halbritt/fome-mc/telemetry-pod/expansion/series-divider/review/README.md

# Independent series-divider source review

1,062 checks pass. The candidate replaces the previously unbound31.3kohm R60 with30.1kohm R60 and adds1.2kohm R181 in series. The midpoint contains exactly R60.2 and R181.1; the old SUP_U18_SENSE connection substitutes R181.2 for R60.2. Collapsing this verified pair restores the entire baseline intent exactly, including all320 earlier bindings, other components, nets and declared NCs. The new source has333 components and322 bindings. R181 is inserted immediately after R60 in the same schematic layout group; removing it restores the complete prior layout. Every other captured input byte is unchanged.

Exact YAGEO RT0603BRD0730K1L/C705764 and RT0603BRD071K2L/C136970 identities, manufacturer PDF hashes and raw supplier-response/catalog hashes were independently checked. Both exact sheets were read:30.1k/1.2k,±0.1%,25ppm/K,0603,0.1W at70°C,-55..155°C and75V voltage ceiling. Historical stocks410 and7556, with assemblyComponentFlag=false for both, remain capture-time observations rather than assembly approval.

The series sum is31.3kohm nominal, preserving the divider's31.3k/10k ratio and nominal falling threshold1.15×(1+31.3/10)=4.7495V. If both top resistors share the same specified bounds, adding independent worst-case same-sign errors produces the same relative tolerance/TCR envelope as a single31.3k resistor with those bounds. Do not apply statistical cancellation or RSS without an accepted statistical model. The original unbound R60 did not itself have a guaranteed25ppm part; this candidate makes the assumed coefficient explicit through selected parts without qualifying threshold performance.

At a nominal5V input, total divider resistance41.3k gives121.1µA; the30.1k resistor dissipates approximately0.441mW and the1.2k resistor17.6µW. These are static nominal calculations, not assembled-temperature or fault-survival evidence. The extra resistor, solder joints and exposed midpoint introduce layout, parasitic capacitance/leakage and contamination considerations. Local board leakage into the midpoint is not represented by the ideal series-resistor reduction. Layout and routing must account for that node and the additional package.

The supervisor monitors local POD_5V_SENSOR upstream of U30. All prior uncertainty about the healthy local rail envelope, TPS389001 input-current applicability near threshold, resistor lifetime/solder drift, acceptable assertion/release window, noise and timing remains open. Preserving nominal ratio avoids the proposed31.6k threshold shift; it does not resolve those qualification conditions.

Five temporary-copy negative controls reject an extra midpoint attachment, a wrong series terminal, changed resistance, damaged prior binding and misplaced layout insertion. Checker API is `check_series.py PACKET BASE_INPUTS CANDIDATE REPORT --source-only`; negative runner is `negative_probes.py PACKET BASE_INPUTS CANDIDATE REPORT`. No preparation helper is imported. The checker deliberately refuses native mode. Existing native verification assumes the previous topology and must be extended for this exact series replacement and exercised on newly emitted artifacts before any native or placement claim. Native remains NOT_RUN; all assembly, thermal, mechanical, fabrication and operating holds persist.
