halbritt/fome-mc/telemetry-pod/expansion/part-bindings/review/README.md

# Independent identity-binding source review

1,673 checks pass for the prepared source:45 supplier identities assigned to188 previously unbound references, giving314 components with binding metadata. All332 components, prior bindings, values, footprints, nets, declared no-connects, library hashes and capture bytes remain unchanged apart from the188 intended part_binding additions. Six power flags and five copper jumpers remain outside part selection, leaving7 other references without binding metadata.

The checker independently fixes each expected MPN/LCSC/reference allocation without importing preparation helpers. It verifies manifest datasheet/catalog hashes, raw supplier-response hash/size, exact manufacturer/MPN/LCSC identities and historical stock. All45 assemblyComponentFlag observations remain false. Binding and receipt language explicitly retains assembly and operating qualification as pending; existing126 bindings have not been requalified.

The latest32 positions all have10kohm nominal values and Resistor_SMD:R_0603_1608Metric footprints. Exact YAGEO RT0603BRD0710KL/C95204 matches their nominal resistance, footprint class, required0.1% precision where specified, and25ppm/C thermistor requirements. Allocation: R46–55,R64–69,R71–72,R57/59/61/63,R112/113/115,R121/122/124,andR170–173. It does not change circuit values. The exact manufacturer PDF identifies10k,0.1%,25ppm/C,-55..155C,0.1W at70C,75V maximum continuous voltage. For10k the power-derived ceiling is sqrt(0.1W×10k)=31.62V at full rated power, already below75V. Temperature range does not permit full rated power through155C. The PDF's150V overload figure is not a continuous or automotive-transient rating.

Conditional linear derating from0.1W70C to zero155C gives58.8mW105C and35.3mW125C. The earlier thermistor24V fault screen of about46.9mW per pullup fits only the former, before assembled heating/margin. Exact family derating, film temperature, pulse capability and the prior thermal/fault conditions remain qualification gates. Historical stock was1,961,790 at2026-10-20T14:01:34.419365+00:00 with assemblyComponentFlag=false; this is not present assembly availability.

Ten temporary-source controls reject: wrong supplier ID, unrelated net damage, promoted assembly flag, wrong eMMC datasheet hash, 499k MPN substituted on thermistor10k R170, 100ohm MPN substituted on120ohm termination R70, X7R identity substituted on crystal C0G C81, 22nF X7R identity substituted on10nF C0G ramp C88, HP suffix removed from R174, andJ1 captured zero stock promoted to one. Evidence is retained in negative-probes.json. Source circuit files are untouched by the probes.

U14 provenance recovery was independently checked previously and replayed here: all four restored raw responses match the unchanged historic catalog hashes/sizes. An independent HTTPS fetch returned200 and1,361,902bytes with SHA256e26a6008b1d04ceaa514681aabef2e4130eeabe528a775e6be78162000bce733, identical to reviewed FORESEE A-00093v1.0 FEMDME008G-A8A39, dated2021-07-16 on page2. Exact MCP3208-BI/SL,C2979740; TL431BQDBZR,C190245; and ADS1119IPWR,C701613 identities remain as previously reviewed; no alternative device has been substituted.

Run `check_bindings.py PACKET_DIR CANDIDATE_DIR REPORT_JSON --source-only` for prepared source. Without that flag, the checker additionally requires native.xml and checks complete graph/pin-function/NC preservation and all added binding fields. That branch remains NOT_RUN: the valid278-character structured PARAM_Datasheet is still blocked by the emitter's ordinary-field limit. Do not truncate or omit identity evidence to force emission. The previously verified native candidate remains a separate artifact.

All previous electrical, cold-start, transient/backfeed, timing, thermal, capacitor stability, accuracy, footprint, mechanical, placement/routing and qualification holds remain. Identity metadata is not assembly, fabrication or hardware acceptance.

The additional15 exact YAGEO identities cover28 references:100k R29/R116/R125/R180;16.9k R56;15.2k R58;64.9k R62;120ohm R70;68.1k R74/R78/R82;215k R75/R79/R83;44.2k R76/R80/R165;26.7k R84;56k R114/R123;4.7k R117/R126;100ohm R118/R127;2.2k R160/R161;95.3k R163;287k R164. All15 exact PDF specifications were read independently and match0.1%,25ppm/C,0603,-55..155C,0.1W70C and75V ceiling. The checker also decodes every selected RT0603BRD07 resistance code and compares it with the unchanged component value and footprint, in addition to exact supplier identities and reference allocations.

Power screening is especially important for low values:120ohm R70 at0.1W permits3.46Vrms differential at70C; conditional linear derating to105C lowers that to2.66Vrms. Its default-open solder jumper does not qualify sustained dominant or fault stress when enabled.100ohm R118/R127 permit3.16Vrms at full0.1W. These are resistor power ceilings, not bus fault-survival claims. Exact temperature derating, board heating and transient energy remain unqualified.

At that earlier resistor-selection stage,R60 at31.3k, all four1.05M positions and the2512 power resistors remained unbound. The six2512 resistors were subsequently bound as documented below;R60 and the four1.05M positions remain unbound. The31.3k search was rewritten by the supplier to11.3k before returning no results, so that response cannot establish absence of31.3k stock. The exact manufacturer URL404 is a limited source-discovery observation, not evidence authorizing substitution.

Six exact KEMET selections add45 unchanged capacitor positions:25×100nF50V X7R0603 (C0603C104K5RACTU),11×1uF50V X7R0805 (C0805C105K5RACTU),C81/C82 18pF50V C0G (C0603C180J5GACTU),C95/C96 220pF50V C0G (C0603C221J5GACTU),C71/C73/C75/C77 22nF50V X7R (C0603C223K5RACTU),andC128 10uF16V X7R1206 (C1206C106K4RACTU). Exact manufacturer sheets were independently read and their hashes replayed. These are commercial parts rated-55..125°C, not automotive-qualified by this evidence.

The X7R sheets specify±10% initial tolerance,±15% temperature variation and3% loss per decade-hour aging under stated referee conditions. Nominal capacitance and voltage rating do not guarantee effective capacitance at bias, temperature or age. In particular,1uF sensor-power input bypass effectiveness, ADS1119 decoupling,100nF diagnostic filter settling and22nF supervisor release timing need those effects incorporated. With only initial and temperature terms,0.9×0.85=0.765 of nominal illustrates the loss before bias or aging; it is not a guaranteed combined bound.

C0G parts specify±5%,30ppm/C and zero aging per decade-hour. The18pF crystal pair provides9pF series capacitance nominal plus unmeasured board/device stray; this does not establish12pF load or oscillator startup/drive margin. The220pF Hall filter still requires worst-case pulse/edge and comparator recovery validation. C128's10uF nominal is not an effective-C/ESR guarantee for the TL431 stability region; TL431 operating current, cold diode headroom, bias/aging and transient conditions remain open. No cap binding closes system fault survival. At that earlier selection stage,1uF0603,4.7uF0603,22uF1210 and10nF0603 remained unbound; the following addition resolves all except4.7uF0603.

The final10 additions are C63/C80 KEMET C0603C105K4RACTU (1uF16V X7R±10%0603),C68/C69/C70 YAGEO CC1210KKX7R8BB226 (22uF25V X7R±10%1210),andC47/C88/C91/C94/C126 Murata GRM1885C1H103JA01D (10nF50V C0G±5%0603). All exact manufacturer PDFs were read and their hashes checked. Tighter5% Murata tolerance meets the four ramp positions'10% source requirement without changing circuit values.

Murata's reference sheet page2 explicitly maps the terminalD suffix to180mm paper-tape reelW8P4,4000pcs, and states body1.6±0.1×0.8±0.1×0.8±0.1mm. Its operating range is-55..125°C; the shown0±30ppm/°C coefficient has the narrower25..125°C range. Do not extend that linear coefficient to negative temperatures without additional evidence. The sheet is a consumer/industrial reference specification, not proof of automotive safety qualification. The YAGEO22uF body height is2.5±0.2mm; physical clearance remains unverified. Effective capacitance under3.3V/6.3V bias, temperature, tolerance and aging must still satisfy TPS62162 input/output capacitor and stability requirements. The KEMET1uF nominal similarly does not establish effective bypass capacitance. No newly identified capacitor closes existing power-sequencing, stability or fault-survival holds.

Six power-resistor identity additions were independently checked against the unchanged source values and2512 footprints: R110/R111/R119/R120 CRCW2512620RFKEG/C3988368 and R174/R175 CRCW2512200RFKEGHP/C2073505. Vishay doc20035 (14-Apr-2026) page3 and doc20043 (17-Mar-2026) page3 establish620R/200R resistance codes,F=±1%,K=±100ppm/K,EG packaging and the distinctHP high-power/pulse-proof suffix. EG is the2000-piece8mm-pitch blister-reel option for2512; it is not a power grade. Ordinary2512 is1.0W at70°C; HP2512 is1.5W at70°C. The HP document's separate2W higher-dissipation row has additional conditions and is not the adopted circuit rating.

All previous assembled-thermal gates remain. The four620ohm negative24V Hall-fault screening case dissipates about0.392W each and1.567W total: nominal1W family derating gives0.588W at105°C but0.353W at125°C, so125°C local ambient fails that screen. The two200ohm HP resistors' prior24V-source/four-input fault screen gives about0.597W each;1.5W derates to0.882W at105°C and0.529W at125°C, likewise failing125°C local ambient. Board/copper thermal resistance, mutual heating, film temperature, life drift, pulse/fault duration and diode/LM2903 negative-input behavior are still unqualified. Exact identity and HP suffix preservation do not prove fault survival. Both historical assemblyComponentFlag observations are false; stock1000 and75 are capture-time facts, not current buildability.

J1 identity metadata now records the previously selected TE1-776163-1/C596198 without changing its value,35-pin connectivity or PodConnector:AMPSEAL_35_1-776163-1 footprint. The pinned current TE776163 drawingK1 table explicitly distinguishes gold-plated black1-776163-1 from tin-plated black776163-1. The binding preserves the reviewed gold variant; it does not substitute an available finish or prove mating-harness compatibility.

The exact supplier capture at2026-10-20T14:23:51.952868+00:00 records stock0 and assemblyComponentFlag=false. The checker requires that zero-stock observation and rejects changing the receipt to positive stock. This is identification of an existing design choice, not a new availability-based selection, procurement authorization or evidence of buildability. Connector fit, board-lock/mechanical tolerances, housing clearance, mixed-finish mating risk, thermal, assembly and procurement holds all remain. Current binding totals are188 additions/314 metadata-present/7 remaining part references, excluding the six flags and five copper jumpers. Native remains NOT_RUN for this binding packet.
