halbritt/fome-mc/export/gerbers/fome-mc-drill_report.txt

Drill report for fome-mc.kicad_pcb
Created on 2026-10-18T06:23:28

Copper Layer Stackup:
    =============================================================
    L1 :  F.Cu                      front
    L2 :  In1.Cu                    in1
    L3 :  In2.Cu                    in2
    L4 :  B.Cu                      back

Drill file 'fome-mc.drl' contains
    plated through holes:
    =============================================================
    T1  0.200mm  0.0079"  (76 holes))
    T2  0.250mm  0.0098"  (10 holes))
    T3  0.300mm  0.0118"  (7 holes))
    T4  0.300mm  0.0118"  (1082 holes))
    T5  0.300mm  0.0118"  (499 holes))
    T6  0.400mm  0.0157"  (7 holes))
    T7  0.920mm  0.0362"  (4 holes))
    T8  1.000mm  0.0394"  (10 holes))
    T9  1.100mm  0.0433"  (5 holes))
    T10  1.400mm  0.0551"  (1 hole)
    T11  1.750mm  0.0689"  (70 holes))
    T12  2.300mm  0.0906"  (2 holes))

    Total plated holes count 1773

Not plated through holes are merged with plated holes
    unplated through holes:
    =============================================================
    T13  0.991mm  0.0390"  (3 holes))
    T14  2.000mm  0.0787"  (8 holes))
    T15  4.300mm  0.1693"  (4 holes))

    Total unplated holes count 15
