halbritt/fome-mc/reports/toolchain/routing/fome-mc/INDEX.md

# FOME-MC routing trials

Bounded, read-only trials on isolated copies of the committed board. Each directory
holds the attempt's `result.json`, `RESULT.md`, `attempt.json` (input identity, scope,
settings), `preservation.json`, `new-findings.json` and `candidate-drc.json`; the
candidate boards themselves stay under `build/runs/route/fome-mc/`. Summary and next
actions: `toolchain/ROUTING.md`, section "FOME-MC real-board trials".

| Label | Backend | Process | Routing (unconnected, input 235) | Validation |
|---|---|---|---|---|
| trial-krt-initial | KRT 0.23.1 | FAIL (budget) | NOT_RUN | NOT_RUN |
| trial-freerouting-initial | Freerouting v2.5.0 | PASS | INCOMPLETE (199) | FAIL (adapter defects since fixed) |
| trial-krt-nofinalize-before-locking | KRT 0.23.1 | PASS | INCOMPLETE (14) | FAIL (existing copper reworked; since fixed) |
| trial-freerouting | Freerouting v2.5.0 | PASS | INCOMPLETE (188) | FAIL (1 short, 2 clearance) |
| trial-krt-nofinalize | KRT 0.23.1 | PASS | INCOMPLETE (26) | FAIL (18 new warnings) |
| trial-krt-continue | KRT 0.23.1 | PASS | 16 of 16 open nets still open (from `trial-krt-nofinalize`) | PASS (no change) |
| trial-fr-on-krt | Freerouting v2.5.0 | PASS | 16 of 16 open nets still open (from `trial-krt-nofinalize`) | PASS (one 5 µm stub) |
| trial-krt-hardfirst | KRT 0.23.1 | PASS | 16 hard nets only: 11 routed, 5 open | FAIL (2 starved thermals) |
| trial-krt-hardfirst-rest | KRT 0.23.1 | PASS | **20** (all nets; `against-origin/`: chain graded vs the original input) | FAIL (10 new warnings) |
