halbritt/fome-mc/telemetry-pod/expansion/production-capture/evidence/emission-7d5b0d4d-agentee488/prepared/dry-run/REPORT.md

# Expanded telemetry pod Revision 3 campaign scope (microSD source) review

Outcome: **incomplete**; process state: `incomplete`.

Candidate: `c03a187ac72302218ae839e7368f21286ae55143f42e955a95a794325c88cb99`
Run: `e59d61d6-de8c-4bad-a0ac-6d7cf90f759c`

Revision 3 accounting for all 59 requirements and 20 prose entries against the current microSD source, declared for the pod driver stage order schematic, placement, routing, verification. Native ERC, netlist, placement-projected DRC, routed DRC, copper facts and the fab_package done gate are the only executable checks; every other obligation remains explicit. The placement subject expects the 309 schematic references plus the envelope corner holes H1-H4. Compilation is preparation, not native execution, placement, routing or acceptance.

## Checks

| Check | Execution | Design result | Summary |
| --- | --- | --- | --- |
| erc | ok | defect | schematic: expected native content absent |
| netlist | ok | defect | schematic: expected native content absent |
| parts | ok | defect | schematic: expected native content absent |
| antenna-facts | ok | defect | schematic: expected native content absent |
| placement-drc | ok | defect | placement: expected native content absent |
| envelope-outline | ok | defect | placement: expected native content absent |
| envelope-layer-count | ok | defect | placement: expected native content absent |
| envelope-stackup | ok | defect | placement: expected native content absent |
| envelope-hole-h1 | ok | defect | placement: expected native content absent |
| envelope-hole-h2 | ok | defect | placement: expected native content absent |
| envelope-hole-h3 | ok | defect | placement: expected native content absent |
| envelope-hole-h4 | ok | defect | placement: expected native content absent |
| envelope-keepout-radio-antenna | ok | defect | placement: expected native content absent |
| envelope-keepout-d-pcb-7v2-in1-no-tracks | ok | defect | placement: expected native content absent |
| envelope-keepout-d-pcb-6-rf-reference | ok | defect | placement: expected native content absent |
| envelope-fixed-j1 | ok | defect | placement: expected native content absent |
| envelope-fixed-j2 | ok | defect | placement: expected native content absent |
| envelope-fixed-u1 | ok | defect | placement: expected native content absent |
| envelope-fixed-u2 | ok | defect | placement: expected native content absent |
| envelope-fixed-j3 | ok | defect | placement: expected native content absent |
| envelope-containment | ok | defect | placement: expected native content absent |
| electrical-locality | ok | defect | placement: expected native content absent |
| drc | ok | defect | routing: expected native content absent |
| routing-geometry | ok | defect | routing: expected native content absent |
| envelope-fab-profile | ok | defect | routing: expected native content absent |
| assembly | ok | defect | verification: expected native content absent |
| fab-package | ok | defect | verification: expected native content absent |

## RF review applicability

RF review required: 2 RF indicator(s) detected in captured sources.
Binding: `6935508f20289cdfda2f408569afbd25ca0f07ad6474f0cf964c3b8631b51711`; gate: required RF review missing: no execution record.
- Missing RF evidence: rf_constraints: no captured source bound
- Missing RF evidence: rf_captures: no captured source bound
- Missing RF evidence: planes: no filled copper zone in the captured board; plane continuity is unknown
- Missing RF evidence: routing adapter evidence missing_evidence: no routing adapter receipt was supplied for this candidate; layer policy and RF reference continuity are unknown

## Initial reviews

## Findings and dispositions

### check/erc: schematic: expected native content absent

Disposition: **unresolved**.

Location: erc. Condition: check erc (erc).

schematic: expected native content absent

schematic: expected native content absent
- [work/erc/stage-subject/execution.json](<work/erc/stage-subject/execution.json>): check:erc
- [work/erc/stage-subject/console.log](<work/erc/stage-subject/console.log>): check:erc
- [work/erc/stage-subject/native-netlist.xml](<work/erc/stage-subject/native-netlist.xml>): check:erc
- [work/erc/stage-subject/native-observation.json](<work/erc/stage-subject/native-observation.json>): check:erc
- [work/erc/stage-subject/references.json](<work/erc/stage-subject/references.json>): check:erc
- [work/erc/stage-subject.json](<work/erc/stage-subject.json>): check:erc

### check/netlist: schematic: expected native content absent

Disposition: **unresolved**.

Location: netlist. Condition: check netlist (netlist).

schematic: expected native content absent

schematic: expected native content absent
- [work/netlist/stage-subject/execution.json](<work/netlist/stage-subject/execution.json>): check:netlist
- [work/netlist/stage-subject/console.log](<work/netlist/stage-subject/console.log>): check:netlist
- [work/netlist/stage-subject/native-netlist.xml](<work/netlist/stage-subject/native-netlist.xml>): check:netlist
- [work/netlist/stage-subject/native-observation.json](<work/netlist/stage-subject/native-observation.json>): check:netlist
- [work/netlist/stage-subject/references.json](<work/netlist/stage-subject/references.json>): check:netlist
- [work/netlist/stage-subject.json](<work/netlist/stage-subject.json>): check:netlist

### check/parts: schematic: expected native content absent

Disposition: **unresolved**.

Location: parts. Condition: check parts (parts_subset).

schematic: expected native content absent

schematic: expected native content absent
- [work/parts/stage-subject/execution.json](<work/parts/stage-subject/execution.json>): check:parts
- [work/parts/stage-subject/console.log](<work/parts/stage-subject/console.log>): check:parts
- [work/parts/stage-subject/native-netlist.xml](<work/parts/stage-subject/native-netlist.xml>): check:parts
- [work/parts/stage-subject/native-observation.json](<work/parts/stage-subject/native-observation.json>): check:parts
- [work/parts/stage-subject/references.json](<work/parts/stage-subject/references.json>): check:parts
- [work/parts/stage-subject.json](<work/parts/stage-subject.json>): check:parts

### check/antenna-facts: schematic: expected native content absent

Disposition: **unresolved**.

Location: antenna-facts. Condition: check antenna-facts (datasheet_facts).

schematic: expected native content absent

schematic: expected native content absent
- [work/antenna-facts/stage-subject/execution.json](<work/antenna-facts/stage-subject/execution.json>): check:antenna-facts
- [work/antenna-facts/stage-subject/console.log](<work/antenna-facts/stage-subject/console.log>): check:antenna-facts
- [work/antenna-facts/stage-subject/native-netlist.xml](<work/antenna-facts/stage-subject/native-netlist.xml>): check:antenna-facts
- [work/antenna-facts/stage-subject/native-observation.json](<work/antenna-facts/stage-subject/native-observation.json>): check:antenna-facts
- [work/antenna-facts/stage-subject/references.json](<work/antenna-facts/stage-subject/references.json>): check:antenna-facts
- [work/antenna-facts/stage-subject.json](<work/antenna-facts/stage-subject.json>): check:antenna-facts

### check/placement-drc: placement: expected native content absent

Disposition: **unresolved**.

Location: placement-drc. Condition: check placement-drc (drc).

placement: expected native content absent

placement: expected native content absent
- [work/placement-drc/stage-subject/execution.json](<work/placement-drc/stage-subject/execution.json>): check:placement-drc
- [work/placement-drc/stage-subject/console.log](<work/placement-drc/stage-subject/console.log>): check:placement-drc
- [work/placement-drc/stage-subject/native-observation.json](<work/placement-drc/stage-subject/native-observation.json>): check:placement-drc
- [work/placement-drc/stage-subject/references.json](<work/placement-drc/stage-subject/references.json>): check:placement-drc
- [work/placement-drc/stage-subject.json](<work/placement-drc/stage-subject.json>): check:placement-drc

### check/envelope-outline: placement: expected native content absent

Disposition: **unresolved**.

Location: envelope-outline. Condition: check envelope-outline (board_envelope).

placement: expected native content absent

placement: expected native content absent
- [work/envelope-outline/stage-subject/execution.json](<work/envelope-outline/stage-subject/execution.json>): check:envelope-outline
- [work/envelope-outline/stage-subject/console.log](<work/envelope-outline/stage-subject/console.log>): check:envelope-outline
- [work/envelope-outline/stage-subject/native-observation.json](<work/envelope-outline/stage-subject/native-observation.json>): check:envelope-outline
- [work/envelope-outline/stage-subject/references.json](<work/envelope-outline/stage-subject/references.json>): check:envelope-outline
- [work/envelope-outline/stage-subject.json](<work/envelope-outline/stage-subject.json>): check:envelope-outline

### check/envelope-layer-count: placement: expected native content absent

Disposition: **unresolved**.

Location: envelope-layer-count. Condition: check envelope-layer-count (board_envelope).

placement: expected native content absent

placement: expected native content absent
- [work/envelope-layer-count/stage-subject/execution.json](<work/envelope-layer-count/stage-subject/execution.json>): check:envelope-layer-count
- [work/envelope-layer-count/stage-subject/console.log](<work/envelope-layer-count/stage-subject/console.log>): check:envelope-layer-count
- [work/envelope-layer-count/stage-subject/native-observation.json](<work/envelope-layer-count/stage-subject/native-observation.json>): check:envelope-layer-count
- [work/envelope-layer-count/stage-subject/references.json](<work/envelope-layer-count/stage-subject/references.json>): check:envelope-layer-count
- [work/envelope-layer-count/stage-subject.json](<work/envelope-layer-count/stage-subject.json>): check:envelope-layer-count

### check/envelope-stackup: placement: expected native content absent

Disposition: **unresolved**.

Location: envelope-stackup. Condition: check envelope-stackup (board_envelope).

placement: expected native content absent

placement: expected native content absent
- [work/envelope-stackup/stage-subject/execution.json](<work/envelope-stackup/stage-subject/execution.json>): check:envelope-stackup
- [work/envelope-stackup/stage-subject/console.log](<work/envelope-stackup/stage-subject/console.log>): check:envelope-stackup
- [work/envelope-stackup/stage-subject/native-observation.json](<work/envelope-stackup/stage-subject/native-observation.json>): check:envelope-stackup
- [work/envelope-stackup/stage-subject/references.json](<work/envelope-stackup/stage-subject/references.json>): check:envelope-stackup
- [work/envelope-stackup/stage-subject.json](<work/envelope-stackup/stage-subject.json>): check:envelope-stackup

### check/envelope-hole-h1: placement: expected native content absent

Disposition: **unresolved**.

Location: envelope-hole-h1. Condition: check envelope-hole-h1 (board_envelope).

placement: expected native content absent

placement: expected native content absent
- [work/envelope-hole-h1/stage-subject/execution.json](<work/envelope-hole-h1/stage-subject/execution.json>): check:envelope-hole-h1
- [work/envelope-hole-h1/stage-subject/console.log](<work/envelope-hole-h1/stage-subject/console.log>): check:envelope-hole-h1
- [work/envelope-hole-h1/stage-subject/native-observation.json](<work/envelope-hole-h1/stage-subject/native-observation.json>): check:envelope-hole-h1
- [work/envelope-hole-h1/stage-subject/references.json](<work/envelope-hole-h1/stage-subject/references.json>): check:envelope-hole-h1
- [work/envelope-hole-h1/stage-subject.json](<work/envelope-hole-h1/stage-subject.json>): check:envelope-hole-h1

### check/envelope-hole-h2: placement: expected native content absent

Disposition: **unresolved**.

Location: envelope-hole-h2. Condition: check envelope-hole-h2 (board_envelope).

placement: expected native content absent

placement: expected native content absent
- [work/envelope-hole-h2/stage-subject/execution.json](<work/envelope-hole-h2/stage-subject/execution.json>): check:envelope-hole-h2
- [work/envelope-hole-h2/stage-subject/console.log](<work/envelope-hole-h2/stage-subject/console.log>): check:envelope-hole-h2
- [work/envelope-hole-h2/stage-subject/native-observation.json](<work/envelope-hole-h2/stage-subject/native-observation.json>): check:envelope-hole-h2
- [work/envelope-hole-h2/stage-subject/references.json](<work/envelope-hole-h2/stage-subject/references.json>): check:envelope-hole-h2
- [work/envelope-hole-h2/stage-subject.json](<work/envelope-hole-h2/stage-subject.json>): check:envelope-hole-h2

### check/envelope-hole-h3: placement: expected native content absent

Disposition: **unresolved**.

Location: envelope-hole-h3. Condition: check envelope-hole-h3 (board_envelope).

placement: expected native content absent

placement: expected native content absent
- [work/envelope-hole-h3/stage-subject/execution.json](<work/envelope-hole-h3/stage-subject/execution.json>): check:envelope-hole-h3
- [work/envelope-hole-h3/stage-subject/console.log](<work/envelope-hole-h3/stage-subject/console.log>): check:envelope-hole-h3
- [work/envelope-hole-h3/stage-subject/native-observation.json](<work/envelope-hole-h3/stage-subject/native-observation.json>): check:envelope-hole-h3
- [work/envelope-hole-h3/stage-subject/references.json](<work/envelope-hole-h3/stage-subject/references.json>): check:envelope-hole-h3
- [work/envelope-hole-h3/stage-subject.json](<work/envelope-hole-h3/stage-subject.json>): check:envelope-hole-h3

### check/envelope-hole-h4: placement: expected native content absent

Disposition: **unresolved**.

Location: envelope-hole-h4. Condition: check envelope-hole-h4 (board_envelope).

placement: expected native content absent

placement: expected native content absent
- [work/envelope-hole-h4/stage-subject/execution.json](<work/envelope-hole-h4/stage-subject/execution.json>): check:envelope-hole-h4
- [work/envelope-hole-h4/stage-subject/console.log](<work/envelope-hole-h4/stage-subject/console.log>): check:envelope-hole-h4
- [work/envelope-hole-h4/stage-subject/native-observation.json](<work/envelope-hole-h4/stage-subject/native-observation.json>): check:envelope-hole-h4
- [work/envelope-hole-h4/stage-subject/references.json](<work/envelope-hole-h4/stage-subject/references.json>): check:envelope-hole-h4
- [work/envelope-hole-h4/stage-subject.json](<work/envelope-hole-h4/stage-subject.json>): check:envelope-hole-h4

### check/envelope-keepout-radio-antenna: placement: expected native content absent

Disposition: **unresolved**.

Location: envelope-keepout-radio-antenna. Condition: check envelope-keepout-radio-antenna (board_envelope).

placement: expected native content absent

placement: expected native content absent
- [work/envelope-keepout-radio-antenna/stage-subject/execution.json](<work/envelope-keepout-radio-antenna/stage-subject/execution.json>): check:envelope-keepout-radio-antenna
- [work/envelope-keepout-radio-antenna/stage-subject/console.log](<work/envelope-keepout-radio-antenna/stage-subject/console.log>): check:envelope-keepout-radio-antenna
- [work/envelope-keepout-radio-antenna/stage-subject/native-observation.json](<work/envelope-keepout-radio-antenna/stage-subject/native-observation.json>): check:envelope-keepout-radio-antenna
- [work/envelope-keepout-radio-antenna/stage-subject/references.json](<work/envelope-keepout-radio-antenna/stage-subject/references.json>): check:envelope-keepout-radio-antenna
- [work/envelope-keepout-radio-antenna/stage-subject.json](<work/envelope-keepout-radio-antenna/stage-subject.json>): check:envelope-keepout-radio-antenna

### check/envelope-keepout-d-pcb-7v2-in1-no-tracks: placement: expected native content absent

Disposition: **unresolved**.

Location: envelope-keepout-d-pcb-7v2-in1-no-tracks. Condition: check envelope-keepout-d-pcb-7v2-in1-no-tracks (board_envelope).

placement: expected native content absent

placement: expected native content absent
- [work/envelope-keepout-d-pcb-7v2-in1-no-tracks/stage-subject/execution.json](<work/envelope-keepout-d-pcb-7v2-in1-no-tracks/stage-subject/execution.json>): check:envelope-keepout-d-pcb-7v2-in1-no-tracks
- [work/envelope-keepout-d-pcb-7v2-in1-no-tracks/stage-subject/console.log](<work/envelope-keepout-d-pcb-7v2-in1-no-tracks/stage-subject/console.log>): check:envelope-keepout-d-pcb-7v2-in1-no-tracks
- [work/envelope-keepout-d-pcb-7v2-in1-no-tracks/stage-subject/native-observation.json](<work/envelope-keepout-d-pcb-7v2-in1-no-tracks/stage-subject/native-observation.json>): check:envelope-keepout-d-pcb-7v2-in1-no-tracks
- [work/envelope-keepout-d-pcb-7v2-in1-no-tracks/stage-subject/references.json](<work/envelope-keepout-d-pcb-7v2-in1-no-tracks/stage-subject/references.json>): check:envelope-keepout-d-pcb-7v2-in1-no-tracks
- [work/envelope-keepout-d-pcb-7v2-in1-no-tracks/stage-subject.json](<work/envelope-keepout-d-pcb-7v2-in1-no-tracks/stage-subject.json>): check:envelope-keepout-d-pcb-7v2-in1-no-tracks

### check/envelope-keepout-d-pcb-6-rf-reference: placement: expected native content absent

Disposition: **unresolved**.

Location: envelope-keepout-d-pcb-6-rf-reference. Condition: check envelope-keepout-d-pcb-6-rf-reference (board_envelope).

placement: expected native content absent

placement: expected native content absent
- [work/envelope-keepout-d-pcb-6-rf-reference/stage-subject/execution.json](<work/envelope-keepout-d-pcb-6-rf-reference/stage-subject/execution.json>): check:envelope-keepout-d-pcb-6-rf-reference
- [work/envelope-keepout-d-pcb-6-rf-reference/stage-subject/console.log](<work/envelope-keepout-d-pcb-6-rf-reference/stage-subject/console.log>): check:envelope-keepout-d-pcb-6-rf-reference
- [work/envelope-keepout-d-pcb-6-rf-reference/stage-subject/native-observation.json](<work/envelope-keepout-d-pcb-6-rf-reference/stage-subject/native-observation.json>): check:envelope-keepout-d-pcb-6-rf-reference
- [work/envelope-keepout-d-pcb-6-rf-reference/stage-subject/references.json](<work/envelope-keepout-d-pcb-6-rf-reference/stage-subject/references.json>): check:envelope-keepout-d-pcb-6-rf-reference
- [work/envelope-keepout-d-pcb-6-rf-reference/stage-subject.json](<work/envelope-keepout-d-pcb-6-rf-reference/stage-subject.json>): check:envelope-keepout-d-pcb-6-rf-reference

### check/envelope-fixed-j1: placement: expected native content absent

Disposition: **unresolved**.

Location: envelope-fixed-j1. Condition: check envelope-fixed-j1 (placement).

placement: expected native content absent

placement: expected native content absent
- [work/envelope-fixed-j1/stage-subject/execution.json](<work/envelope-fixed-j1/stage-subject/execution.json>): check:envelope-fixed-j1
- [work/envelope-fixed-j1/stage-subject/console.log](<work/envelope-fixed-j1/stage-subject/console.log>): check:envelope-fixed-j1
- [work/envelope-fixed-j1/stage-subject/native-observation.json](<work/envelope-fixed-j1/stage-subject/native-observation.json>): check:envelope-fixed-j1
- [work/envelope-fixed-j1/stage-subject/references.json](<work/envelope-fixed-j1/stage-subject/references.json>): check:envelope-fixed-j1
- [work/envelope-fixed-j1/stage-subject.json](<work/envelope-fixed-j1/stage-subject.json>): check:envelope-fixed-j1

### check/envelope-fixed-j2: placement: expected native content absent

Disposition: **unresolved**.

Location: envelope-fixed-j2. Condition: check envelope-fixed-j2 (placement).

placement: expected native content absent

placement: expected native content absent
- [work/envelope-fixed-j2/stage-subject/execution.json](<work/envelope-fixed-j2/stage-subject/execution.json>): check:envelope-fixed-j2
- [work/envelope-fixed-j2/stage-subject/console.log](<work/envelope-fixed-j2/stage-subject/console.log>): check:envelope-fixed-j2
- [work/envelope-fixed-j2/stage-subject/native-observation.json](<work/envelope-fixed-j2/stage-subject/native-observation.json>): check:envelope-fixed-j2
- [work/envelope-fixed-j2/stage-subject/references.json](<work/envelope-fixed-j2/stage-subject/references.json>): check:envelope-fixed-j2
- [work/envelope-fixed-j2/stage-subject.json](<work/envelope-fixed-j2/stage-subject.json>): check:envelope-fixed-j2

### check/envelope-fixed-u1: placement: expected native content absent

Disposition: **unresolved**.

Location: envelope-fixed-u1. Condition: check envelope-fixed-u1 (placement).

placement: expected native content absent

placement: expected native content absent
- [work/envelope-fixed-u1/stage-subject/execution.json](<work/envelope-fixed-u1/stage-subject/execution.json>): check:envelope-fixed-u1
- [work/envelope-fixed-u1/stage-subject/console.log](<work/envelope-fixed-u1/stage-subject/console.log>): check:envelope-fixed-u1
- [work/envelope-fixed-u1/stage-subject/native-observation.json](<work/envelope-fixed-u1/stage-subject/native-observation.json>): check:envelope-fixed-u1
- [work/envelope-fixed-u1/stage-subject/references.json](<work/envelope-fixed-u1/stage-subject/references.json>): check:envelope-fixed-u1
- [work/envelope-fixed-u1/stage-subject.json](<work/envelope-fixed-u1/stage-subject.json>): check:envelope-fixed-u1

### check/envelope-fixed-u2: placement: expected native content absent

Disposition: **unresolved**.

Location: envelope-fixed-u2. Condition: check envelope-fixed-u2 (placement).

placement: expected native content absent

placement: expected native content absent
- [work/envelope-fixed-u2/stage-subject/execution.json](<work/envelope-fixed-u2/stage-subject/execution.json>): check:envelope-fixed-u2
- [work/envelope-fixed-u2/stage-subject/console.log](<work/envelope-fixed-u2/stage-subject/console.log>): check:envelope-fixed-u2
- [work/envelope-fixed-u2/stage-subject/native-observation.json](<work/envelope-fixed-u2/stage-subject/native-observation.json>): check:envelope-fixed-u2
- [work/envelope-fixed-u2/stage-subject/references.json](<work/envelope-fixed-u2/stage-subject/references.json>): check:envelope-fixed-u2
- [work/envelope-fixed-u2/stage-subject.json](<work/envelope-fixed-u2/stage-subject.json>): check:envelope-fixed-u2

### check/envelope-fixed-j3: placement: expected native content absent

Disposition: **unresolved**.

Location: envelope-fixed-j3. Condition: check envelope-fixed-j3 (placement).

placement: expected native content absent

placement: expected native content absent
- [work/envelope-fixed-j3/stage-subject/execution.json](<work/envelope-fixed-j3/stage-subject/execution.json>): check:envelope-fixed-j3
- [work/envelope-fixed-j3/stage-subject/console.log](<work/envelope-fixed-j3/stage-subject/console.log>): check:envelope-fixed-j3
- [work/envelope-fixed-j3/stage-subject/native-observation.json](<work/envelope-fixed-j3/stage-subject/native-observation.json>): check:envelope-fixed-j3
- [work/envelope-fixed-j3/stage-subject/references.json](<work/envelope-fixed-j3/stage-subject/references.json>): check:envelope-fixed-j3
- [work/envelope-fixed-j3/stage-subject.json](<work/envelope-fixed-j3/stage-subject.json>): check:envelope-fixed-j3

### check/envelope-containment: placement: expected native content absent

Disposition: **unresolved**.

Location: envelope-containment. Condition: check envelope-containment (placement).

placement: expected native content absent

placement: expected native content absent
- [work/envelope-containment/stage-subject/execution.json](<work/envelope-containment/stage-subject/execution.json>): check:envelope-containment
- [work/envelope-containment/stage-subject/console.log](<work/envelope-containment/stage-subject/console.log>): check:envelope-containment
- [work/envelope-containment/stage-subject/native-observation.json](<work/envelope-containment/stage-subject/native-observation.json>): check:envelope-containment
- [work/envelope-containment/stage-subject/references.json](<work/envelope-containment/stage-subject/references.json>): check:envelope-containment
- [work/envelope-containment/stage-subject.json](<work/envelope-containment/stage-subject.json>): check:envelope-containment

### check/electrical-locality: placement: expected native content absent

Disposition: **unresolved**.

Location: electrical-locality. Condition: check electrical-locality (placement).

placement: expected native content absent

placement: expected native content absent
- [work/electrical-locality/stage-subject/execution.json](<work/electrical-locality/stage-subject/execution.json>): check:electrical-locality
- [work/electrical-locality/stage-subject/console.log](<work/electrical-locality/stage-subject/console.log>): check:electrical-locality
- [work/electrical-locality/stage-subject/native-observation.json](<work/electrical-locality/stage-subject/native-observation.json>): check:electrical-locality
- [work/electrical-locality/stage-subject/references.json](<work/electrical-locality/stage-subject/references.json>): check:electrical-locality
- [work/electrical-locality/stage-subject.json](<work/electrical-locality/stage-subject.json>): check:electrical-locality

### check/drc: routing: expected native content absent

Disposition: **unresolved**.

Location: drc. Condition: check drc (drc).

routing: expected native content absent

routing: expected native content absent
- [work/drc/stage-subject/execution.json](<work/drc/stage-subject/execution.json>): check:drc
- [work/drc/stage-subject/console.log](<work/drc/stage-subject/console.log>): check:drc
- [work/drc/stage-subject/native-observation.json](<work/drc/stage-subject/native-observation.json>): check:drc
- [work/drc/stage-subject/references.json](<work/drc/stage-subject/references.json>): check:drc
- [work/drc/stage-subject.json](<work/drc/stage-subject.json>): check:drc

### check/routing-geometry: routing: expected native content absent

Disposition: **unresolved**.

Location: routing-geometry. Condition: check routing-geometry (geometry).

routing: expected native content absent

routing: expected native content absent
- [work/routing-geometry/stage-subject/execution.json](<work/routing-geometry/stage-subject/execution.json>): check:routing-geometry
- [work/routing-geometry/stage-subject/console.log](<work/routing-geometry/stage-subject/console.log>): check:routing-geometry
- [work/routing-geometry/stage-subject/native-observation.json](<work/routing-geometry/stage-subject/native-observation.json>): check:routing-geometry
- [work/routing-geometry/stage-subject/references.json](<work/routing-geometry/stage-subject/references.json>): check:routing-geometry
- [work/routing-geometry/stage-subject.json](<work/routing-geometry/stage-subject.json>): check:routing-geometry

### check/envelope-fab-profile: routing: expected native content absent

Disposition: **unresolved**.

Location: envelope-fab-profile. Condition: check envelope-fab-profile (fab_profile).

routing: expected native content absent

routing: expected native content absent
- [work/envelope-fab-profile/stage-subject/execution.json](<work/envelope-fab-profile/stage-subject/execution.json>): check:envelope-fab-profile
- [work/envelope-fab-profile/stage-subject/console.log](<work/envelope-fab-profile/stage-subject/console.log>): check:envelope-fab-profile
- [work/envelope-fab-profile/stage-subject/native-observation.json](<work/envelope-fab-profile/stage-subject/native-observation.json>): check:envelope-fab-profile
- [work/envelope-fab-profile/stage-subject/references.json](<work/envelope-fab-profile/stage-subject/references.json>): check:envelope-fab-profile
- [work/envelope-fab-profile/stage-subject.json](<work/envelope-fab-profile/stage-subject.json>): check:envelope-fab-profile

### check/assembly: verification: expected native content absent

Disposition: **unresolved**.

Location: assembly. Condition: check assembly (assembly_readiness).

verification: expected native content absent

verification: expected native content absent
- [work/assembly/stage-subject/execution.json](<work/assembly/stage-subject/execution.json>): check:assembly
- [work/assembly/stage-subject/console.log](<work/assembly/stage-subject/console.log>): check:assembly
- [work/assembly/stage-subject/native-netlist.xml](<work/assembly/stage-subject/native-netlist.xml>): check:assembly
- [work/assembly/stage-subject/native-observation.json](<work/assembly/stage-subject/native-observation.json>): check:assembly
- [work/assembly/stage-subject/references.json](<work/assembly/stage-subject/references.json>): check:assembly
- [work/assembly/stage-subject.json](<work/assembly/stage-subject.json>): check:assembly

### check/fab-package: verification: expected native content absent

Disposition: **unresolved**.

Location: fab-package. Condition: check fab-package (fab_package).

verification: expected native content absent

verification: expected native content absent
- [work/fab-package/stage-subject/execution.json](<work/fab-package/stage-subject/execution.json>): check:fab-package
- [work/fab-package/stage-subject/console.log](<work/fab-package/stage-subject/console.log>): check:fab-package
- [work/fab-package/stage-subject/native-netlist.xml](<work/fab-package/stage-subject/native-netlist.xml>): check:fab-package
- [work/fab-package/stage-subject/native-observation.json](<work/fab-package/stage-subject/native-observation.json>): check:fab-package
- [work/fab-package/stage-subject/references.json](<work/fab-package/stage-subject/references.json>): check:fab-package
- [work/fab-package/stage-subject.json](<work/fab-package/stage-subject.json>): check:fab-package

## Limitations
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
