halbritt/fome-mc/docs/renders/3d/fome-mc-3d-bottom.png

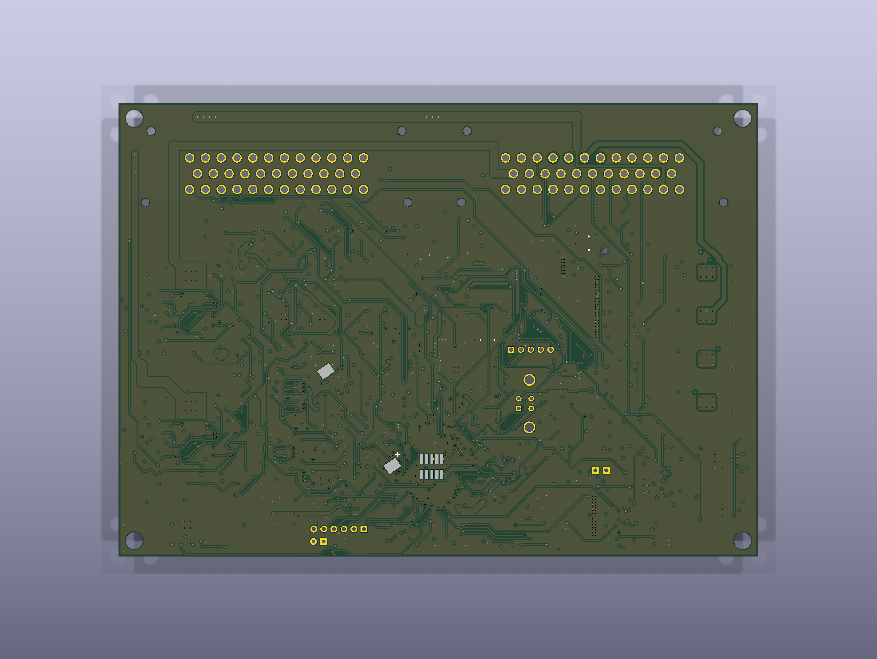
docs/renders/3d/fome-mc-3d-bottom.png
