halbritt/fome-mc/docs/renders/3d/fome-mc-3d-top.png

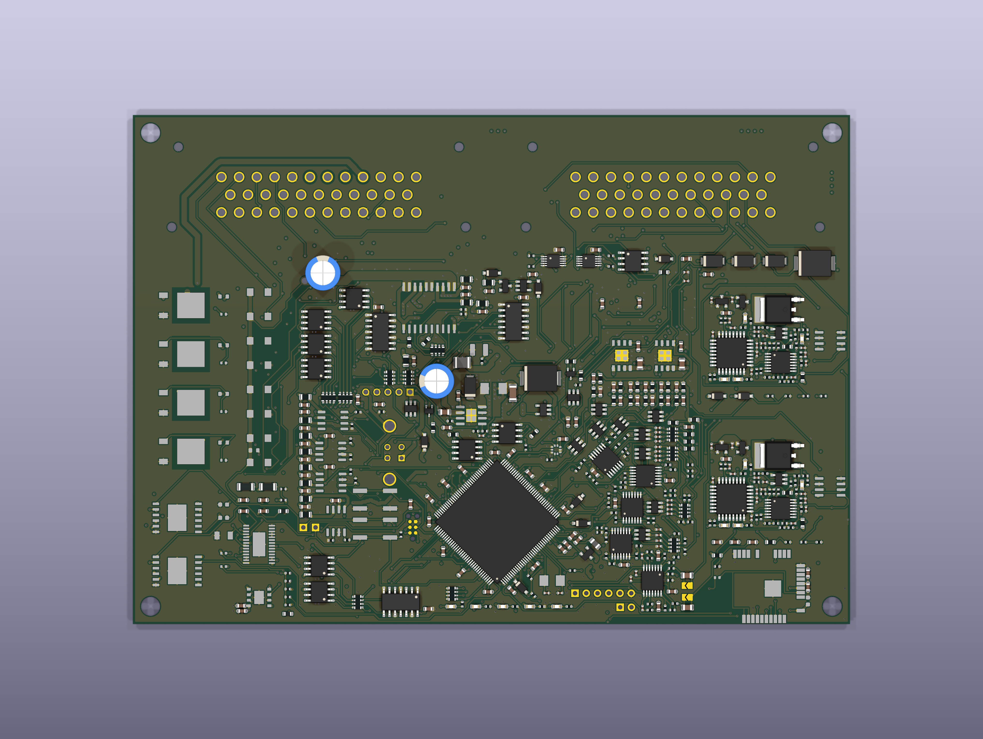
docs/renders/3d/fome-mc-3d-top.png
