halbritt/fome-mc/docs/renders/fome-mc-pcb-bottom.png

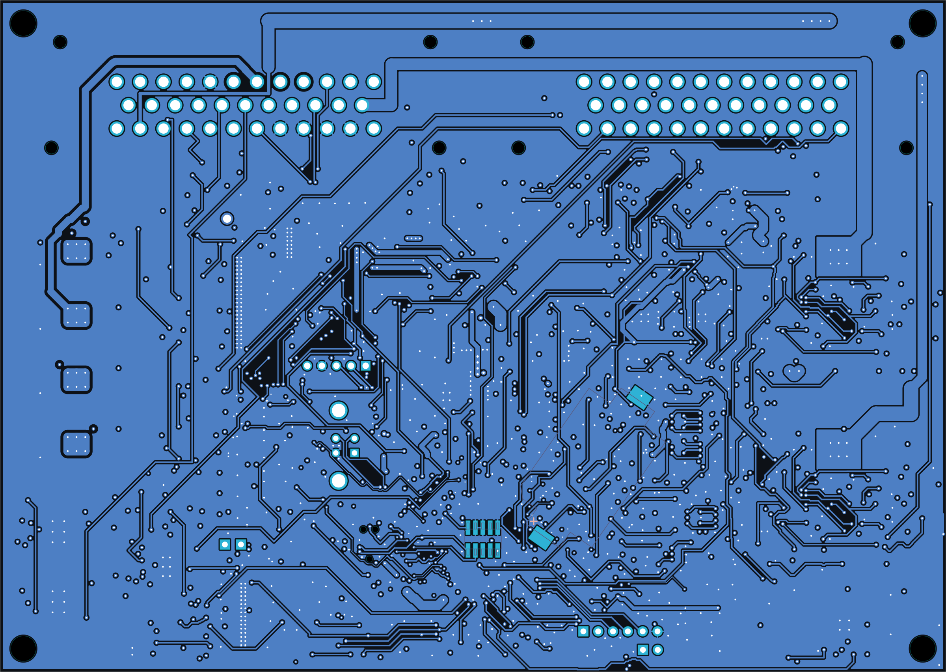
docs/renders/fome-mc-pcb-bottom.png
