halbritt/fome-mc/docs/renders/fome-mc-pcb-in1-gnd.png

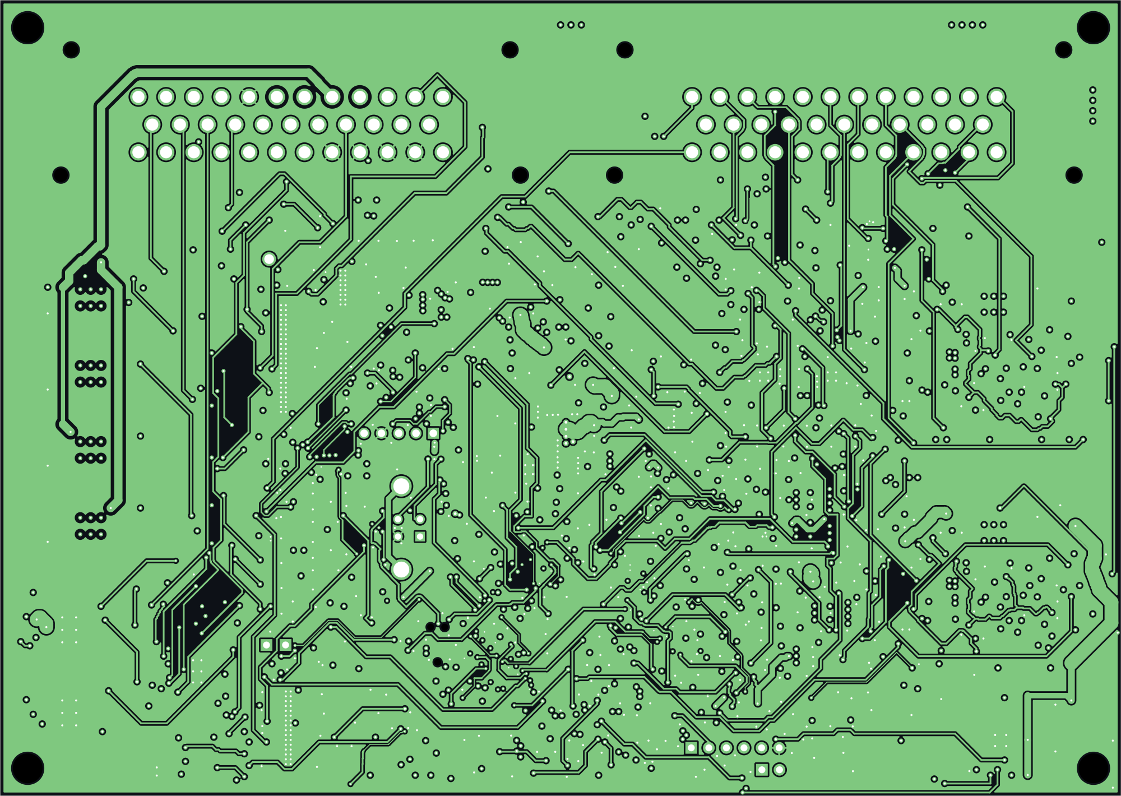
docs/renders/fome-mc-pcb-in1-gnd.png
