halbritt/fome-mc/docs/renders/fome-mc-pcb-in2-pwr.png

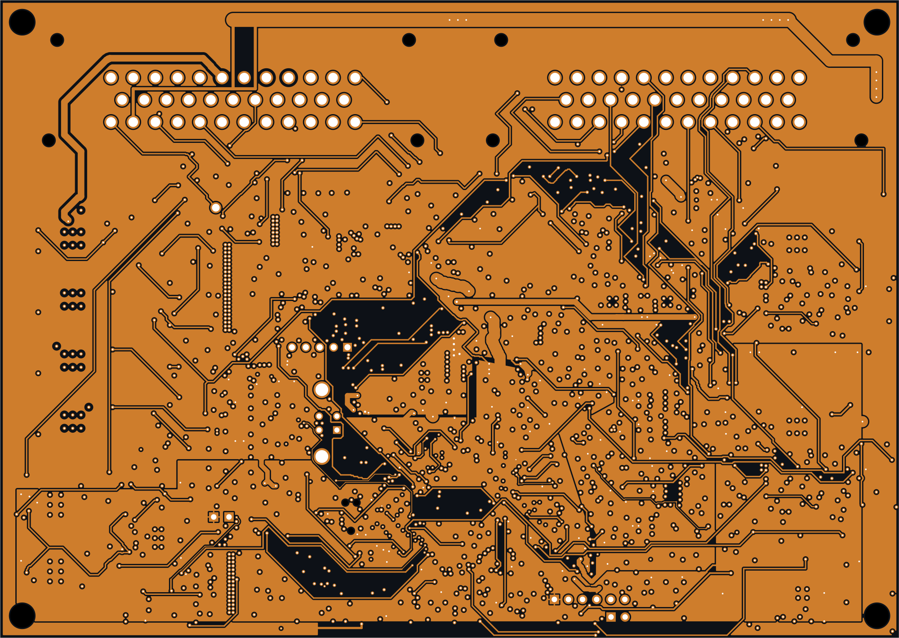
docs/renders/fome-mc-pcb-in2-pwr.png
