halbritt/fome-mc/docs/renders/fome-mc-pcb-top.png

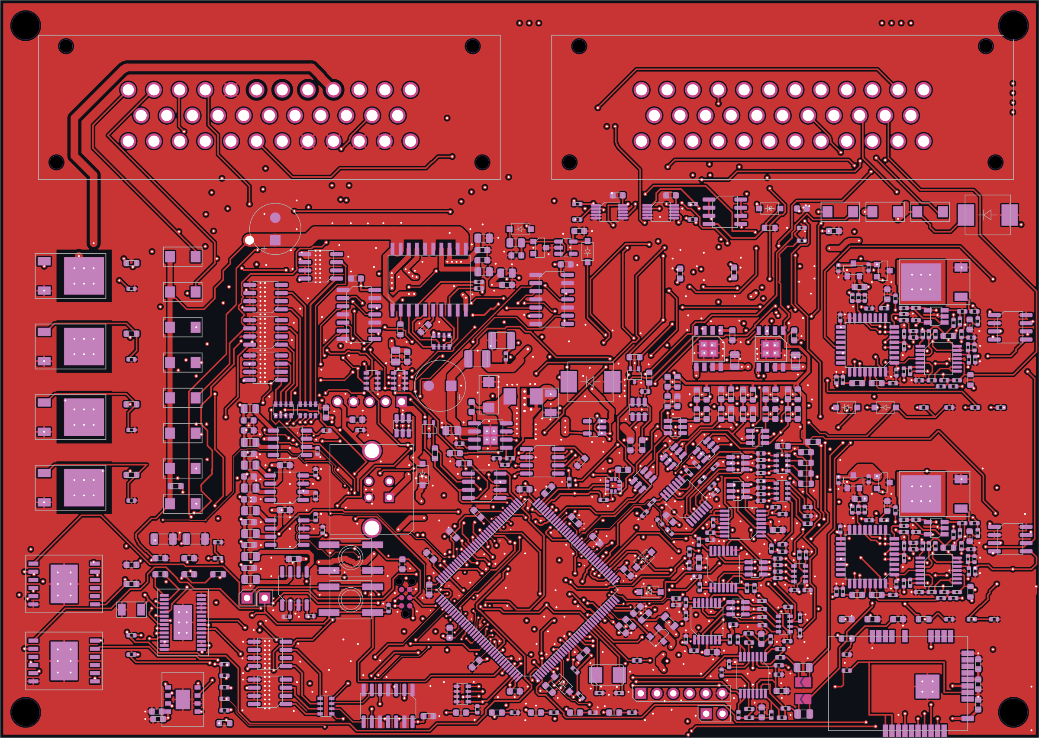
docs/renders/fome-mc-pcb-top.png
