halbritt/fome-mc/docs/renders/fome-mc-schematic-ign-igbt.png

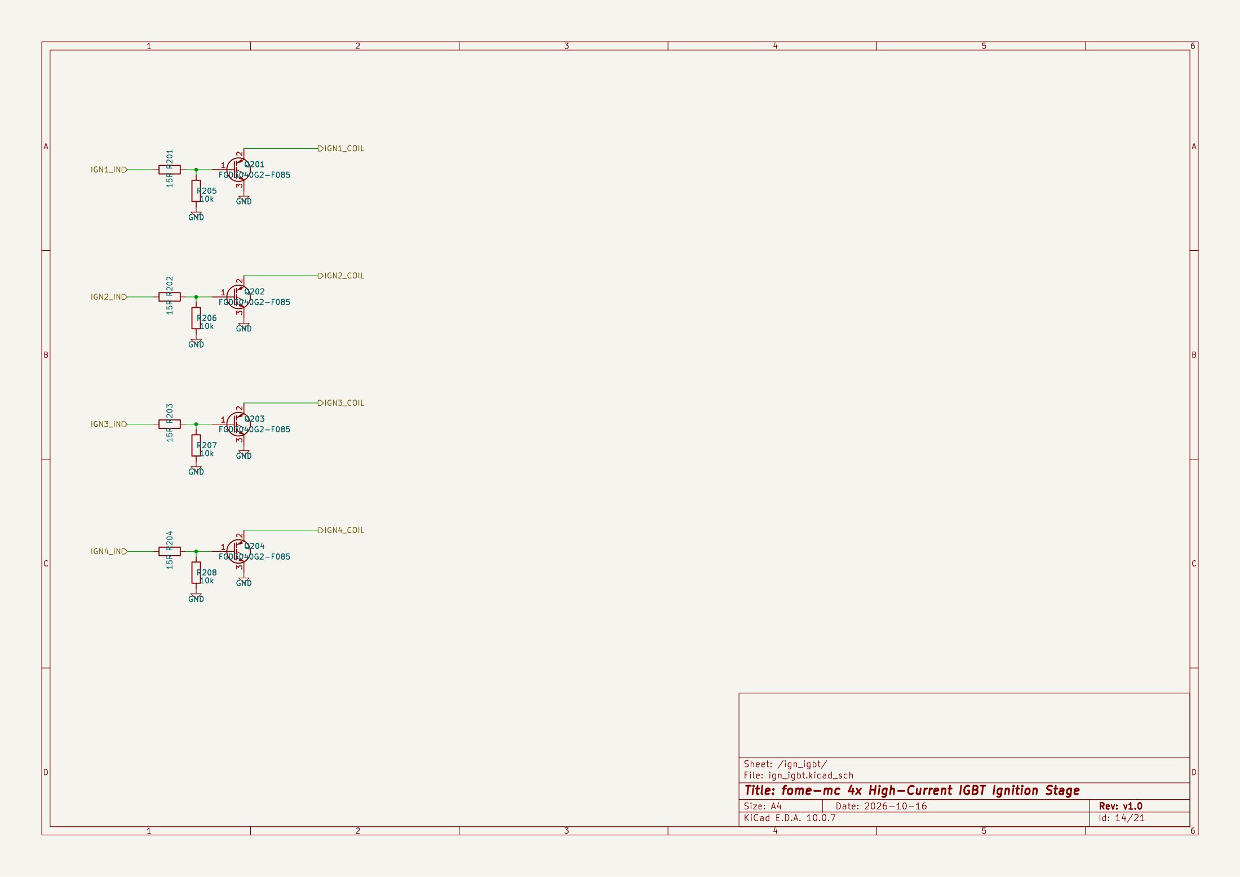
docs/renders/fome-mc-schematic-ign-igbt.png
