halbritt/fome-mc/docs/renders/fome-mc-schematic-mcu.png

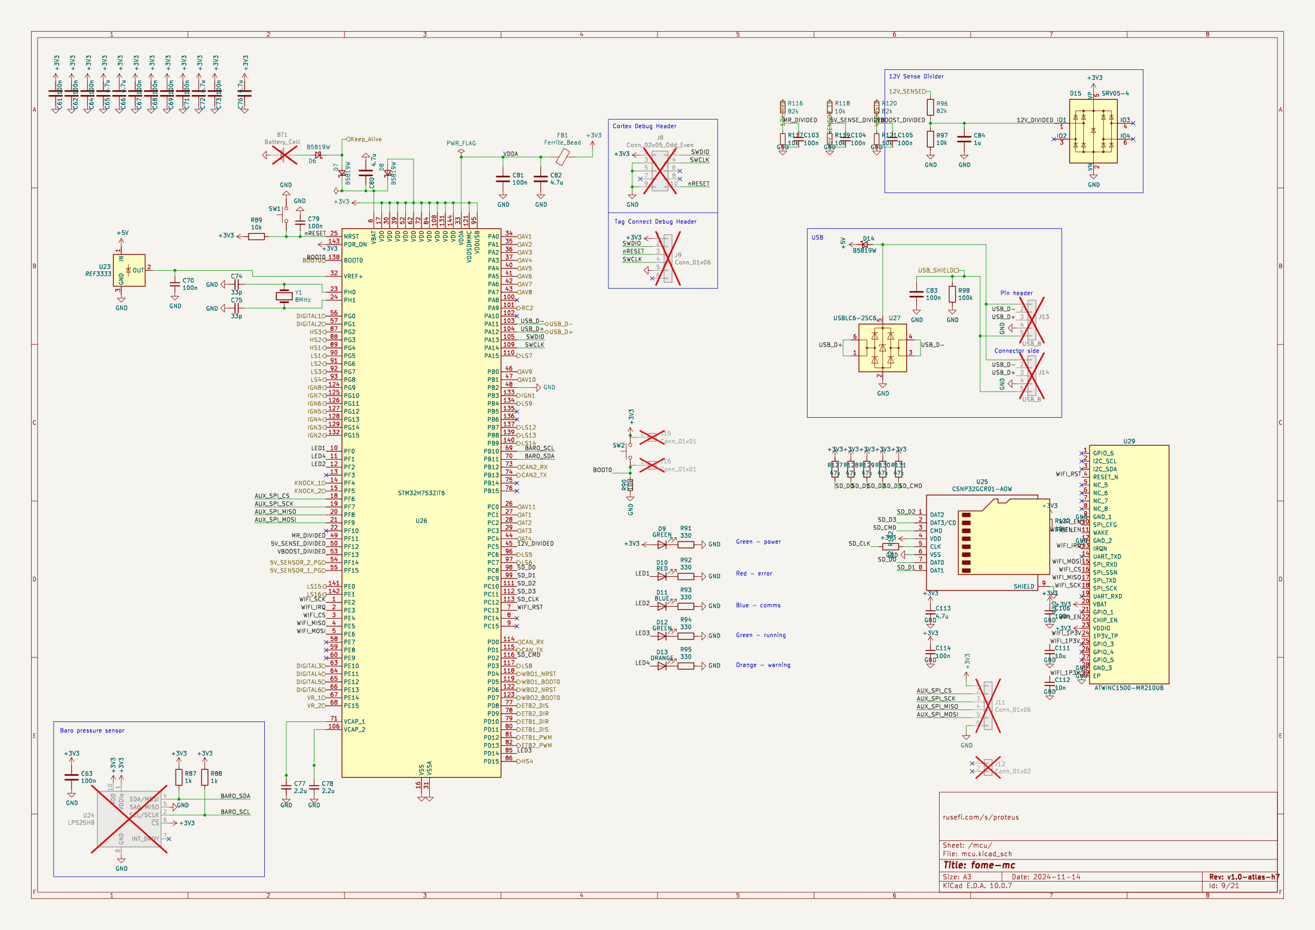
docs/renders/fome-mc-schematic-mcu.png
