halbritt/fome-mc/docs/renders/fome-mc-schematic-root.png

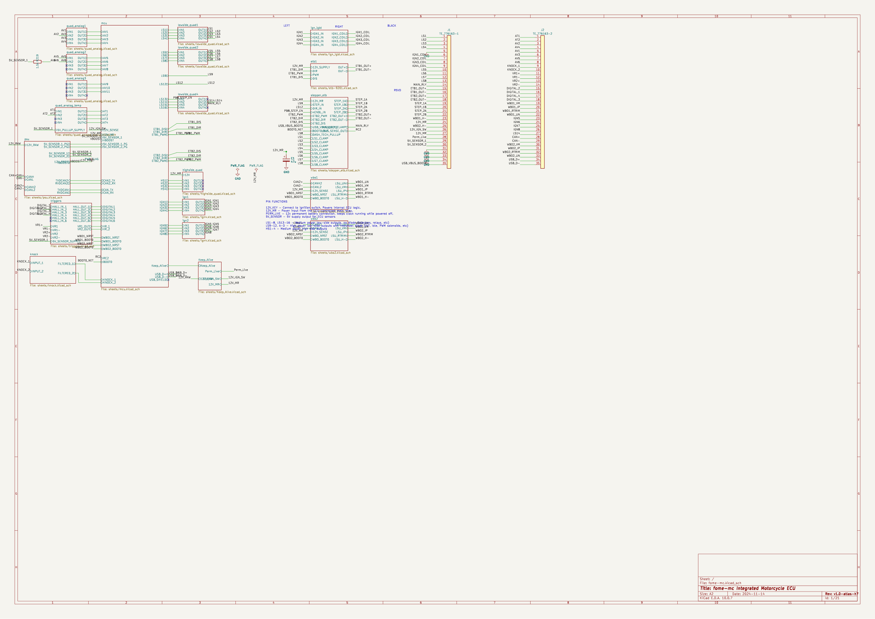
docs/renders/fome-mc-schematic-root.png
