halbritt/fome-mc/docs/renders/fome-mc-schematic-stepper-etb.png

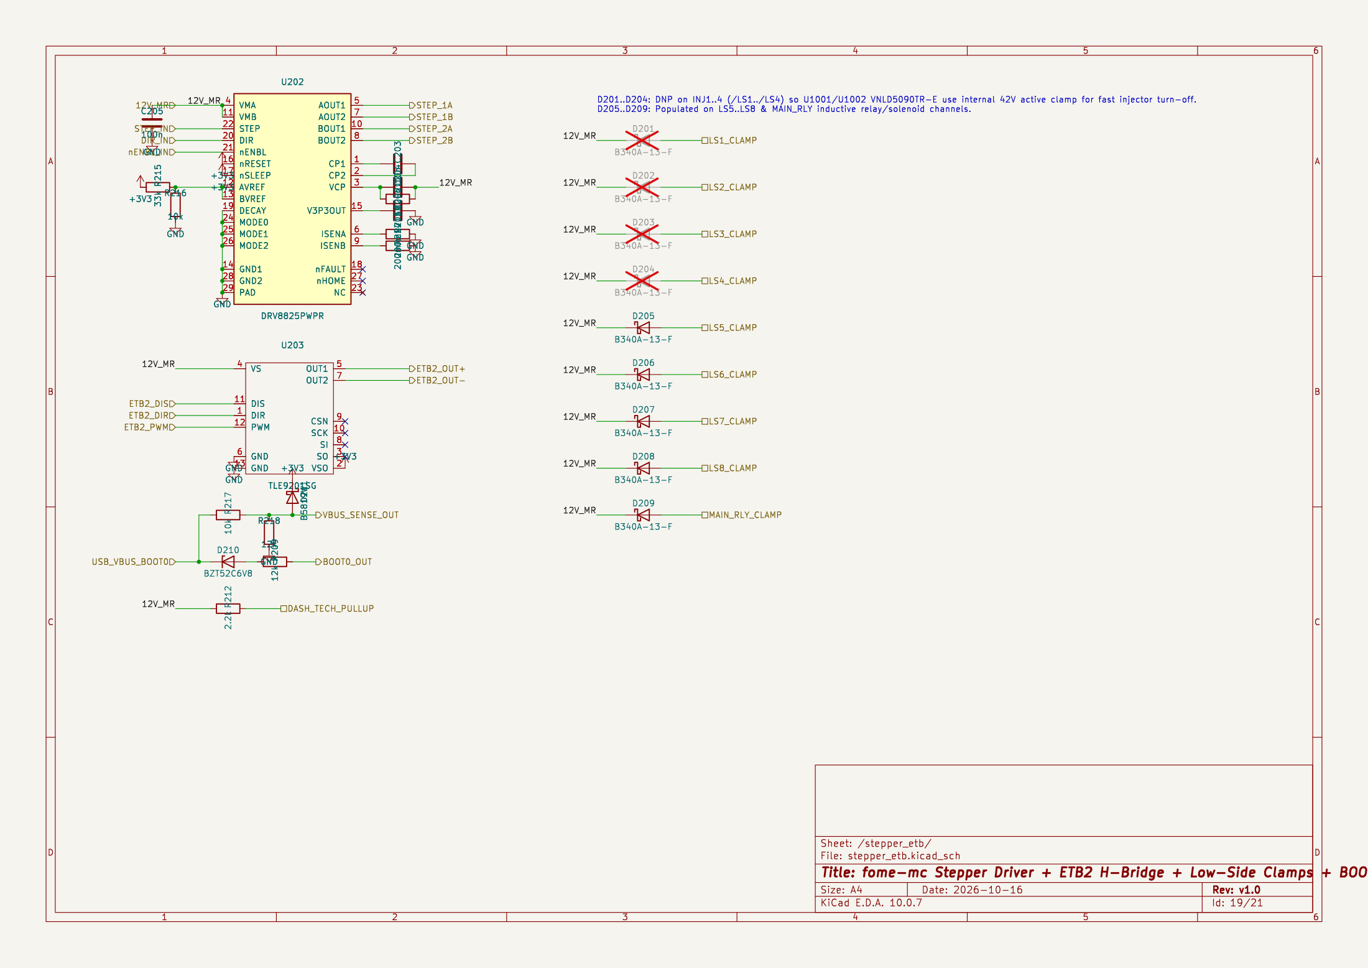
docs/renders/fome-mc-schematic-stepper-etb.png
