halbritt/fome-mc/docs/renders/fome-mc-schematic-wbo1.png

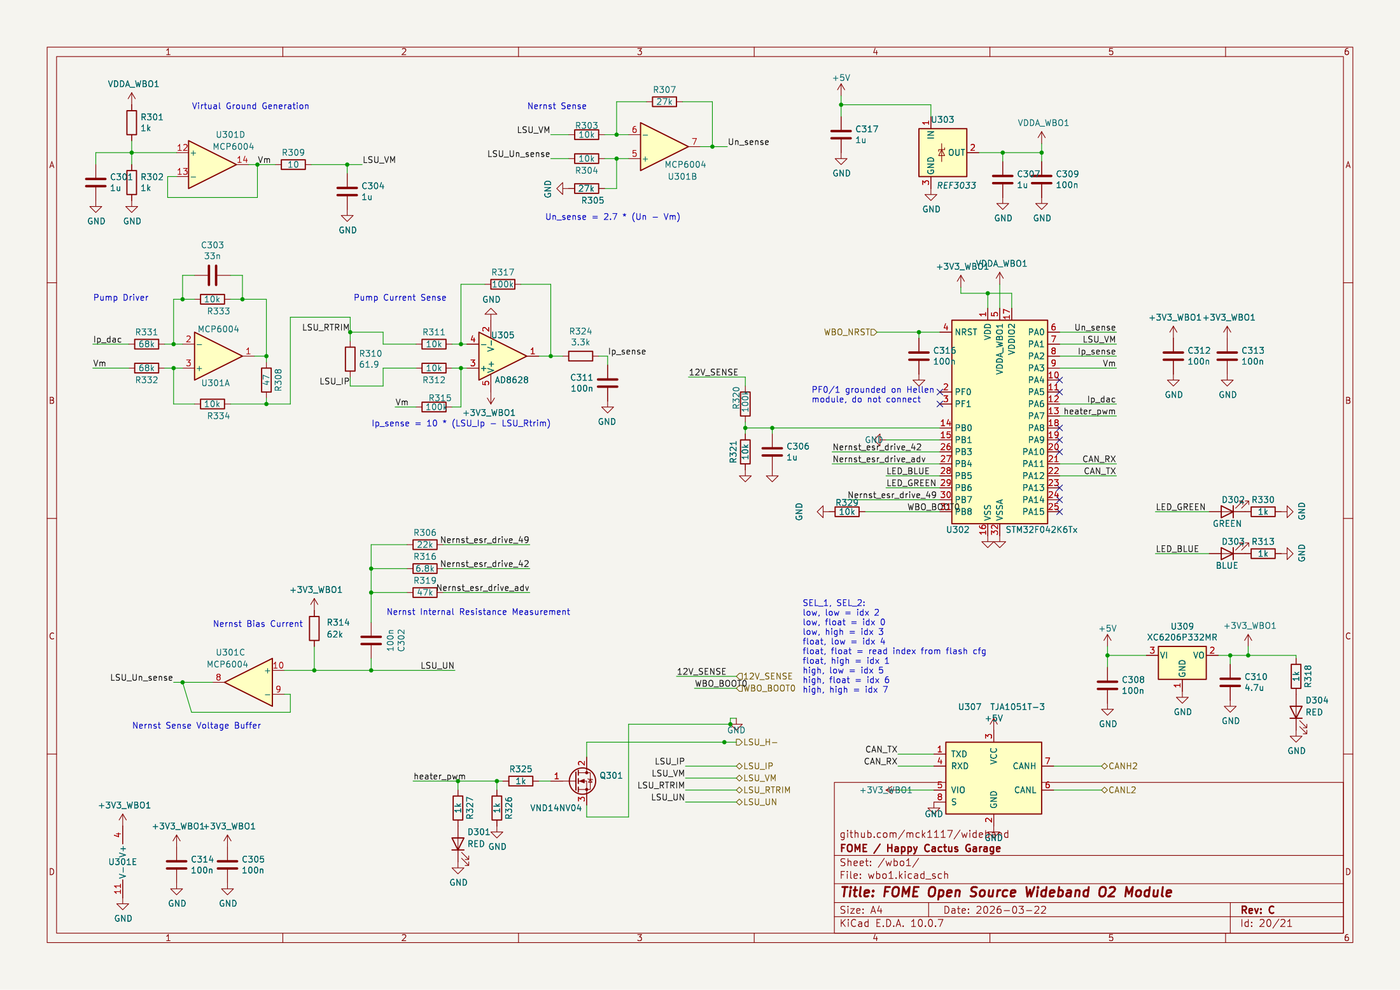
docs/renders/fome-mc-schematic-wbo1.png
