halbritt/fome-mc/telemetry-pod/expansion/agentee-477-3d-models/views/candidate-b1bb009b4e4c-top.png

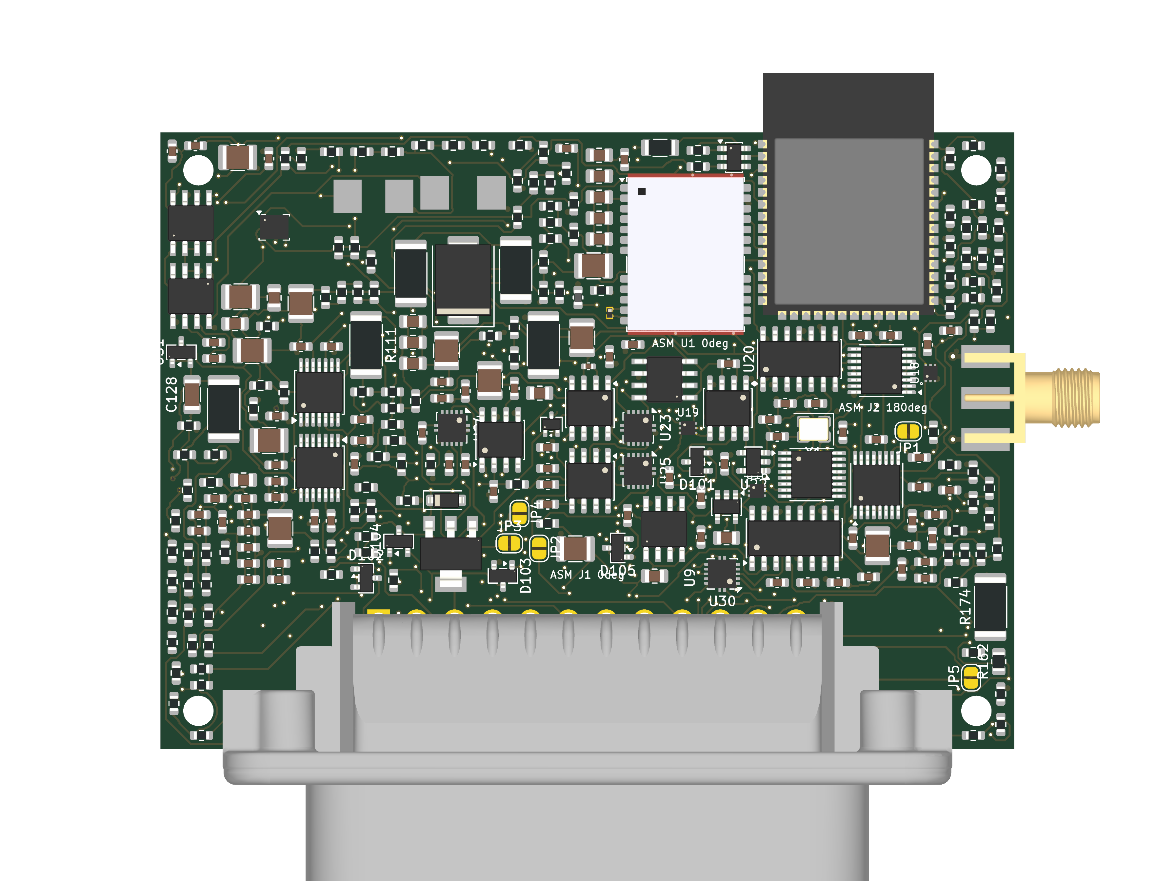
telemetry-pod/expansion/agentee-477-3d-models/views/candidate-b1bb009b4e4c-top.png
