halbritt/fome-mc/telemetry-pod/expansion/agentee-477-3d-models/views/fit-D3.png

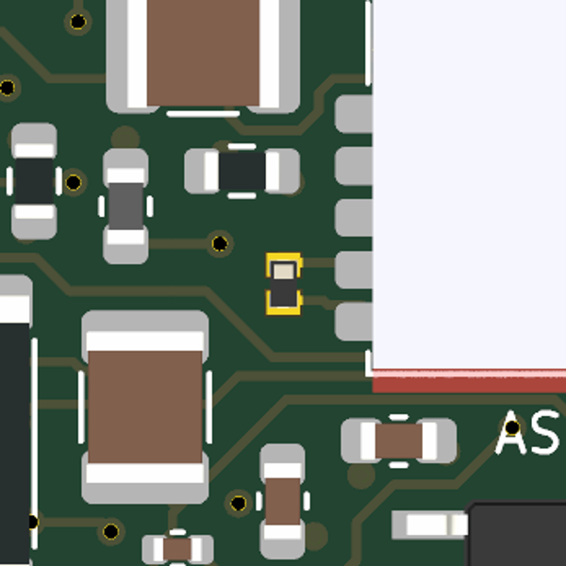
telemetry-pod/expansion/agentee-477-3d-models/views/fit-D3.png
