halbritt/fome-mc/telemetry-pod/expansion/agentee-477-3d-models/views/fit-U12.png

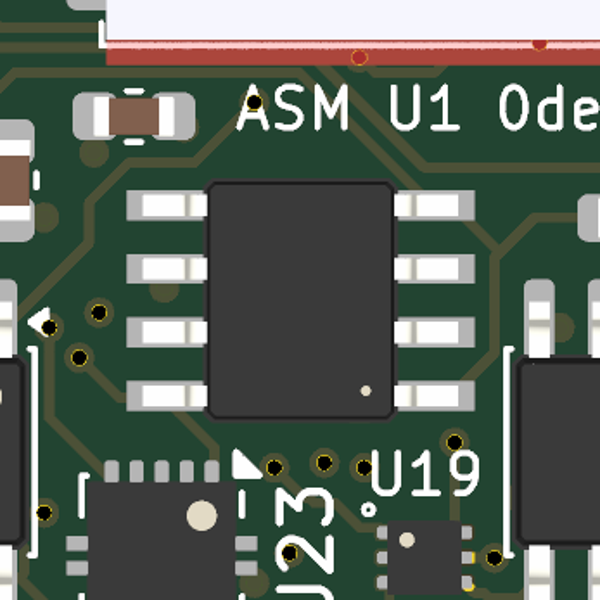
telemetry-pod/expansion/agentee-477-3d-models/views/fit-U12.png
