halbritt/fome-mc/telemetry-pod/expansion/agentee-477-3d-models/views/q1-rotation-plus90-left-minus90-right.png

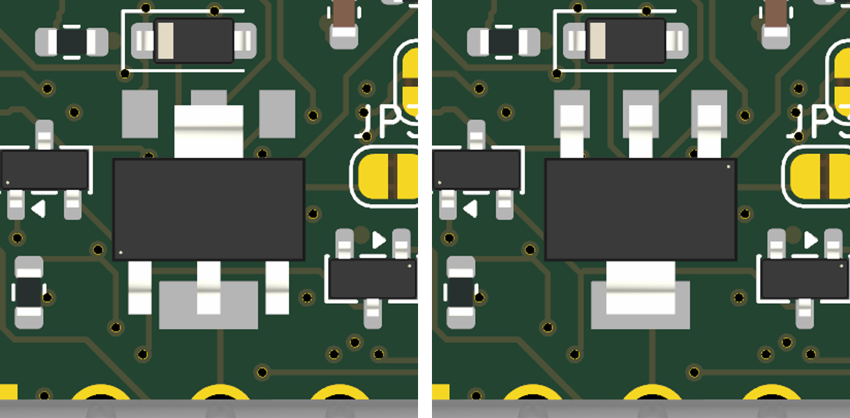
telemetry-pod/expansion/agentee-477-3d-models/views/q1-rotation-plus90-left-minus90-right.png
