halbritt/fome-mc/telemetry-pod/expansion/interface-preparation/sensor-power/review/block.png

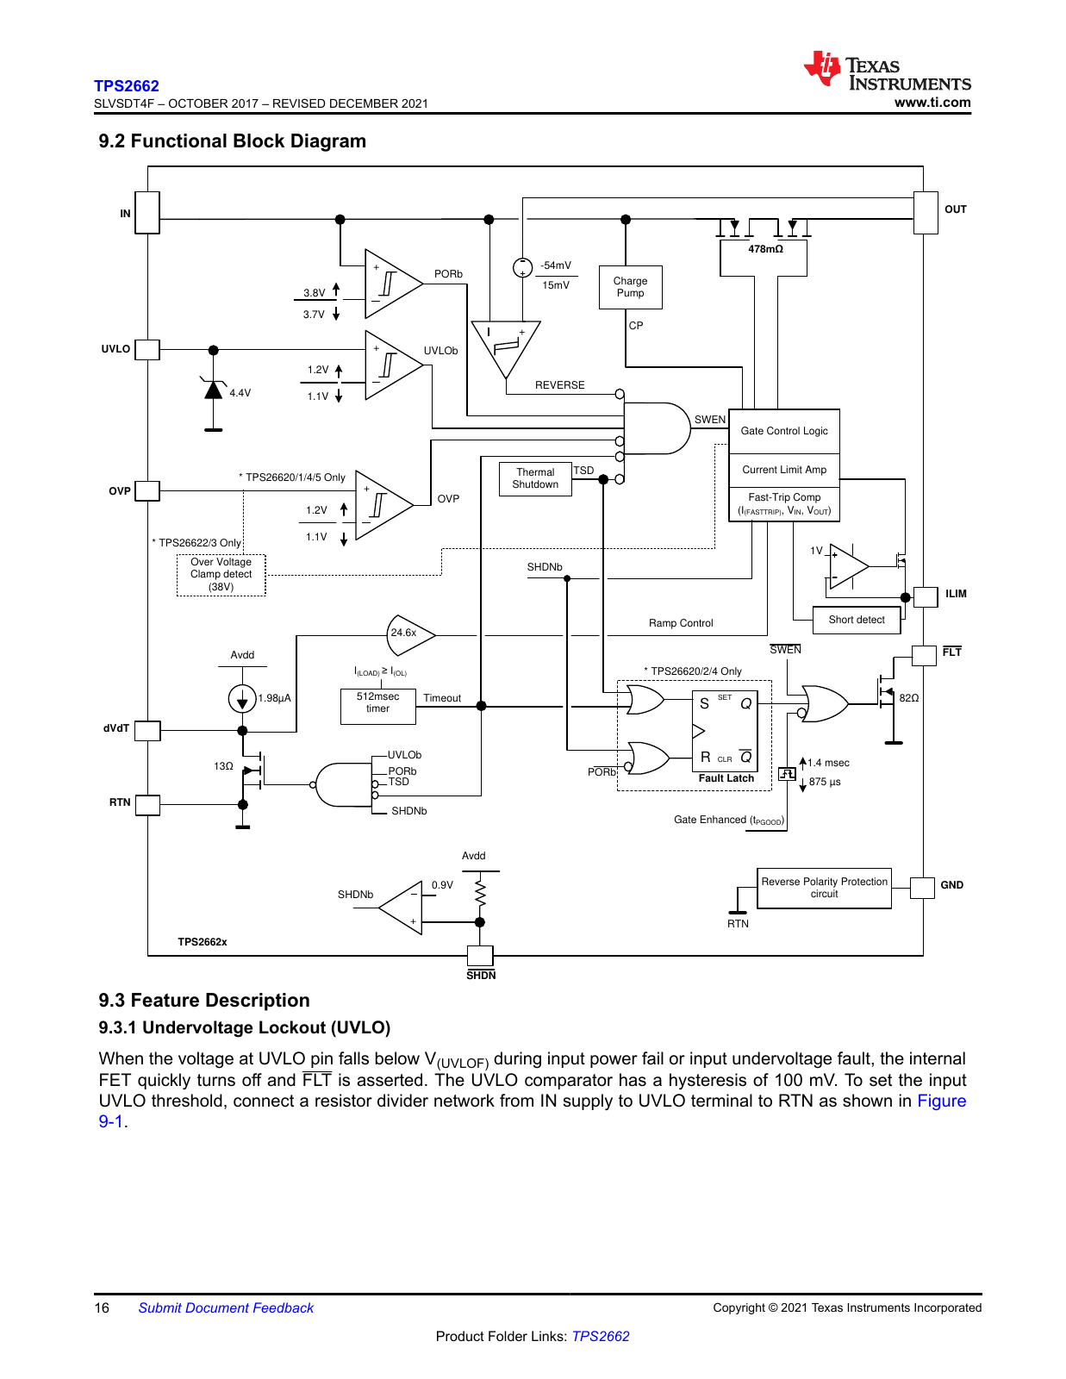
telemetry-pod/expansion/interface-preparation/sensor-power/review/block.png
