halbritt/fome-mc/telemetry-pod/expansion/interface-preparation/sources/crystal.png

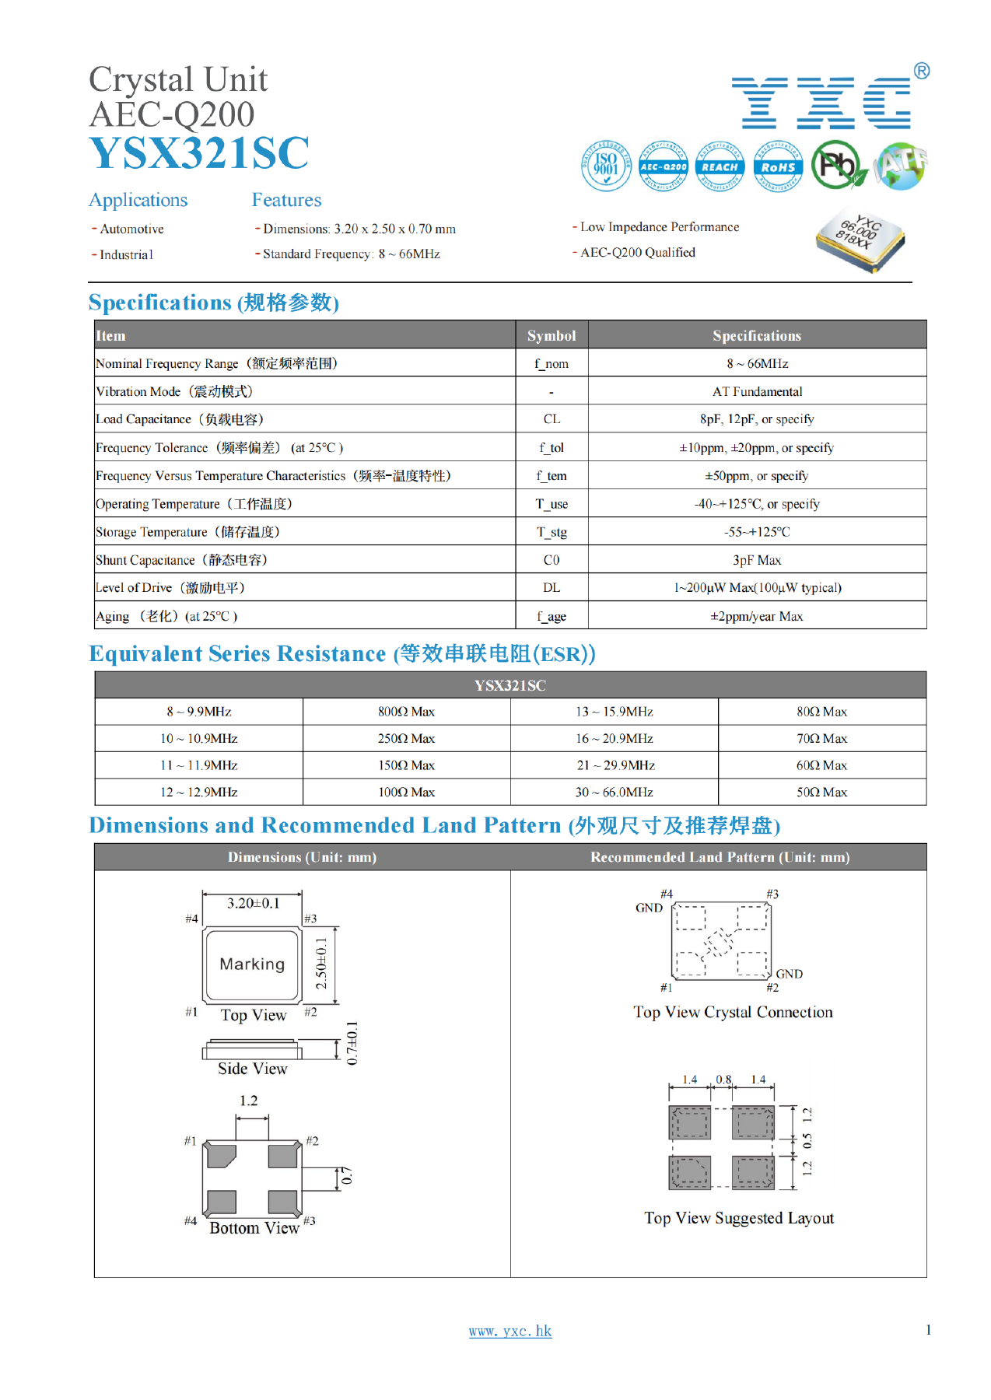
telemetry-pod/expansion/interface-preparation/sources/crystal.png
