halbritt/fome-mc/telemetry-pod/expansion/neo-m9n-model/evidence/native-u3-closeup.png

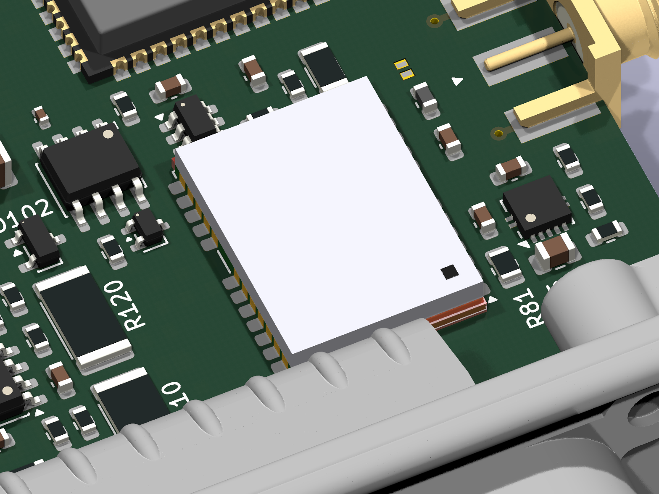
telemetry-pod/expansion/neo-m9n-model/evidence/native-u3-closeup.png
