halbritt/fome-mc/telemetry-pod/expansion/placement-r3/inspect-287/INCOMPLETE-r2-287-free-space-F.png

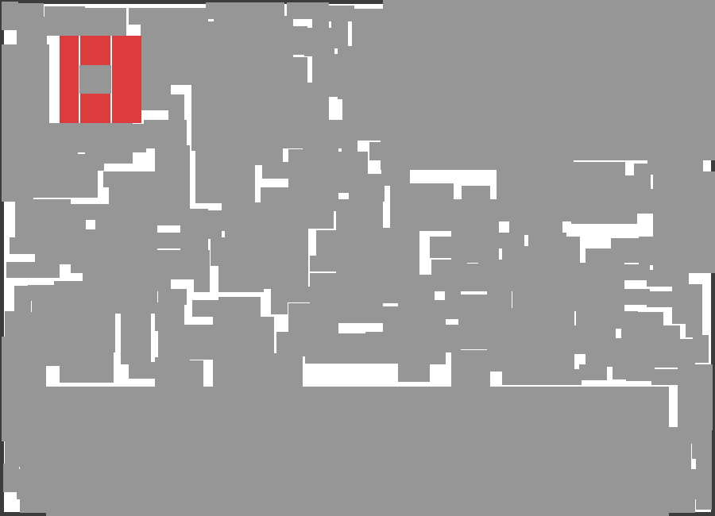
telemetry-pod/expansion/placement-r3/inspect-287/INCOMPLETE-r2-287-free-space-F.png
