halbritt/fome-mc/telemetry-pod/expansion/placement-r5/render/candidate-8f3bc2343055-back.png

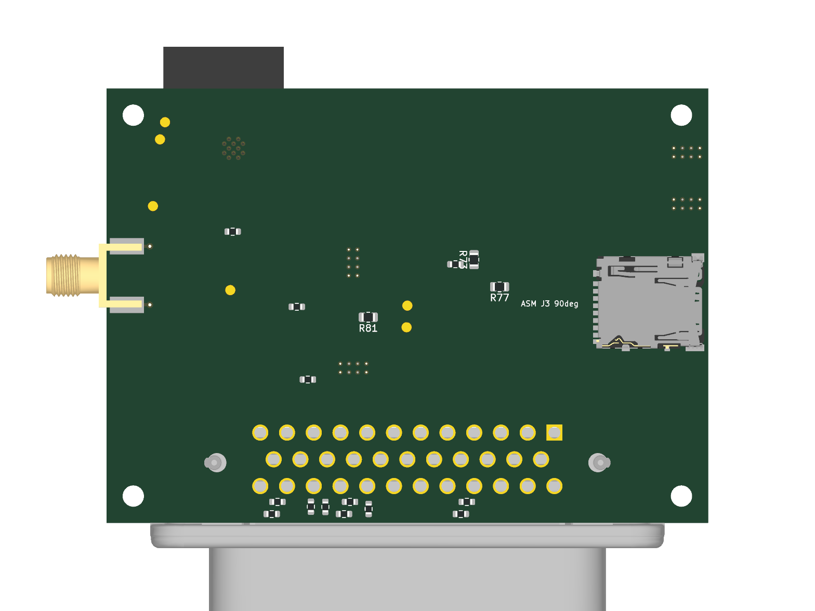
telemetry-pod/expansion/placement-r5/render/candidate-8f3bc2343055-back.png
