halbritt/fome-mc/telemetry-pod/expansion/released-presentation/candidate/emmc-region.png

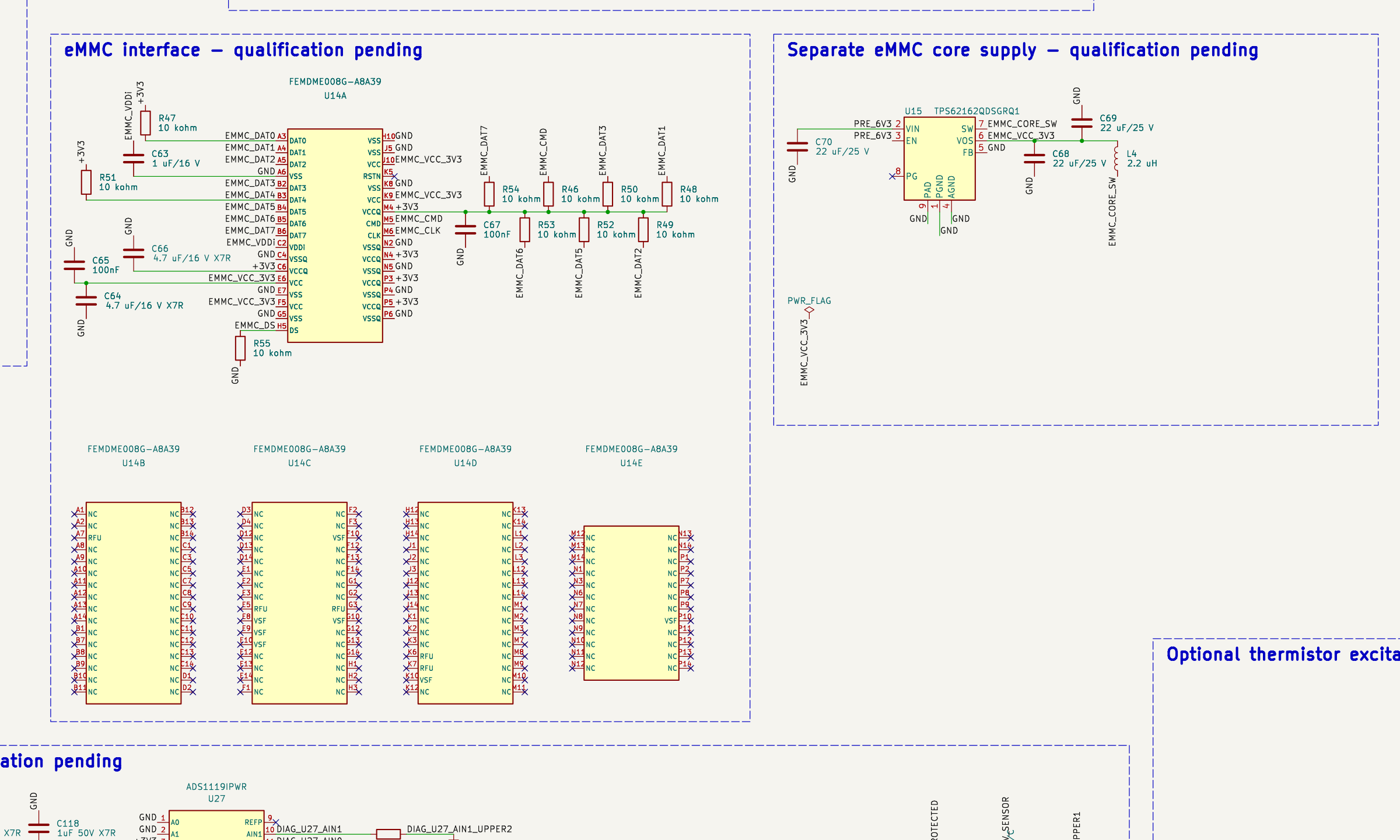
telemetry-pod/expansion/released-presentation/candidate/emmc-region.png
