halbritt/fome-mc/telemetry-pod/expansion/released-presentation/candidate/overview.png

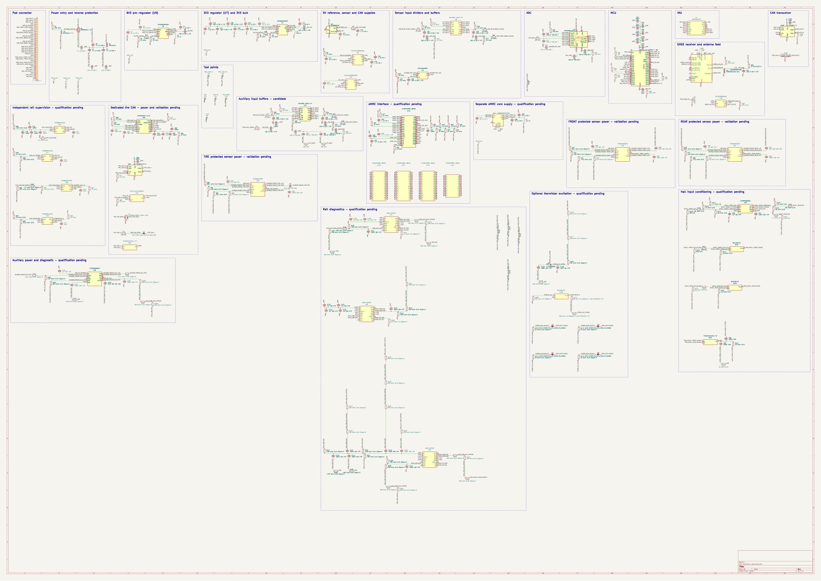
telemetry-pod/expansion/released-presentation/candidate/overview.png
