halbritt/fome-mc/telemetry-pod/expansion/route-1/render/candidate-19ed7954ab30-front.png

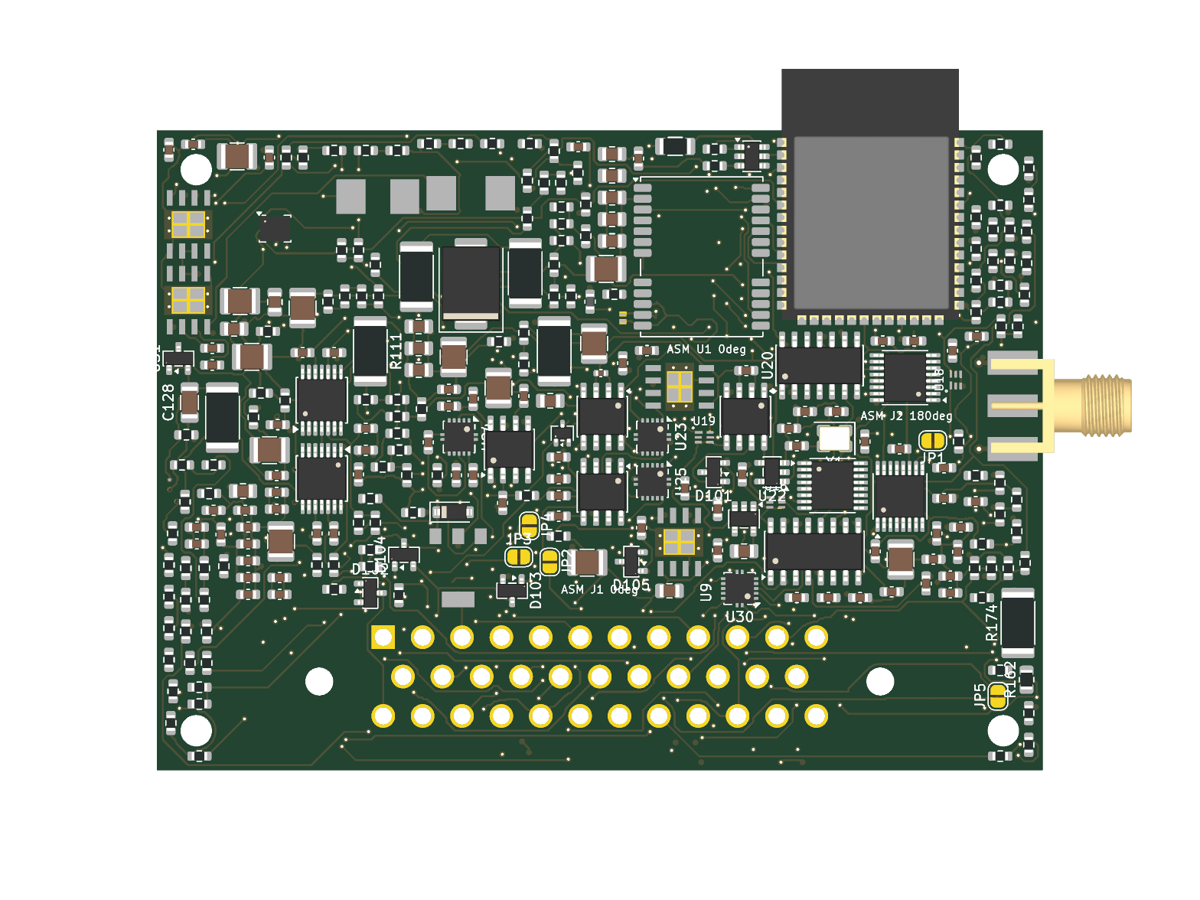
telemetry-pod/expansion/route-1/render/candidate-19ed7954ab30-front.png
