halbritt/fome-mc/telemetry-pod/expansion/route-2/render/INCOMPLETE-candidate-19ed7954ab30-back.png

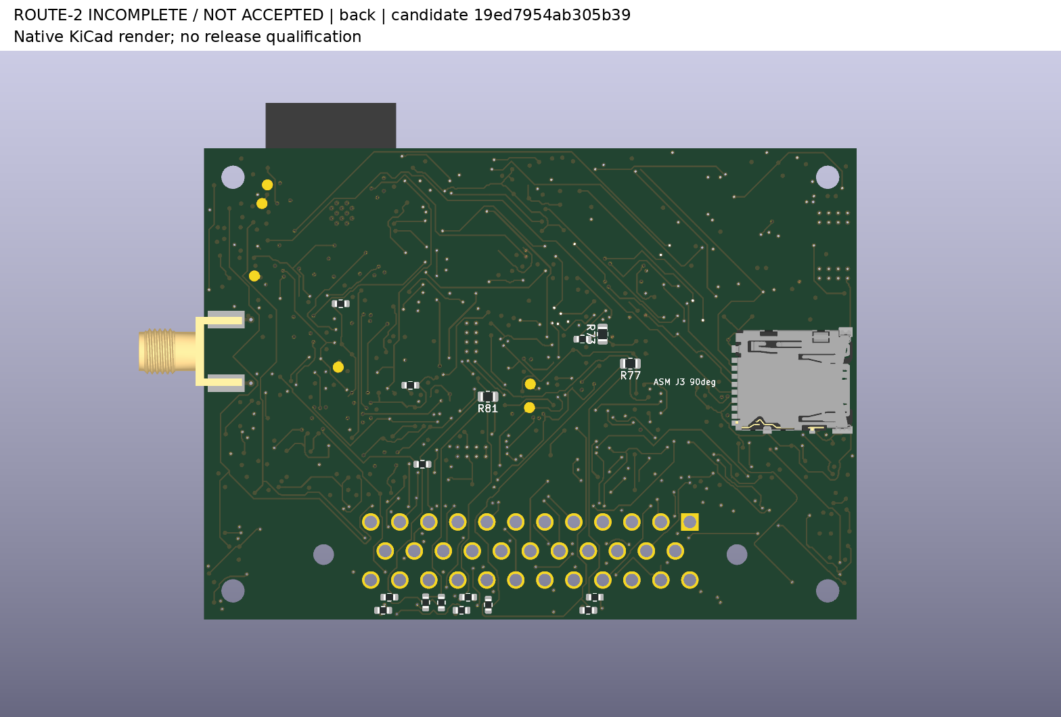
telemetry-pod/expansion/route-2/render/INCOMPLETE-candidate-19ed7954ab30-back.png
