halbritt/fome-mc/telemetry-pod/expansion/series-divider/review/full-sheet/bottom-left.png

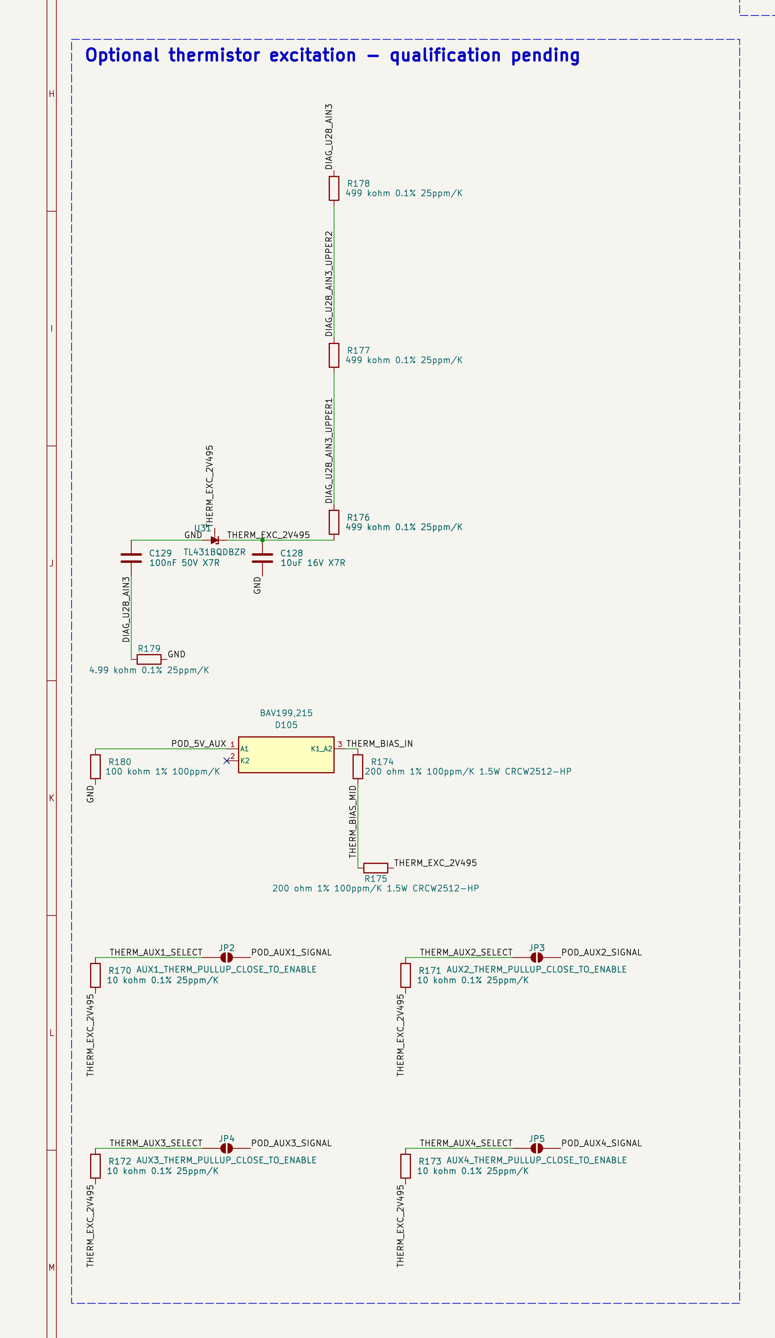
telemetry-pod/expansion/series-divider/review/full-sheet/bottom-left.png
