halbritt/fome-mc/telemetry-pod/expansion/series-divider/review/full-sheet/diagnostics.png

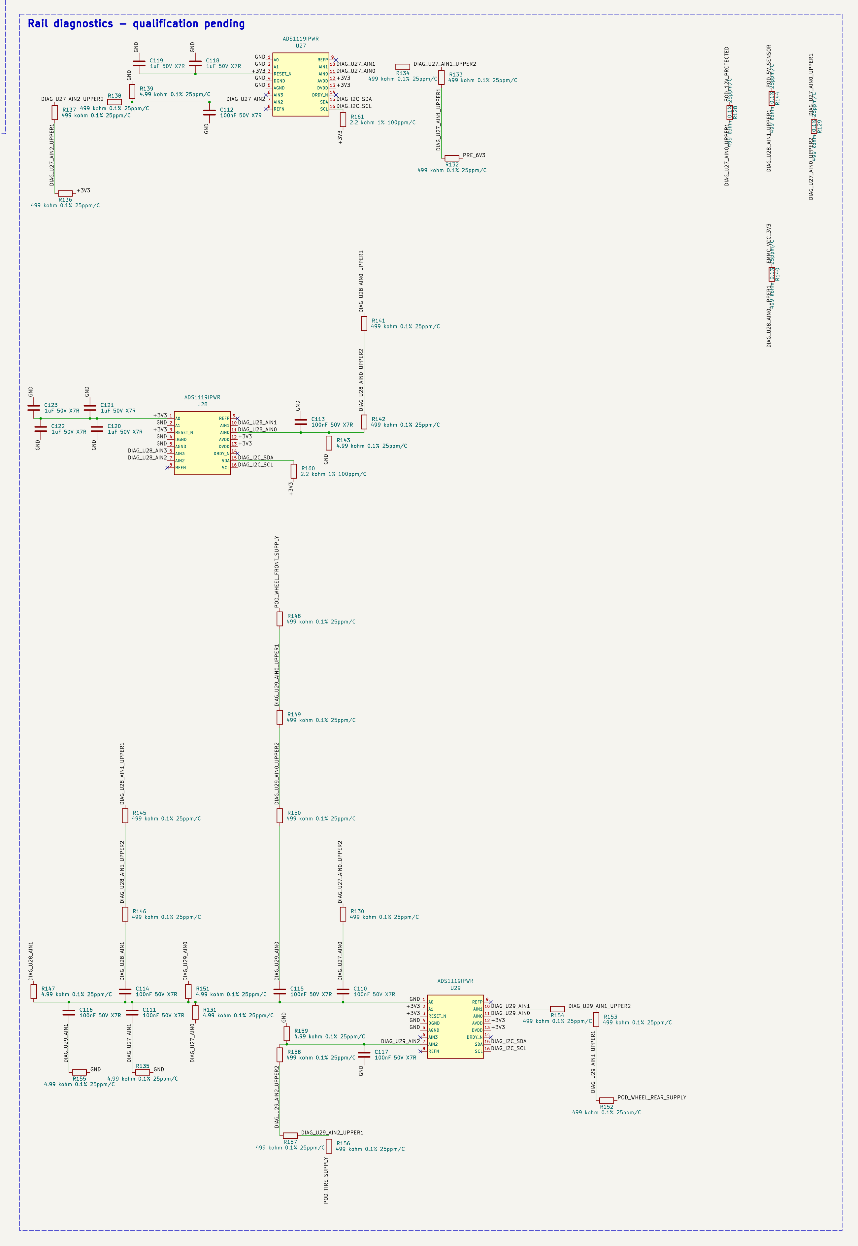
telemetry-pod/expansion/series-divider/review/full-sheet/diagnostics.png
