halbritt/fome-mc/telemetry-pod/expansion/series-divider/review/full-sheet/middle-center.png

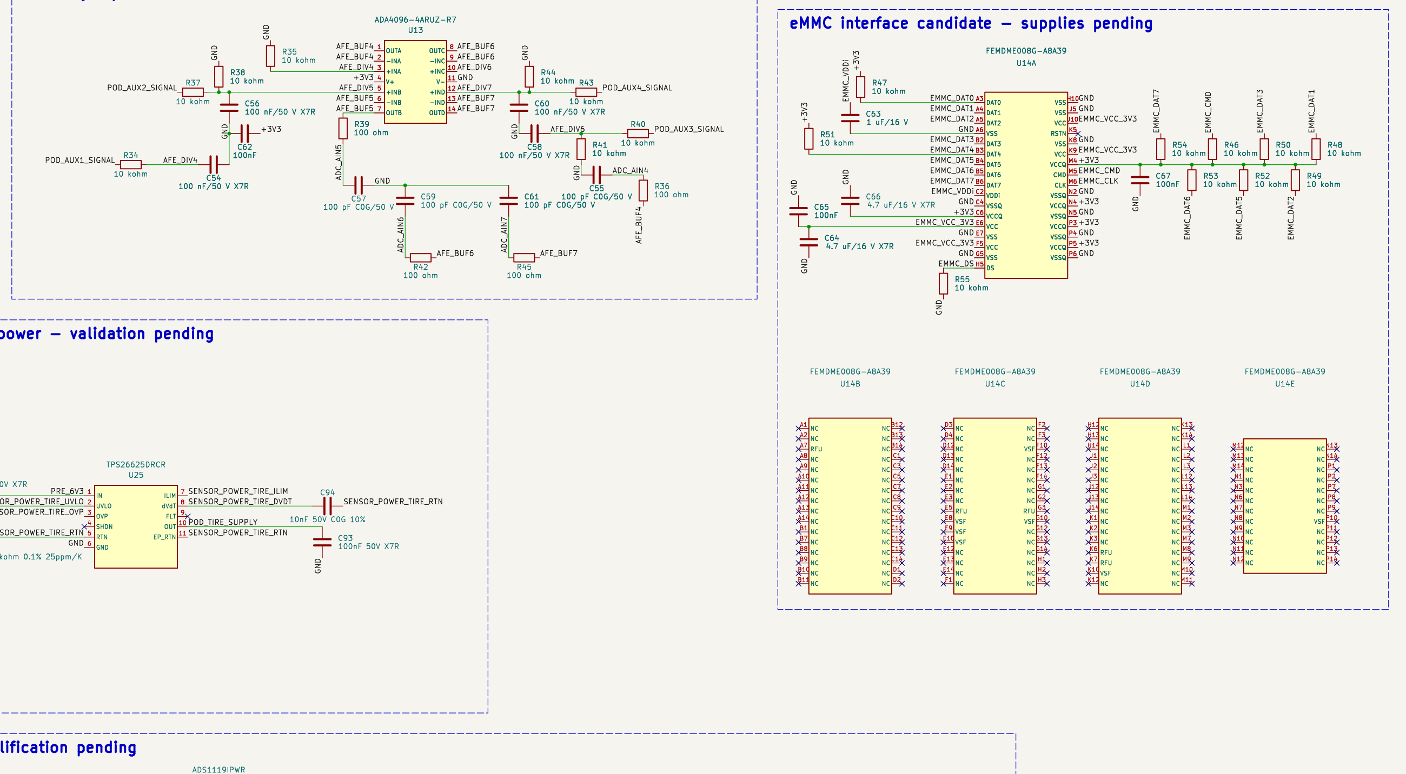
telemetry-pod/expansion/series-divider/review/full-sheet/middle-center.png
