halbritt/fome-mc/telemetry-pod/expansion/series-divider/review/full-sheet/middle-left.png

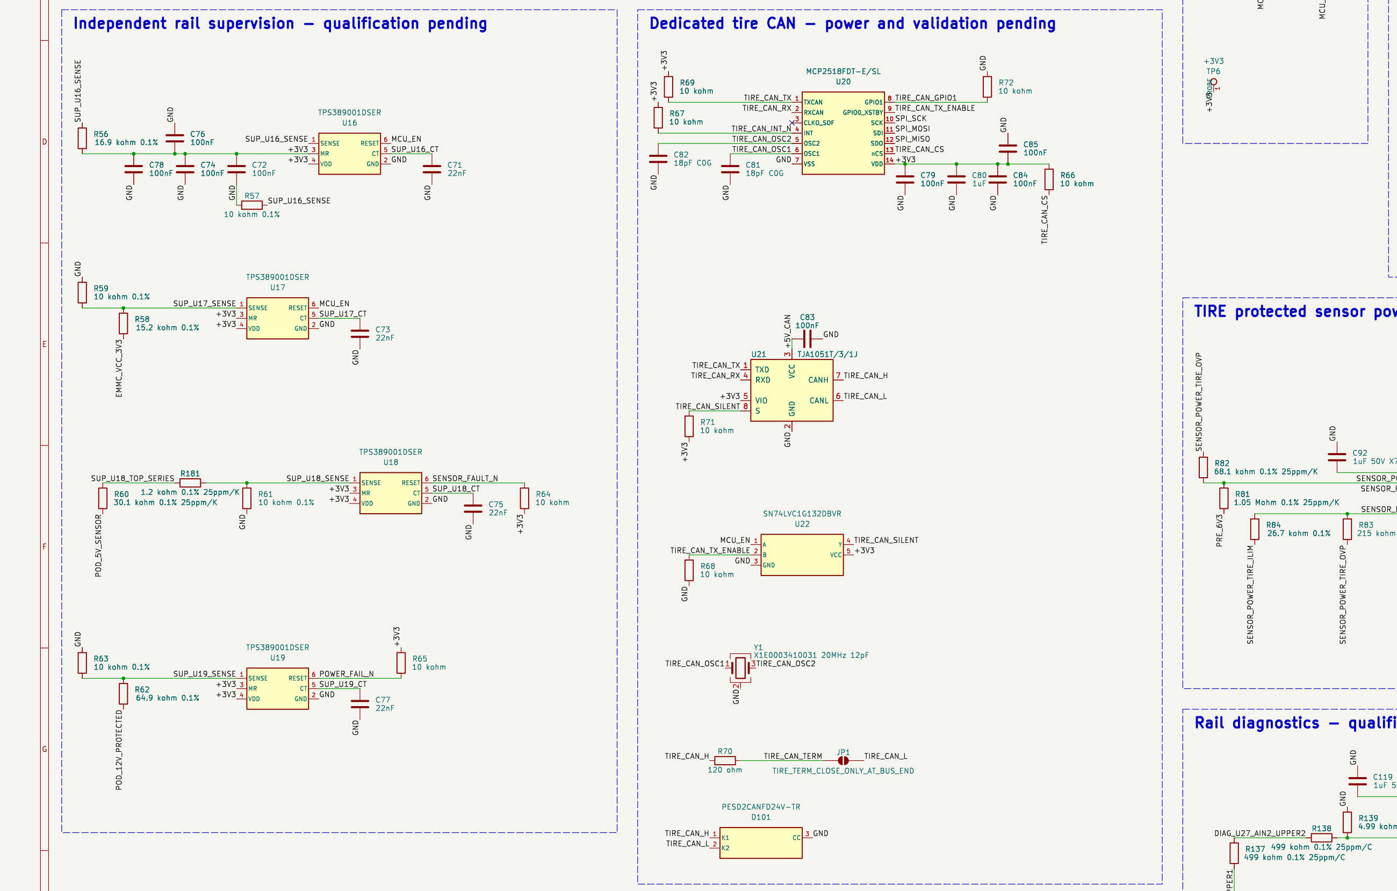
telemetry-pod/expansion/series-divider/review/full-sheet/middle-left.png
