halbritt/fome-mc/telemetry-pod/expansion/series-divider/review/full-sheet/middle-right.png

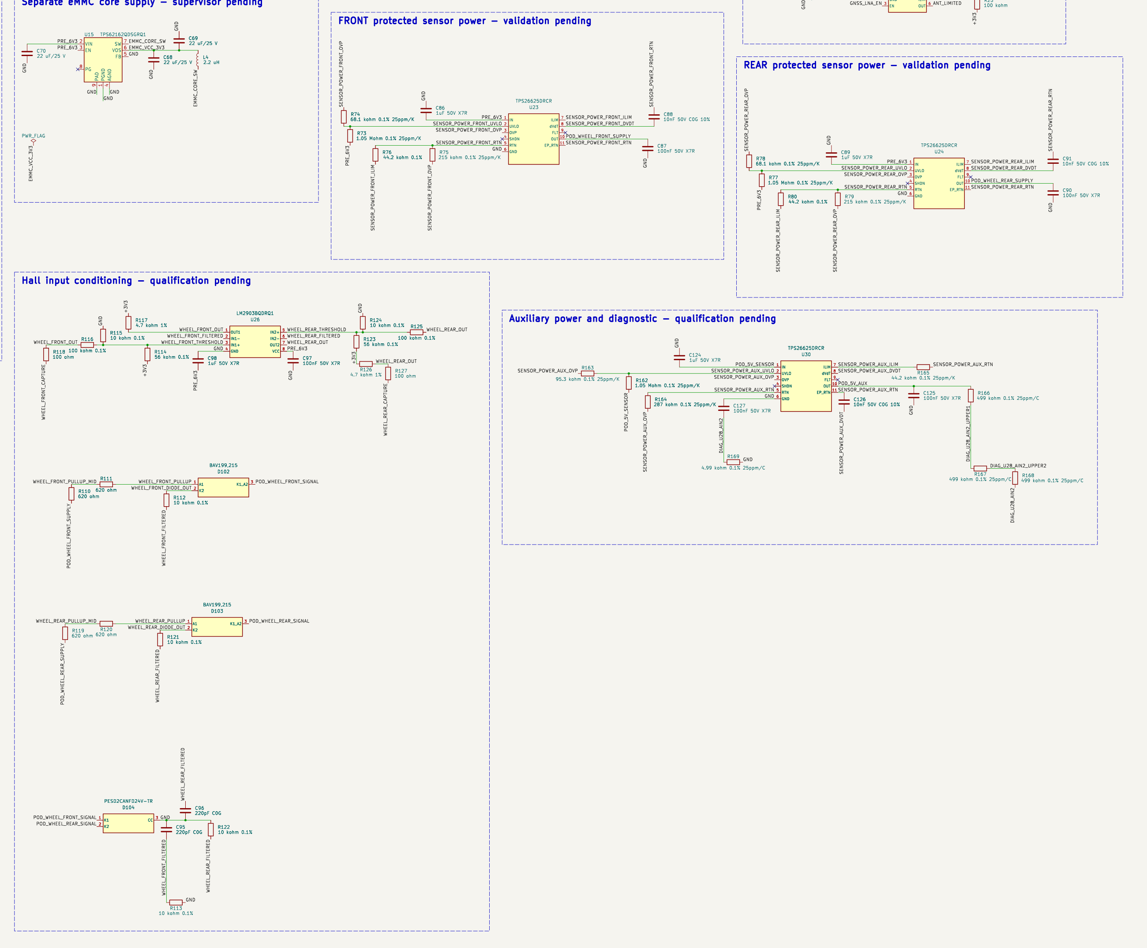
telemetry-pod/expansion/series-divider/review/full-sheet/middle-right.png
