halbritt/fome-mc/telemetry-pod/expansion/series-divider/review/full-sheet/top-left.png

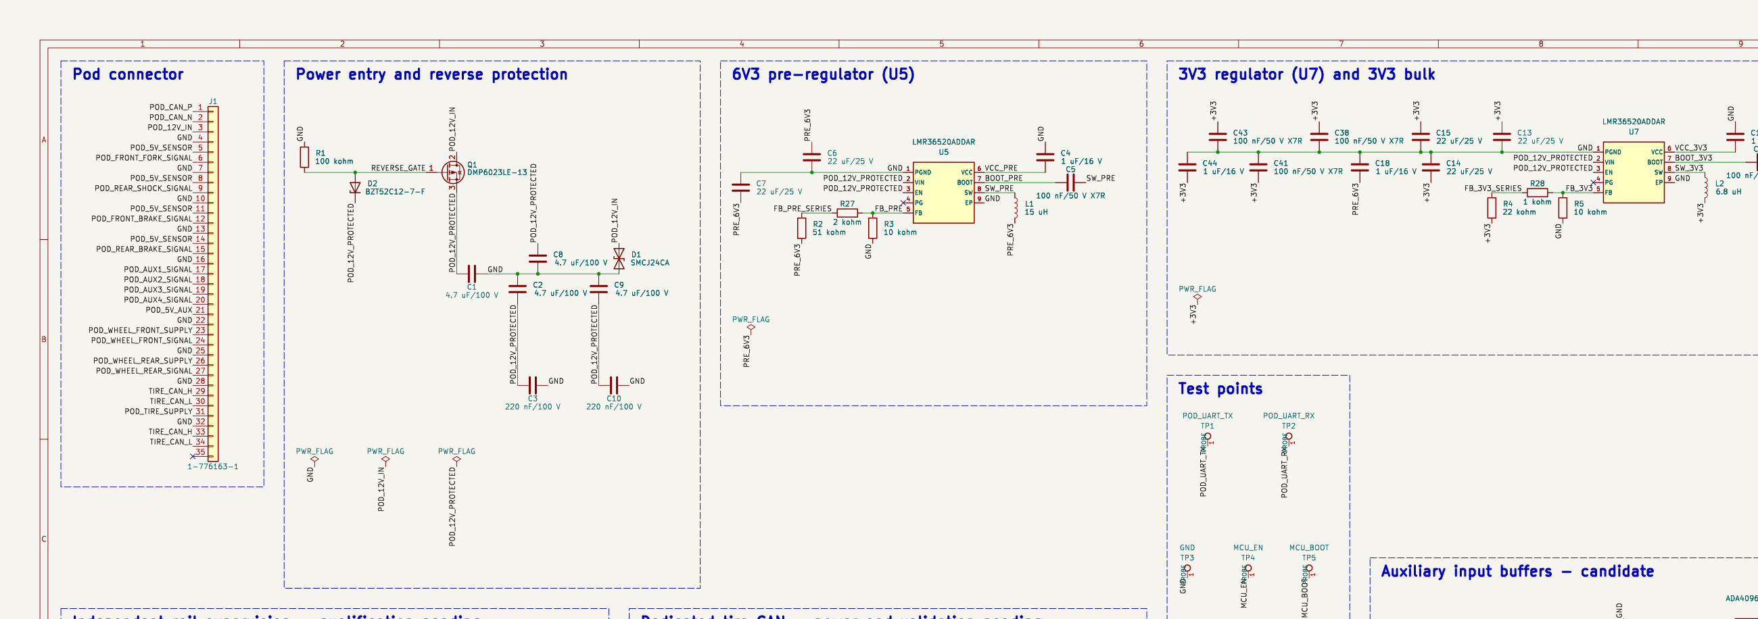
telemetry-pod/expansion/series-divider/review/full-sheet/top-left.png
