halbritt/fome-mc/telemetry-pod/expansion/series-divider/review/full-sheet/top-middle.png

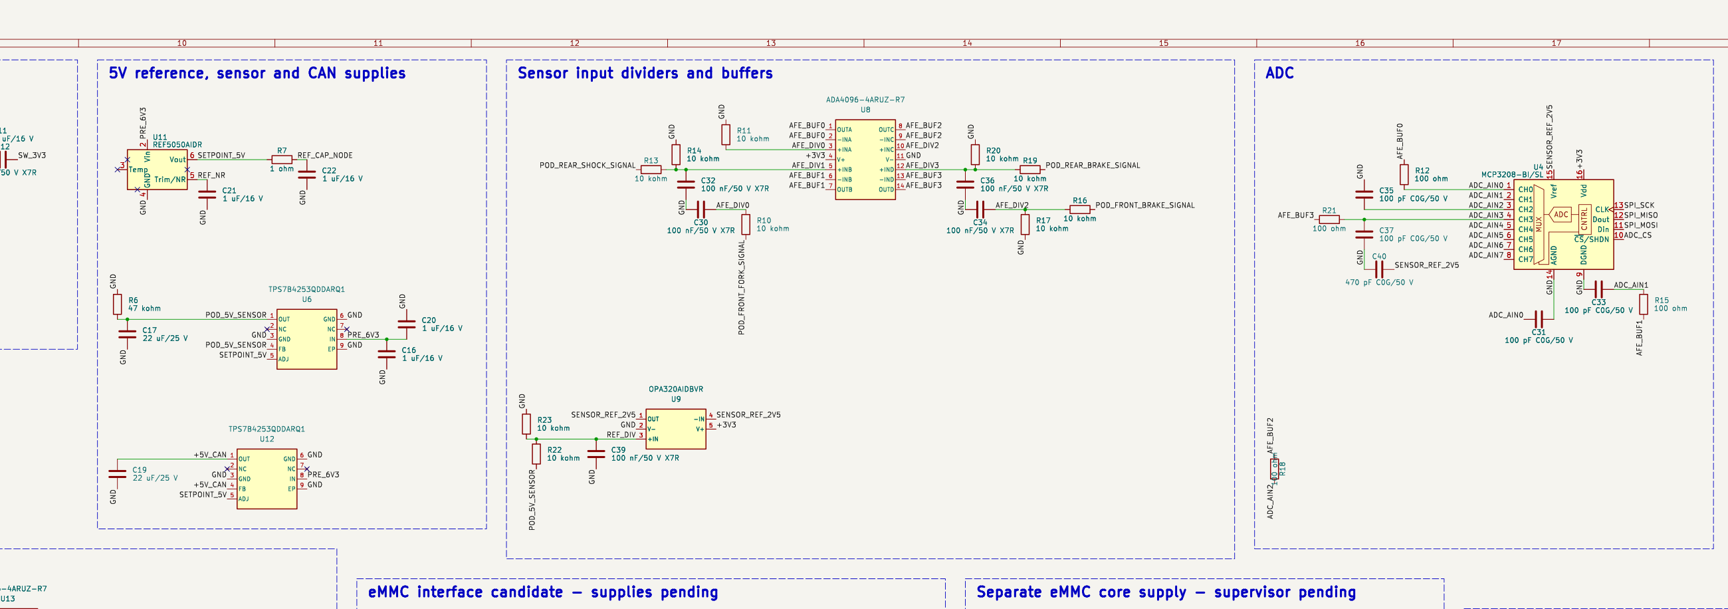
telemetry-pod/expansion/series-divider/review/full-sheet/top-middle.png
