halbritt/fome-mc/telemetry-pod/expansion/series-divider/review/full-sheet/top-right.png

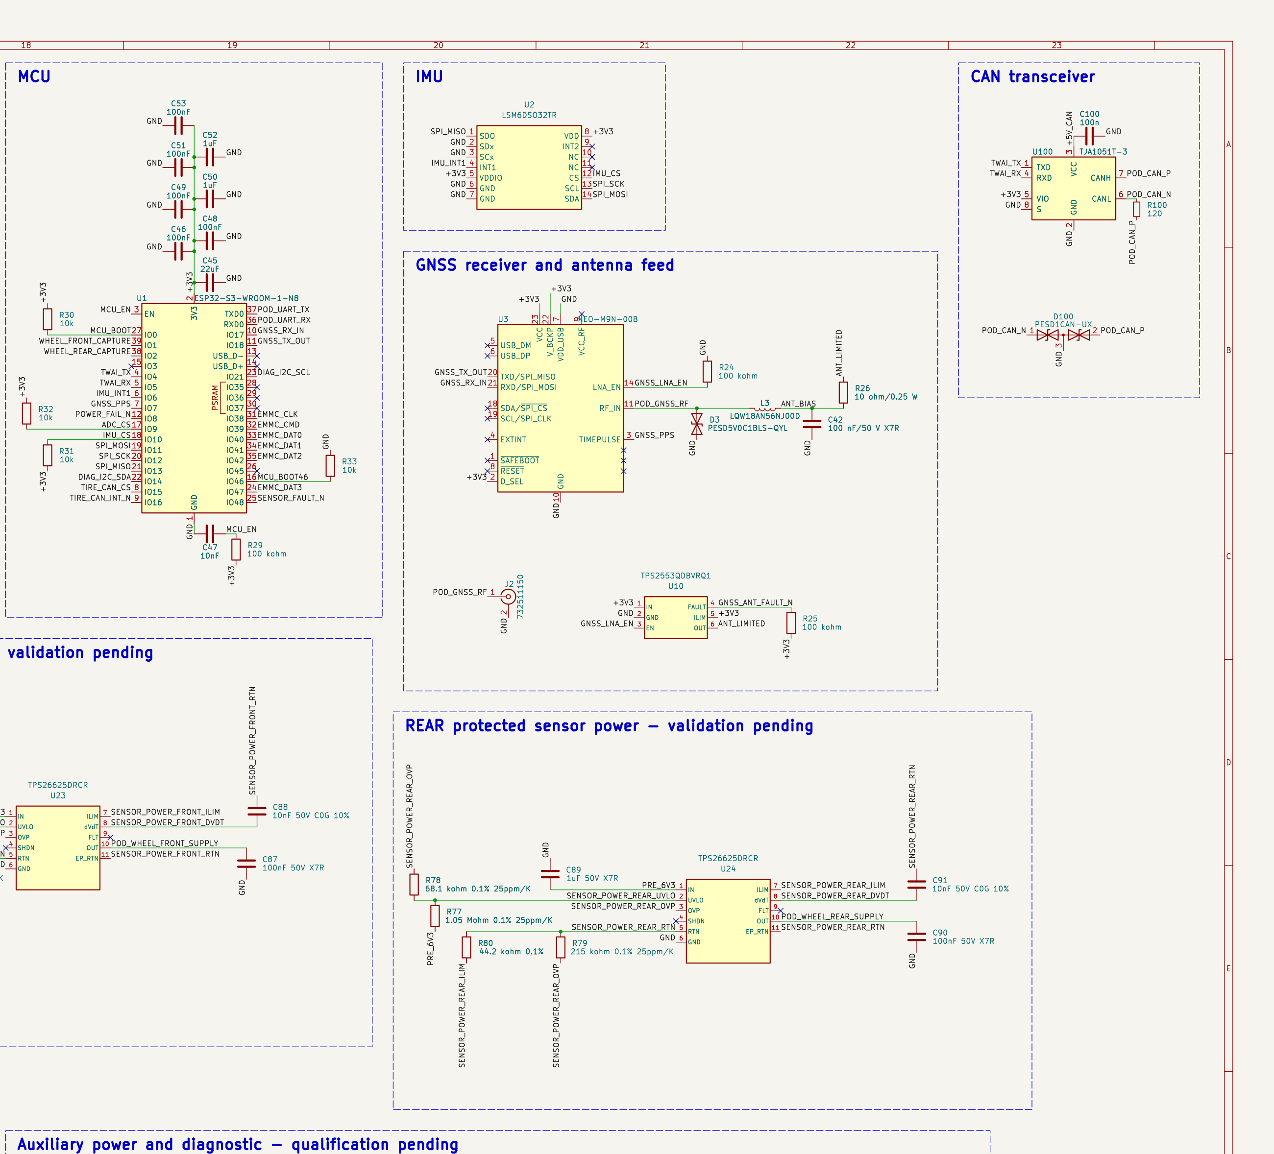
telemetry-pod/expansion/series-divider/review/full-sheet/top-right.png
