halbritt/fome-mc/telemetry-pod/expansion/series-divider/review/overview.png

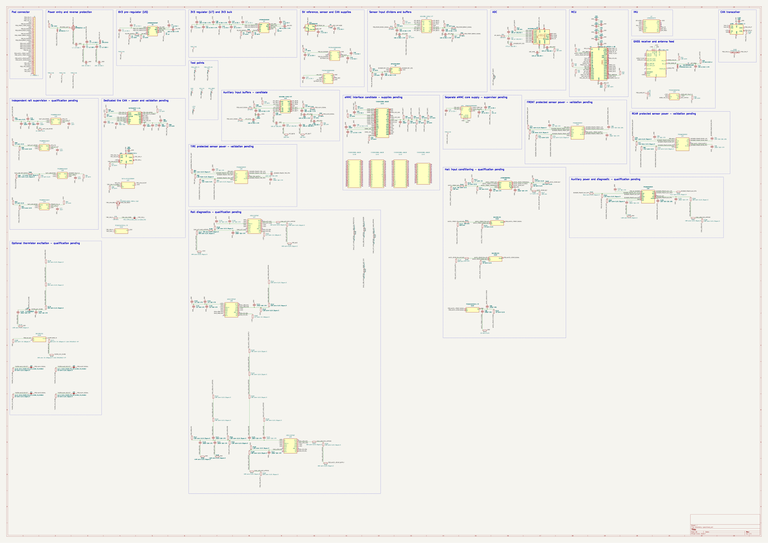
telemetry-pod/expansion/series-divider/review/overview.png
