halbritt/fome-mc/telemetry-pod/expansion/series-divider/review/supervisor.png

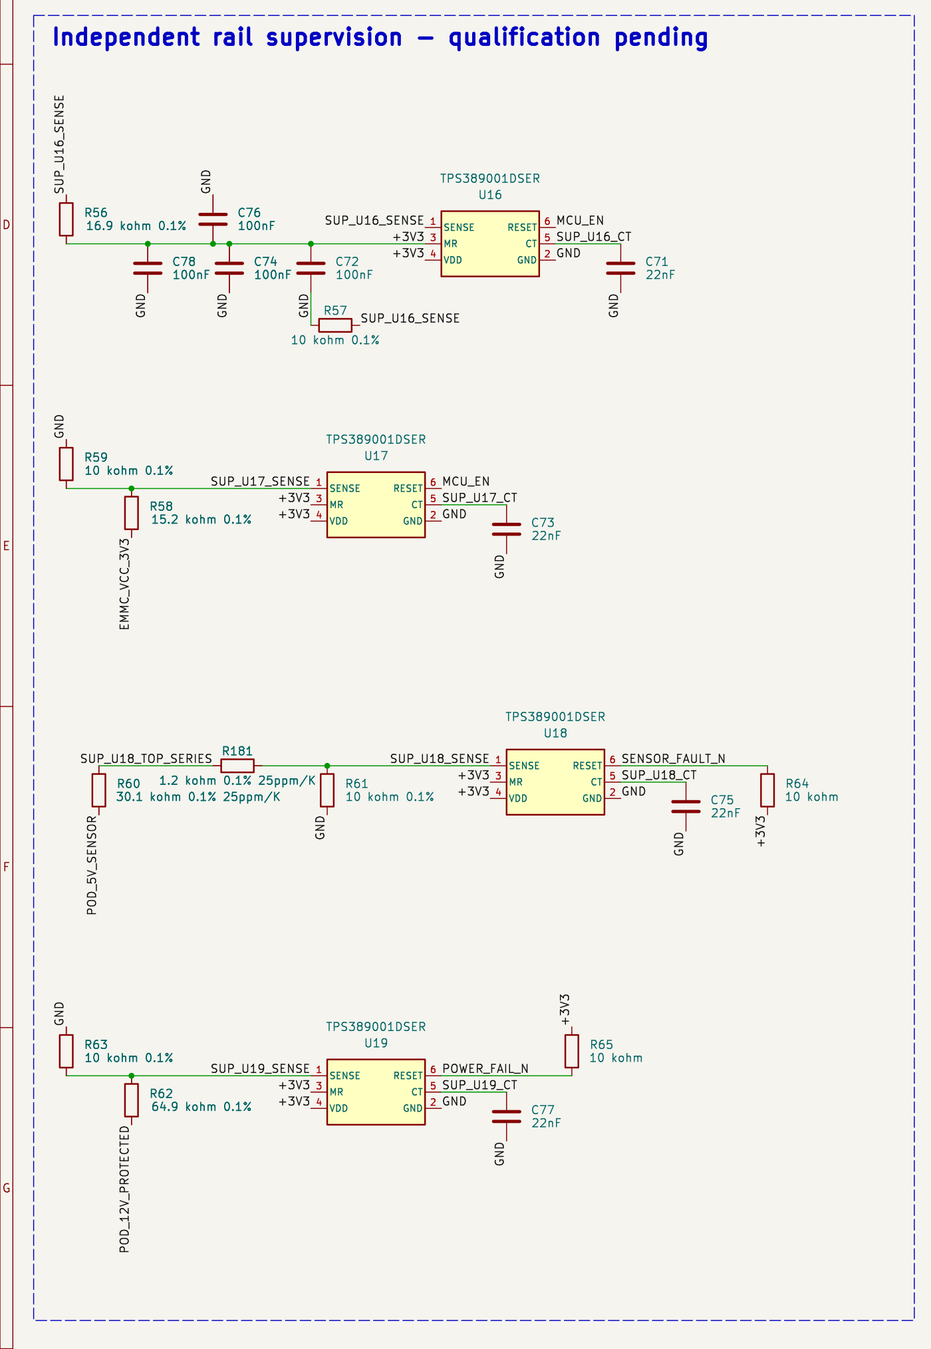
telemetry-pod/expansion/series-divider/review/supervisor.png
