halbritt/fome-mc/telemetry-pod/expansion/text-candidate/renders/diagnostics.png

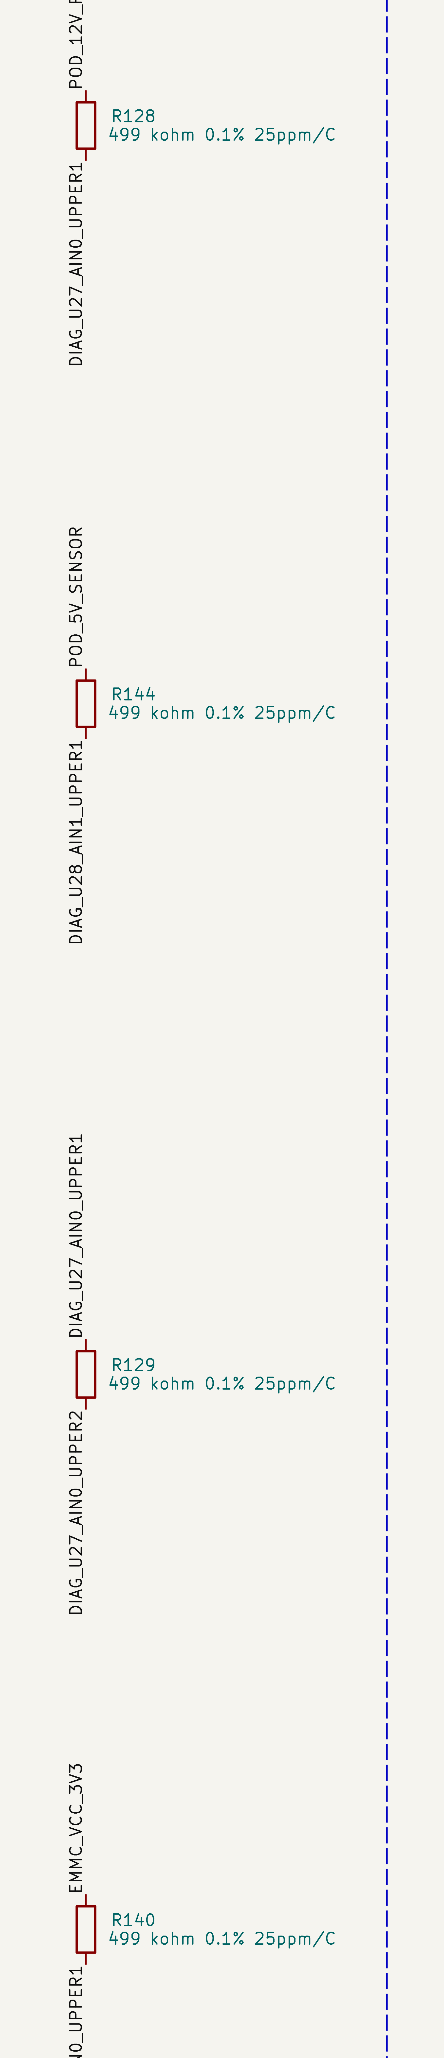
telemetry-pod/expansion/text-candidate/renders/diagnostics.png
