halbritt/fome-mc/telemetry-pod/expansion/text-candidate/renders/longfields.png

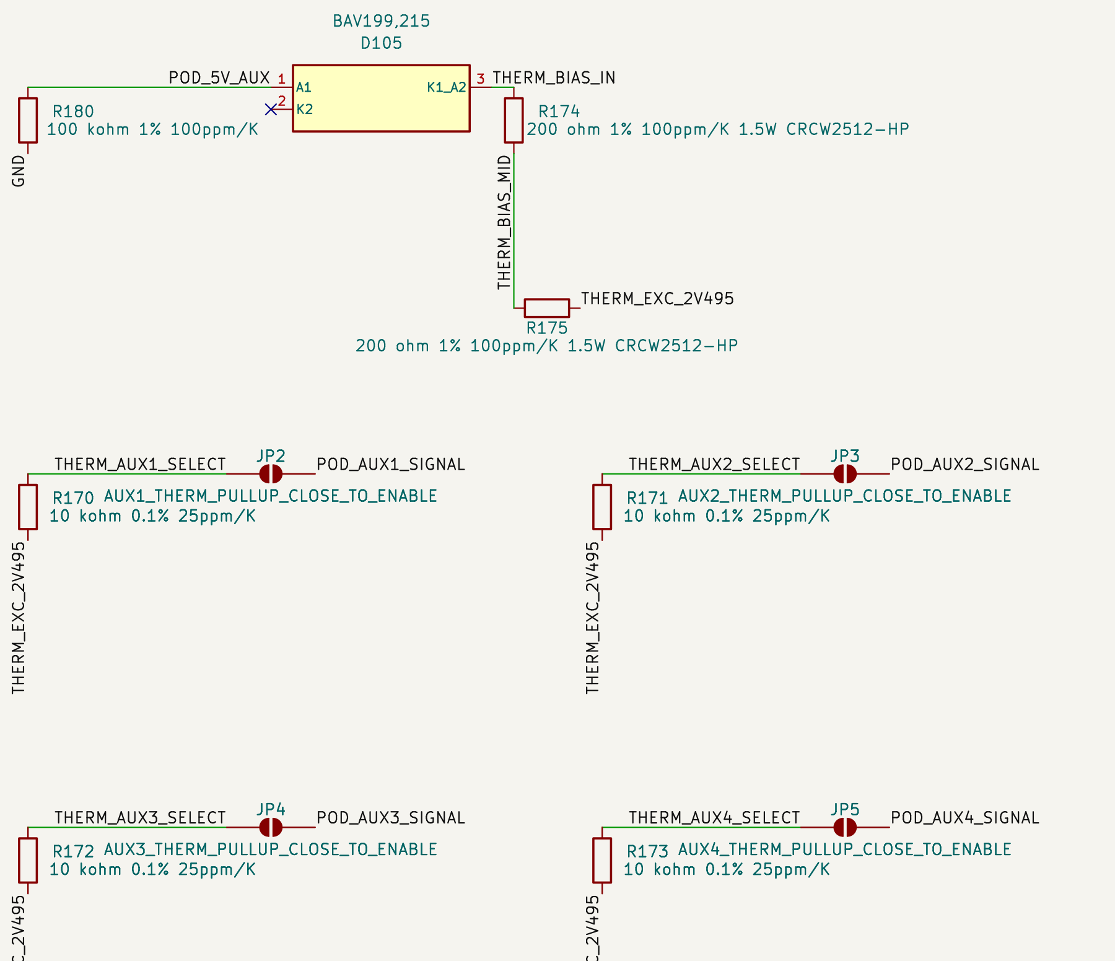
telemetry-pod/expansion/text-candidate/renders/longfields.png
