halbritt/fome-mc/telemetry-pod/expansion/text-candidate/renders/probes.png

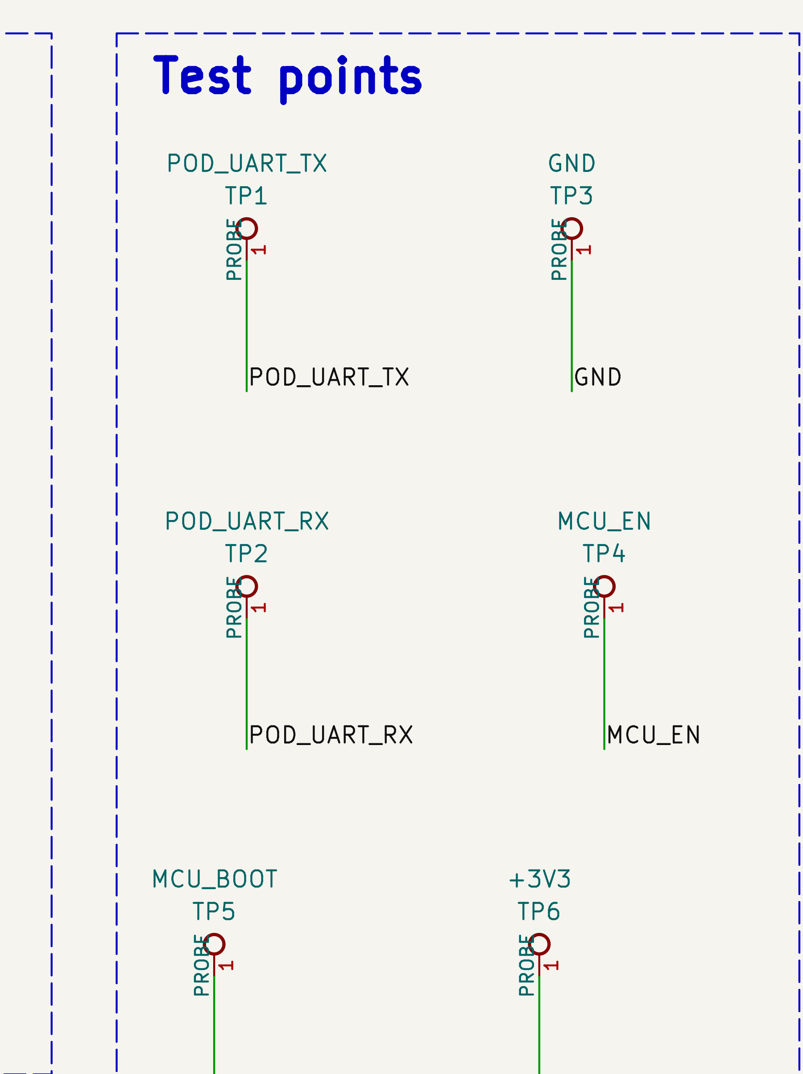
telemetry-pod/expansion/text-candidate/renders/probes.png
