halbritt/fome-mc/telemetry-pod/expansion/text-candidate/renders/r18.png

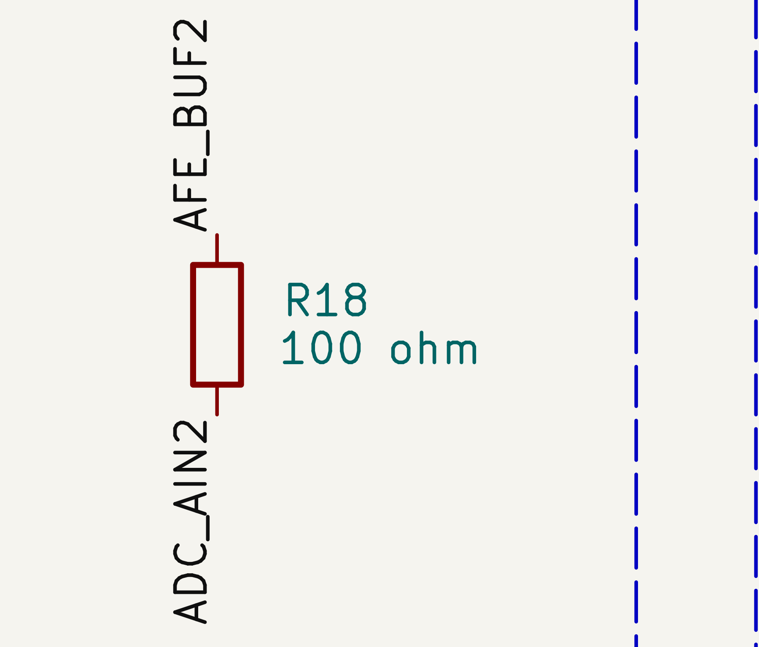
telemetry-pod/expansion/text-candidate/renders/r18.png
