halbritt/fome-mc/telemetry-pod/expansion/text-candidate/renders/u31.png

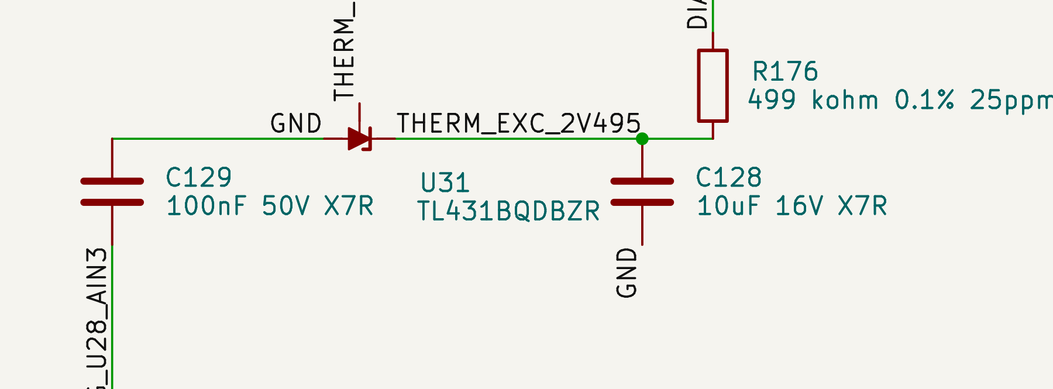
telemetry-pod/expansion/text-candidate/renders/u31.png
