halbritt/fome-mc/telemetry-pod/expansion/component-fit/review/README.md

# Independent component-package review

166 source checks pass. Exactly six components change footprint and acquire identity metadata: R73/R77/R81/R162 retain1.05Mohm0.1%25ppm/K but move0603→0805 for YAGEO RT0805BRD071M05L/C7353633; C64/C66 retain4.7uF16V X7R but move0603→0805 for KEMET C0805C475K4RACTU/C7224519. All332 components, nominal values, nets, declared NCs,314 existing bindings and other source data remain identical after removing those six new bindings and restoring their old footprints. The only added capture is the pinned R0805 footprint. There are320 metadata-bound components; only R60 remains an unbound part reference, apart from six flags and five copper jumpers.

The independent checker fixes exact identity/reference/value/footprint allocations; verifies complete predecessor file hashes, raw supplier/catalog hashes and observations, datasheet hashes and binding fields; parses the two selected footprint files and checks their pads. It does not import preparation helpers. Historical stocks4616 and4965, and both false assemblyComponentFlag values, are preserved observations, not current availability or assembly qualification.

Exact manufacturer PDFs were read independently. The resistor is1.05Mohm±0.1%,25ppm/K,-55..155°C,0.125W70°C,150V ceiling, body2.0±0.1×1.25±0.1×0.5±0.1mm. The capacitor is4.7uF±10%,16V X7R,-55..125°C, body2.0±0.2×1.25±0.2×1.25±0.20mm; its sheet specifies±15% temperature variation and3%/decade-hour aging. No claim of automotive qualification follows from these sheets.

The retained resistor footprint has pads1/2 centered atx±0.9125mm, each1.025×1.4mm; the existing capacitor0805 capture usesx±0.95mm and1.0×1.45mm pads. Both retain F.Cu/F.Mask/F.Paste and two roundrect terminals. These are generic KiCad nominal land patterns, not manufacturer-specific solder-joint qualification. Package sizes and clearance envelopes increase; placement, courtyard spacing, mounting accessibility and height must be checked again. A prior placement result cannot be reused as acceptance of this candidate.

Nominal electrical topology is preserved, but parasitic and thermal behavior is not proved unchanged. The larger resistor retains the eFuse divider's intended tolerance/TCR; the prior lower-resistance screen remains above1Mohm, with lifetime drift separate. Its150V ceiling does not establish reverse-fault behavior of the surrounding eFuse network. The larger capacitor still needs effective capacitance at3.3V bias, temperature and age, plus ESR/ESL, decoupling and supply-sequencing validation. Changing to0805 does not prove a particular improvement over0603 without data. All prior power, transient, backfeed, assembled thermal and mechanical holds remain.

Five temporary-copy controls reject: reverting one package to0603, changing a nominal capacitance, damaging a prior binding, removing an existing net terminal, and altering a captured resistor pad. Evidence is in negative-probes.json. Run `check_fit.py PACKET CANDIDATE REPORT --source-only`; candidate contains inputs/ and receipt.json. Negative runner is `negative_probes.py PACKET CANDIDATE REPORT`.

Native review remains NOT_RUN because the separate structured-field emitter blocker remains unresolved. This checker deliberately rejects calls without --source-only: native graph/footprint/metadata verification must be implemented and exercised after successful emission before any native claim. This review is package-selection/source-preservation evidence only, not fabrication or operating acceptance.
