halbritt/fome-mc/telemetry-pod/expansion/complete-parts-manifest/review.md

# Independent review

Reviewer: /root/expanded_pod_review, 2026-10-20.

No substantive defect found. Original 326 declarations and assignments are
preserved exactly; J1 is the only addition, with the assignment-document hash
updated. J1 matches actual native identity, sheet, footprint and PDF source.
Its through_hole assignment matches the captured footprint's native attribute
and plated electrical pads. All 406 copied dependencies match source bytes and
hashes. Historical stock remains zero; fetch time and final URL remain null,
with redirect provenance unknown.

Independent evaluate completed manifest qualification, then refused TP2's
legacy AGENT_EE_Probe property pending forward-annotation migration. Result is
malformed / unknown / missing. Full native membership has not passed. No design,
procurement or release approval is implied.

Independent report was retained at /tmp/agent491-complete-parts-independent.json;
the parent compared its content against this packet's report.json before commit.
