halbritt/fome-mc/export/BOM-fome-mc.csv

Comment | Designator | Footprint | LCSC
47u | C1,C6 | CP_Elec_8x10.5 | C454346
1u | C2,C5,C7 | C_0805_2012Metric | C354368
1u | C3,C9,C84 | C_0603_1608Metric | C15849
4.7u | C4 | C_1210_3225Metric | C417122
10n | C8,C15,C85,C86,C87,C88,C93,C94,C95,C96,C99,C100,C101,C102,C112,C201,C202,C203 | C_0603_1608Metric | C344025
100n | C10,C38,C39,C40,C41,C46,C51,C56,C61,C62,C63,C64,C67,C68,C69,C70,C71,C73,C79,C81,C83,C89,C91,C92,C97,C98,C103,C104,C105,C106,C108,C114,C204,C205,C1003,C1103,C1203 | C_0603_1608Metric | C161115
330p | C11,C20,C21 | C_0402_1005Metric | C13533
10u | C12,C111 | C_0603_1608Metric | C96446
10u | C13 | C_1206_3216Metric | C13585
4.7u | C14,C65,C66,C72,C76,C80,C82,C113,C310,C410 | C_0603_1608Metric | C19666
3.3n | C16,C17 | C_0805_2012Metric | C472819
680p | C18,C19 | C_0603_1608Metric | C1630
47p | C22,C23 | C_0402_1005Metric | C1567
1n | C24,C25,C26,C27,C28,C29,C30,C31,C32,C33,C34,C35,C36,C37 | C_0603_1608Metric | C1588
100n | C42,C43,C44,C45,C47,C48,C49,C50,C52,C53,C54,C55,C57,C58,C59,C60,C109,C110,C302,C305,C308,C309,C311,C312,C313,C314,C316,C402,C405,C408,C409,C411,C412,C413,C414,C416 | C_0402_1005Metric | C1525
33p | C74,C75 | C_0402_1005Metric | C1562
2.2u | C77,C78,C90 | C_0603_1608Metric | C23630
470n | C206 | C_0603_1608Metric | C1623
1u | C301,C304,C306,C307,C317,C401,C404,C406,C407,C417 | C_0402_1005Metric | C52923
33n | C303,C403 | C_0402_1005Metric | C1585
2.2u | C1201 | C_1206_3216Metric | C90787
SMCJ24A | D1,D22 | D_SMC | C224045
D_Schottky | D3 | D_SMA | C8678
PESD1CAN-UX | D4,D5 | SOT-323_SC-70 | C907839
B5819W | D6,D7,D8,D14,D16,D17,D211 | D_SOD-123 | C8598
GREEN | D9,D12,D302,D402 | LED_0603_1608Metric | C12624
RED | D10,D301,D304,D401,D404 | LED_0603_1608Metric | C2286
BLUE | D11,D303,D403 | LED_0603_1608Metric | C2288
ORANGE | D13 | LED_0603_1608Metric | C2287
SRV05-4 | D15,U11,U12,U16,U18,U20,U22 | SOT-23-6 | C85364
BZT52C12 | D19 | D_SOD-123 | C43491
B340A-13-F | D20,D21,D205,D206,D207,D208,D209 | D_SMA | C64982
BZT52C6V8 | D210 | D_SOD-123 | C173404
Ferrite_Bead | FB1 | L_0805_2012Metric | C1015
PSM712-LF-T7 | IC1 | SOT-23 | C32677
TE_776163-1 | J1 | ampseal-35 | C722761
TE_776163-2 | J2 | ampseal-35-2 | C722762
2.2u | L1 | L_1210_3225Metric | C75646
10u | L2 | MWSA0503 | C408412
AO4485 | Q1 | SOIC-8_3.9x4.9mm_P1.27mm | C51499
FGD3040G2-F085 | Q201,Q202,Q203,Q204 | TO-252-2 | C606124
VND14NV04 | Q301,Q401 | TO-252-2 | C2649436
10k | R1,R3,R4,R35,R36,R37,R38,R47,R48,R49,R50,R59,R60,R61,R62,R71,R72,R73,R74,R83,R84,R85,R86,R89,R90,R97,R99,R100,R117,R118,R119,R121,R122,R125,R126,R205,R206,R207,R208,R210,R216,R217,R303,R304,R311,R312,R321,R329,R333,R334,R403,R404,R411,R412,R421,R429,R433,R434 | R_0402_1005Metric | C25744
1 | R2 | R_0402_1005Metric | C25086
12k | R5,R17,R18,R209,R218 | R_0402_1005Metric | C25752
68k | R6,R331,R332,R431,R432 | R_0402_1005Metric | C36871
10 | R7,R8 | R_0603_1608Metric | C22859
120 | R9,R10,R101,R102 | R_0603_1608Metric | C22787
33k | R11,R12,R21,R22,R215 | R_0402_1005Metric | C25779
100k | R13,R14,R19,R20,R98,R315,R317,R320,R415,R417,R420 | R_0402_1005Metric | C25741
470k | R15,R16,R51,R52,R53,R54,R63,R64,R65,R66,R75,R76,R77,R78 | R_0402_1005Metric | C25790
2.7k | R23,R24,R25,R26,R27,R28,R29,R30,R31,R32,R33,R34,R39,R40,R41,R42 | R_0603_1608Metric | C13167
5.6k | R43,R44,R45,R46,R55,R56,R57,R58,R67,R68,R69,R70,R79,R80,R81,R82 | R_0402_1005Metric | C25908
1k | R87,R88,R301,R302,R313,R318,R325,R326,R327,R330,R401,R402,R413,R418,R425,R426,R427,R430,R1501,R1502,R1503,R1504,R1601,R1602,R1603,R1604 | R_0402_1005Metric | C11702
330 | R91,R92,R93,R94,R95 | R_0402_1005Metric | C25104
82k | R96,R116,R120 | R_0603_1608Metric | C23254
4.7k | R103,R104,R105,R106,R107 | R_0805_2012Metric | C17673
100 | R108,R109,R110,R111,R112,R113,R114,R115 | R_0805_2012Metric | C17408
47k | R124 | R_0603_1608Metric | C25819
47k | R127,R128,R129,R130,R131,R319,R419 | R_0402_1005Metric | C25792
22 | R132 | R_0603_1608Metric | C23345
15R | R201,R202,R203,R204 | R_0603_1608Metric | C22938
1M | R211 | R_0603_1608Metric | C22935
2.2k | R212 | R_0603_1608Metric | C22976
200m | R213,R214 | R_1206_3216Metric | C25335
1.5k | R219 | R_0603_1608Metric | C22843
27k | R305,R307,R405,R407 | R_0402_1005Metric | C25771
22k | R306,R406 | R_0402_1005Metric | C25768
47 | R308,R408 | R_0402_1005Metric | C25118
10 | R309,R409 | R_0402_1005Metric | C25077
61.9 | R310,R410 | R_0603_1608Metric | C23092
62k | R314,R414 | R_0603_1608Metric | C23221
6.8k | R316,R416 | R_0402_1005Metric | C25917
3.3k | R324,R424 | R_0402_1005Metric | C25890
10k | RN1,RN2,RN3,RN4,RN5,RN7,RN9,RN11 | R_Array_Convex_4x0603 | C29718
1k | RN6,RN8,RN10 | R_Array_Convex_4x0603 | C20197
SW_Push | SW1,SW2 | SW_SPST_EVQQ2 | C318887
TLS115D0E | U1,U2 | Infineon_PG-DSO-8-43 | C3747428
LMR16020PDDAR | U3 | SOIC-8-1EP_3.9x4.9mm_P1.27mm_EP2.29x3mm | C190006
MCP2551-I-SN | U4,U5 | SOIC-8_3.9x4.9mm_P1.27mm | C7376
TLV75733PDBVR | U6 | SOT-23-5 | C485517
MCP6004 | U7,U15,U17,U19,U21,U301,U401 | TSSOP-14_4.4x5mm_P0.65mm | C50282
SN74LVC2G17DB | U8,U9,U10 | SOT-23-6 | C10429
MAX9924UAUB+ | U13,U14 | MSOP-10_3x3mm_P0.5mm | C143633
REF3333 | U23 | SOT-23 | C130016
CSNP32GCR01-AOW | U25 | LGA-8_6x8mm_P1.25mm | C2841139
STM32H753ZIT6 | U26 | LQFP-144_20x20mm_P0.5mm | C730207
USBLC6-2SC6 | U27 | SOT-23-6 | C111212
ATWINC1500-MR210UB | U29 | ATWINC1500-MR210UB | C1558703
BTS716G | U40 | Infineon_PG-DSO-20-32 | C85135
MIC5205-3.3YM5 | U41 | SOT-23-5 | C5370979
MIC4427 | U42,U43,U44,U45 | SO-8_3.9x4.9mm_P1.27mm | C171845
TLE9201SG | U201,U203 | Infineon_PG-DSO-12-9 | C112633
DRV8825PWPR | U202 | HTSSOP-28-1EP_4.4x9.7mm_P0.65mm_EP2.85x5.4mm | C50506
STM32F042K6Tx | U302,U402 | LQFP-32_7x7mm_P0.8mm | C69216
REF3033 | U303,U403 | SOT-23 | C36658
AD8628 | U305,U405 | TSOT-23-5 | C29309
TJA1051T-3 | U307,U407 | SOIC-8_3.9x4.9mm_P1.27mm | C38695
XC6206P332MR | U309,U409 | SOT-23 | C5446
VNLD5090 | U1001,U1002,U1101,U1102,U1201,U1202 | SOIC-8_3.9x4.9mm_P1.27mm | C222209
74HCT125D | U1003,U1103,U1203 | SOIC-14_3.9x8.7mm_P1.27mm | C5947
8MHz | Y1 | Crystal_SMD_5032-2Pin_5.0x3.2mm | C115962
