halbritt/fome-mc/reports/toolchain/baseline/fome-mc-worktree/export/native/Atlas-clone-bom.csv

Refs | Value | Footprint | Qty | DNP
BT1 | Battery_Cell | Battery:BatteryHolder_Keystone_1060_1x2032 | 1
C1,C6 | 47u | Capacitor_SMD:CP_Elec_8x10.5 | 2
C2,C3,C5,C7,C9,C84 | 1u | Capacitor_SMD:C_0603_1608Metric | 6
C4,C14,C65,C66,C72,C76,C80,C82,C107,C310,C410 | 4.7u | Capacitor_SMD:C_0603_1608Metric | 11
C8,C15,C85,C86,C87,C88,C93,C94,C95,C96,C99,C100,C101,C102,C201,C202 | 10n | Capacitor_SMD:C_0603_1608Metric | 16
C10,C40,C41,C46,C51,C56,C61,C62,C63,C64,C67,C68,C69,C70,C71,C73,C79,C81,C83,C89,C91,C92,C97,C98,C103,C104,C105,C106 | 100n | Capacitor_SMD:C_0603_1608Metric | 28
C11,C20,C21 | 330p | Capacitor_SMD:C_0402_1005Metric | 3
C12,C13,C1201 | 10u | Capacitor_SMD:C_1206_3216Metric | 3
C16,C17 | 3.3n | Capacitor_SMD:C_0805_2012Metric | 2
C18,C19 | 680p | Capacitor_SMD:C_0603_1608Metric | 2
C22,C23 | 47p | Capacitor_SMD:C_0402_1005Metric | 2
C24,C25,C26,C27,C28,C29,C30,C31,C32,C33,C34,C35,C36,C37,C38,C39 | 1n | Capacitor_SMD:C_0603_1608Metric | 16
C42,C43,C44,C45,C47,C48,C49,C50,C52,C53,C54,C55,C57,C58,C59,C60,C302,C305,C308,C309,C311,C312,C313,C314,C316,C402,C405,C408,C409,C411,C412,C413,C414,C416 | 100n | Capacitor_SMD:C_0402_1005Metric | 34
C74,C75 | 33p | Capacitor_SMD:C_0402_1005Metric | 2
C77,C78,C90 | 2.2u | Capacitor_SMD:C_0603_1608Metric | 3
C301,C304,C306,C307,C317,C401,C404,C406,C407,C417 | 1u | Capacitor_SMD:C_0402_1005Metric | 10
C303,C403 | 33n | Capacitor_SMD:C_0402_1005Metric | 2
D1 | SM15T33CA | Diode_SMD:D_SMC | 1
D2,D3,D18 | D_Schottky | Diode_SMD:D_SMA | 3
D4,D5 | PESD1CAN-UX | Package_TO_SOT_SMD:SOT-323_SC-70 | 2
D6,D7,D8,D14,D16,D17 | schottky | Diode_SMD:D_SOD-123 | 6
D9,D12 | GREEN | LED_SMD:LED_0603_1608Metric_Castellated | 2
D10 | RED | LED_SMD:LED_0603_1608Metric_Castellated | 1
D11 | BLUE | LED_SMD:LED_0603_1608Metric_Castellated | 1
D13 | ORANGE | LED_SMD:LED_0603_1608Metric_Castellated | 1
D15,U11,U12,U13,U16,U18,U20,U22 | SRV05-4 | Package_TO_SOT_SMD:SOT-23-6 | 8
D201,D202,D203,D204,D205,D206,D207,D208 | B340A-13-F | Diode_SMD:D_SMA | 8
D301,D304,D401,D404 | RED | LED_SMD:LED_0603_1608Metric | 4
D302,D402 | GREEN | LED_SMD:LED_0603_1608Metric | 2
D303,D403 | BLUE | LED_SMD:LED_0603_1608Metric | 2
FB1 | Ferrite_Bead | Inductor_SMD:L_0805_2012Metric | 1
IC1 | PSM712-LF-T7 | Package_TO_SOT_SMD:SOT-23 | 1
J1 | TE_776163-1 | ampseal:ampseal-35 | 1
J2 | TE_776163-2 | ampseal:ampseal-35-2 | 1
J8 | Conn_02x05_Odd_Even | Connector_PinHeader_1.27mm:PinHeader_2x05_P1.27mm_Vertical_SMD | 1
J9 | Conn_01x06 | Connector:Tag-Connect_TC2030-IDC-NL_2x03_P1.27mm_Vertical | 1
J11 | Conn_01x06 | Connector_PinHeader_2.54mm:PinHeader_1x06_P2.54mm_Vertical | 1
J12 | Conn_01x02 | Connector_PinHeader_2.54mm:PinHeader_1x02_P2.54mm_Vertical | 1
J13 | USB_B | conn_5_2.5mm:conn_5_2.5mm | 1
J14 | USB_B | Connector_USB:USB_B_TE_5787834_Vertical | 1
J15,J16 | Conn_01x01 | Connector_PinHeader_2.54mm:PinHeader_1x01_P2.54mm_Vertical | 2
JP1,JP2 | Jumper_NO_Small | Jumper:SolderJumper-2_P1.3mm_Open_TrianglePad1.0x1.5mm | 2
L1 | 2.2u | Inductor_SMD:L_1210_3225Metric | 1
L2,L3 | 10u | sunlord-MWSA0503:MWSA0503 | 2
Q201,Q202,Q203,Q204 | FGD3040G2-F085 | Package_TO_SOT_SMD:TO-252-2 | 4
Q301,Q401 | VND14NV04 | Package_TO_SOT_SMD:TO-252-2 | 2
R1,R3,R4,R47,R48,R49,R50,R59,R60,R61,R62,R71,R72,R73,R74,R83,R84,R85,R86,R89,R90,R97,R99,R100,R117,R118,R119,R121,R123,R205,R206,R207,R208,R209,R210,R303,R304,R311,R312,R321,R329,R333,R334,R403,R404,R411,R412,R421,R429,R433,R434 | 10k | Resistor_SMD:R_0402_1005Metric | 51
R2 | 1 | Resistor_SMD:R_0402_1005Metric | 1
R5,R17,R18 | 12k | Resistor_SMD:R_0402_1005Metric | 3
R6,R122,R331,R332,R431,R432 | 68k | Resistor_SMD:R_0402_1005Metric | 6
R7,R8 | 10 | Resistor_SMD:R_0603_1608Metric | 2
R9,R10,R101,R102 | 120 | Resistor_SMD:R_0603_1608Metric | 4
R11,R12,R21,R22 | 33k | Resistor_SMD:R_0402_1005Metric | 4
R13,R14,R19,R20,R98,R315,R317,R320,R415,R417,R420 | 100k | Resistor_SMD:R_0402_1005Metric | 11
R15,R16,R51,R52,R53,R54,R63,R64,R65,R66,R75,R76,R77,R78 | 470k | Resistor_SMD:R_0402_1005Metric | 14
R23,R24,R25,R26,R27,R28,R29,R30,R31,R32,R33,R34,R35,R36,R37,R38,R39,R40,R41,R42 | 2.7k | Resistor_SMD:R_0603_1608Metric | 20
R43,R44,R45,R46,R55,R56,R57,R58,R67,R68,R69,R70,R79,R80,R81,R82 | 5.6k | Resistor_SMD:R_0402_1005Metric | 16
R87,R88,R301,R302,R313,R318,R325,R326,R327,R330,R401,R402,R413,R418,R425,R426,R427,R430,R1501,R1502,R1503,R1504,R1601,R1602,R1603,R1604 | 1k | Resistor_SMD:R_0402_1005Metric | 26
R91,R92,R93,R94,R95 | 330 | Resistor_SMD:R_0402_1005Metric | 5
R96,R116,R120 | 82k | Resistor_SMD:R_0603_1608Metric | 3
R103,R104,R105,R106,R107 | 4.7k | Resistor_SMD:R_0805_2012Metric | 5
R108,R109,R110,R111,R112,R113,R114,R115 | 100 | Resistor_SMD:R_0805_2012Metric | 8
R201,R202,R203,R204 | 15R | Resistor_SMD:R_0603_1608Metric | 4
R305,R307,R405,R407 | 27k | Resistor_SMD:R_0402_1005Metric | 4
R306,R406 | 22k | Resistor_SMD:R_0402_1005Metric | 2
R308,R408 | 47 | Resistor_SMD:R_0402_1005Metric | 2
R309,R409 | 10 | Resistor_SMD:R_0402_1005Metric | 2
R310,R410 | 61.9 | Resistor_SMD:R_0603_1608Metric | 2
R314,R414 | 62k | Resistor_SMD:R_0603_1608Metric | 2
R316,R416 | 6.8k | Resistor_SMD:R_0402_1005Metric | 2
R319,R419 | 47k | Resistor_SMD:R_0402_1005Metric | 2
R324,R424 | 3.3k | Resistor_SMD:R_0402_1005Metric | 2
RN1,RN2,RN3,RN4,RN11 | 10k | Resistor_SMD:R_Array_Convex_4x0603 | 5
RN5,RN6,RN7,RN8,RN9,RN10 | 1k | Resistor_SMD:R_Array_Convex_4x0603 | 6
SW1,SW2 | SW_Push | Button_Switch_SMD:SW_SPST_EVQQ2 | 2
U1,U2 | TLS115D0E | Package_SO:Infineon_PG-DSO-8-43 | 2
U3 | LMR14020 | Package_SO:SOIC-8-1EP_3.9x4.9mm_P1.27mm_EP2.29x3mm | 1
U4,U5 | MCP2551-I-SN | Package_SO:SOIC-8_3.9x4.9mm_P1.27mm | 2
U6 | AMS1117-3.3 | Package_TO_SOT_SMD:SOT-223-3_TabPin2 | 1
U7,U15,U17,U19,U21,U301,U401 | MCP6004 | Package_SO:TSSOP-14_4.4x5mm_P0.65mm | 7
U8,U9,U10,U14 | SN74LVC2G17DB | Package_TO_SOT_SMD:SOT-23-6 | 4
U23 | REF3333 | Package_TO_SOT_SMD:SOT-23 | 1
U24 | LPS25HB | Package_LGA:ST_HLGA-10_2.5x2.5mm_P0.6mm_LayoutBorder3x2y | 1
U25 | XTSD04GLGEAG | ampseal:LGA-8_6x8mm_P1.25mm | 1
U26 | STM32H753ZIT6 | Package_QFP:LQFP-144_20x20mm_P0.5mm | 1
U27 | USBLC6-2SC6 | Package_TO_SOT_SMD:SOT-23-6 | 1
U28 | S3225SMD32.768KOSC | Oscillator:Oscillator_SMD_SeikoEpson_SG8002LB-4Pin_3.2x2.5mm | 1
U40 | BTS716G | Package_SO:Infineon_PG-DSO-20-32 | 1
U41 | MIC5205-3.3YM5 | Package_TO_SOT_SMD:SOT-23-5 | 1
U42,U43,U44,U45 | MIC4427 | Package_SO:SO-8_3.9x4.9mm_P1.27mm | 4
U46 | LM2733XMFX/NOPB | Package_TO_SOT_SMD:SOT-23-5 | 1
U201 | TLE9201SG | Package_SO:Infineon_PG-DSO-12-9 | 1
U202 | DRV8825PWPR | Package_SO:HTSSOP-28-1EP_4.4x9.7mm_P0.65mm_EP2.4x5.28mm | 1
U302,U402 | STM32F042K6Tx | Package_QFP:LQFP-32_7x7mm_P0.8mm | 2
U303,U403 | REF3033 | Package_TO_SOT_SMD:SOT-23 | 2
U305,U405 | AD8628 | Package_TO_SOT_SMD:TSOT-23-5 | 2
U307,U407 | TJA1051T-3 | Package_SO:SOIC-8_3.9x4.9mm_P1.27mm | 2
U309,U409 | XC6206P332MR | Package_TO_SOT_SMD:SOT-23 | 2
U1001,U1002,U1101,U1102,U1201,U1202 | VNLD5090 | Package_SO:SOIC-8_3.9x4.9mm_P1.27mm | 6
Y1 | 8MHz | Crystal:Crystal_SMD_5032-2Pin_5.0x3.2mm | 1
