halbritt/fome-mc/reports/toolchain/baseline/universal-112/export/native/Polygonus-Universal-Base-bom.csv

Refs | Value | Footprint | Qty | DNP
C2 | 56u | Capacitor_THT:CP_Radial_D8.0mm_P3.50mm | 1
C3,C26 | 10u | Capacitor_SMD:C_1206_3216Metric | 2
C4,C5,C27,C28 | 10n | Capacitor_SMD:C_0805_2012Metric | 4
C6 | 1n | Capacitor_SMD:C_0402_1005Metric | 1
C7 | 470n | Capacitor_SMD:C_0402_1005Metric | 1
C8,C9,C14,C25 | 100n | Capacitor_SMD:C_0402_1005Metric | 4
C10,C13,C17,C18,C20,C21,C22 | 1u | Capacitor_SMD:C_0402_1005Metric | 7
C11,C12,C15,C16,C19 | 10n | Capacitor_SMD:C_0402_1005Metric | 5
C23 | 1n | Capacitor_SMD:C_0805_2012Metric | 1
C24 | 1u | Capacitor_SMD:C_0805_2012Metric | 1
C29,C30,C33,C34 | 47p | Capacitor_SMD:C_0805_2012Metric | 4
C31,C32,C35,C36 | 100n | Capacitor_SMD:C_0805_2012Metric | 4
D1 | LED | LED_SMD:LED_0603_1608Metric | 1
D2,D3,D4,D5,D6,D7,D8,D9 | D_Schottky | Diode_SMD:D_SMA | 8
D10,D11 | NUP2105L | Package_TO_SOT_SMD:SOT-23 | 2
F1 | Fuse | Fuse:Fuseholder_Blade_Mini_Keystone_3568 | 1
J1 | Molex_112_643330100 | Simon:Molex_112_643330100 | 1
J4 | USB_B | Simon:BMM-USB | 1
J6,J7,J8,J9,J10,J11 | P1x16 | header_placement:header_loc | 6
J12,J13 | P1x5 | header_placement:header_loc | 2
Q1,Q2,Q3,Q4,Q5,Q6,Q7,Q8 | FGD3040G2-F085 | Package_TO_SOT_SMD:TO-252-2 | 8
R1,R2,R30,R31 | 1k | Resistor_SMD:R_0805_2012Metric | 4
R5,R7,R8,R35 | 10k | Resistor_SMD:R_0805_2012Metric | 4
R6 | 2.2k | Resistor_SMD:R_0402_1005Metric | 1
R9 | 12k | Resistor_SMD:R_0402_1005Metric | 1
R10,R11,R13,R14 | 100k | Resistor_SMD:R_0402_1005Metric | 4
R12,R17,R18,R22,R23 | 10k | Resistor_SMD:R_0402_1005Metric | 5
R15 | 68k | Resistor_SMD:R_0402_1005Metric | 1
R16,R19,R24 | 10 | Resistor_SMD:R_0402_1005Metric | 3
R20,R21 | 1k | Resistor_SMD:R_0402_1005Metric | 2
R25,R26,R27,R28,R34 | 4.7k | Resistor_SMD:R_0805_2012Metric | 5
RN1,RN2,RN3,RN4 | 1k | Resistor_SMD:R_Array_Convex_4x0603 | 4
U1,U2 | f042_wideband_module | fome_modules:f042_wideband_module | 2
U3,U15 | TLE9201SG | Package_SO:Infineon_PG-DSO-12-9 | 2
U4 | SRV05-4 | Package_TO_SOT_SMD:SOT-23-6 | 1
U5 | 74HC02 | Package_SO:SOIC-14_3.9x8.7mm_P1.27mm | 1
U6 | MCP6004 | Package_SO:TSSOP-14_4.4x5mm_P0.65mm | 1
U7 | MAX9142 | Package_SO:SOIC-8_3.9x4.9mm_P1.27mm | 1
U8,U9 | NC7SB3157P6X | Package_TO_SOT_SMD:SOT-363_SC-70-6 | 2
U10 | MAX9924 | Package_SO:MSOP-10_3x3mm_P0.5mm | 1
U11,U12,U13,U14,U16,U17,U18,U19 | VNL5090 | Package_TO_SOT_SMD:SOT-223 | 8
U20,U21 | TJA1051T-3 | Package_SO:SOIC-8_3.9x4.9mm_P1.27mm | 2
