halbritt/fome-mc/reports/toolchain/baseline/fome-mc/export/kibot/bom/Atlas-clone-bom.csv

Row | Description | Part | References | Value | Footprint | Quantity Per PCB | Status | Datasheet | PN | LCSC | LCSC_ext | possible_not_ext | Height | Manufacturer_Name | Manufacturer_Part_Number | Mouser Part Number | Mouser Price/Stock | Arrow Part Number | Arrow Price/Stock | Mouser Testing Part Number | Mouser Testing Price/Stock
1 | Unpolarized capacitor, small symbol | C_Small | C74 C75 | 33p | C_0402_1005Metric | 2 |  | ~ |  | C1562 | 0
2 | Unpolarized capacitor | C | C22 C23 | 47p | C_0402_1005Metric | 2 |  | ~ |  | C1567 | 0
3 | Unpolarized capacitor | C | C11 C20 C21 | 330p | C_0402_1005Metric | 3 |  | ~ |  | C13533 | 0
4 | Unpolarized capacitor | C | C18 C19 | 680p | C_0603_1608Metric | 2 |  | ~ |  | C1630 | 0
5 | Unpolarized capacitor | C | C24 C25 C26 C27 C28 C29 C30 C31 C32 C33 C34 C35 C36 C37 C38 C39 | 1n | C_0603_1608Metric | 16 |  | ~ |  | C1588 | 0
6 | Unpolarized capacitor | C | C16 C17 | 3.3n | C_0805_2012Metric | 2 |  | ~ |  | C53175 | 0
7 | Unpolarized capacitor Unpolarized capacitor, small symbol | C | C8 C15 C85 C86 C87 C88 C93 C94 C95 C96 C99 C100 C101 C102 | 10n | C_0603_1608Metric | 14 |  | ~ |  | C57112 | 0
8 | Unpolarized capacitor, small symbol | C_Small | C10 C40 C41 C46 C51 C56 C61 C62 C63 C64 C67 C68 C69 C70 C71 C73 C79 C81 C83 C89 C91 C92 C97 C98 C103 C104 C105 C106 | 100n | C_0603_1608Metric | 28 |  | ~ |  | C14663 | 0
9 | Unpolarized capacitor | C | C42 C43 C44 C45 C47 C48 C49 C50 C52 C53 C54 C55 C57 C58 C59 C60 | 100n | C_0402_1005Metric | 16 |  | ~ |  | C1525 | 0
10 | Unpolarized capacitor | 100n | C103 C104 C105 C106 | 100n | C_0603_1608Metric | 4 |  |  |  | C14663 | 0
11 | Unpolarized capacitor | C | C2 C3 C5 C7 C9 C84 | 1u | C_0603_1608Metric | 6 |  | ~ |  | C15849 | 0
12 | Unpolarized capacitor, small symbol | C_Small | C77 C78 C90 | 2.2u | C_0603_1608Metric | 3 |  | ~ |  | C23630 | 0
13 | Unpolarized capacitor | C | C4 C14 C65 C66 C72 C76 C80 C82 C107 | 4.7u | C_0603_1608Metric | 9 |  | ~ | CGA3E2X7R1H103M080AA | C19666 | 0
14 | Unpolarized capacitor | 4.7u | C107 | 4.7u | C_0603_1608Metric | 1 |  |  |  | C14663 | 0
15 | Unpolarized capacitor | C | C12 C13 | 10u | C_1206_3216Metric | 2 |  | ~ |  | C13585 | 0
16 | Light emitting diode | LED | D11 | BLUE | LED_0603_1608Metric_Castellated | 1 |  | ~ |  | C72041 | 0
17 | Schottky diode | D_Schottky | D2 D3 D18 | D_Schottky | D_SMA | 3 |  | ~ |  | C8678 | 0
18 | Light emitting diode | LED | D9 D12 | GREEN | LED_0603_1608Metric_Castellated | 2 |  | ~ |  | C72043 | 0
19 | Light emitting diode | LED | D13 | ORANGE | LED_0603_1608Metric_Castellated | 1 |  | ~ |  | C72038 | 0
20 |  | D_TVS_x2_AAC | D4 D5 | PESD1CAN-UX | SOT-323_SC-70 | 2 |  | ~ | PESD1CAN-UX | C152727 | 1
21 | Light emitting diode | LED | D10 | RED | LED_0603_1608Metric_Castellated | 1 |  | ~ |  | C2286 | 0
22 | Bidirectional transient-voltage-suppression diode | D_TVS | D1 | SM15T33CA | D_SMC | 1 |  | ~ | SM15T33CA | C151281 | 1 | 1
23 | ESD Protection Diodes with Low Clamping Voltage, SOT-23-6 | SRV05-4 | D15 U11 U12 U13 U16 U18 U20 U22 | SRV05-4 | SOT-23-6 | 8 |  | http://www.onsemi.com/pub/Collateral/SRV05-4-D.PDF |  | C85364 | 0
24 | Schottky diode, small symbol | D_Schottky_Small | D6 D7 D8 D14 | schottky | D_SOD-123 | 4 |  | ~ |  | C8598 | 0
25 | 75V 0.15A Fast switching Diode, SOD-323 | 1N4148WS | D16 D17 | schottky | D_SOD-123 | 2 |  | https://www.vishay.com/docs/85751/1n4148ws.pdf |  | C8598
26 | Resettable fuse, polymeric positive temperature coefficient | Polyfuse | F1 F2 | Polyfuse | R_1206_3216Metric | 2 |  | ~ | 1206L012WR | C207035 | 1
27 |  | Ferrite_Bead | FB1 | Ferrite_Bead | L_0805_2012Metric | 1 |  | ~ |  | C1015 | 0
28 | ESD Suppressor TVS Bi-Dir 12V/7V 3-Pin SOT-23 T/R | PSM712-LF-T7 | IC1 | PSM712-LF-T7 | SOT-23 | 1 |  | https://www.arrow.com/en/products/psm712-lf-t7/protek-devices |  | C32677 |  |  | 1.21 | ProTek Devices | PSM712-LF-T7 |  |  | PSM712-LF-T7 | https://www.arrow.com/en/products/psm712-lf-t7/protek-devices?region=europe
29 | Micro SD Card Socket | Micro_SD_Card | J10 | Micro_SD_Card | microSD_HC_Wuerth_693072010801 | 1 |  | http://katalog.we-online.de/em/datasheet/693072010801.pdf | 47219-2001 | C164170
30 | Inductor | L | L1 | 2.2u | L_1210_3225Metric | 1 |  | ~ | SRN3015TA-2R2M | C75646 | 1 | 1
31 | Inductor | L | L2 L3 | 10u | MWSA0503 | 2 |  | ~ |  | C408412 | 1 | 1
32 | Inductor | 10u | L3 | 10u | MWSA0503 | 1 |  |  |  | C408412 | 1 | 1
33 | Resistor | R | R2 | 1 | R_0402_1005Metric | 1 |  | ~ |  | C25086 | 0
34 | Resistor, small symbol | R_Small | R7 R8 | 10 | R_0603_1608Metric | 2 |  | ~ |  | C22787 | 0
35 | Resistor | R | R108 R109 R110 R111 R112 R113 R114 R115 | 100 | R_0805_2012Metric | 8 |  | ~ |  | C17408 | 0
36 | Resistor, small symbol | R_Small | R9 R10 R101 R102 | 120 | R_0603_1608Metric | 4 |  | ~ |  | C22787 | 0
37 | Resistor | R | R91 R92 R93 R94 R95 | 330 | R_0402_1005Metric | 5 |  | ~ |  | C25104
38 | Resistor | R | R87 R88 R1501 R1502 R1503 R1504 R1601 R1602 R1603 R1604 | 1k | R_0402_1005Metric | 10 |  | ~ |  | C11702 | 0
39 | Resistor | R | R23 R24 R25 R26 R27 R28 R29 R30 R31 R32 R33 R34 R35 R36 R37 R38 R39 R40 R41 R42 | 2.7k | R_0603_1608Metric | 20 |  | ~ |  | C13167 | 0
40 | Resistor Resistor, small symbol | R | R103 R104 R105 R106 R107 | 4.7k | R_0805_2012Metric | 5 |  | ~ |  | C17673 | 0
41 | Resistor | R | R43 R44 R45 R46 R55 R56 R57 R58 R67 R68 R69 R70 R79 R80 R81 R82 | 5.6k | R_0402_1005Metric | 16 |  | ~ |  | C25908 | 0
42 | Resistor Resistor, small symbol | R | R1 R3 R4 R47 R48 R49 R50 R59 R60 R61 R62 R71 R72 R73 R74 R83 R84 R85 R86 R89 R90 R97 R99 R100 R117 R118 R119 R121 R123 | 10k | R_0402_1005Metric | 29 |  | ~ |  | C25744 | 0
43 | Resistor | 10k | R117 R118 R119 R121 R123 | 10k | R_0402_1005Metric | 5 |  |  |  | C25744 | 0
44 | Resistor | R | R5 R17 R18 | 12k | R_0402_1005Metric | 3 |  | ~ |  | C25752 | 0
45 | Resistor | R | R11 R12 R21 R22 | 33k | R_0402_1005Metric | 4 |  | ~ |  | C25779 | 0
46 | Resistor | R | R6 R122 | 68k | R_0402_1005Metric | 2 |  | ~ |  | C36871
47 | Resistor | 68k | R122 | 68k | R_0402_1005Metric | 1 |  |  |  | C25744 | 0
48 | Resistor | R | R96 R116 R120 | 82k | R_0603_1608Metric | 3 |  | ~ |  | C23254 | 0
49 | Resistor | 82k | R116 R120 | 82k | R_0603_1608Metric | 2 |  |  |  | C23254 | 0
50 | Resistor | R | R13 R14 R19 R20 R98 | 100k | R_0402_1005Metric | 5 |  | ~ |  | C25741 | 0
51 | Resistor | R | R15 R16 R51 R52 R53 R54 R63 R64 R65 R66 R75 R76 R77 R78 | 470k | R_0402_1005Metric | 14 |  | ~ |  | C25790 | 0
52 | 4 resistor network, parallel topology | R_Pack04 | RN5 RN6 RN7 RN8 RN9 RN10 | 1k | R_Array_Convex_4x0603 | 6 |  | ~ |  | C20197 | 0
53 | 4 resistor network, parallel topology | R_Pack04 | RN1 RN2 RN3 RN4 RN11 | 10k | R_Array_Convex_4x0603 | 5 |  | ~ | CAT16-473J4LF CAT16-1002F4LF | C29718 | 0
54 | Push button switch, generic, two pins | SW_Push | SW1 SW2 | SW_Push | SW_SPST_EVQQ2 | 2 |  | ~ |  | C318887 | 1
55 | 1A Low Dropout regulator, positive, 3.3V fixed output, SOT-223 | AMS1117-3.3 | U6 | AMS1117-3.3 | SOT-223-3_TabPin2 | 1 |  | http://www.advanced-monolithic.com/pdf/ds1117.pdf |  | C6186 | 0
56 | Smart High-Side Power Switch, PROFET, 4 Channel, 140mOhm, 2.6A, 40V, DSO-20 | BTS716G | U40 | BTS716G | Infineon_PG-DSO-20-32 | 1 |  | https://www.infineon.com/dgdl/Infineon-BTS716G-DS-v01_00-EN.pdf?fileId=5546d4625a888733015aa3be86601004 |  | C85135
57 |  | MIC5205-3.3YM5 | U46 | LM2733XMFX/NOPB | SOT-23-5 | 1 |  | https://www.ti.com/lit/ds/symlink/lm2733.pdf |  | C80169
58 | 150mA low dropout linear regulator, fixed 3.3V output, SOT-23-5 | LM2733XMFX/NOPB | U46 | LM2733XMFX/NOPB | SOT-23-5 | 1 |  |  |  | C5370979
59 |  | LMR14020 | U3 | LMR14020 | SOIC-8-1EP_3.9x4.9mm_P1.27mm_EP2.29x3mm | 1 |  |  | LMR14020 | C187824 | 1 | 0
60 | MEMS pressure sensor, 260-1260 hPa, absolute digital output baromeeter | LPS25HB | U24 | LPS25HB | ST_HLGA-10_2.5x2.5mm_P0.6mm_LayoutBorder3x2y | 1 |  | www.st.com/resource/en/datasheet/lps25hb.pdf |  | C94049 | 1
61 | High-Speed CAN Transceiver, 1Mbps, 5V supply, SOIC-8 | MCP2551-I-SN | U4 U5 | MCP2551-I-SN | SOIC-8_3.9x4.9mm_P1.27mm | 2 |  | http://ww1.microchip.com/downloads/en/devicedoc/21667d.pdf |  | C7376
62 | 1MHz, Low-Power Op Amp, DIP-14/SOIC-14/TSSOP-14 | MCP6004 | U7 U15 U17 U19 U21 | MCP6004 | TSSOP-14_4.4x5mm_P0.65mm | 5 |  | http://ww1.microchip.com/downloads/en/DeviceDoc/21733j.pdf | MCP6004T-I/ST | C50282 | 1 | 1
63 | Dual 1.5A-Peak Low-Side MOSFET Driver, DIP-8/SOIC-8/MSOP-8 | MIC4427 | U42 U43 U44 U45 | MIC4427 | SO-8_3.9x4.9mm_P1.27mm | 4 |  | http://ww1.microchip.com/downloads/en/DeviceDoc/mic4426.pdf | TC4427EOA | C171845 | 1 | 1
64 | 150mA low dropout linear regulator, fixed 3.3V output, SOT-23-5 | MIC5205-3.3YM5 | U41 | MIC5205-3.3YM5 | SOT-23-5 | 1 |  | http://ww1.microchip.com/downloads/en/DeviceDoc/20005785A.pdf |  | C5370979
65 | 3.3V 50-ppm/°C Max, 50-μA, CMOS Voltage Reference, SOT-23-3 | REF3033 | U23 | REF3333 | SOT-23 | 1 |  | http://www.ti.com/lit/ds/symlink/ref3033.pdf | REF3033 | C130016 | 1
66 |  | MIC5205-3.3YM5 | U28 | S3225SMD32.768KOSC | Oscillator_SMD_SeikoEpson_SG8002LB-4Pin_3.2x2.5mm | 1 |  | ~ |  | C7431189
67 | 150mA low dropout linear regulator, fixed 3.3V output, SOT-23-5 | S3225SMD32.768KOSC | U28 | S3225SMD32.768KOSC | SOT-23-5 | 1 |  |  |  | C5370979
68 | Dual Buffer Schmitt Triggered, Low-Voltage CMOS | 74LVC2G17 | U8 U9 U10 U14 | SN74LVC2G17DB | SOT-23-6 | 4 |  | http://www.ti.com/lit/sg/scyt129e/scyt129e.pdf | 74HC2G17GW | C10429 | 1
69 | STMicroelectronics Arm Cortex-M7 MCU, 2048KB flash, 512KB RAM, 216 MHz, 1.7-3.6V, 114 GPIO, LQFP144 | STM32F767ZITx | U26 | STM32H753ZIT6 | LQFP-144_20x20mm_P0.5mm | 1 |  | https://www.st.com/resource/en/datasheet/stm32f767zi.pdf | STM32F767ZIT6 | C90235
70 |  | TLS115 | U1 U2 | TLS115D0E | Infineon_PG-DSO-8-43 | 2 |  | ~ | TLS115D0E | C3747428
71 | Very low capacitance ESD protection diode, 2 data-line, SOT-23-6 | USBLC6-2SC6 | U27 | USBLC6-2SC6 | SOT-23-6 | 1 |  | https://www.st.com/resource/en/datasheet/usblc6-2.pdf | USBLC6-2 | C111212 | 1 | 1
72 |  | VNLD5090 | U1001 U1002 U1101 U1102 U1201 U1202 | VNLD5090 | SOIC-8_3.9x4.9mm_P1.27mm | 6 |  |  |  | C222209
73 | Two pin crystal | Crystal | Y1 | 8MHz | Crystal_SMD_5032-2Pin_5.0x3.2mm | 1 |  | ~ |  | C115962 | 0
Project info:
Schematic: | Atlas-clone
Variant: | default
Revision: | v1.0-atlas-h7
Date: | 2024-11-14
KiCad Version: | 10.0.7-10.0.7~ubuntu24.04.1
Statistics:
Component Groups: | 73
Component Count: | 332
Fitted Components: | 332
Number of PCBs: | 1
Total Components: | 332
