halbritt/fome-mc/reports/toolchain/baseline/universal-112/export/kibot/bom/Polygonus-Universal-Base-bom.csv

Row | Description | Part | References | Value | Footprint | Quantity Per PCB | Status | Datasheet | LCSC | PN
1 |  | C | C29 C30 C33 C34 | 47p | C_0805_2012Metric | 4 |  | ~ | C14857
2 |  | C | C23 | 1n | C_0805_2012Metric | 1 |  | ~ | C46653
3 |  | C_Small | C6 | 1n | C_0402_1005Metric | 1 |  | ~ | C1523
4 |  | C | C11 C12 C15 C16 C19 | 10n | C_0402_1005Metric | 5 |  | ~ | C15195
5 |  | C_Small | C4 C5 C27 C28 | 10n | C_0805_2012Metric | 4 |  | ~ | C1710
6 |  | C | C8 C9 C14 C25 | 100n | C_0402_1005Metric | 4 |  | ~ | C1525
7 |  | C | C31 C32 C35 C36 | 100n | C_0805_2012Metric | 4 |  | ~ | C49678
8 |  | C | C7 | 470n | C_0402_1005Metric | 1 |  | ~ | C47339
9 |  | C | C10 C13 C17 C18 C20 C21 C22 | 1u | C_0402_1005Metric | 7 |  | ~ | C52923
10 |  | C | C24 | 1u | C_0805_2012Metric | 1 |  | ~ | C28323
11 |  | C | C3 C26 | 10u | C_1206_3216Metric | 2 |  | ~ | C13585
12 |  | D_Schottky | D2 D3 D4 D5 D6 D7 D8 D9 | D_Schottky | D_SMA | 8 |  | ~ | C8678
13 |  | LED | D1 | LED | LED_0603_1608Metric | 1 |  | ~ | C72043
14 |  | NUP2105L | D10 D11 | NUP2105L | SOT-23 | 2 |  | http://www.onsemi.com/pub_link/Collateral/NUP2105L-D.PDF | C284104
15 |  | Fuse | F1 | Fuse | Fuseholder_Blade_Mini_Keystone_3568 | 1 |  | ~ | C5249699
16 |  | Molex_112_643330100 | J1 | Molex_112_643330100 | Molex_112_643330100 | 1 |  |  | C293656
17 | 1x16 pin socket | Fiducial | J6 J7 J8 J9 J10 J11 | P1x16 | header_loc | 6 |  | ~ | C350305
18 | 1x5 pin socket | Fiducial | J12 J13 | P1x5 | header_loc | 2 |  | ~ | C50950
19 |  | USB_B | J4 | USB_B | BMM-USB | 1 |  | ~ | C46392
20 |  | Q_NIGBT_GCE | Q1 Q2 Q3 Q4 Q5 Q6 Q7 Q8 | FGD3040G2-F085 | TO-252-2 | 8 |  | ~ | C606124
21 |  | R | R16 R19 R24 | 10 | R_0402_1005Metric | 3 |  | ~ | C25077
22 |  | Res | R1 R2 R30 R31 | 1k | R_0805_2012Metric | 4 |  |  | C17513
23 |  | R | R20 R21 | 1k | R_0402_1005Metric | 2 |  | ~ | C11702
24 |  | R | R6 | 2.2k | R_0402_1005Metric | 1 |  | ~ | C25879
25 |  | R | R25 R26 R27 R28 R34 | 4.7k | R_0805_2012Metric | 5 |  | ~ | C17673
26 |  | R | R12 R17 R18 R22 R23 | 10k | R_0402_1005Metric | 5 |  | ~ | C25744
27 |  | R | R5 R7 R8 R35 | 10k | R_0805_2012Metric | 4 |  | ~ | C17414
28 |  | R | R9 | 12k | R_0402_1005Metric | 1 |  | ~ | C25752
29 |  | R | R15 | 68k | R_0402_1005Metric | 1 |  | ~ | C36871
30 |  | R | R10 R11 R13 R14 | 100k | R_0402_1005Metric | 4 |  | ~ | C25741
31 |  | R_Pack04 | RN1 RN2 RN3 RN4 | 1k | R_Array_Convex_4x0603 | 4 |  | ~ | C20197
32 |  | 74HC02 | U5 | 74HC02 | SOIC-14_3.9x8.7mm_P1.27mm | 1 |  | http://www.ti.com/lit/gpn/sn74hc02 | C5588
33 |  | LM393 | U7 | MAX9142 | SOIC-8_3.9x4.9mm_P1.27mm | 1 |  | http://www.ti.com/lit/ds/symlink/lm393.pdf | C18567
34 |  | MAX9924 | U10 | MAX9924 | MSOP-10_3x3mm_P0.5mm | 1 |  | ~ | C143633
35 |  | MCP6004 | U6 | MCP6004 | TSSOP-14_4.4x5mm_P0.65mm | 1 |  | http://ww1.microchip.com/downloads/en/DeviceDoc/21733j.pdf | C50282
36 |  | NC7SB3157P6X | U8 U9 | NC7SB3157P6X | SOT-363_SC-70-6 | 2 |  | https://www.onsemi.com/pub/Collateral/NC7SB3157-D.PDF | C36533657
37 |  | SRV05-4 | U4 | SRV05-4 | SOT-23-6 | 1 |  | http://www.onsemi.com/pub/Collateral/SRV05-4-D.PDF | C85364
38 |  | TJA1051T-3 | U20 U21 | TJA1051T-3 | SOIC-8_3.9x4.9mm_P1.27mm | 2 |  | http://www.nxp.com/documents/data_sheet/TJA1051.pdf | C38695
39 |  | TLE9201SG | U3 U15 | TLE9201SG | Infineon_PG-DSO-12-9 | 2 |  | ~ | C112633 | TLE9201SG
40 |  | VNL5090 | U11 U12 U13 U14 U16 U17 U18 U19 | VNL5090 | SOT-223 | 8 |  |  | C2680415
41 |  | f042_wideband_module | U1 U2 | f042_wideband_module | f042_wideband_module | 2
Project info:
Schematic: | Polygonus-Universal-Base
Variant: | default
Revision: | v1.2
Date: | 2026-03-03
KiCad Version: | 10.0.7-10.0.7~ubuntu24.04.1
Statistics:
Component Groups: | 41
Component Count: | 119
Fitted Components: | 119
Number of PCBs: | 1
Total Components: | 119
