halbritt/fome-mc/telemetry-pod/expansion/parts-manifest/review.md

# Independent review

`/root/expanded_pod_review` independently reproduced `malformed / unknown / missing`, zero matches and the exact TP2 legacy-marker refusal. It confirmed qualification executes before schematic-probe validation and full comparison never runs. All five actual copper jumpers separately passed captured source, embedded symbol/flags, native pin/function/net checks. All 400 copied dependencies match source hashes. The 326 unique reference set differs from the physical native XML only by J1.

No complete native parts pass. Next required work is supported canonical probe-source migration; board-only migration is insufficient. J1 historical import remains separately open. No caller normalization or suppressed failure is approved.
