halbritt/fome-mc/telemetry-pod/expansion/connector-candidate/native-evidence/connector.step

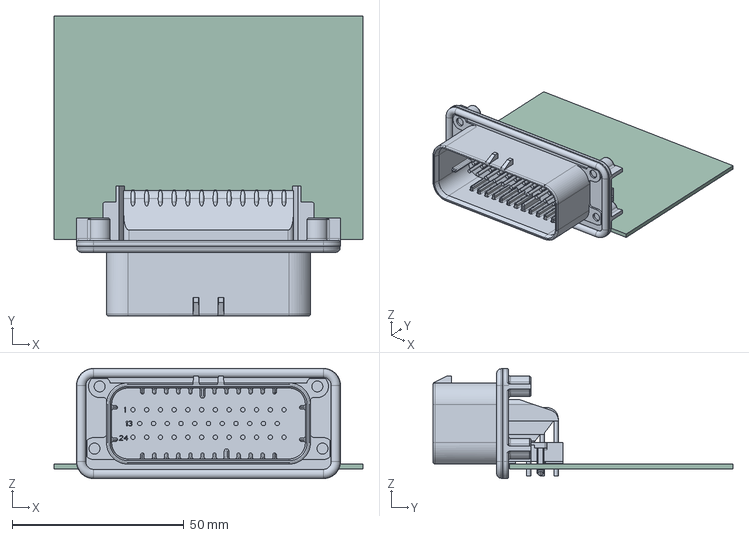
[picture p63: CAD file, 2026-10-20]
telemetry-pod/expansion/connector-candidate/native-evidence/connector.step
90.0 x 87.3 x 32.1 mm
C-1-776163-1
connector_PCB
