halbritt/fome-mc/telemetry-pod/operating-temperature-exemptions.txt

U1 is exempt from operating-temperature verification.
U2 is exempt from operating-temperature verification.
U4 is exempt from operating-temperature verification.
