halbritt/fome-mc/docs/WIRING_SV650_K7.md

# 2007 Suzuki SV650 (K7 Dual-Plug) Wiring & Adapter Harness Guide

This document specifies the complete adapter harness, sensor, actuator, dual Bosch LSU 4.9 wideband, and ignition coil wiring between a **2007 Suzuki SV650 / SV650S / SV650A / SV650SA (`K7`, Gen 2 dual-plug 90° V-twin)** and **`fome-mc`** (`J1` 35-pin Black `776163-1` and `J2` 35-pin Grey `776163-2`).

fome-mc J1 & J2 AMPSEAL Pinout Diagram

---

## 1. Vehicle System Interconnect Diagram

```mermaid
flowchart LR
  subgraph SV650["2007 Suzuki SV650 (K7) Vehicle Harness & Engine"]
    direction TB
    BATT["12V Battery + Main/Fuel Relay\n(R/Y, O/W, O/G, B/W)"]
    CKP["Crank VR Sensor (CKP)\n24-2 Rotor (G, Bl)"]
    SENS["Analog & Switch Sensors\nMAP1 (G/B), TPS1 (P/B), STPS (W)\nCLT (B/L), IAT (Lg/B), GP (P), TO (Br/W)\nVSS Hall (P), Clutch (Y/G), Neutral (Bl)"]
    INJ["Primary High-Z Injectors (~12Ω)\nFront #1 (Gr/W), Rear #2 (Gr/B)"]
    COILS_STOCK["Stock K7 Dual-Tower Coils\nFront #1 (W/Bl), Rear #2 (B)\n(or 4x Independent Primary + Trailing Coils)"]
    ISC["ISC Idle Valve\n4-Wire Stepper (~30Ω/ph)\n(Br/B, Br/W, G/W, G/B)"]
    STVA["STVA Secondary Throttles\n4-Wire Stepper (~7Ω/ph)\n(W/R, R, P/W, P)"]
    AUX["Relays, Solenoids & Dash\nFuel Pump (Y/R), Fan (B/W), PAIR (Br/B)\nTachometer (Y/Bl), 7800-Baud Dash (B/G)"]
  end

  subgraph EXT["Direct-Wired Sub-Harnesses"]
    direction TB
    LSU1["Front Cyl #1 Bosch LSU 4.9\n6-Pin Bosch 1 928 404 669"]
    LSU2["Rear Cyl #2 Bosch LSU 4.9\n6-Pin Bosch 1 928 404 669"]
    BARO_EXT["Default External 1-Bar Baro (FOMEMC-1)\nGM 12614970 / Delphi PS10150 (10–105 kPa)"]
    SVC["Sealed Service & Telemetry Pod Plug\nUSB (VBUS/DFU, D+, D-) + CAN1 (500 kbps)"]
  end

  subgraph ECU["fome-mc Integrated Motorcycle ECU (162 × 115 mm)"]
    direction TB
    J1["J1: 35-Pin TE AMPSEAL (Black 776164-1)\nPower, Grounds, INJ1..4, IGBT1..4\nAUX_LS1..4, MAIN_RLY, ETB1/2, STEP, WBO HTR, DFU"]
    J2["J2: 35-Pin TE AMPSEAL (Grey 776164-2)\nCLT, IAT, TPS1/2, MAP1, Ext Baro (J2-6), Gear, Knock\nVR1/2, Hall/DIN, WBO1/2 Cells, IGN_LOG, CAN1, USB"]
    H7["U26: STM32H753ZIT6 Main MCU\n+ U25 CSNP32GCR01-AOW 4GB SDNAND\n+ U29 ATWINC1500-MR210UB U.FL Wi-Fi + U24 LPS25HB (DNP)"]
    WBO["U302 & U402: Dual STM32F042K6T6\nOnboard Wideband Controllers (Internal CAN2)"]
    J1 --> H7
    J2 --> H7
    J1 --> WBO
    J2 --> WBO
    WBO <-->|"Internal 500 kbps CAN2 (PB12/PB13)\n+ PD4..PD7 NRST/BOOT0"| H7
  end

  BATT --> J1
  INJ --> J1
  COILS_STOCK --> J1
  ISC --> J1
  STVA --> J1
  AUX --> J1
  AUX --> J2
  CKP --> J2
  SENS --> J2
  LSU1 --> J1
  LSU1 --> J2
  LSU2 --> J1
  LSU2 --> J2
  BARO_EXT --> J1
  BARO_EXT --> J2
  SVC --> J1
  SVC --> J2
```

---

## 2. Mating Connector & Crimp BOM (ECU Side of Adapter Harness)

| Ref | Description | TE Connectivity MPN | Qty | Notes |
| :---: | :--- | :--- | :---: | :--- |
| `J1` Plug | 35-Pos AMPSEAL Plug Housing, **Key 1 Black** | `776164-1` | 1 | Mates with PCB header `776163-1` (`J1`) |
| `J2` Plug | 35-Pos AMPSEAL Plug Housing, **Key 2 Grey** | `776164-2` | 1 | Mates with PCB header `776163-2` (`J2`) |
| Contacts | AMPSEAL `1.3 mm` Gold-Plated Receptacle Crimp Terminals (16–20 AWG) | `770520-3` (strip) / `770854-3` (loose) | 70 | Rated `17 A` max single contact / `8–11 A` continuous in housing |
| Cavity Plugs | AMPSEAL Sealing Plugs for unused cavities | `770678-1` | 20 | Required in every unpopulated cavity to maintain IP67/IP69K seal |
| Strain Relief | AMPSEAL 35-Pos Back-Shell Wire Dress Cover | `776463-1` | 2 | Protects wire exit bundle and mat seal |

---

## 3. Complete SV650 K7 Stock ECM-to-`fome-mc` Pin Cross-Reference

### 3.1 `J1` (35-Pin Black `776164-1`) — Power, Grounds & Actuators

| `J1` Pin | `fome-mc` Signal | `STM32H753` Pin | Stock K7 SV650 Function | Stock K7 Wire Color & ECM Pin | Wire Gauge |
| :---: | :--- | :---: | :--- | :--- | :---: |
| `J1-1` | `INJ1` | `PG5` | Front Cyl #1 Primary Fuel Injector `-` | `Gr/W` (ECM Pin `a`) | 20 AWG |
| `J1-2` | `INJ2` | `PG6` | Rear Cyl #2 Primary Fuel Injector `-` | `Gr/B` (ECM Pin `b`) | 20 AWG |
| `J1-3` | `INJ3` | `PG7` | Spare / Staged Front Injector 3 `-` | Plug with `770678-1` on stock K7 | — |
| `J1-4` | `INJ4` | `PG8` | Spare / Staged Rear Injector 4 `-` | Plug with `770678-1` on stock K7 | — |
| `J1-5` | `PGND_INJ` | `GND` | Injector & Low-Side Power Ground Return | `B/W` (ECM Pin `p`/`q` splice) | 16 AWG |
| `J1-6` | `IGBT1` | `PB3` | Front Cyl #1 Primary Center Coil `-` (or K7 Dual-Tower Front Coil `-`) | `W/Bl` (ECM Pin `l`) | 18 AWG |
| `J1-7` | `IGBT2` | `PG15` | Rear Cyl #2 Primary Center Coil `-` (or K7 Dual-Tower Rear Coil `-`) | `B` (ECM Pin `c`) | 18 AWG |
| `J1-8` | `IGBT3` | `PG14` | Front Cyl #1 Trailing Side Coil `-` (4-Coil Split Mode) | Sub-harness to Front Side Coil `-` | 18 AWG |
| `J1-9` | `IGBT4` | `PG13` | Rear Cyl #2 Trailing Side Coil `-` (4-Coil Split Mode) | Sub-harness to Rear Side Coil `-` | 18 AWG |
| `J1-10` | `AUX_LS1` | `PC6` | Fuel Pump Relay Coil `-` | `Y/R` (ECM Pin `W`) | 20 AWG |
| `J1-11` | `AUX_LS2` | `PC7` | Cooling Fan Relay Coil `-` | `B/W` or `Y/G` (ECM Pin `V`) | 20 AWG |
| `J1-12` | `AUX_LS3` | `PA15` | PAIR Air Injection Solenoid Valve `-` | `Br/B` (ECM Pin `e`) | 20 AWG |
| `J1-13` | `AUX_LS4` | `PD3` | Tachometer Pulse Output (`0–12 V` w/ onboard 2.2 kΩ pull-up) | `Y/Bl` (ECM Pin `Z`) | 20 AWG |
| `J1-14` | `MAIN_RLY` | `PE0` | ECU Main Relay Low-Side Hold (`U1202.6` + `D209` `B340A-13-F`) | Main Relay Coil `-` (Adapter / Harness) | 20 AWG |
| `J1-15` | `ETB1_OUT+` | `PD12/10/11` | `STVA` Secondary Throttle Stepper Phase A+ | `W/R` (ECM Pin `[`) | 20 AWG |
| `J1-16` | `ETB1_OUT-` | `PD12/10/11` | `STVA` Secondary Throttle Stepper Phase A- | `R` (ECM Pin `f`) | 20 AWG |
| `J1-17` | `ETB2_OUT+` | `PD13/9/8` | `STVA` Secondary Throttle Stepper Phase B+ | `P/W` (ECM Pin `Y`) | 20 AWG |
| `J1-18` | `ETB2_OUT-` | `PD13/9/8` | `STVA` Secondary Throttle Stepper Phase B- | `P` (ECM Pin `d`) | 20 AWG |
| `J1-19` | `STEP_1A` | `PB4/7/8` | `ISC` Idle Speed Control Stepper Phase A+ | `Br/B` (ECM Pin `g`) | 20 AWG |
| `J1-20` | `STEP_1B` | `PB4/7/8` | `ISC` Idle Speed Control Stepper Phase A- | `Br/W` (ECM Pin `^`) | 20 AWG |
| `J1-21` | `STEP_2A` | `PB4/7/8` | `ISC` Idle Speed Control Stepper Phase B+ | `G/W` (ECM Pin `i`) | 20 AWG |
| `J1-22` | `STEP_2B` | `PB4/7/8` | `ISC` Idle Speed Control Stepper Phase B- | `G/B` (ECM Pin `\`) | 20 AWG |
| `J1-23` | `WBO1_HTR-` | `WBO1:PB0` | Front Cyl #1 Bosch LSU 4.9 Pin 3 (`Heater -`) | White (LSU 4.9 #1 Pin 3) | 18 AWG |
| `J1-24` | `WBO_HTR+` | `+12V_MR` | Bosch LSU 4.9 #1 & #2 Pin 4 (`Heater +12V`) | Grey (LSU 4.9 #1 & #2 Pin 4 splice) | 18 AWG |
| `J1-25` | `WBO2_HTR-` | `WBO2:PB0` | Rear Cyl #2 Bosch LSU 4.9 Pin 3 (`Heater -`) | White (LSU 4.9 #2 Pin 3) | 18 AWG |
| `J1-26` | `+12V_IGN_SW` | `PC5` (`ADC_15`) | Ignition / Kill Switch Run `+12V` Input (`D20` OR + `R96/R97` Sense) | `O/W` (ECM Pin `D`) | 20 AWG |
| `J1-27` | `+12V_MR` | `PF11` (`ADC_16`)| Main Relay Switched `+12V` Power Input (`D21` OR -> `12V_RAW`; ECU input — Telemetry Pod splices `R/Y` in harness with own `2 A` fuse) | `R/Y` (ECM Pins `A` & `B`) | 16 AWG |
| `J1-28` | `+12V_BATT_KEEPALIVE`| — | Unswitched Battery `+12V` Keep-Alive (`U41` `MIC5205` -> `VBAT`) | `O/G` (ECM Pin `H`) | 20 AWG |
| `J1-29` | `5V_SENSOR_1` | `PF12` (`ADC_17`) + `PF15` (`PG`) | Regulated `+5.00V` Sensor Supply #1 (`U1` `TLS115D0E`) | `R` (ECM Pin `C`: TPS, STPS, MAP1, Ext Baro, GP) | 20 AWG |
| `J1-30` | `5V_SENSOR_2` | `PF14` (`PG`) | Regulated `+5.00V` Sensor Supply #2 (`U2` `TLS115D0E`) | Aux Harness `+5.00V` Supply (not used by Telemetry Pod; pod regulates its own `5.00V` sensor rail) | 20 AWG |
| `J1-31` | `SGND` | `VSSA` | Dedicated Analog & Sensor Ground Return | `Br/B` (ECM Pin `9` + Ext Baro GND) | 20 AWG |
| `J1-32` | `PGND_IGN` | `GND` | Ignition IGBT Emitter Power Ground Return | `B/W` (ECM Pins `p` & `q`) | 16 AWG |
| `J1-33` | `PGND_HEATER` | `GND` | Wideband Heater & H-Bridge Ground Return | Direct to Battery `-` / Frame Ground | 16 AWG |
| `J1-34` | `CHASSIS_ECU_GND` | `VSS` | Main ECU Logic Ground Reference (shared chassis ground reference with Telemetry Pod) | `B/W` (ECM Pin `r`) | 18 AWG |
| `J1-35` | `USB_VBUS_DFU` | `PA9` + `BOOT0` | Service USB `VBUS` (`+5V`) / Force DFU (`+12V`) | Service USB Connector Pin 1 (`VBUS`) | 20 AWG |

---

### 3.2 `J2` (35-Pin Grey `776164-2`) — Sensors, Wideband Cells, Logic Coils, CAN1 & USB

| `J2` Pin | `fome-mc` Signal | `STM32H753` Pin | Stock K7 SV650 Function | Stock K7 Wire Color & ECM Pin | Wire Gauge |
| :---: | :--- | :---: | :--- | :--- | :---: |
| `J2-1` | `CLT` | `PC1` (`ADC_11`) | Engine Coolant Temp (`ECT`, 2.7 kΩ pull-up) | `B/L` (ECM Pin `6`) | 20 AWG |
| `J2-2` | `IAT` | `PC2` (`ADC_12`) | Intake Air Temp (`IAT`, 2.7 kΩ pull-up) | `Lg/B` (ECM Pin `7`) | 20 AWG |
| `J2-3` | `TPS1` | `PA1` (`ADC_1`) | Primary Throttle Position Sensor (`TPS`) | `P/B` (ECM Pin `5`) | 20 AWG |
| `J2-4` | `TPS2_STPS` | `PA3` (`ADC_3`) | Secondary Throttle Position Sensor (`STPS`) | `W` (ECM Pin `4`) | 20 AWG |
| `J2-5` | `MAP1_FRONT` | `PA0` (`ADC_0`) | Front Cyl #1 Intake Air Pressure (`IAP1`) + Cam Sync | `G/B` (ECM Pin `3`) | 20 AWG |
| `J2-6` | `AV3_BARO_MAP2` | `PA2` (`ADC_2`) | Default External 1-Bar Baro (`GM 12614970` / `Delphi PS10150`, `MT_GM_1_BAR`) | External Baro Signal (`10–105 kPa`, powered by `J1-29` & `J1-31`) | 20 AWG |
| `J2-7` | `AV5_TIPOVER` | `PA4` (`ADC_4`) | Tip-Over Pendulum Sensor (`TO`) | `Br/W` (ECM Pin `J`) | 20 AWG |
| `J2-8` | `AV6_GEAR` | `PA5` (`ADC_5`) | 6-Speed Gear Position Switch (`GP`, 1.5 kΩ pull-up) | `P` (ECM Pin `1`) | 20 AWG |
| `J2-9` | `KNOCK1` | `PF4` (`ADC3_9`) | Front Cyl #1 Piezo Knock Sensor | Optional Knock 1 (`RG-174` / twisted) | 20 AWG |
| `J2-10` | `KNOCK2` | `PF5` (`ADC3_4`) | Rear Cyl #2 Piezo Knock Sensor | Optional Knock 2 (`RG-174` / twisted) | 20 AWG |
| `J2-11` | `VR1+` | `PE14` | Crankshaft Position Sensor `CKP+` (`24-2` Rotor) | `G` (ECM Pin `R`) | 20 AWG (Twisted) |
| `J2-12` | `VR1-` | — | Crankshaft Position Sensor `CKP-` Return | `Bl` (ECM Pin `8`) | 20 AWG (Twisted) |
| `J2-13` | `VR2+` | `PE15` | Secondary / Cam VR+ (Unused on camless K7) | Plug with `770678-1` on stock K7 | — |
| `J2-14` | `VR2-` | — | Secondary / Cam VR- (Unused on camless K7) | Plug with `770678-1` on stock K7 | — |
| `J2-15` | `HALL1_CAM` | `PG1` | Aux Hall Input 1 (2.7 kΩ pull-up `R24`) | Plug with `770678-1` on stock K7 | — |
| `J2-16` | `HALL2_VSS` | `PG0` | Vehicle Speed Sensor (`VSS` 3-Wire Hall) | `P` (ECM Pin `K`) | 20 AWG |
| `J2-17` | `DIN1_CLUTCH` | `PE11` | Clutch Lever Switch (Active-Low to GND) | `Y/G` (ECM Pin `M`) | 20 AWG |
| `J2-18` | `DIN2_NEUTRAL` | `PE10` | Neutral / Sidestand Switch (Active-Low to GND) | `Bl` (ECM Pin `N`) | 20 AWG |
| `J2-19` | `WBO1_VM` | `WBO1:PA2/6` | Front Cyl #1 Bosch LSU 4.9 Pin 2 (`Vm`) | Yellow (LSU 4.9 #1 Pin 2) | 20 AWG |
| `J2-20` | `WBO1_IP` | `WBO1:PA1/5` | Front Cyl #1 Bosch LSU 4.9 Pin 1 (`Ip`) | Red (LSU 4.9 #1 Pin 1) | 20 AWG |
| `J2-21` | `WBO1_RCAL` | — | Front Cyl #1 Bosch LSU 4.9 Pin 5 (`Rcal`) | Green (LSU 4.9 #1 Pin 5) | 20 AWG |
| `J2-22` | `WBO1_UN` | `WBO1:PA3/7/9` | Front Cyl #1 Bosch LSU 4.9 Pin 6 (`Un / Vs`) | Black (LSU 4.9 #1 Pin 6) | 20 AWG |
| `J2-23` | `IGN1_LOG` | `PG12` | 5 V Push-Pull Smart Coil 1 Trigger | Optional Smart Coil 1 | 20 AWG |
| `J2-24` | `IGN2_LOG` | `PG11` | 5 V Push-Pull Smart Coil 2 Trigger | Optional Smart Coil 2 | 20 AWG |
| `J2-25` | `IGN3_LOG` | `PG10` | 5 V Push-Pull Smart Coil 3 Trigger | Optional Smart Coil 3 | 20 AWG |
| `J2-26` | `IGN4_LOG` | `PG9` | 5 V Push-Pull Smart Coil 4 Trigger | Optional Smart Coil 4 | 20 AWG |
| `J2-27` | `DASH_TECH` | `PB9` | SV650 K7 7800-Baud Dash Serial (Open-drain low-side; pulled up in K7 cluster) | `B/G` (ECM Pin `U`) | 20 AWG |
| `J2-28` | `CAN1_H` | `PD0/PD1` | External `CAN1_H` (500 kbps, `120 Ω`, 50 Hz `0x200..0x207` TX + IMU RX + OpenBLT) | Telemetry Pod / Dash / Service `CAN_H` | 20 AWG (Twisted) |
| `J2-29` | `CAN1_L` | `PD0/PD1` | External `CAN1_L` (500 kbps, `120 Ω`, 50 Hz `0x200..0x207` TX + IMU RX + OpenBLT) | Telemetry Pod / Dash / Service `CAN_L` | 20 AWG (Twisted) |
| `J2-30` | `WBO2_VM` | `WBO2:PA2/6` | Rear Cyl #2 Bosch LSU 4.9 Pin 2 (`Vm`) | Yellow (LSU 4.9 #2 Pin 2) | 20 AWG |
| `J2-31` | `WBO2_IP` | `WBO2:PA1/5` | Rear Cyl #2 Bosch LSU 4.9 Pin 1 (`Ip`) | Red (LSU 4.9 #2 Pin 1) | 20 AWG |
| `J2-32` | `WBO2_RCAL` | — | Rear Cyl #2 Bosch LSU 4.9 Pin 5 (`Rcal`) | Green (LSU 4.9 #2 Pin 5) | 20 AWG |
| `J2-33` | `WBO2_UN` | `WBO2:PA3/7/9` | Rear Cyl #2 Bosch LSU 4.9 Pin 6 (`Un / Vs`) | Black (LSU 4.9 #2 Pin 6) | 20 AWG |
| `J2-34` | `USB_D+` | `PA12` | Service / Tuning USB Full-Speed `D+` | Service USB Connector Pin 3 (`D+`, Green)| 20 AWG (Twisted) |
| `J2-35` | `USB_D-` | `PA11` | Service / Tuning USB Full-Speed `D-` | Service USB Connector Pin 2 (`D-`, White)| 20 AWG (Twisted) |

---

## 4. Ignition Coil Topologies (2-Coil Stock vs. 4-Coil Independent Primary/Trailing)

```mermaid
flowchart TD
  subgraph MODE_A["Mode A: Stock K7 2-Coil Wasted-Spark Secondary (enableTrailingSpark = false)"]
    direction LR
    A_J1_6["J1-6: IGBT1 (PB3)\nignitionPins[0]"] -->|"W/Bl (ECM Pin l)"| C1_DUAL["Stock K7 Front Coil (33410-17GA0)\nDual-Tower Secondary\nFires Cyl #1 Center + Side Simultaneously"]
    A_J1_7["J1-7: IGBT2 (PG15)\nignitionPins[1]"] -->|"B (ECM Pin c)"| C2_DUAL["Stock K7 Rear Coil (33420-17GA0)\nDual-Tower Secondary\nFires Cyl #2 Center + Side Simultaneously"]
  end

  subgraph MODE_B["Mode B: 4-Coil Independent Primary & Trailing Spark (enableTrailingSpark = true)"]
    direction LR
    B_J1_6["J1-6: IGBT1 (PB3)\nignitionPins[0] (Primary Advance)"] -->|"W/Bl (ECM Pin l)"| C1_PRI["Cyl #1 Primary Coil\n(Front Center Plug)"]
    B_J1_8["J1-8: IGBT3 (PG14)\ntrailingCoilPins[0] (+trailingSparkAngle)"] -->|"2-Wire Trailing Sub-Harness"| C1_TRL["Cyl #1 Trailing Coil\n(Front Side Plug)"]
    B_J1_7["J1-7: IGBT2 (PG15)\nignitionPins[1] (Primary Advance)"] -->|"B (ECM Pin c)"| C2_PRI["Cyl #2 Primary Coil\n(Rear Center Plug)"]
    B_J1_9["J1-9: IGBT4 (PG13)\ntrailingCoilPins[1] (+trailingSparkAngle)"] -->|"2-Wire Trailing Sub-Harness"| C2_TRL["Cyl #2 Trailing Coil\n(Rear Side Plug)"]
  end
```

---

## 5. Dual Bosch LSU 4.9 Wideband Sub-Harness Pinout

Each Bosch LSU 4.9 sensor (`0 258 017 025`) uses a 6-pin connector that mates with a harness-side Bosch `1 928 404 669` plug:

| LSU 4.9 Sensor Pin | Signal | Wire Color | Front Cyl #1 (`WBO1`) Destination | Rear Cyl #2 (`WBO2`) Destination |
| :---: | :--- | :--- | :---: | :---: |
| **Pin 1** | `Ip` (Pump Current) | Red | `J2-20` (`WBO1_IP`) | `J2-31` (`WBO2_IP`) |
| **Pin 2** | `Vm` (Virtual Ground `1.65V`) | Yellow | `J2-19` (`WBO1_VM`) | `J2-30` (`WBO2_VM`) |
| **Pin 3** | `H-` (Heater Low-Side PWM) | White | `J1-23` (`WBO1_HTR-`) | `J1-25` (`WBO2_HTR-`) |
| **Pin 4** | `H+` (Heater `+12V` Supply) | Grey | `J1-24` (`WBO_HTR+` / Switched `+12V_MR`) | `J1-24` (`WBO_HTR+` / Switched `+12V_MR`) |
| **Pin 5** | `Rcal` (Calibration Resistor) | Green | `J2-21` (`WBO1_RCAL`) | `J2-32` (`WBO2_RCAL`) |
| **Pin 6** | `Un / Vs` (Nernst Cell) | Black | `J2-22` (`WBO1_UN`) | `J2-33` (`WBO2_UN`) |

---

## 6. External 1-Bar Barometer (`GM 12614970` / `Delphi PS10150`) & Stock K7 ECM Pin Key

1. **External GM 1-Bar Barometric Pressure Sensor (`12614970` / `PS10150`, Metri-Pack 150 3-Pin)**:
   - **Pin A (`GND`)**: Wire to `J1-31` (`SGND` sensor ground return).
   - **Pin B (`Signal`, `0.25–4.85 V` for `10–105 kPa`, `MT_GM_1_BAR`)**: Wire to `J2-6` (`AV3_BARO_MAP2` / `PA2` `EFI_ADC_2`).
   - **Pin C (`+5 V`)**: Wire to `J1-29` (`5V_SENSOR_1` regulated `+5.00 V`).
2. **Suzuki SV650 K7 Stock 2×34-Pin ECM Connector Notation (`99500-36140-01E`)**:
   - Single-character designations (`1`–`9`, `A`–`Z`, `[`, `\`, `^`, `a`–`r`) in Tables 3.1 and 3.2 follow the factory Suzuki SV650 K7/K8 Service Manual (`99500-36140-01E`) wiring diagram index for the two 34-pin Denso/Sumitomo stock ECM plugs (Connector #1 Gray `1`–`Z`/`[`/`\`/`^`; Connector #2 Black `a`–`r`).
   - **Stock Main Relay vs. `J1-14` (`MAIN_RLY`)**: On a factory SV650 K7 harness, the ignition switch + engine stop switch feed `+12 V` (`O/W`) directly to coils/injectors and ECM Pin `D`. In a plug-and-play adapter harness, tie `J1-26` (`+12V_IGN_SW`) and `J1-27` (`+12V_MR`) together to the switched `O/W` (`+12 V`) bus (leaving `J1-14` `MAIN_RLY` unused), or wire an external 30 A automotive relay whose coil `-` is held by `J1-14` (`MAIN_RLY`, `PE0` + `D209` `B340A-13-F`) and whose switched `+12 V` contact feeds `J1-24` and `J1-27`.

---

## 7. Tail-Cowl `CAN1` Telemetry Pod Harness Tap & Sensor Ranges (`FOMEMC-31`)

Source: [telemetry-pod/REQUIREMENTS.md](../telemetry-pod/REQUIREMENTS.md), revision 2 (2026-10-18), sha256 `09e02c8d9471aabfa5d25935c87f436370cf1be367a96425b35305a53ce93493`.

Per the **2026-10-18 owner decision** (`FOMEMC-31` / `pod-45`: power source **"Harness splice on the relay circuit, own 2 A fuse"**; travel ranges **"130 and 70 mm"**; combined choice **"Harness splice on the relay circuit, own 2 A fuse; 130 and 70 mm"**), the tail-cowl telemetry pod connects to the vehicle harness as follows and **never draws power from the ECU** (`J1-27` or `J1-30`):

| Telemetry Pod Function | `fome-mc` / Harness Connection | Wire Color & Gauge | Specification & Notes |
| :--- | :--- | :--- | :--- |
| **`CAN1_H` / `CAN1_L`** | `J2-28` (`CAN1_H`), `J2-29` (`CAN1_L`) | White / Blue (`20–22 AWG` twisted pair, `30–40 twists/m`) | `500 kbps` ISO 11898-2; `120 Ω` far-end termination on the pod (`R9 = 120 Ω` on `fome-mc` at the ECU end) |
| **Switched `+12 V` Power In** | **"Harness splice on the relay circuit, own 2 A fuse"** (splices `R/Y` main relay circuit that also feeds `J1-27` `+12V_MR`) | Red/Yellow (`20 AWG`) via dedicated `2 A` inline fuse | `J1-27` is an ECU power input (`D21` `B340A-13-F` OR into `12V_RAW`); the pod taps the harness `R/Y` relay output directly and never draws from the ECU |
| **Power & Logic Ground** | Chassis ground point shared with `J1-34` (`CHASSIS_ECU_GND`) | Black/White (`20 AWG`) | Grounds to chassis with the ECU (`J1-34` is `CHASSIS_ECU_GND`) |
| **Pod Sensor Supply (`+5.00 V`)** | Local pod `5.00 V ± 1%` (`200 mA`) regulator (`J1-30` `5V_SENSOR_2` & `J1-31` `SGND` **not used**) | Pod-local sensor sub-harness | Ratiometric `5.00 V` supply & return for the 4 external analog sensors: **130 mm** front fork pot (`0–130 mm`), **70 mm** rear shock pot (`0–70 mm`), and `0–100 bar` (`0.5–4.5 V`) front/rear brake pressure transducers |
