halbritt/fome-mc/telemetry-pod/expansion/requirements/operating-temperature-acceptances.txt

U1 is accepted for operating temperature -20 to 85 degC.
U2 is accepted for operating temperature -20 to 85 degC.
U4 is accepted for operating temperature -20 to 85 degC.
