halbritt/fome-mc/docs/renders/fome-mc-pcb-assembly.png

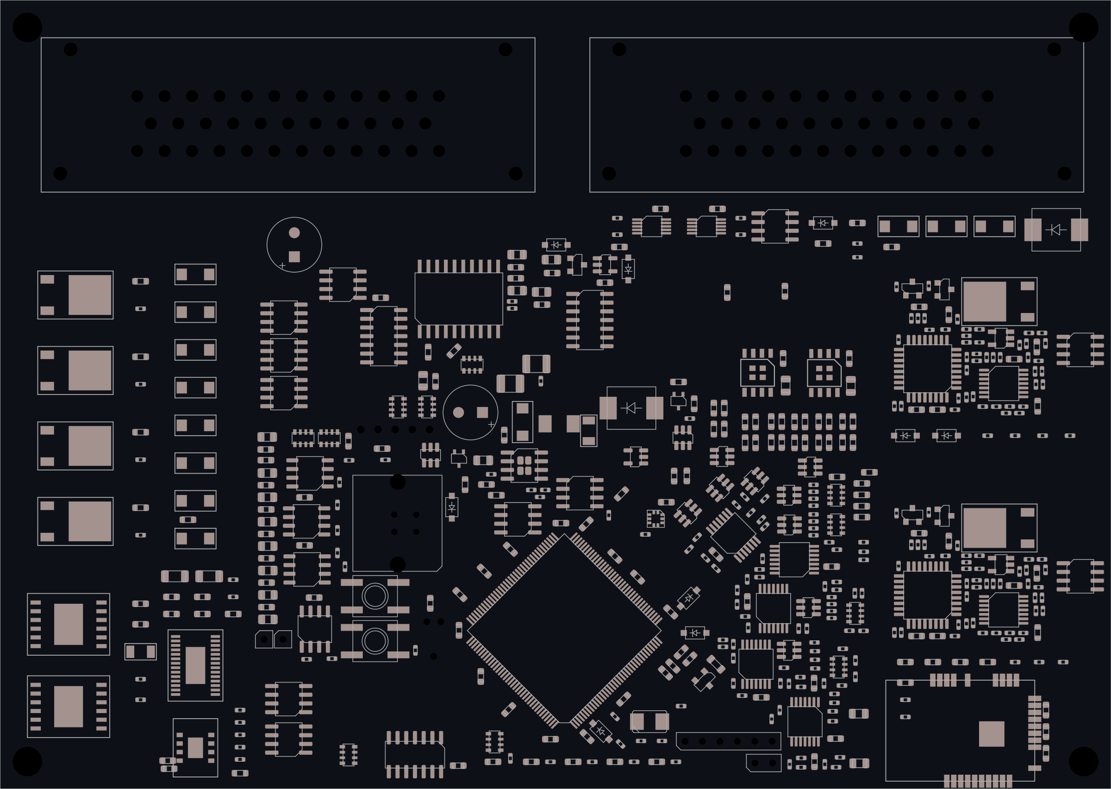
docs/renders/fome-mc-pcb-assembly.png
