halbritt/fome-mc/telemetry-pod/expansion/agentee-477-3d-models/views/fit-montage.png

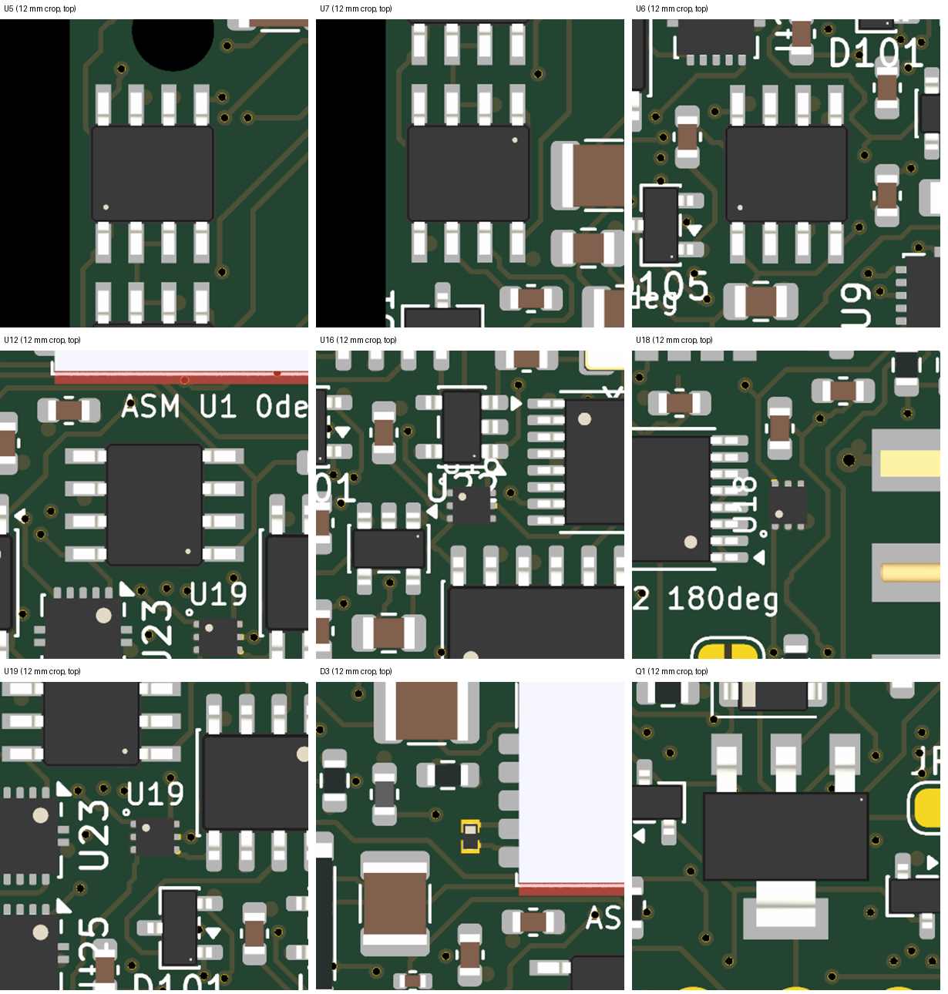
telemetry-pod/expansion/agentee-477-3d-models/views/fit-montage.png
