halbritt/fome-mc/VALIDATION.md

# `fome-mc`: Verification, Validation & Bring-Up Ledger

This document separates **what has been verified locally in software, firmware, netlist, and EDA tooling** from **what remains to be completed in physical routing, bench bring-up, and vehicle validation**.

---

## 1. Local Automated Verification Ledger (Completed & Passing)

| Verification Gate | Command / Artifact | Result | Evidence & Scope |
| :--- | :--- | :--- | :--- |
| **1. Schematic-to-Firmware-to-Pinout Cross-Check (`verify_io_map.py`)** | `python3 scripts/verify_io_map.py` | **PASS (0 errors)** | Verifies 1-to-1 electrical continuity across all **70 external TE AMPSEAL connector pins** (`J1-1..35`, `J2-1..35` in [`io-map.csv`](file:///home/halbritt/git/fome-mc/io-map.csv)), **16 internal buses** (`CAN2`, `WBO1/2_NRST/BOOT0/SEL`, `SDMMC1` 4-bit `U25`, `BARO_I2C` `U24`, `PWR_KEEPALIVE`), **474 netlist components** (`0` unannotated, `0` duplicate designators in [`export/fome-mc.net`](file:///home/halbritt/git/fome-mc/export/fome-mc.net)), and **34 TunerStudio YAML definitions + `board_configuration.cpp`**. |
| **2. Full EDA Toolchain Check (`make check`)** | `make check` (`python3 toolchain/eda.py run --project fome-mc --fill asis --steps erc,drc,netlist,export,analyze`) | **PASS (`overall: PASS`)** | Run [`build/runs/project/fome-mc/20261016T225554.822110Z/SUMMARY.md`](file:///home/halbritt/git/fome-mc/build/runs/project/fome-mc/20261016T225554.822110Z/SUMMARY.md):<br>- **`erc`: PASS** (all 21 schematic sheets checked, 0 missing sheets, 0 library resolution issues)<br>- **`drc`: PASS** (`0` copper shorts, `0` clearance errors, `0` hole clearance errors, `0` courtyard overlaps, `0` silkscreen overlaps, `0` missing footprint libraries; `237` unrouted wing/connector nets remaining to be hand-routed before PCB fab)<br>- **`netlist`: PASS** (`474` components, `456` nets, `0` missing from netlist)<br>- **`export`: PASS** (21-page schematic PDF, 21 SVGs, 6 PCB PDFs, KiBot Gerbers `F.Cu/In1.Cu/In2.Cu/B.Cu/Edge.Cuts`, Excellon drills, position files, BOM CSV/HTML)<br>- **`analyze`: PASS** (`kicad-happy` schematic, PCB, and 10 cross-analysis checks). |
| **3. FOME `fome-mc` Bootloader + Firmware + TunerStudio `.ini` Build** | `bash compile_fome-mc.sh` in `/home/halbritt/git/fome-fw/firmware/config/boards/fome-mc` | **PASS (0 errors)** | Compiles:<br>- OpenBLT bootloader: `blbuild/fome_bl.elf` (`40,388 B`)<br>- Application ELF: `build/fome.elf` (`text = 697,766 B`, `data = 1,224 B`, `bss = 581,820 B`)<br>- Combined binary: `deliver/fome.bin` (`830,076 B`) + `fome_bl.srec` + `fome_update.srec`<br>- TunerStudio definition: `tunerstudio/generated/fome_fome-mc.ini` (`signature = "FOME rusEFI master.2026.10.16.fome-mc.4129716427"`). |
| **4. Host Unit Tests for Upstream FOME Bug Fixes & SV650 Odd-Fire Dual-Plug Ignition** | `./build/fome_test --gtest_filter="BufferedWriter.*:ignition.*:OddFireRunningMode.hd:pairedOddFireWastedSpark.*"` in `/home/halbritt/git/fome-fw/unit_tests` | **PASS (16 / 16 tests)** | Verifies:<br>- `trailingSpark` (rotary/twin primary + trailing split)<br>- `trailingSparkTwoCylinderOddFireSV650` (90° V-twin `270°/450°` odd-fire primary + trailing scheduling across cranking and running)<br>- `trailingSparkOverdwellProtection` (verifies `trailingCoils` forced LOW on overdwell / engine stall)<br>- `OddFireRunningMode.hd` & `pairedOddFireWastedSpark.*`. |
| **5. BOM & Placement Export (`BOM-fome-mc.csv` & `CPL-fome-mc.csv`)** | [`export/BOM-fome-mc.csv`](file:///home/halbritt/git/fome-mc/export/BOM-fome-mc.csv) & [`export/CPL-fome-mc.csv`](file:///home/halbritt/git/fome-mc/export/CPL-fome-mc.csv) | **PASS (`101` unique BOM lines / `474` parts)** | All `474` components matched between schematic, netlist, BOM, and PCB placement (`162.0 mm × 115.0 mm` 4-layer board). |

---

## 2. Closed Reviewer Engineering Decisions & Verification Evidence

| Engineering Domain | Decision Implemented in `fome-mc` | Source Code / Datasheet / Schematic Evidence |
| :--- | :--- | :--- |
| **1. Barometric Sensing** | - **Primary**: Onboard `LPS25HBTR` (`U24`, `C87898` at `121.62, 100.61 mm` on `I2C2` `PB10/PB11`) inside an unpotted chimney dam (`ID 8.0 mm × OD 11.0 mm` on `F.Fab`) mated to a hydrophobic ePTFE membrane vent (`Amphenol LTW VE80410` / `Gore PMF100321`, `τ < 2 ms` pressure equalization).<br>- **Fallback A**: External automotive 1-bar sensor **GM `12614970` / Delphi `PS10150`** (`MT_GM_1_BAR`, `10–105 kPa`, `0.0–5.0V`) or **Bosch `0 261 230 146`** (`15–115 kPa`) on `J2-6` (`MAP2_REAR` `PA2`).<br>- **Fallback B**: Pre-cranking MAP baro (`useFixedBaroCorrFromMap`) documented as single-shot boot capture (`storedInitialBaroPressure`, `60..110 kPa`). | - `fome-fw/firmware/init/sensor/init_map.cpp:62-63` (`MT_GM_1_BAR`: `0.0V = 10 kPa`, `5.0V = 105 kPa`)<br>- `fome-fw/firmware/controllers/sensors/impl/map.cpp:17-39` (`validateBaroMap` `60..110 kPa` and single-shot `Sensor::setMockValue(SensorType::BarometricPressure, storedInitialBaroPressure)` in `initMap()`)<br>- `fome-mc/fome-mc.kicad_pcb` (`baro.dam.id` / `baro.dam.od` rings around `U24`). |
| **2. Soldered Onboard Logging Storage (SD NAND)** | - Soldered **`XTSD04GLGEAG`** (`U25`, `C558840`, 4 Gbit = `512 MB` raw / `~480 MiB` FAT32) or **`MKDV4GIL-AST`** (`C726727`) / **`MKDV1GIL-AS`** (`C726726`, 1 Gbit = `128 MB`) in `6 × 8 mm` LGA-8 (`ampseal:LGA-8_6x8mm_P1.25mm`) on 4-bit `SDMMC1` (`PC8..PC12, PD2`) with `47 kΩ` pull-ups on `CMD, DAT0..3` and `22 Ω` series resistor on `CLK`.<br>- Zero hardware `SD_CD` pin required.<br>- Records **`~20.2 hours` at `50 Hz`** (`~10.1 hours` at `100 Hz`) on 4 Gbit at `1,384 B/frame`. | - `fome-mc/mcu.kicad_sch` (`U25` `XTSD04GLGEAG` connected to `SD_D0..3, SD_CLK, SD_CMD`)<br>- `fome-fw/firmware/hw_layer/mmc_card_attach.cpp:88-104` (`sdcConnect(&SDCD1)` uses 4-bit `SDMMC1` with no `SD_CD` GPIO)<br>- `fome-fw/firmware/console/binary_log/sd_file_log.cpp:43` (`F_SYNC_PERIOD_SEC = 2`, `TS_TOTAL_OUTPUT_SIZE = 1380`). |
| **3. Log Retrieval, Filesystem Ownership & Post-Potting Recovery** | - **Single-Owner `FatFs` / `USBMSD1` Handoff**: Fixed upstream dual-mount concurrency bug so `FatFs` and `USBMSD1` never mount `SDCD1` simultaneously; plugging in USB while stopped (`rpm == 0`) flushes/closes the active `.mlg` file, unmounts `FatFs`, and attaches `SDCD1` to `USBMSD1` (`SD_STATE_PC_CONNECTED`).<br>- **Post-Potting Recovery**: `J1-35` (`USB_VBUS_DFU` `+5V` VBUS / `+12V` Zener `BOOT0` override via `R209`) + `J2-34/35` (`USB_D+/D-`) + `J2-28/29` (`CAN1`) for `STM32H753`; `PE2..PE5` (`WBO1/2_NRST` & `WBO1/2_BOOT0`) for sequential single-node OpenBLT flashing of both `STM32F042K6T6` wideband MCUs over internal `CAN2`. | - `fome-fw/firmware/hw_layer/mmc_card.h`<br>- `fome-fw/firmware/hw_layer/mmc_card_mount.cpp:69-101, 179-203` (`pollUsbHandOffRequested()`, `handOffSdToUsbMassStorage()`)<br>- `fome-fw/firmware/console/binary_log/sd_file_log.cpp:200-217` (`tryHandOffActiveLogToUsb()`)<br>- `fome-mc/stepper_etb.kicad_sch` (`R209` `USB_VBUS_BOOT0` -> `BOOT0_OUT`)<br>- `fome-mc/wbo1.kicad_sch` & `wbo2.kicad_sch` (`WBO_NRST`, `WBO_BOOT0`). |
| **4. Encapsulation & Enclosure** | - Acrylic conformal base coat (`Electrolube HPA` / `Humiseal 1B31`) + selective soft thermally conductive 2-part polyurethane (`Electrolube UR5634` / `MG Chemicals 832TC`, `Shore A 55–65`, `k ≥ 0.85 W/m·K`, `Tg < -40 °C`) inside a single-ended aluminum enclosure (`166 × 120 × 32 mm`) with the `U24` barometer chimney pocket vented via `VE80410`. | - [`DESIGN.md` Section 7.2 & 7.6](file:///home/halbritt/git/fome-mc/DESIGN.md) (`11.12 W` continuous / `21.19 W` peak thermal budget, CTE stress analysis, and pre-/post-potting test gates). |

---

## 3. Open Physical & Bench Validation Items (Not Yet Claimed)

Per repository rules, implemented and locally verified claims are reported separately from physical hardware bring-up:

1. **Final Copper Trace Routing of the Outer Wing & Connector Nets (`237` nets)**:
   - All `474` footprints are placed on the `162.0 mm × 115.0 mm` 4-layer PCB (`fome-mc.kicad_pcb`), the retained center processor/power/analog core and both translated `WBO1`/`WBO2` copper islands retain their internal tracks, vias, and 4-layer power/ground planes with **0 DRC errors** (`0` shorts, `0` clearance errors, `0` courtyard overlaps), and `237` point-to-point nets between the center core, the West power wing (`Q201..Q204`, `U201..U203`, `D201..D208`, `U25`), the East wideband wing (`WBO1`, `WBO2`), and the North `J1`/`J2` AMPSEAL headers remain to be interactively routed in KiCad before Gerber release to fabrication.
2. **Physical Bench Bring-Up & Thermal Soak**:
   - Bench verification of `VBOOST` (`~13.5 V` down to `3.5 V` battery input), `5V_SENSOR_1/2` tracking accuracy, dual `LSU 4.9` closed-loop `Pump` / `Nernst` / `Heater` regulation in free air and test gas, `LPS25HBTR` chimney-dam pressure step response before and after polyurethane cure, and `11.1 W` thermal soak.
3. **2007 Suzuki SV650 (K7) Vehicle Integration & Dyno/Road Tuning**:
   - Verification of `24-2` crank VR waveform + `VVT_MAP_V_TWIN` camless phase lock on the K7 engine, `DRV8825` `ISC` idle speed control, `TLE9201SG` `STVA` secondary throttle control, `7800-baud` single-wire `DASH_TECH` coolant/FI cluster frames, and primary + trailing spark advance sweeps.
