halbritt/fome-mc/docs/VALIDATION.md

# `fome-mc`: Verification, Validation & Bring-Up Ledger

This document separates **what has been verified locally in software, firmware, netlist, and EDA tooling** from **what remains to be completed in physical routing, bench bring-up, and vehicle validation**.

---

## 1. Local Automated Verification Ledger (Completed & Passing)

| Verification Gate | Command / Artifact | Result | Evidence & Scope |
| :--- | :--- | :--- | :--- |
| **1. Schematic-to-Firmware-to-Pinout Cross-Check (`verify_io_map.py`)** | `python3 scripts/verify_io_map.py` | **PASS (0 errors)** | Verifies 1-to-1 electrical continuity across all **70 external TE AMPSEAL connector pins** (`J1-1..35`, `J2-1..35` in [`io-map.csv`](file:///home/halbritt/git/fome-mc/io-map.csv)), **22 internal buses** (`CAN2`, `WBO1/2_NRST/BOOT0/SEL` on `PD4..PD7`, `SDMMC1` 4-bit `U25`, `SPI4` `U29` `ATWINC1500-MR210UB` Wi-Fi on `PE2..PE6 + PC13`, `BARO_I2C` `U24`, `PWR_KEEPALIVE` including `12V_IGN_SW`, `12V_MR`, `12V_RAW`, `MAIN_RLY`, `Perm_Live`), **510 netlist components** (`494` populated in BOM/CPL with 100% LCSC coverage after excluding `16` DNP footprints `BT1`, `D201..D204`, `J8`, `J9`, `J11..J16`, `JP1`, `JP2`, `U24`, plus `4× M4` mounting holes `H1..H4` = `514` total board footprints; `0` unannotated, `0` duplicate designators in [`export/fome-mc.net`](file:///home/halbritt/git/fome-mc/export/fome-mc.net)), and **34 TunerStudio YAML definitions + `board_configuration.cpp`**. |
| **2. Electrical Rules Check (`make erc`, `FOMEMC-20`, `FOMEMC-25`), Design Rules Check (`make drc`, `FOMEMC-18`, `FOMEMC-19`, `FOMEMC-26`, `FOMEMC-27`), Export (`make export`, `FOMEMC-21`) & Full Analysis (`make analyze`)** | `make erc`, `make drc`, `make netlist`, `make export`, `make analyze` (`python3 toolchain/eda.py run --project fome-mc`) | **PASS (`0` ERC violations (`0` errors, `0` warnings), `0` DRC violations (`0` errors, `0` warnings), `0` unconnected items, `0` parity errors, `0` starved thermals)** | Runs full KiCad 10 verification:<br>- **`erc`: PASS (`0` violations — `0` errors, `0` warnings, `FOMEMC-20`, `FOMEMC-25`)** across all 21 schematic sheets (`U13, U14` `MAX9924UAUB+` in Mode A2; `VBAT` `4 KB BKPSRAM` keep-alive with `PC14/PC15` `no_connect`)<br>- **`drc`: PASS (`0` violations — `0` errors, `0` warnings, `0` `unconnected_items`, `0` `schematic_parity`, `0` `starved_thermal` with `min_resolved_spokes: 2`, `0` `silk_overlap`, `0` `track_dangling`, `0` `via_dangling`, `0` `lib_footprint_issues`, `HV_IGN` `0.50 mm` clearance across all 4 copper layers `F.Cu`, `In1.Cu`, `In2.Cu`, `B.Cu`, wide `>= 1.50 mm` `< 0.05 Ω` `/WBO1_H-` & `/WBO2_H-` copper buses, and `4× M4` `Ø 4.3 mm` NPTH corner mounting holes `H1..H4`, `FOMEMC-26`, `FOMEMC-27`)**<br>- **`netlist`: PASS** (`510` schematic components, `494` populated on board after excluding `16` DNP footprints, `0` missing from netlist)<br>- **`analyze`: PASS** (`routing_complete: true` across all populated footprints and nets)<br>- **`export`: PASS** (21-page schematic PDF, 21 SVGs, 6 PCB PDFs, normalized KiBot Gerbers `F.Cu/In1.Cu/In2.Cu/B.Cu/Edge.Cuts`, Excellon drills, position files, BOM CSV/HTML, and `reports/toolchain/fab-manifest.json`). |
| **3. FOME `fome-mc` Bootloader + Firmware + TunerStudio `.ini` Build** | `bash compile_fome-mc.sh` in `/home/halbritt/git/fome-fw/firmware/config/boards/fome-mc` | **PASS (0 errors)** | Compiles with `USE_WIFI = yes` (`wifi_console.cpp` TCP port 29000 + `http_file_server.cpp` HTTP port 80 SD log server) and `sd_log_ring_buffer.h`:<br>- OpenBLT bootloader: `blbuild/fome_bl.elf`<br>- Application ELF: `build/fome.elf`<br>- Combined binary: `deliver/fome.bin` + `fome_bl.srec` + `fome_update.srec`<br>- TunerStudio definition: `tunerstudio/generated/fome_fome-mc.ini`. |
| **4. Host Unit Tests for Upstream FOME Bug Fixes, SV650 Odd-Fire Dual-Plug Ignition, SD Ring-Buffer Cleanup & `CAN1` IMU RX (`FOMEMC-3`, `FOMEMC-4`)** | `./build/fome_test --gtest_filter="BufferedWriter.*:ignition.*:OddFireRunningMode.hd:pairedOddFireWastedSpark.*:SdLogRingBuffer.*:can_imu.*"` in `/home/halbritt/git/fome-fw/unit_tests` | **PASS (All tests passing)** | Verifies:<br>- `trailingSpark` (rotary/twin primary + trailing split)<br>- `trailingSparkTwoCylinderOddFireSV650` (90° V-twin `270°/450°` odd-fire primary + trailing scheduling across cranking and running)<br>- `trailingSparkOverdwellProtection` (verifies `trailingCoils` forced LOW on overdwell / engine stall)<br>- `OddFireRunningMode.hd` & `pairedOddFireWastedSpark.*`<br>- `SdLogRingBuffer.*` (4/4 tests for oldest `.mlg`/`.teeth` selection and threshold logic)<br>- `can_imu.*` (Bosch `MM5.10` `0x174/0x178/0x17C` CAN RX decoding into `accelerometer.{lat,lon,vert,yawRate,rollRate}`). |
| **5. BOM, Placement & Fab Package Export (`BOM-fome-mc.csv`, `CPL-fome-mc.csv` & `fab-manifest.json`, `FOMEMC-21`, `FOMEMC-24`)** | [`export/BOM-fome-mc.csv`](file:///home/halbritt/git/fome-mc/export/BOM-fome-mc.csv), [`export/CPL-fome-mc.csv`](file:///home/halbritt/git/fome-mc/export/CPL-fome-mc.csv) & [`reports/toolchain/fab-manifest.json`](file:///home/halbritt/git/fome-mc/reports/toolchain/fab-manifest.json) | **PASS (`510` schematic parts / `494` populated in BOM & CPL across `102` BOM lines)** | All `494` populated components (`510` schematic components minus `16` DNP footprints `BT1`, `D201..D204`, `J8`, `J9`, `J11..J16`, `JP1`, `JP2`, `U24`; plus `4× M4` mounting holes `H1..H4` = `514` total board footprints — including `C1/C6` `EEHZC1H470P` `C454346`, `C4` `GCJ32ER71H475KA12L` `C417122`, `C2/C5/C7` `GCJ21BR71H105KA01L` `C354368`, `10 nF 50V X7R 0603` `GCJ188R71H103KA01D` `C344025`, `100 nF 50V X7R 0603` `GCJ188R71H104KA12D` `C161115`, `C12/C111` `CL10A106MA8NRNC` `10 µF 25V X5R 0603` `C96446`, `C113` `C19666`, `U25` `CSNP32GCR01-AOW` `C2841139`, `U29` `ATWINC1500-MR210UB` `C1558703`, `U1003/U1103/U1203` `74HCT125D` `C5947`, `R7/R8` `10 Ω` `C22859`, `R9/R10` `120 Ω` `C22787`, `R219` `1.5k` `C22843`, and `U13, U14` `MAX9924UAUB+` `C143633`) have 100% LCSC coverage, 1-to-1 `(value, package) -> LCSC` mapping (`export/BOM-fome-mc.csv`), and exact 1-to-1 reference parity with `export/CPL-fome-mc.csv` (`FOMEMC-24`). |

---

## 2. Closed Reviewer Engineering Decisions & Verification Evidence

| Engineering Domain | Decision Implemented in `fome-mc` | Source Code / Datasheet / Schematic Evidence |
| :--- | :--- | :--- |
| **1. Barometric Sensing (`FOMEMC-1`)** | - **Default**: External automotive 1-bar sensor **GM `12614970` / Delphi `PS10150`** (`MT_GM_1_BAR`, `10–105 kPa`, `0.0–5.0V`) on **`J2-6` (`AV3_BARO_MAP2` `PA2` / `EFI_ADC_2`)**, powered by `J1-29` (`5V_SENSOR_1`) and `J1-31` (`GND`), enabling single-pour flood potting without a chimney dam or ePTFE lid vent.<br>- **Optional Unpotted Bench Sensor**: Onboard `LPS25HBTR` (`U24`, `C87898` on `I2C2` `PB10/PB11`, DNP on potted builds; `lps25BaroSensorScl/Sda = Gpio::Unassigned` by default).<br>- **Fallback**: Pre-cranking MAP baro (`useFixedBaroCorrFromMap`) documented as single-shot boot capture (`storedInitialBaroPressure`, `60..110 kPa`). | - `fome-fw/firmware/config/boards/fome-mc/board_configuration.cpp` (`baroSensor.hwChannel = EFI_ADC_2; baroSensor.type = MT_GM_1_BAR; lps25BaroSensorScl/Sda = Gpio::Unassigned`)<br>- `fome-fw/firmware/init/sensor/init_map.cpp:62-63` (`MT_GM_1_BAR`: `0.0V = 10 kPa`, `5.0V = 105 kPa`)<br>- `fome-mc/fome-mc.kicad_pcb` (`U24` potting dam keep-out rings removed). |
| **2. Soldered Onboard Logging Storage (`FOMEMC-3`, `FOMEMC-19`)** | - Soldered **`CSNP32GCR01-AOW`** (`U25`, `C2841139`, 32 Gbit = **`4 GB` raw / `~3.72 GiB` usable FAT32/exFAT**, 394 in stock; pin-compatible with `MKDV32GCL-STH` `C5199868` and `XTSD32GLGEAG`) in `6 × 8 mm` LGA-8 (`ampseal:LGA-8_6x8mm_P1.25mm`) on 4-bit `SDMMC1` (`PC8..PC12, PD2`) with `47 kΩ` pull-ups on `CMD, DAT0..3`, `22 Ω` series resistor on `CLK`, and dedicated **`C113` (`4.7 µF` `0603` `C19666`) + `C114` (`100 nF` `0603` `C161115`)** local decoupling `< 2.0 mm` from Pin 4 (`VDD`, `FOMEMC-19`).<br>- Zero hardware `SD_CD` pin required.<br>- Records **`~160.5 hours` at `50 Hz`** (`~80.2 hours` at `100 Hz`, `~32.1 hours` at `250 Hz`) on 32 Gbit (4 GB) at `1,384 B/frame`.<br>- **Automatic Oldest-`.mlg` Ring-Buffer Pruning**: `ensureSdFreeSpace()` and `writeInternal()` in `sd_file_log.cpp` automatically prune the oldest `fome_*.mlg`/`.teeth` log files when free space drops below `64 MiB` or on disk-full. | - `fome-mc/sheets/mcu.kicad_sch` (`U25` `CSNP32GCR01-AOW` `C2841139` connected to `SD_D0..3, SD_CLK, SD_CMD` with `C113`/`C114` local decoupling)<br>- `fome-fw/firmware/hw_layer/mmc_card_attach.cpp:88-104` (`sdcConnect(&SDCD1)` uses 4-bit `SDMMC1` with no `SD_CD` GPIO)<br>- `fome-fw/firmware/console/binary_log/sd_file_log.cpp` (`ensureSdFreeSpace()`, `deleteOldestLogFile()`, `F_SYNC_PERIOD_SEC = 2`). |
| **3. Wireless Wi-Fi Tuning, HTTP Log Server (`FOMEMC-2`, `FOMEMC-18`) & Post-Potting Recovery** | - **Onboard `ATWINC1500-MR210UB` (U.FL) Wi-Fi (`U29`, `C1558703`)**: Connected on `SPI4` (`PE2=SCK`, `PE5=MISO`, `PE6=MOSI`, `PE4=CS`, `PE3=IRQ`, `PC13=RESET_N`) with `USE_WIFI = yes`, serving wireless TunerStudio (`TCP port 29000`) and built-in HTTP web server (`HTTP port 80`) for `.mlg`/`.zip` log downloads. Footprint corrected to Microchip `DS70005304F` `Figure 2-2` & `Figure 10-1` (`14.73 × 21.72 mm`, `1.9 × 0.8 mm` / `0.8 × 1.9 mm` pads at `1.016 mm` pitch, `3.7 × 3.7 mm` `Pad 29` GND paddle with 2×2 thermal/GND vias) and decoupled by **`C111` (`10 µF` 25V X5R `0603` `C96446`)** + **`C112` (`10 nF` 50 V X7R `0603` `C344025`)** `< 2 mm` from Pin 24 (`1P3V_TP`, `FOMEMC-18`).<br>- **Single-Owner `FatFs` / `USBMSD1` Handoff**: Fixed upstream dual-mount concurrency bug so `FatFs` and `USBMSD1` never mount `SDCD1` simultaneously.<br>- **Post-Potting Recovery**: `J1-35` (`USB_VBUS_BOOT0` `+5V` VBUS / `+12V` `D210 = BZT52C6V8` Zener + `R209 = 12 kΩ` `BOOT0` override) + `J2-34/35` (`USB_D+/D-`) + `J2-28/29` (`CAN1`) for `STM32H753`; `PD4..PD7` (`WBO1/2_NRST` & `WBO1/2_BOOT0`) for sequential single-node OpenBLT flashing of both `STM32F042K6T6` wideband MCUs over internal `CAN2`. | - `fome-mc/sheets/mcu.kicad_sch` & `libs/footprints/ampseal.pretty/ATWINC1500-MR210UB.kicad_mod` (`U29` `ATWINC1500-MR210UB` `C1558703` on `PE2..PE6, PC13` + `C111/C112` on Pin 24; `WBO1/2_NRST/BOOT0` on `PD4..PD7`)<br>- `fome-fw/firmware/config/boards/fome-mc/board.mk` (`USE_WIFI = yes`) & `board_configuration.cpp`<br>- `fome-fw/firmware/hw_layer/atwinc1500/wifi_console.cpp` & `http_file_server.cpp`<br>- `fome-fw/firmware/hw_layer/mmc_card_mount.cpp:69-101, 179-203` & `sd_file_log.cpp:200-217`. |
| **4. Encapsulation & Enclosure (`FOMEMC-1`, `FOMEMC-27`)** | - Acrylic conformal base coat (`Electrolube HPA` / `Humiseal 1B31`) + single-pour soft thermally conductive 2-part polyurethane flood potting (`Electrolube UR5634` / `MG Chemicals 832TC`, `Shore A 55–65`, `k ≥ 0.85 W/m·K`, `Tg < -40 °C`) inside a single-ended unvented aluminum enclosure (`166 × 120 × 32 mm`), secured via **4× `M4` (`Ø 4.3 mm` NPTH) corner mounting holes `H1..H4`** at `(30.0, 29.0)`, `(184.0, 29.0)`, `(30.0, 136.0)`, and `(184.0, 136.0)` (`154.0 × 107.0 mm` centers, `FOMEMC-27`), with `Dow Dowsil 3145` perimeter sealing around `U29` RF shield and U.FL collar. | - [`docs/DESIGN.md` Section 7.2 & 7.6](file:///home/halbritt/git/fome-mc/docs/DESIGN.md) & [`docs/POTTING_AND_ENCLOSURE.md`](file:///home/halbritt/git/fome-mc/docs/POTTING_AND_ENCLOSURE.md) (`10.44 W` continuous / `12.74 W` peak thermal budget, `H1..H4` mounting hole coordinates, CTE stress analysis, and pre-/post-potting test gates). |
| **5. `CAN1` Motorsport Telemetry Pod & RaceChrono Pro Integration (`FOMEMC-4`)** | - **`50 Hz` (`20 ms`) `FOME_CAN_verbose.dbc` Broadcast (`0x200..0x207`)**: Configurable `canWritePeriodMs` (default `20 ms` on `fome-mc`) transmits `RPM`, `TPS`, `MAP`, `CLT`, `IAT`, `Lambda1/2`, `VSS`, `Gear`, `VBatt`, and `FuelUsed` on `CAN1` (`J2-28/29`, `500 kbps`).<br>- **Bosch `MM5.10` 5-Axis IMU CAN RX (`0x174`, `0x178`, `0x17C`)**: Decodes `YawRate`, `RollRate`, `AccX` (`lon`), `AccY` (`lat`), and `AccZ` (`vert`) directly into `engine->sensors.accelerometer` for `.mlg` logging.<br>- **External Telemetry Pod Architecture**: Documented in [`docs/TELEMETRY_AND_RACECHRONO.md`](file:///home/halbritt/git/fome-mc/docs/TELEMETRY_AND_RACECHRONO.md) (`ESP32-S3` + `25 Hz` GPS + `BMI088`/`MM5.10` IMU + brake/suspension ADCs -> RaceChrono Pro BLE DIY + Insta360/DJI Action camera sync). | - `fome-fw/firmware/controllers/can/can_tx.cpp` (`canWritePeriodMs`) & `can_rx.cpp` (`processBoschMM5_10ImuFrame`, `IMU_MM5_10`)<br>- `fome-fw/firmware/config/boards/fome-mc/board_configuration.cpp` (`enableVerboseCanTx = true; canWritePeriodMs = 20; imuType = IMU_MM5_10;`)<br>- [`docs/TELEMETRY_AND_RACECHRONO.md`](file:///home/halbritt/git/fome-mc/docs/TELEMETRY_AND_RACECHRONO.md). |
| **6. Full 4-Layer PCB Synchronization, Copper Routing, Thermal/HV Hardening, Mode A2 VR Conditioning, Wide WBO Heater Buses, M4 Mounting Holes, Per-Sheet Contracts, Reproducible Fab Package & Zero-ERC / Zero-DRC Closure (`FOMEMC-5`..`FOMEMC-27`)** | - **100% Schematic-to-PCB Parity (`510` schematic components, `494` populated in BOM/CPL with 100% LCSC coverage after excluding `16` DNP footprints, plus `4× M4` mounting holes `H1..H4` = `514` board footprints, `0` parity errors)**, **Zero Schematic ERC Violations (`0` errors, `0` warnings, `FOMEMC-20`, `FOMEMC-25`)**, and **100% Copper Routing with Zero DRC Violations (`0` errors, `0` warnings, `0` `unconnected_items`, `0` `starved_thermal` with `min_resolved_spokes: 2`, `0` `silk_overlap`, `0` dangling tracks/vias, `FOMEMC-26`, `FOMEMC-27`)** across all 4 copper layers (`F.Cu`, `In1.Cu` `GND`, `In2.Cu` `+5V/+3V3/GND`, `B.Cu`).<br>- **`FOMEMC-11` & `FOMEMC-12`**: Restored `min_resolved_spokes: 2` (`0` `starved_thermal`), enabled teardrops (`td_enabled: true`, `91` filled `padvia` teardrop zones), and widened `392` signal track segments from `0.127 mm` to `0.200–0.254 mm`.<br>- **`FOMEMC-13`..`FOMEMC-16`**: Added `3× 74HCT125D` (`U1003, U1103, U1203` `C5947`) `+5V` CMOS level buffers for `VNLD5090TR-E` low-side inputs (`FOMEMC-13`); populated `R219 = 1.5 kΩ` (`C22843`) on `/AV6` (`J2-8`) and `R212 = 2.2 kΩ` (`C22976`) on `/LS8` (`J1-13` Tachometer, `FOMEMC-14`); upgraded `C12` to `10 µF 25 V X5R 0603` (`CL10A106MA8NRNC` `C96446`) on `+5V` and added `PWR_FLAG` on `5V_SENSOR_SUPPLY` (`FOMEMC-15`); enforced `>= 1.20 mm` `F.Cu` collector keepouts on `Q201..Q204`, widened `/IGN1_COIL../IGN4_COIL` to `1.20 mm`, and added `F.Cu`/`B.Cu` copper heat-spreader zones on `Q301/Q401` (`/WBO1_H-`, `/WBO2_H-`, `FOMEMC-16`).<br>- **`FOMEMC-17`**: Upgraded `C4` to `4.7 µF 50 V X7R 1210` (`GCJ32ER71H475KA12L` `C417122`), `C2/C5/C7` to `1 µF 50 V X7R 0805` (`GCJ21BR71H105KA01L` `C354368`), `C8` to `10 nF 50 V X7R 0603` (`GCJ188R71H103KA01D` `C344025`), and `C10` to `100 nF 50 V X7R 0603` (`GCJ188R71H104KA12D` `C161115`); marked `D201..D204` (`B340A-13-F` `C64982` on `INJ1..4`) **DNP** for fast `~0.83 ms` `42 V` internal active Zener demagnetization (`D205..D209` populated); reconciled `U3` (`LMR16020PDDAR`) `4.30 V` minimum operating `VIN` (`V_BATT ≈ 4.8 V` steady-state guaranteed floor; Pin 2 `VIN` & Pin 3 `EN` tied to `/VBOOST`, `R3 = 10 kΩ` on Pin 4 `RT`, `R5 = 12 kΩ / R6 = 68 kΩ` on Pin 5 `FB` for `5.00 V`).<br>- **`FOMEMC-18` & `FOMEMC-19`**: Updated `U29` (`ATWINC1500-MR210UB`) footprint to Microchip `DS70005304F` (`14.73 × 21.72 mm`, `Pad 29` `3.7 × 3.7 mm` GND paddle + 2×2 vias) with `C111` (`10 µF` `C96446`) & `C112` (`10 nF` `C344025`) on Pin 24 (`1P3V_TP`); added dedicated `HV_IGN` netclass (`0.50 mm` min copper clearance, `1.20 mm` width across all 4 layers) for `/IGN1_COIL../IGN4_COIL`; added `C113` (`4.7 µF` `C19666`) & `C114` (`100 nF` `C161115`) `< 2.0 mm` from `U25` Pin 4 (`VDD`).<br>- **`FOMEMC-21`..`FOMEMC-24`**: Added reproducible fab package generator (`scripts/generate_fab_package.py`, `export/gerbers/`, `reports/toolchain/fab-manifest.json`, `FOMEMC-21`), machine-checked per-sheet boundary contracts (`contracts/*.interface.json`, `docs/SHEET_CONTRACTS.md`, `FOMEMC-22`), full documentation/netlist/BOM reconciliation (`FOMEMC-23`), and 100% BOM/CPL parity (`scripts/export_bom_cpl.py`, `494` populated components, `102` BOM lines, `FOMEMC-24`).<br>- **`FOMEMC-25` (`MAX9924UAUB+` Mode A2 & `VBAT` `4 KB BKPSRAM` Keep-Alive)**: Wired `U13, U14` (`MAX9924UAUB+`, `LCSC C143633` in `sheets/triggers.kicad_sch`) in **Mode A2 (Internal Adaptive Peak Threshold + Internal Bias + Zero-Crossing Watchdog Enabled)** per `MAX9924` Table 1 (p. 12), Bias Reference (p. 13), and Fig. 3 (p. 15) (`Pin 6 ZERO_EN = GND`, `Pin 9 INT_THRS = GND`, `Pin 4 BIAS = GND` switching in internal `2.5 V` `VCC/2` bias reference to bias `IN+`/`IN-` via `R35..R38 = 10 kΩ`, `Pin 8 EXT = NC`, and `C38, C39 = 100 nF 0603` `C161115` `< 2 mm` from `Pin 10 VCC = /5V_SENSOR_1` in parallel with `C109, C110`). Documented that `PC14/OSC32_IN` and `PC15/OSC32_OUT` on `U26` are `no_connect` (no LSE crystal populated; `U28` removed), so `VBAT` (`U41` `MIC5205-3.3YM5` + `D16/D17/D211` `B5819W` + `BT1` `CR2032`) powers the `4 KB BKPSRAM` and 32 backup registers (`RTC_BKPxR`) across battery disconnects.<br>- **`FOMEMC-26` & `FOMEMC-27`**: Routed `/WBO1_H-` (`Q301` Pad 2 -> `J1-23`) and `/WBO2_H-` (`Q401` Pad 2 -> `J1-25`) with wide (`>= 1.50 mm`) low-resistance copper buses (`< 0.05 Ω` trace resistance/ch, `< 0.13 W` at `1.6 A RMS`, `< 0.45 W` at `3.0 A` cold-start peak); added `4× M4` (`Ø 4.3 mm` NPTH) corner mounting holes `H1..H4` at `(30.0, 29.0)`, `(184.0, 29.0)`, `(30.0, 136.0)`, `(184.0, 136.0)` (`154.0 × 107.0 mm` centers); resolved all silkscreen overlaps (`C1203`/`U1203` and custom field visibility on `F.SilkS`) for **`0` DRC errors and `0` DRC warnings**. | - [`fome-mc.kicad_pcb`](file:///home/halbritt/git/fome-mc/fome-mc.kicad_pcb), [`fome-mc.kicad_pro`](file:///home/halbritt/git/fome-mc/fome-mc.kicad_pro), [`sheets/triggers.kicad_sch`](file:///home/halbritt/git/fome-mc/sheets/triggers.kicad_sch), [`export/BOM-fome-mc.csv`](file:///home/halbritt/git/fome-mc/export/BOM-fome-mc.csv), [`export/CPL-fome-mc.csv`](file:///home/halbritt/git/fome-mc/export/CPL-fome-mc.csv), and [`reports/toolchain/fab-manifest.json`](file:///home/halbritt/git/fome-mc/reports/toolchain/fab-manifest.json). |

---

## 3. Open Physical & Bench Validation Items (Not Yet Claimed)

Per repository rules, implemented and locally verified claims are reported separately from physical hardware bring-up:

1. **Physical Bench Bring-Up & Thermal Soak**:
   - Bench verification of `D20/D21` (`12V_IGN_SW` / `12V_MR`) diode-OR handoff, `MAIN_RLY` (`J1-14`) low-side hold, `VBAT` `4 KB BKPSRAM` & backup register retention across battery disconnects (`U41` `MIC5205-3.3YM5` + `BT1` `CR2032`), `LMR16020PDDAR` `+5V` (`5.00 V` regulated above `5.5 V` via `R5 = 12 kΩ / R6 = 68 kΩ`, Pin 2 `VIN` & Pin 3 `EN` tied to `/VBOOST`, `R3 = 10 kΩ` on Pin 4 `RT`, low-dropout pass-through as `VIN` approaches `5.0 V`) and `TLV75733PDBVR` `+3.3V` regulation down to `U3`'s `4.30 V` minimum operating `VIN` (**`V_BATT ≈ 4.8 V` steady-state guaranteed floor**, with `C1/C6` riding through sub-millisecond cranking dips), `5V_SENSOR_1/2` tracking accuracy, `5V_SENSE_DIVIDED` (`U26.50` / `PF12`) ratiometric compensation against fixed `3.30 V` `VREF+` (`U23`), `U13, U14` (`MAX9924UAUB+`) Mode A2 adaptive VR conditioning (`2.5 V` internal `BIAS` reference + `85 ms` zero-crossing watchdog), `INJ1..4` `42 V` internal active Zener clamp (`~0.83 ms` turn-off with `D201..D204` DNP), dual `LSU 4.9` closed-loop `Pump` / `Nernst` / `Heater` regulation (`< 0.05 Ω` `/WBO1_H-` & `/WBO2_H-` copper buses), external `MT_GM_1_BAR` barometric step response on `J2-6` (`PA2`), `ATWINC1500-MR210UB` (`U29`) Wi-Fi TCP/HTTP throughput, and `10.44 W` thermal soak.
2. **2007 Suzuki SV650 (K7) Vehicle Integration & Dyno/Road Tuning**:
   - Verification of `24-2` crank VR waveform + `VVT_MAP_V_TWIN` camless phase lock on the K7 engine, `DRV8825` `ISC` idle speed control (`0.77 A` chopper limit), `TLE9201SG` `STVA` secondary throttle control, `7800-baud` single-wire `DASH_TECH` coolant/FI cluster frames, `CAN1` 50 Hz telemetry pod + Bosch `MM5.10` IMU logging, and primary + trailing spark advance sweeps.
