halbritt/fome-mc/telemetry-pod/expansion/agentee-494-j2/RESULT.md

**AGENT-DRAFTED CORRECTION applying owner direction: [agent-507 record, corrected by agent-535](OWNER-CORRECTION.md). Owner quotes remain owner quotes; engineering limits and assembly prose are agent-drafted. Keep 132134 with the Amphenol published pattern; SMT CANCELLED; Molex paper-unfit WITHDRAWN; enclosure-design gates REMOVED.**

F8 relocation: the superseded centre-2.0 / ground-2.4 enlarged-hole footprint moved byte-for-byte to [`historical-superseded/SUPERSEDED-DO-NOT-USE_SMA_Amphenol_132134_494_Conditional.kicad_mod`](historical-superseded/SUPERSEDED-DO-NOT-USE_SMA_Amphenol_132134_494_Conditional.kicad_mod), outside the selectable `Agentee494.pretty` library. Use only the Manufacturer footprint with the Amphenol published pattern. Historical native evidence (`native494.json`, 494b `analysis/*`) retains its original observed content; [`native494.NOTE.md`](native494.NOTE.md) labels the pre-F8 Conditional measurement. The current `native494.py` helper loads only the Manufacturer footprint.

Current correction by agent-535: **PARTIAL writer input, pending ONE same-Fable HIGH 10-minute delta arranged by agent-530.** The footprint `Agentee494.pretty/SMA_Amphenol_132134_Manufacturer.kicad_mod` and `pad-map.json` bind to [`132134-revC.pdf`](132134-revC.pdf), SHA256 `1ec1d365bf5bf9e1598cf7cf2c90747ba11f06607f4c6a28ca6d30a0aab56034`, primary source https://www.amphenolrf.com/en-us/assets/file/4065789557/, Amphenol RF 132134 Rev C sheet 3, **PCB MOUNTING HOLES**. The printed callouts are verbatim: **"1,5 [.059]"** centre, **"4- 1,7 [.067]"** ground, **"5,08 [.200]"** square. Diameter symbols accompany the hole callouts. These are the manufacturer's dimensions. Agent-519's all-five-1.7 over-read was explicitly corrected by `de8f30ed-ea69-4eb3-93ff-ed53bfe1c8e1@1`.

`stock-pad-comparison.json` proves all geometry identical to stock and reviewed `8756e38`; only footprint name/Value and hidden Datasheet text differ from stock. The centre is drill 1.5 / copper 2.05; four grounds are drill 1.7 / copper 2.25 at (±2.54,±2.54). All are circular PTH pads on `*.Cu`/`*.Mask`. Reuse unchanged native geometry evidence; no new native suite for wording or hidden metadata. H5 attribution is corrected; SMT ranking CANCELLED; Molex paper-unfit WITHDRAWN with the owner fit ruling retained, without a measured-fit claim; F3/F4 bulkhead/pigtail are OUT OF SCOPE and enclosure gates REMOVED. The exact current writer contract is `board-side-correction.json`: final-pose/J2 UUID and both RF-area rebinds remain writer duties. Actual 105°C suitability and active-antenna DC checks remain.

Writer 489 follow-up: **add 132134-revC to canonical-parts acquisition via its producer** with the adopted J2 binding. `agent_ee.datasheet_capture --import-historical` creates a new offline acquisition; there is no append command for the existing canonical acquisition manifest. The existing `bindings_sha256` must be regenerated by its producer after actual source adoption. This slice does not hand-edit it. The retained package PDF already supplies the source evidence and does not block this PARTIAL delivery.

The inherited narrative below is HISTORICAL / SUPERSEDED where it conflicts with the correction. Current board-side writer inputs are in `../agentee-494-j2/board-side-correction.json`; no historical SMT, bulkhead/pigtail, enclosure or paper-stack claim is an active recommendation or gate.

# AGENTEE-494 J2 joint and sealed interface

The agent-529 coordinator decision, relayed by agent-449 (class: agent-relayed, not owner-stated), selects Amphenol 132134. The proposed sealed-interface concept keeps it inside the enclosure and uses a compatible sealed SMA bulkhead cable assembly. The candidate 095-902-570-006 orientation and dimensions remain UNRESOLVED/unsourced without a retained source capture. The stock holes do not establish a worst-case insertion guarantee. This packet supplies the original pattern, a conditional enlarged-hole footprint and writer recipes. Complete joint, packing, RF and enclosure acceptance remain open for the specific evidence listed below.

The frozen base is `f6c7ec25e4f1bcd5411c376f3db970bbd2d31650`. REQUIREMENTS.md hashes to `dd6555f706d163709bccb3417d8c366c38de7d603fca8894d0c4a95a58928208`. Agent-449 integrates and arranges the single 15-minute Fable review; this branch is not merged.

## Joint budget and footprint

`joint-budget.json` contains all assumptions and equations. The retained [132134 rev C drawing](https://www.amphenolrf.com/en-us/assets/file/4065789557/) controls the part dimensions; its retained PDF hash is `1ec1d365bf5bf9e1598cf7cf2c90747ba11f06607f4c6a28ca6d30a0aab56034`. [JLCPCB's capability](https://jlcpcb.com/capabilities/pcb-capabilities/) gives finished holes +0.13/−0.08 mm, position ±0.075 mm and board thickness 1.44–1.76 mm. The budget conservatively treats position as ±0.075 per axis.

The signal pin maximum is 1.37 mm. A conservative square ground-pin side is 1.17 mm, inferred from the independently toleranced outer and inner spans, giving a 1.6546 mm circumscribed diameter. Applying ±0.10 mm per axis from the mounting pattern as a **physical pin-location bound is conditional**: the drawing does not separately specify true position about the signal pin. The combined radial displacement is 0.24749 mm.

| Pattern | Signal hole / pad OD | Ground hole / pad OD | Signal insertion margin | Ground insertion margin |
|---|---:|---:|---:|---:|
| Manufacturer holes / KiCad pads | 1.5 / 2.05 | 1.7 / 2.25 | −0.22249 | −0.26480 |
| Historical superseded proposal (DO NOT USE) | 2.0 / 2.8 | 2.4 / 3.2 | +0.02751 | +0.08520 |

All values are mm. The Manufacturer file remains in `Agentee494.pretty`; the superseded conditional file is historical-only at `historical-superseded/SUPERSEDED-DO-NOT-USE_SMA_Amphenol_132134_494_Conditional.kicad_mod`. Hole centres remain (0,0) for pad 1 and (±2.54,±2.54) for four pad 2 objects. `pad-map.json` binds pad 1 to `/POD_GNSS_RF`, all pad 2 objects to `/GND`, and preserves canonical J2 UUID `18c6ebf4-5f6a-5227-b278-be0fa33a91c9`. F(103,40,0) is a candidate in the proposed 110×80 lineage frame only. The frozen saved board is 90×65 at origin; its old Molex pad 1 is (86.96,28), corresponding to lineage (106.96,40). For only those two J2 RF-pad point correspondences, `saved = lineage + (−20,−12)` gives the saved-frame candidate (83,28,F0). This is not a transformation for other saved geometry. This correspondence does not change the saved outline or establish final placement. `pad-map.json` and `RF-deltas.json` carry the full frame declaration.

The proposal has nominal 0.40 mm annuli; maximum-hole arithmetic leaves 0.335 mm, or 0.22893 mm after conservatively subtracting radial hole position again. Actual drill-to-copper registration and pad etch are not independently guaranteed by that general position figure. Larger holes also need a qualified solder-fill and retention process. Positive insertion arithmetic does not close those questions.

With zero seating lift, bare pins project 1.78–2.90 mm below B. Let seating lift be `sF` and B-side solder-filleting depth be `fB`: the soldered B reservation is `max(2.90−sF,fB)`. The F body is bounded by 7.2 mm square and `9.73+sF` mm above F. Neither maximum `sF` nor `fB` is published here; a finite soldered maximum is not claimed.

## Sealed SMA and assembly

The [095-902-570-006 part page](https://www.amphenolrf.com/en-us/part/095-902-570-006/9372/) and [drawing URL](https://www.amphenolrf.com/en-us/assets/file/4068761521/) remain lookup pointers. No captured PDF/HTML and sha256 for that part are retained. Browser extraction is not a captured source in this packet. Its reported right-angle (RA) plug orientation, 6-inch description, interface/hardware description and brochure orientation conflict are **UNRESOLVED/unsourced**. A compatible sealed SMA bulkhead remains the proposed concept, with only AMPSEAL and SMA wall penetrations; candidate adoption requires retained source evidence.

Each reported candidate dimension is **UNRESOLVED/unsourced**: 152.4 mm nominal length, ±6.35 mm tolerance, Ø6.60 mm mounting hole, 6.10 mm mounting-hole flat, 5.85 mm connector D-flat, and 8 mm / 11 mm wrench sizes. The derived 158.75 mm internal maximum and 341.25 mm external combined allocation are also **UNRESOLVED/unsourced**, because their inputs are uncaptured. The statement that an alleged 457 mm external cable fails that combined allocation is **UNRESOLVED/unsourced and withdrawn as an established limit**. The writer must consume none of those values, orientation or panel/tool recipes as sourced. `sealed-interface.json` retains them only as labelled unverified claims; consumable cable-bound fields are null.

The 341.25 mm combined allocation is an ENGINEERING PROPOSAL, not the owner rule. An external 457 mm cable does not violate the owner's external 500 mm rule merely because an internal pigtail exists. A 403 error body is not a source capture. The owner's ≤500 mm antenna-cable requirement remains sourced to frozen REQUIREMENTS.md line 70. This review fix adds no combined-path requirement. Exact cable lengths and path accounting still require binding. `reservations.json` now marks the affected mate and tool claims unresolved as well; panel thickness, seal compression, torque and installed ingress remain unqualified.

`manual-fit.json` proposes the REQUIREMENTS criterion 5 `not_assembled` deviation: J2 from DigiKey **ACX1230-ND / 132134** and cable assembly from Newark **25AK8098 / 095-902-570-006**. Exclude J2 from JLC assembly BOM/CPL while preserving its electrical membership; hand-fit before case installation. This names purchase sources without claiming JLC stock absence, current availability or placing an order. The canonical writer must implement and verify export handling.

## Verification and remaining evidence

`native494.json` records PASS for footprint loading and all five native pad sizes, drills and candidate pad bounds, through peecee-wsl `native-admit`, KiCad 10.0.7. It uses an ideal 110×80 rectangle. It proves no final saved Edge.Cuts clearance, DRC, connectivity, packing or joint qualification. No canonical board was loaded or saved. The 490 RESULT.md and verification record now explicitly disclose the same ideal-outline limitation for J3.

`RF-deltas.json` declares both frames and invalidates the old lineage (106.96,40) endpoint, which is (86.96,28) on the saved board, and end launch, PTH antipads, ground transitions and affected support/cable cutouts. Regenerate board areas `460352a8-dace-51a2-842b-c1e4ef7ad212` and `93d1ddf1-382d-5ed8-abfa-2bf617ad0cae` after dependent geometry changes. Preserve ordinary 0.293/0.2032 pending 492; no net-wide waiver or new stackup is introduced.

Material evidence still needed: physical pin-axis datum, actual hole/copper registration and etch, solder fill/retention and fillet maxima, complete mating-plane and tool solids, panel/O-ring stack and torque, strain relief and exact antenna length, then final saved-board launch/reference/packing checks and installed enclosure IP67 verification. These are concrete qualification gaps; the proposal is not ready for fabrication acceptance.

The initial engineering assessment at `58eac58f` used doctrine packet `pkt-86b8048d49bc089c`, hash `86b8048d49bc089c4ac5ff0c89b821562f5e6a1dbedd5a48e2db5f0f6e094d0f`; it applied authority boundaries, evidence before intervention, explicit invariants and repository precedence. `analysis/decision-receipt.json` abstains from complete admission. The validated corpus is `corpus-2026-07-12-a11702cc9217`, doctrine `doctrine-f6bbb5196a3f8bf9`, retriever `retriever-ec995ecdd083b2c8`; unmet obligations retain their materiality classifications. Its assembled evidence packet is historical at that head. The current receipt and typed evidence hashes are refreshed for the review disclosures; this mechanical provenance fix creates no new doctrine-backed qualification conclusion.

Review-fix verification: H1 relabels agent authority; H2 withdraws uncaptured candidate values as sourced inputs; H3 declares the lineage-to-saved frame. Engineering footprints, joint arithmetic, native probe output and canonical design are unchanged. The initial Fable engineering reproduction and fome gate PASS apply to the reviewed `58eac58f`; agent-449 arranges the delta review on this correction.

494b continuation: exact captured sources and the single SMT alternative are in `../agentee-494b-interface/RESULT.md`. The earlier uncaptured claims remain historical until explicitly superseded by that source-bound continuation.
