halbritt/fome-mc/telemetry-pod/expansion/agentee-486-mech-closure/RESULT.md

# AGENTEE-486 mechanical closure checkpoint

**Usable partial progress. Qualified packing admission and mechanical acceptance remain OPEN.** The source board is unchanged. This package supplies current part bindings, more height limits, explicit candidate anchors, transformed reservations and actual consumer results. It does not finish the mate, full tool/cable/hand volumes, installed case, or producer integration.

Source: exact Cairn `d6e3a168-b5ca-497e-8f3f-4cfcd24d293c@1`, under 529 decision39bfdc72 via519/449; full Plane AGENTEE-486 read. Start **2026-10-23T10:15:11Z**, deadline **11:15:11Z**; preparation end/elapsed in `task-clock.json`. Model/host: Codex gpt-6.1-sol on proximal. Agent-449 alone integrates and arranges the subsequent20-minute Astra-or-Fable HIGH independent verification; that review is **PENDING**.

## Frozen input and 480 disposition

The target is the **313-footprint** 484 design, reviewed at06245ad and now landed as **07ed909**. The PCB, schematic and309-part canonical manifest are byte-identical between those commits (`source-rebind.json`). PCB: `0b68a0ac4b3978b77faa497fd208b35a376c89d576f1b4e08b276966db997eac`. The four additional footprints are board-only H1–H4. Most ordinary parts, including U3, are staged outside the outline; this source is not a packed working board.

The 480 corrections **ad12e398 → 2a364102 → 28a09bb** were **folded into wt/agentee-486 by fast-forward**, including the cowl HEIGHT correction, verbatim owner quotes separate from interpretation, and exact inductor-datasheet confirmation. They are not separately landed by this agent. The486 branch started at28a09bb; current484 native inputs were read from the immutable landed Git objects into the local analysis cache. The branch's older root PCB is not the313-part input. Integration must apply this data onto the bound484 source and preserve the source-hash checks.

Owner files were read/copied only. Their original local paths/full SHA256 values are in `owner-inputs.json`; extracted local models are in `local-models.json`. **No vendor bytes, mesh, or STEP/PDF files are added by486.** Only derived numbers and methods are retained. Analysis helpers and inspection images remain local outside the repository.

## Closed/open matrix

| Item | Concrete checkpoint result | Remaining material work |
| --- | --- | --- |
| Current part identity | **CLOSED for canonical/native identity:** all313 UUID/ref/MPN/LCSC/footprint/datasheet bindings checked; C130–C133 bound to their actual parts. Native read matches serialized UUIDs, library IDs and poses. | Identity equality does not itself prove manufacturer land-pattern/body compatibility. |
| Height inputs | **272 sourced package-height upper bounds**,15 bare pad/hole/jumper features,26 UNKNOWNs. Exact source keys and grouping are in `part-heights.json`/`height-source-facts.json`. | Some rows have height only, with body XY still unknown. All assembled protrusion/tolerances remain unqualified. Unknown is never zero or PASS. |
| L1/L2 variants/models | Exact -150M/-6R8M datasheet rows/drawings retained; read-only FreeCAD bounds are within published dimension intervals after stated axis/seating transforms. | Generic STEP filenames do not identify electrical value. No all-pad overlay or assembled-model qualification. Use datasheet maxima, not smaller idealized model bounds. |
| Fixed anchor conflicts | **SELECTED:**110×80 candidate outline and four corner holes; J1-H3/H4 and all selected fixed courtyard-bound/washer pairs are disjoint in28 checks, minimum signed separation8.505mm. | This is conservative courtyard/hardware feasibility in the selected model, not complete connector/body/tool/case acceptance. Source producer must reify and check these anchors before packing. |
| U2 axes | Explicit F/0° candidate selection, board RH basis, vehicle Xforward/Yleft/Zup definition in `installed-axis.json`. | Final package-datum/axis mapping, native marked board and physical installation checks are required. F/XY are engineering choices, not permanent owner/manufacturer pose constraints. |
| U1 antenna and hardware | Source-native antenna exclusions transformed with all flags; four selected A2 washer bounds are disjoint from the transformed CAD exclusion. | Actual feed/radiator case mapping,3D housing/other metal/harness, installed RF qualification OPEN. CAD exclusion is not the manufacturer housing minimum. |
| J1 mate/harness/tool | Local header/plug BReps measured, exact source drawings read, nominal transform hypotheses and3 intersection tests retained in `J1-mate.json`. | **OPEN:** qualified35-contact/key/latch/stop transform, source/model dimension correspondence, selected wire/bend/strain-relief and full tool/latch sweep. |
| C21 soldering | Current pad UUID/size/orientation-bound chisel recipe; no old480 world polygons transferred. | **OPEN:** full hot barrel/taper/handpiece and solder-feed/hand volumes and final collision check. Owner's bench usage quote is not clearance evidence. |
| TP1–6 | Current UUID/face-bound normal tip recipe; no fixture/post-seal requirement. Actual face follows the eventual footprint, with bottom permitted. | 480's approach result was on08066170. No approach PASS is transferred to the staged313-part source; re-evaluate at final coordinates. |
| J3 card | Exact Hirose catalog stroke/nominal geometry captured; B90 outward-left candidate anchor retained. | Card/socket tolerances, thickness bound, selected hand/tool and enclosure opening/sweep remain OPEN. Historical15mm hand lane is not promoted to manufacturer evidence. |
| J2 SMA | Actual MPN732511150/LCSC C841205 rebound; right-edge mating direction retained. | **OPEN:** qualify1150 against1153-named footprint/model; exact mate/cable/bend/wrench data and sweep missing. The retained product sheet names SD-73251-115, but is not the dimensional drawing. |
| Full cowl stack | ~90mm **HEIGHT estimate**, not measured or a cap; length/width exceed90mm. | Floor/lid, supports, board, both-face assembled heights, J1/harness and J2/cable must form one installed datum/stack. No upper bound/headroom inferred from a known subset. Bench tools are not installed stack items. |
|479/485 consumption | Real479 policy parser accepts8 per-face selected hardware obstacles;3 malformed-policy controls reject. | **Full mechanical consumption/admission is not closed.** Height/Z/access/anchors need producer integration, and real native placement capture refuses source provenance as detailed below. |

The26 UNKNOWN body heights are **C1,C10,C100,C2,C3,C8,C9,D1,D100,D101,D102,D103,D104,D105,D2,D3,J2,L3,Q1,R100,U100,U21,U4,U9,J1,J3**. Bare-feature zero body does not imply zero solder/hardware/assembly protrusion.

Repeated RT0603BRD0710KL/C95204 parts have two retained manufacturer PDF hashes. The canonical/native binding remains per instance; the exact-MPN product sheet independently agrees with the family drawing at0.45±0.10mm. Both source identities are retained rather than silently substituting a hash or copying by reference. The C0G0603 upper bound0.92mm conservatively covers both published CF/CH thickness variants; no exact thickness-code selection is guessed.

## Selected anchor dispositions

`anchor-dispositions.json` is the operative selected assembly-model input: H1(4,4),H2(106,4),H3(106,76),H4(4,76); J1(55,70.5)F0; J2(105.24,40)F180; J3(8.9,40)B90; U1(55,6.5)F0; U2(15,15)F0; U3(80,29)F0. Units are mm/degrees.

110×80 is an **engineering design variable**, chosen to separate the wide J1/corner hardware and U1/top hardware. It is not a new owner/MFR outline limit or clearance margin. Current hardware and90×65 were not owner-frozen. Other supported choices remain possible with a recorded disposition and refreshed checks. Ordinary residual-component conflicts belong to479/485, not a hidden fixed-fixed penalty in a placement objective.

Six current footprint-owned rule areas are preserved and transformed (`transformed-footprint-rules.json`). Their exact source UUIDs/layers/forbid flags remain visible. Forty per-face hardware/probe/iron definitions are rebound (`reservations.json`); TP/JP geometry follows actual pad face/pose, and the JP chisel is a recipe rather than stale world vertices. No side change has been declared qualified. Side/rotation changes require fresh native side-aware transforms and matching evidence.

U3's F-over-In1 requirement remains mandatory. `gnss-reservation.json` is a **planning model**, using current313-part native pad identities and explicit selected U3/D3/L3/C42/J2 poses. C42 stays a bias bypass, not series RF. The proposed outline-relative In1 no-tracks plane must stay distinct from local In1/In2 no-tracks/no-vias RF protection. No path/fill result is passed from this planning model.

## Model and J1 evidence limits

L1 oriented model extents are **7.3×6.6×4.95mm** after moving the lowest terminal onto the selected seating plane; published intervals are7.3±0.3×6.6±0.3,H4.8±0.2. L2 extents are approximately **7.9×7.3×5.155mm**, within7.9±0.3×7.3±0.2,H5.2±0.2. No exterior-dimension mismatch was observed in those tests. Reservations retain **5.0/5.4mm** source maxima. U3's third-party model is12.2×16×2.6mm, at the package maximum rather than nominal2.4mm; it is not installed qualification.

The J1 header single-solid bound is76.9×32.1×37.8mm in its CAD frame. The plug main solid spans63.4×34.6×33.8mm. Compound-wide OCCT boxes are looser; per-solid bounds and methods are retained. The supplied plug drawing shows a common axial38.29±1.40mm; matching datums, included parts and revisions are not yet reconciled. That is an apparent difference requiring investigation, not a proved wrong part.

The proposed plug-to-header Y-axis180° flip with axial−9.4mm translation yields **398.012mm³** intersection. A−10.4mm translation yields1115.094mm³, and the alternative X-axis flip yields436.107mm³. These tests reject a claimed collision-free witness. They do not establish incompatibility: intended seal compression, materials/contents and proper stop/contact registration are not attributed. The transform remains an explicit hypothesis, **not a qualified mated transform**. Local mesh sections were inspected; no vendor mesh is committed.

## Actual source consumer refusal and phase boundary

`agent_ee.placement_probe.extract` from the479 worktree refused the same-byte source with:

`constraint provenance geometry inventory differs from saved project/rules`.

Re-derivation identifies **six native custom-rule entries** absent from the embedded geometry-emission inventory, including RF_50 width and fine-pitch/supervisor clearance rules (`consumer-source-refusal.json`). No project, rules, provenance or gate was changed to make this pass. The source owner must reconcile/re-emit this binding and recapture before qualified packing. Lowering limits or stripping provenance is not a remedy.

The separate real `_validate_policy` call accepts eight F/B selected hardware obstacles; malformed face, missing polygon and foreign fixed-ref controls reject. This is **partial data consumption**, not proof the complete new contract is wired into production. Full height/Z/access and actual anchor/outline integration remain material work. The native capture refusal is retained; no synthetic replacement capture is supplied.

Before packing: source/rule/part binding, supported transformed reservations, feasible anchors, installed-axis definition and access/height prerequisites must be qualified. **After routing:** actual saved F-only RF terminal connectivity and width, connected saved In1 GND reference, actual mask coverage and final electrical/native checks. Post-routing checks are not prerequisites invented for admitting a correctly defined placement, and none is marked passed early here. Manufacturing and installed seal/vibration/thermal/RF evidence remain separate.

## Verification and next work

- Read-only KiCad10.0.7:313 footprints and all source UUID/fpid/pose matches; unchanged PCB hash; six footprint rule areas. Nonfatal PROPERTY_ENUM load messages retained as a limitation, not suppressed design findings. No new ERC/DRC/route run.
- FreeCAD1.1.1:five valid local BRep loads and derived bounds; three J1 intersection diagnostics. No model declaration or board changed.
- Exact canonical/native part binding plus four identity negative controls; actual policy parser plus three malformed-input controls. Runtime/source hashes and input PDF identities accompany the data.
- Native-admit suite weight4/maxwait60, serial operations. Capacity refusals delayed reads, then admission succeeded. The initial observer used an unavailable API and failed; it was corrected before the successful source read. Full placement capture subsequently refused for a separate source-provenance issue. No live compute handles remain.
- No production code, board, routing, purchase/order, upload, cloud or new agent work. Rootkicad-route and the artifact tree must be clean after commit. No vendor bytes added.

479/485 need to consume the selected anchors/reservations against the bound source, repair the producer-owned provenance mismatch without relaxing rules, resolve the26 heights/body bounds and full assembled/tool/cable/mate/case terms, then run final transformed geometry/axis/access checks. Agent-449 must arrange the specified independent review of these changed inputs and limitations before adoption. A report or parser success alone is insufficient. `consumption-contract.json` keeps admission false and material unknowns explicit.

Doctrinal support is deliberately narrow: source authority, explicit invariants, preservation and evidence before intervention. `provenance/doctrine.json` names the packet/hash and generic unmet obligations; it does not supply PCB margins or physical acceptance.

Late notice ad85e320@1 received before the original checkpoint deadline: canonical REQUIREMENTS.md now carries the dated owner-relayed 90mm HEIGHT estimate, no cap or measurement task, and complete-stack fit uncertainty. U2 F-normal-UP is explicitly an engineering assembly assumption. F0 remains provisional: manufacturer package-axis composition and physical/native/silkscreen verification remain OPEN; captured rotation and XY do not grant authority. See late-notice-dispositions.json.
