halbritt/fome-mc/telemetry-pod/expansion/agentee-484-decoupling/RESULT.md

# AGENTEE-484: supply decoupling repaired in the canonical design source

Decision: agent-529, Plane AGENTEE-484 (relayed via 519). The Cairn id "5a480e66" in the brief is not a full UUID, so the record could not be fetched; the Plane issue text was used as the governing decision.

## Run record

**Clock:** started 2026-10-23T09:33:55Z, ended 2026-10-23T10:11:03Z, within the 60-minute checkpoint bound.

**Model and host:** Claude Opus 5.5 (`claude-opus-5-5`) on proximal.

**Inputs (frozen):** fome-mc `57810f11`, on worktree branch `wt/agentee-484-decoupling` (git-wt); the 478 prep data, relationship-bounds and retained datasheets.

**Runtime:** native-admit only.
- **Emitter:** agent-ee `f92d71c` on the host. It reproduces the previous storage-microsd `project/` byte for byte from the previous inputs.
- **Scope compiler:** agent-ee `ce127185`. It reproduces the previous `compiled/` byte for byte from the previous map.
- **Production steps:** run in the d96f8e00 image with agent-ee 7d5b0d4d (`run484.sh`).
  - This equals `production_run.sh` except for one option: **`--security-opt apparmor=unconfined`**.
  - The original script selects the removed `agent-ee-container` AppArmor profile whenever host AppArmor is enabled, and on proximal it is.
  - No profile was loaded, tested or proposed.
- **Checks:** native KiCad 10.0.7 ERC and the read-only pcbnew correspondence check.

No cloud, upload, purchase or order. No broad suite.

## Per-pin disposition (`dispositions.json` holds sources with sha256, pages and wording)

| Pin | Manufacturer requirement (retained source, page) | Disposition | Support / value | Block | Status |
|---|---|---|---|---|---|
| U2.8 VDD | LSM6DSO32 p53: "C1, C2 = 100 nF ceramic ... as near as possible to the supply pin"; p24 | REBIND | C38, 100 nF X7R 50 V | imu-support (fixed U2) | RESOLVED |
| U2.5 VDDIO | LSM6DSO32 p53 (second capacitor; separate pin, 1.67 mm away) | REBIND | C41, 100 nF | imu-support | RESOLVED |
| U3.23 VCC | NEO-M9N integration manual p81: "decoupling capacitor must be placed as close as possible" (no value given) | REBIND | C44, 1 uF X7R 16 V (value is engineering judgement) | gnss-receiver-support (fixed U3) | RESOLVED (value EJ) |
| U3.22 V_BCKP | integration manual p71: "If no backup supply voltage is available, connect the V_BCKP pin to VCC"; p90: 45 uA | **NO DEDICATED CAPACITOR.** C44 at adjacent pin 23 (1.1 mm, GND pin 24 adjacent) is local, not remote | C44 (shared, adjacent pin) | gnss-receiver-support | **PENDING-510** |
| U10.1 IN | TPS2553 p25: "100-nF bypass capacitor near the IN and GND pins" | REBIND | C43, 100 nF | gnss-antenna-supply | RESOLVED |
| U4.16 Vdd | MCP3208 p23: "A bypass capacitor value of 1 uF is recommended" | **ADD** | C130, 1 uF (part of C44) | adc | RESOLVED |
| U8.4 V+ | ADA4096-4: no decoupling wording in the retained datasheet text | **ADD** | C131, 100 nF (part of C38); value is topology plus engineering judgement | afe | RESOLVED (510: source gap) |
| U9.5 V+ | OPA320 p28: "Place 0.1-uF bypass capacitors close to the power-supply pins"; p16 | **ADD** | C132, 100 nF | sensor-ref | RESOLVED |
| U100.5 VIO | TJA1051 p13 Fig 6: the figure's capacitor labels are not extractable text; value not verified | **ADD** | C133, 100 nF (engineering judgement) | can | RESOLVED (510: check Fig 6) |
| U11.2 Vin | REF50xx p29: "supply bypass capacitor ranging from 1uF to 50uF for REF50xxI"; place as close as possible | REBIND | C18, 1 uF X7R 16 V on 6.3 V (low end after DC-bias derating; flagged) | supplies-5v | RESOLVED (derating flagged) |

**Existing bank duties preserved** (LMR36520 p18, Table 8-1):
- **U7 (3.3 V):** nominal and minimum COUT is 3 × 22 µF. C13–C15 alone meet it; C38, C41, C43 and C44 were never part of it.
- **U5 (6.3 V):** keeps C6/C7 at 2 × 22 µF, which matches the 5 V row. 6.3 V is not tabulated, so 510 should confirm. C18 is not part of the tabulated bank.

**No double counting:** each capacitor serves exactly one pin. The only exception is C44, shared by the adjacent U3 pins 22 and 23 (PENDING-510).

**New parts** reuse parts already in the design: TDK C76711 (100 nF) and C76706 (1 µF), with their existing LCSC records, CAD and bindings. Nothing new was selected, and nothing was purchased. Rebinds change the drawing group, the allocation and the relationships, **not the netlist**.

## Files changed (sha256)

The source and generator changes:

| File | sha256 | Change |
|---|---|---|
| `storage-microsd/inputs/intent.json` | c7c1eb52adcfa97a… | source: +4 components, +8 terminals on +3V3/GND |
| `storage-microsd/inputs/emitter-layout.json` | 89801cf2ebb07643… | source: drawing groups for 4 adds and 5 rebinds |
| `storage-microsd/project/telemetry-pod.kicad_sch` | 6395930bbb8bdbd0… | re-emitted |
| `storage-microsd/native.xml`, `erc.json`, `emission-receipt.json` | native.xml 757e01dcf6863cbd… | re-exported (ERC 0) |
| `requirements/rev3-microsd/requirement-map.json` | 1e5e8505c2296601… | source: subjects +C130–C133; counts 305→309, 309→313, 117→121; schematic sha |
| `requirements/rev3-microsd/compiled/` | scope 534b9223bae6d48f…, baseline 8020c370… | recompiled |
| `requirements/rev3-microsd/temperature-ratings.json` | regenerated | `--check` matches |
| `production-capture/build.py` | 00219d9ec62425c1… | generator: reads the additions source; count checks are 305 + additions |
| `production-capture/sources/decoupling-additions-agentee-484.json` | 0c4a435a5e877249… | NEW authored source |
| `production-capture/assembly/hand-fit-policy.json` | beb93b321a83dda8… | re-pins the J1 hand-fit citation to the regenerated parts.json (J1 still `/parts/303`) |
| `production-capture/retain.py` | cb0d2580aa0fb27e… | NEW retention dir `evidence/emission-7d5b0d4d-agentee484/` (the old one is unchanged and superseded) |
| `production-capture/composition/*` (12 generated files) and `reconstruction.json` | parts.json 2e9afa70a5547ed5…, assignments.json 3cacc210c78e2d70… | regenerated by build.py in the image |
| `storage-microsd/README.md`, `requirements/rev3-microsd/README.md` | — | notes |
| `agentee-478-prep/*` | see its SHA256SUMS | allocation v2, relationships, templates and validator on the new inventory |

## Regenerated design (through the existing production path)

- **Production steps (`logs/production-steps-summary.txt`):**
  - `build-out` exit 0, 309 references; CAD qualification complete, ratings 252 derived and 0 missing.
  - `build-check` exit 0 ("production capture reproduces byte for byte").
  - `pipeline` exit 0: **28 of 28 stages accepted**; emission 309 components, 235 nets.
  - `observe` exit 0.
  - A first attempt refused at `hand_fit_chain` (the J1 citation pinned the old parts.json hash). It was fixed in the source and rerun from commit `b296769a`; see `logs/production-steps-attempt1-summary.txt`.
- **Installed project** (`retain.py --install`, `--check` OK: 416 retained files, 8 installed project files):
  - `telemetry-pod/telemetry-pod.kicad_sch` **cef8e4c7f3b60e1afd434da171a0e431cead68f6df465d987a1e7118035a6d9c**;
  - `telemetry-pod/telemetry-pod.kicad_pcb` **0b68a0ac4b3978b77faa497fd208b35a376c89d576f1b4e08b276966db997eac** (313 footprints);
  - initial campaign candidate board `3b2b8359c0e057f9…` (prepared tree).
- **BOM / parts manifest:** `production-capture/composition/parts.json` (309 parts, `2e9afa70…`) and `assignments.json` are regenerated. The historical `complete-parts-manifest/` packet is unchanged; the additions enter through the new authored source.

## Native checks (`checks/`)

Inherited findings are separated by running every check on both the pre-repair emission (`2f1c9557` board) and the repaired one.

| Check | Pre-repair (inherited) | Repaired |
|---|---|---|
| ERC, all severities (`erc-old.json` / `erc-new.json`) | 0 violations | **0 violations** |
| Schematic ↔ board correspondence (`correspondence-*.json`): presence, footprint id, value and every pad net | 305 schematic / 309 board (H1–H4 board-only); 2 findings | 309 / 313 (H1–H4 board-only); **2 findings, both inherited and identical** |

The 2 inherited findings are on U3 pads 18 and 19, which are unconnected. The schematic names the nets `unconnected-(U3-SDA/~{SPI_CS}-Pad18)`; the board names them `…SDA{slash}~{SPI_CS}…`. This is net-name escaping only.

**No new finding.** C130–C133 are present with the correct footprint, value and +3V3/GND pads.

## Coverage on the new inventory

`agentee-478-prep/validate_coverage.py` → **PASS**:
```
footprints 313 (board 0b68a0ac), schematic_only 0, block members 297 in 26 blocks, fixed 10, shared 6,
unassigned 0, duplicates 0, failed checks: none; relationships 214 (3 UNRESOLVED: RF line, 474 C15)
```
A negative mutation (C130 removed, C131 duplicated) exits 1 and reports both.

**Membership changes:**
- **New blocks:** `imu-support` (C38, C41, fixed U2) and `gnss-receiver-support` (C44, fixed U3).
- **Moved:** C43 to `gnss-antenna-supply`; C18 to `supplies-5v`.
- **Added:** C130 to `adc`, C131 to `afe`, C132 to `sensor-ref`, C133 to `can`.
- **Removed:** the 10 decoupling-gap entries.
- **Relationships:** the 10 hf-decoupler relationships are bound at 3.0 mm supply leg, 3D, with provenance. Their old-board baselines read "exceeds" or "not-on-board". Final placement must satisfy them.

## Changed electrical scope for agent-510 (20-minute review)

1. **Netlist delta:** exactly 4 added 0603 capacitors, each between +3V3 and GND: C130 1 µF, C131/C132/C133 100 nF. No other net or part changed (verified by netlist diff).
2. **Rebinding (layout and relationship only):** C38→U2.8, C41→U2.5, C43→U10.1, C44→U3.23, C18→U11.2. The U7 bank keeps 3 × 22 µF per LMR36520 Table 8-1.
3. **For 510 to rule on:**
   - (a) U3.22 V_BCKP, no dedicated capacitor (**PENDING-510**);
   - (b) the U8 ADA4096 value, since its datasheet text has no wording;
   - (c) the U100 VIO value, since TJA1051 Fig 6 is a graphic;
   - (d) C18's 1 µF / 16 V derating at 6.3 V against the REF50 minimum of 1 µF;
   - (e) U5's 6.3 V output bank against Table 8-1 (6.3 V is not tabulated).

## Remaining, outside this checkpoint (none of it is a weakened acceptance)

- The runtime receipt (`evidence/production-runtime-j6b/receipt.json`, `runtime_receipt.py`) still binds the pre-repair retention `evidence/emission-7d5b0d4d/`. A new receipt for `emission-7d5b0d4d-agentee484` is a follow-up; `observe` ran (exit 0), but its observation is not retained here.
- `production_run.sh` still contains the AppArmor-profile selection. This run used `run484.sh` with `apparmor=unconfined`. Whether to change the committed script is a 449 decision.
- The R5 and ROUTE-3 placements predate the repair. The new relationships are measured only once a new placement exists (AGENTEE-479 and the regeneration).
