halbritt/fome-mc/telemetry-pod/expansion/agentee-474-constraints/RESULT.md

# AGENTEE-474 — sourced mechanical and side constraints

This is a constraint register for the next placement, not a placement or release approval. No design, rule, footprint, side, timer or routing input was changed. ROUTE-4 stays stopped.

**Binding:** frozen fome-mc `46c7c730141c956cd94970cc130cdea660e23e03`; the worktree starts at `fd9b3c404d117a4ba1f36d3d26f63ea52b018531`, whose only difference from that baseline is preserved ROUTE-4 evidence. Geometry is read from the retained **ROUTE-3** board `0806617082c33df6daaa00f5d9c6131e7e07ac6160aadc07a2b2bcb90b5ac651`. This does not adopt either routed candidate. Start: **2026-10-23T08:41:09Z**; end and elapsed time: `task-finish.json`. Limit: 30 minutes, ending no later than 09:11:09Z.

Assignment: Cairn `663fa616-3d8e-4ac1-80d9-e76e3fe08cf1@1`, agent-449 dispatch of AGENTEE-474, relaying coordinator-529 through 519. Parent AGENTEE-472 records the newer direct owner change request. Scope is existing evidence plus targeted retained primary-source checks. The earlier pause is superseded only for this bounded assignment; no general routing restart is inferred. Reply once to 449; 449 relays through 519 and alone integrates. No Plane writes were made.

## Findings that change how the next packing must be assessed

1. **Both faces are allowed.** `REQUIREMENTS.md:65` records the owner's 2026-10-19 permission. Neither equal side counts nor a front-only rule for ordinary passives follows from it. Actual ROUTE-3 counts are 286 F / 23 B, including the four mounting-hole footprints in F. Counts do not establish functional locality or underside access.
2. **The 0.5 mm courtyard-to-edge setting is an agent default.** It is distinct from copper-edge clearance, the 0.25 mm inter-courtyard gap, and J1's own provisional courtyard allowance. It was applied to the earlier run; this review neither changes it nor invents a replacement margin. Its unsourced status cannot prove that edge placement violates an owner/manufacturer limit.
3. **The recorded GNSS corridor is tied to obsolete coordinates.** D-PCB-6 names U3 RF at (77.5,29.1), while the exact ROUTE-3 U3.11 RF pad is (49.35,18.7514). The retained rectangle remains x76–88/y26.5–30.6. Existing `/POD_GNSS_RF` tracks include B.Cu and through vias outside that rectangle. Consequently, native compliance with that rectangle alone cannot establish the required F.Cu-over-In1 RF path. Reconcile the actual U3/L3/D3/J2 topology and its reference corridor **before accepting a new packed/routed candidate**. No RF repair or new polygon was made here.
4. **The antenna rectangle is captured CAD, not a proven manufacturer minimum.** D-PCB-16 calls it manufacturer geometry, but the later `captured-rule-areas.json` explicitly says otherwise. Espressif distinguishes outside-board placement, feed-point orientation, and a separate housing clearance recommendation. Preserve the existing area while its applicability is reconciled; do not derive a new symmetric board keepout from the housing recommendation.
5. **No source establishes the H1–H4 hardware envelopes.** The holes are real; screw heads, washers, standoffs, tightening tool lanes and their side/Z extents are UNKNOWN. A hole courtyard is not a screw or standoff model. Unknown enclosure/harness geometry remains a future deliverable under the recorded owner relay; it is not a blanket prohibition on exploratory candidate generation.

## How to read the register

Coordinates are board XY in mm, viewed from the front, with +Y toward the bottom. `F` and `B` mean the component faces. Bounding boxes are `[xmin,ymin,xmax,ymax]` of native courtyard polygons, not toleranced collision solids. Full polygons, exact pad/drill geometry, UUIDs and current allocation membership are in `native-geometry.json`; `geometry-summary.json` is the smaller anchor/test-access view. No 3D collision result is claimed.

Classes: **OWNER** = recorded owner requirement/quote; **OWNER-RELAY** = explicitly labelled agent relay, not owner-authored text; **MFR** = retained manufacturer drawing/catalog or published capability; **MECH-DERIVED** = geometry derived from a cited drawing or actual CAD; **AGENT** = chosen default, margin, historical pose or engineering policy. A mixed row labels the individual parts rather than promoting its whole contents to OWNER/MFR. **UNKNOWN** is not a zero dimension or a passed check.

`P` below means material to accepting a mechanically constrained packing on the affected region/face. `R` means installed/final-release qualification. A `P` unknown can remain explicit in a provisional exploratory candidate; it prevents claiming that particular requirement passed. It does not invent a hard exclusion or stop all generation. Source keys expand to exact repository locators below.

| ID / affected blocks and components | Actual geometry and face, or UNKNOWN | Class and exact provenance | Stage / disposition |
| --- | --- | --- | --- |
| C01 — all blocks, eligible ordinary components | F and B permitted; retain antenna, F-over-In1 GNSS reference and connector constraints. No numeric top/bottom quota. | OWNER, R:65, quote dated 2026-10-19. | P: derive eligibility from actual part/mechanical constraints; whole-block side changes require transformed courtyards, access and pin relationships. |
| C02 — outline / all blocks | Saved rectangle (0,0)–(90,65), 4 copper layers, 1.6 mm nominal. 90×65 is a pilot layout target, not measured cowl fit. Four corner holes required; exact outline sizing remains engineering. | OWNER for fit/four corners, R:65,125; AGENT for exact XY outline, E:227–267 and `/outline`; MFR-derived stack, E `/stackup`. | P: bind every edge-relative constraint to current outline. R: actual cowl/enclosure fit UNKNOWN. Do not restore 80×50 or 12 mm limits. |
| C03 — H1–H4 / adjacent blocks on both faces | H1(4,4), H2(86,4), H3(86,61), H4(4,61); Ø3.2 NPTH. Native F and B polygon bounds each extend about ±1.595 around the centres; those discretized polygons represent hole courtyards, not hardware. Exact inset, drill and tolerance authority UNKNOWN. | OWNER for four corner holes, R:65. AGENT for selected coordinates/drill/tolerance, E:227–267 and `/obligations/corner-holes`; B refs H1–H4. | P: preserve declared drill and cross-face hole interference; qualify hardware reservations separately. R: fabricated holes/installed interface. |
| C04 — screws, washers, standoffs / every block near H1–H4 | Head/washer outer diameter and height, standoff section/height, contact face, material, compression, thread and driver swept volume: **UNKNOWN on F and B**. No 6 mm standoff or radius is adopted. | UNKNOWN; E `/obligations/corner-holes`; `placement-inputs/README.md:5` explicitly limits hole courtyard meaning. Historical review examples are not hardware selection. | P locally / R installed: obtain selected-hardware geometry or record unresolved region/face. Never use the bare drill or an illustrative screw as proof of clearance. |
| C05 — J1 / harness interface, neighbouring power-entry, pre-6v3, CAN and residual parts | TE **1-776163-1**, right-angle; saved (45,55.5), rot0 F, +Y mating direction. Recommended PCB edge is local y+9.5 → board y65. F courtyard `[6.055,48.955,83.945,87.845]`; no B courtyard. Exact global X=45 is an agent choice, not a manufacturer anchor. | OWNER for right angle, D:175; MFR K1 sh2 for board datum and hole pattern; MECH-DERIVED pose alignment, J1:18–30,49–53; AGENT for global pose/courtyard allowance, E:67–83, J1:43–47. | P: retain sourced interface datum and full body; verify opposite-face PTH/lead access despite absent B courtyard. R: mated/panel fit separately. |
| C06 — J1 board pattern / all overlapping B parts | 35 Ø1.75±0.10 finished PTH; 4 mm row/pin pitch with 2 mm stagger; locators Ø2.85±0.08 at local(±28.5,+0.5). Nominal raw STEP body projection x±38.45/y−6..31.8 and z−4.33..27.77 relative to support plane; 3.50 mm tail projection before trim. Saved physical stickout after assembly **UNKNOWN**. | MFR, K1 sh1–2; MECH-DERIVED STEP datum, J1:83–108; assembly trim described in O:13–16,54–67 (OWNER-RELAY). | P: through-board pads/drills and underside solder/trim access; R: seating, finished holes, retention, solder joints, final lead trim and tolerances. STEP projection is not full installed qualification. |
| C07 — J1 enclosure flange, panel screws and driver / connector interface | K1 nominal flange 76.9 wide, 32.1 high; four panel holes Ø3.00–3.30, horizontal spans 63.4 top/66.4 bottom, vertical 18.1. Panel opening 60.0–60.5 ×24.2–25.2, R6.60–6.80. These are panel features, **not H1–H4 or PCB locator holes**. Suggested screw Ø2.5; source torque0.6–0.8 N·m with customer testing; actual selected head/washer/tool lanes UNKNOWN. | MFR, K1 sh1 note1 / sh2; S3 p11 §3.6.B. J1G:9–19; M:58. | P if panel/hardware is selected; R final enclosure seal, screw selection/engagement/torque and tool access. Do not substitute 63.4 for connector overall width. |
| C08 — J1 mate, CPA/latch, harness and tool access | Black **776164-1** mate/keying sourced; numerical mated transform, engagement depth, cable bend/strain-relief envelope, installed latch/driver lanes UNKNOWN. Ø66 is completed-plug pass-through clearance, not mating travel. Harness exit is outward +Y in current footprint frame. | MFR K1 sh1 note5, E5 sh1–2, S3 p8 Fig12/p13 Fig17/p7 §3.5.D; M:56–64. | P where a selected assembly/access envelope interacts with parts; R installed. No plug STEP mating datum or lane is invented. |
| C09 — J2 / GNSS RF and nearby supervision | Molex 73251-1150 binding, captured1153-family footprint; saved(85.24,28), rot180 F; signal pad1(86.96,28). F/B courtyard bbox `[82.535,21.915,99.525,34.085]`. Edge datum x90 and nominal pad-edge clearance0.5 are footprint-derived; current original SD-73251-115 B3 drawing not captured in the inspected packet. Cable sweep, coupling nut/wrench, installed height and launch seating remain UNKNOWN. | MECH-DERIVED library geometry and AGENT D-PCB-4, D:153; `access-direction/README.md:13,45–47`; B J2. Family geometry text is secondary, not a new manufacturer-original claim. | P: preserve actual two-face footprint/edge interface; source precise launch and tool restrictions before claiming them. R installed cable/launch. No part mismatch is inferred from suffix alone. |
| C10 — J3 / storage support, nearby residual and underside blocks | Hirose DM3AT-SF-PEJM5, PUSH-PUSH, saved(8.9,32), rot90 B; mouth points left. B courtyard `[-20.095,24.125,17.715,39.815]`, no F courtyard. It includes a library card outline plus **agent-selected 15 mm lane +0.25 allowance**. Existing envelope permits20.3 left overhang. Only the off-edge direction is the quoted owner instruction; exact XY/rot/lane are derived choices. | OWNER direction, D:176; AGENT/MECH-DERIVED numbers, D:120–126,176, E:130–145. Catalog H3 p3 identifies exact part/1.68 mm height; H3 p1–3 distinguishes push-push. | P: transform socket/card/keepouts and preserve removal direction; do not block F merely by projecting a B-only body. R: actual enclosure pocket/opening and hand access. |
| C11 — J3 travel, body and socket-owned exclusions / storage and all nearby B copper/parts | Catalog body 13.85×15.95, height 1.68 above mounted face; common-datum card lock 17.55, eject 21.55, overstroke 16.75 (4.0 eject /0.8 overstroke deltas, **not full removal/finger travel**). Five native B-only rule areas prohibit tracks/vias/pads/parts/pours; exact polygons are in inventory. Full 3D card/hand swept volume and current engineering-drawing tolerance UNKNOWN. | MFR catalog via distributor, H3 p1–3, capture manifest. Native rule areas are captured library geometry; catalog p3 identifies no-conductive-trace regions, but exact native polygon correspondence was not independently qualified. | P: preserve footprint rules; source or explicitly carry unresolved access mapping. R: physical card operation. `access-direction/README.md:24` reports the unresolved8.88/8.90 mouth-datum sensitivity; it is not proved physical interference. |
| C12 — U1 / radio/MCU supports, nearby blocks and enclosure | Saved(72.5,6.5), rot0 F; F courtyard `[48.505,-21.245,96.495,19.945]`. Native antenna area x48.5–96.5/y−21.25..−0.25 on all 4 copper layers prohibits parts/pads/tracks/vias/pours. Manufacturer land-pattern body 18×25.5, antenna depth 6; these dimensions **do not prove the retained CAD clearance minimum**. | OWNER accepted overhang quote, D:179; MFR module datasheet Fig11-1 p45; MECH-DERIVED native polygon; A:14–42 explicitly says CAD is not manufacturer minimum. | P: preserve source case and actual antenna/feed orientation; do not discard all-layer rule on a side change. R: installed RF/overhang support. Exact pose remains preserved baseline, not a manufacturer-mandated XY. |
| C13 — U1 housing/metal / antenna region, H2 and enclosure hardware | Espressif recommends at least 15 mm housing clearance in all directions; outside-board antenna with feed close to edge is preferred. Feed-point/installed orientation qualification UNKNOWN. D-PCB-16's 20×8 pocket and ~5 air are **agent-derived**, not owner-set dimensions or manufacturer minimums. Non-metallic housing is required; no installed screw/boss/harness metal clearance is proven. | MFR HG PDFp33 (printedp30), §1.4.7, figs24–26 on PDFpp33–34; OWNER non-metallic R:66; AGENT pocket D:179, reconciled with A:14–42. | P: qualify the chosen case/face before declaring compliance. R: actual housing clearance/range/throughput. Do not turn housing15 mm into symmetric base-board copper exclusion or claim 5 mm satisfies 15 mm. |
| C14 — U2 / IMU and local bypass; nearby J1/J2, L1/L2 and capacitors | Saved(12,10), rot0 F; F courtyard `[10.255,8.505,13.745,11.495]`; no B courtyard. Exact XY and F-only status have no identified owner/manufacturer source. X forward/Y left/Z up is a required installed-axis mapping; board-to-bike transform remains UNKNOWN. Tall/heavy parts kept away; numeric distance UNKNOWN. | OWNER/project requirements R:68–69; AGENT historical pose E:120–128; E `/obligations/imu-separation` adopts no numeric threshold. | P: preserve/verify axis transform and actual support relationships if moved/re-sided. No arbitrary IMU box or inductor shadow becomes hard. R: rigid mounting/vibration evidence. |
| C15 — U3/L3/D3/C42, J2 / GNSS functional role currently residual | Actual U3 origin(55.35,12.8514)F; U3.11 RF(49.35,18.7514); L3(44.01,17.41)F. D-PCB-6 kept rectangle x76–88/y26.5–30.6, In1/In2, forbids tracks/vias only; permits footprints/pads/pours. D's source pad(77.5,29.1) is historical. Geometry continuity/reference under actual new path is UNKNOWN; inventory includes B.Cu RF copper. | MECH-DERIVED native observation B U3/J2 and `/rf_named_tracks`; AGENT RF rectangle D:155, E:196–224; OWNER/project F-over-In1 requirement R:65. | P: reconcile RF block/path and reference reservation before packing acceptance; preserve rectangle pending authorized repair. R: impedance, actual RF connectivity and measured performance. Native DRC alone is not RF qualification. |
| C16 — all blocks, regulators and +3V3 distribution | In1 GND no-tracks area is outline(0,0)–(90,65), vias allowed outside other keepouts; In2 is mixed power/signals. D-PCB-6 separately excludes through vias in its polygon. Signal layers cannot be inferred simply by counting4 layers. | AGENT engineering policy with cited reference-plane rationale, D:154–156; actual B rule-area names at128089/128120; MFR stack E `/stackup`. No manufacturer imposes these exact absolute polygons. | P: preserve required reference plane and changed-outline binding; R: routed pour/reference continuity. Never blanket-ban all through vias just because In1 forbids tracks. |
| C17 — per-face courtyards / every block and cross-face pair | All309 native footprint polygons and pads captured. Actual286 F/23 B; B includesJ3 + R7/R70–84 + TP1–6. Opposite-face bodies may overlap only if actual through-board, height, hardware/access and source-specific restrictions allow it. Native no-courtyard is **not** no-body/no-access. | MECH-DERIVED B per UUID/reference; R5:1–7,18,25–48 explains earlier B search. MFR provenance of each courtyard is not established by reading the file alone. | P: evaluate transformed same-face polygons, holes and access, plus both-face3D restrictions where sourced. R: final body/assembly collision validation. |
| C18 — courtyard edge and inter-part margins / all movable blocks | Existing `min_courtyard_edge_mm=0.5`; `gap_nm=250000` (0.25). R5 applies a gap-inflated courtyard against an already edge-inset outline; report both operations, not centre-to-edge distance. J1 also has its own provisional0.5 courtyard allowance. These three numbers are separate from copper-edge rules. | AGENT/default, P:435,524; P1:431,520; R1:89–95; R5:25–48; J1:43–47. | P: keep baseline values for comparison; any policy revision requires its own explicit disposition/source. No replacement margin proposed. Neither existing number is evidence of a physical owner limit. |
| C19 — heights / both faces, all blocks | No verified height fields on any 309 saved footprints. This is an inventory limitation, not proof of zero height. J3 catalog 1.68 and J1 model projection are source-specific partial facts above. Other installed heights, F/B enclosure clearance, solder protrusions and tolerance stack **UNKNOWN in this register**. No 12 mm cap. | R:65; E `/obligations/height`; B field inventory. U3 STEP is explicitly visualization-only (`neo-m9n-model/`), not mechanical qualification. | P when choosing a real restricted volume; R installed height/assembly. Capture heights from exact selected parts before claiming a completed mechanical check; candidate generation can retain explicit unknowns. |
| C20 — TP1–TP6 / programming/debug, MCU support and test fixture | All six B, Ø1.5 copper pads; centres tabulated below. UART factory programming before sealing, with BLE OTA afterwards. Probe tip/approach travel, fixture/pin height, side support/force, tool/hand clearance **UNKNOWN**. | OWNER/project functional access R:42; actual B TP refs; R5:18 side set. | P: reserve usable approach and support after side changes, with sourced fixture geometry when selected. R: actual programming/console fixture and pre-seal assembly sequence. No field-service opening is required by this source. |
| C21 — JP1–JP5 / tire-CAN and thermistor configuration | Five on-board normally-open copper jumpers, F pads. Soldering/configuration access footprint, tool angle and timing UNKNOWN; do not remove them as DNP/BOM omissions. | Production-capture README:120–130, `composition/declarations.json` (JP copper role); B pad geometry. | P for intended assembly/configuration path; R physical verification. Do not assume access after enclosure sealing. |
| C22 — cowl/enclosure/harness / entire assembly | Under rear cowl of2007 SV650; IP67, non-metallic over antenna; harness/SMA only penetrations. Envelope/clearances/panel/cowl CAD not supplied: **UNKNOWN**. Rigid board+IMU→enclosure→frame; do not pot unless necessary. GNSS antenna upward, cable≤500 mm. | OWNER/project R:63–70; O:37–50,54–67 is OWNER-RELAY with explicit agent-authorship warning. | P preserve required interfaces; R integrated sealed/vibration/installed fit. Team-designed enclosure/harness remain deliverables, not an invented fixed box or a requirement for owner CAD. |
| C23 — thermal / U1/U2/U3/U4/J3, bucks U5/U7/U6/U12, loads and nearby blocks | Required board ambient −20..+85°C, general parts ≥105°C with named exceptions; validated local operating temperatures and enclosure airflow/conduction **UNKNOWN**. Exact U1/U2/U4 exception is owner-recorded; U3/J3 extensions are agent engineering decisions. J3 catalog −25..+85 includes current rise. No numeric thermal spacing or hot-zone polygon sourced here. | R:67,74–95; D:171,174; H3 p2; actual selected-part bindings remain required. | P record hot/noise/IMU relationships without unsourced hard spacing; R worst-case enclosed input/load/radio/logging thermal evidence and each part's actual rating. A blanket exception check is not thermal qualification. |

## Candidate-bound anchors and test access

The exact native anchor/test entries are in `geometry-summary.json`, with source hash and UUIDs. In `B` the relevant reference property lines are J2:7090, U1:27122, U2:28215, U3:34786, J1:60138, J3:73004; H1:53308, H2:43669, H3:38827, H4:18160. A property line locates the containing footprint; `native-geometry.json` gives its measured fields. Do not infer ownership from a `locked` flag.

| Test pad / function | B-face centre mm | Copper size |
| --- | --- | --- |
| TP1 UART TX | (81.25,5.05) | Ø1.5 mm |
| TP2 UART RX | (82.0,7.619038) | Ø1.5 mm |
| TP3 GND | (45.0,32.5) | Ø1.5 mm |
| TP4 MCU_EN | (71.484858,30.1735) | Ø1.5 mm |
| TP5 MCU_BOOT | (83.0575,17.6043) | Ø1.5 mm |
| TP6 +3V3 | (45.117503,35.740363) | Ø1.5 mm |

Affected block membership must be reconciled with AGENTEE-473's trace: existing `blocks/allocation.json` has 18 blocks and explicitly puts J1/J2/J3/U1/U2/U3/L3/D3 and TP1–6 in residual. It does not assign C18 or R33 at all on this 309-footprint candidate. This register does not silently create new membership. GNSS, storage, radio, IMU and connectors above name functional roles where the old allocation has no intact block. The power/thermal context includes `pre-6v3`, `buck-3v3`, `supplies-5v`, `power-entry`, `sensor-power-front/rear/tire`, `aux-power`; surrounding blocks on both faces must be queried at final coordinates, not selected once from an old picture.

## Before packing: checking contract for the next authorized writer

1. Bind exact source commit, schematic/board, full project/rules/footprint library, part bindings, allocation, envelope, source packet and consumed placement policy by content hash. Every footprint needs functional membership or explicit shared/fixed role; do not use supply/ground connectivity to merge unrelated blocks. Reconcile C18/R33 and the residual functional groups through AGENTEE-473/472.
2. Split OWNER/MFR constraints from agent-selected XY poses, defaults and derived envelopes. Keep the baseline 0.5/0.25 settings as recorded unless the authorized repair explicitly disposes of them. Do not change a native rule or numeric margin in this read-only task. Preserve historical inputs for comparison.
3. Establish each eligible block's allowed faces/rotations from sourced restrictions, then transform **all** members, pads, through-holes, courtyards, body heights, native rule areas and access vectors together. Cross-face overlap needs actual cross-face geometry checks, not a blanket yes/no based on a fixed-part bounding box. Preserve U2 axes and U1's antenna case.
4. Reconcile D-PCB-6 with actual U3.11/L3/D3/J2 locations and required F-over-In1 topology. The old rectangle is not a new RF routing corridor. Retain In1 continuity and the distinct via restrictions. No native DRC or airwire result discharges RF performance.
5. Apply sourced connector bodies/card paths and actual hardware/height/tool/probe swept volumes on the affected face(s) before calling packing mechanically constrained. Keep unsourced lane/pocket dimensions labelled AGENT. If source geometry is absent, return UNKNOWN for that check and identify the affected region; do not silently omit it, substitute the drill for the screw, or invent a margin. Provisional generation remains possible with explicit unresolved qualification.
6. Missing facts for **qualified packing**: hardware F/B envelopes near holes; affected connector/probe/card access transforms where they constrain component space; RF corridor/antenna-case applicability; selected-part height/cross-face collision data in any claimed bounded volume. Missing **installed/release** facts: actual cowl/enclosure/harness design, mated J1 transform, retention/seal/tool access, tolerances, vibration/thermal/RF measurements. Some access/height facts move from R to P as soon as an actual design constrains that region.

## Final saved coordinates: checking contract

Read the final saved board afresh. Recompute per-block membership, side, spread, internal/interface pin distances and violations from its bytes; bind the report, front/back annotated views and native checks to that same board/project hash. List every fixed pose changed and its authority; distinguish owner-fixed orientation from agent-selected XY. Re-evaluate current same-face courtyard/body collisions, cross-face drills/pins/hardware/height, card/latch/cable/probe approach, outline overhang and all rule-area flags. Rebind edge-relative and component-relative keepouts after changes; do not reuse a cached polygon or neighbour list just because its name stayed the same.

Report the minimum actual courtyard-to-edge/pair distances and which margin, source class and policy operation was used. Preserve the permitted connector/module/card overhangs without treating them as an outline relaxation for other components. Check RF path/reference-plane topology, U2 installed-axis transform and programmer accessibility independently of native DRC. Native ERC/DRC/parity, connectivity, manufacturing, electrical/RF/thermal/mechanical and physical qualification remain separate gates. Unknown hardware, heights or access cannot be counted as zero violations or a release PASS.

## Owner-reserved changes to send through 449 → 519 only if needed

No new owner decision is required merely to retain these known unknowns or design the future enclosure/harness. Escalate a concrete proposed change to: J1's right-angle requirement; the permitted U1 antenna overhang/case; J3 pointing off-board; double-sided permission plus its protected RF/antenna/interface constraints; or the required frame coupling, axes, environmental envelope/IP67 and enclosure penetrations. Do not reopen accepted nominal 1.6 mm board thickness by speculative tolerance arithmetic. Hardware selection and a sourced mechanical model are engineering deliverables; this assignment authorizes neither a purchase nor a constraint relaxation.

## Exact source key / provenance

All paths below are relative to the frozen repository root; `source-manifest.json` contains their current SHA-256 and equality to `git show 46c7c730:PATH`. The register is a synthesis of those sources; historical agent statements are checked against later packet content and current native geometry.

- **R** — `telemetry-pod/REQUIREMENTS.md`:42–43,61–95,125,141. Owner quotes retain their dates and attribution; not every surrounding explanatory sentence is a verbatim owner statement.
- **E** — `telemetry-pod/expansion/production-capture/composition/envelope.json`:67–145 fixed poses;148–224 rule areas;227–267 holes;269 onward `/obligations`; `/outline` and `/stackup`.
- **D** — `telemetry-pod/expansion/design-rules/constraints.json`:4–9 class definitions;120–126 J3 lane;144–156 stack/RF/plane policies;171–179 named decisions. An engineering decision's existence is not manufacturer proof of its chosen coordinates.
- **B** — `telemetry-pod/expansion/route-3/candidate/telemetry-pod.kicad_pcb`, exact SHA above, read with pcbnew10.0.7 by retained `extract_geometry.py`; no save or refill. This inventory is the source for actual polygons/poses, not for physical-source authority.
- **P** — `telemetry-pod/expansion/production-capture/composition/placement-policy.json`:435,524. **P1** — `telemetry-pod/expansion/placement-r1/repair/placement-policy.r1.json`:431,520. **R1** — `telemetry-pod/expansion/placement-r1/RESULT.md`:70–95. **R5** — `telemetry-pod/expansion/placement-r5/r5_place.py`:1–7,18,25–48. The earlier word “sourced” for all fixed refs is not accepted as owner/manufacturer provenance here.
- **J1** — `telemetry-pod/expansion/connector-candidate/README.md`:18–53,83–108. **J1G** — `.../review/geometry.md`:9–19. These are source-derived reviews, not manufacturer documents themselves.
- **K1** — `telemetry-pod/expansion/connector-candidate/sources/776163-K1.pdf`, TE776163 revK1,16SEP2024, sheets1–2, SHA `7ed1f2a5f6ebf57aeaefefa4b2bf5c165de0343a4317719d7771c2aabbc285a7`. Drawing-specific facts checked in retained text and existing independent geometry review.
- **S3** — `telemetry-pod/expansion/connector-candidate/mating-interface/sources/TE-114-16016-S3.pdf`, revS3,30APR2025. **E5** — same directory `TE-2293782-E5.pdf`, released revE5,22APR2026. **M** — same package `README.md`:33–64,75–86,118 onward; exact documents/pages are preserved per claim. Tool/latch claims here reuse its checked primary-source evidence; no new mated-solid qualification was attempted.
- **O** — `telemetry-pod/expansion/connector-candidate/mating-interface/sources/owner-decision-2026-10-22-board-thickness.txt`:1–9 attribution warning;13–50 summary;54–67 complete verbatim **agent relays** with Cairn IDs. It is owner-relayed, agent-drafted and unconfirmed, not owner-authored or a TE fact.
- **HG** — `telemetry-pod/expansion/production-capture/sources/esp32-guidelines/3dc09a979cf612db0754f966d180b22f05896ad220cece362d62cb0d0eb1d400.pdf`, captured Espressif guidelines, PDFpp33–34 (printed30–31), §1.4.7, figs24–26; SHA `057f6df63e10a2dfc155cf19d942adf5780127d839626e2beb4c1a61efeaf3a5`. Local targeted text read; no fresh web research.
- **A** — `telemetry-pod/expansion/production-capture/composition/captured-rule-areas.json`:14–42 and U1's `rule_areas`. This later packet separates retained CAD, source case, and housing clearance. `composition/antenna-facts.json` points to Espressif module datasheetv1.8 Fig11-1 PDFp45, retained under `parts-closure/recovered-pilot/core/datasheets-core/bcd526f54b8de686cec4db67219e36ea7ace50cddb0c92f3dfdac49cf99ffd2e.pdf`, SHA `27d71971da07c280c6068d08c74720d1a25b8f20cf8494dc1765bdd28d40d435`.
- **H3** — `telemetry-pod/expansion/production-capture/sources/j3-datasheet/acquisition-digikey/7059663a2a7162b7315ebf55be1a1d3dcffa2066e159a59e5c75b234466d1207.pdf`, Hirose DM3 series2010.6 reference catalog, PDFpp1–3, SHA `ab978e9d023b8b2d3a5acfe31ead6e9bf1d63b439d21f7f4db662a1e4e3b56af`; distributor mirror manifest names exact URL/capture. `composition/j3-source.json`:171–176 records limitations. This supersedes the old access README's claim that no original catalog is available, while the latest engineering drawing remains missing.
- Other exact locators: `telemetry-pod/expansion/access-direction/README.md`:11–24,38–47; `telemetry-pod/expansion/placement-inputs/README.md`:3–5; `telemetry-pod/expansion/blocks/allocation.json` and `blocks/README.md`; `telemetry-pod/expansion/production-capture/README.md`:120–130.

## Verification and limits

Native read-only extraction succeeded on 309 footprints and 8 rule areas; exact candidate hash is unchanged. pcbnew printed its existing enum-choice assertions while loading; no fatal error or save occurred. The extractor records F/B native polygons, not just bounding boxes, and all pad/drill centres/layers. Source hashes are checked against frozen46c7c730, while artifact integrity is checked by `SHA256SUMS`. No DRC, routing, render, refilling, purchase, upload, new agent or model call ran for this assignment. The retained ROUTE-3 has 77 open native items and 60 dangling findings againstR5; it remains incomplete, and this register does not regrade it.

Pincite packet `pkt-912d680a293605eb` supports authority separation and evidence identity only; `provenance/doctrine.json` records the release identity, evidence records, packet hashes, used concepts and nonmaterial generic omissions. No generic software doctrine supplies a PCB clearance or overrides these sources. No physical acceptance or unrequested repair is inferred from this inventory.
