halbritt/fome-mc/telemetry-pod/expansion/routing-diagnostic/candidate/planed-krt/RESULT.md

# Routing attempt: krt on candidate

- Backend: krt 0.23.1 (owned-c6c09054f684)
- Input: `ca.kicad_pcb` from working tree @ None (fingerprint 3f45347d883609c0)
- Scope: all, 369 nets; protect: existing; budget 1500 s
- Candidate: `/home/halbritt/.cache/agent499-cluster-anchored/iter2/route/runs/candidate/planed-krt/20261021T013127.040753Z/candidate/candidate/ca.kicad_pcb`

| Result | Status | Detail |
|---|---|---|
| process | PASS | exit 0, 1370.917 s |
| routing | INCOMPLETE | 92 unconnected in scope, 92 total (input: 499) |
| validation | FAIL | 6 new DRC violations: track_dangling 6; preservation net_completion: 32 of the 305 nets fully connected in the input lost connection: /ADC_AIN1, /ADC_AIN5, /ADC_AIN6, /ADC_CS, /AFE_DIV2, /AFE_DIV7, /DIAG_U27_AIN1, /DIAG_U27_AIN2, /DIAG_U28_AIN3, /DIAG_U29_AIN0 |

| Preservation check | Status |
|---|---|
| project_files | PASS |
| board_outline | PASS |
| layers | PASS |
| stackup | PASS |
| board_setup | PASS |
| nets_and_netclasses | PASS |
| pad_connectivity | PASS |
| footprints | PASS |
| zones | PASS |
| keepouts | PASS |
| copper_graphics | PASS |
| protected_copper | PASS |
| new_copper_netclass_geometry | PASS |
| routing_scope | PASS |
| net_completion | FAIL |
| pour_integrity | PASS |

Native DRC (original rules and severities):

```json
{
 "violations_total": 84,
 "parity_total": 0,
 "new_violations": {
  "count": 6,
  "by_type": {
   "track_dangling": 6
  },
  "by_severity": {
   "warning": 6
  }
 },
 "preexisting_violations": 78,
 "resolved_violations": 13,
 "new_parity": {
  "count": 0,
  "by_type": {},
  "by_severity": {}
 },
 "resolved_parity": 0
}
```

Unsupported or approximated by this backend:

- KRT reads only a subset of .kicad_dru custom rules; every rule is still graded by KiCad DRC
- KRT's cleanup may neck wide new segments near foreign pads without a flag; the new_copper_netclass_geometry check reports any new copper below its net class
- backend reported: .kicad_dru: rule 'fine-pitch intra-footprint pad clearance (D-PCB-1)': clearance 0.15mm has a non-layer scope (netclass/area/... condition) -- skipped, KiCad will still enforce it
- backend reported: .kicad_dru: rule 'supervisor intra-footprint pad clearance U16 (D-PCB-1)': clearance 0.15mm has a non-layer scope (netclass/area/... condition) -- skipped, KiCad will still enforce it
- backend reported: .kicad_dru: rule 'supervisor intra-footprint pad clearance U17 (D-PCB-1)': clearance 0.15mm has a non-layer scope (netclass/area/... condition) -- skipped, KiCad will still enforce it
- backend reported: .kicad_dru: rule 'supervisor intra-footprint pad clearance U18 (D-PCB-1)': clearance 0.15mm has a non-layer scope (netclass/area/... condition) -- skipped, KiCad will still enforce it
- backend reported: .kicad_dru: rule 'supervisor intra-footprint pad clearance U19 (D-PCB-1)': clearance 0.15mm has a non-layer scope (netclass/area/... condition) -- skipped, KiCad will still enforce it

Blocked by (heuristic straight/L corridors, not a proof; details `/home/halbritt/.cache/agent499-cluster-anchored/iter2/route/runs/candidate/planed-krt/20261021T013127.040753Z/validate/blocked-by.json`):
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
