halbritt/fome-mc/telemetry-pod/expansion/routing-diagnostic/cited/anchored-krt-campaign-r0/RESULT.md

# Routing attempt: krt on cited

- Backend: krt 0.23.1 (owned-c6c09054f684)
- Input: `ca.kicad_pcb` from working tree @ None (fingerprint 3d5ceaac81f0bdad)
- Scope: all, 369 nets; protect: existing; budget 900 s
- Candidate: `/home/halbritt/.cache/agent499-cluster-anchored/route/runs/cited/anchored-krt-campaign-r0/20261021T004744.523709Z/candidate/cited/ca.kicad_pcb`
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
