halbritt/fome-mc/.agents/skills/krt-diagnose-routing-failures/SKILL.md

---
name: krt-diagnose-routing-failures
description: "Use after a fome-mc routing attempt (make route / route.py) leaves nets unrouted or fails validation: root-cause it from the run directory and plan the next attempt; see body for the project mapping."
---

<!-- BEGIN fome-mc local adaptation (toolchain/sync_skills.py; do not edit by hand) -->
> **fome-mc local adaptation.** Upstream: KiCadRoutingTools `v0.23.1` (`295f9ee197517e8323726853361eb137cc08ba9e`),
> skill `diagnose-routing-failures`, MIT licence (see `LICENSE`). The text below the marker is upstream's,
> verbatim. Where it conflicts with this header, this header wins. Load the
> `fome-pcb-routing` skill first: it defines how routing runs in this project.
>
> - **Paths.** Upstream's `py_router/…` and `py_tools/…` are under `toolchain/vendor/krt/`;
>   run them as `toolchain/.venv-route/bin/python -X utf8 toolchain/vendor/krt/py_router/<tool>.py`.
> - **Logs.** Upstream's `/tmp/<step>.txt` captures are already in each run directory
>   `build/runs/route/<project>/<label>/<stamp>/`: `work/krt.log` (full KRT output,
>   including `JSON_SUMMARY`), `work/krt-out/summary.json`, `work/freerouting.log` and
>   `work/freerouting-result.json`. The candidate is `candidate/<project>/<board>`; the
>   untouched input is `reference/<project>/<board>`.
> - **Retries go through the wrapper.** Express every retry as
>   `make route BACKEND=… ARGS='…'` / `toolchain/route.py run …`, passing KRT flags with
>   `--backend-arg` and `KICAD_*` knobs with `--backend-env`. Never route the real design
>   in place, and never run KRT on files outside a run directory.
> - **No relaxation.** Do not use or suggest `--escalation board|fab`, `--fab-tier
>   advanced|auto`, `--fab-overrides` that lower a floor, `--clearance-ceiling`,
>   `--relax-drc-severities`, lowering `--track-width`/`--via-size`/`--clearance` below the
>   net class, or re-enabling `KICAD_TERMINAL_ESCALATION`. Tightening is fine.
> - **Grading.** The pass/fail verdict is `result.json` from the wrapper: KiCad's own DRC
>   with schematic parity against the input's unchanged rules, plus the preservation
>   checks. KRT's `check_*` tools are supplementary diagnostics; run them on the candidate
>   (its `.kicad_pro` is the original). Ignore upstream steps about the plugin GUI.
<!-- END fome-mc local adaptation -->

# Diagnose Routing Failures

When this skill is invoked with a board file and routing log file(s), root-cause the failures and produce a targeted retry command. Routing runs should always be captured with `2>&1 | tee /tmp/<step>.txt` so the logs are available.

## Step 1: Parse the Structured Outputs

### JSON summary

```bash
grep "JSON_SUMMARY" /tmp/route_output.txt | sed 's/.*JSON_SUMMARY: //' | python3 -m json.tool
```

Key fields:
- `failed_single`: failed single-ended net names — nets with NO result at all
- `open_single`: nets that KEPT a result whose copper still leaves pads
  disconnected (non-multipoint only; a multipoint shortfall is already the pad
  deficit). **Always read this alongside `failed_single`** — a board can ship
  open copper with `failed_single: []`, so a run is only clean when both are
  empty. These nets also appear by name in `failed_multipoint`.
- `terminal_restores`: `{net: outcome}` for rip victims restored at terminal
  failure. `full` is the only success; `full_open` restored copper that never
  covered every pad, and `stub` kept only the escape stubs — both ship broken
  and are worth reporting as failures with a distinct cause (the reroute failed
  and the pre-rip copper could not be fully put back).
- `stacked_copper`: same-net duplicate copper KiCad's DRC will never flag. Not a
  routing failure, but if present, say so — it is invisible to every other check.
- `failed_multipoint`: nets with unconnected pads, including pad coordinates
- `blockers`: per still-failed net, the run's LAST frontier blocking analysis
  (#409): `{net, stage, blocked_by: [{net, blocked_count, unique_cells,
  track_cells, via_cells, near_target_cells, near_source_cells}], more?}` —
  "net X failed BECAUSE nets Y,Z wall it off" as data. Key absent when no
  failed net has an attributable (routed-copper) blocker.
- `multipoint_pads_connected` vs `multipoint_pads_total`: connection success rate.
  Derived from the final-board union-find (the same check `check_connected.py`
  uses), so it credits pads reached via planes/zones, fanout stubs, and
  rip-up/retry reroutes and agrees with `check_connected.py` (issue #184).
- `pad_pairs_connected` / `pad_pairs_total`: pad-pair routability tallies
  (#409 follow-up; PRR = connected/total downstream). Per graded multi-pad
  net: connected = |pads| − pad components from the same final-board
  union-find, total = |pads| − 1 (clamped so a net whose pads are invisible
  to the union-find grades as connected). Population: the routing scope
  after already-routed filtering, pre-existing rippable nets the run graded,
  and disturbed coverage-gate nets. NOT reconcilable with
  `multipoint_edges_*` (those count component-MST edges — pre-existing
  copper joins terminals first, so there are fewer edges than pad pairs).
  Computed before the final reconciliation, like `blockers`. Single-outline
  semantics for now (a cross-outline split counts as open pairs).
- `pad_pairs_open`: per net shipping a pair deficit: `{net, pairs_connected,
  pairs_total, outcome, open_subtype}`, sorted by net; key absent when none.
  `outcome` is always `"open"` today — route.py runs no DRC, so a route-time
  failure is definitionally an open; shorts are `check_drc.py`'s domain and
  the field exists so a DRC-integrated emitter can add `"short"` without a
  schema break. (Distinct namespace from route_diff `pair_reports.outcome`.)
  `open_subtype`: `collision_refused` (left open because restoring the
  ripped track would collide — a short was averted, #134), `coverage_gate`
  (disturbed out-of-scope net shipping broken), `unrouted` (scope net, no
  result at all), `partial` (routed a result but left pads disconnected).
  Join with `blockers` on `net` for cause + outcome per failed net.

### Failed net histories

```bash
grep -A 30 "FAILED NET HISTORIES" /tmp/route_output.txt
```

Each failed net's history records its route attempts, which nets ripped it up (`ripped_by`, with escalation level N), and reroute outcomes. A net that was ripped and never successfully rerouted points at the net that ripped it as much as at the failed net itself.

### Blocking reports

Look for blocking analysis lines:

```bash
grep -B2 -A8 -i "blocked by\|no rippable blockers\|Route stuck" /tmp/route_output.txt
```

These name the previously-routed nets occupying the failed route's frontier and where the search got stuck (position + layer).

Note: the final `JSON_SUMMARY` carries the same attribution structured — the `blockers` key (#409) holds each still-failed net's last analysis. Prefer it for final-state diagnosis; the greps above remain useful for transient mid-run analyses (blockers of nets that later routed).

## Step 2: Correlate Failures Spatially

Load the board and map failures to regions and components:

```python
import sys
sys.path.insert(0, "py_router")
from kicad_parser import parse_kicad_pcb
pcb = parse_kicad_pcb('board.kicad_pcb')

# For each failed net: where are its pads, and what is nearby?
for net in pcb.nets.values():
    if net.name in failed_names:
        for pad in net.pads:
            print(net.name, pad.component_ref, pad.global_x, pad.global_y, pad.layers)
```

Check whether failures cluster:
- Near one component (especially a BGA/PGA — its auto-detected exclusion zone may be walling off paths)
- In one board region (a congested corridor every failed net needs to cross)
- On one layer (layer costs or direction preference starving that layer)

Report the spatial pattern explicitly, e.g. "all 6 failures have an endpoint within 3mm of U9's southeast corner."

## Step 3: Classify and Recommend

Work through the failure modes most-targeted-first. Do not jump straight to global parameter increases — they are the last resort, not the first.

| Evidence | Failure mode | Fix |
|---|---|-----|
| "no rippable blockers found" near a BGA/PGA | Blocked by the BGA exclusion zone or pre-existing copper | `--no-bga-zone <ref>` for that component |
| Stuck positions cluster in one corridor; blockers are routed nets that themselves had few alternatives | Corridor congestion | Suggest the user **draw a guide corridor**: a polyline on `User.1` through a less congested region, then re-route the failed nets with `--guide-corridor`. Describe in words where the corridor should go (e.g. "south of J3, between the mounting hole and C14"). **Do not draw the geometry yourself** — guide drawing is the user's decision |
| Failed nets have source and target stubs on conflicting layers; rip-up histories show repeated mutual ripping | Same-layer crossing conflicts | `--mps-layer-swap`, or revisit `--layer-costs` |
| "Re-route FAILED: no path found" for ripped nets | Search space exhausted | NOT a budget problem: the router self-budgets (#529, default on — auto-extends to 1e7 iterations while progressing), so do not suggest raising `--max-iterations`. A "dynamic iterations (#529): search extended to N" line followed by failure means genuine progress ran out — escalate capacity: `--max-ripup`, clearance/track toward fab floor, or layers. (`KICAD_DYNAMIC_ITERATIONS=0` restores legacy static caps for A/B only) |
| Many multipoint pads failed on the same fine-pitch component | Grid too coarse for the pad geometry | `--grid-step 0.05`, and check `--track-width`/`--clearance` against the pad pitch |
| Failures cluster on one part's pads or escape face; `py_tools/check_reachability.py <board> --pad REF.PAD` says CAGED; or `boxed_in[].geometry` is already at the board/fab floor | Placement-shaped: geometry, not the router | Stop retrying: no router flag fixes it. Hand the board back to `/pcb-free-agent full` (or `place`) to re-place, then re-route |
| Failures spread across the board, blockers vary | Genuine capacity problem | Escalate in order: reduce `--clearance`/`--track-width` toward fab minimums → add routing layers. Do NOT raise `--max-ripup` past ~5 (measured worse: deep rip chains strand their victims) |

## Step 4: Output the Retry Command

Produce one command that retries **only the failed nets** with the targeted fixes, and explain each parameter change in one line:

```bash
python3 -X utf8 py_router/route.py board_routed.kicad_pcb board_retry.kicad_pcb \
    --nets "SDA" "Net-(U1-Pad8)" \
    --no-bga-zone U9 \
    --max-ripup 5 \
    2>&1 | tee /tmp/route_retry.txt
```

Routing only the failed nets preserves the successful routes (already in the input file) and is much faster than a full re-run. **On a board with pours, add the poured nets to `--nets` too** (#1032): the retry's copper can cut a pour, and its in-run plane finalize repairs only the poured nets inside its scope. A broken poured net is retried the same way, with `route.py`, never a standalone `repair_planes.py` (#1112). After the retry, re-check with `check_connected.py`, and if nets still fail, repeat the diagnosis on the new log — the failure mode often changes after the first fix.
