halbritt/fome-mc/telemetry-pod/renders/telemetry-pod-schematic.pdf

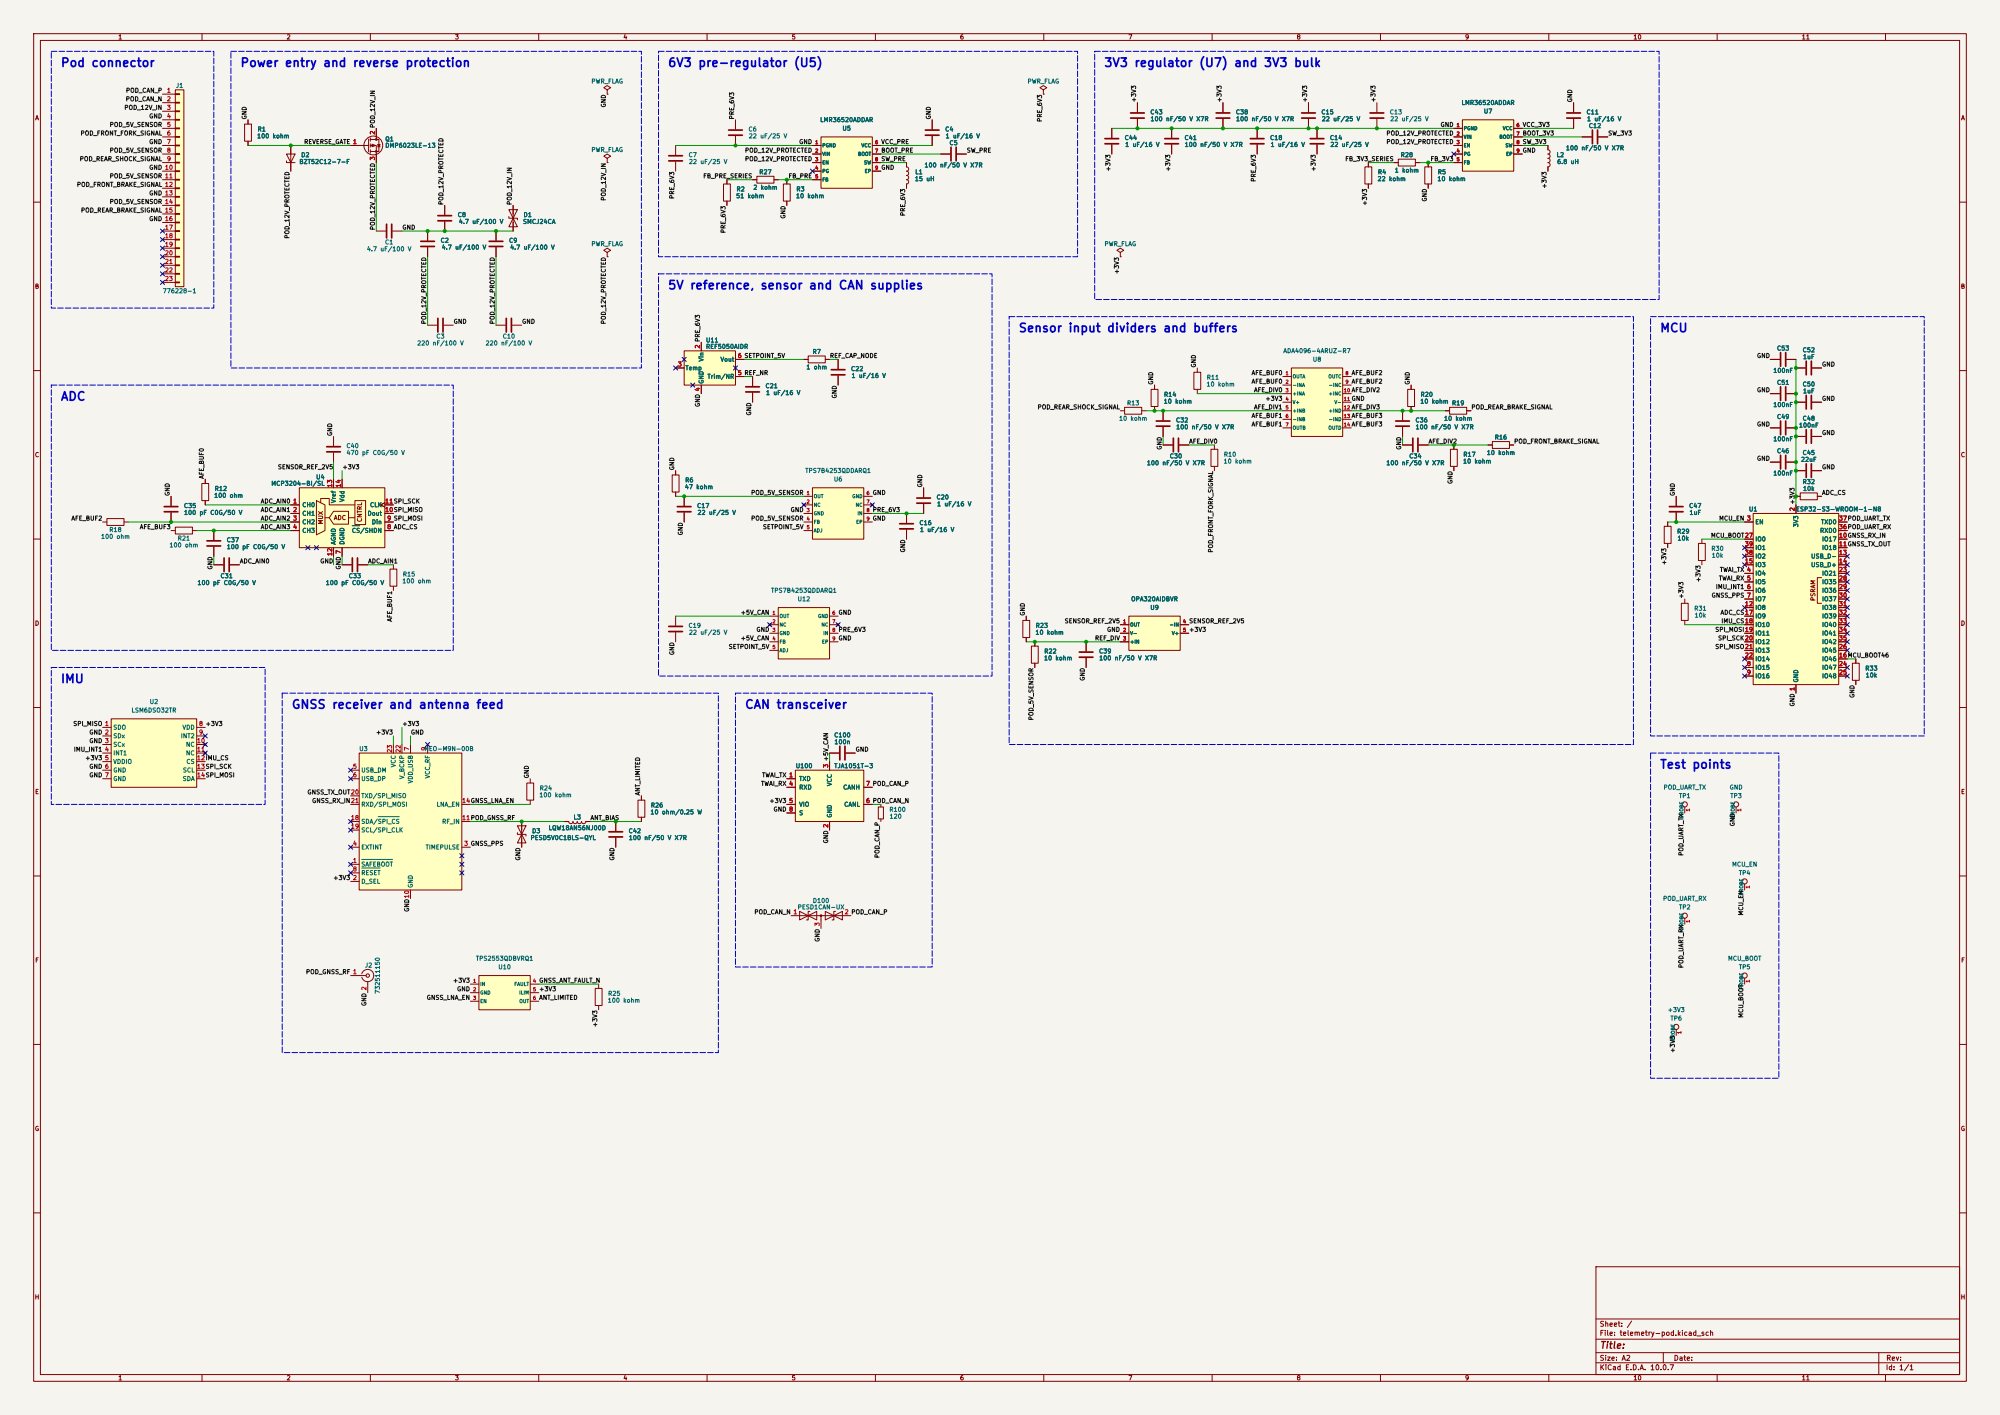
[picture p66: page 1]

5V reference, sensor and CAN supplies

SENSOR_REF_2V5 Sensor input dividers and buffers

7 CS/SHDN 8 Din 9 Dout 10 CLK 11 AGND 12 Vref 13 Vdd 14U4 MCP3204-BI/SL C33

7 CS/SHDN 8 Din 9 Dout 10 CLK 11 AGND 12 Vref 13 Vdd 14 C33

GNSS receiver and antenna feed

Size: A2 | Rev:
KiCad E.D.A. 10.0.7 | Id: 1/1
