halbritt/fome-mc/docs/schematics/fome-mc-schematics.pdf

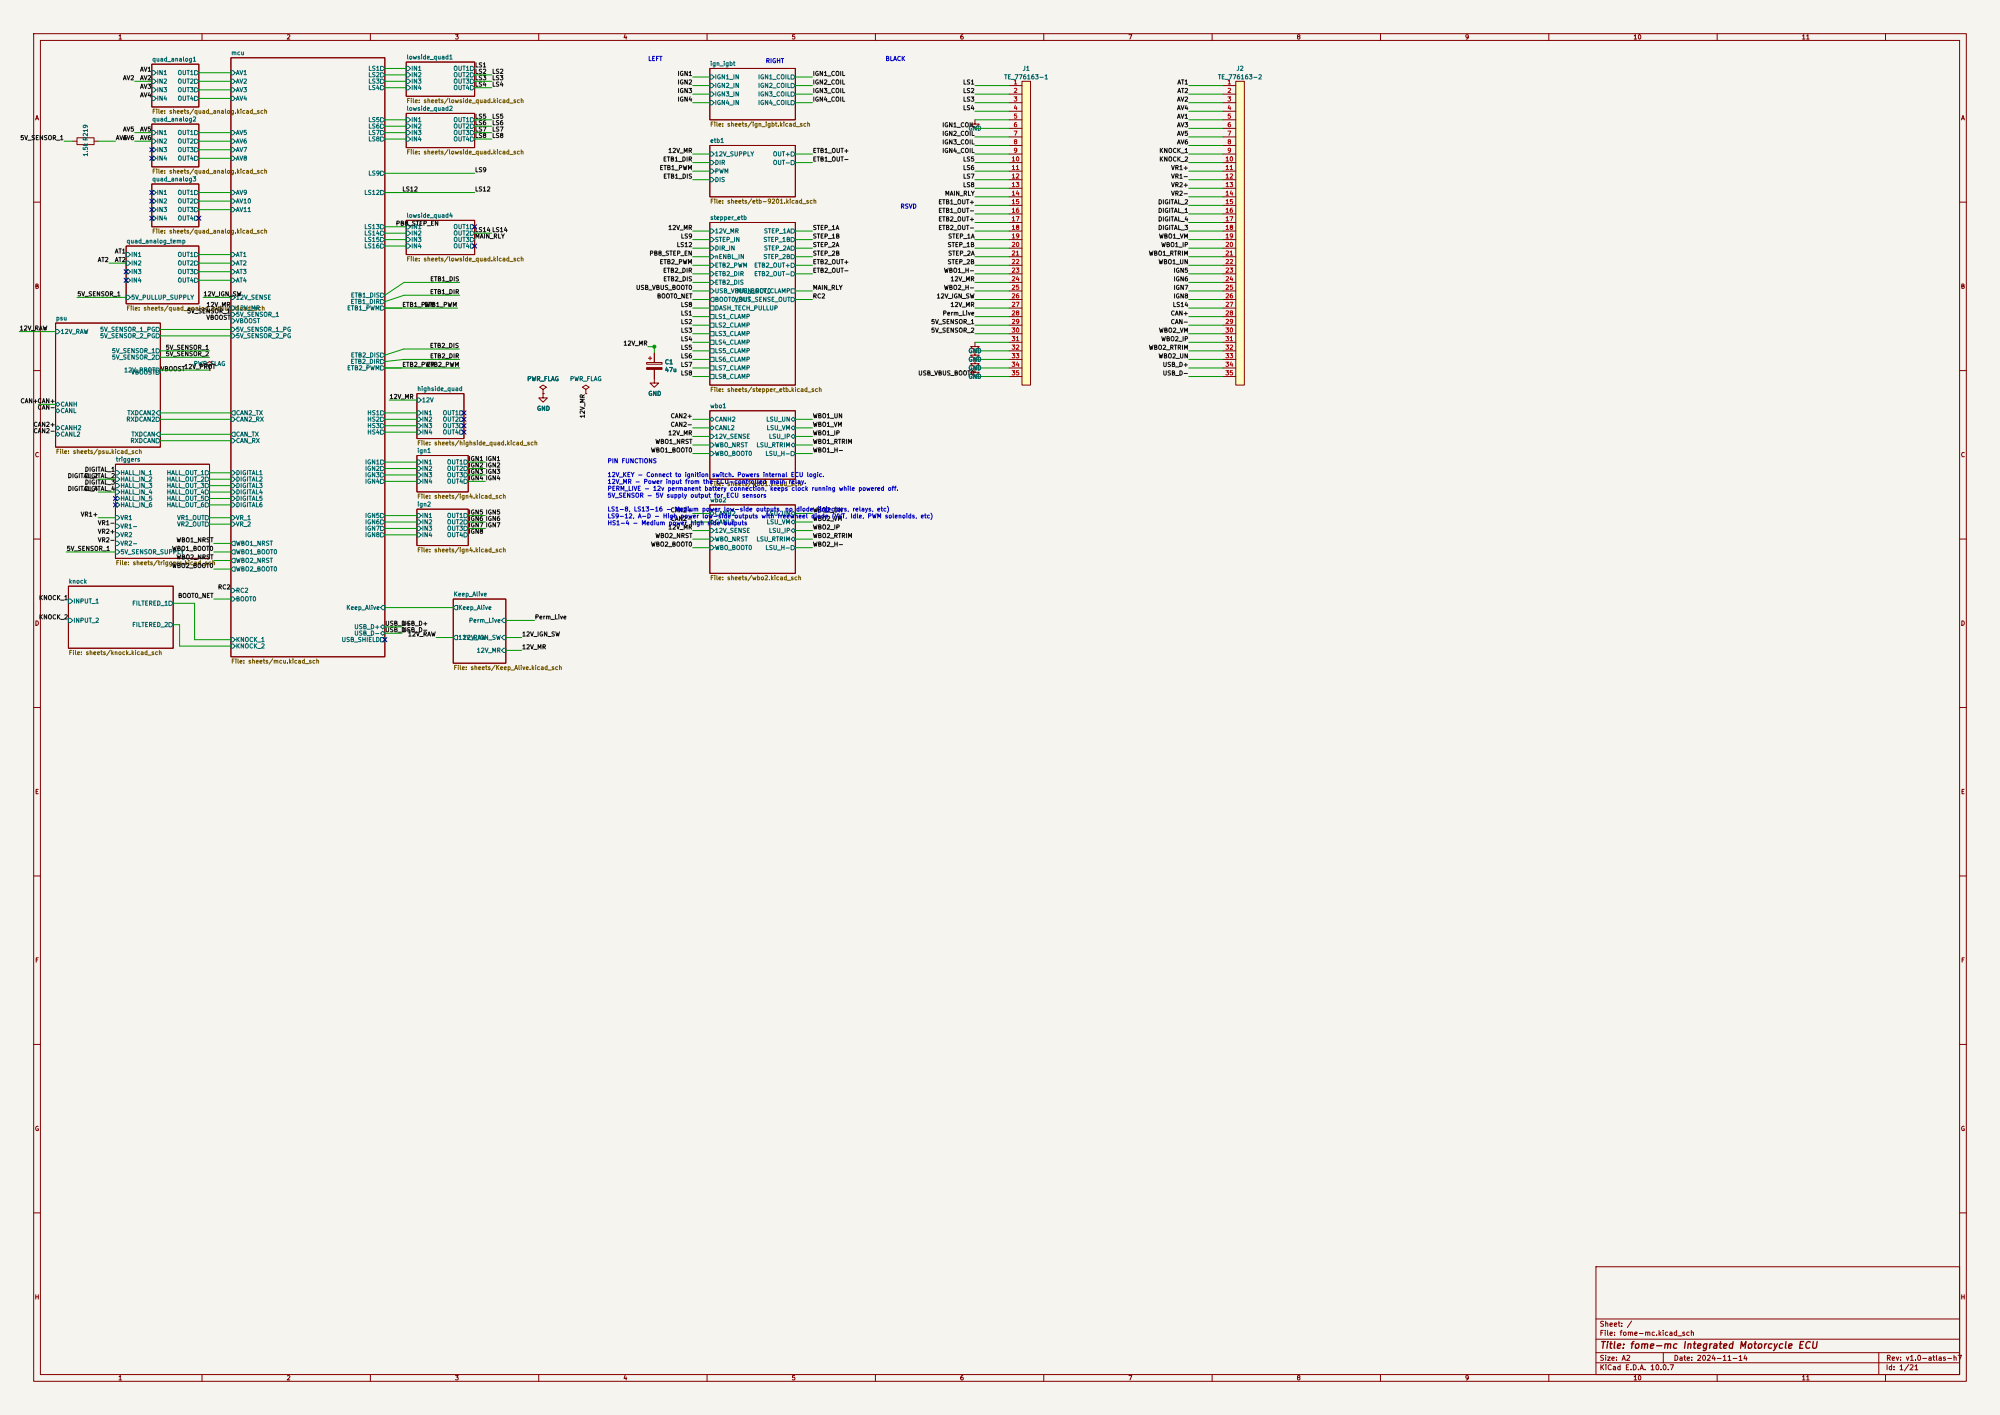
[picture p67: page 1]

triggers File: sheets/triggers.kicad_sch

LS9-12, A-D - High power low-side outputs with freewheel diode (VVT, Idle, PWM solenoids, etc) HS1-4 - Medium power high side outputs

knock File: sheets/knock.kicad_sch

Sheet: /
File: fome-mc.kicad_sch
Title: fome-mc Integrated Motorcycle ECU
KiCad E.D.A. 10.0.7

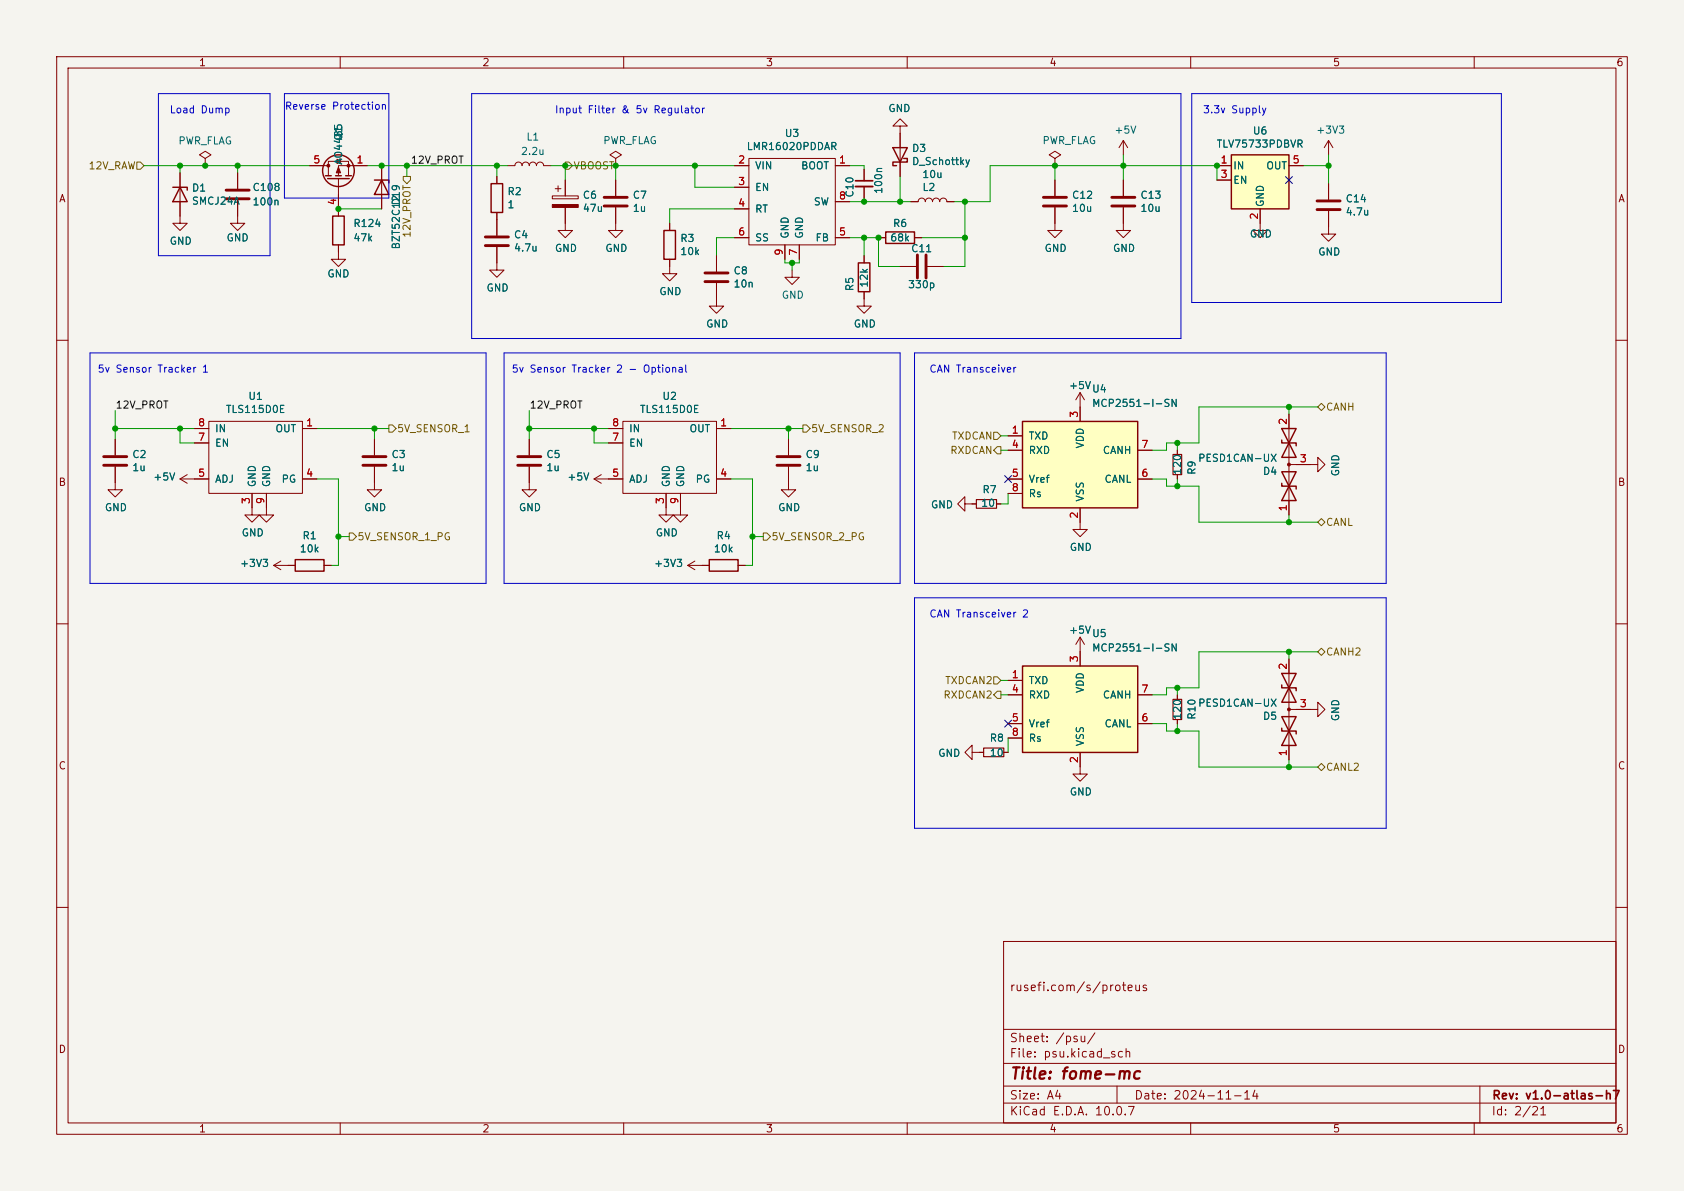
[picture p68: page 2]

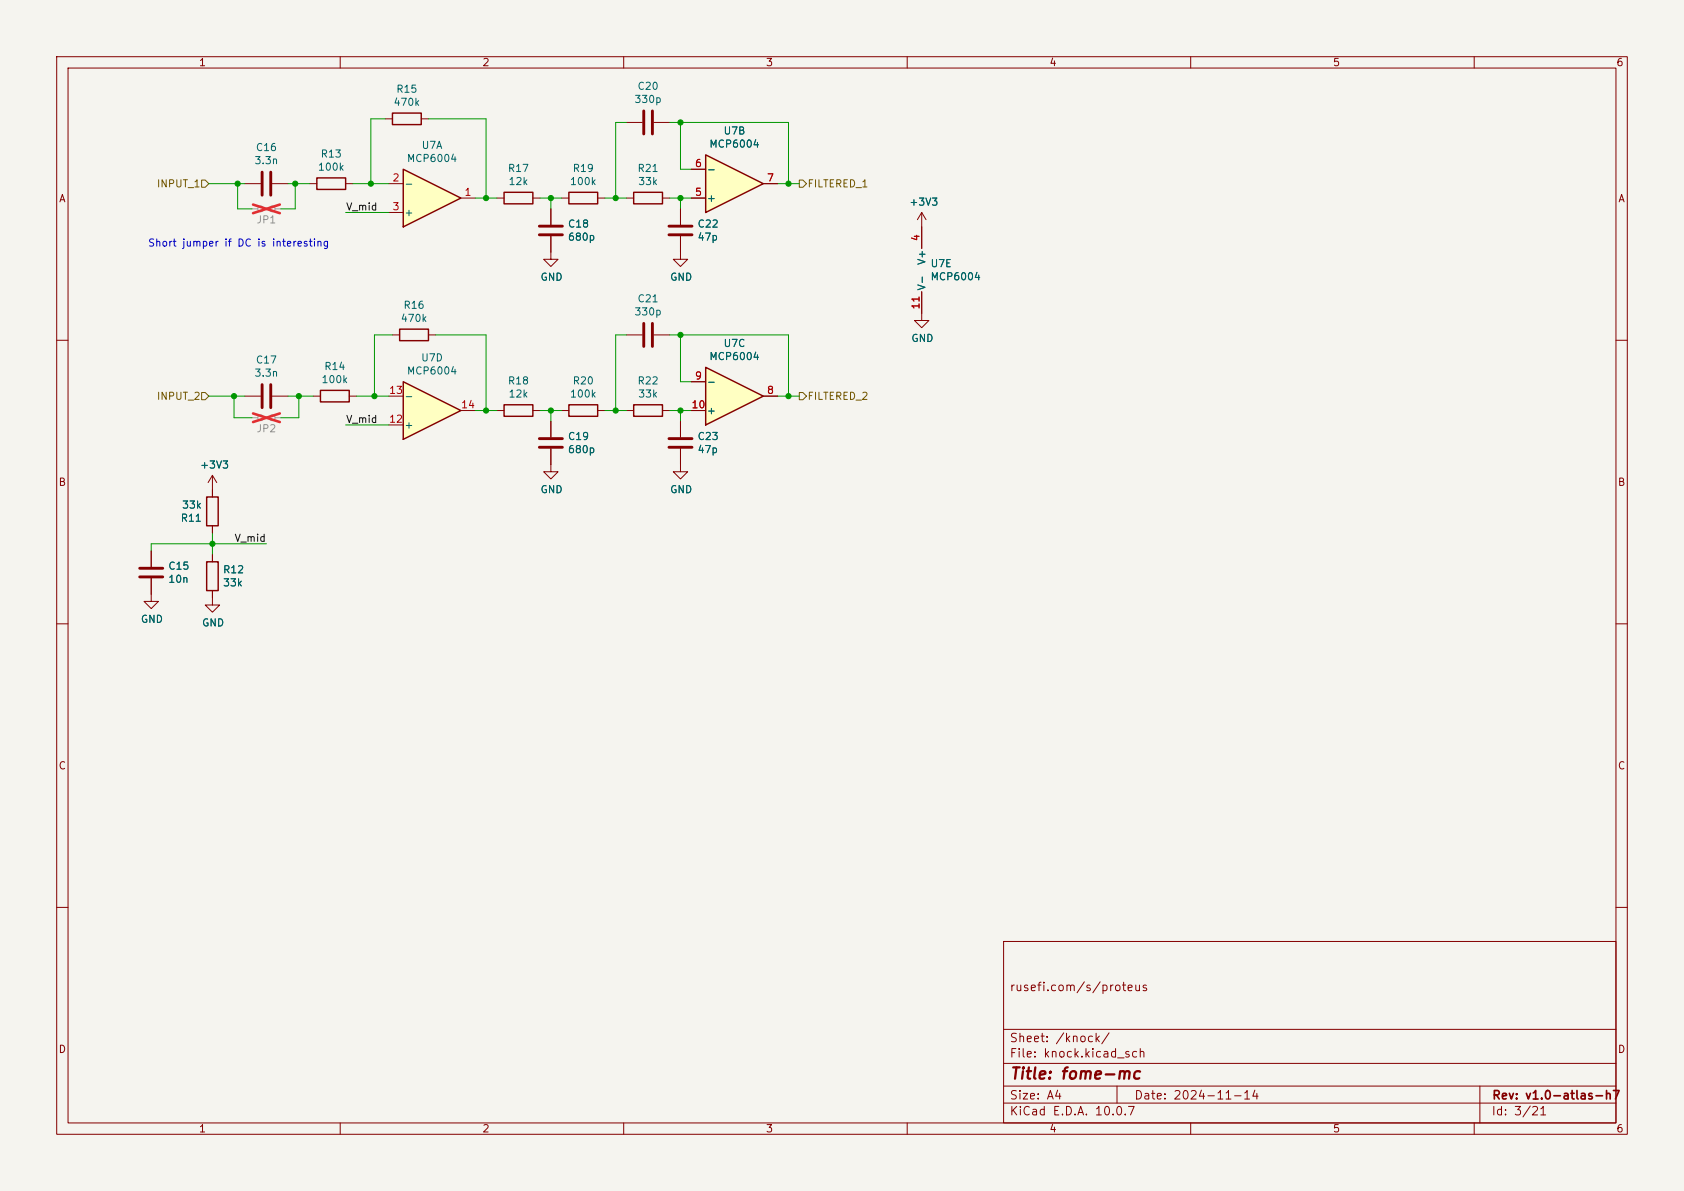
[picture p69: page 3]

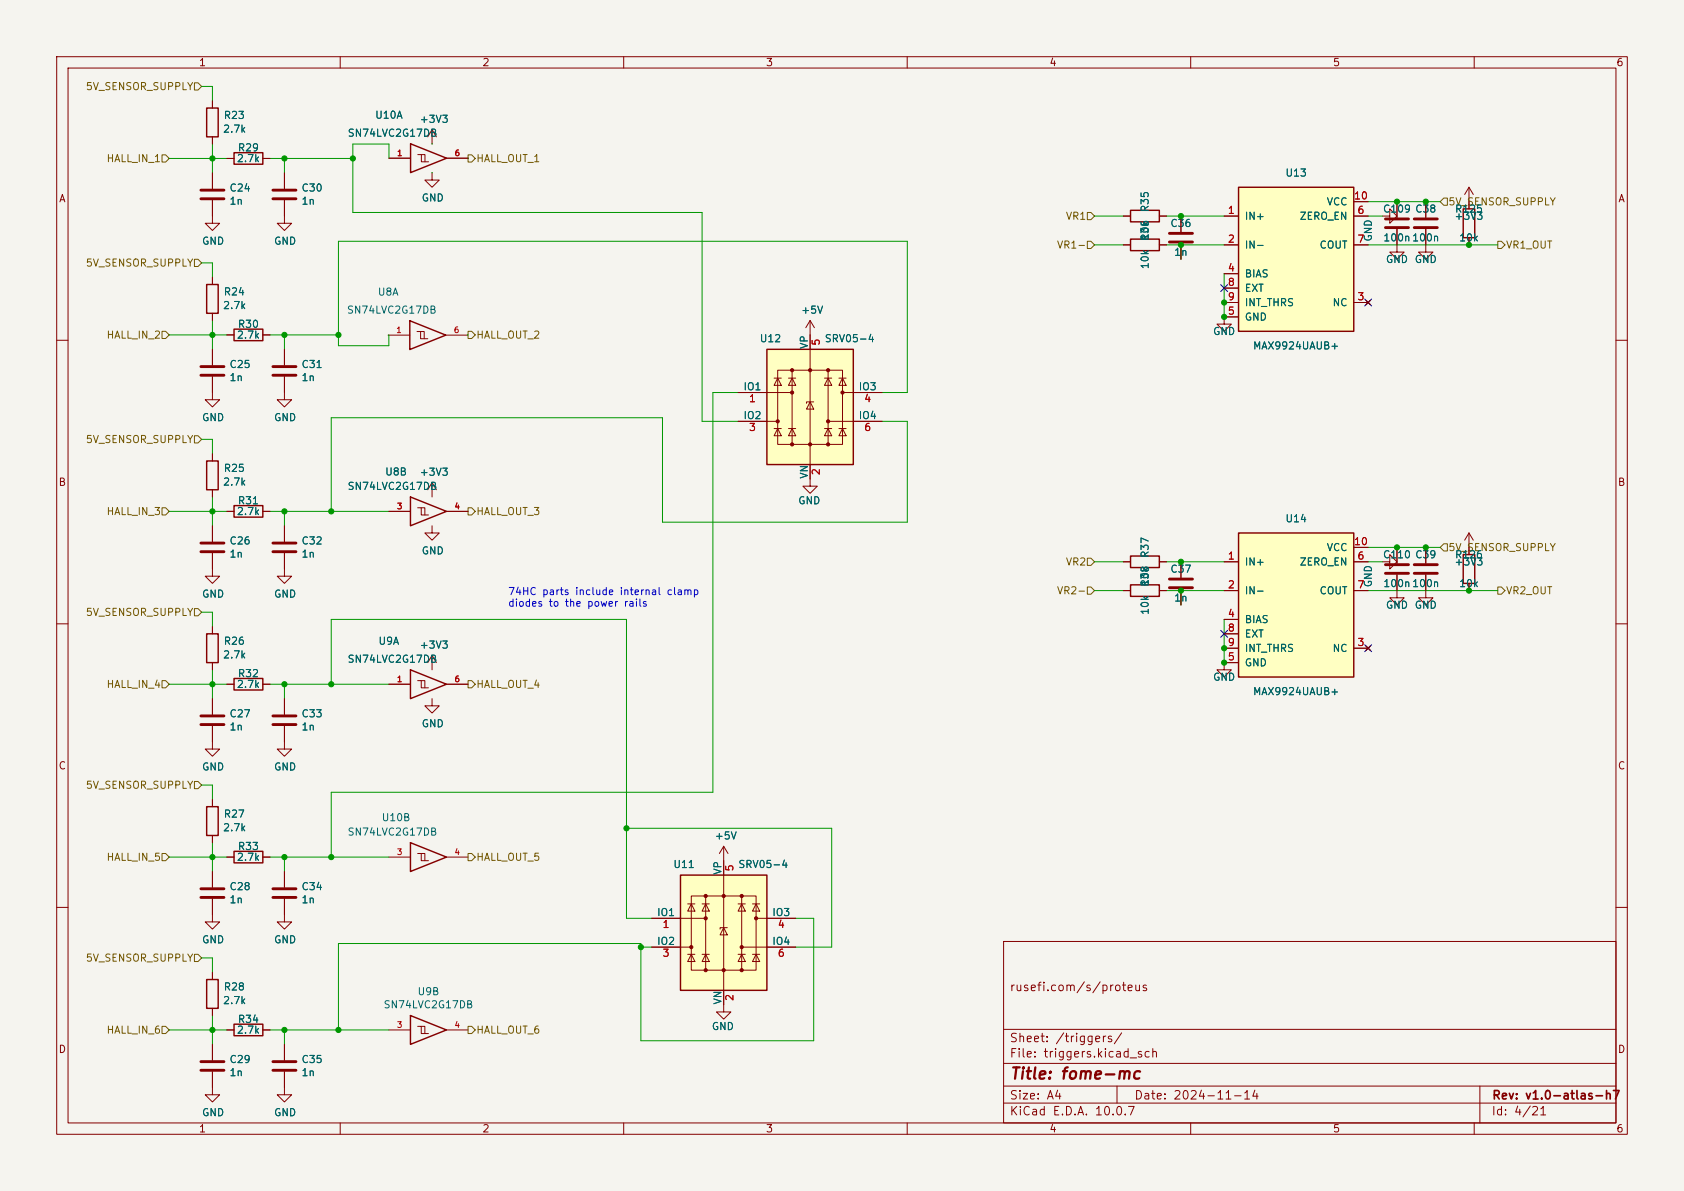
[picture p70: page 4]

74HC parts include internal clamp

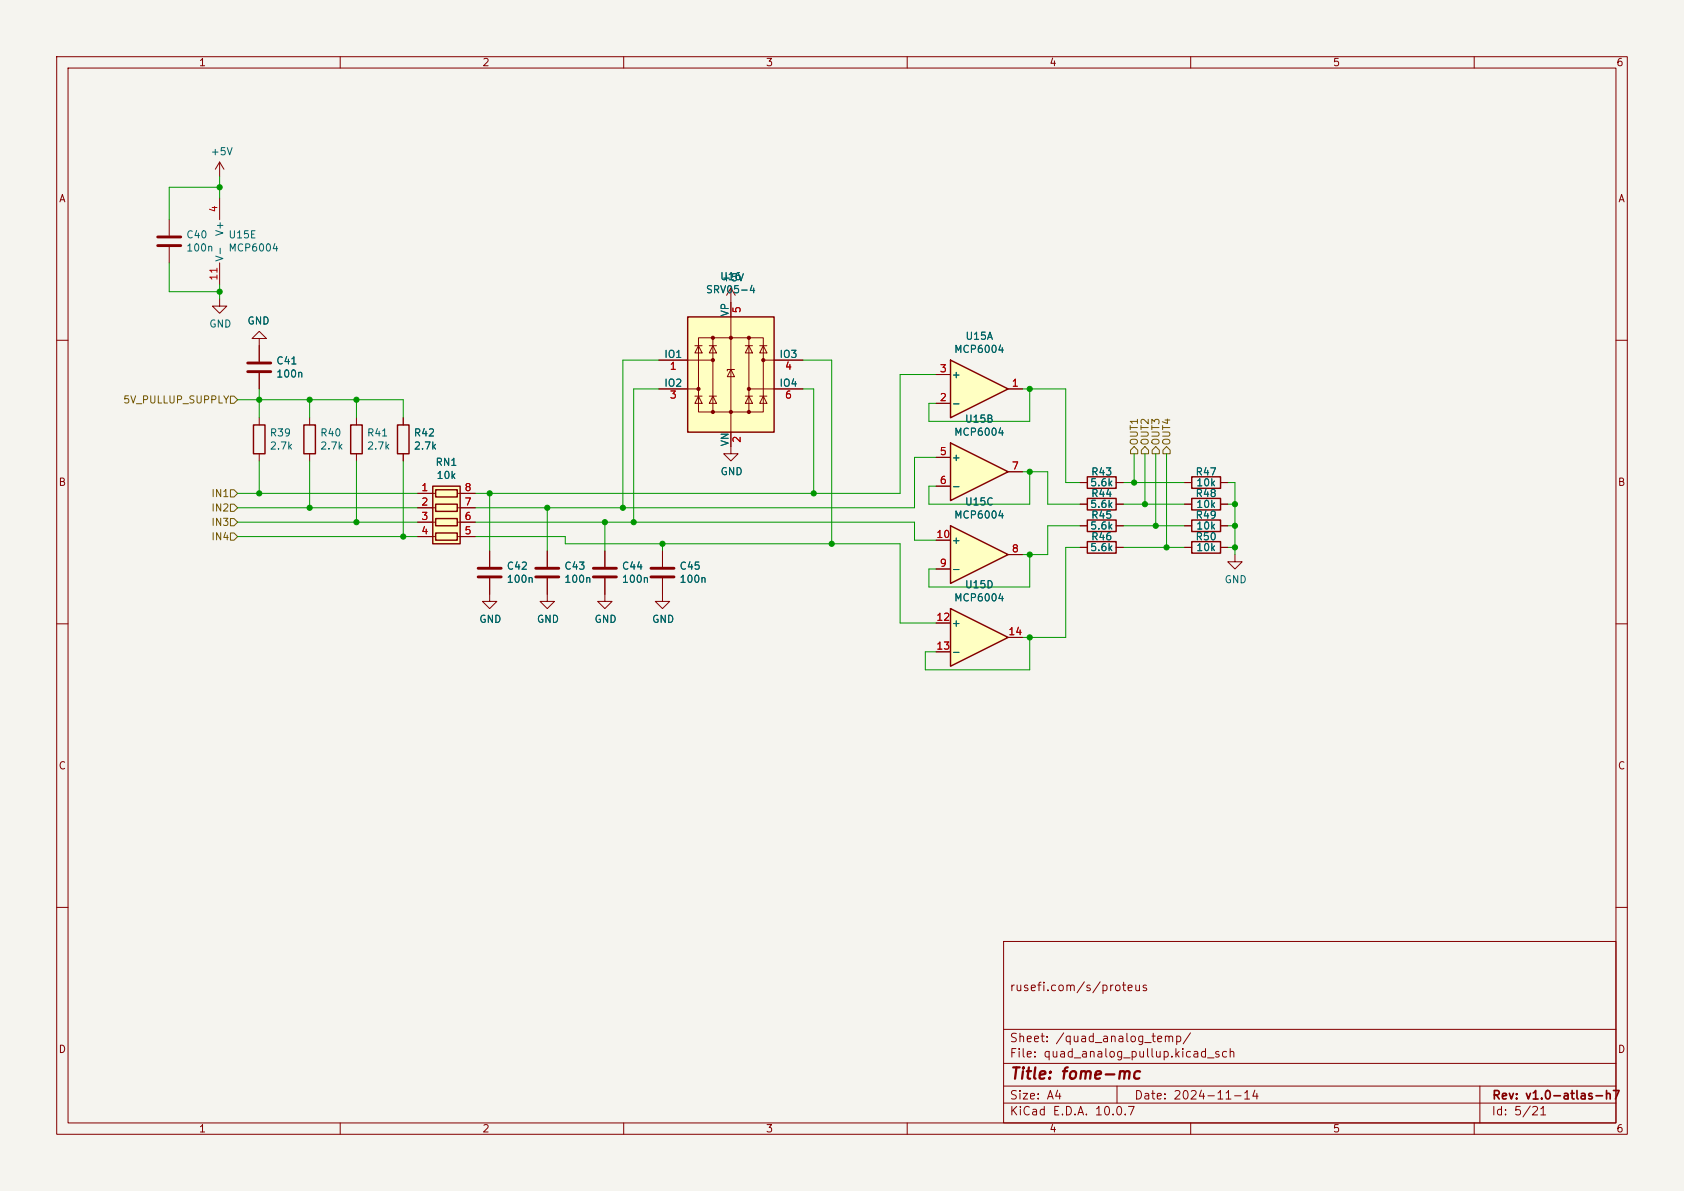
[picture p71: page 5]

7 7
6 6

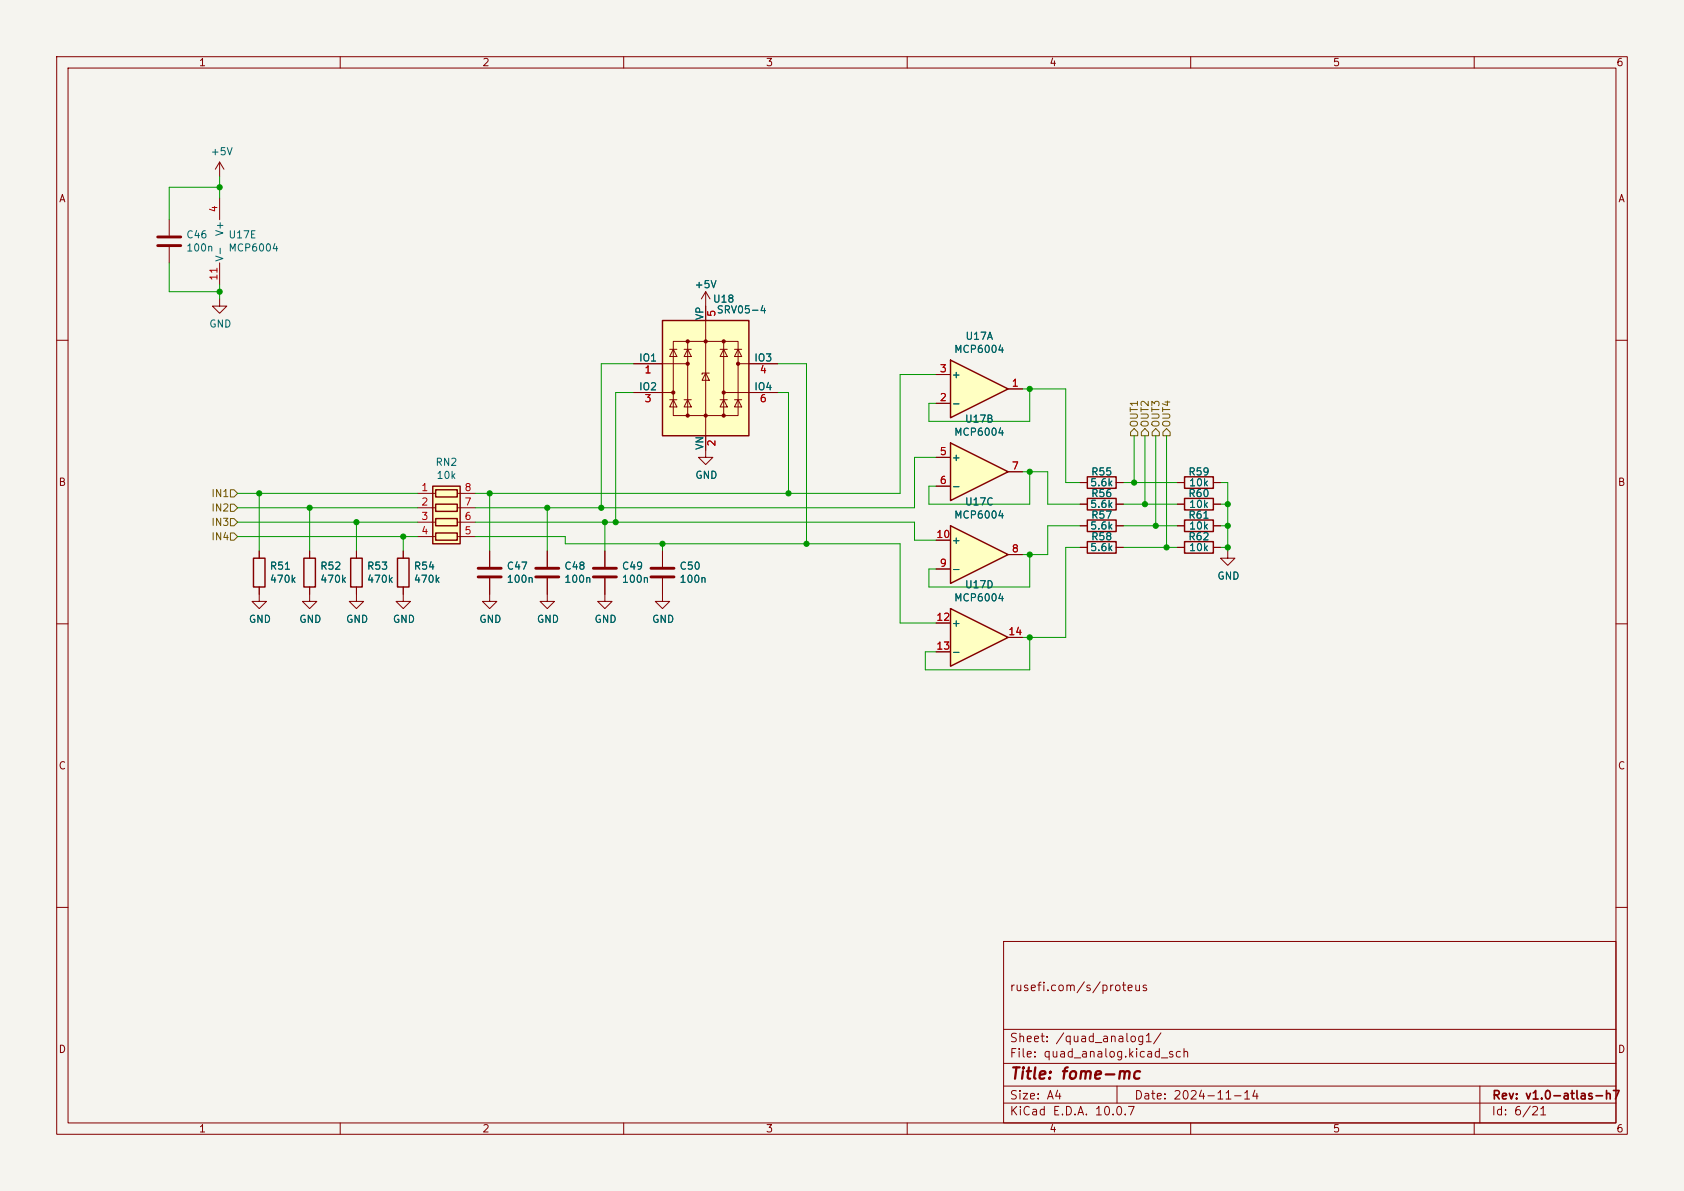
[picture p72: page 6]

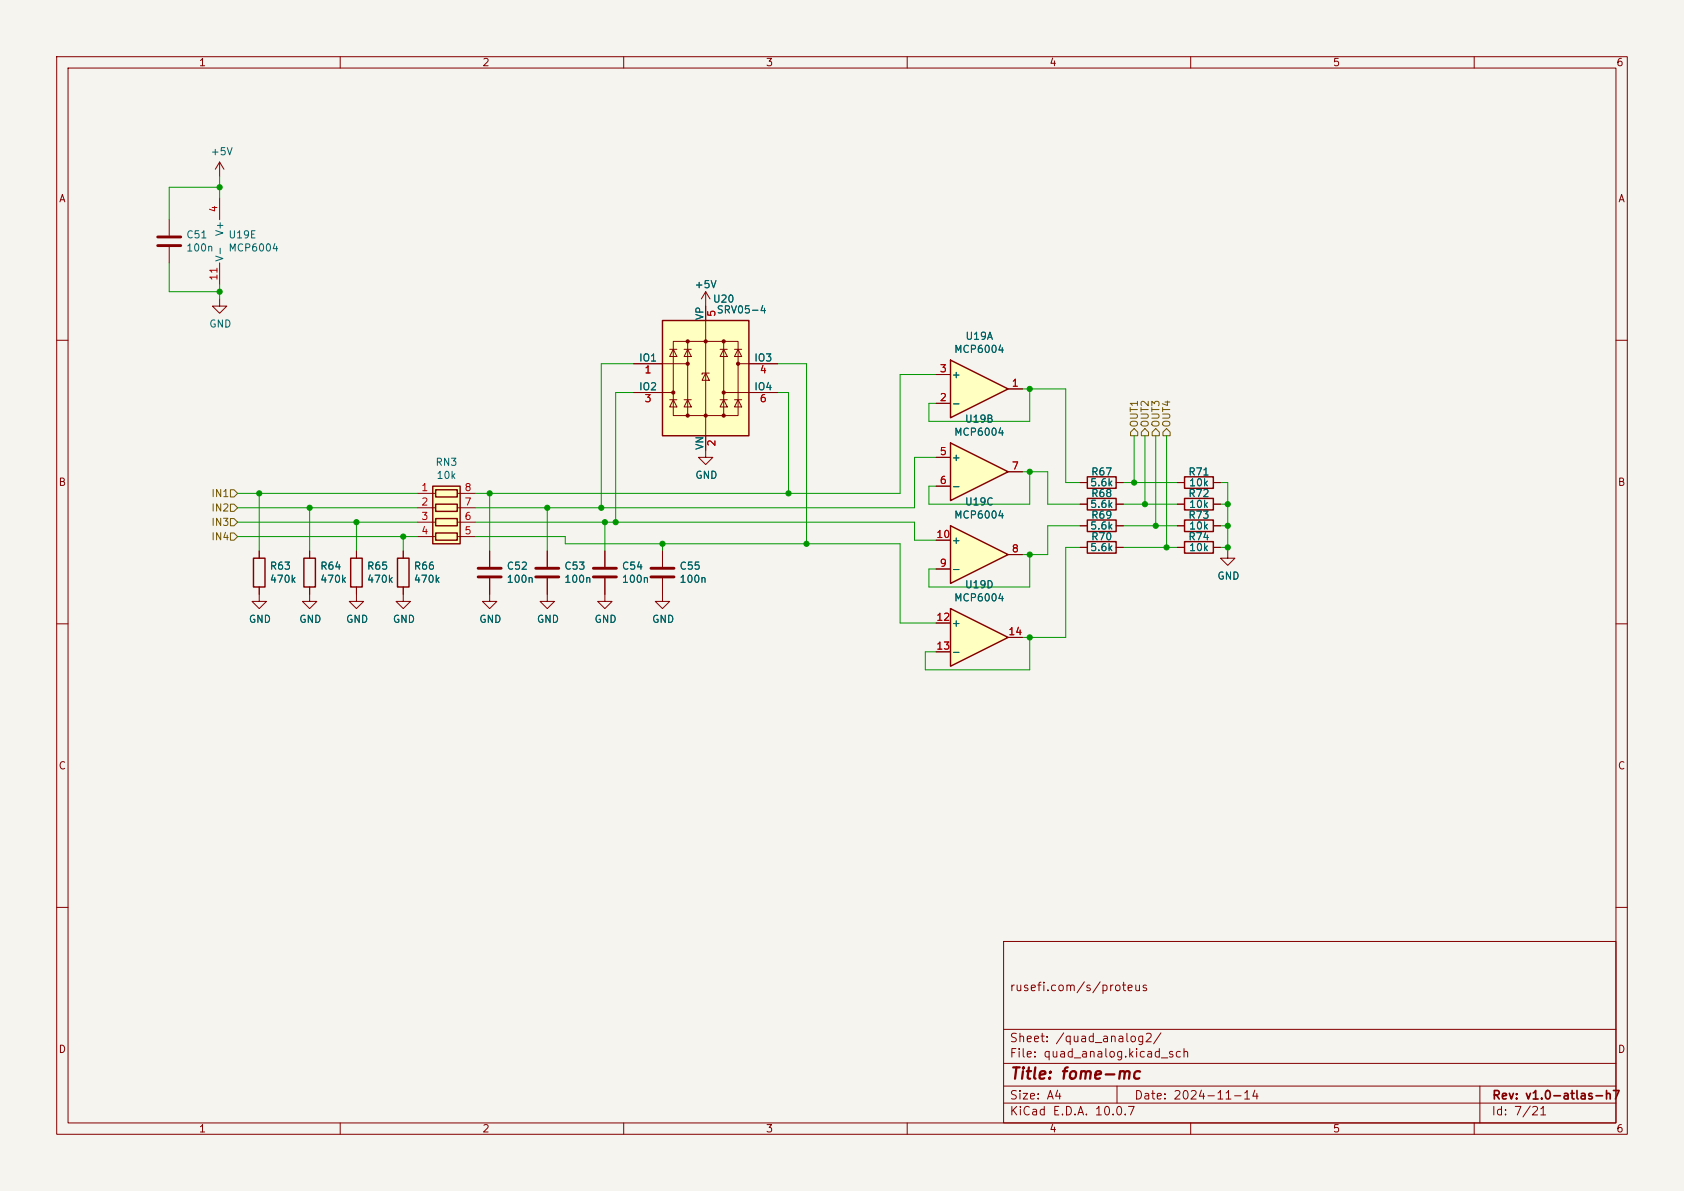
[picture p73: page 7]

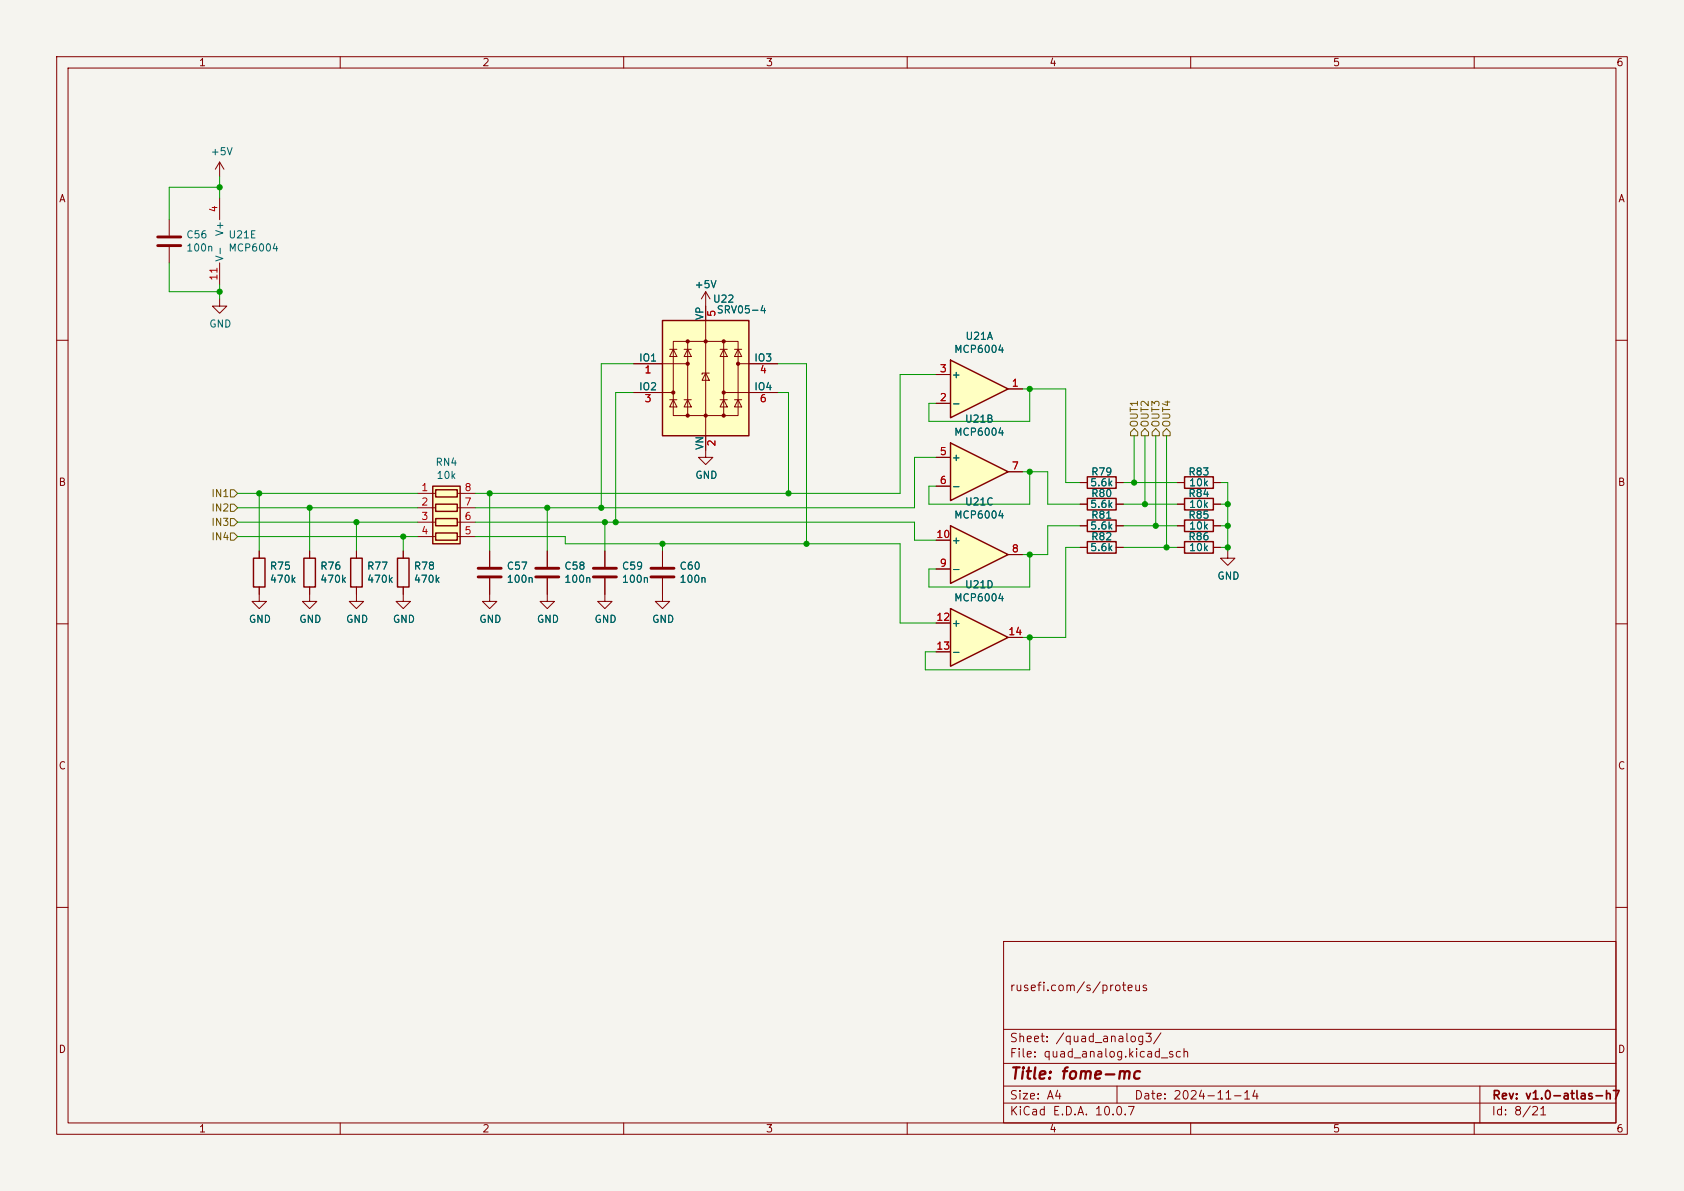
[picture p74: page 8]

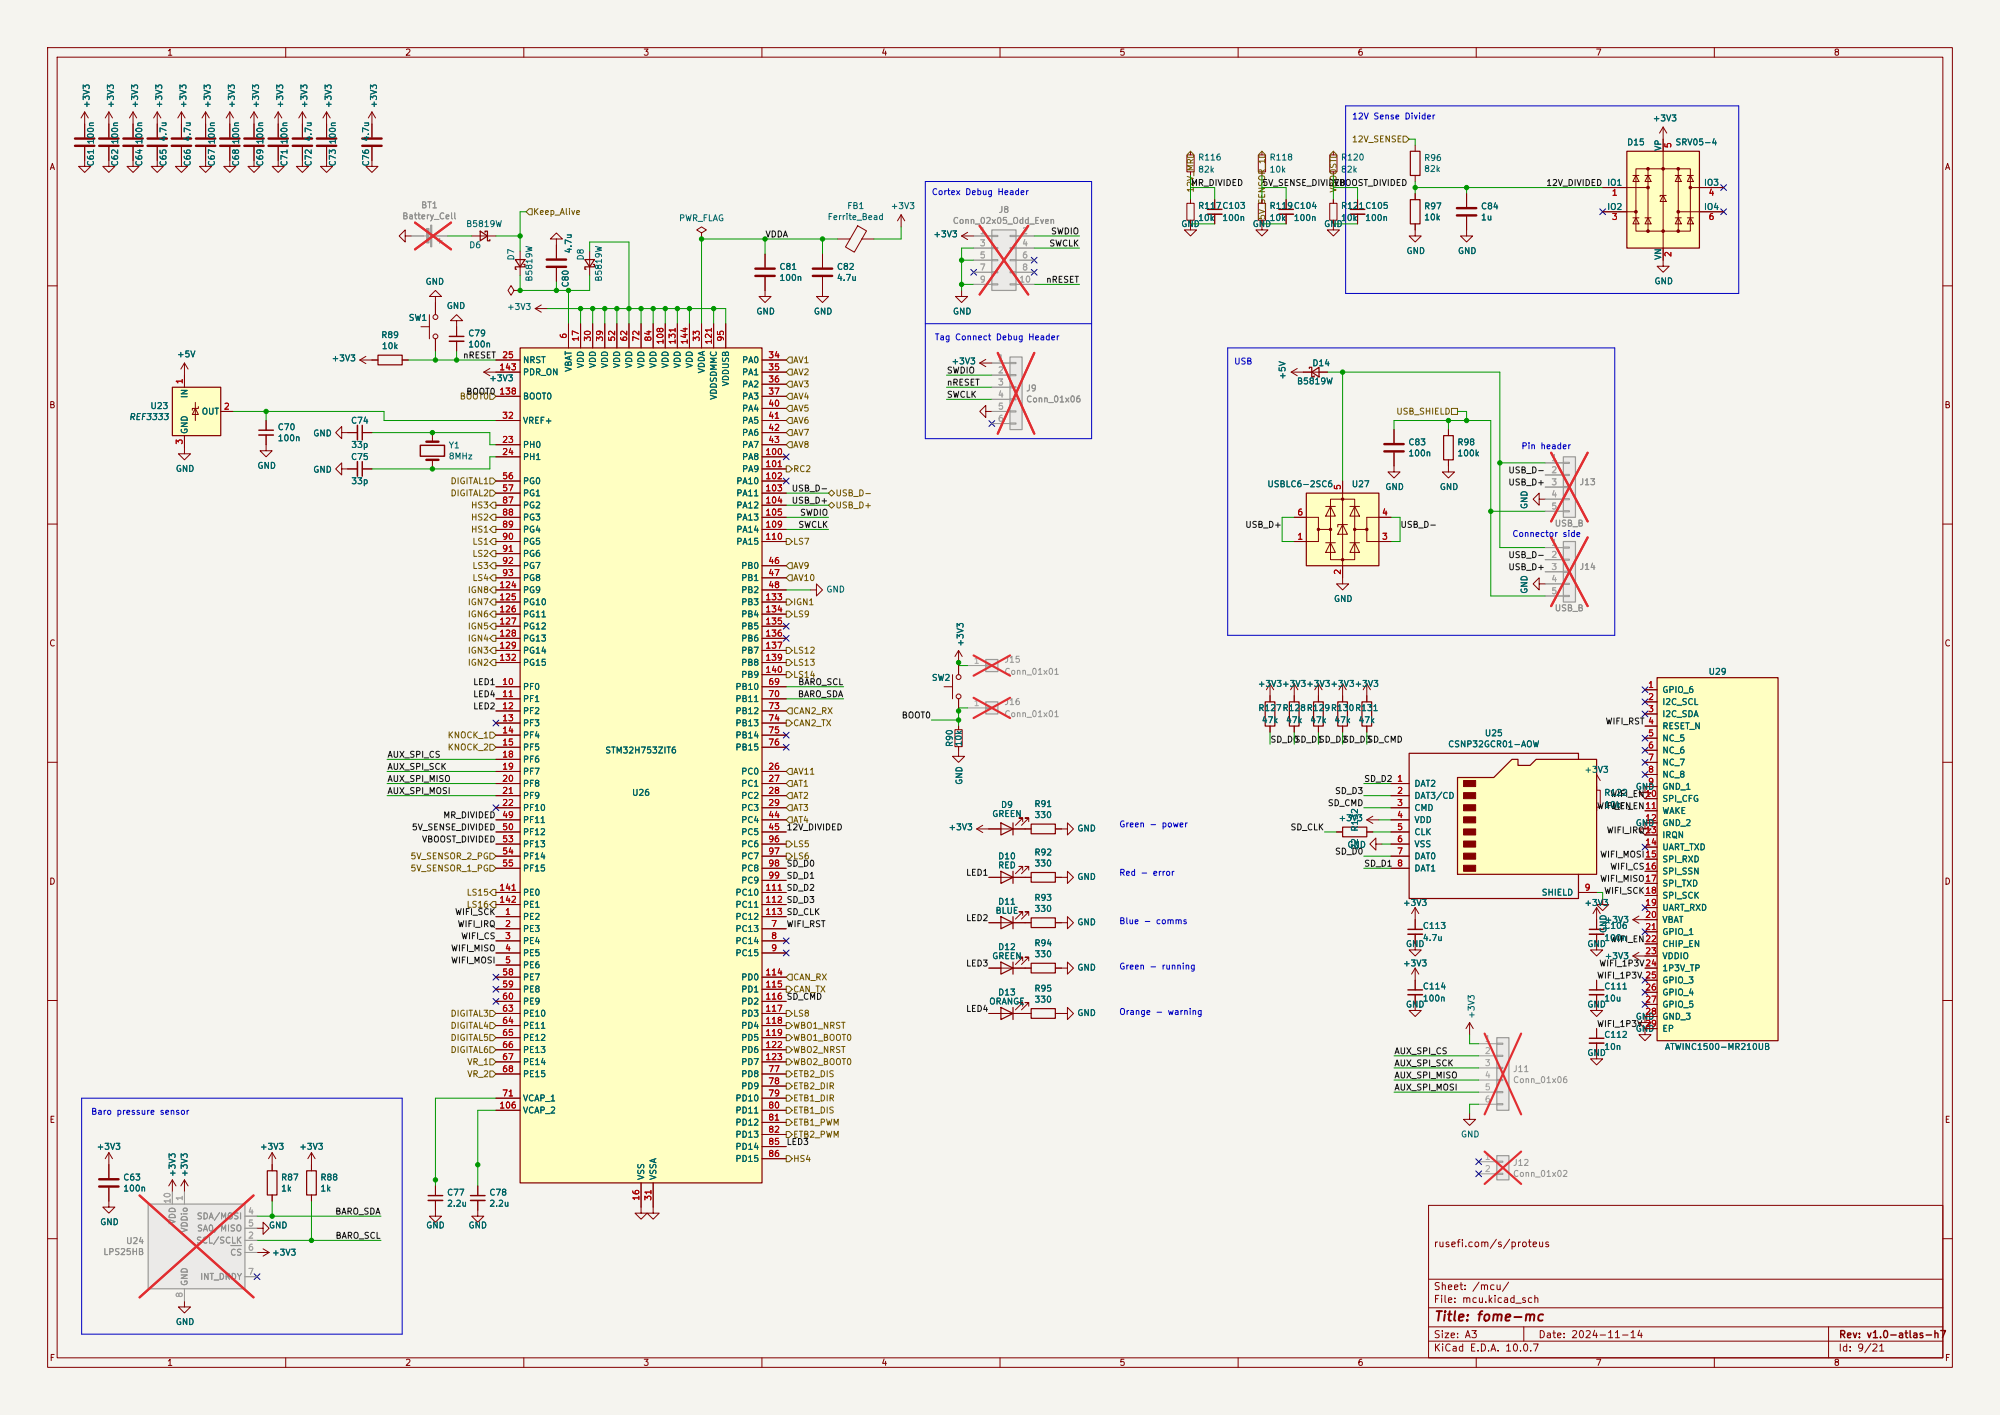
[picture p75: page 9]

Connector side Cortex Debug Header

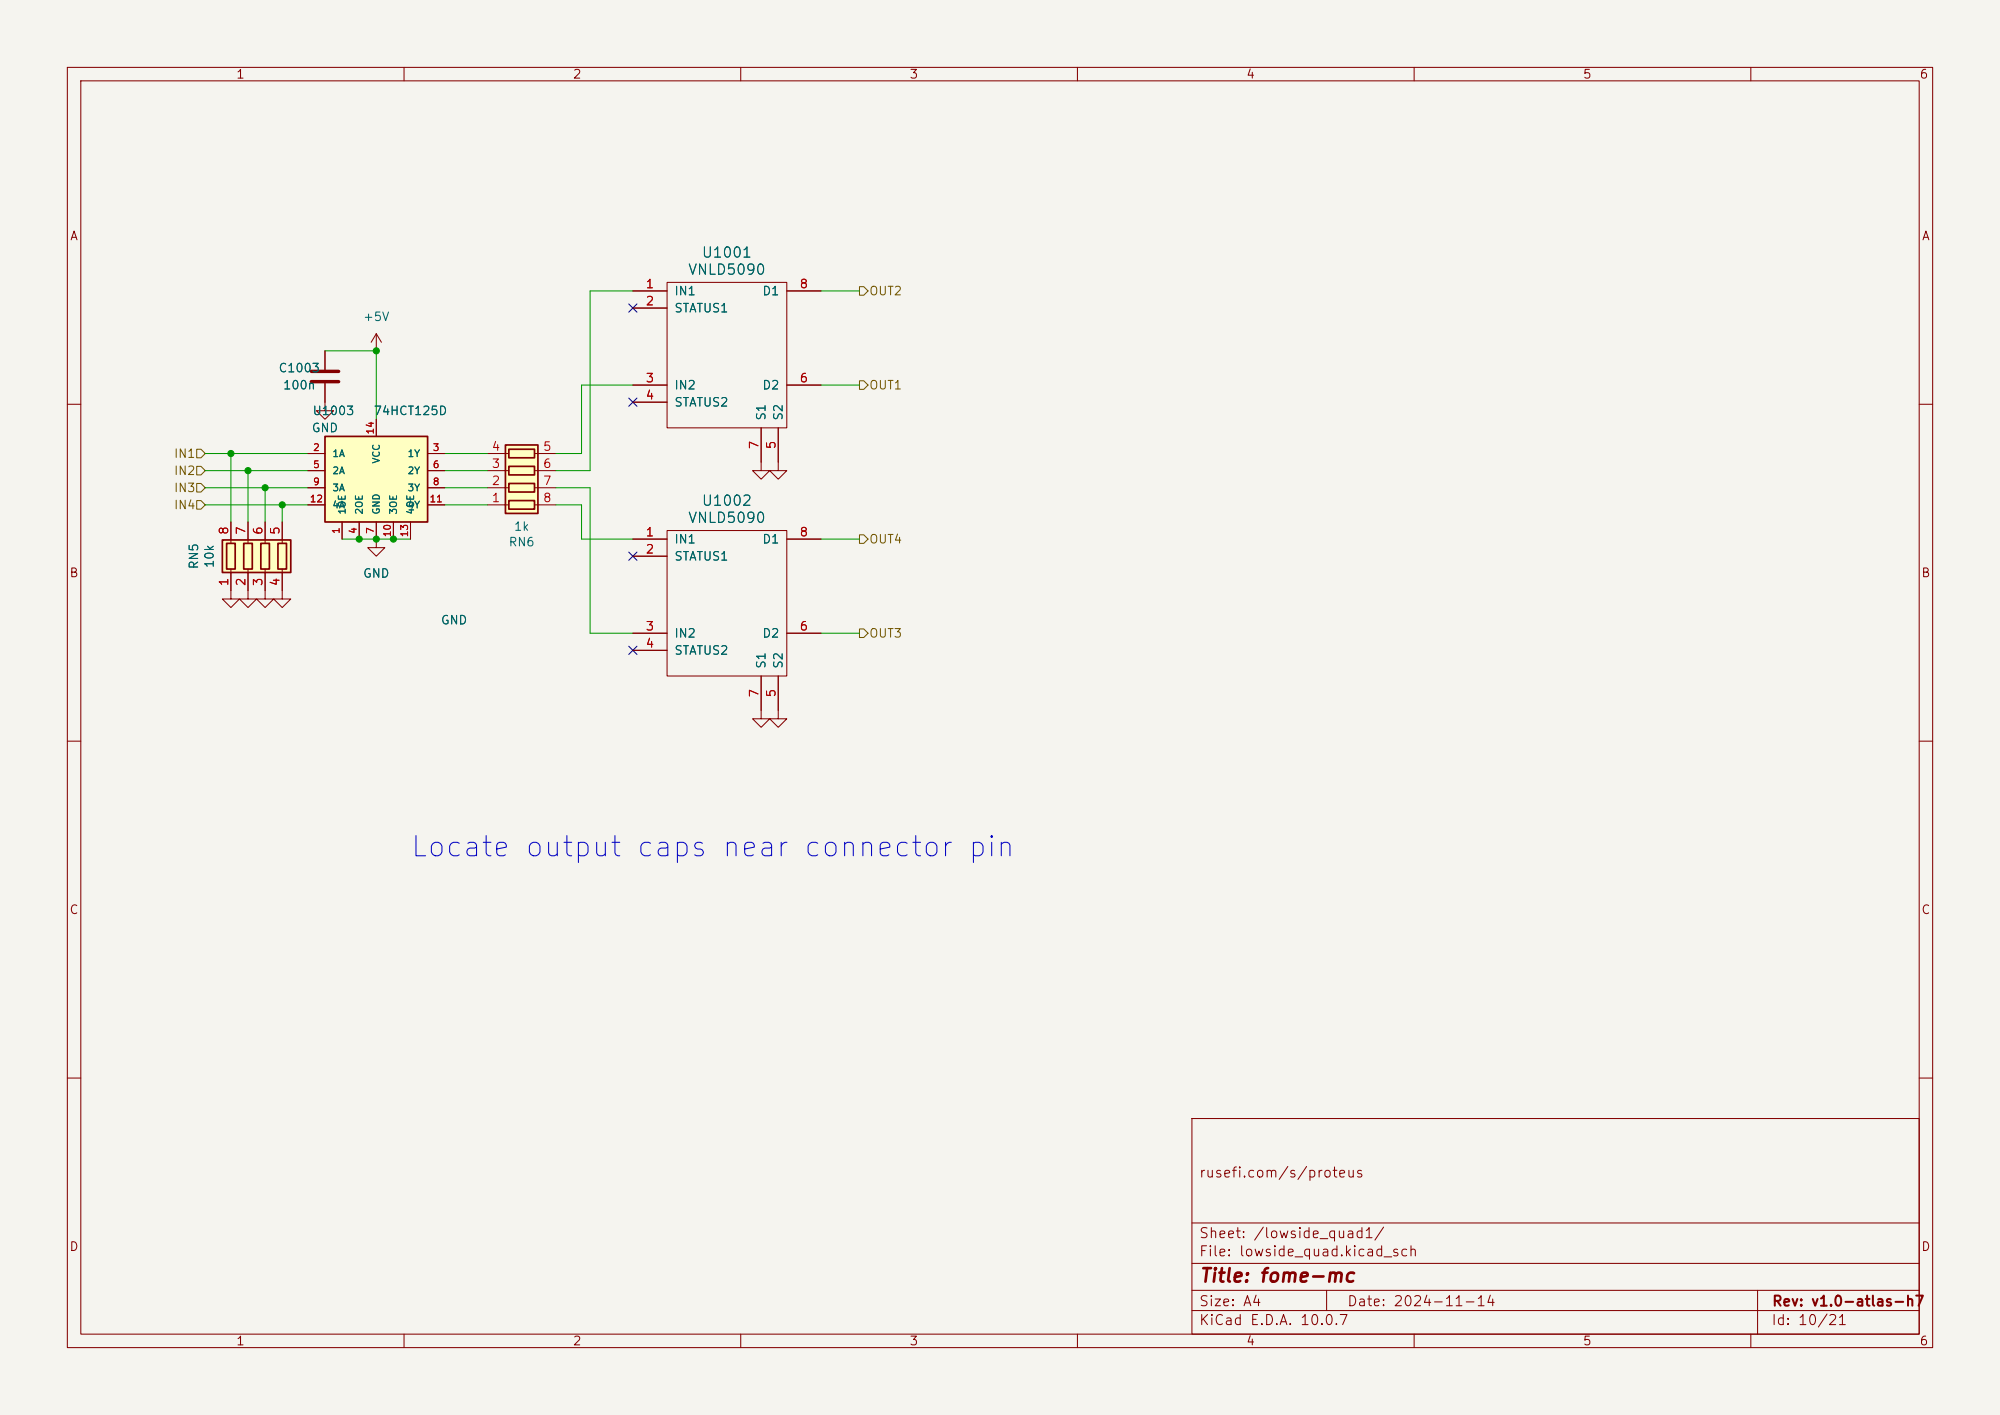
[picture p76: page 10]

rusefi.com/s/proteus GND

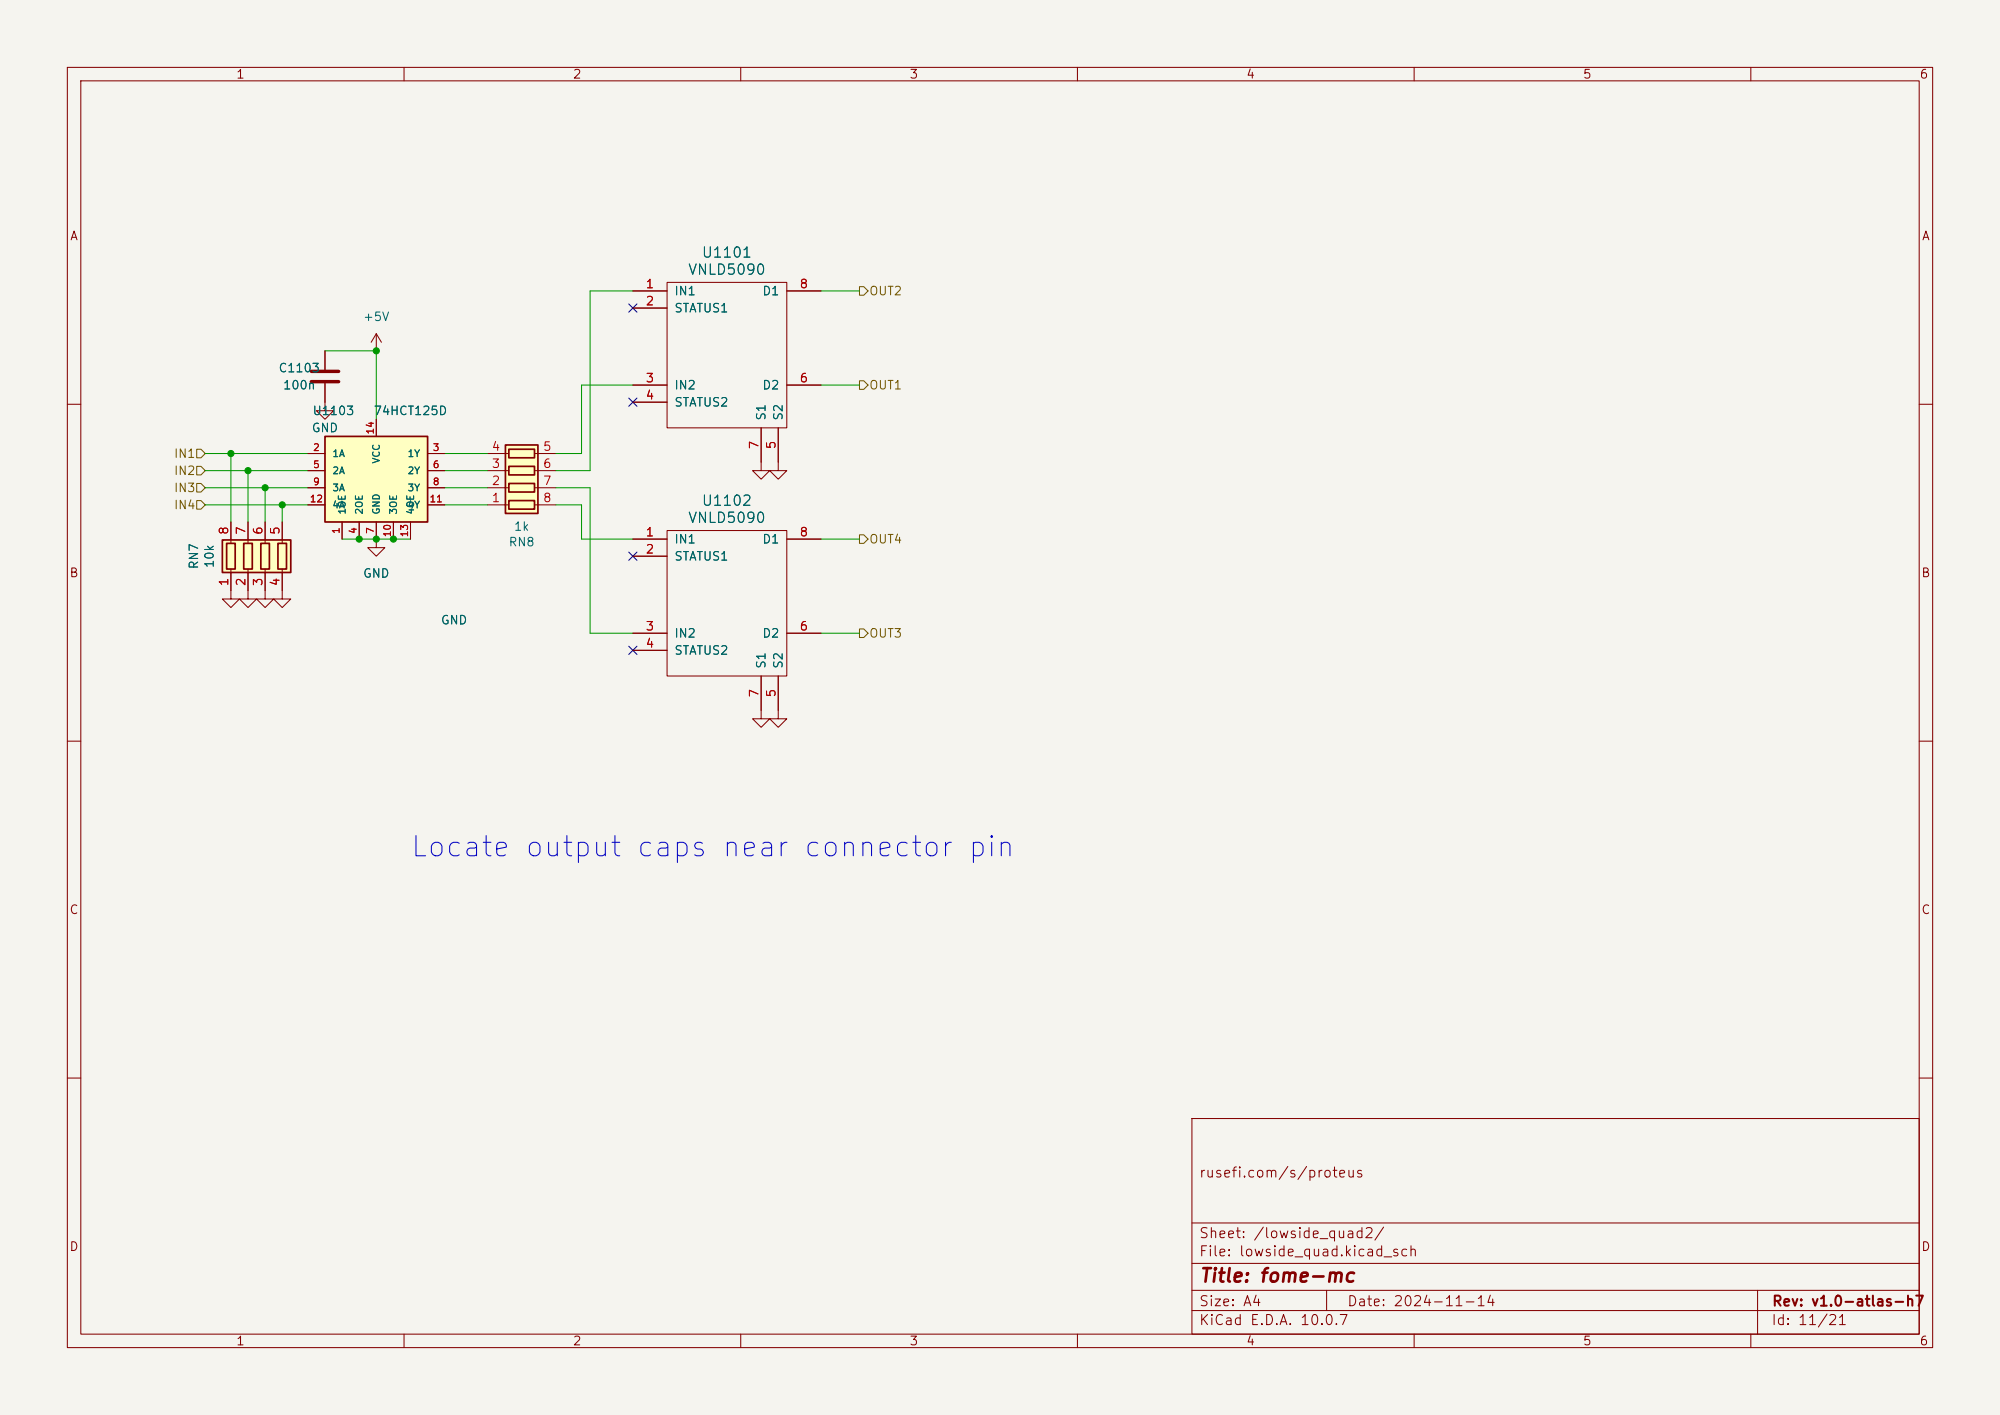
[picture p77: page 11]

rusefi.com/s/proteus GND

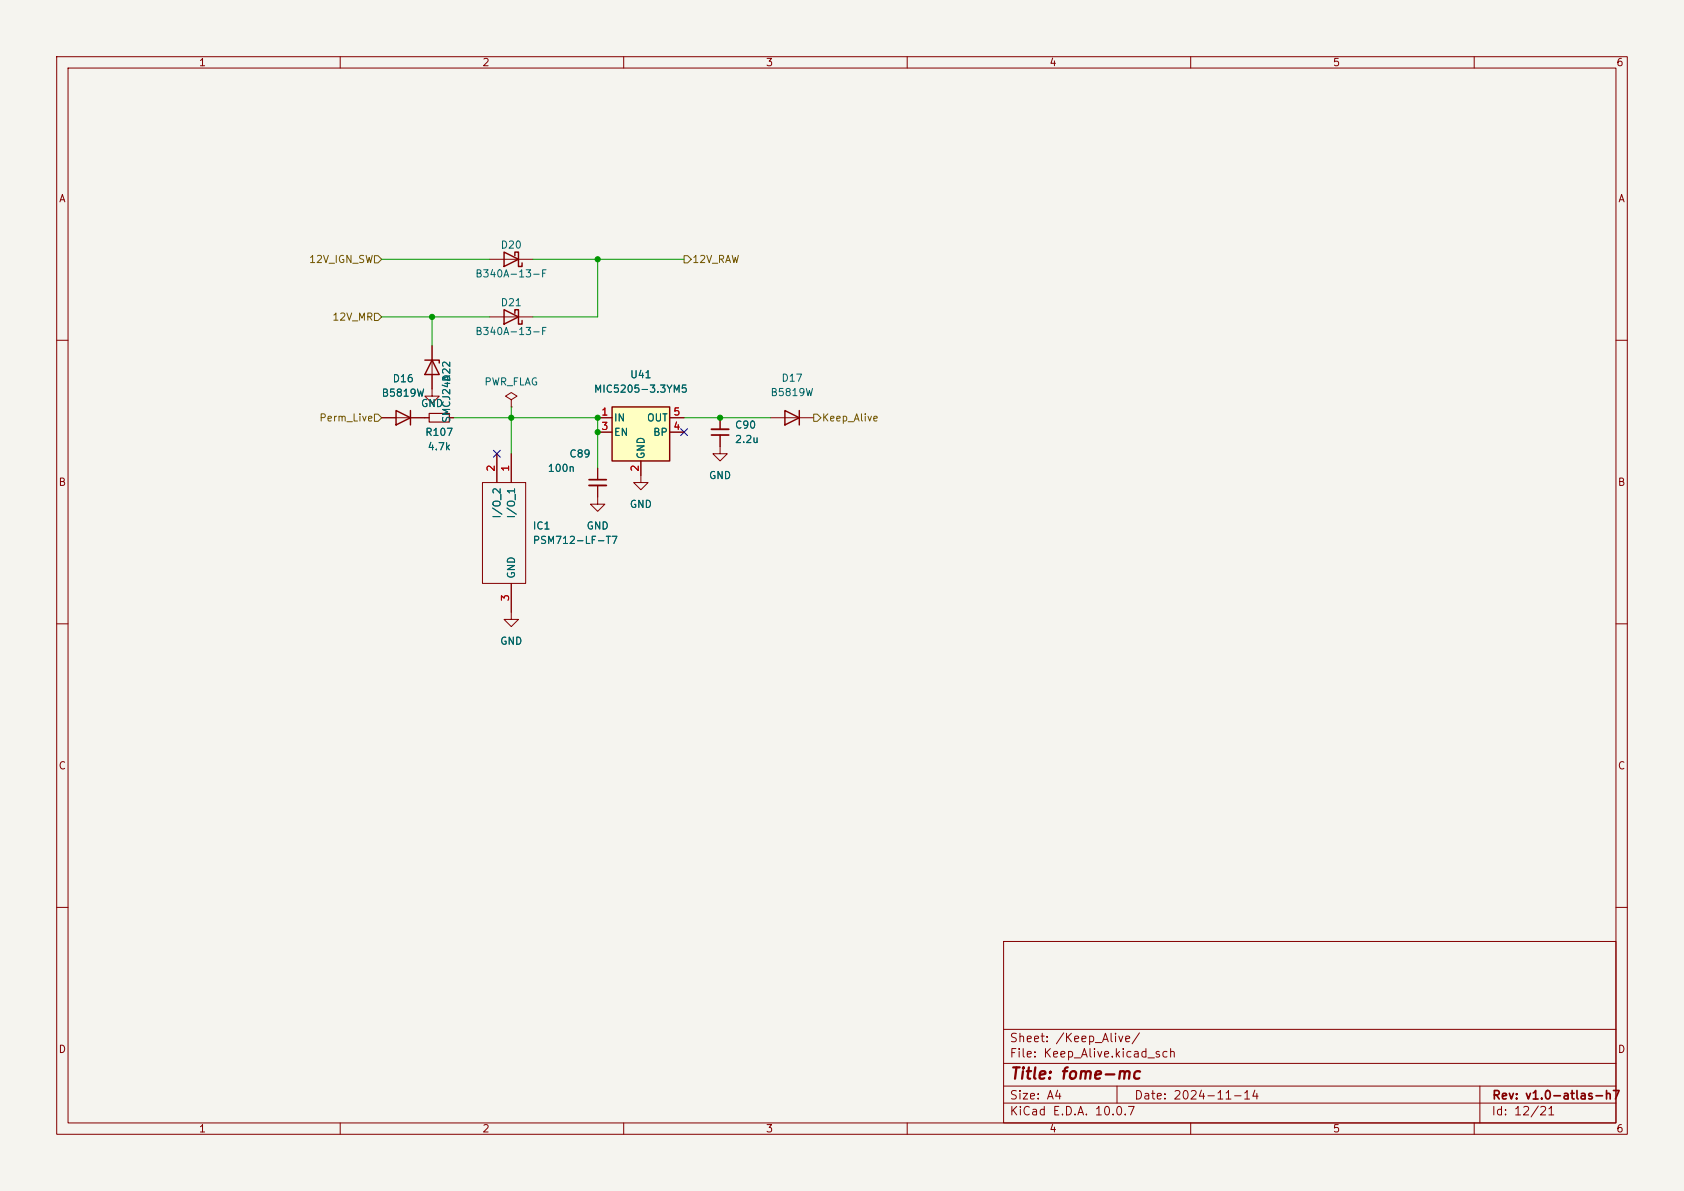
[picture p78: page 12]

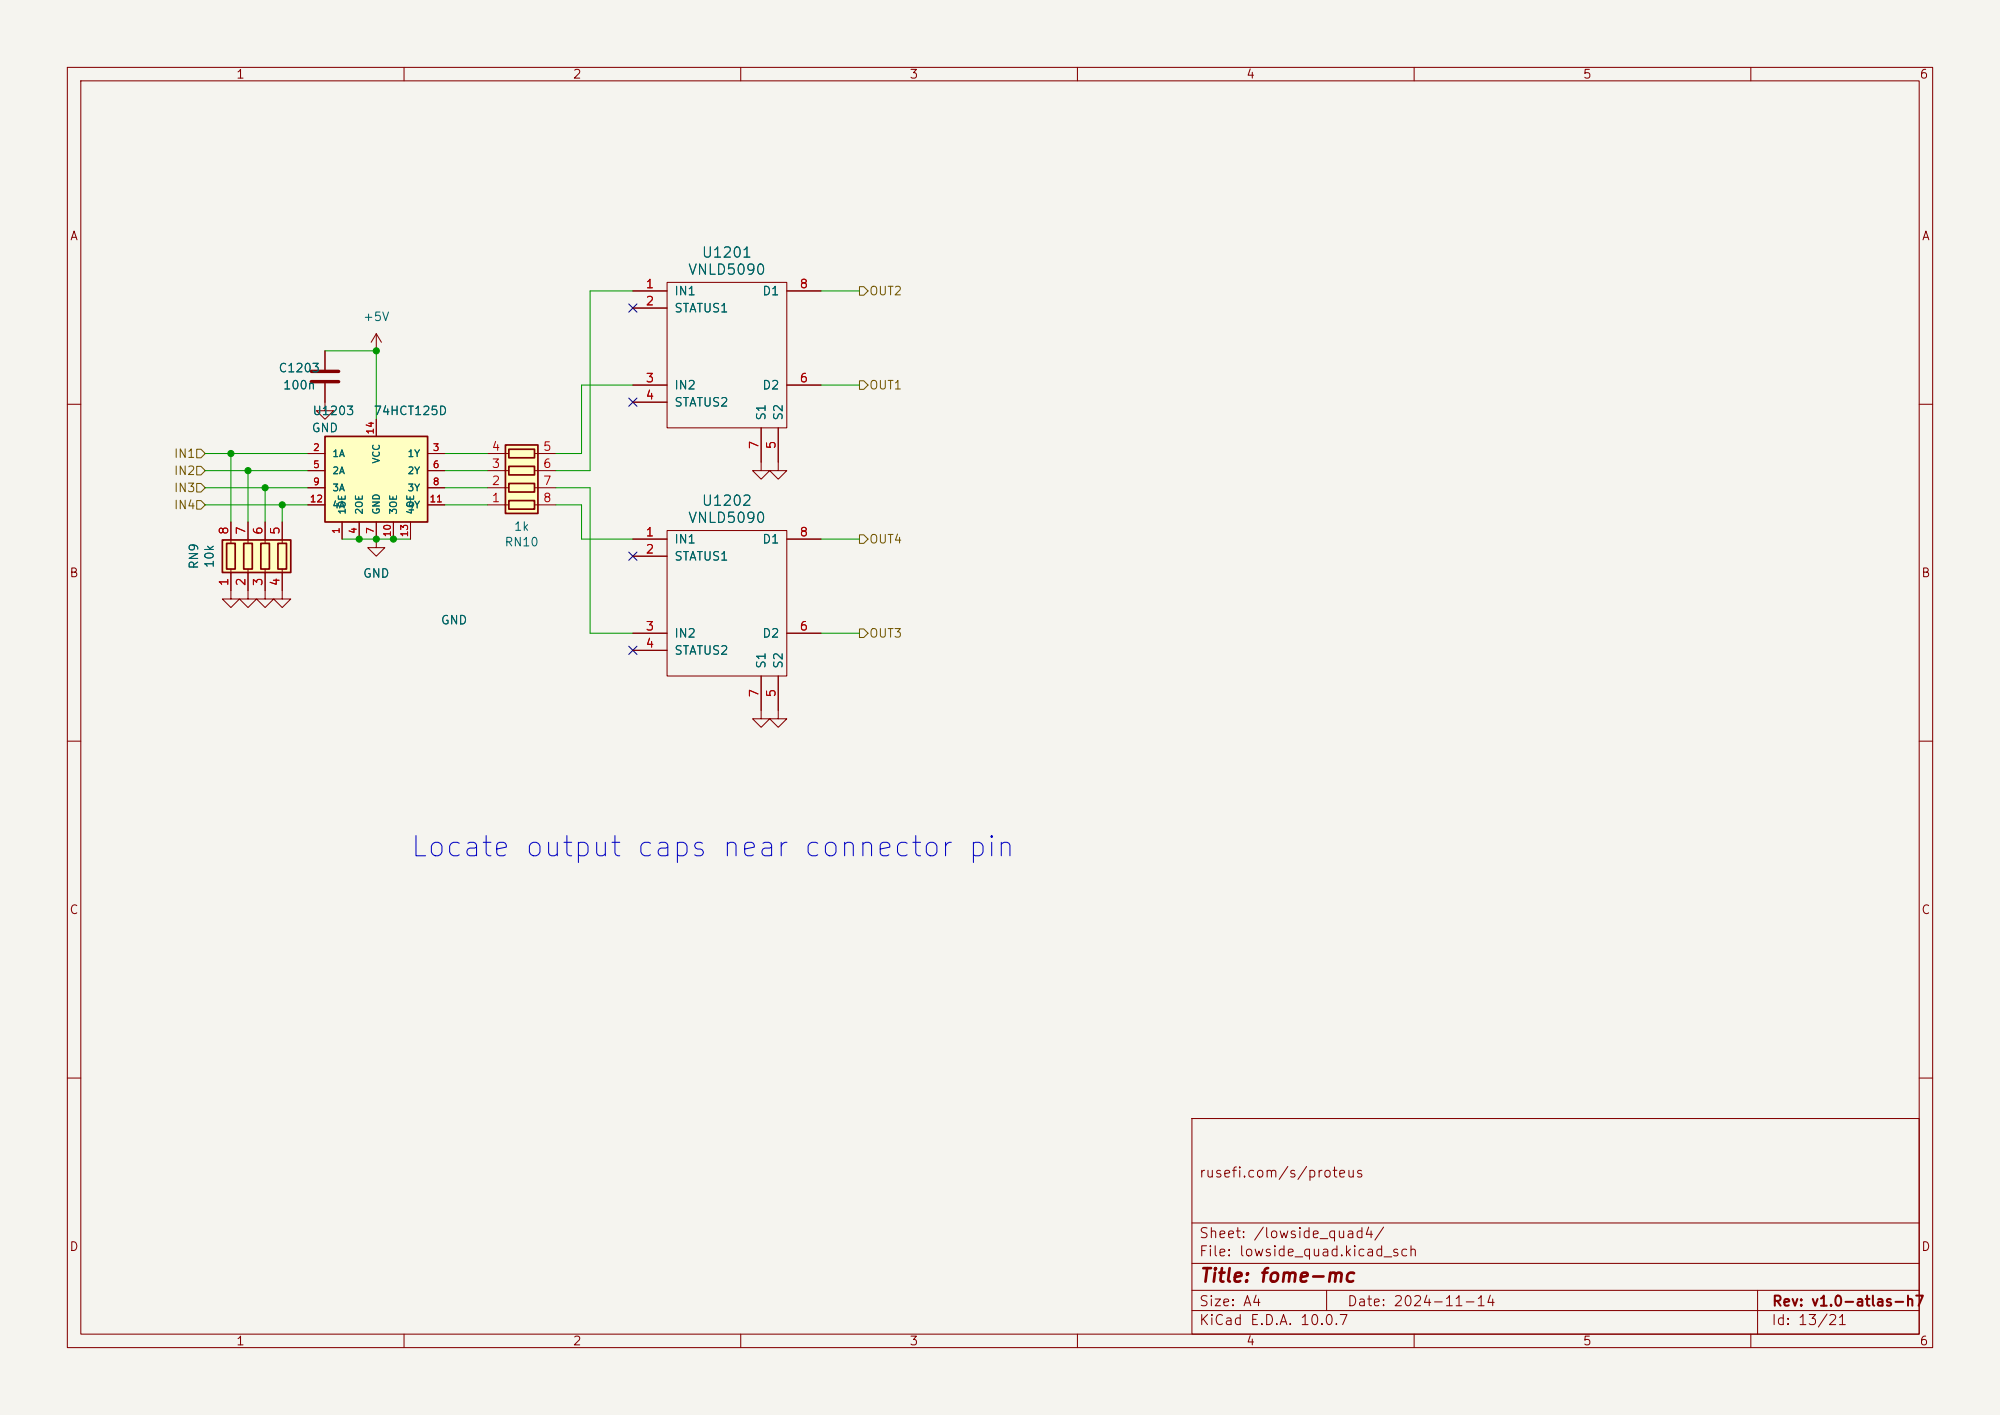
[picture p79: page 13]

rusefi.com/s/proteus GND

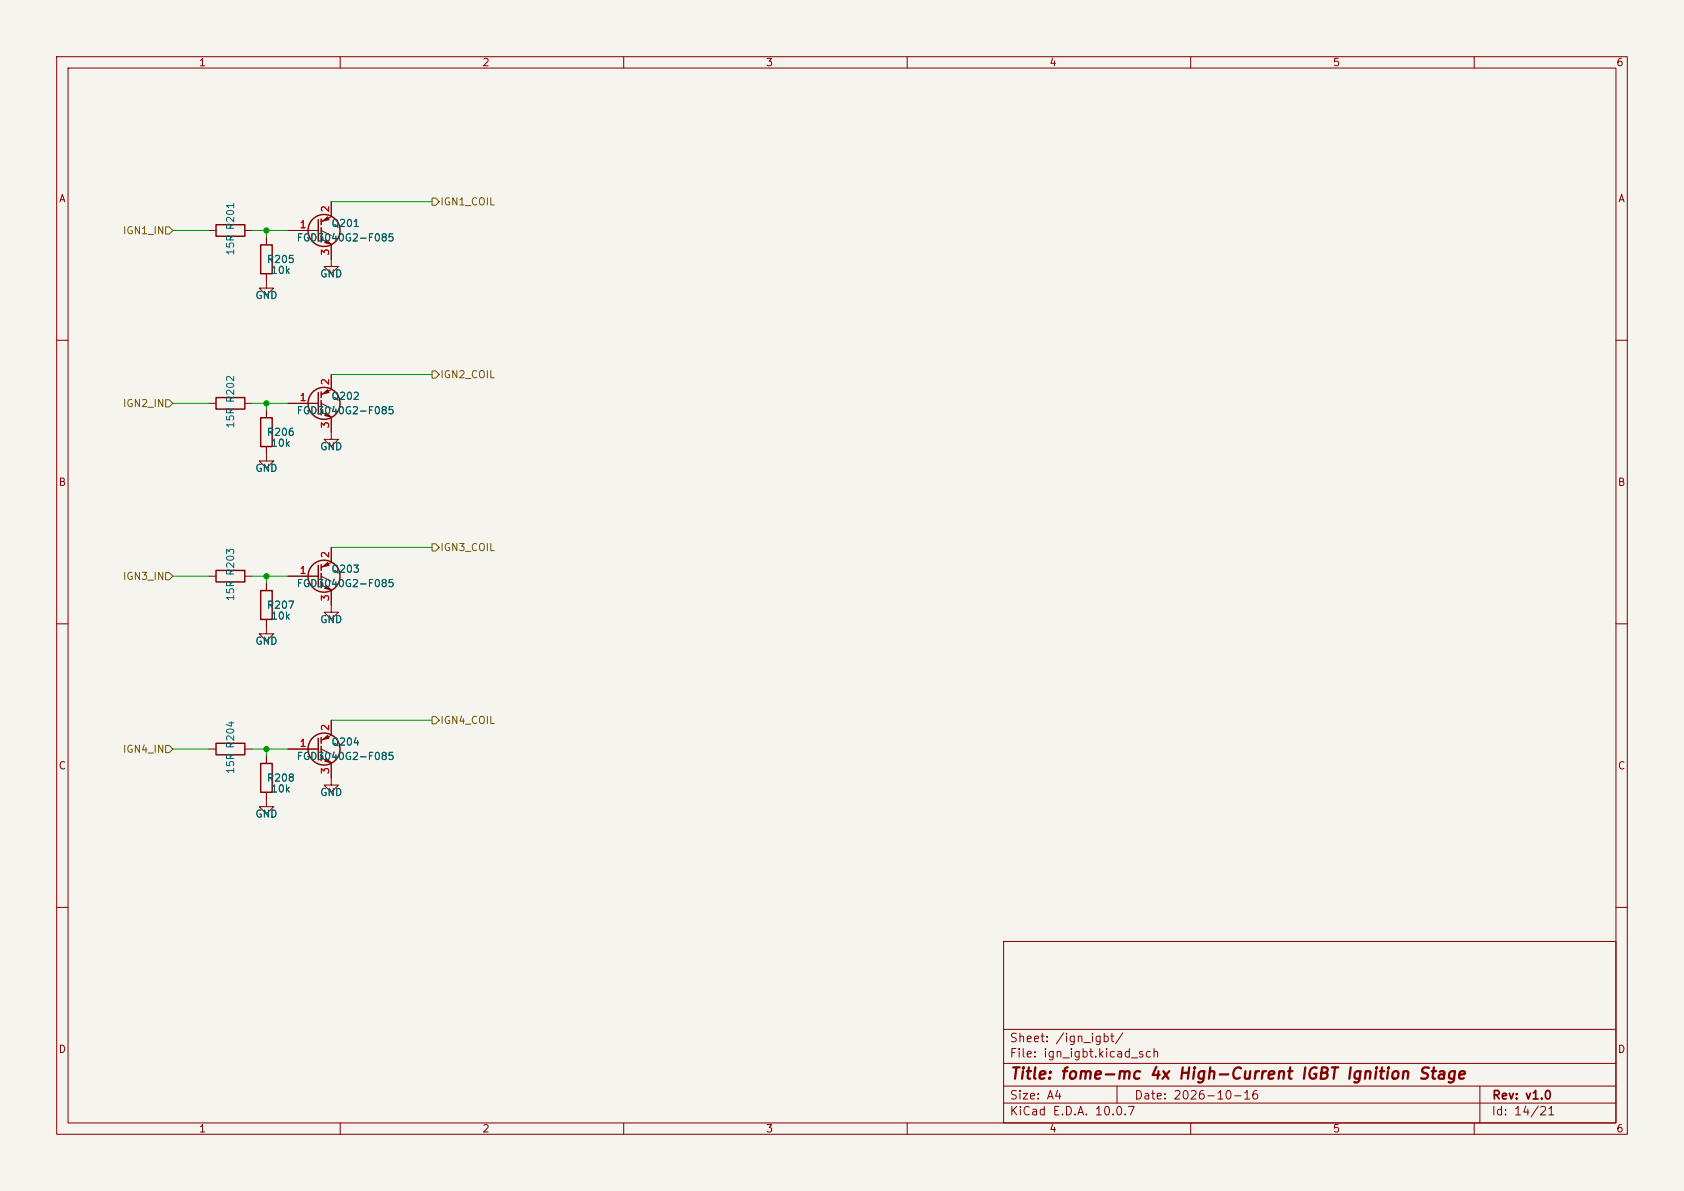
[picture p80: page 14]

File: ign_igbt.kicad_sch
Title: fome-mc 4x High-Current IGBT Ignition Stage

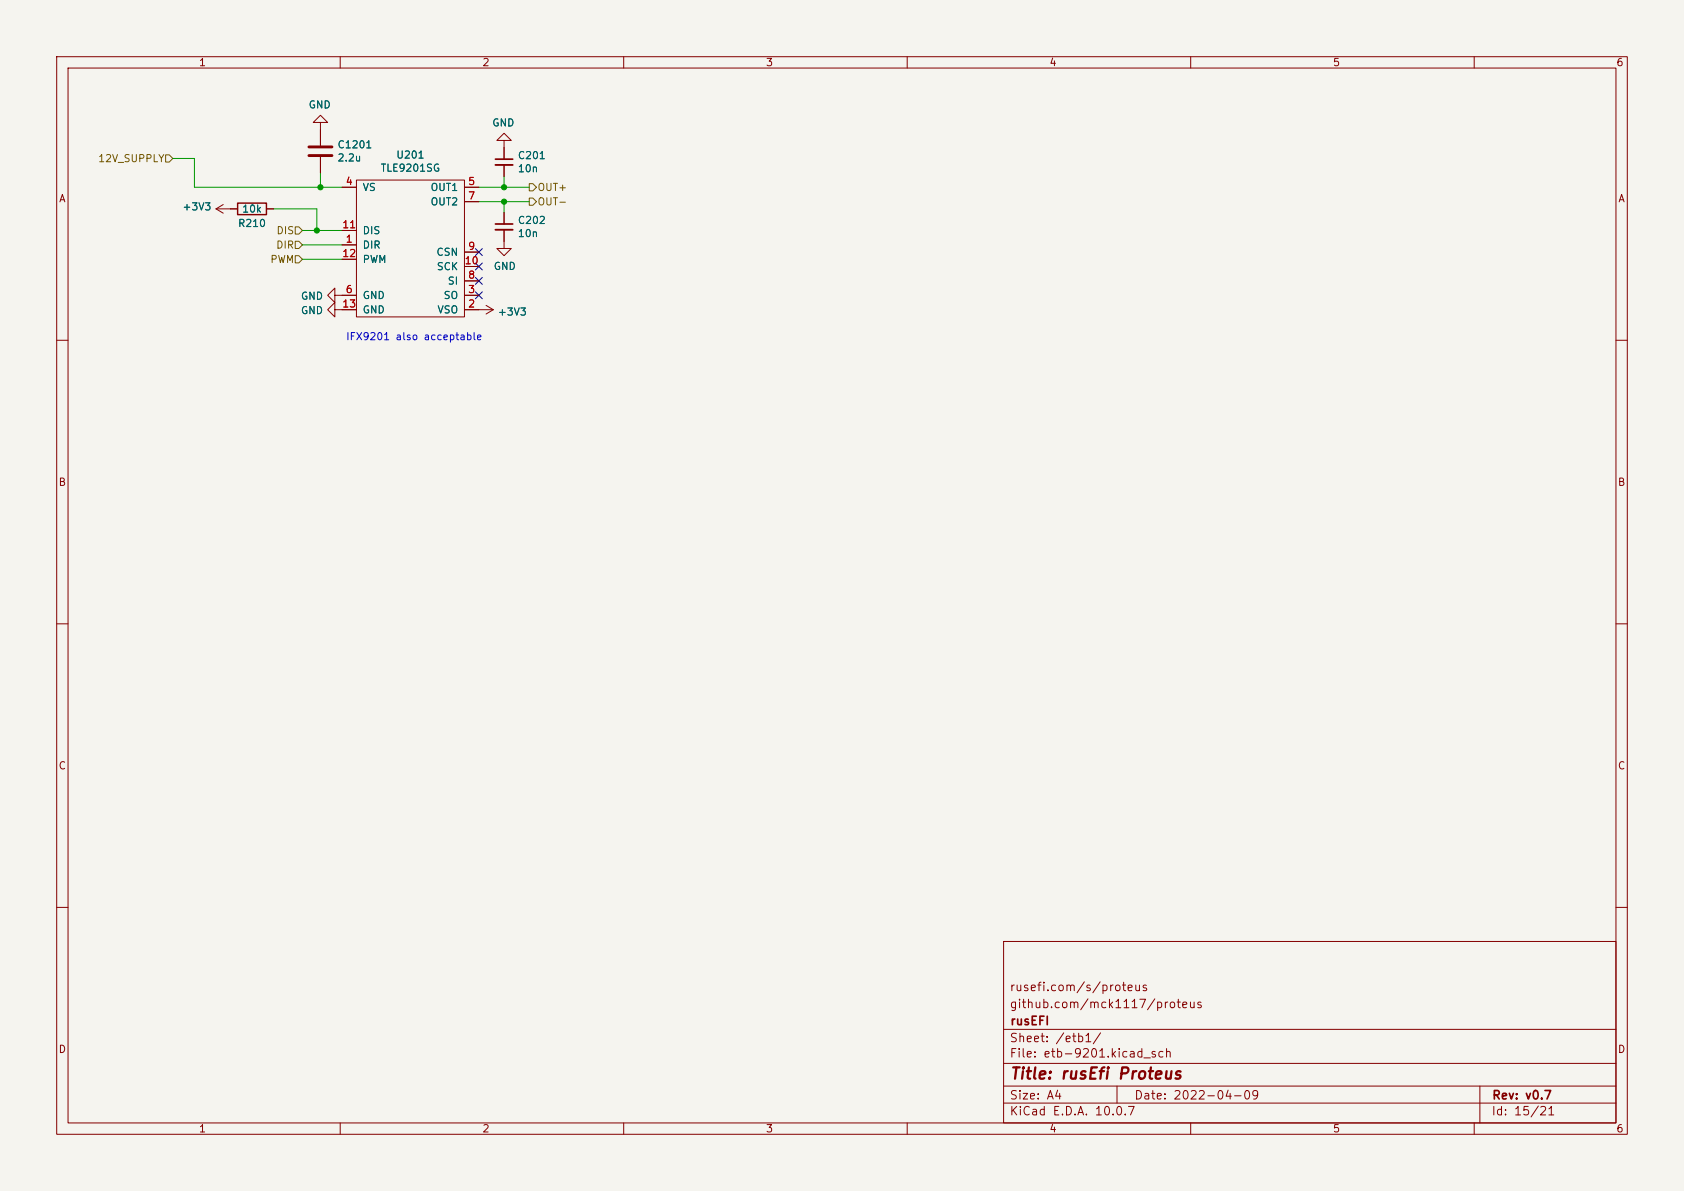
[picture p81: page 15]

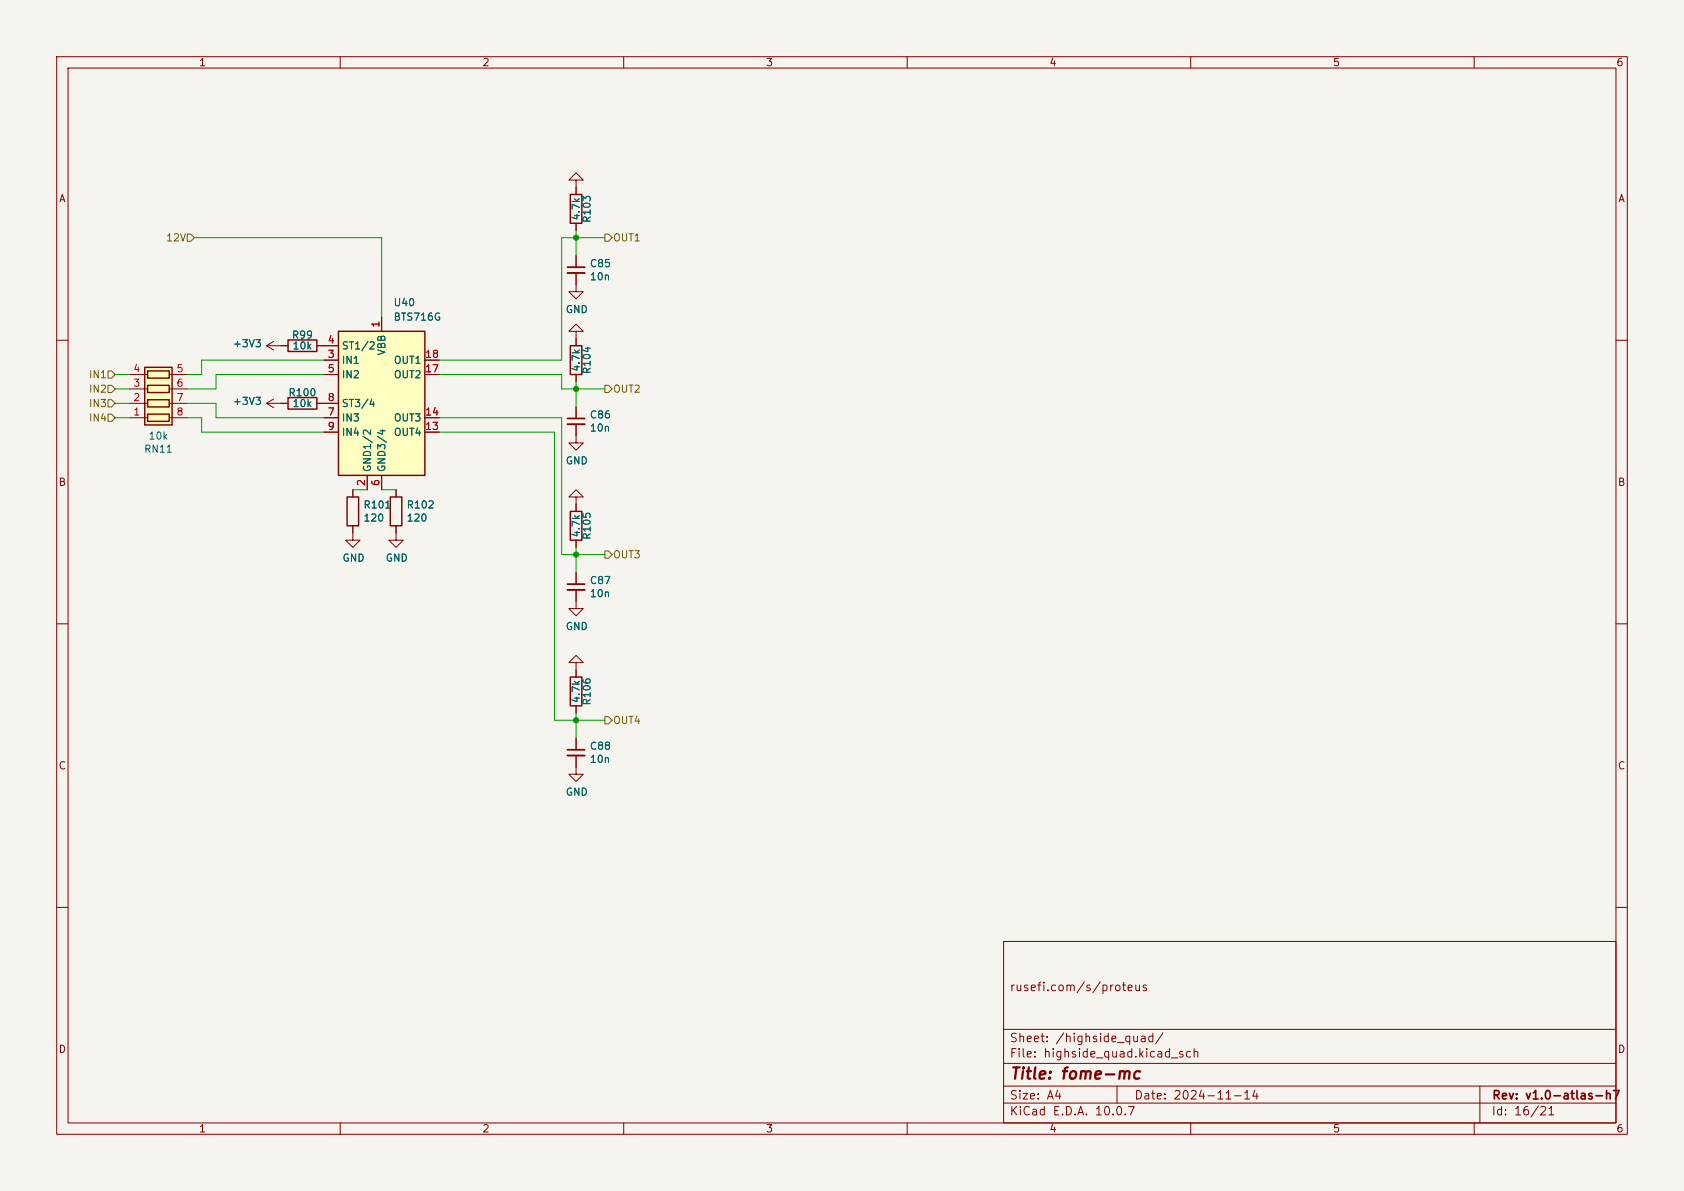
[picture p82: page 16]

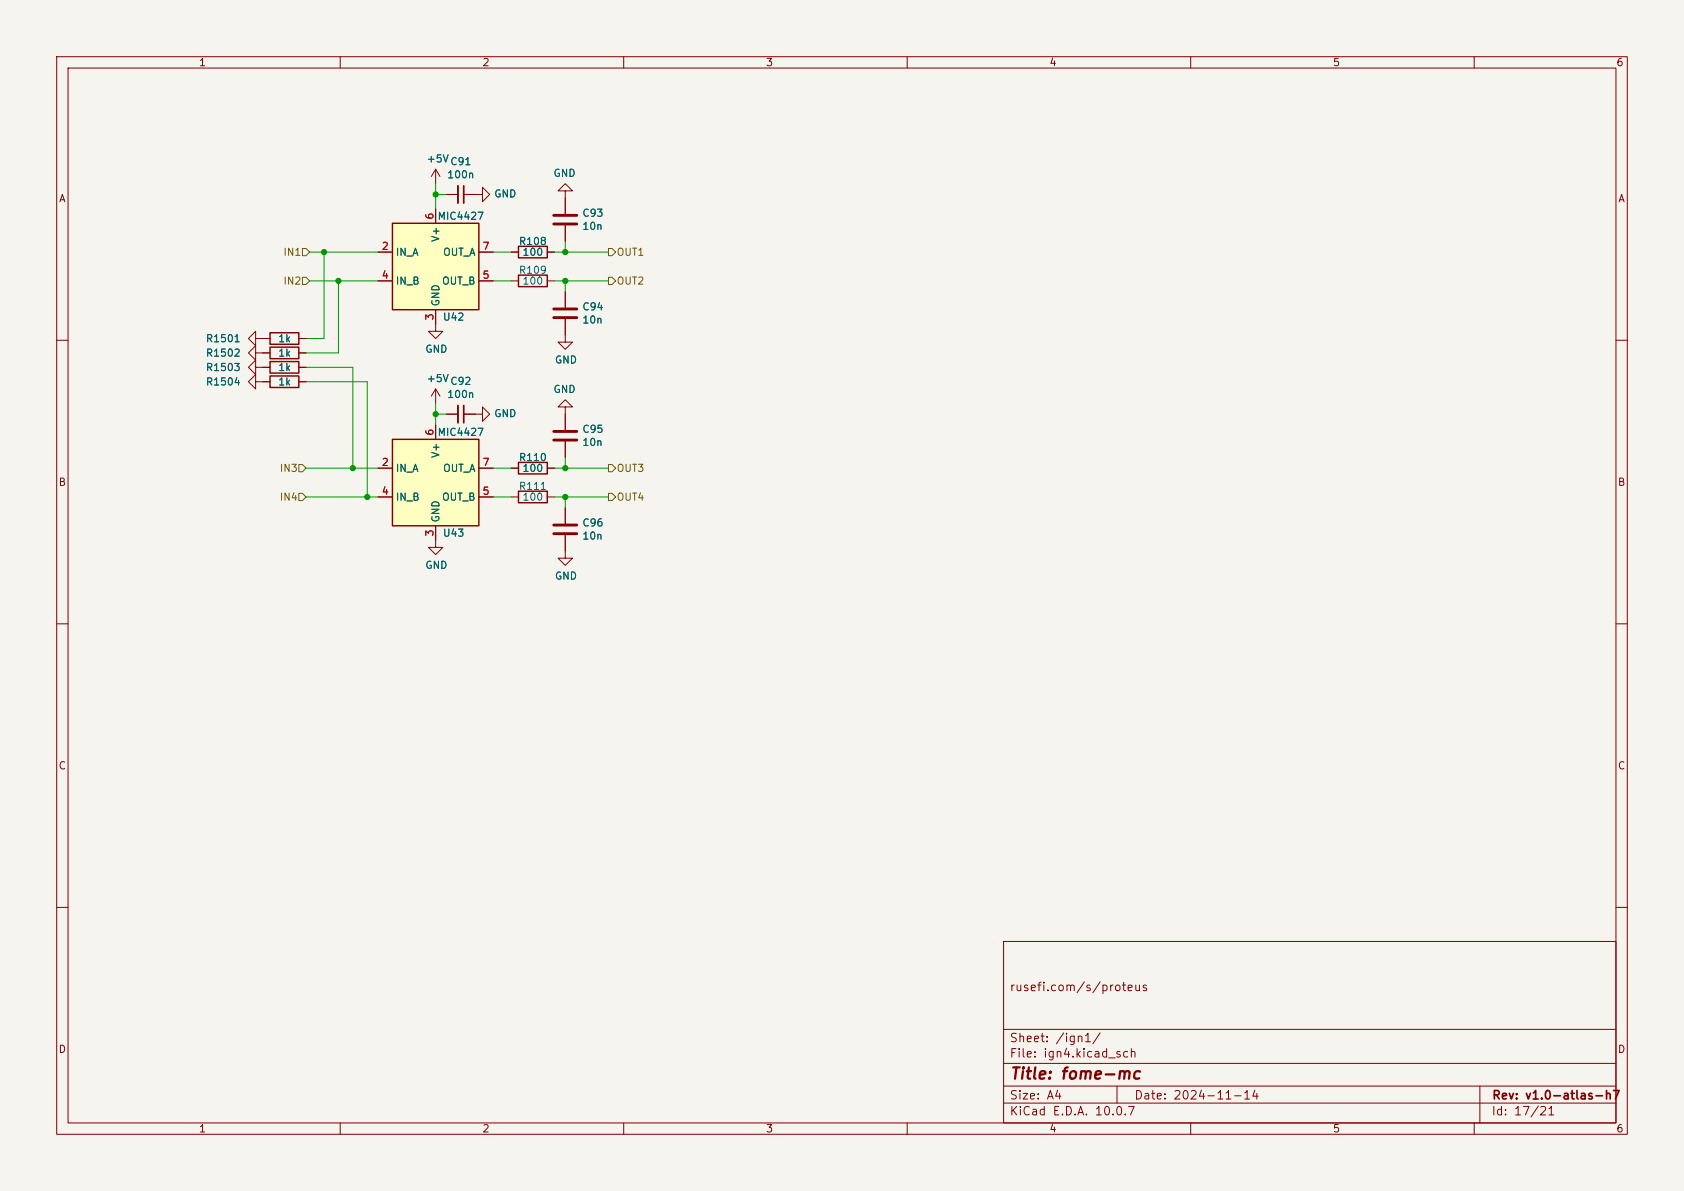
[picture p83: page 17]

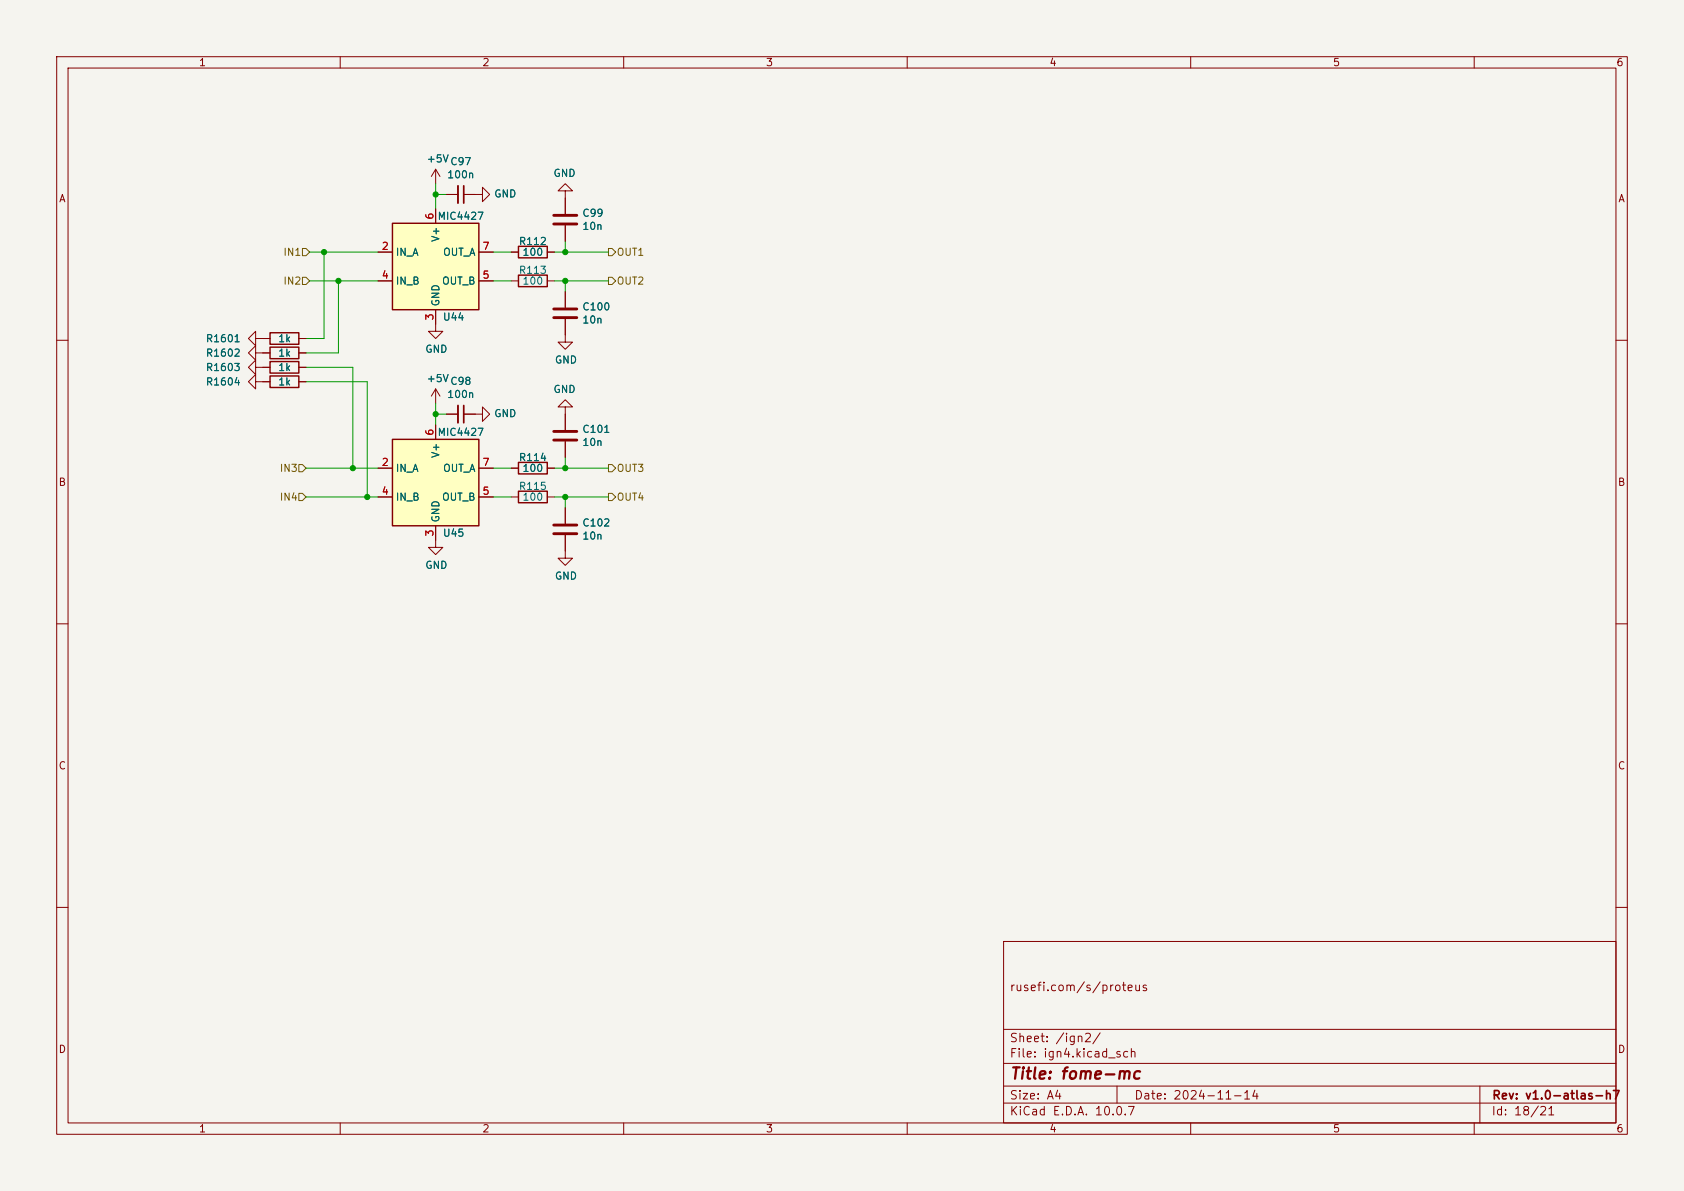
[picture p84: page 18]

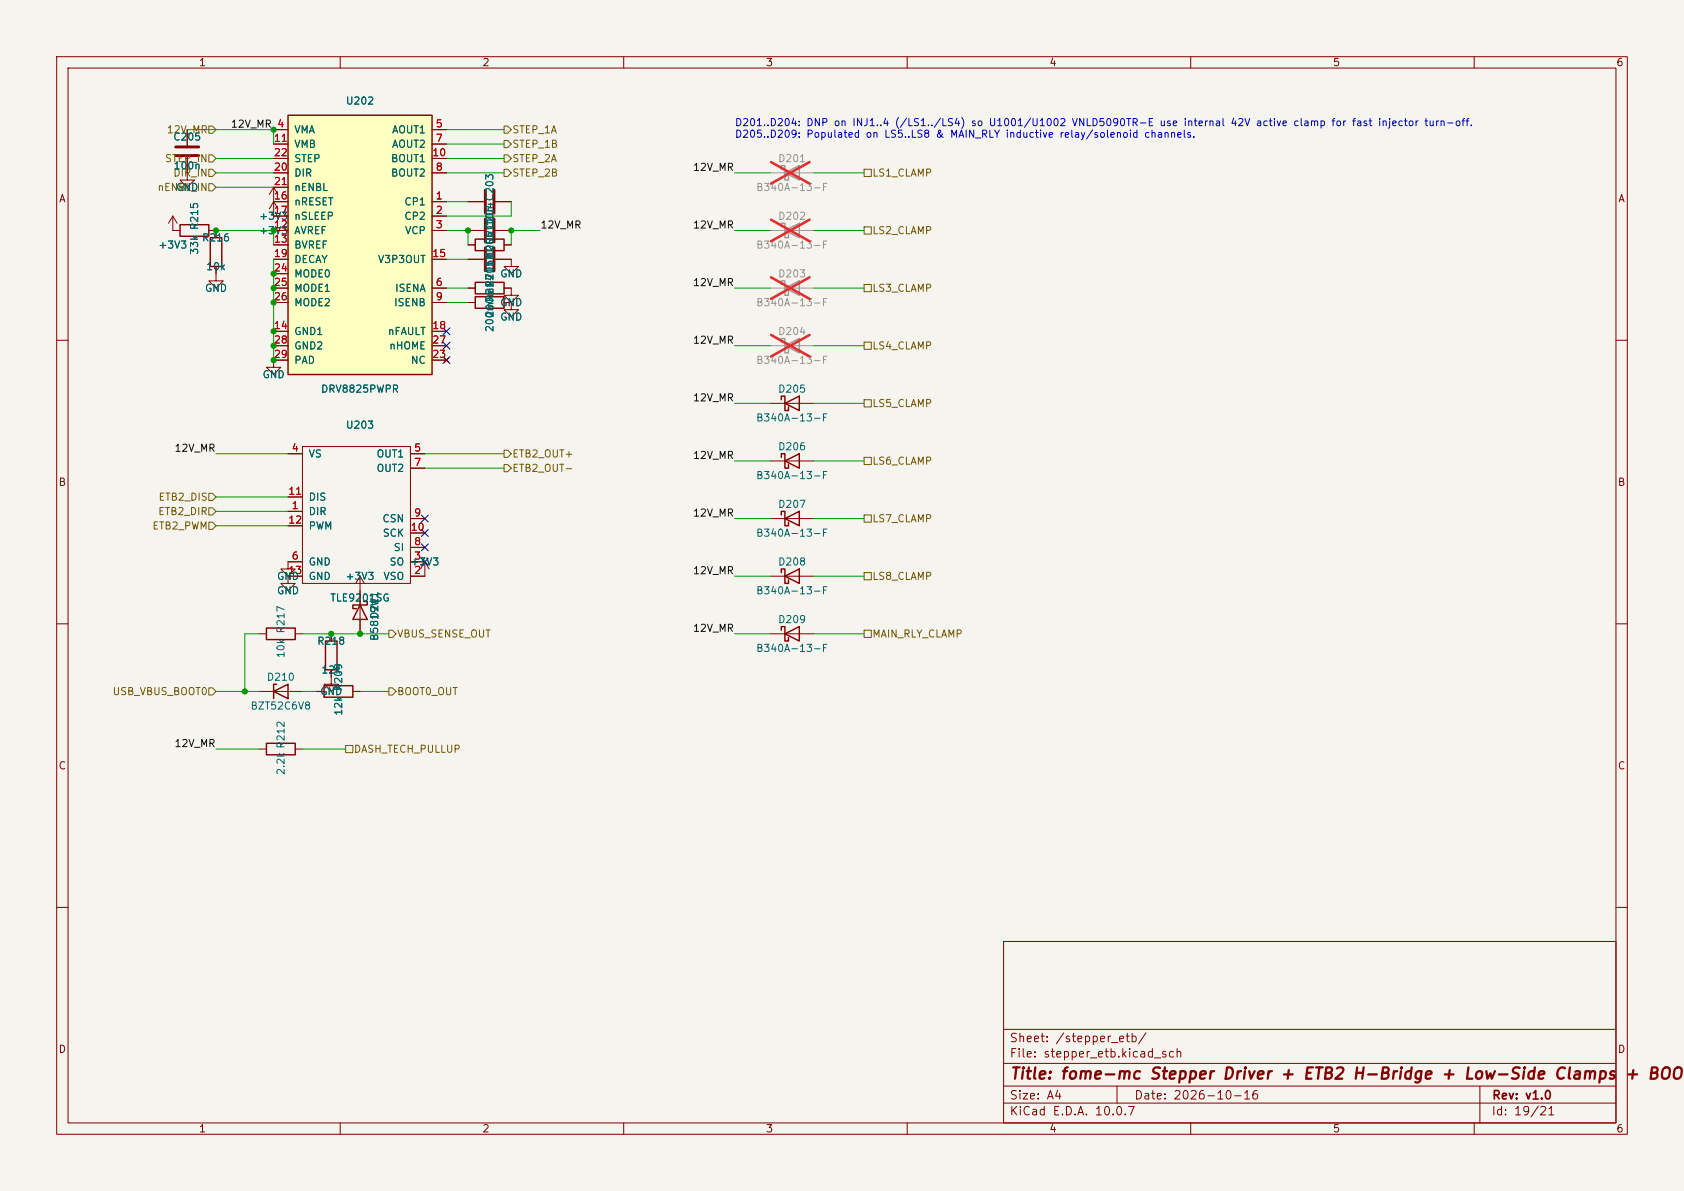
[picture p85: page 19]

Sheet: /stepper_etb/
File: stepper_etb.kicad_sch
Title: fome-mc Stepper Driver + ETB2 H-Bridge + Low-Side Clamps + BOOT0 Recovery

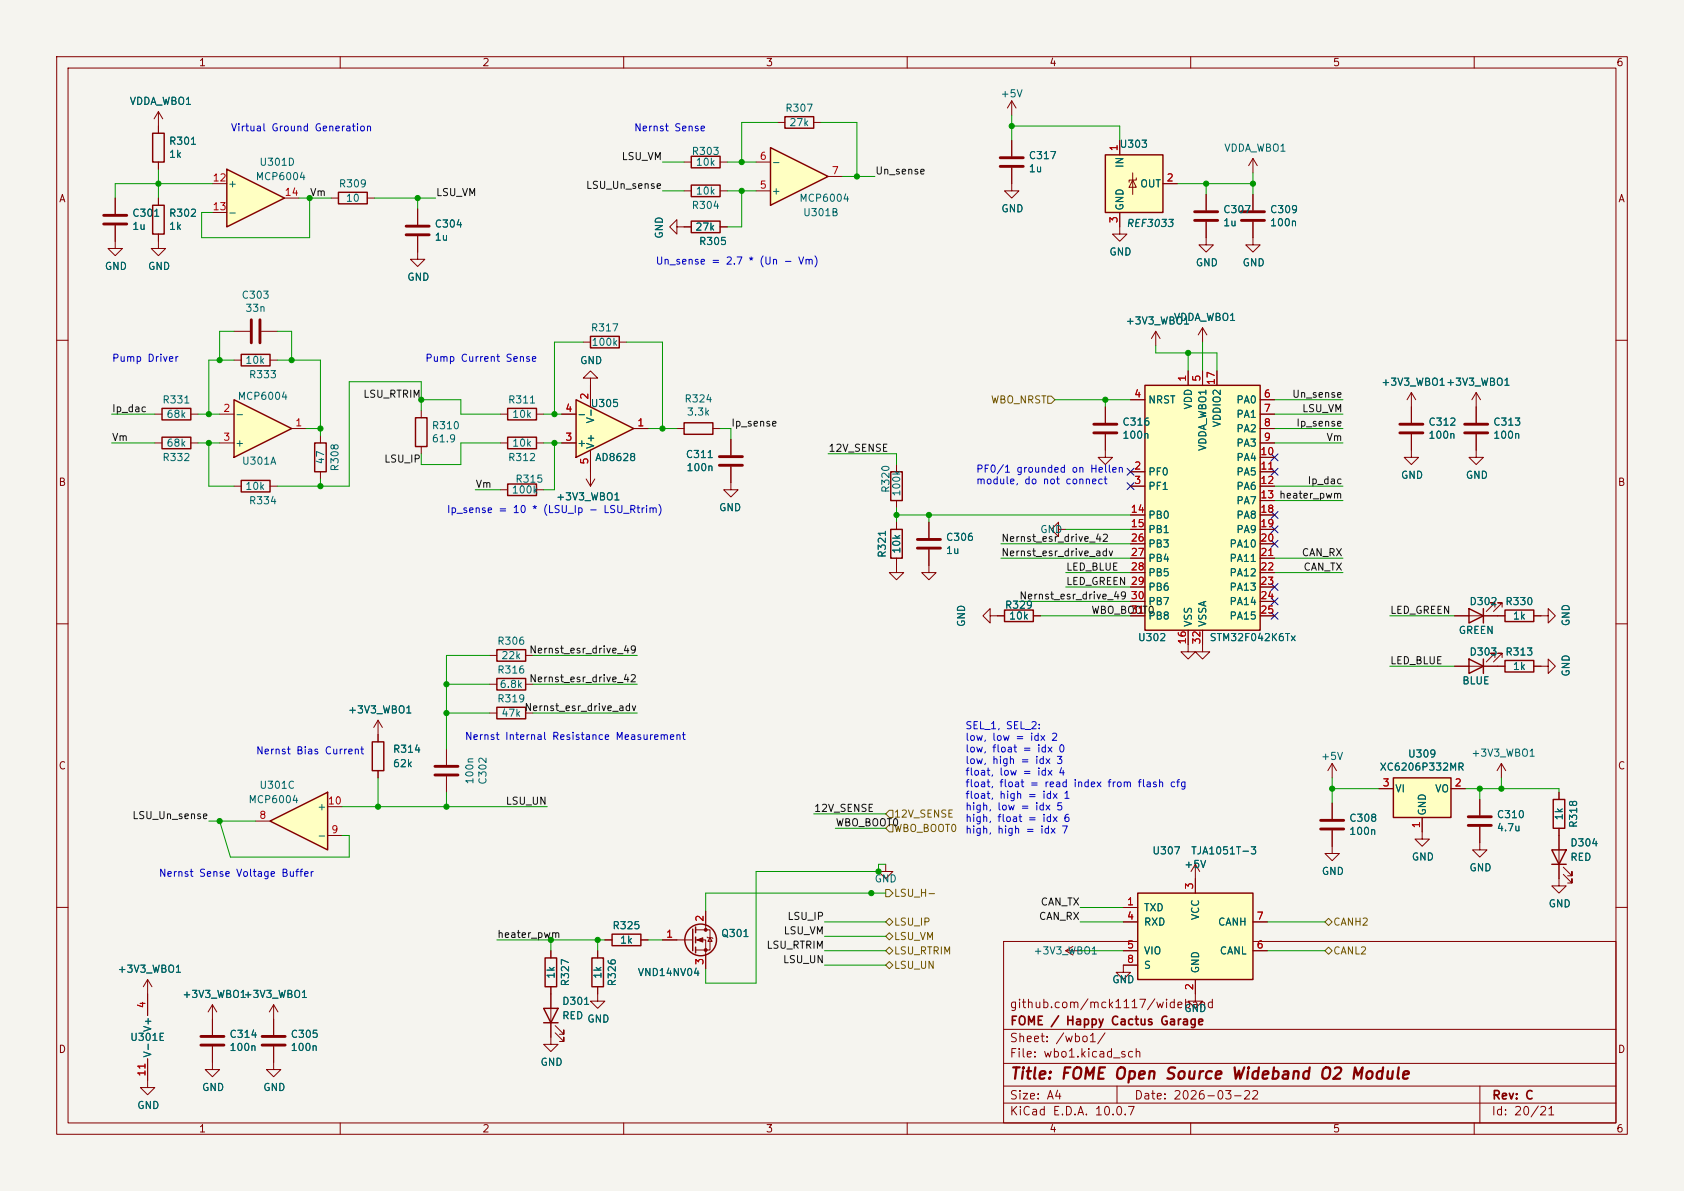
[picture p86: page 20]

low, float = idx 0
low, high = idx 3
float, low = idx 4
float, float = read index from flash cfg
float, high = idx 1
high, low = idx 5
high, float = idx 6

github.com/mck1117/wideband
FOME / Happy Cactus Garage
Sheet: /wbo1/
File: wbo1.kicad_sch
Title: FOME Open Source Wideband O2 Module

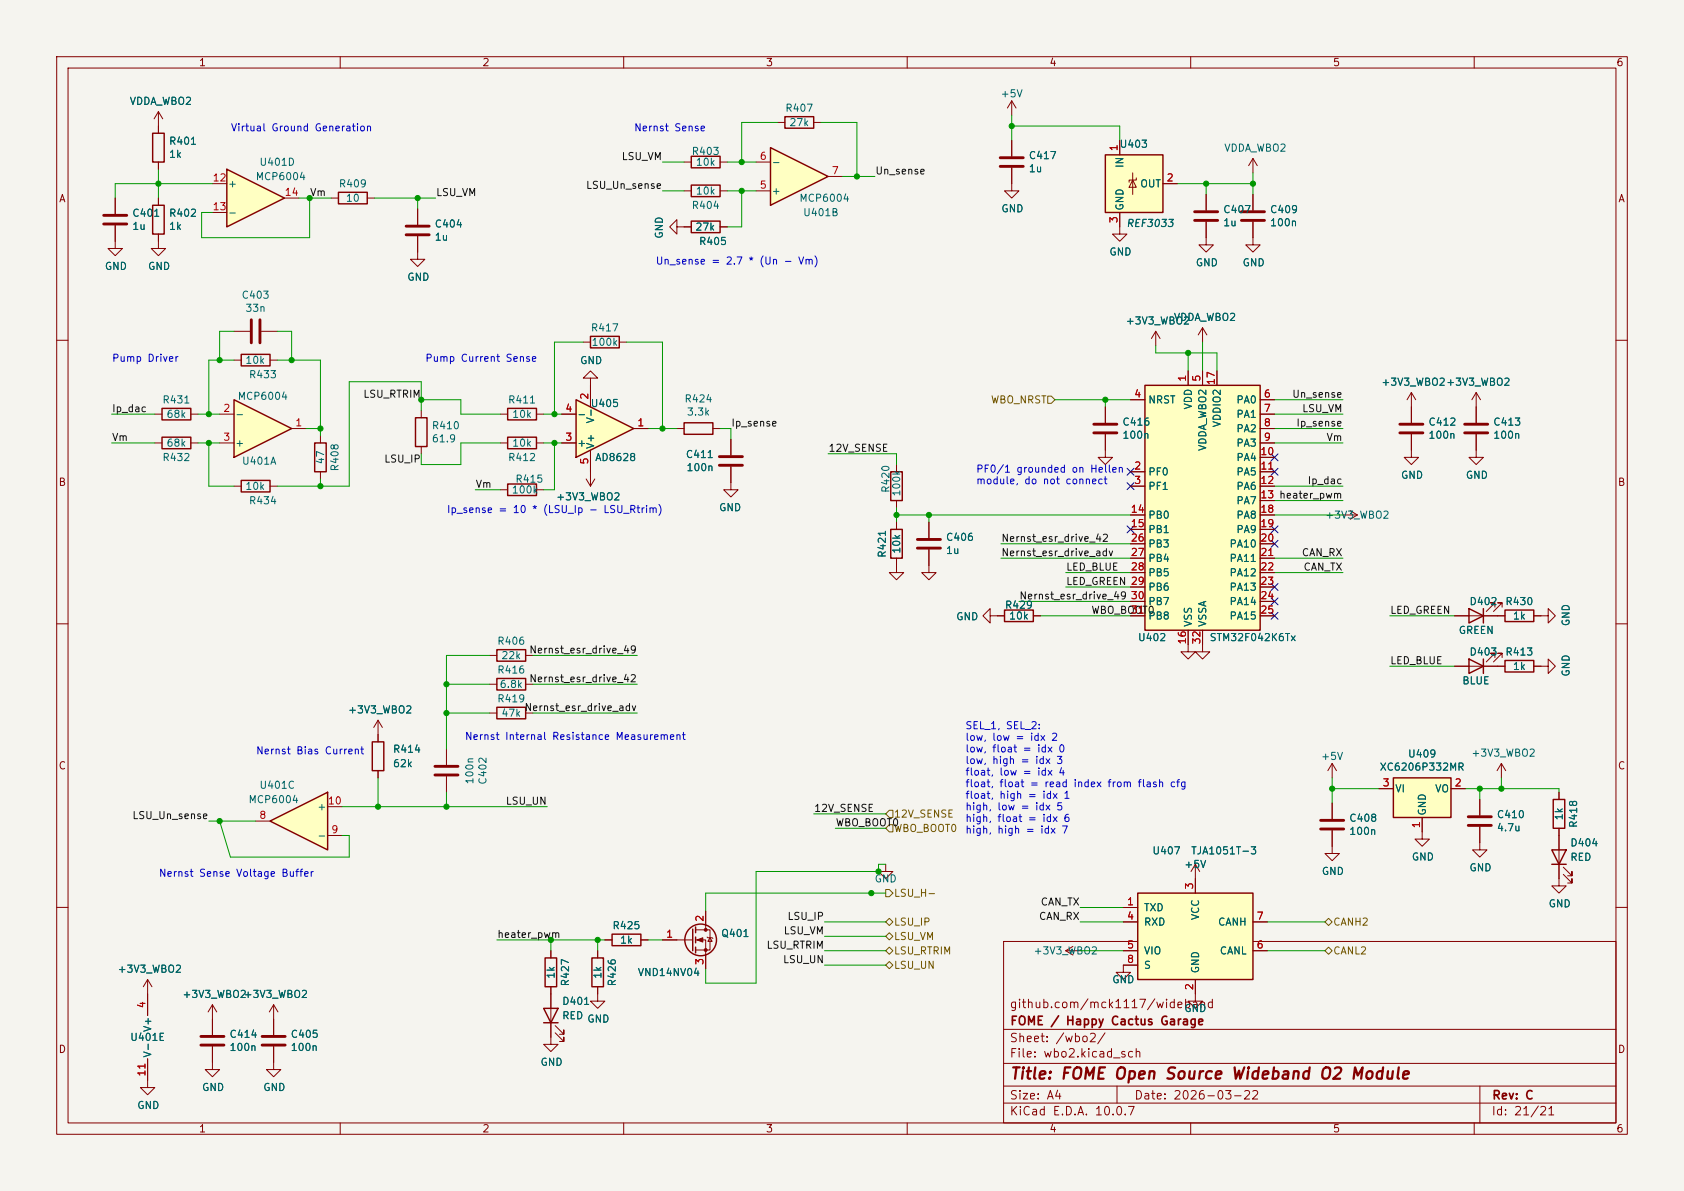
[picture p87: page 21]
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

FOME / Happy Cactus Garage
Sheet: /wbo2/
File: wbo2.kicad_sch
Title: FOME Open Source Wideband O2 Module
