halbritt/fome-mc/reports/toolchain/baseline/fome-mc/export/native/fome-mc-schematic.pdf

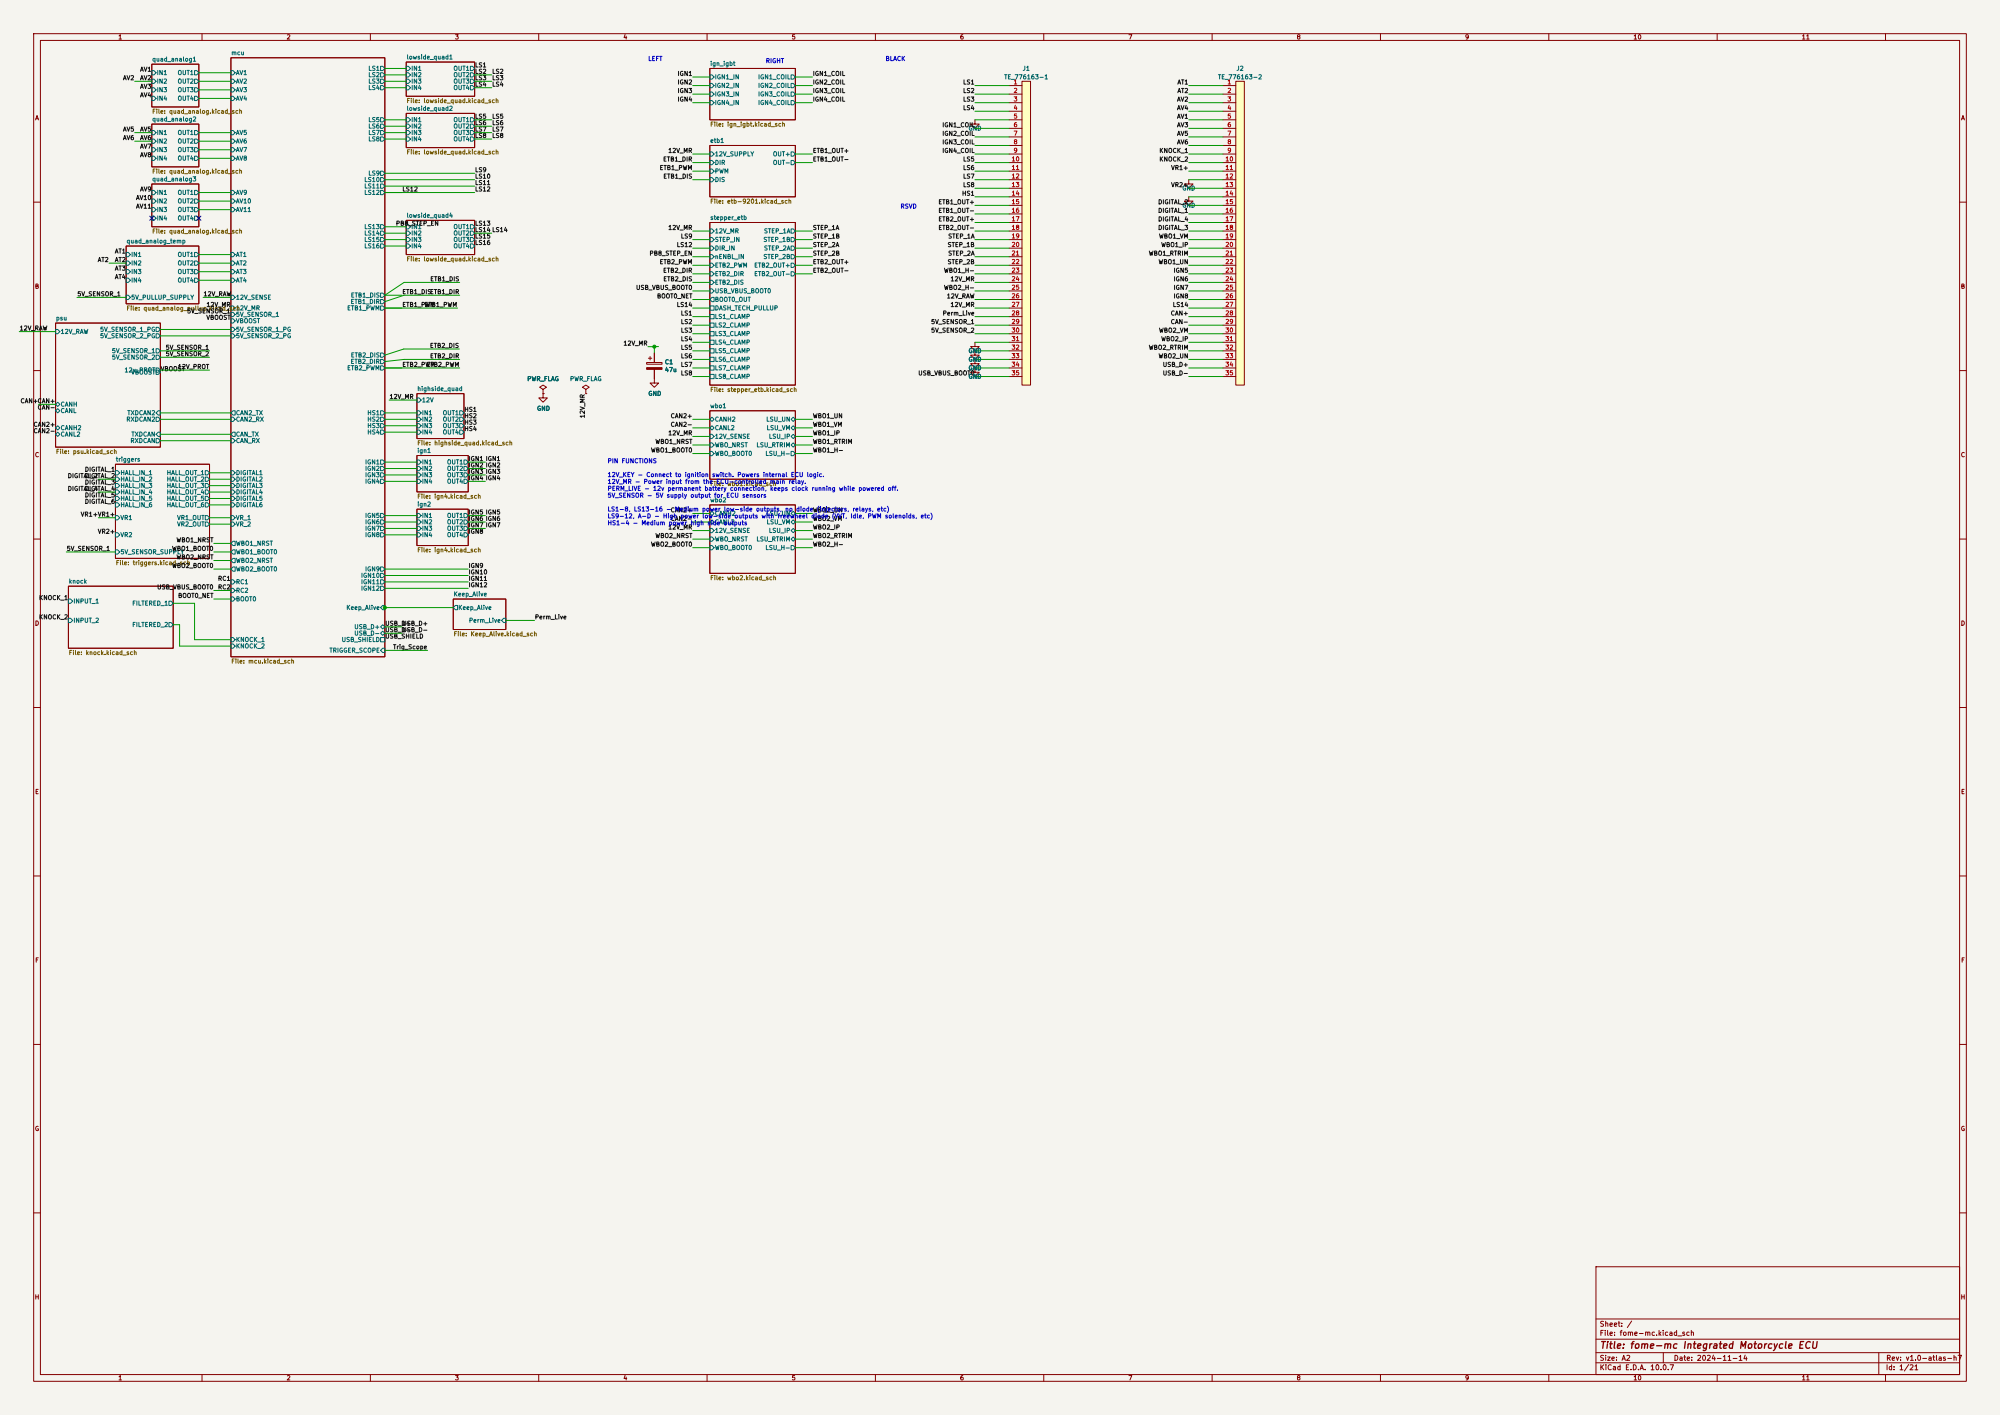
[picture p88: page 1]

LS9-12, A-D - High power low-side outputs with freewheel diode (VVT, Idle, PWM solenoids, etc) HS1-4 - Medium power high side outputs

Sheet: /
File: fome-mc.kicad_sch
Title: fome-mc Integrated Motorcycle ECU
KiCad E.D.A. 10.0.7

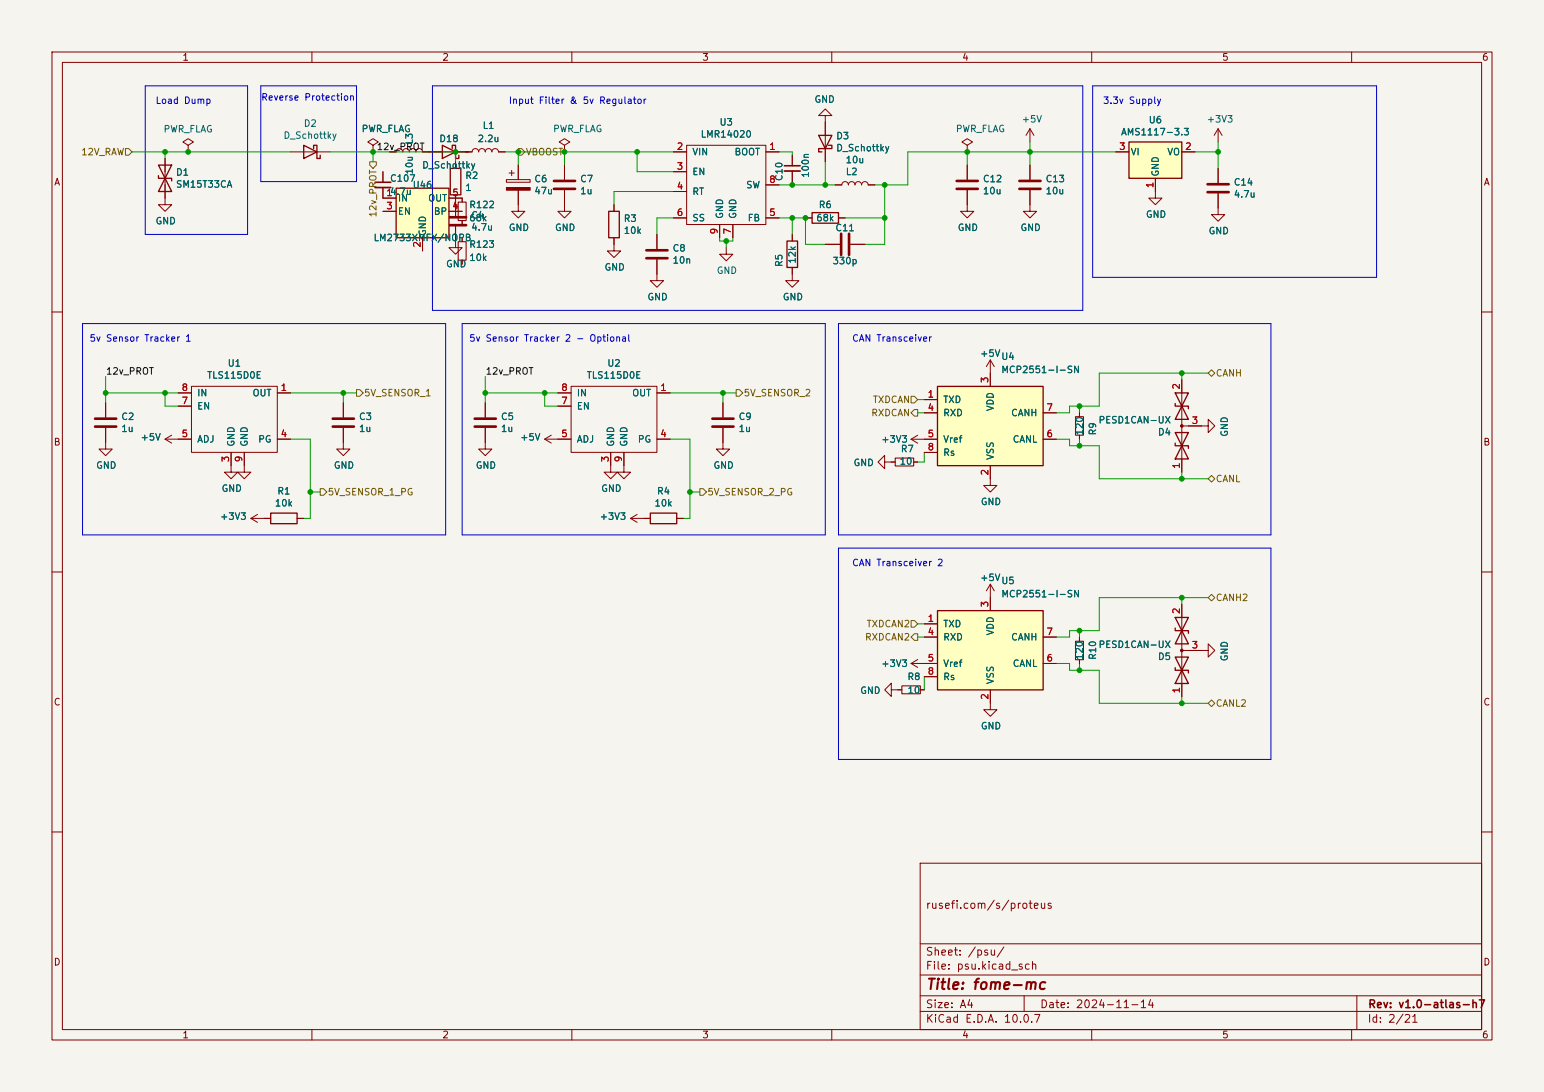
[picture p89: page 2]

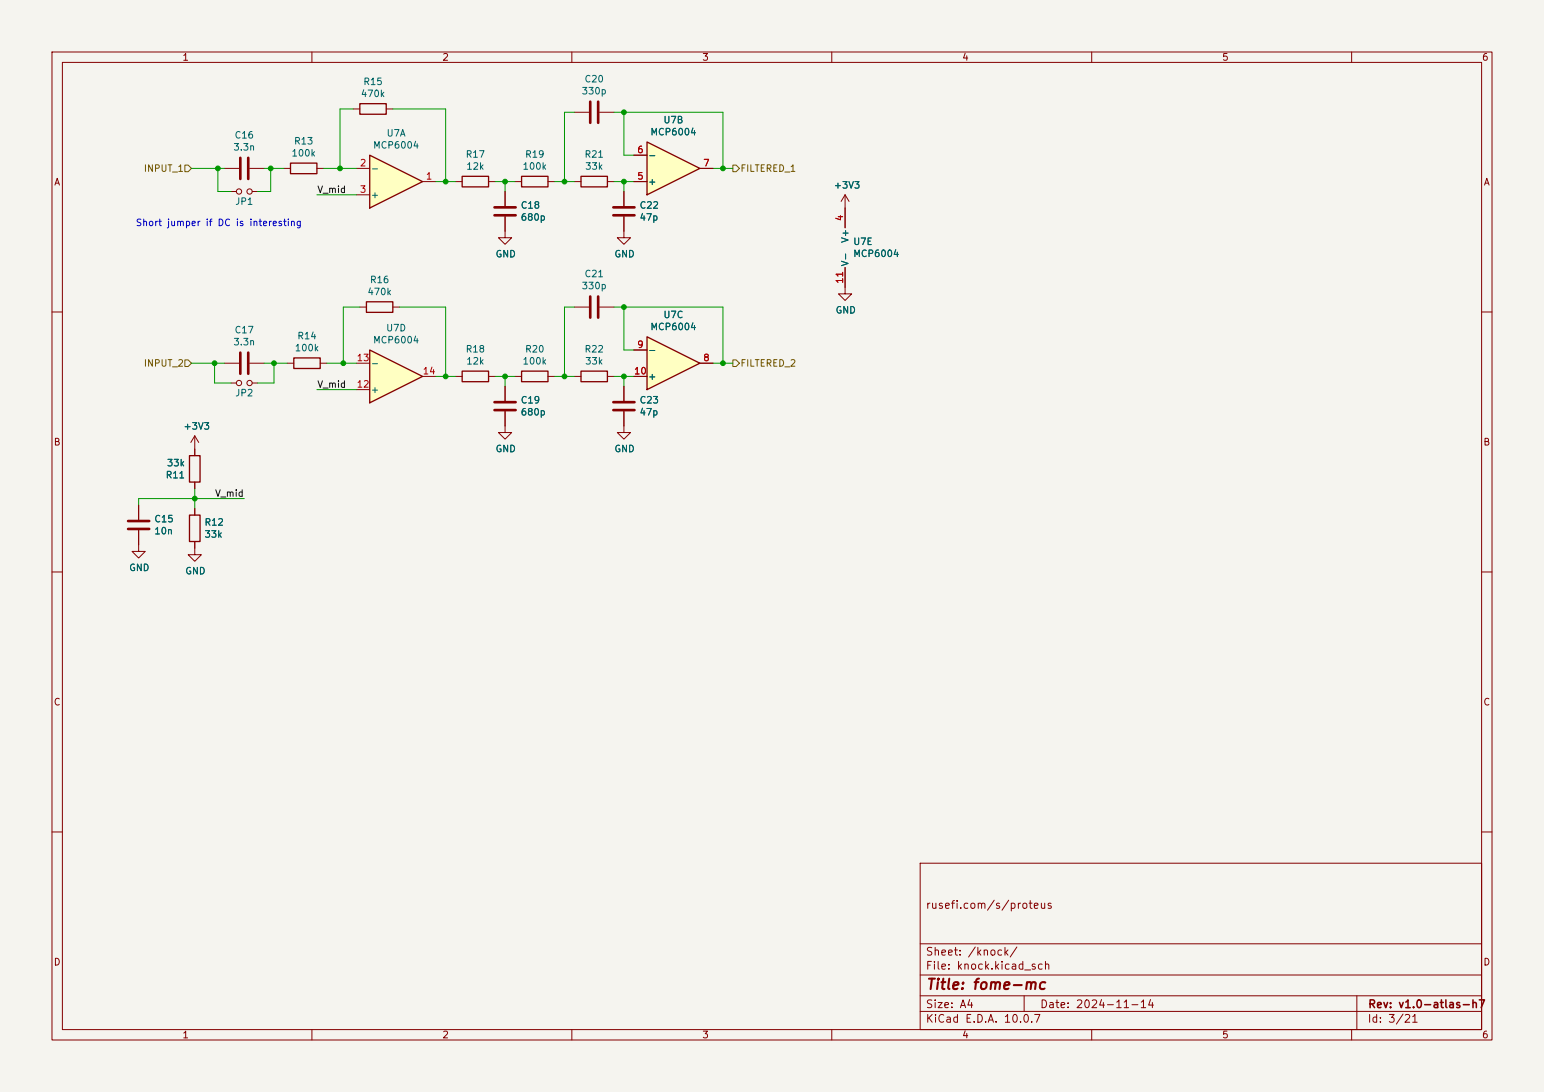
[picture p90: page 3]

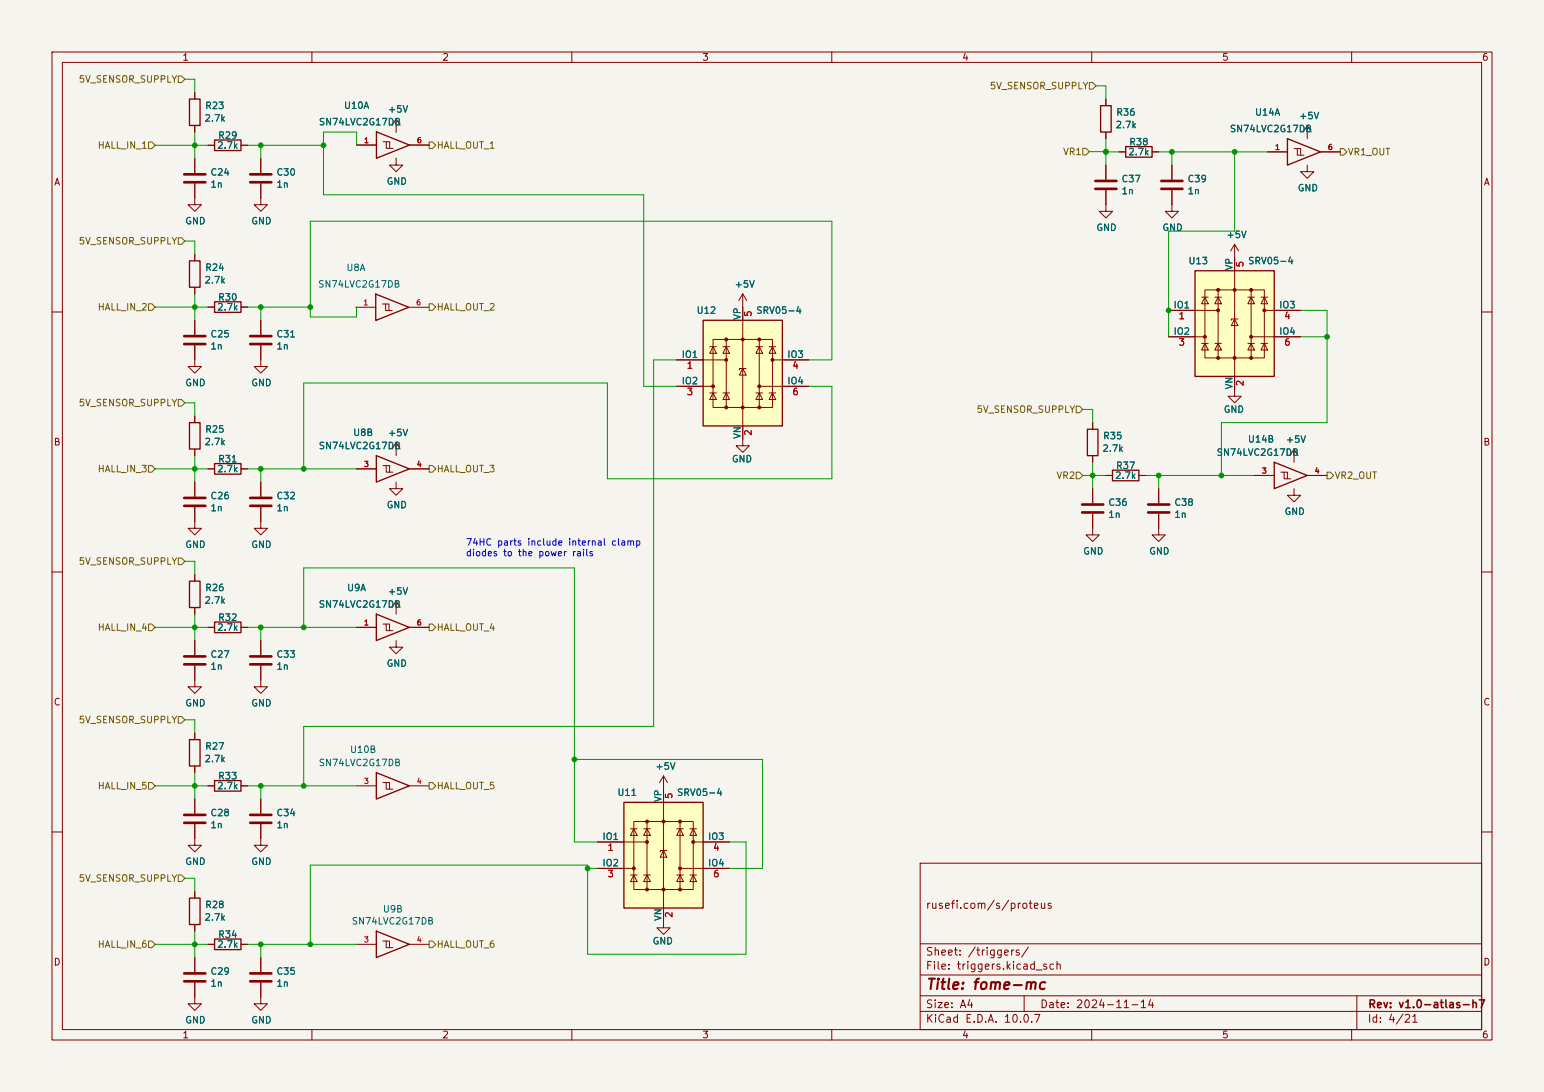
[picture p91: page 4]

diodes to the power rails C33

74HC parts include internal clamp

rusefi.com/s/proteus GND

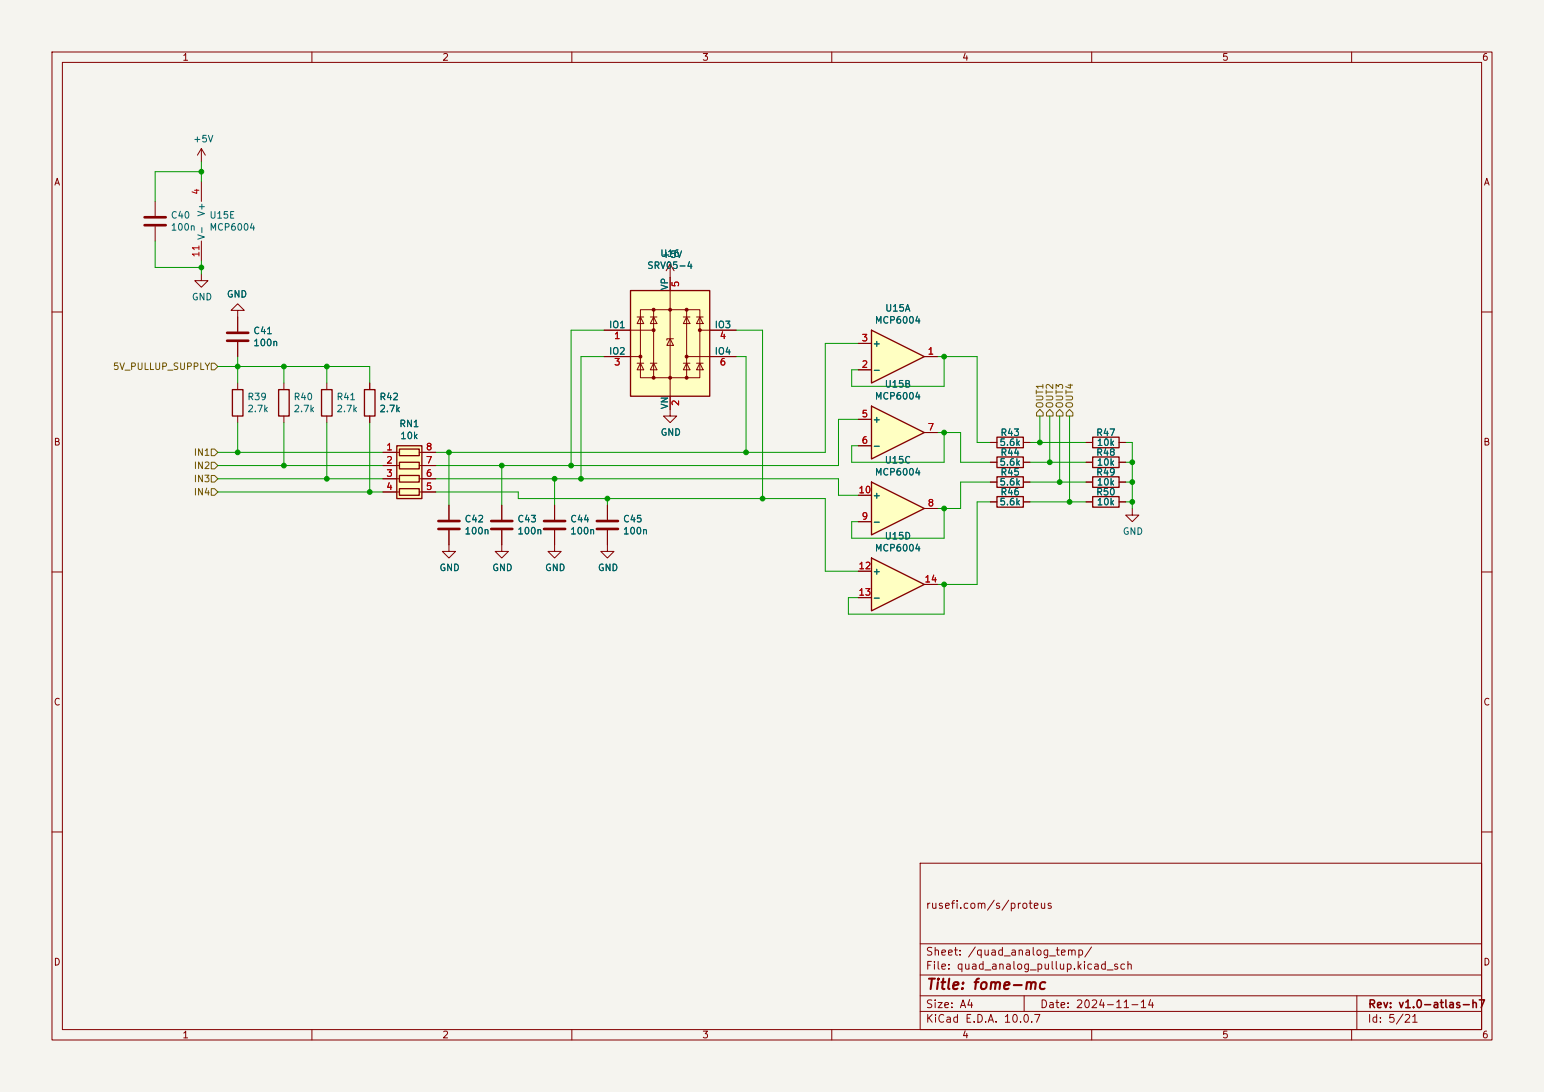
[picture p92: page 5]

7 7
6 6

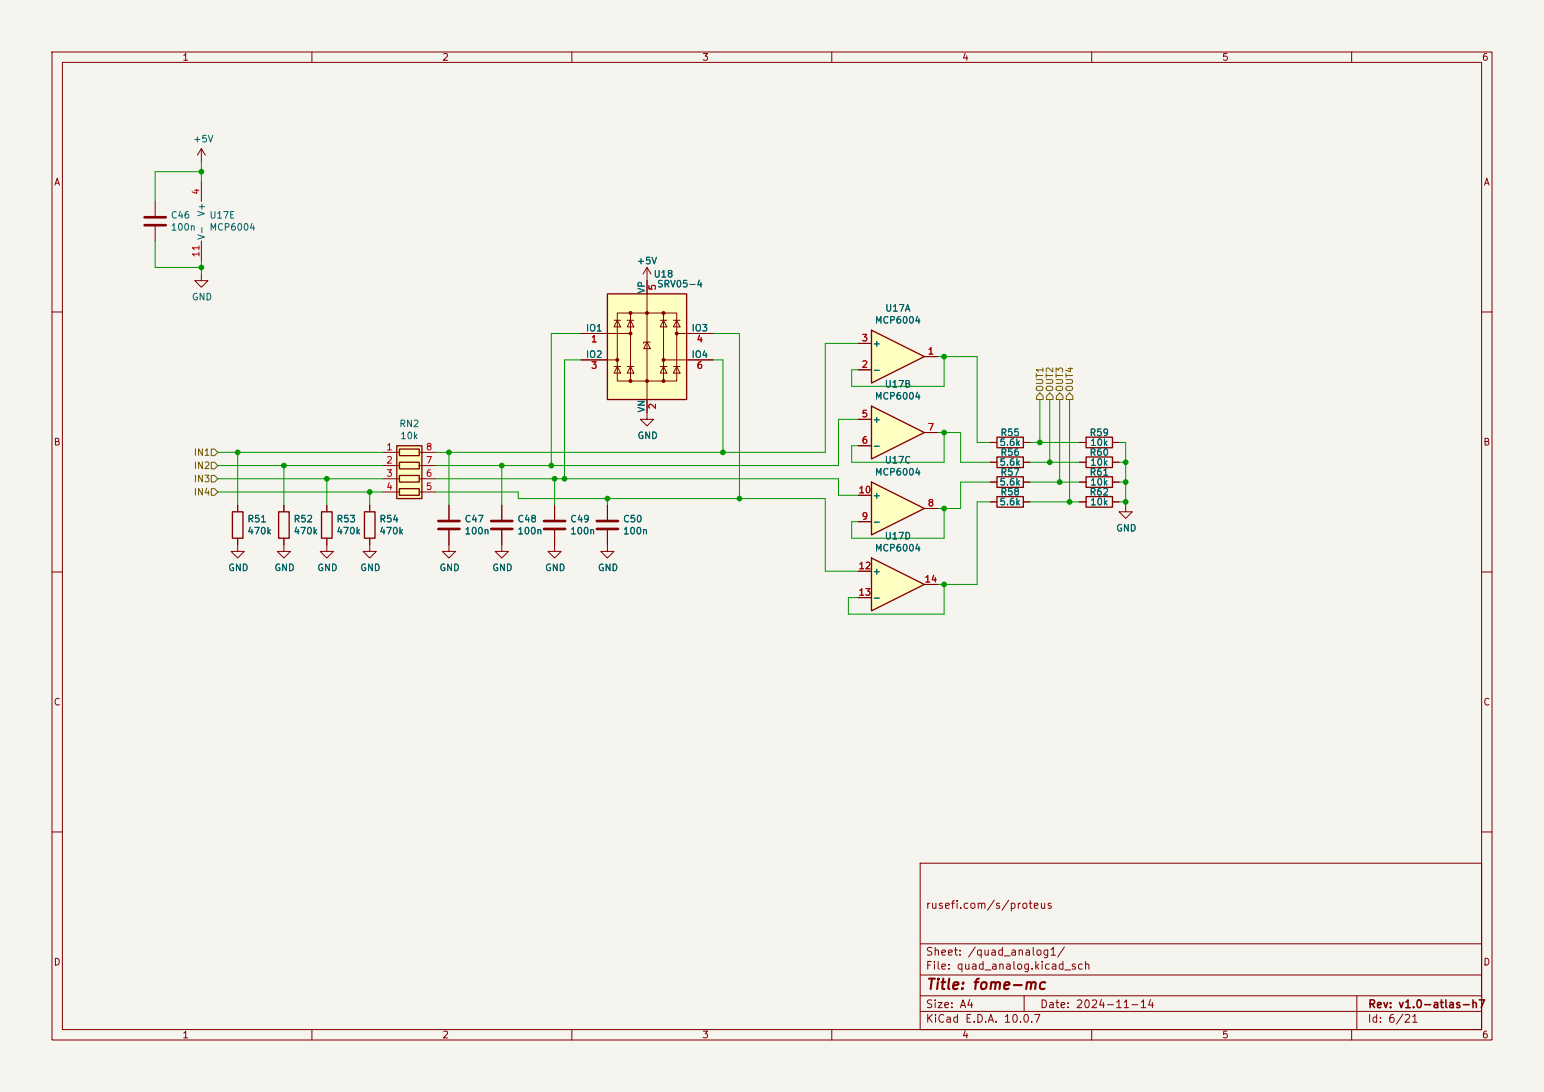
[picture p93: page 6]

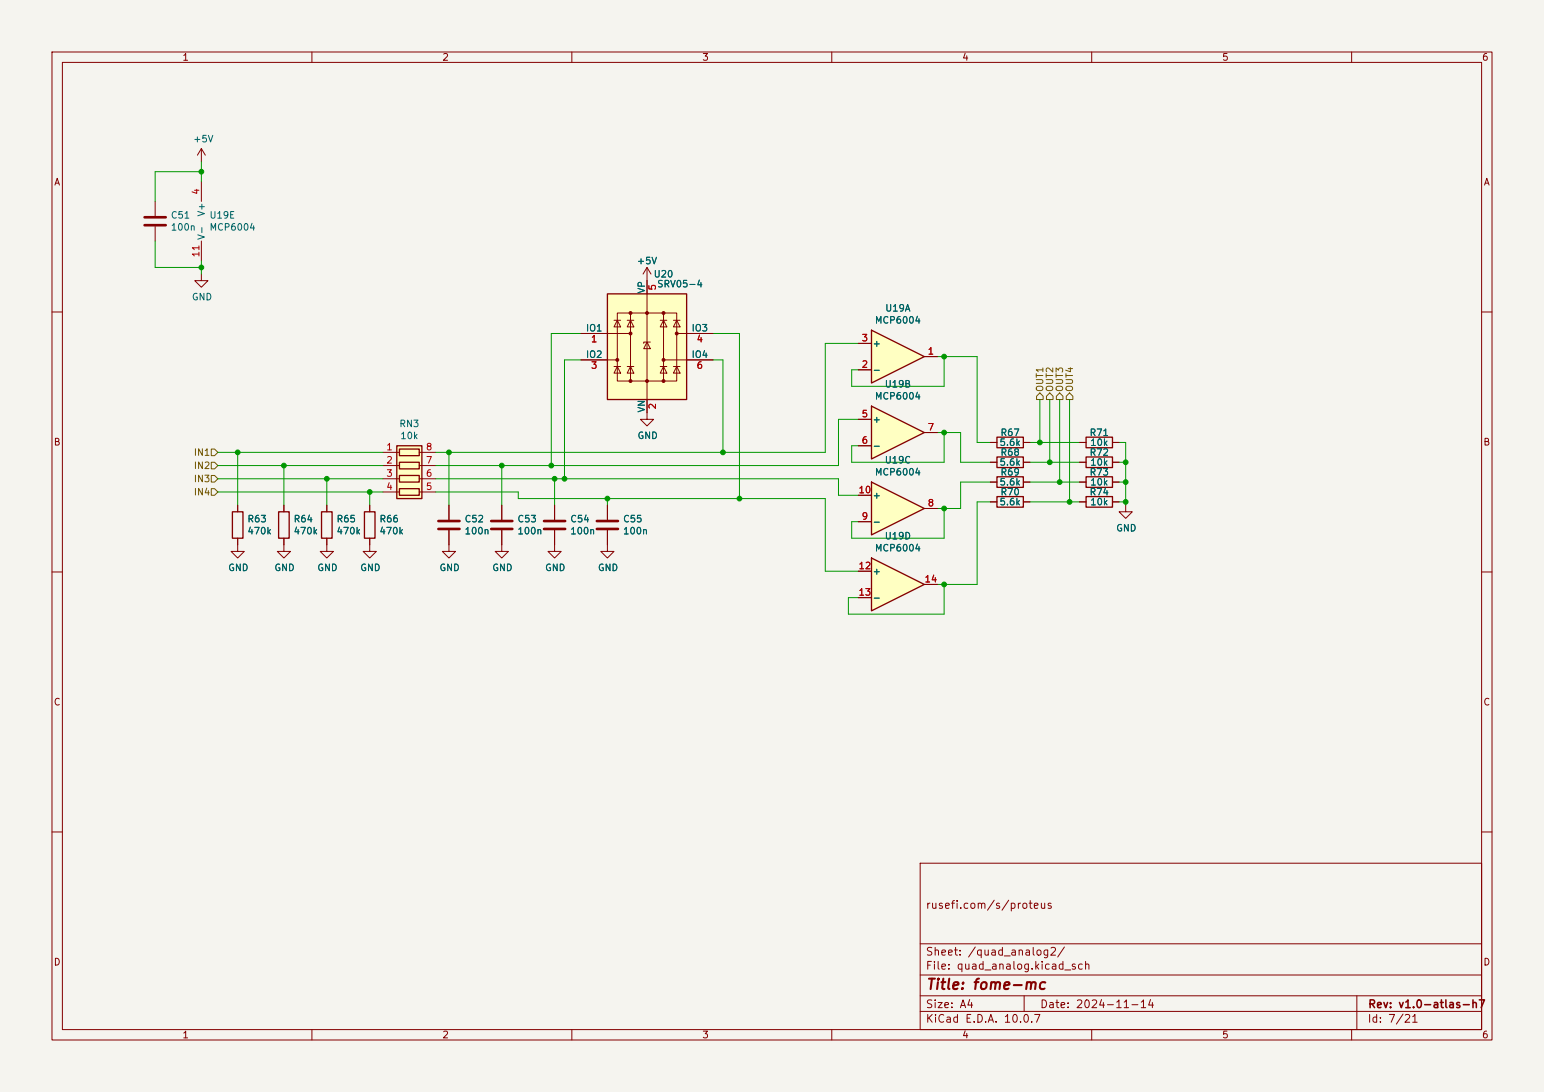
[picture p94: page 7]

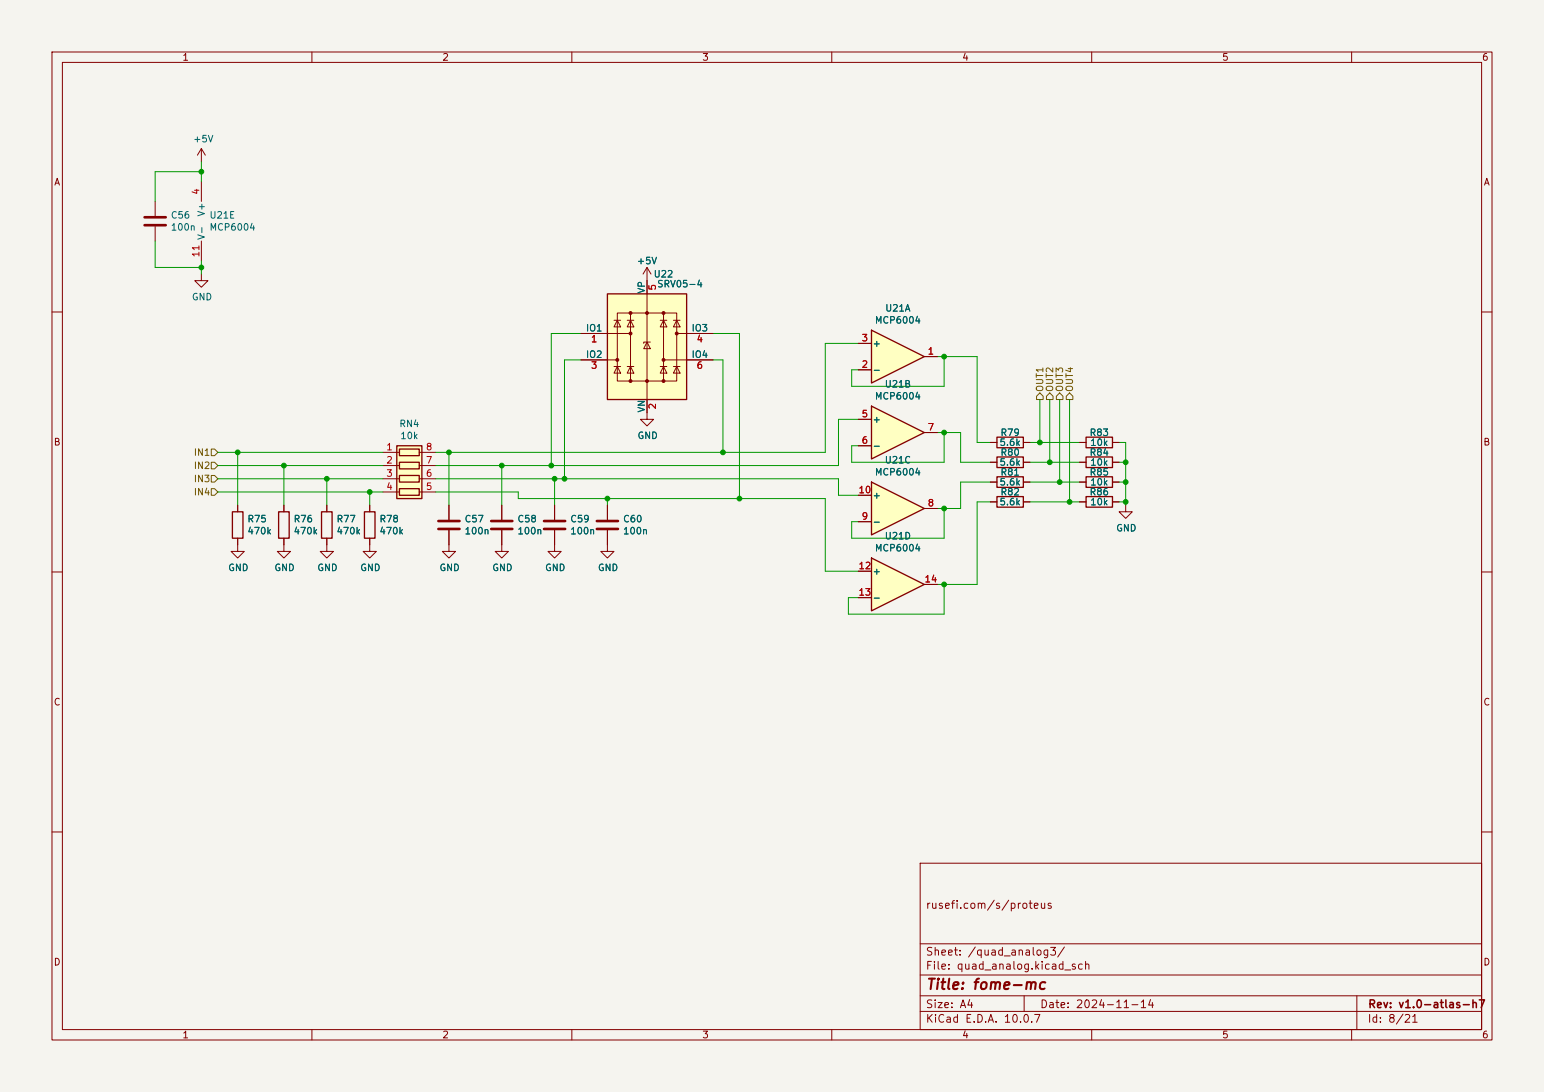
[picture p95: page 8]

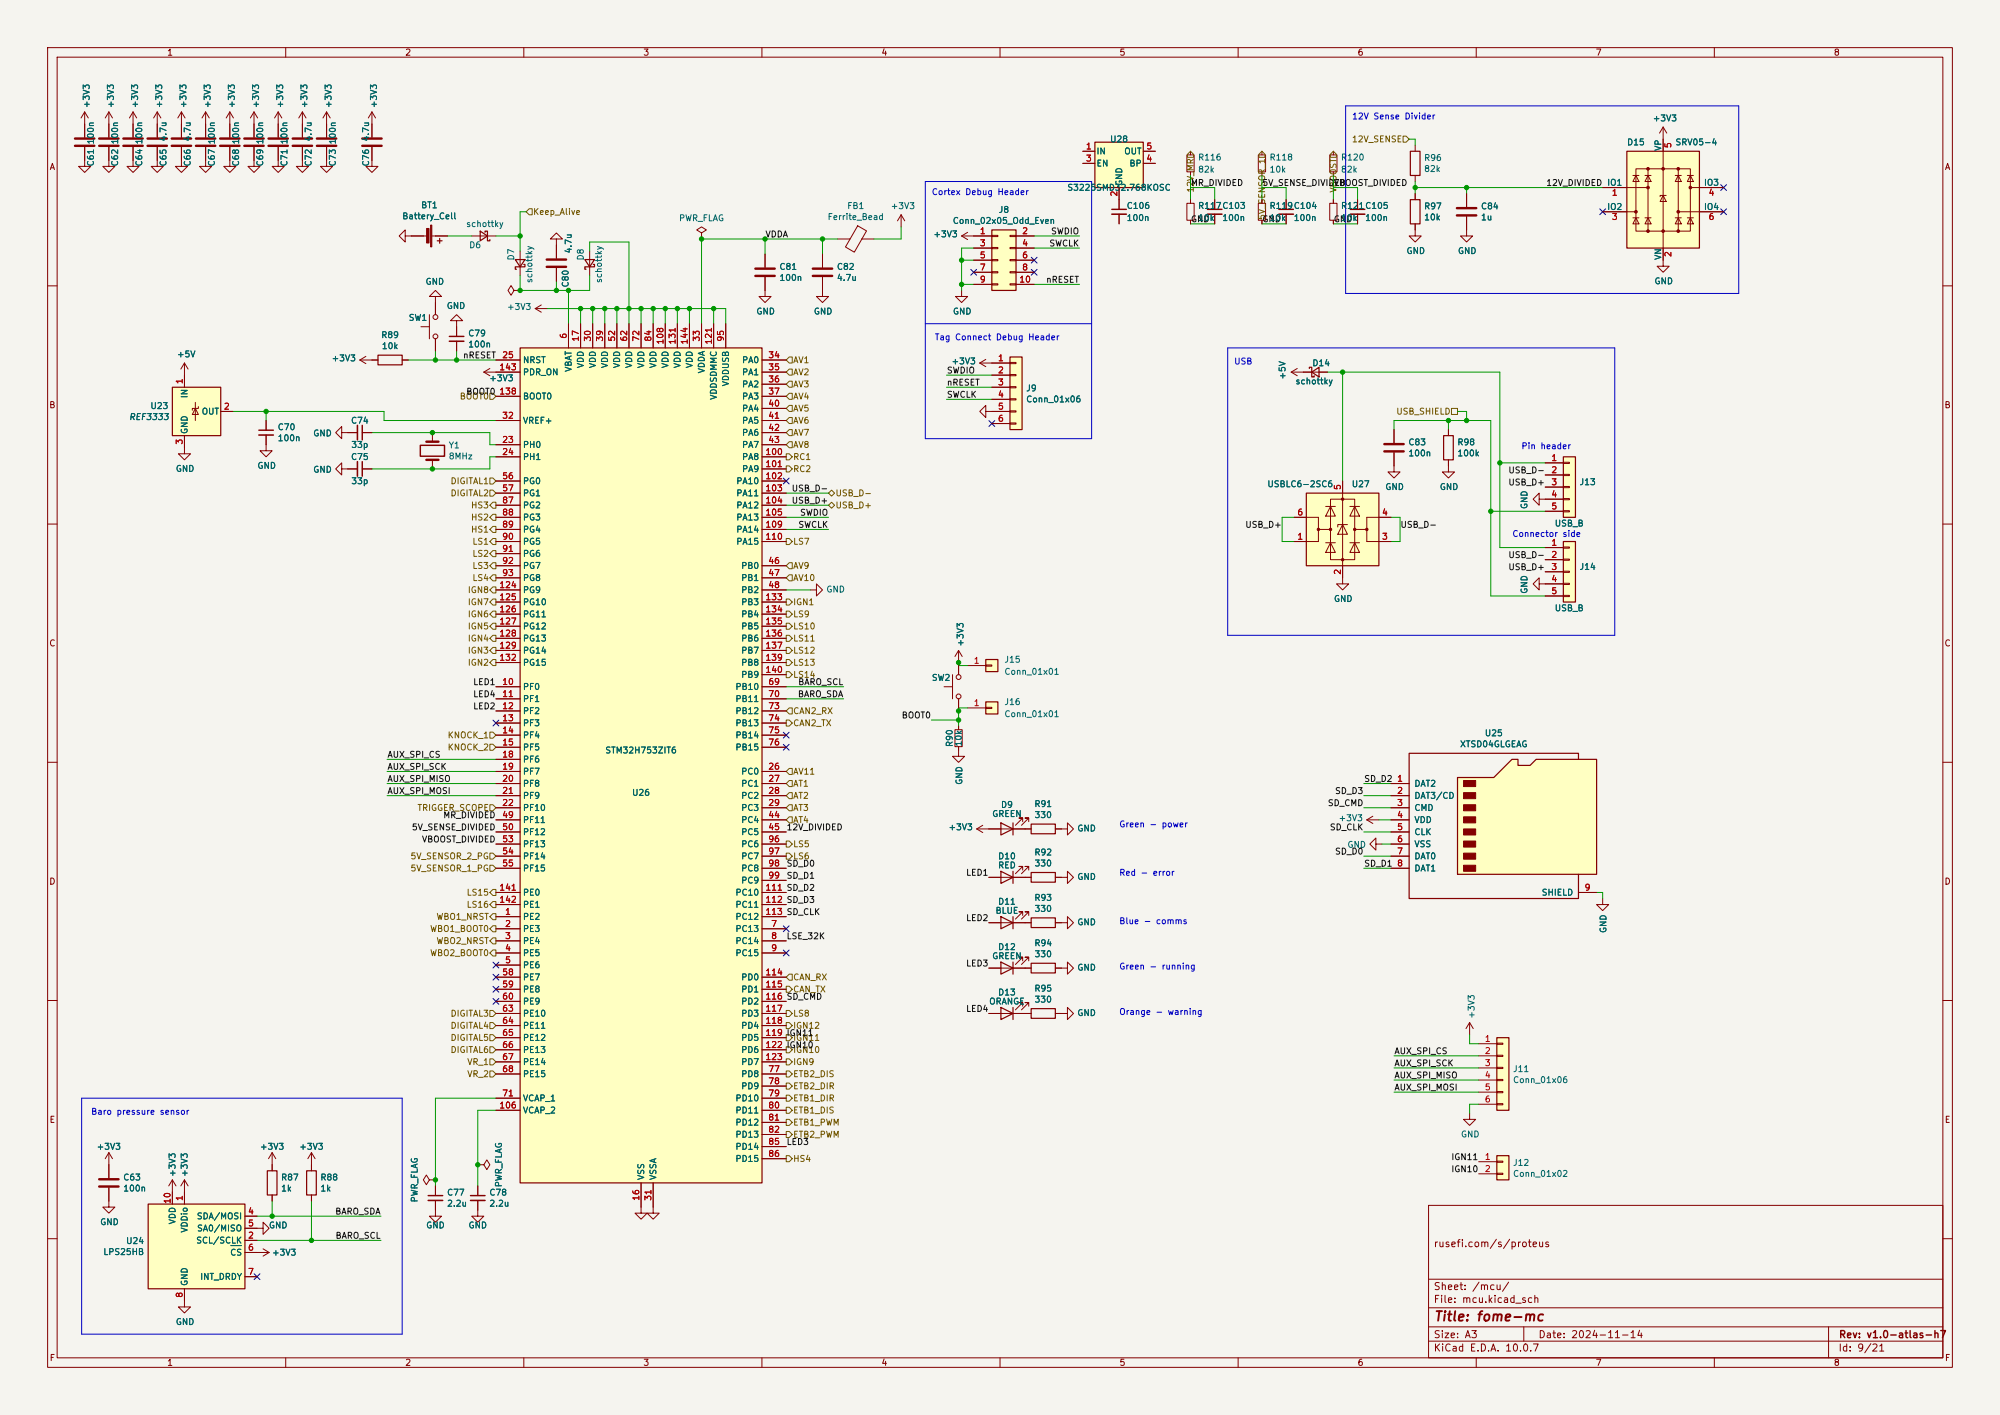
[picture p96: page 9]

Tag Connect Debug Header Cortex Debug Header

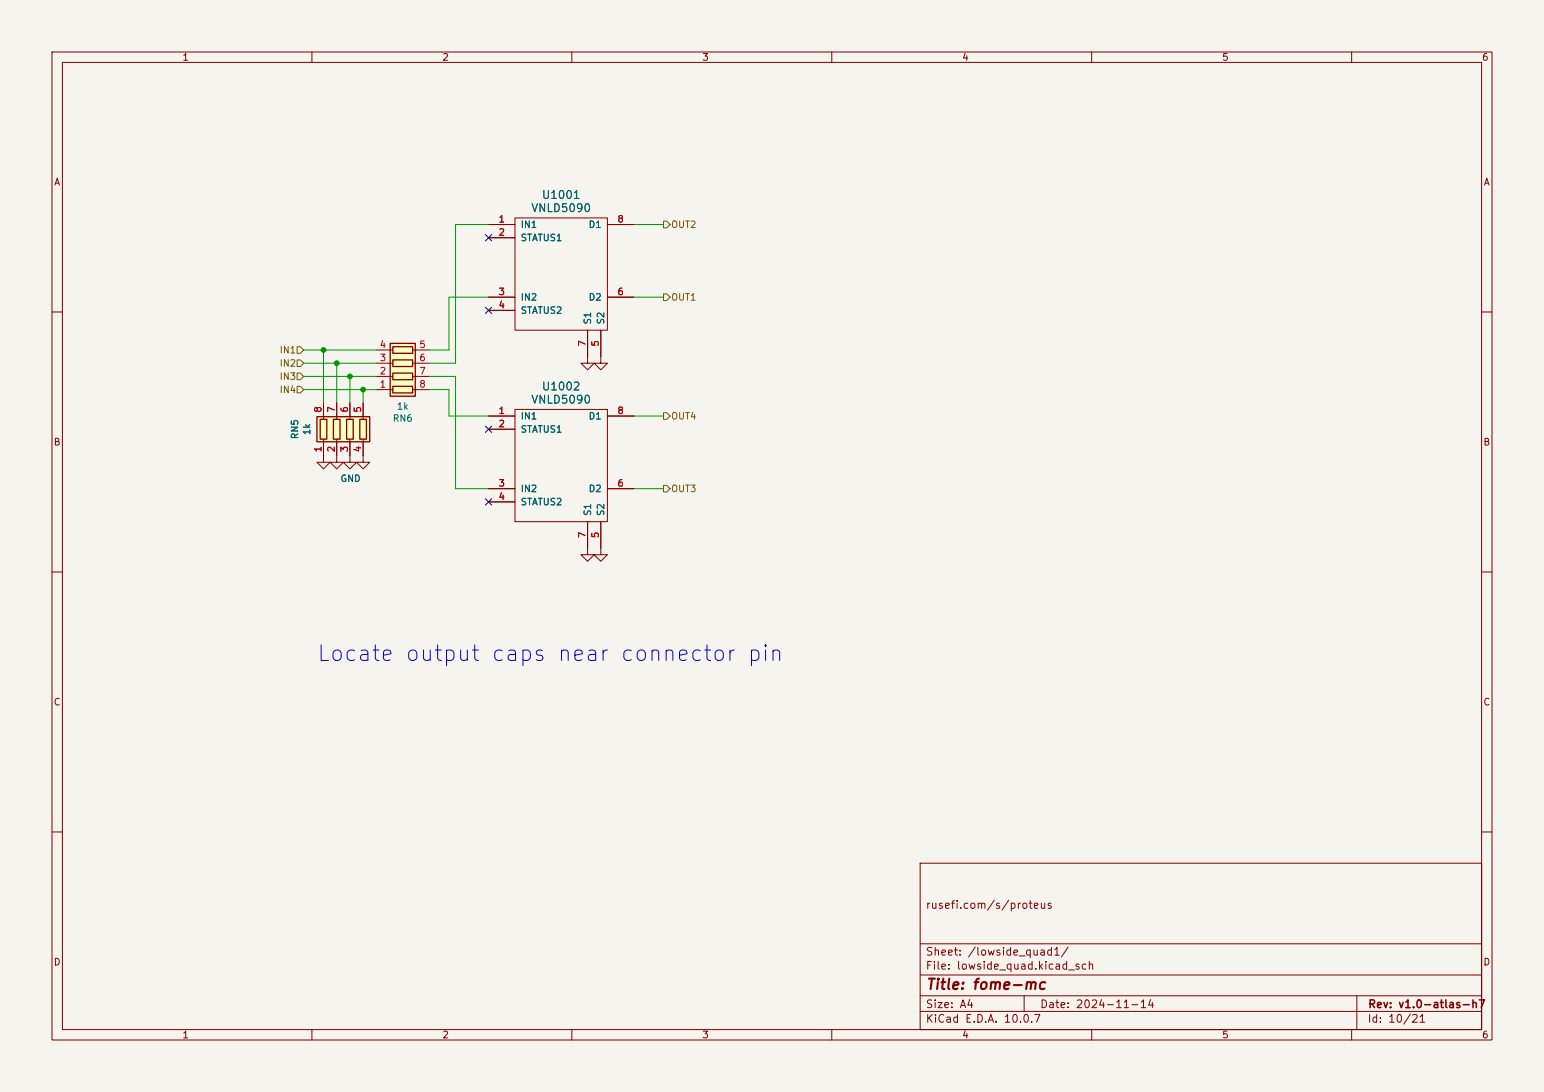
[picture p97: page 10]

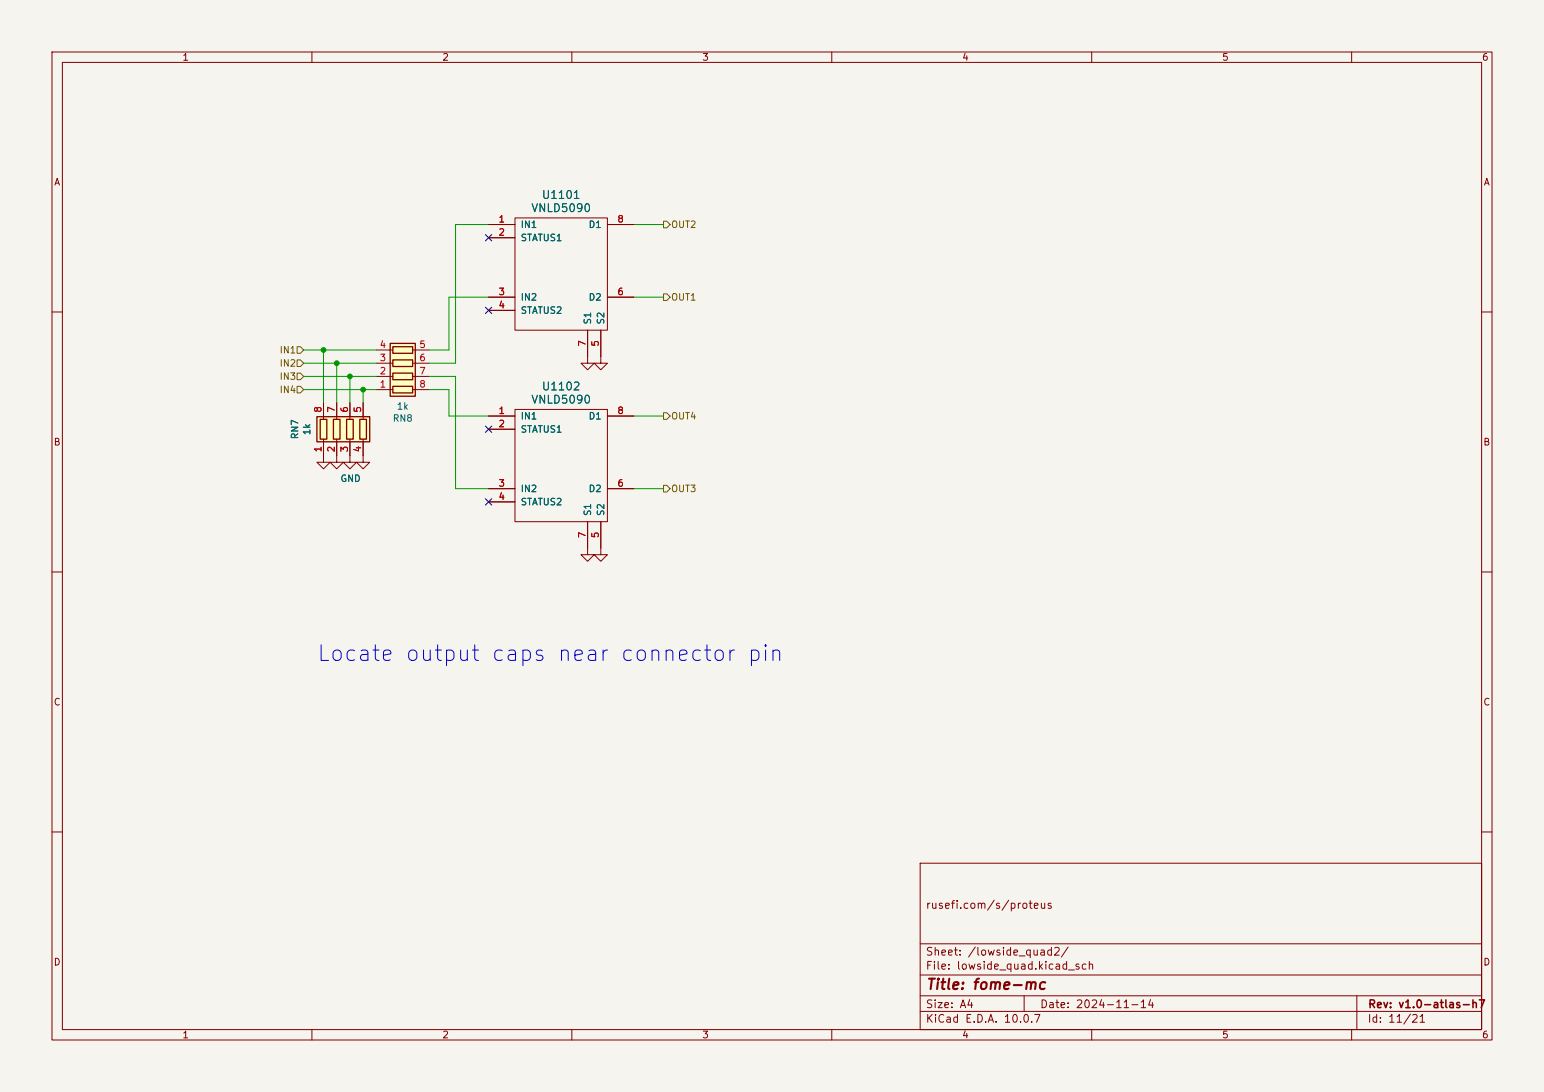
[picture p98: page 11]

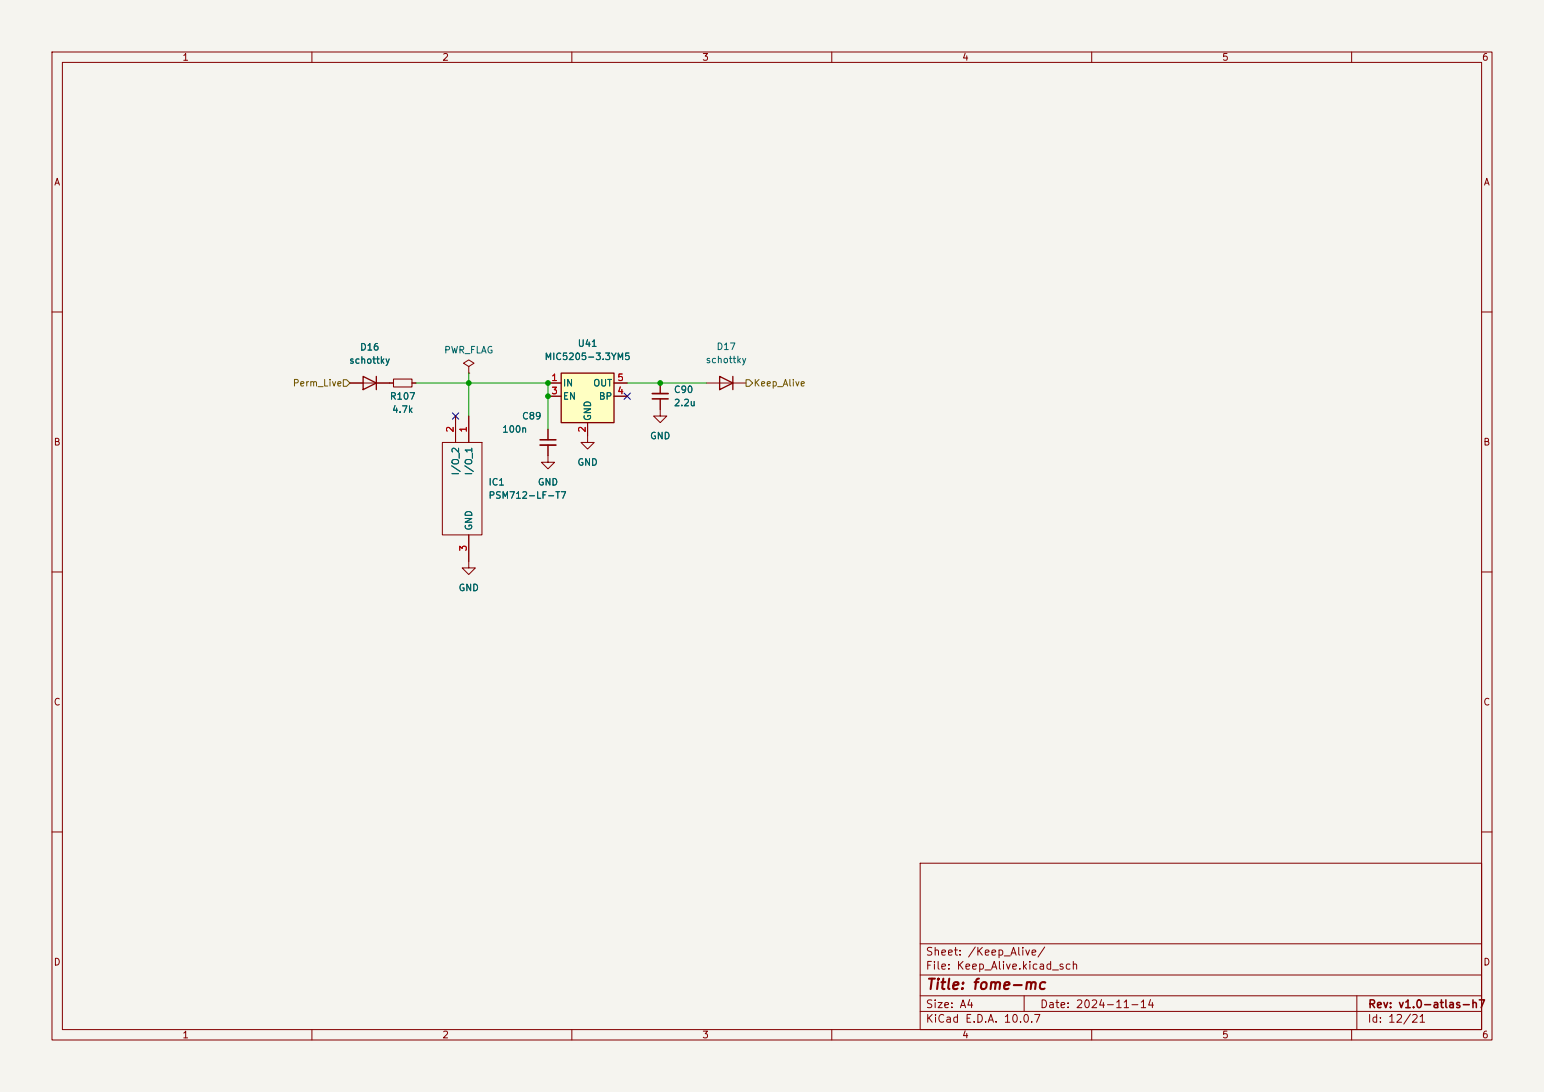
[picture p99: page 12]

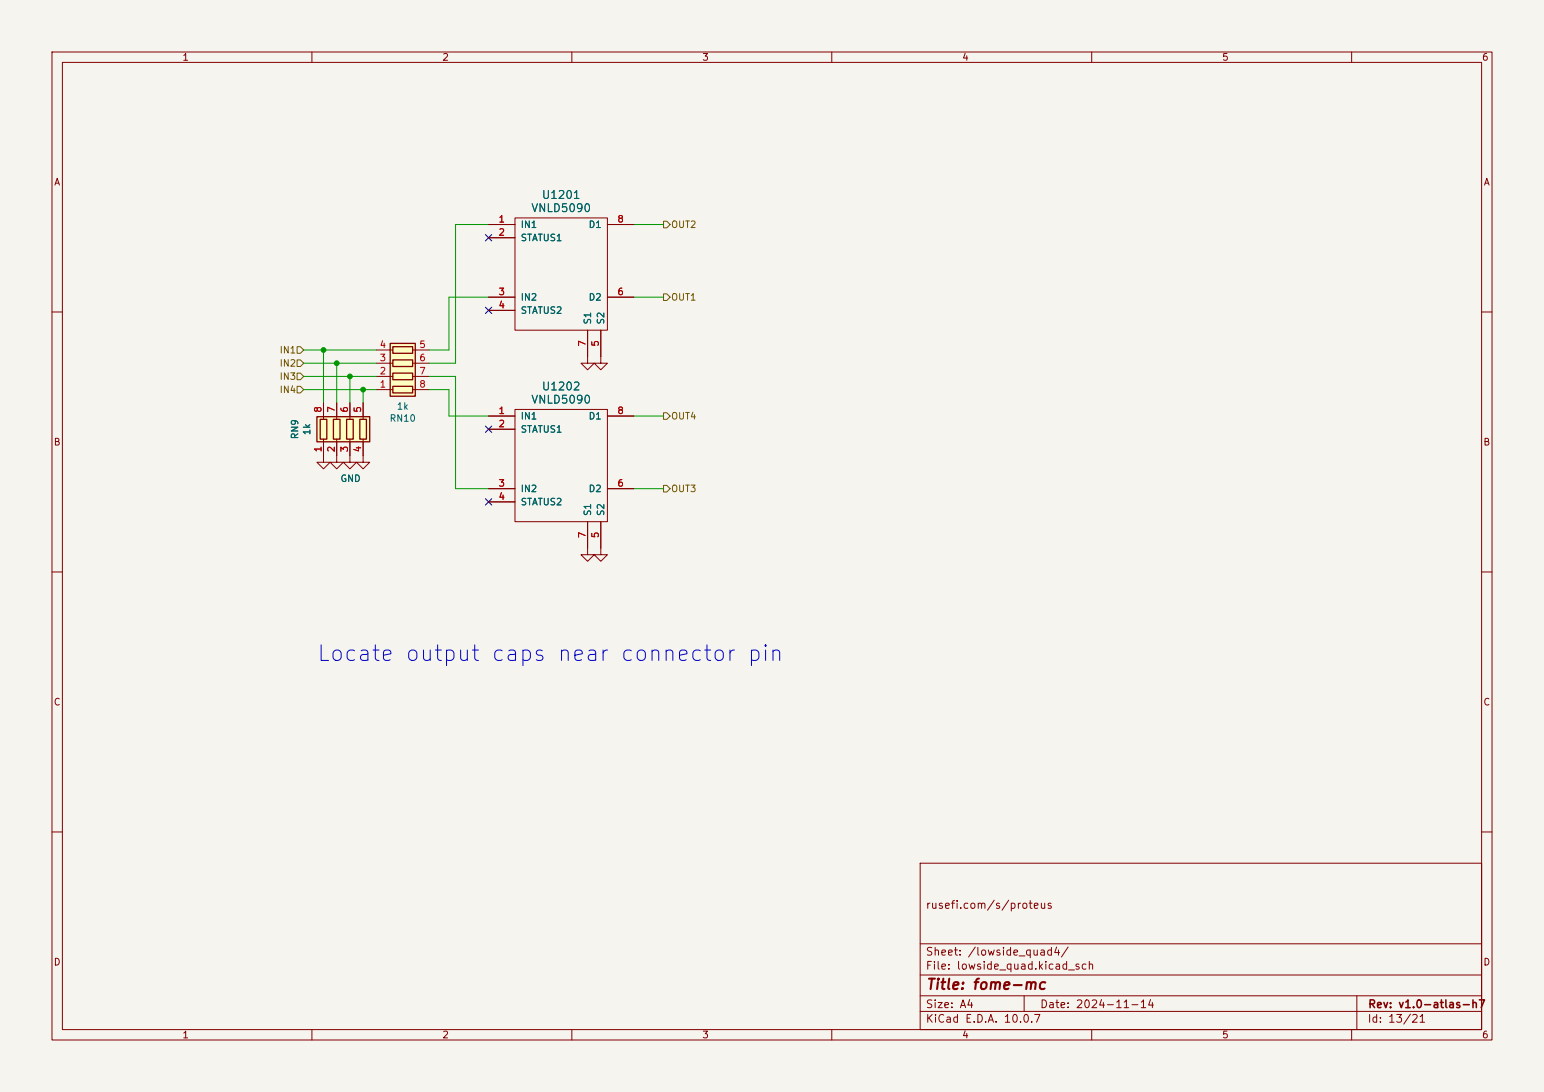
[picture p100: page 13]

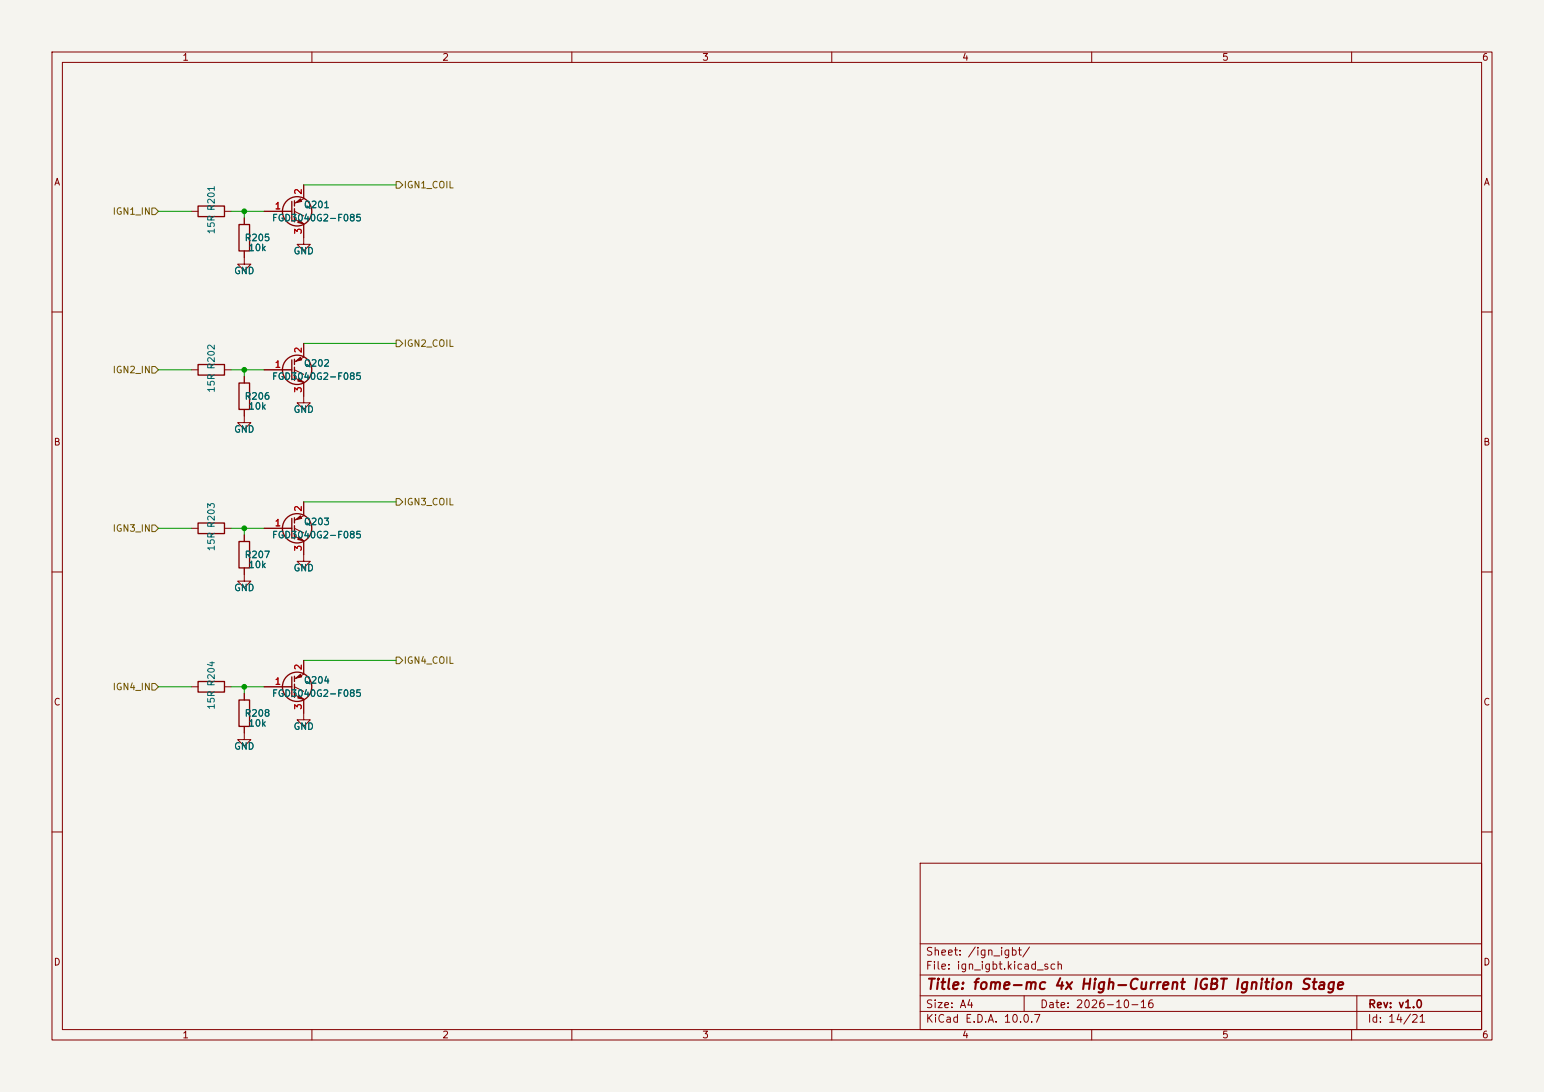
[picture p101: page 14]

File: ign_igbt.kicad_sch
Title: fome-mc 4x High-Current IGBT Ignition Stage

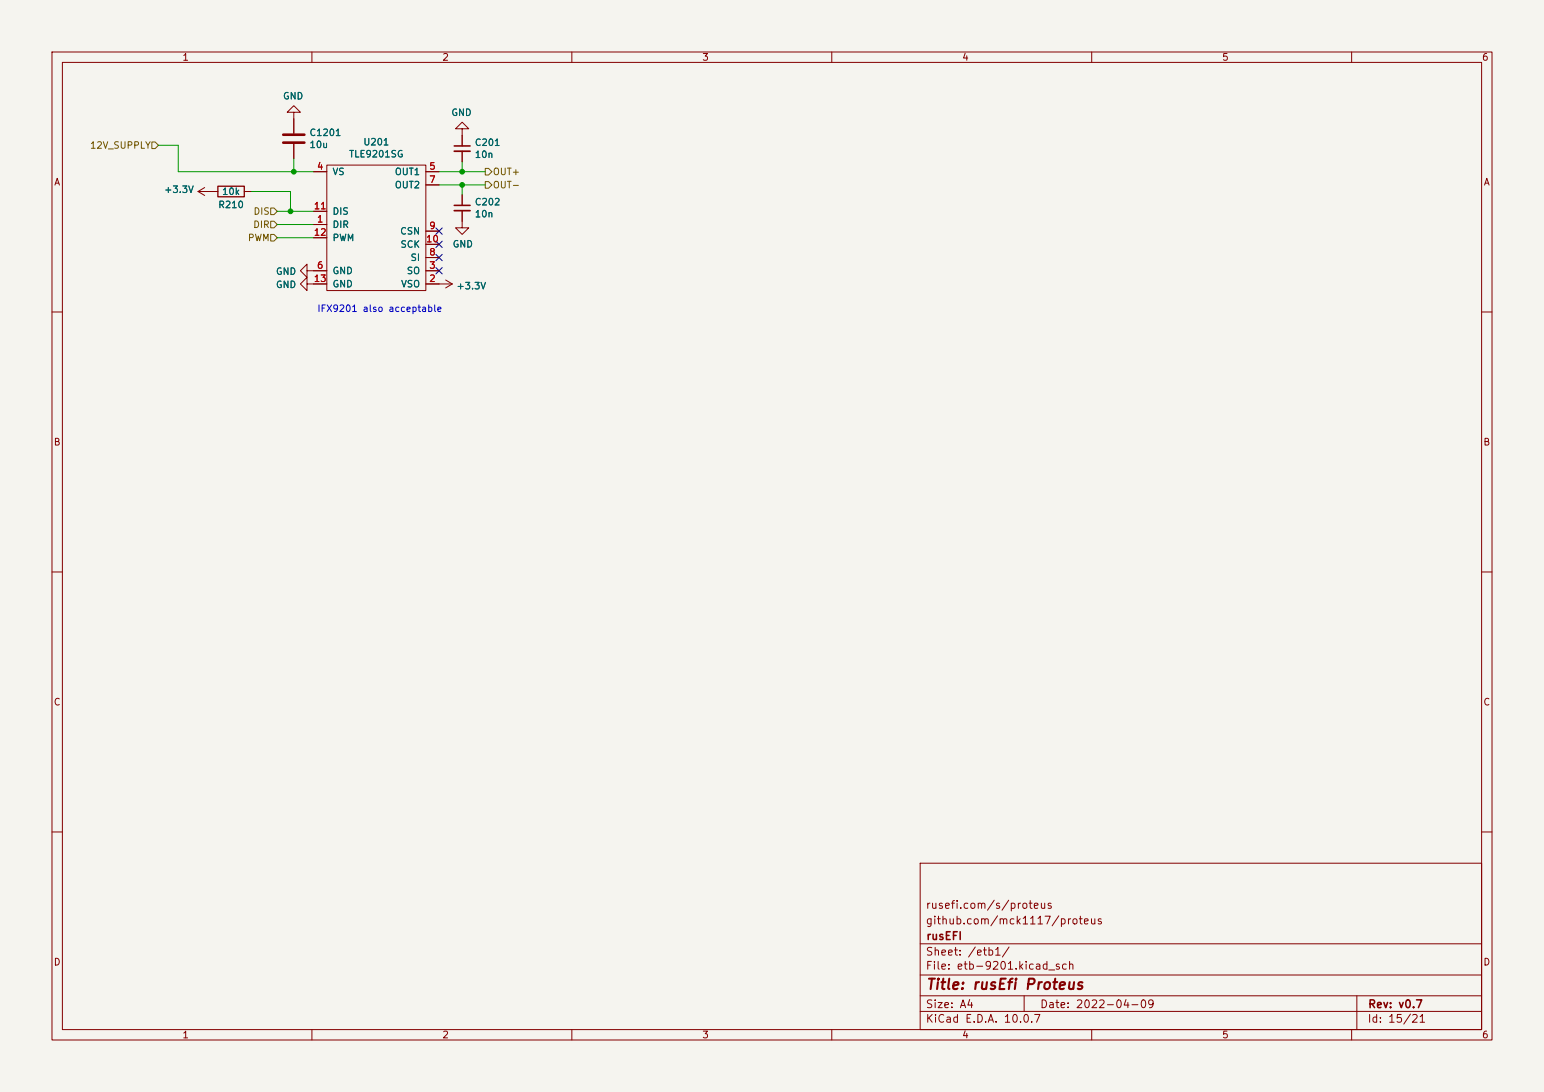
[picture p102: page 15]

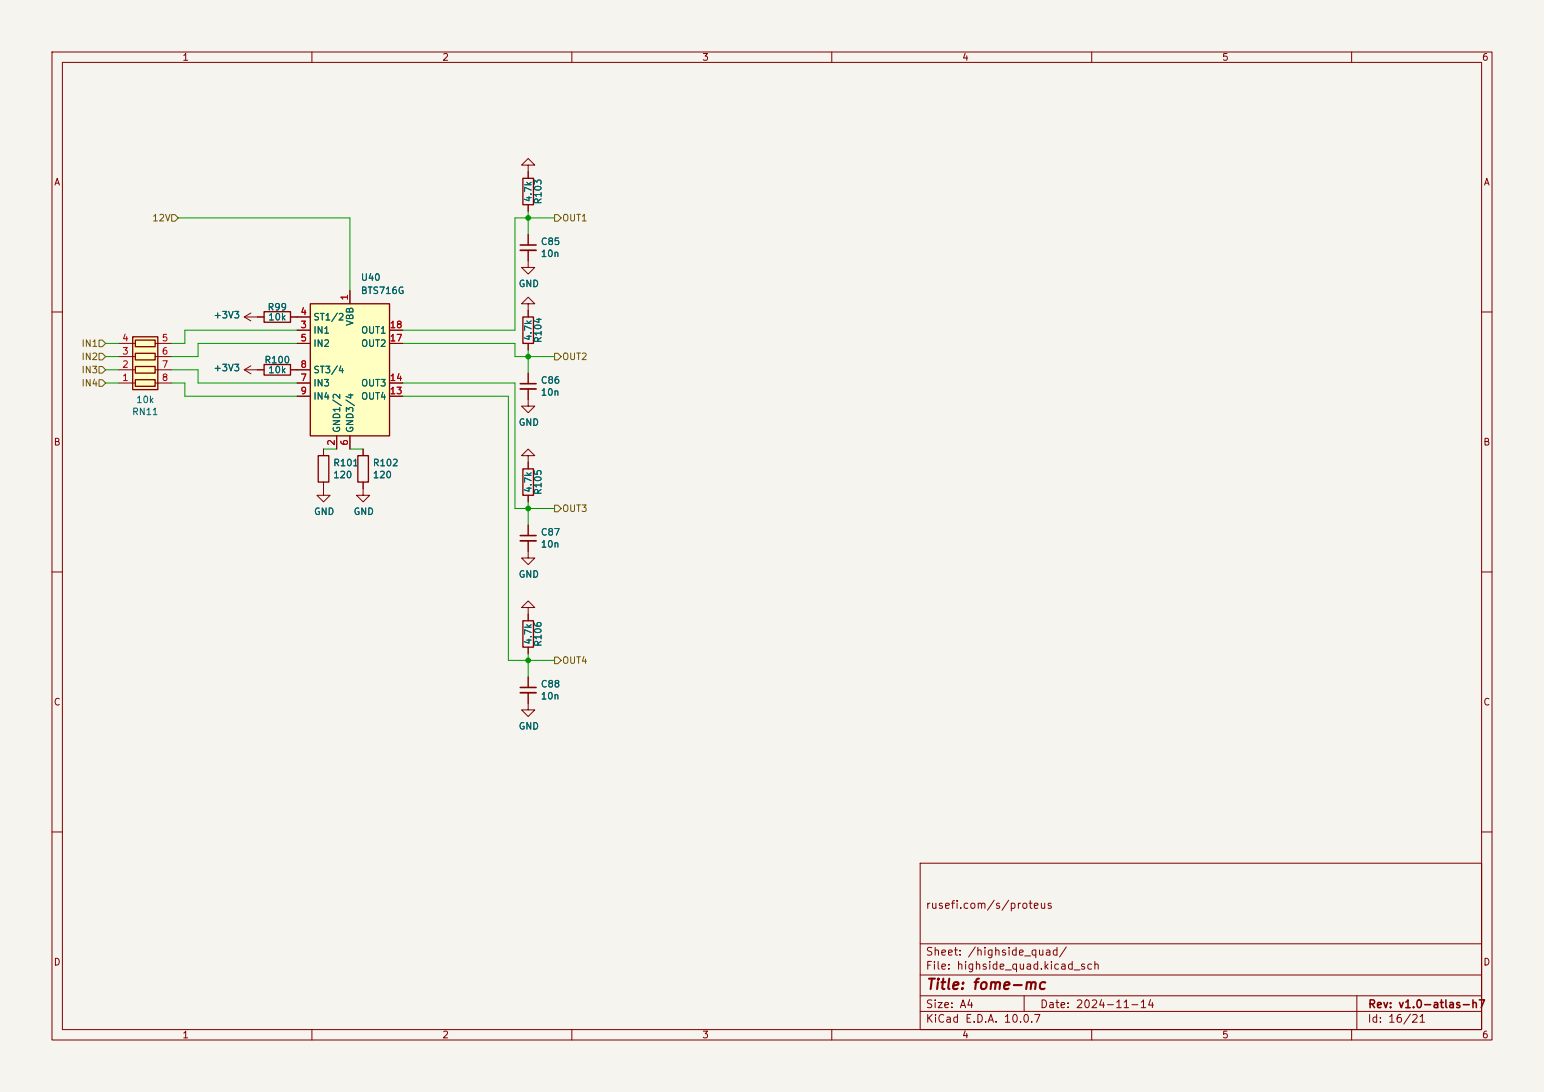
[picture p103: page 16]

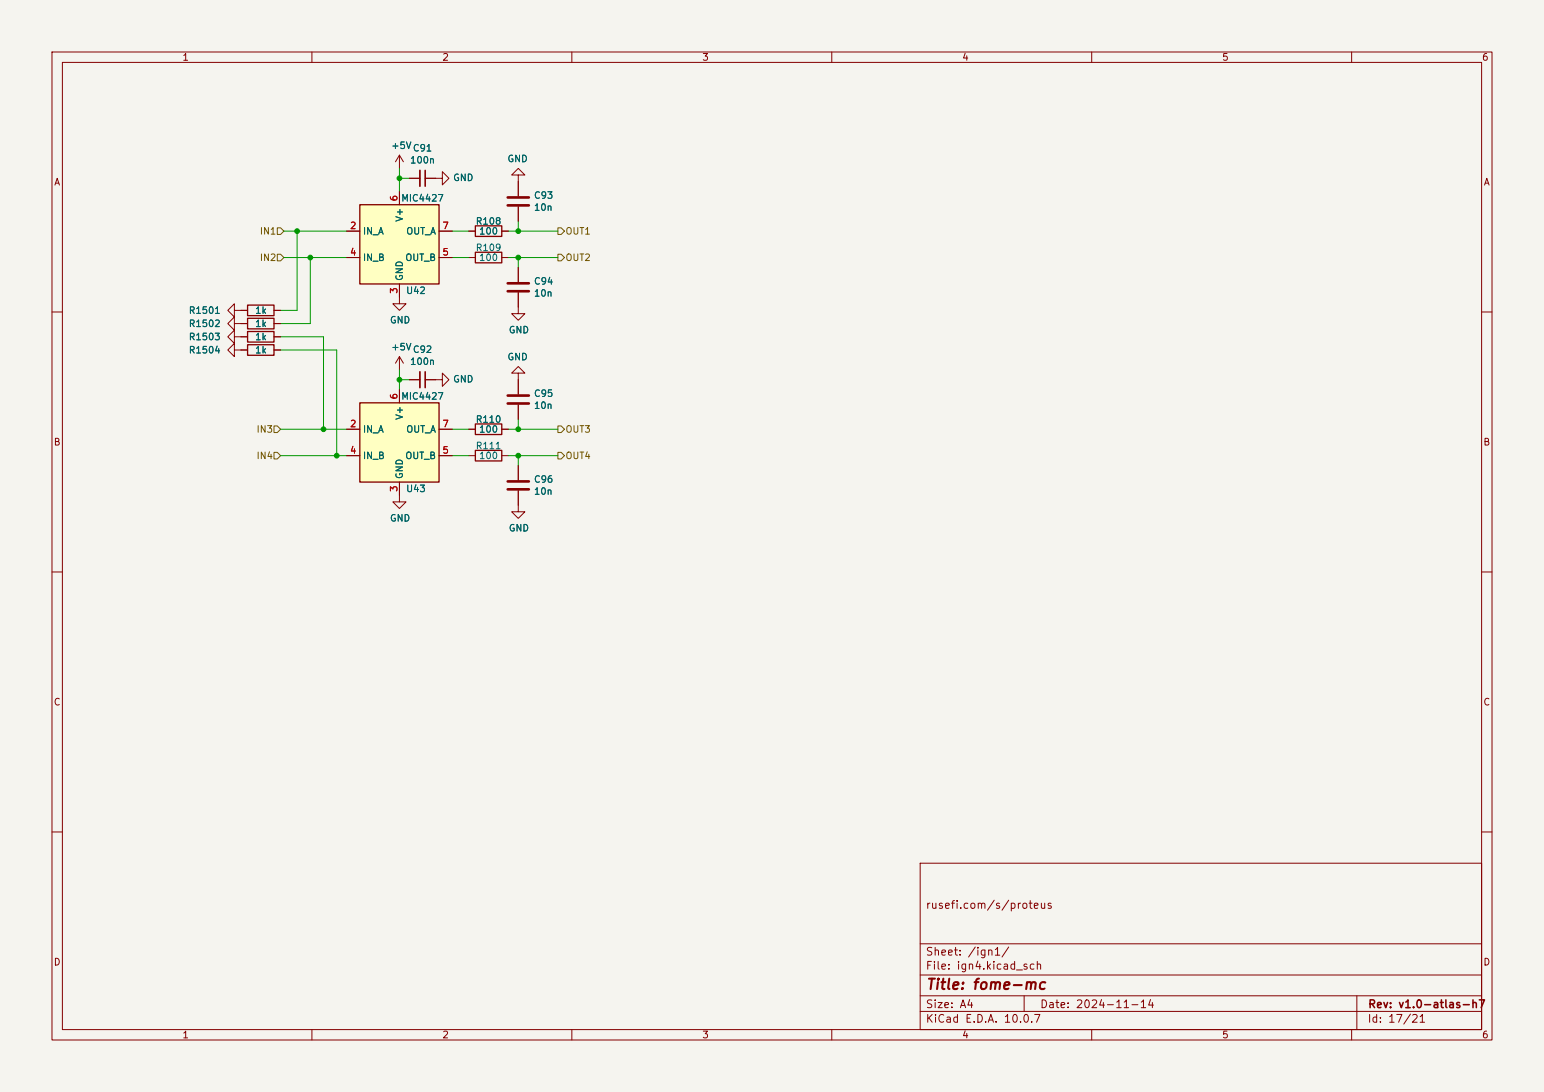
[picture p104: page 17]

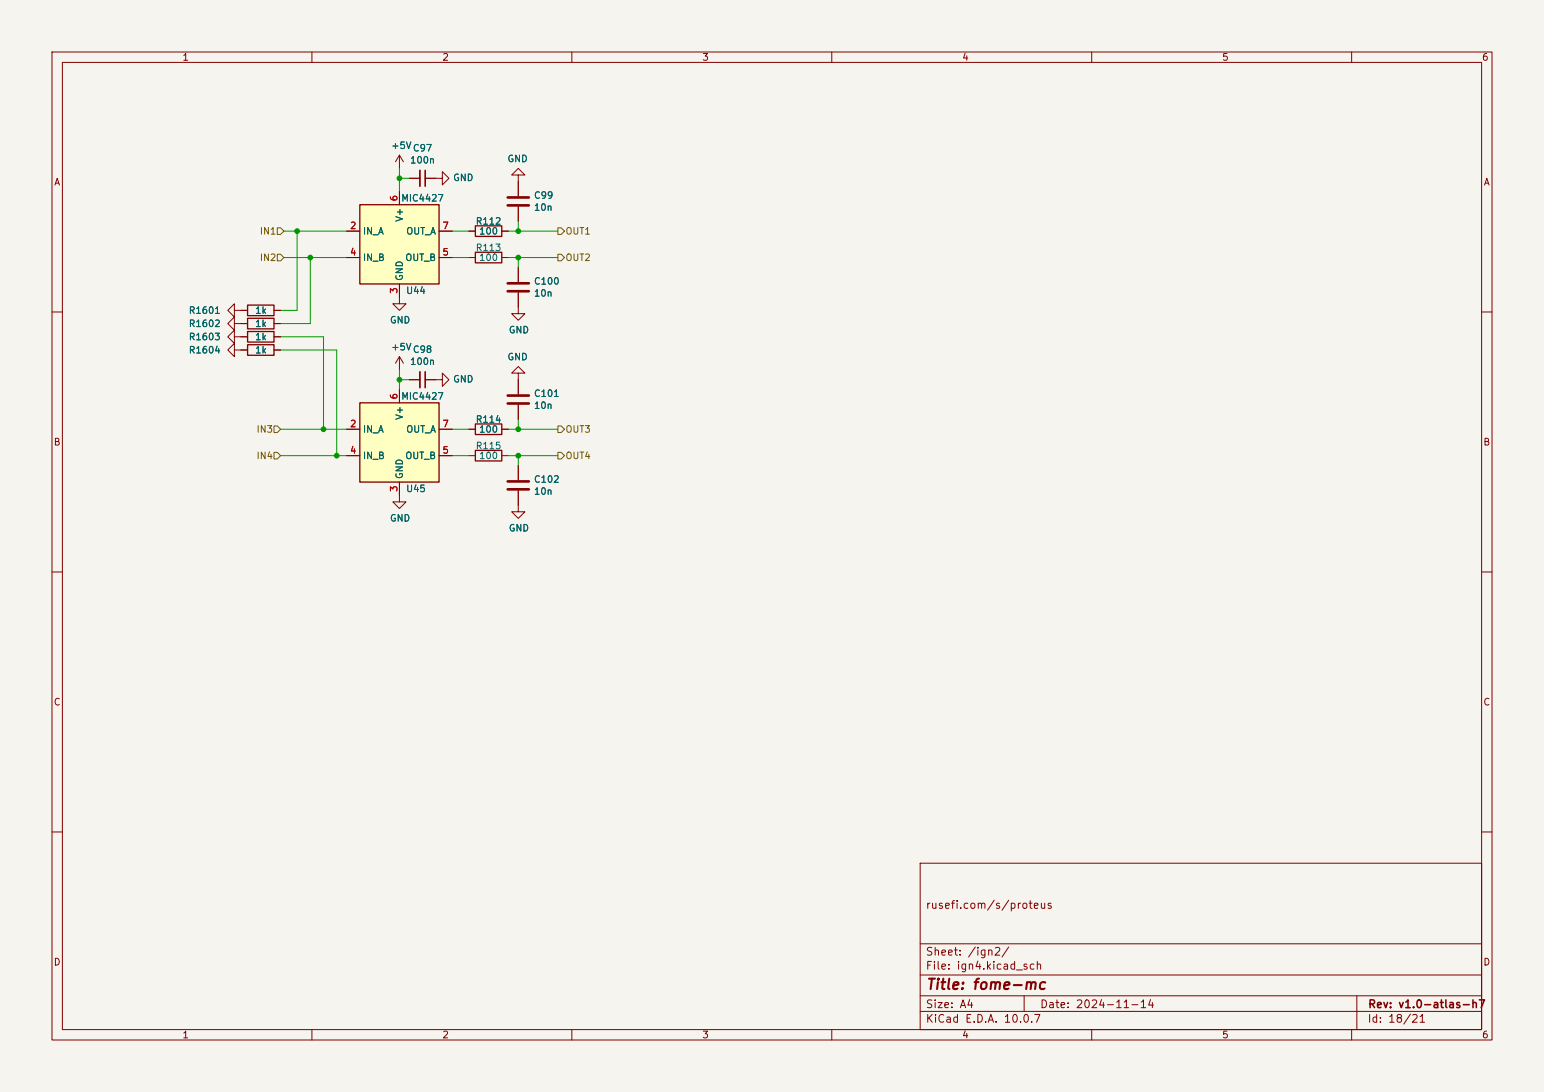
[picture p105: page 18]

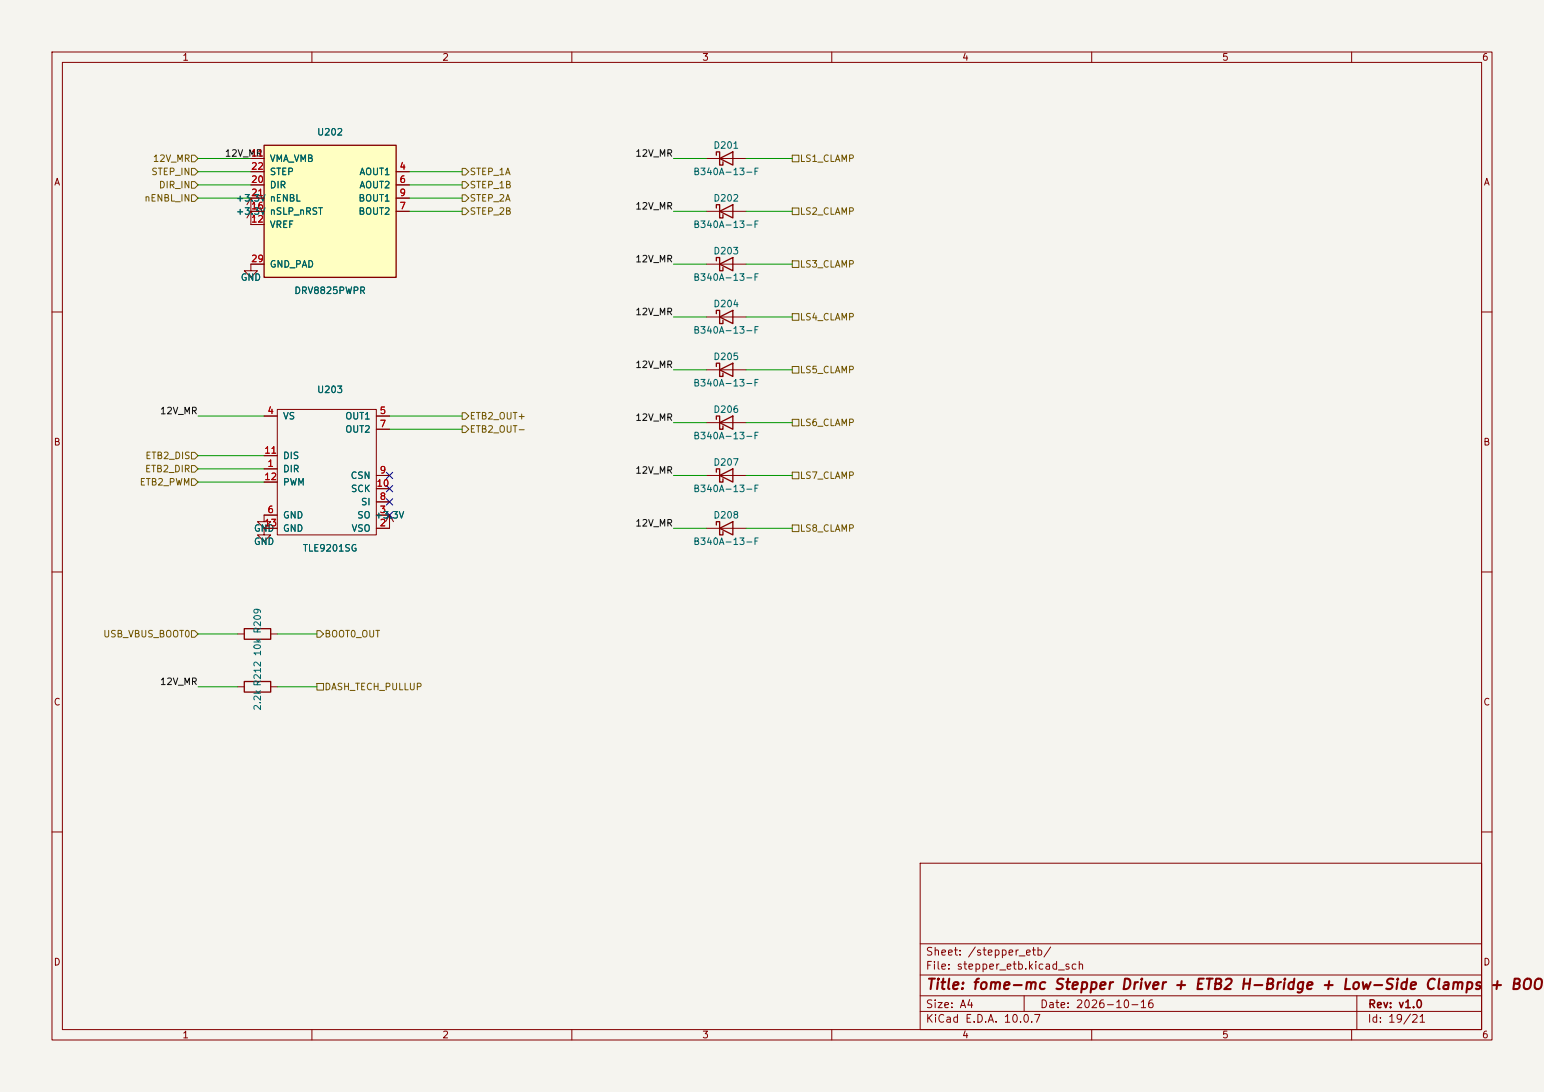
[picture p106: page 19]

Sheet: /stepper_etb/
File: stepper_etb.kicad_sch
Title: fome-mc Stepper Driver + ETB2 H-Bridge + Low-Side Clamps + BOOT0 Recovery

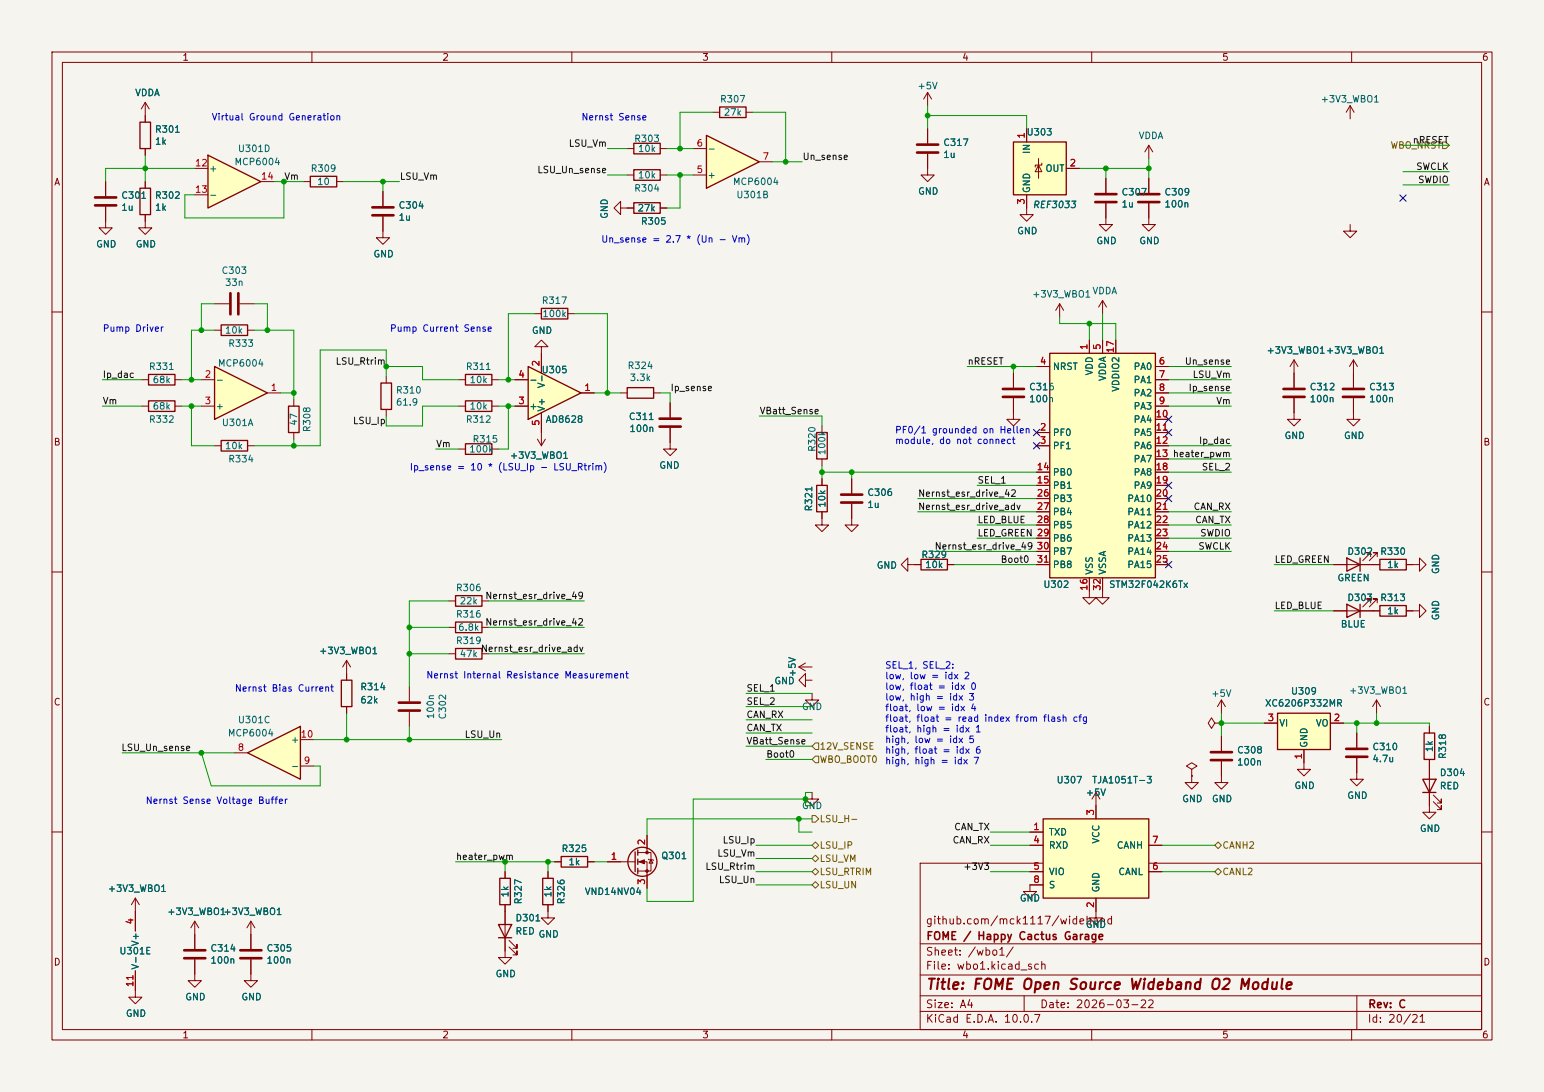
[picture p107: page 20]

1 PF0 2 PF1 3 NRST 4 VDDA 5 PA0 6 PA1 7 PA2 8 PA3 9 PA4 10 PA5 11 PA6 12 PA7 13 PB0 14 PB1 15 VSS 16 VDDIO2 17 PA8 18 PA9 19 PA10 20 PA11 21 PA12 22 PA13 23 PA14 24 PA15 25 PB3 26 PB4 27 PB5 28 PB6 29 PB7 30 PB8 31 VSSA U302 32STM32F042K6Tx R309

1 PF0 2 PF1 3 NRST 4 VDDA 5 PA0 6 PA1 7 PA2 8 PA3 9 PA4 10 PA5 11 PA6 12 PA7 13 PB0 14 PB1 15 VSS 16 VDDIO2 17 PA8 18 PA9 19 PA10 20 PA11 21 PA12 22 PA13 23 PA14 24 PA15 25 PB3 26 PB4 27 PB5 28 PB6 29 PB7 30 PB8 31 VSSA 32 C316

Ip_sense Nernst Sense Voltage Buffer

low, float = idx 0
low, high = idx 3
float, low = idx 4
float, float = read index from flash cfg
float, high = idx 1
high, low = idx 5
high, float = idx 6
high, high = idx 7

github.com/mck1117/wideband
FOME / Happy Cactus Garage
Sheet: /wbo1/
File: wbo1.kicad_sch
Title: FOME Open Source Wideband O2 Module

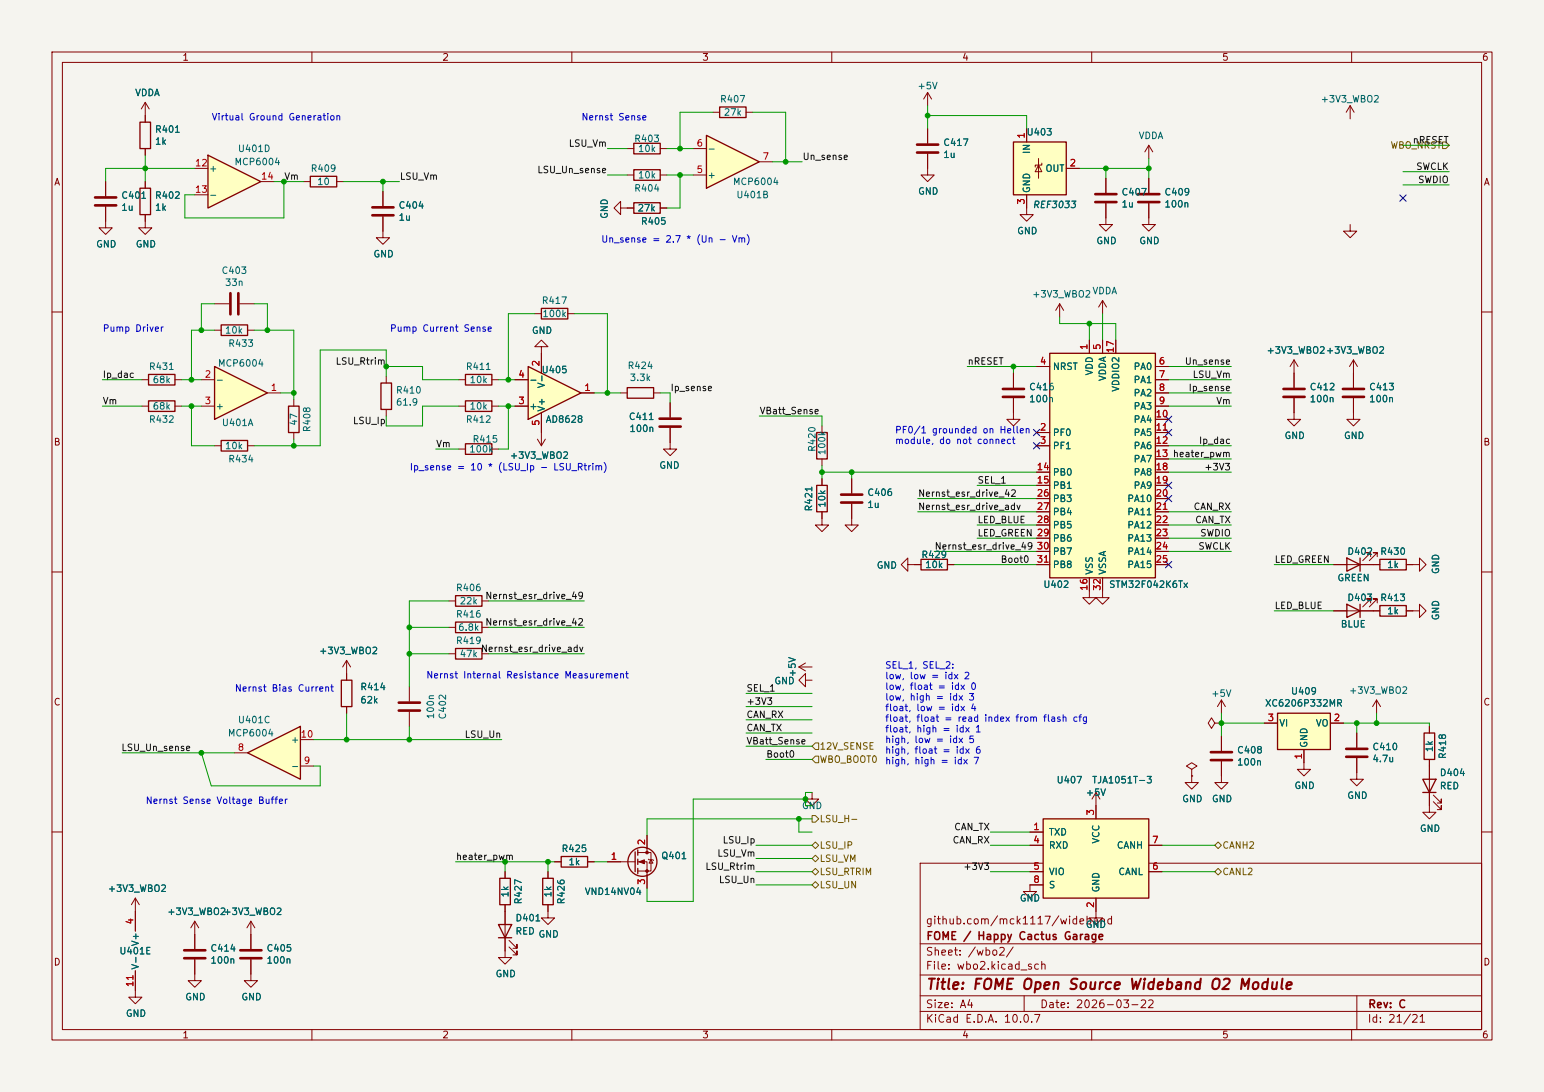
[picture p108: page 21]

1 PF0 2 PF1 3 NRST 4 VDDA 5 PA0 6 PA1 7 PA2 8 PA3 9 PA4 10 PA5 11 PA6 12 PA7 13 PB0 14 PB1 15 VSS 16 VDDIO2 17 PA8 18 PA9 19 PA10 20 PA11 21 PA12 22 PA13 23 PA14 24 PA15 25 PB3 26 PB4 27 PB5 28 PB6 29 PB7 30 PB8 31 VSSA 32 C416

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

Nernst Sense Voltage Buffer

github.com/mck1117/wideband
FOME / Happy Cactus Garage
Sheet: /wbo2/
File: wbo2.kicad_sch
Title: FOME Open Source Wideband O2 Module
