halbritt/fome-mc/reports/toolchain/baseline/universal-112/export/native/Polygonus-Universal-Base-layers.pdf

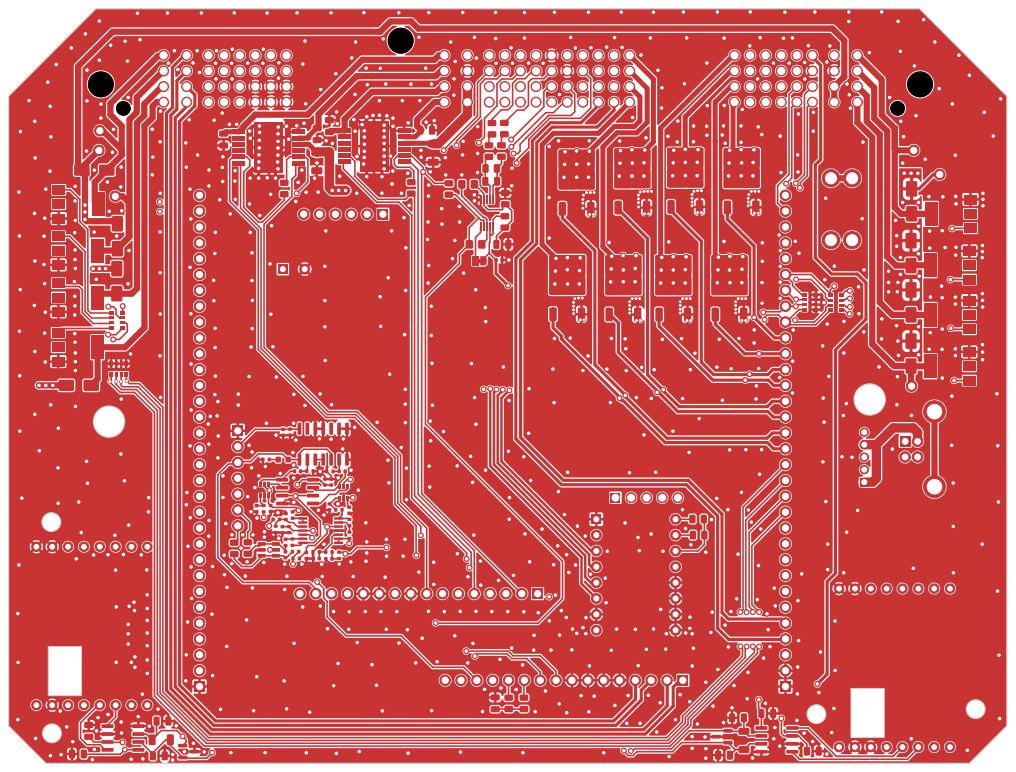
[picture p109: page 1]

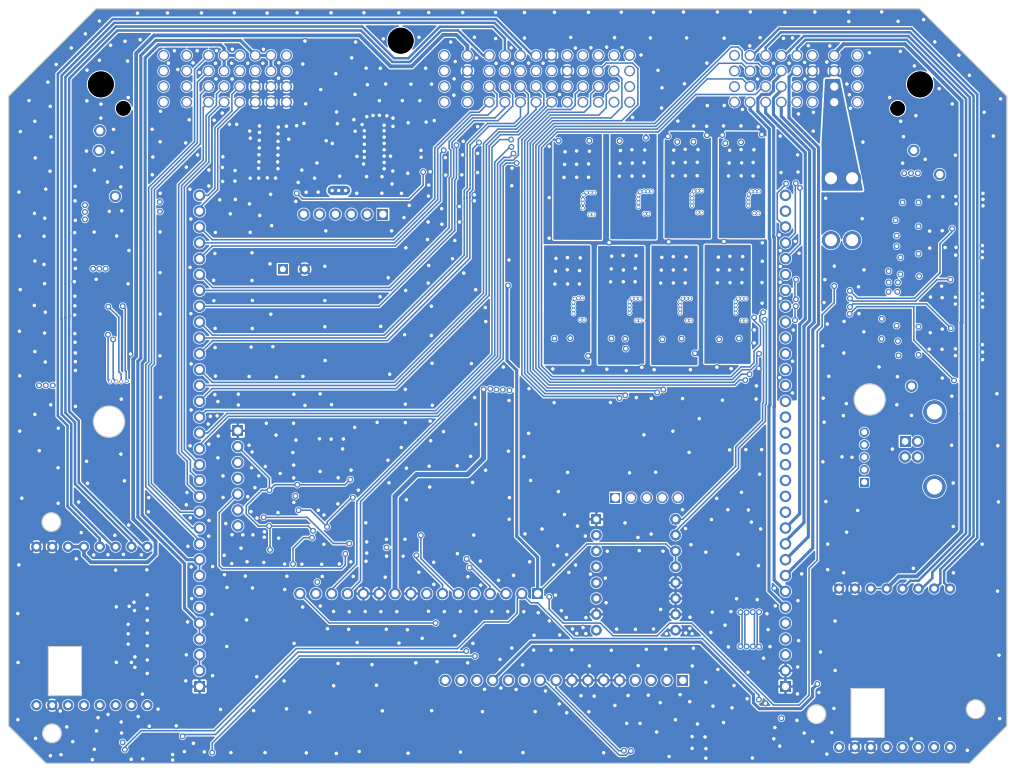
[picture p110: page 2]

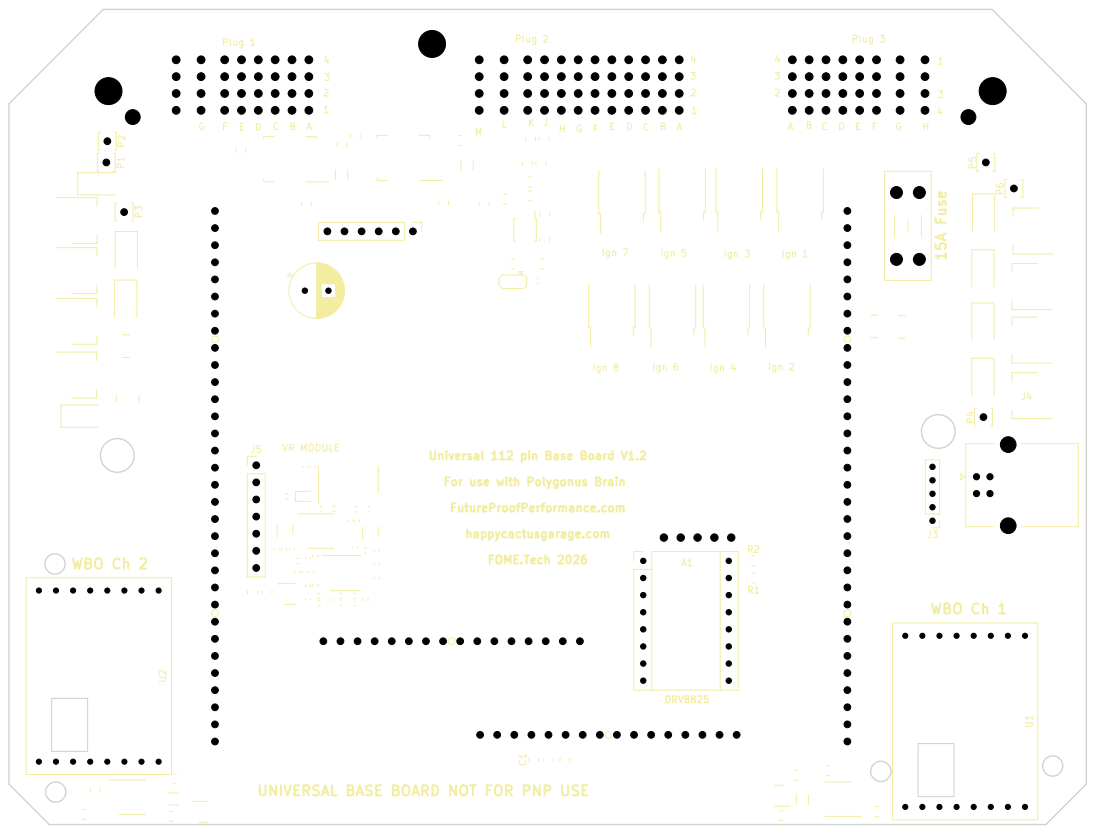
[picture p111: page 3]

Ign 4 UNIVERSAL BASE BOARD NOT FOR PNP USE

Ign 8 Universal 112 pin Base Board V1.2

For use with Polygonus Brain FutureProofPerformance.com

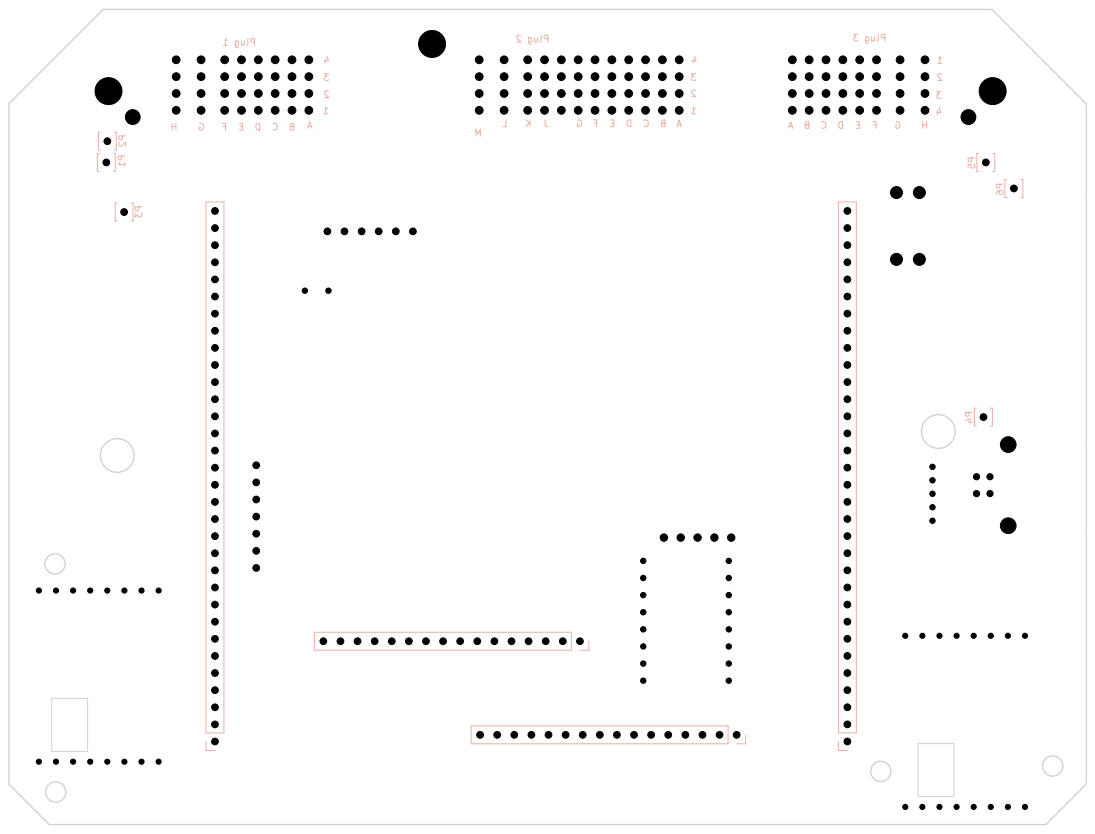
[picture p112: page 4]

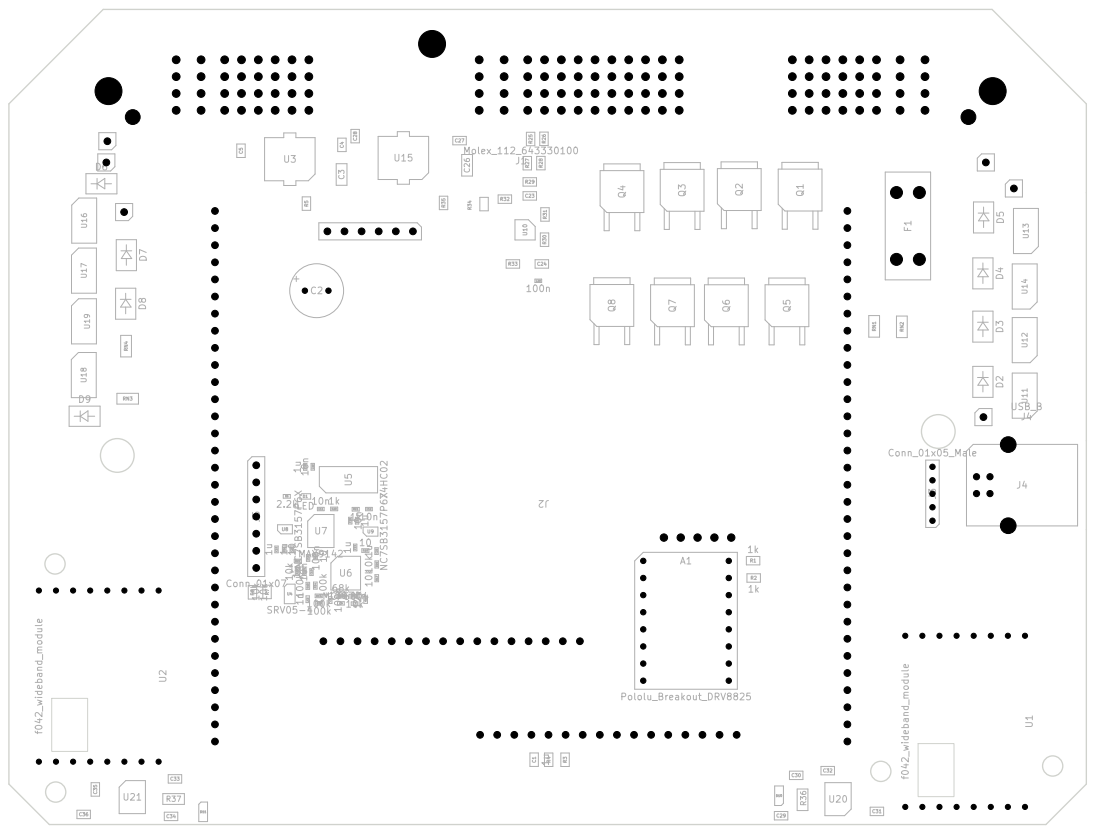
[picture p113: page 5]

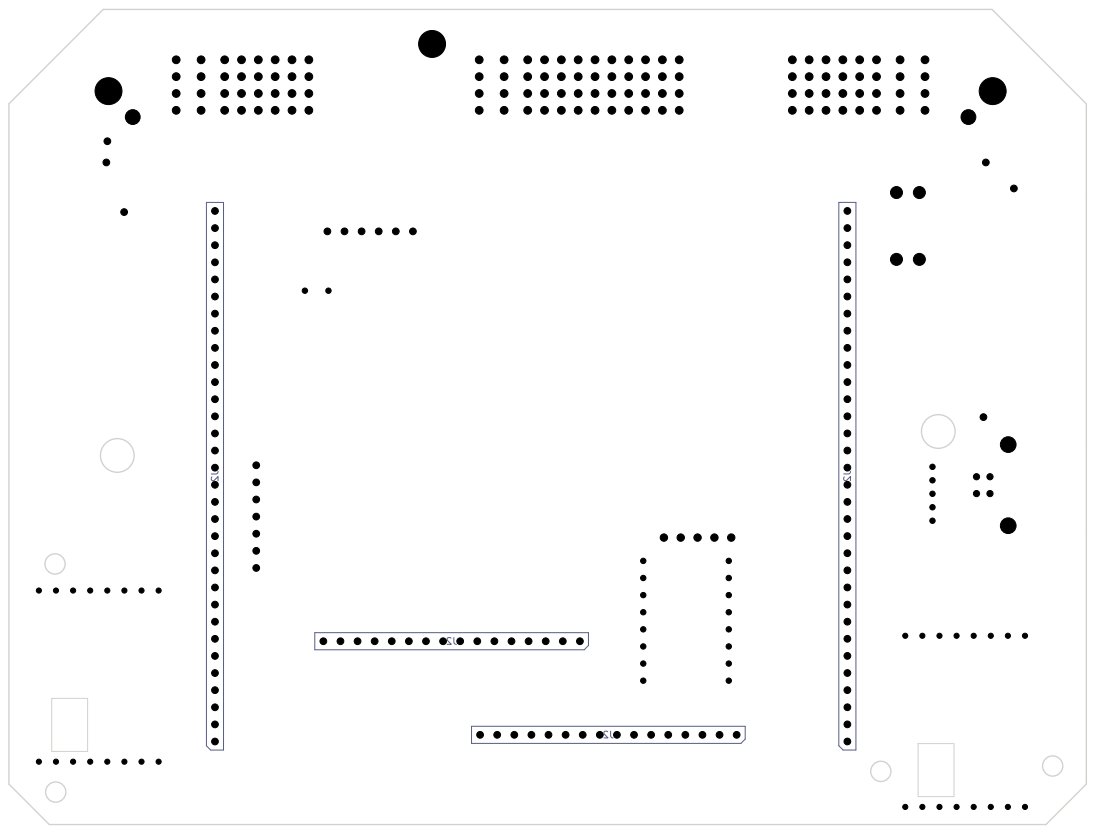
[picture p114: page 6]
