halbritt/fome-mc/reports/toolchain/baseline/fome-mc/export/native/Atlas-clone-layers.pdf

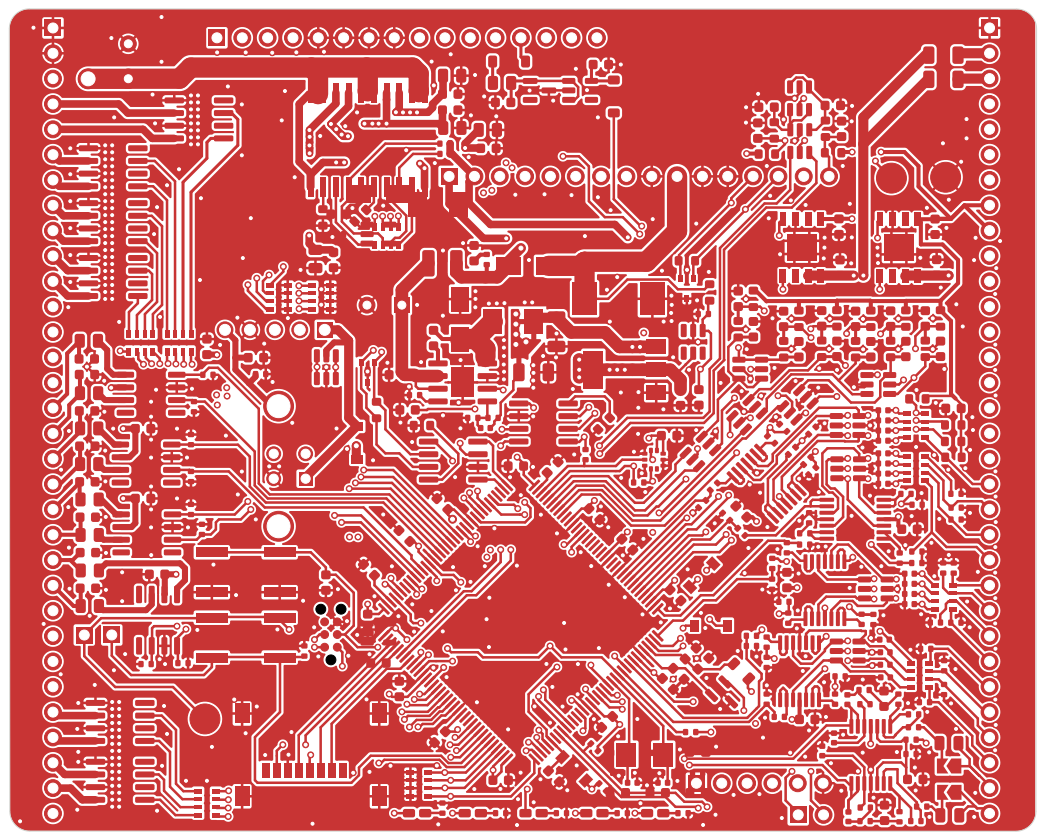
[picture p125: page 1]

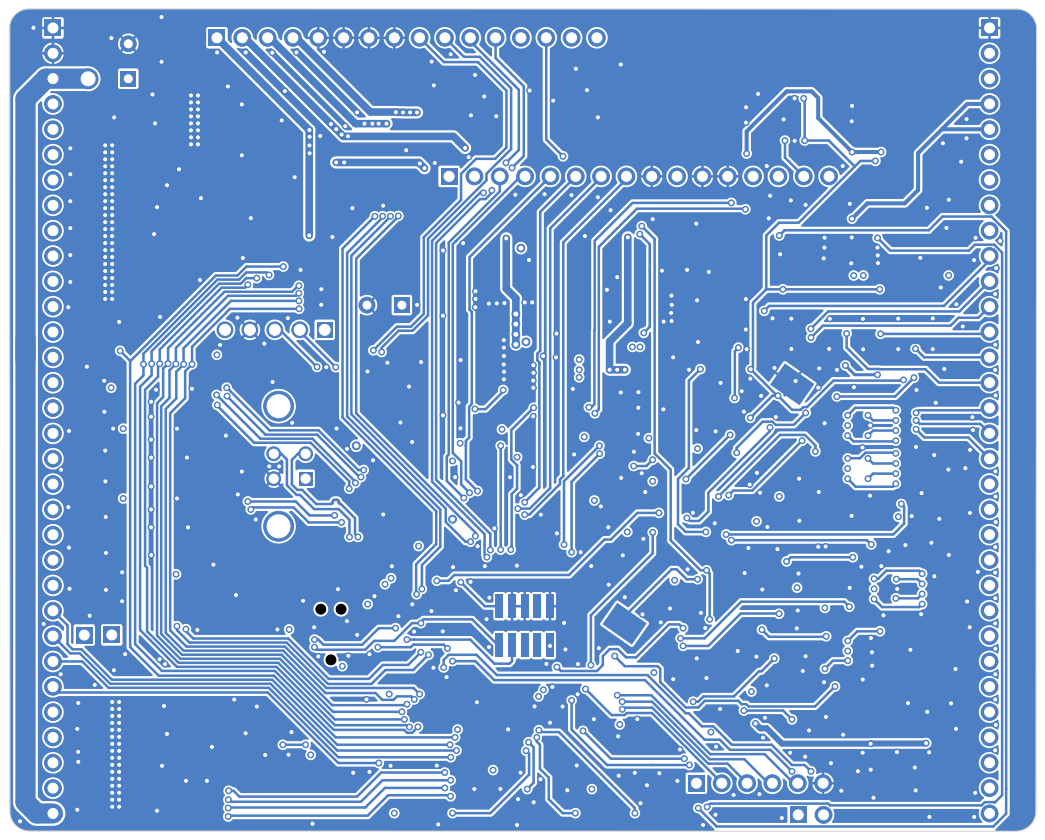
[picture p126: page 2]

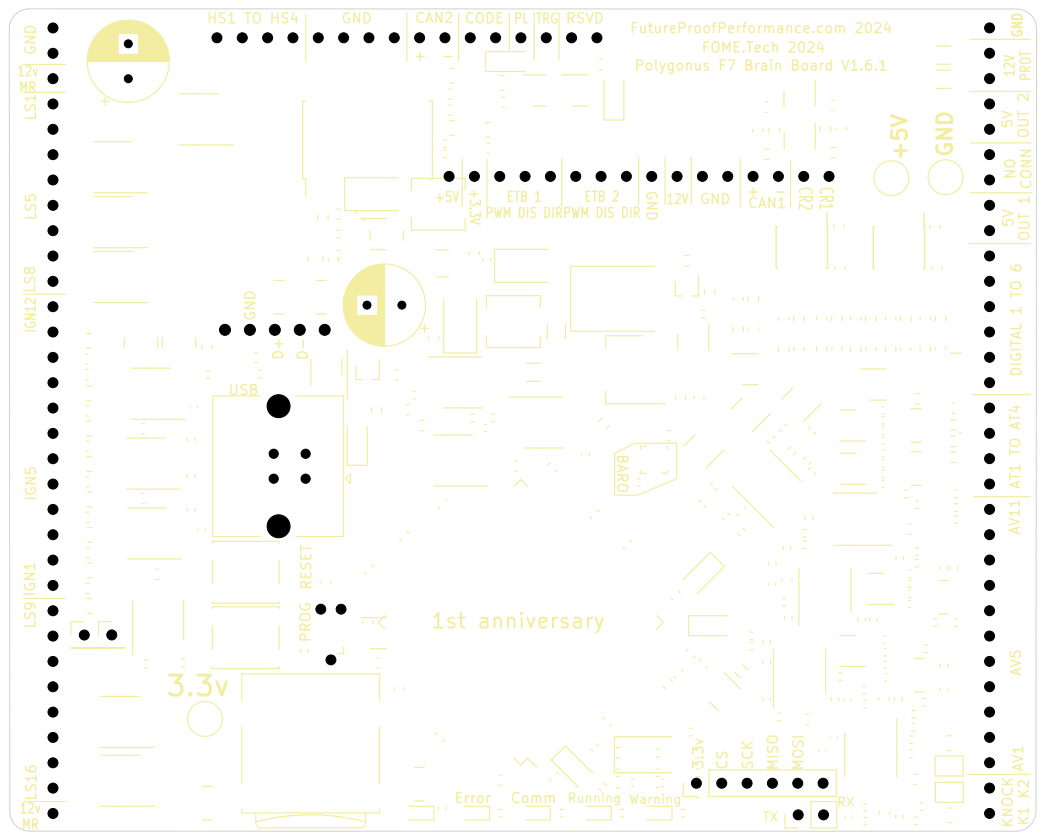
[picture p127: page 3]

ETB 2 PWM DIS DIR GND

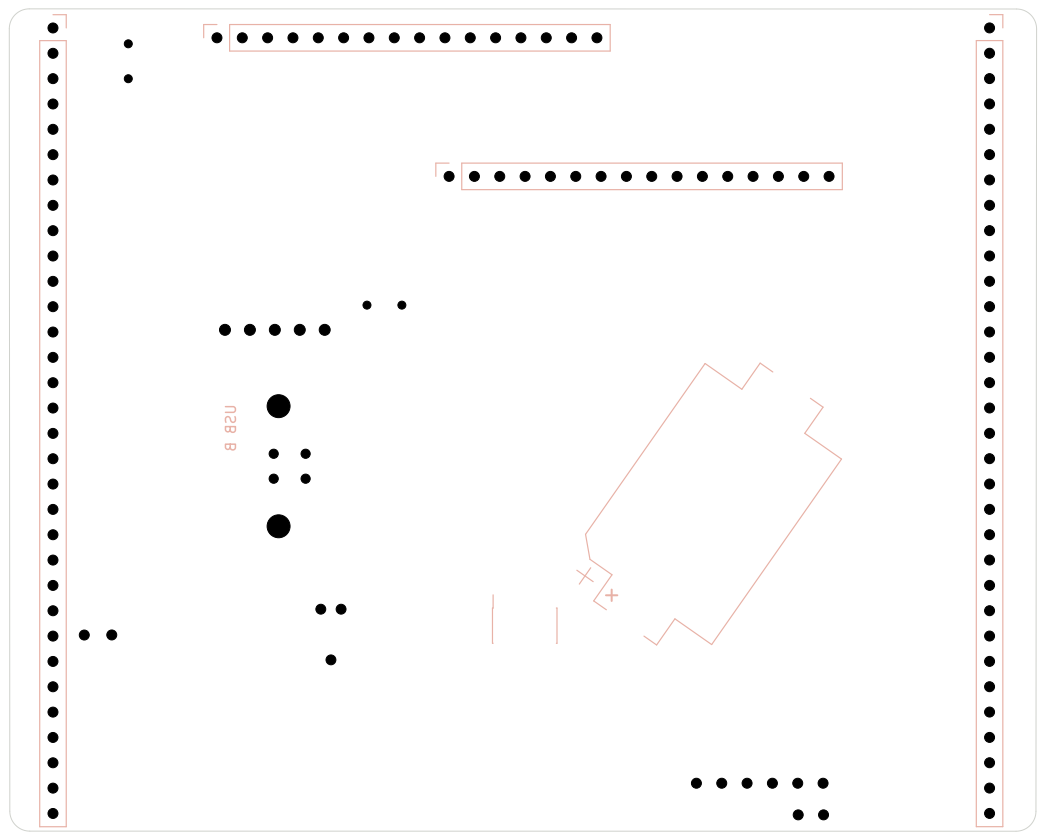
[picture p128: page 4]

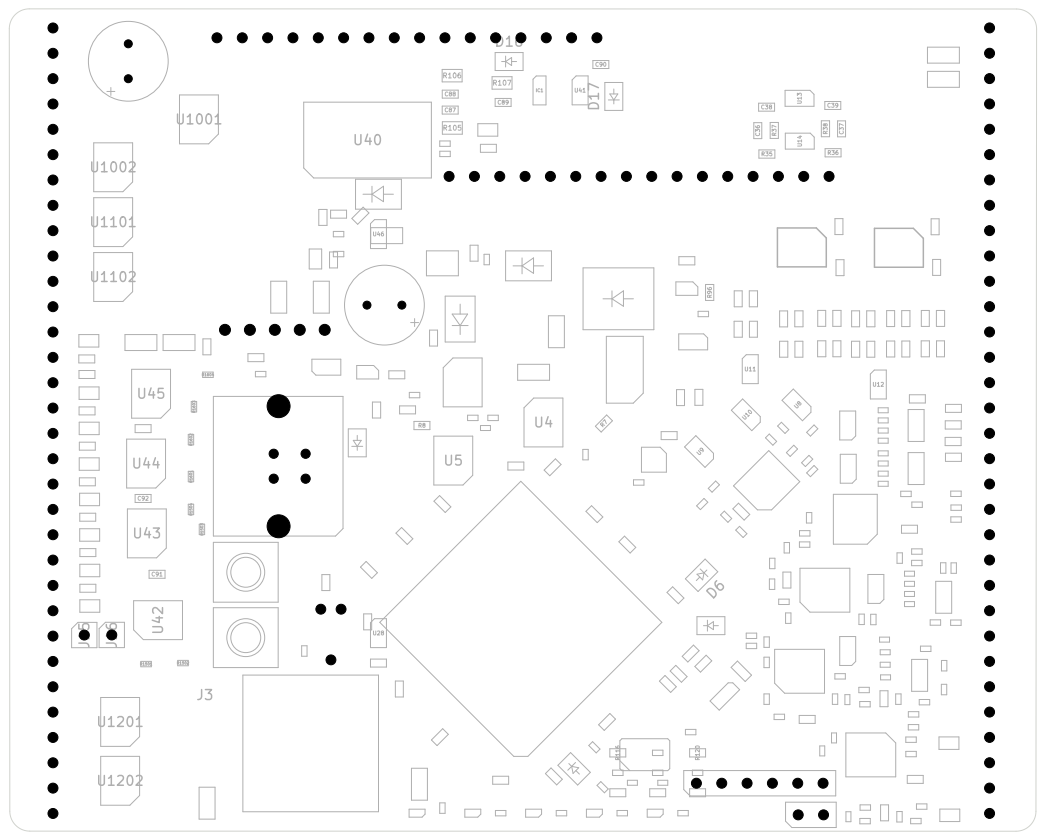
[picture p129: page 5]

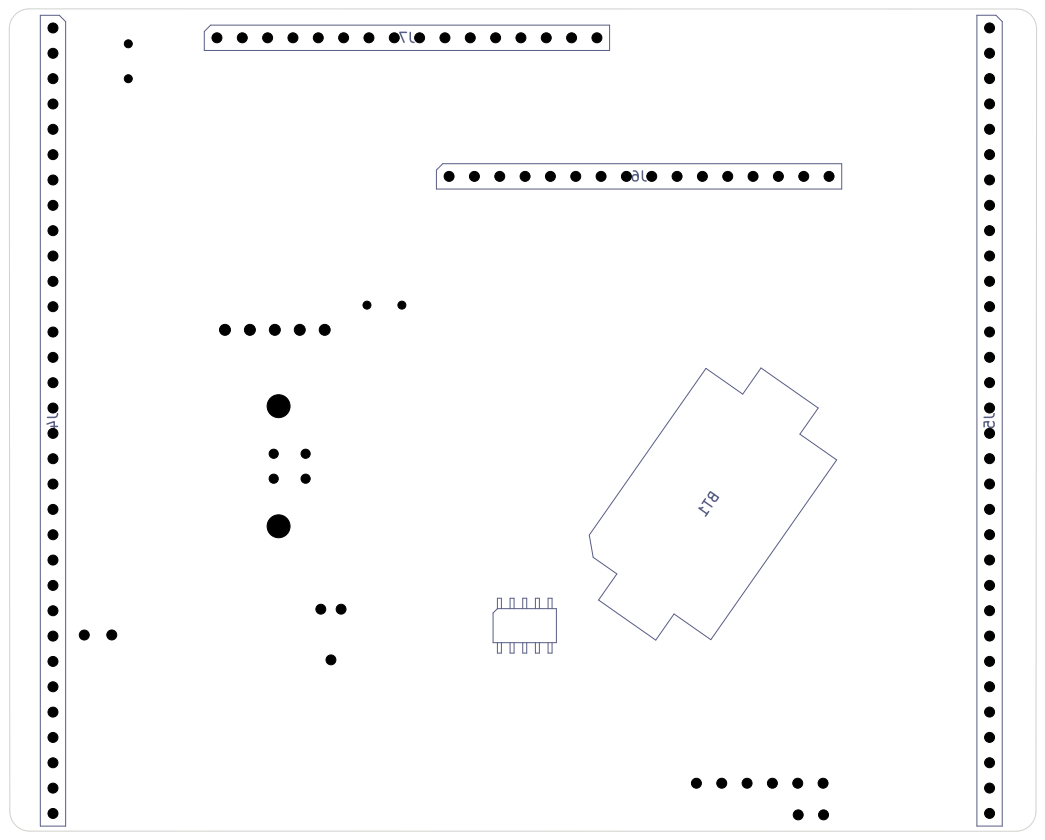
[picture p130: page 6]
