halbritt/fome-mc/reports/toolchain/baseline/fome-mc/export/native/Atlas-clone-schematic.pdf

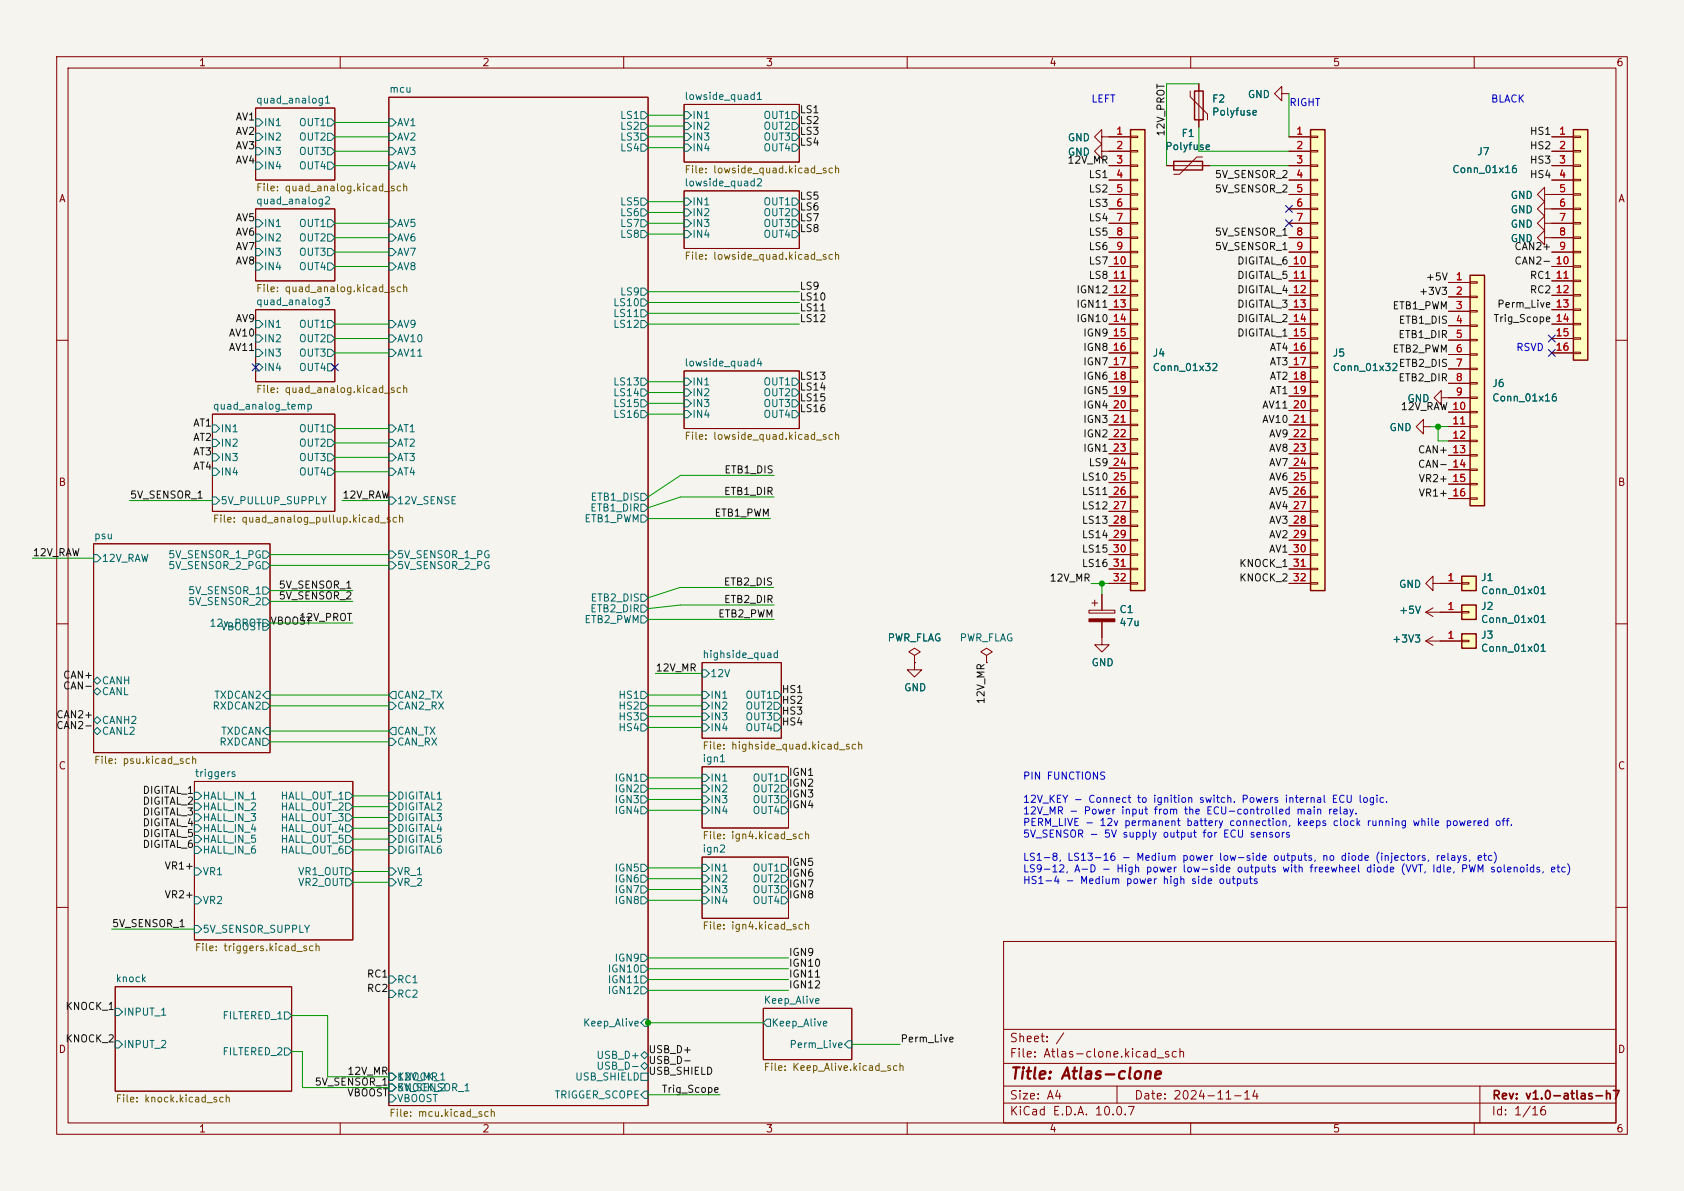
[picture p131: page 1]

12V_KEY - Connect to ignition switch. Powers internal ECU logic. 12V_MR - Power input from the ECU-controlled main relay. PERM_LIVE - 12v permanent battery connection, keeps clock running while powered off. 5V_SENSOR - 5V supply output for ECU sensors

LS1-8, LS13-16 - Medium power low-side outputs, no diode (injectors, relays, etc)
LS9-12, A-D - High power low-side outputs with freewheel diode (VVT, Idle, PWM solenoids, etc) HS1-4 - Medium power high side outputs

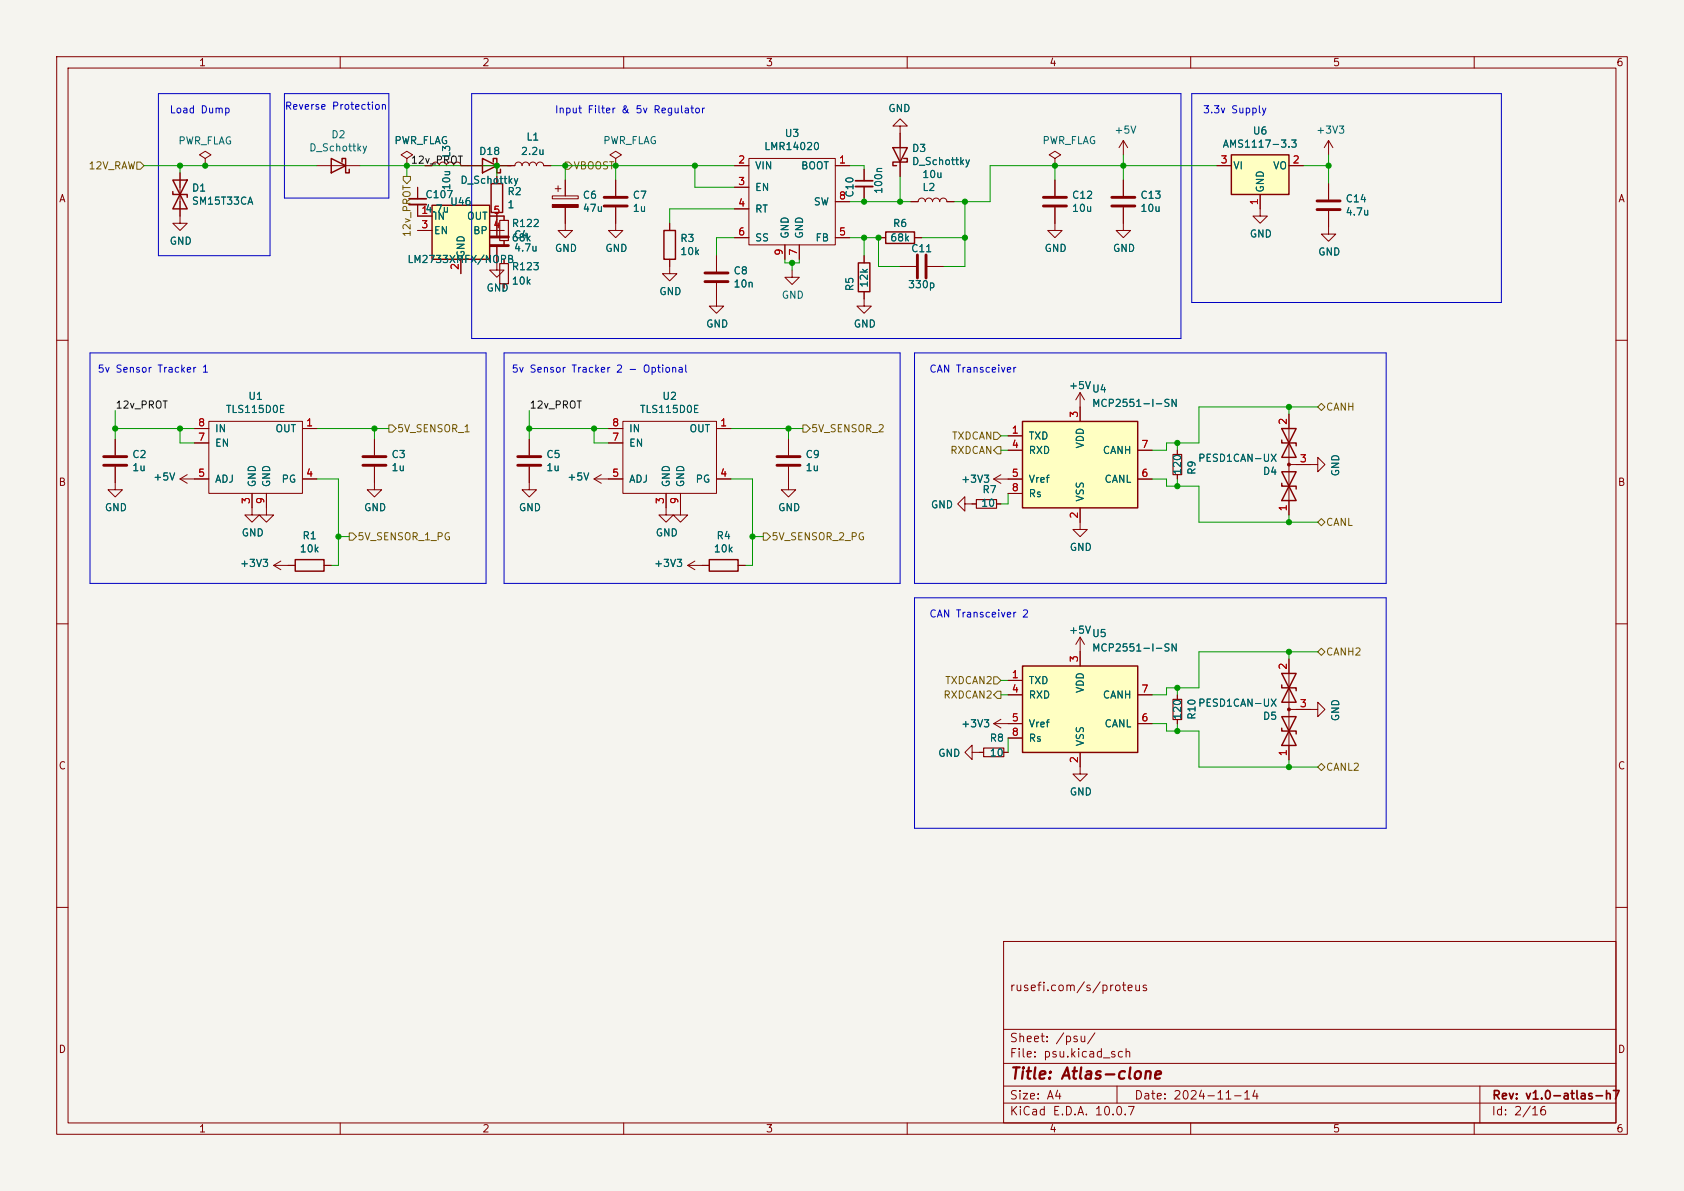
[picture p132: page 2]

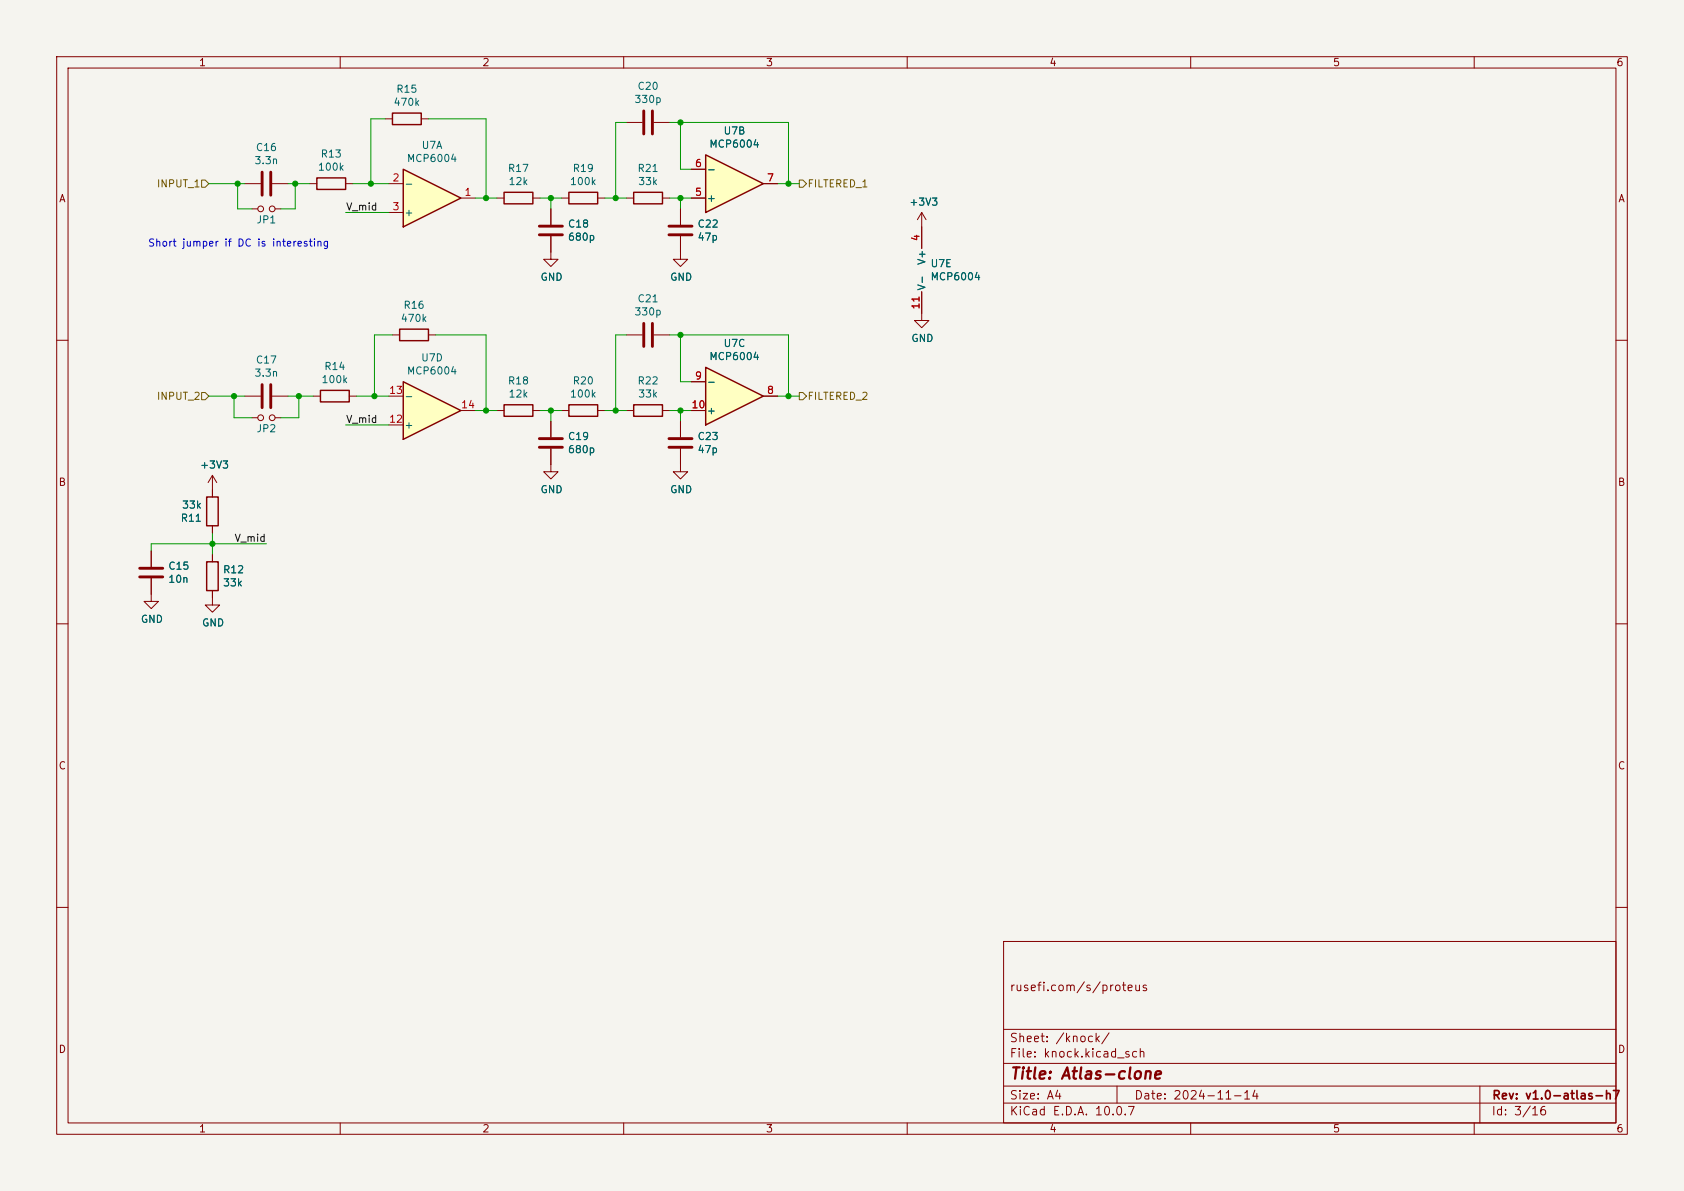
[picture p133: page 3]

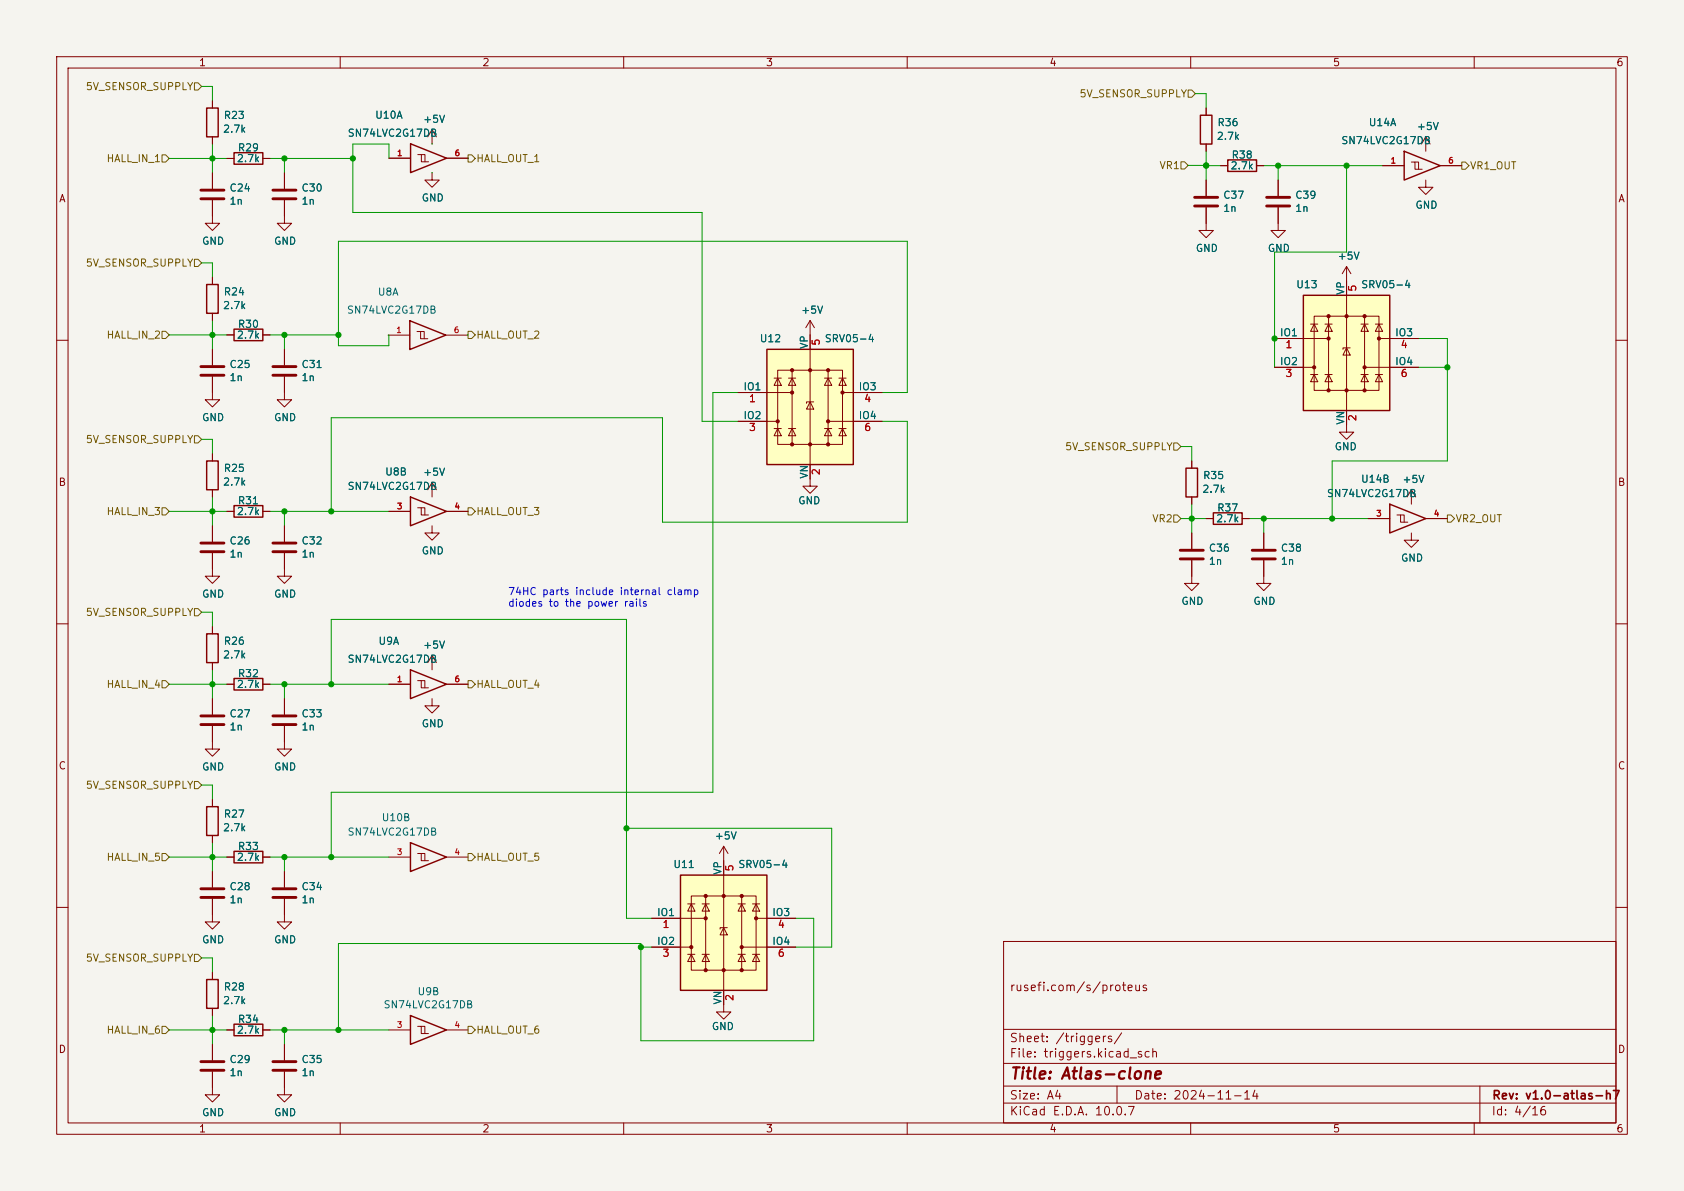
[picture p134: page 4]

diodes to the power rails C33

74HC parts include internal clamp

rusefi.com/s/proteus GND

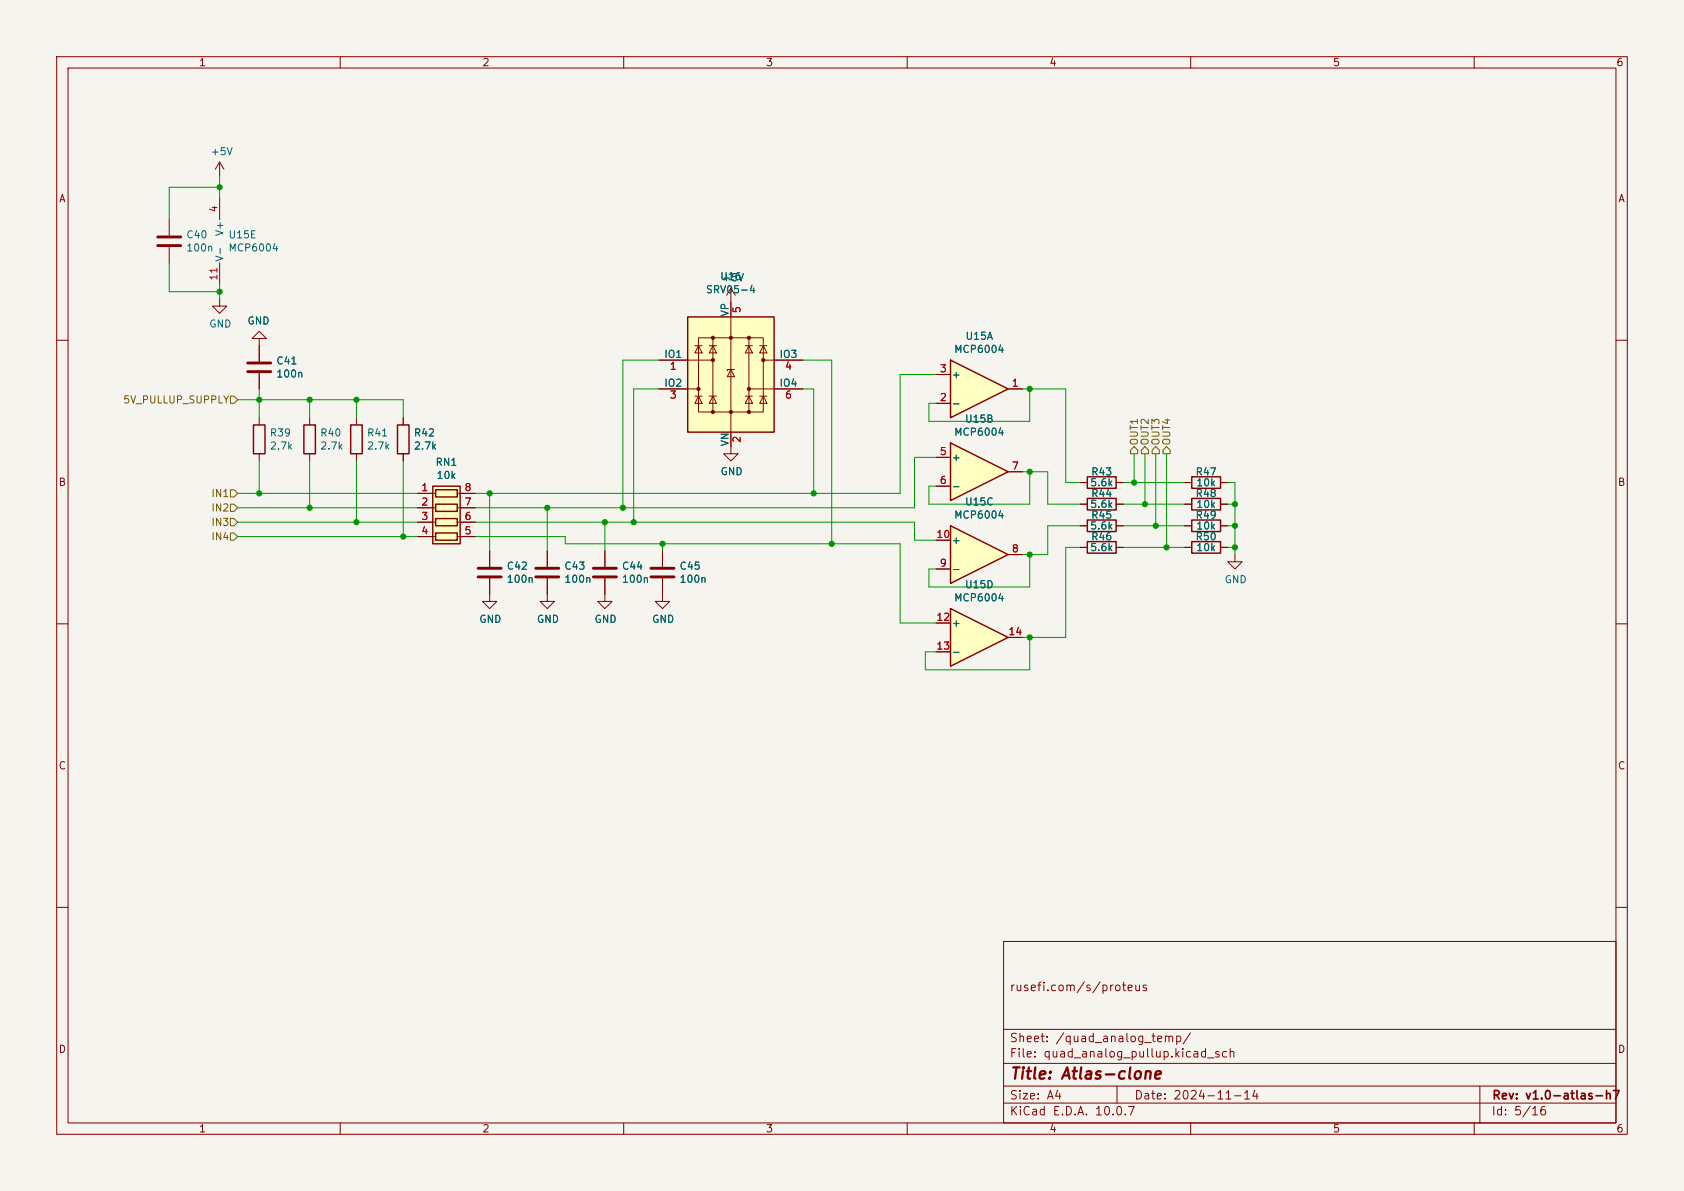
[picture p135: page 5]

7 7
6 6

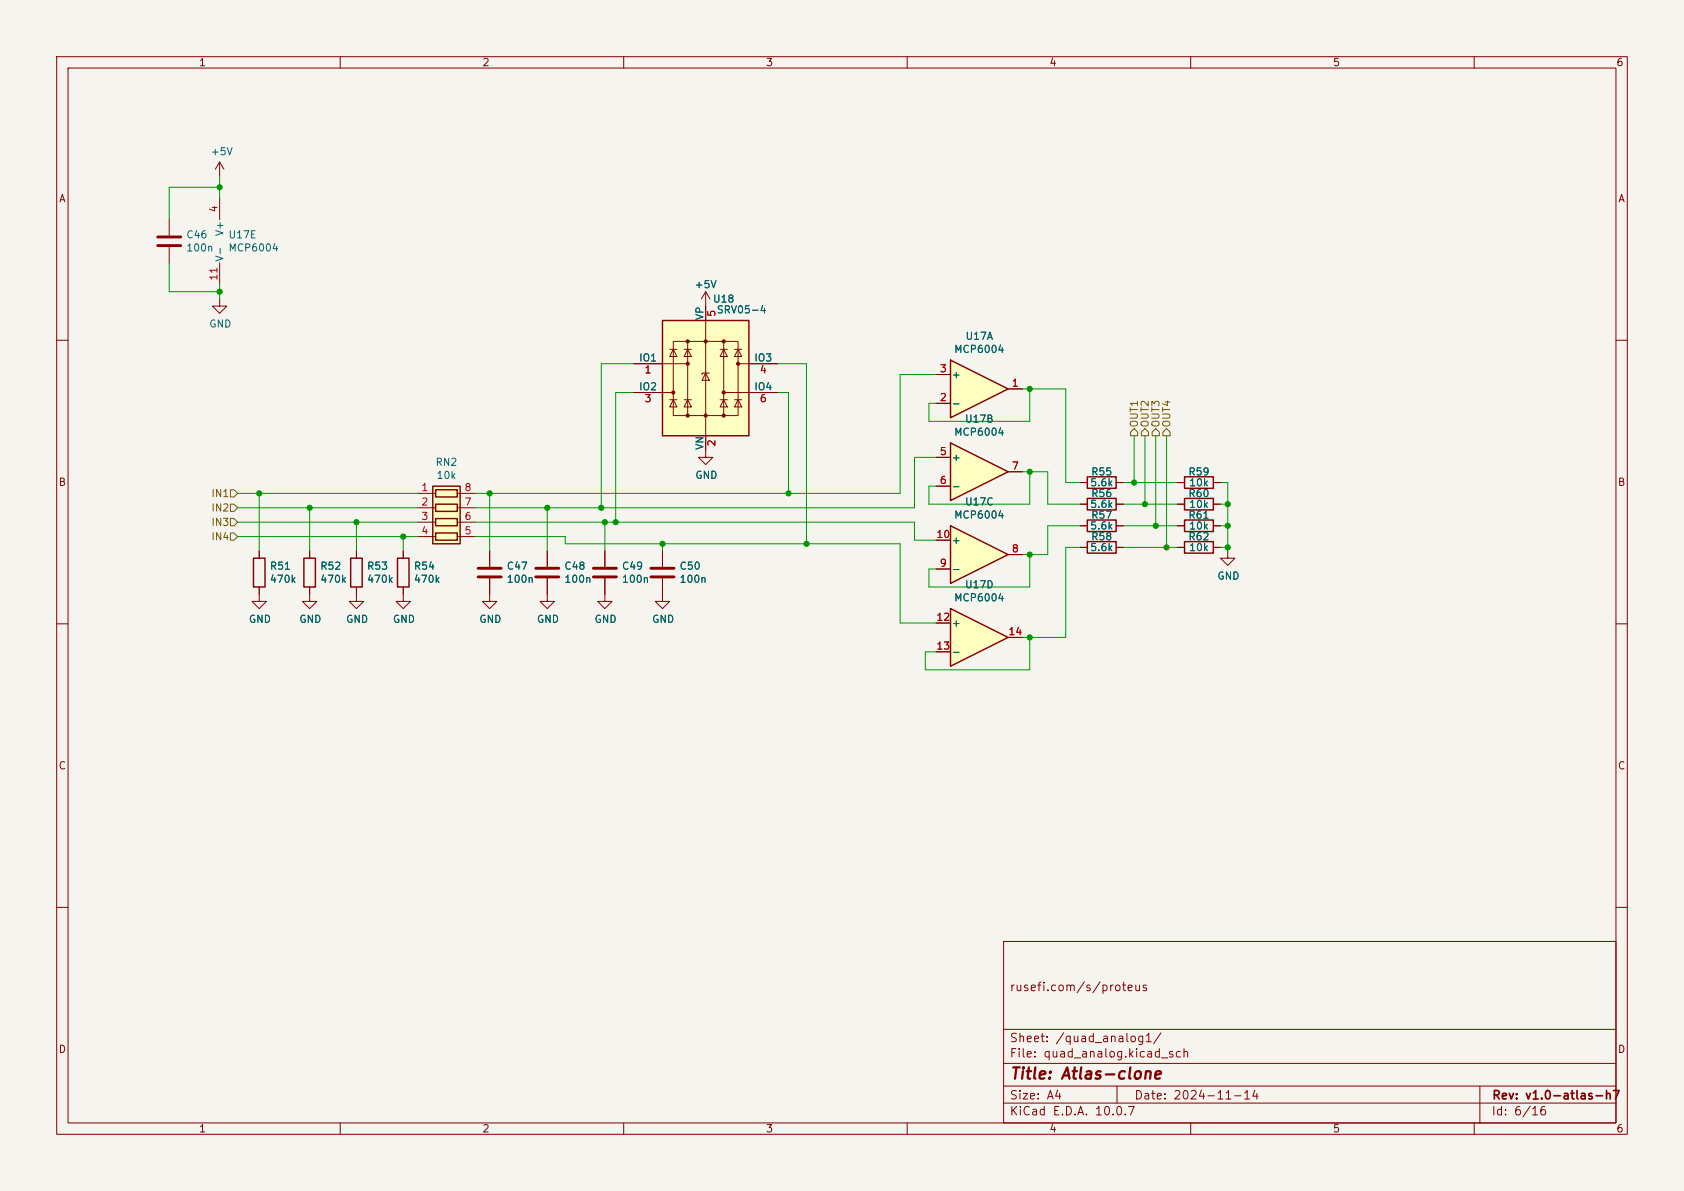
[picture p136: page 6]

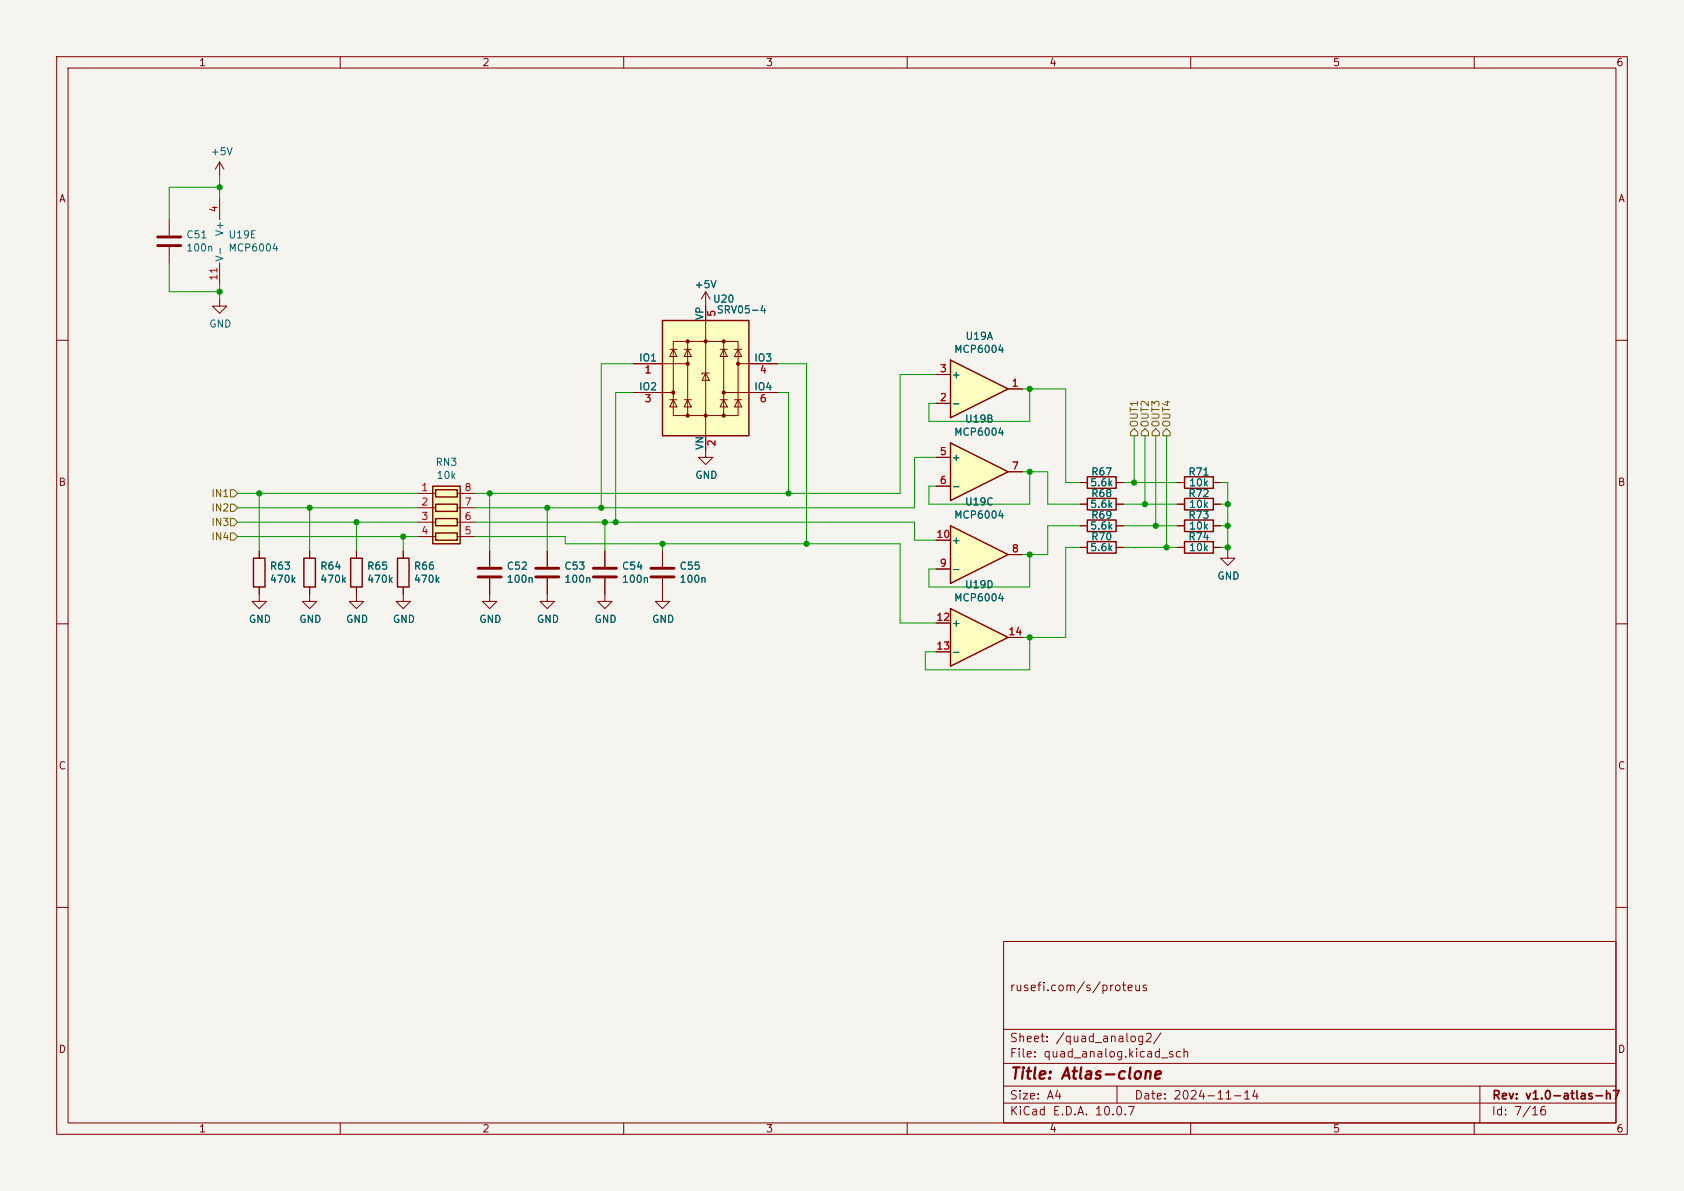
[picture p137: page 7]

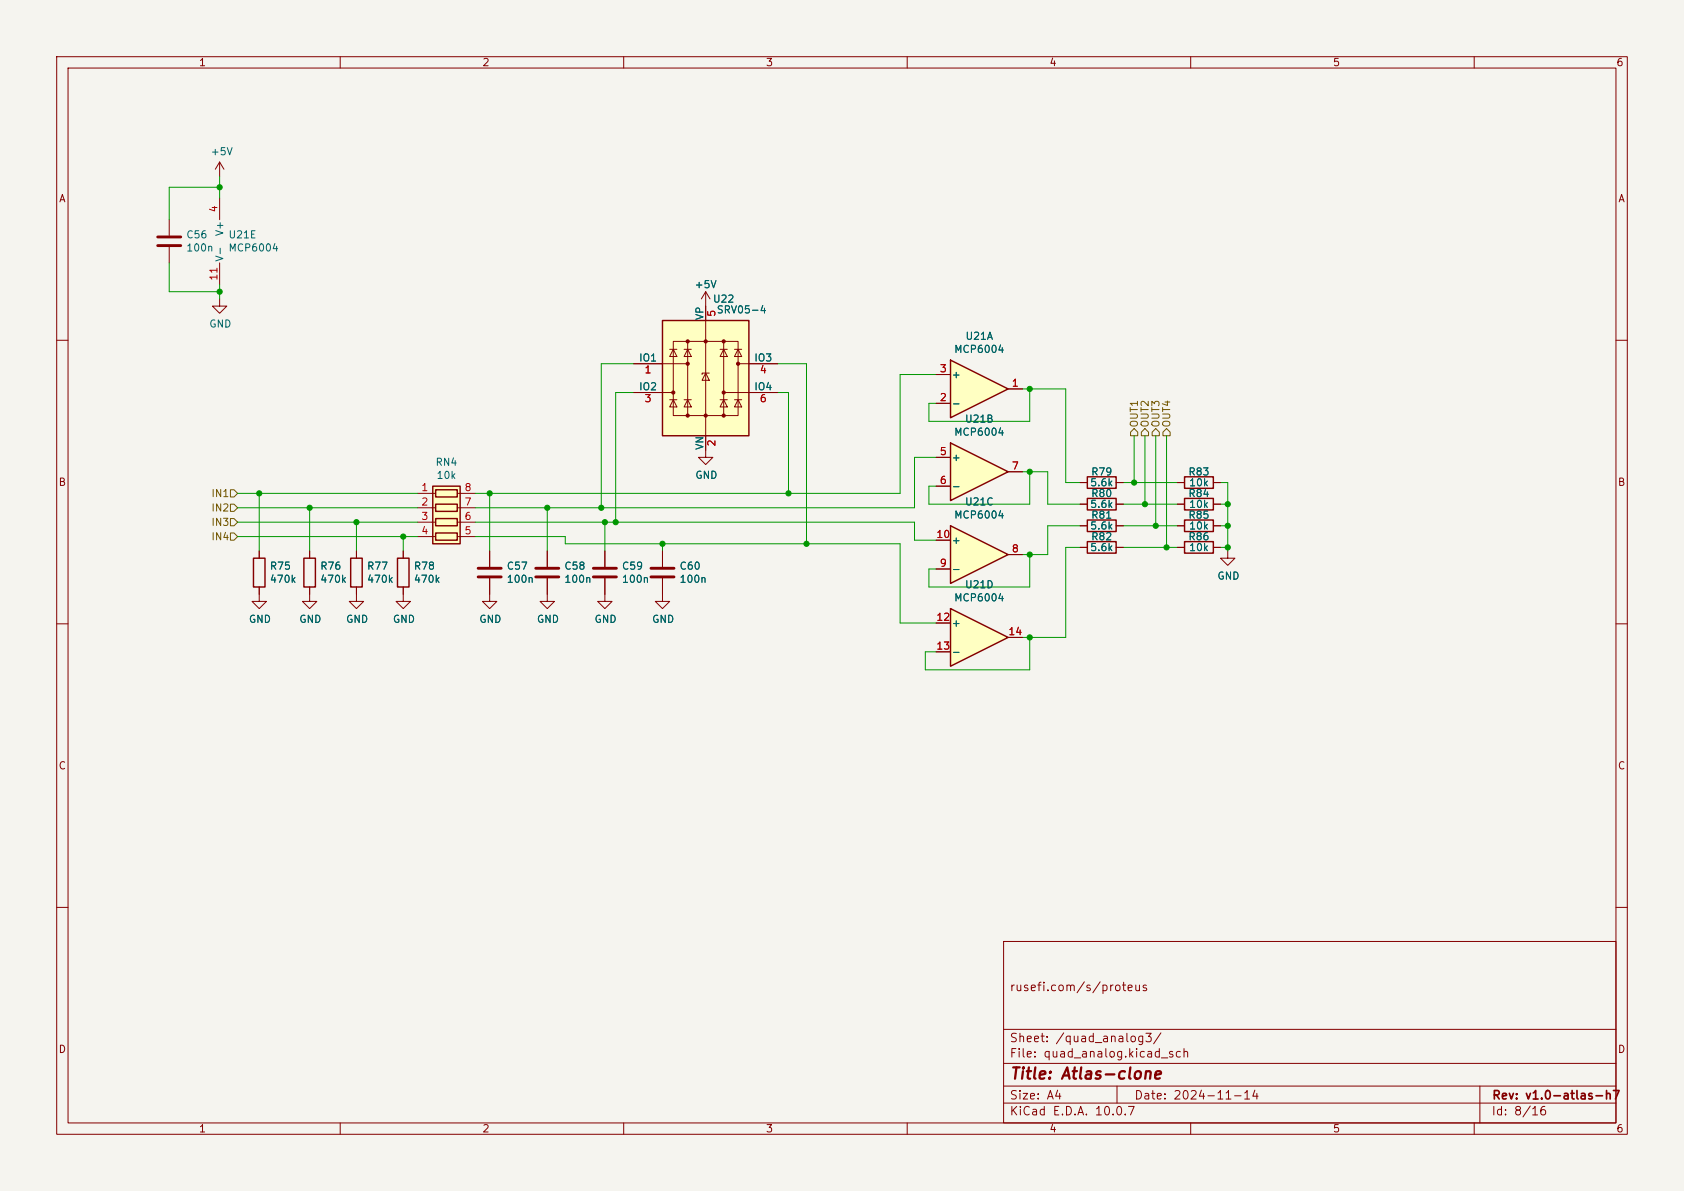
[picture p138: page 8]

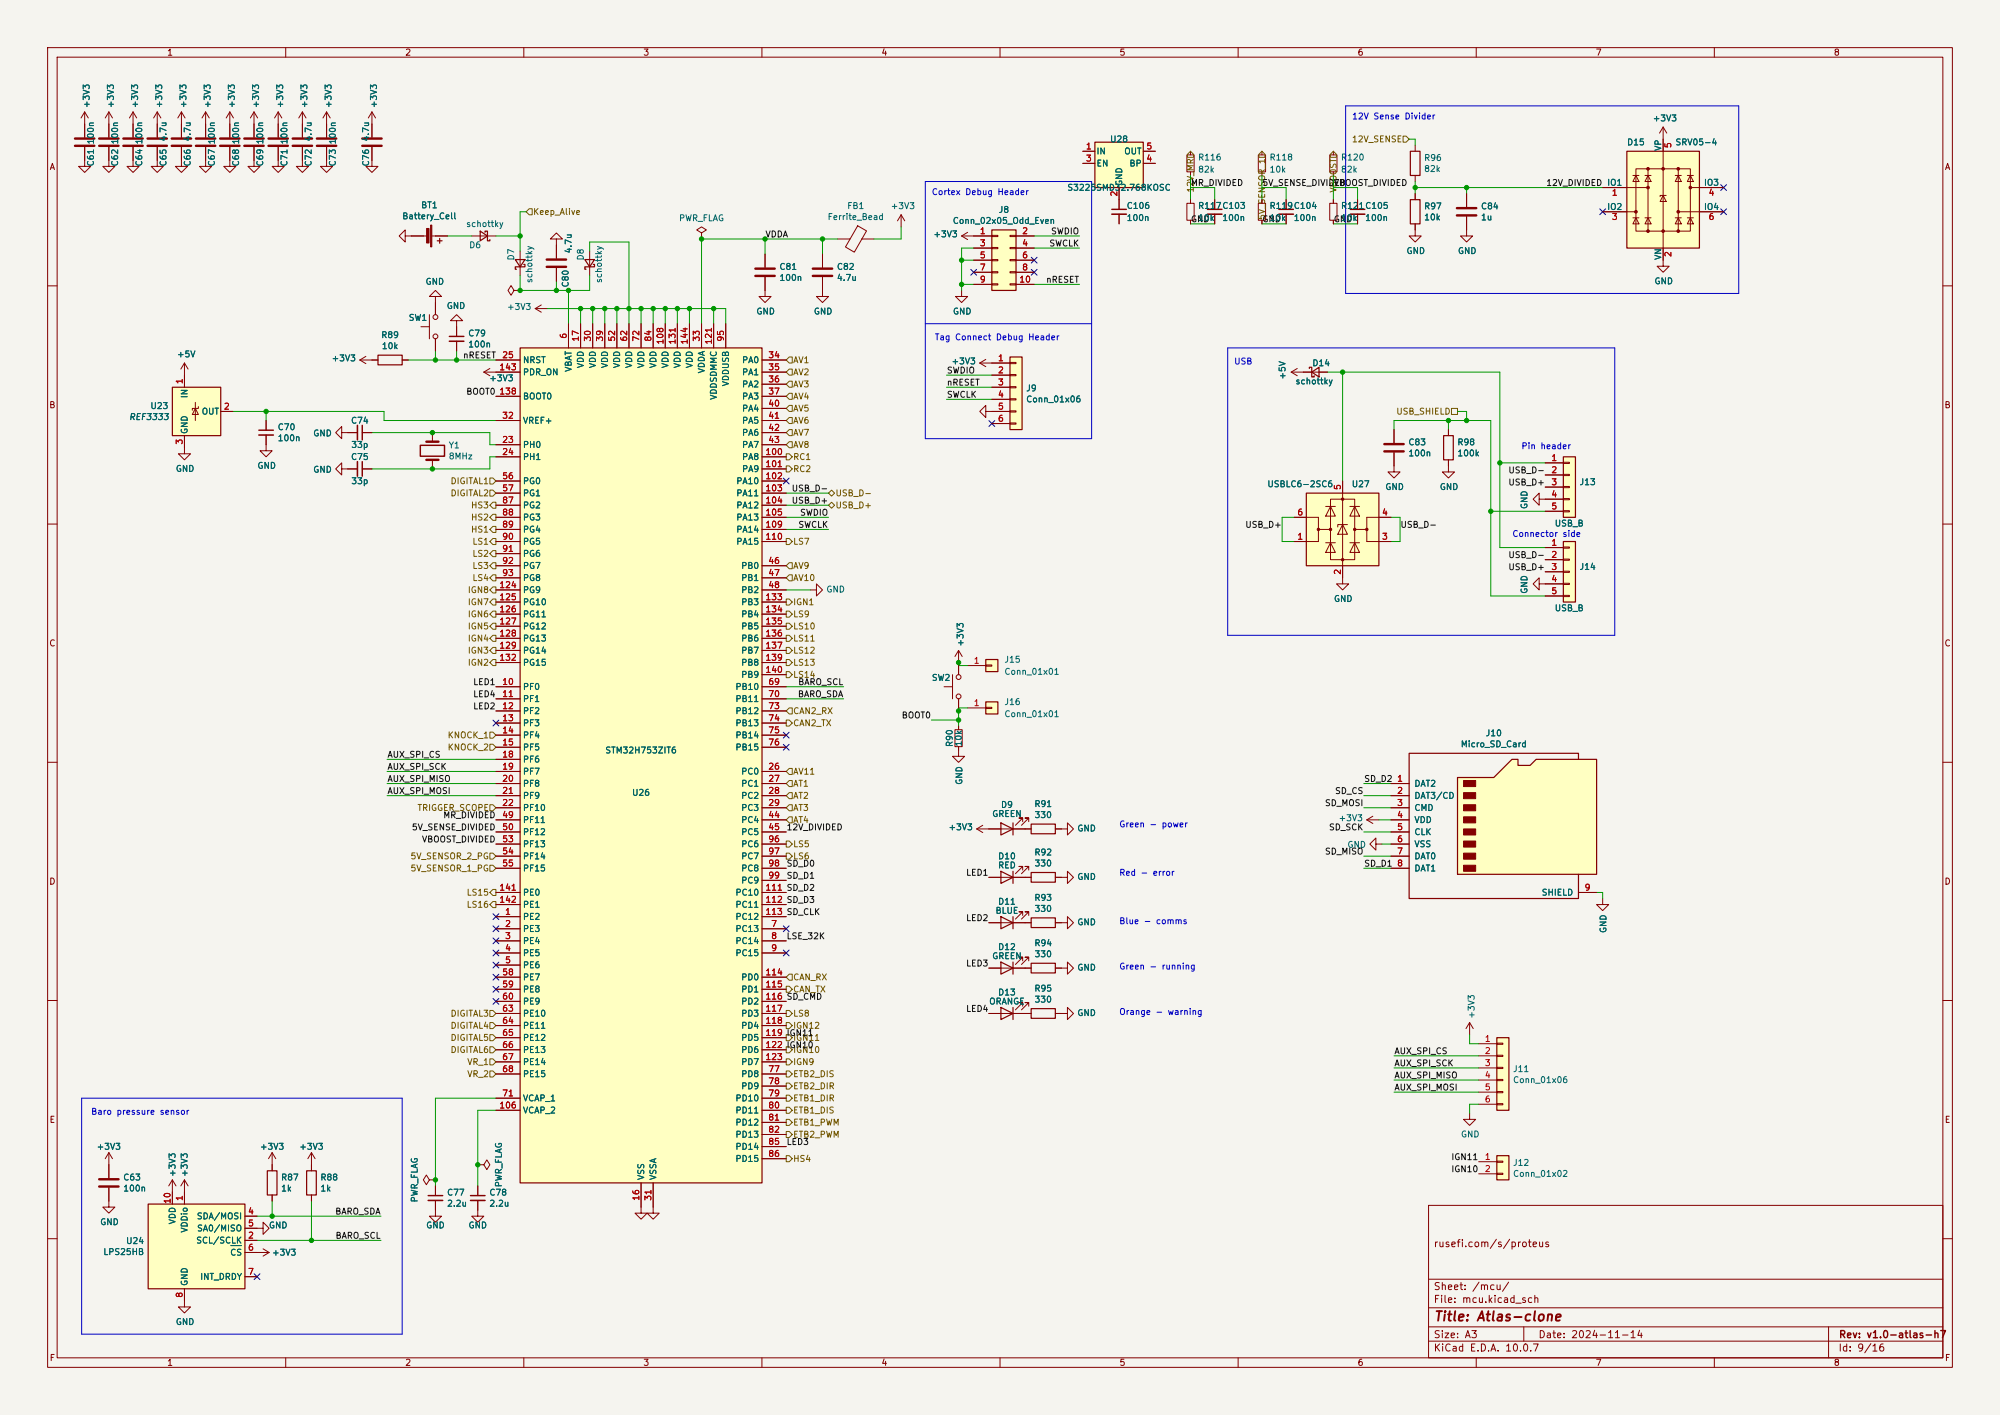
[picture p139: page 9]

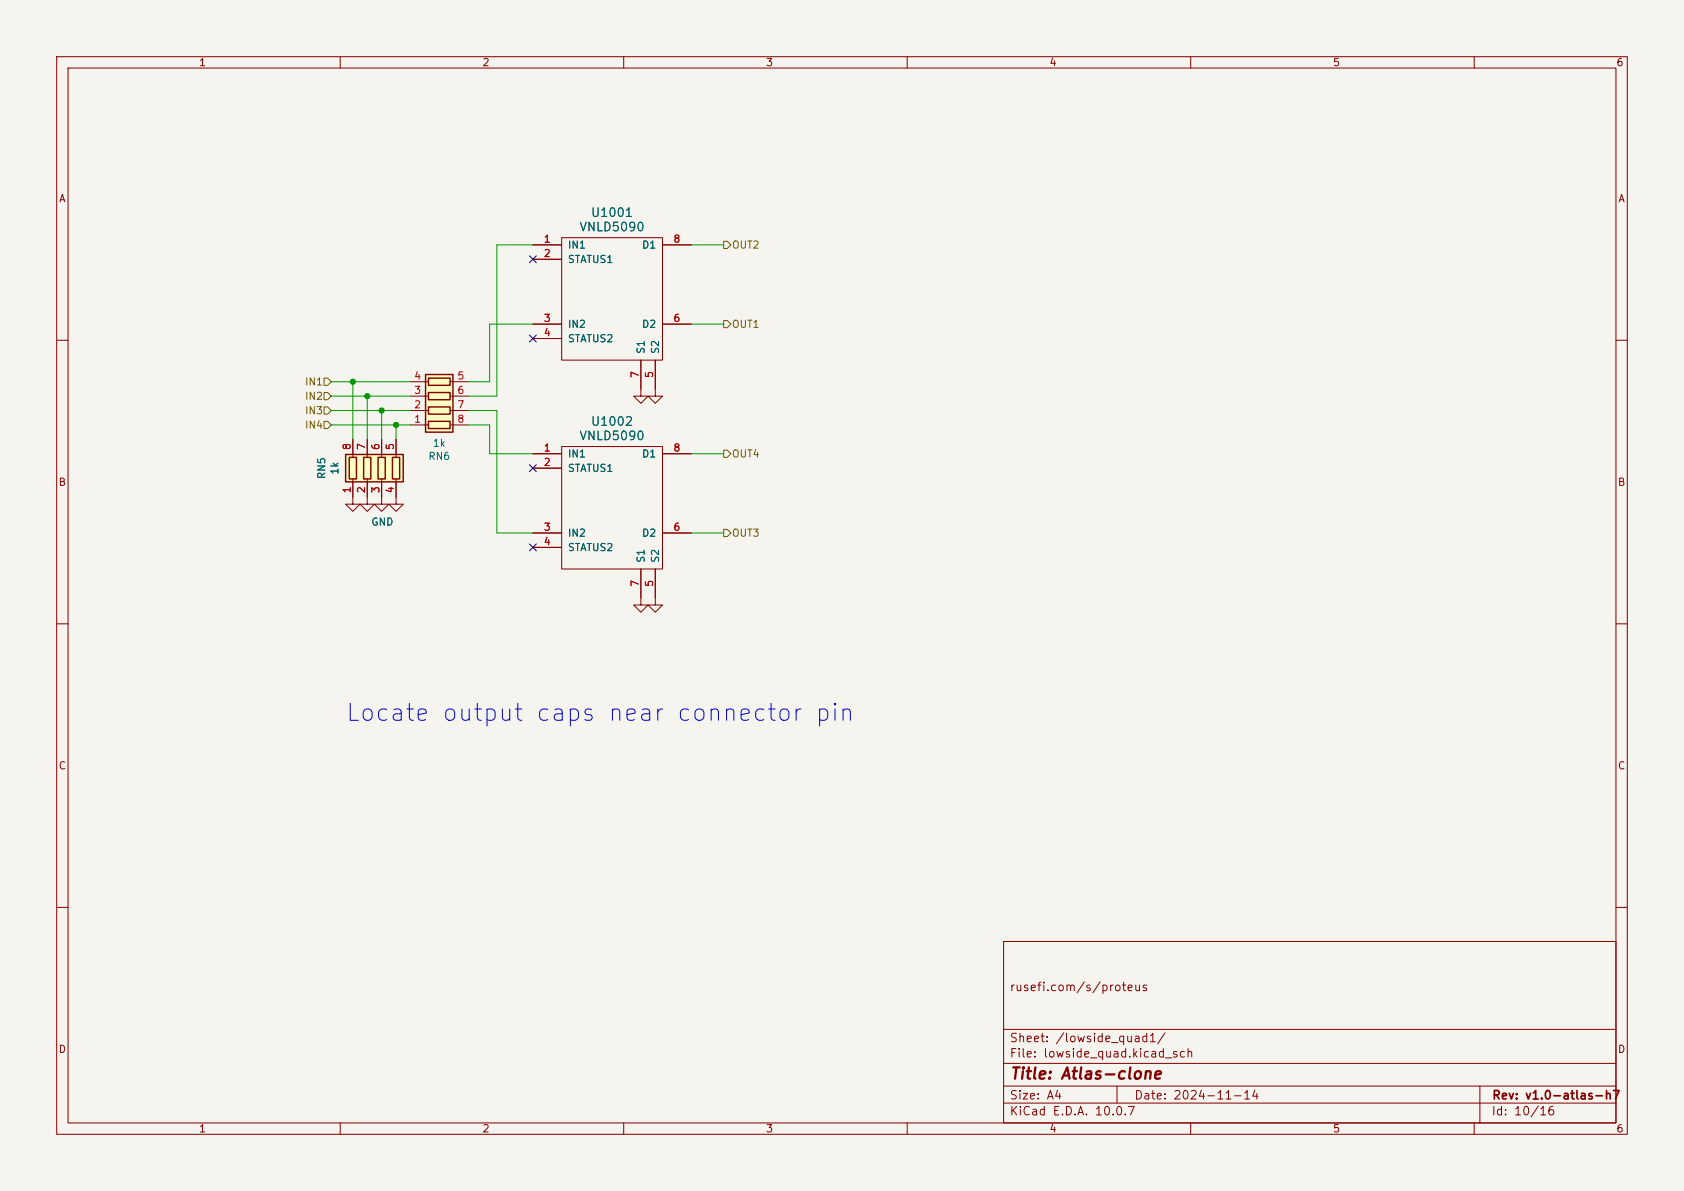
[picture p140: page 10]

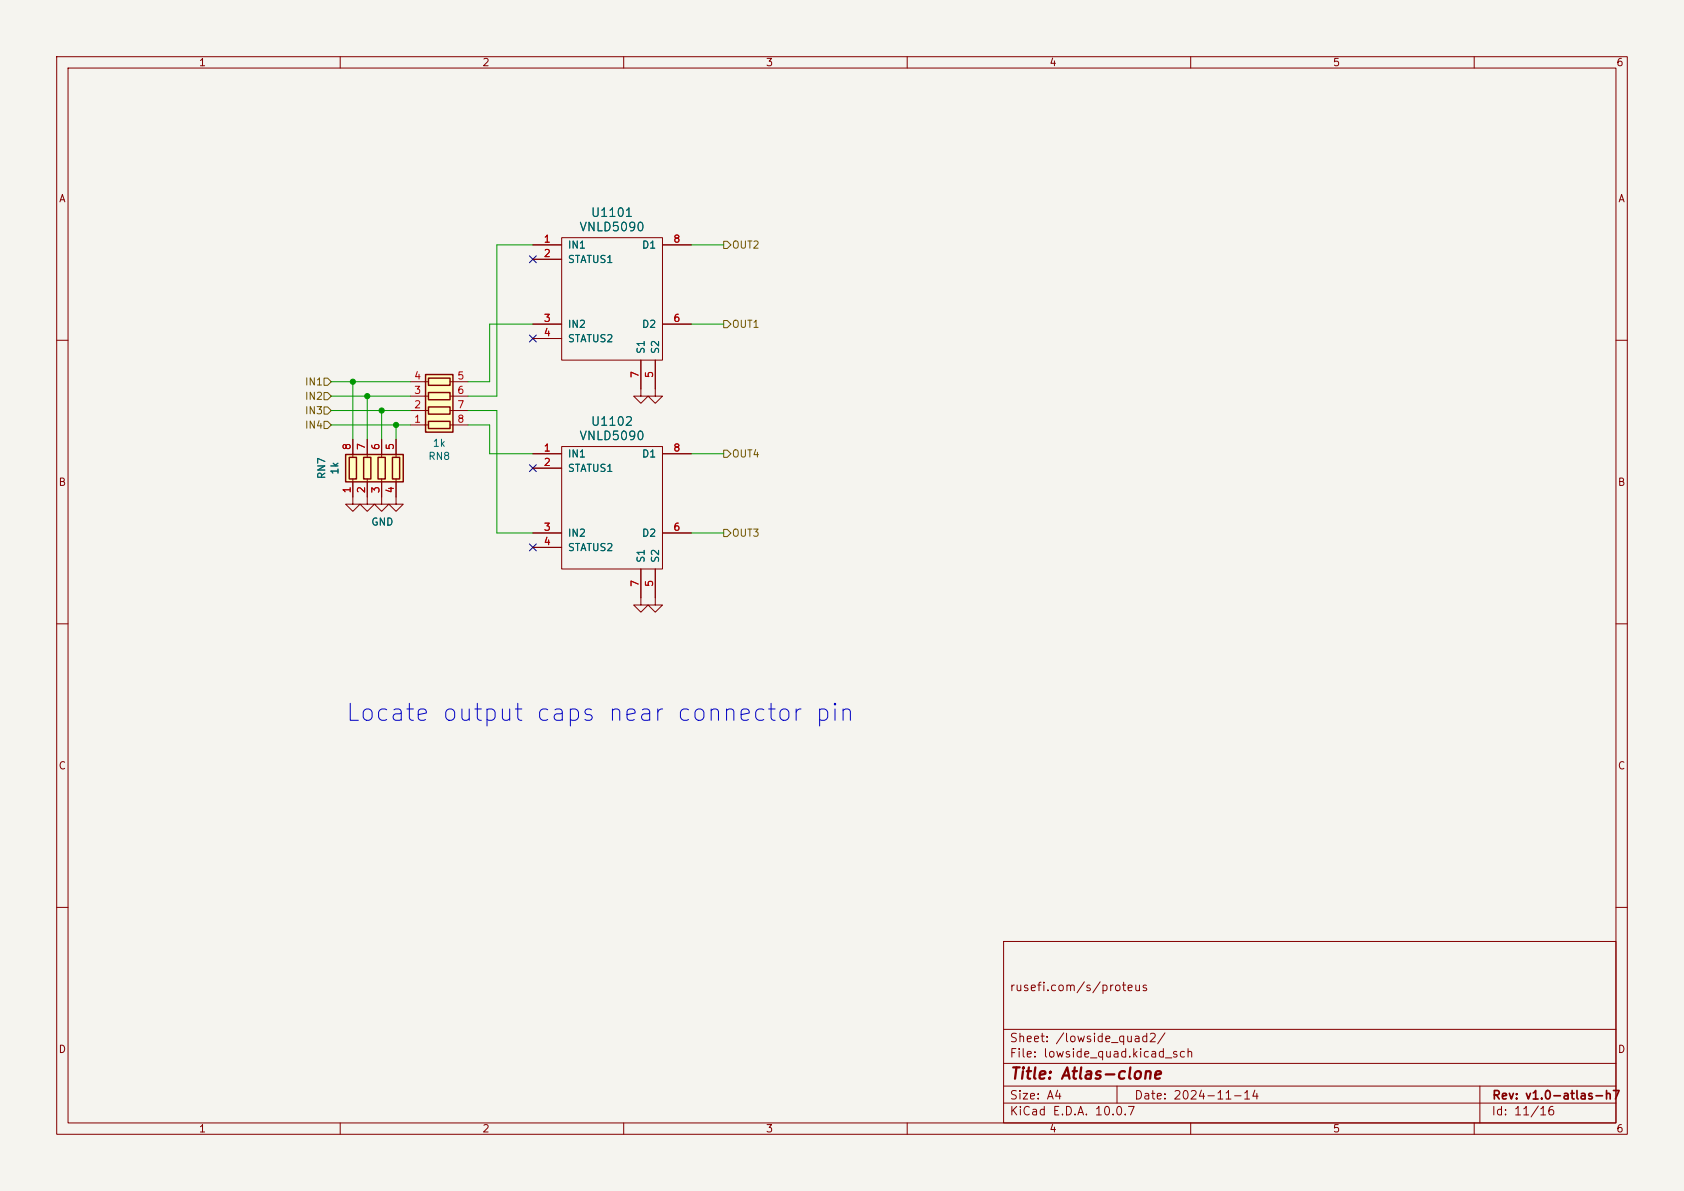
[picture p141: page 11]

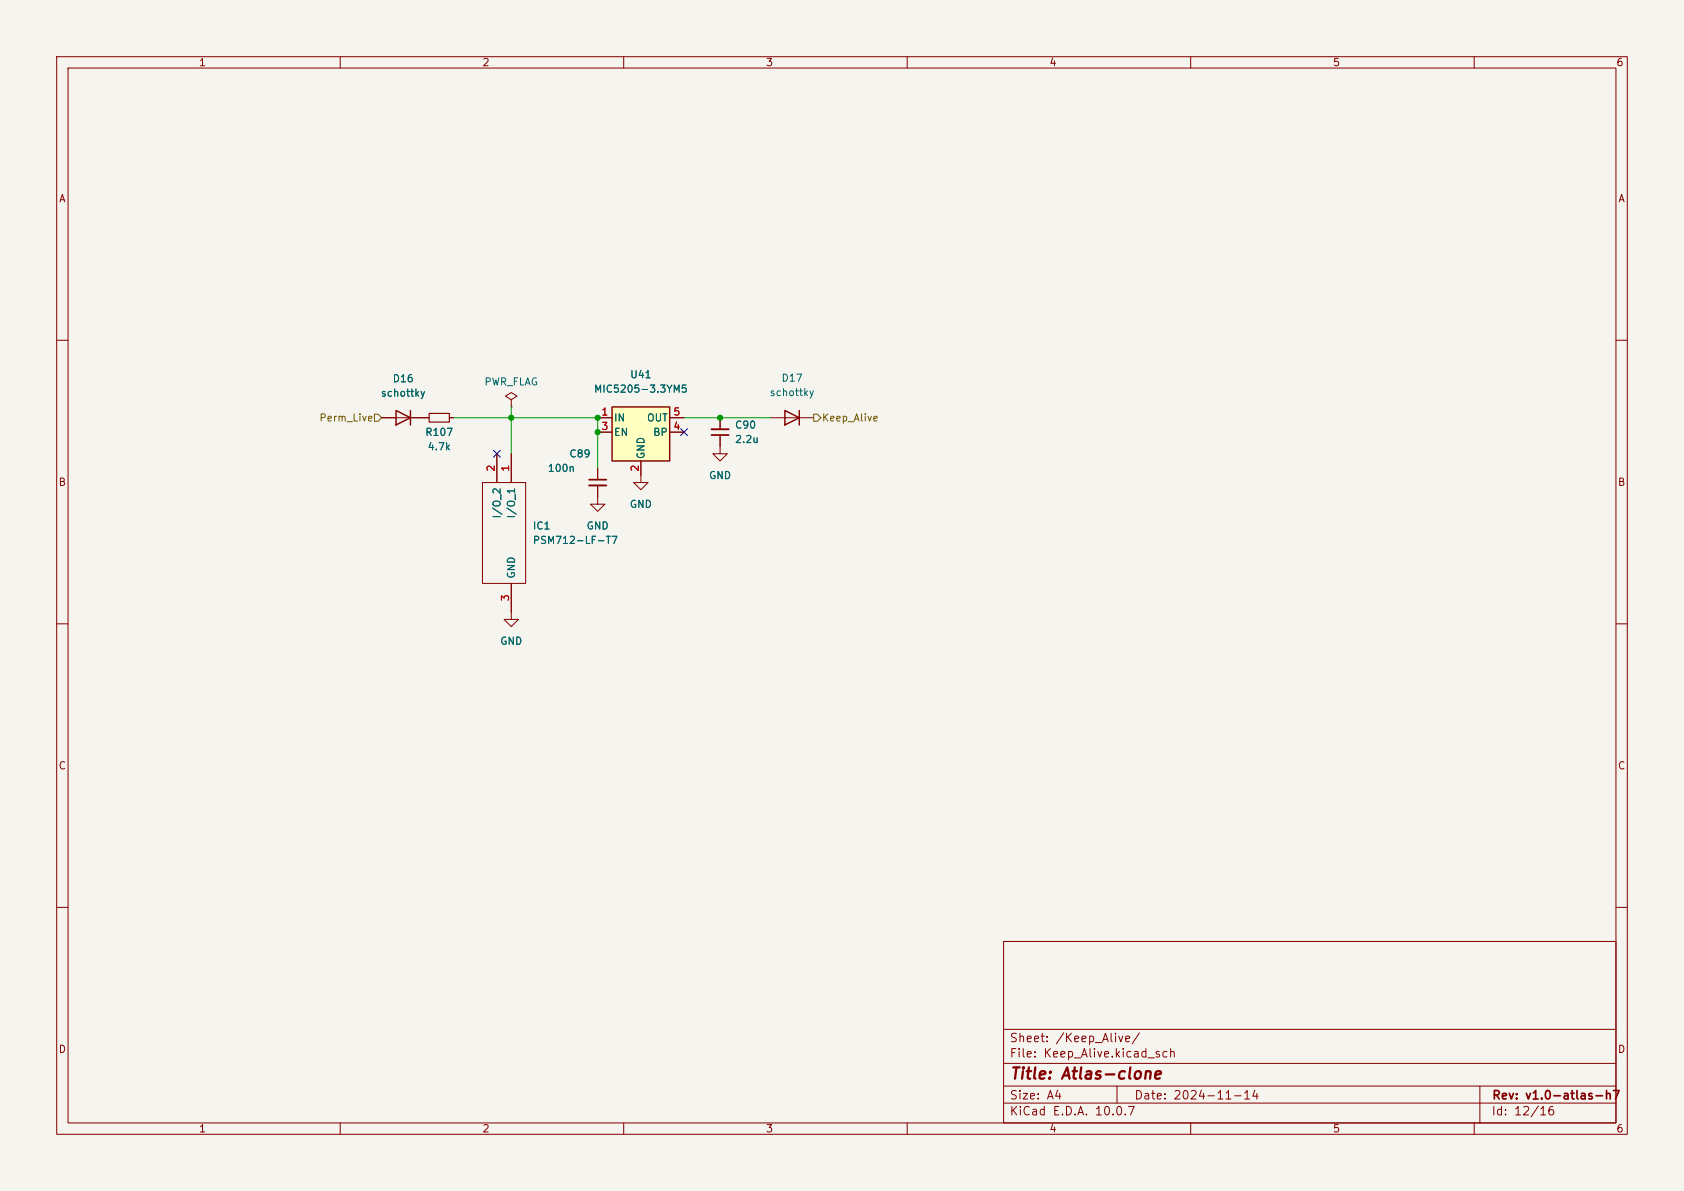
[picture p142: page 12]

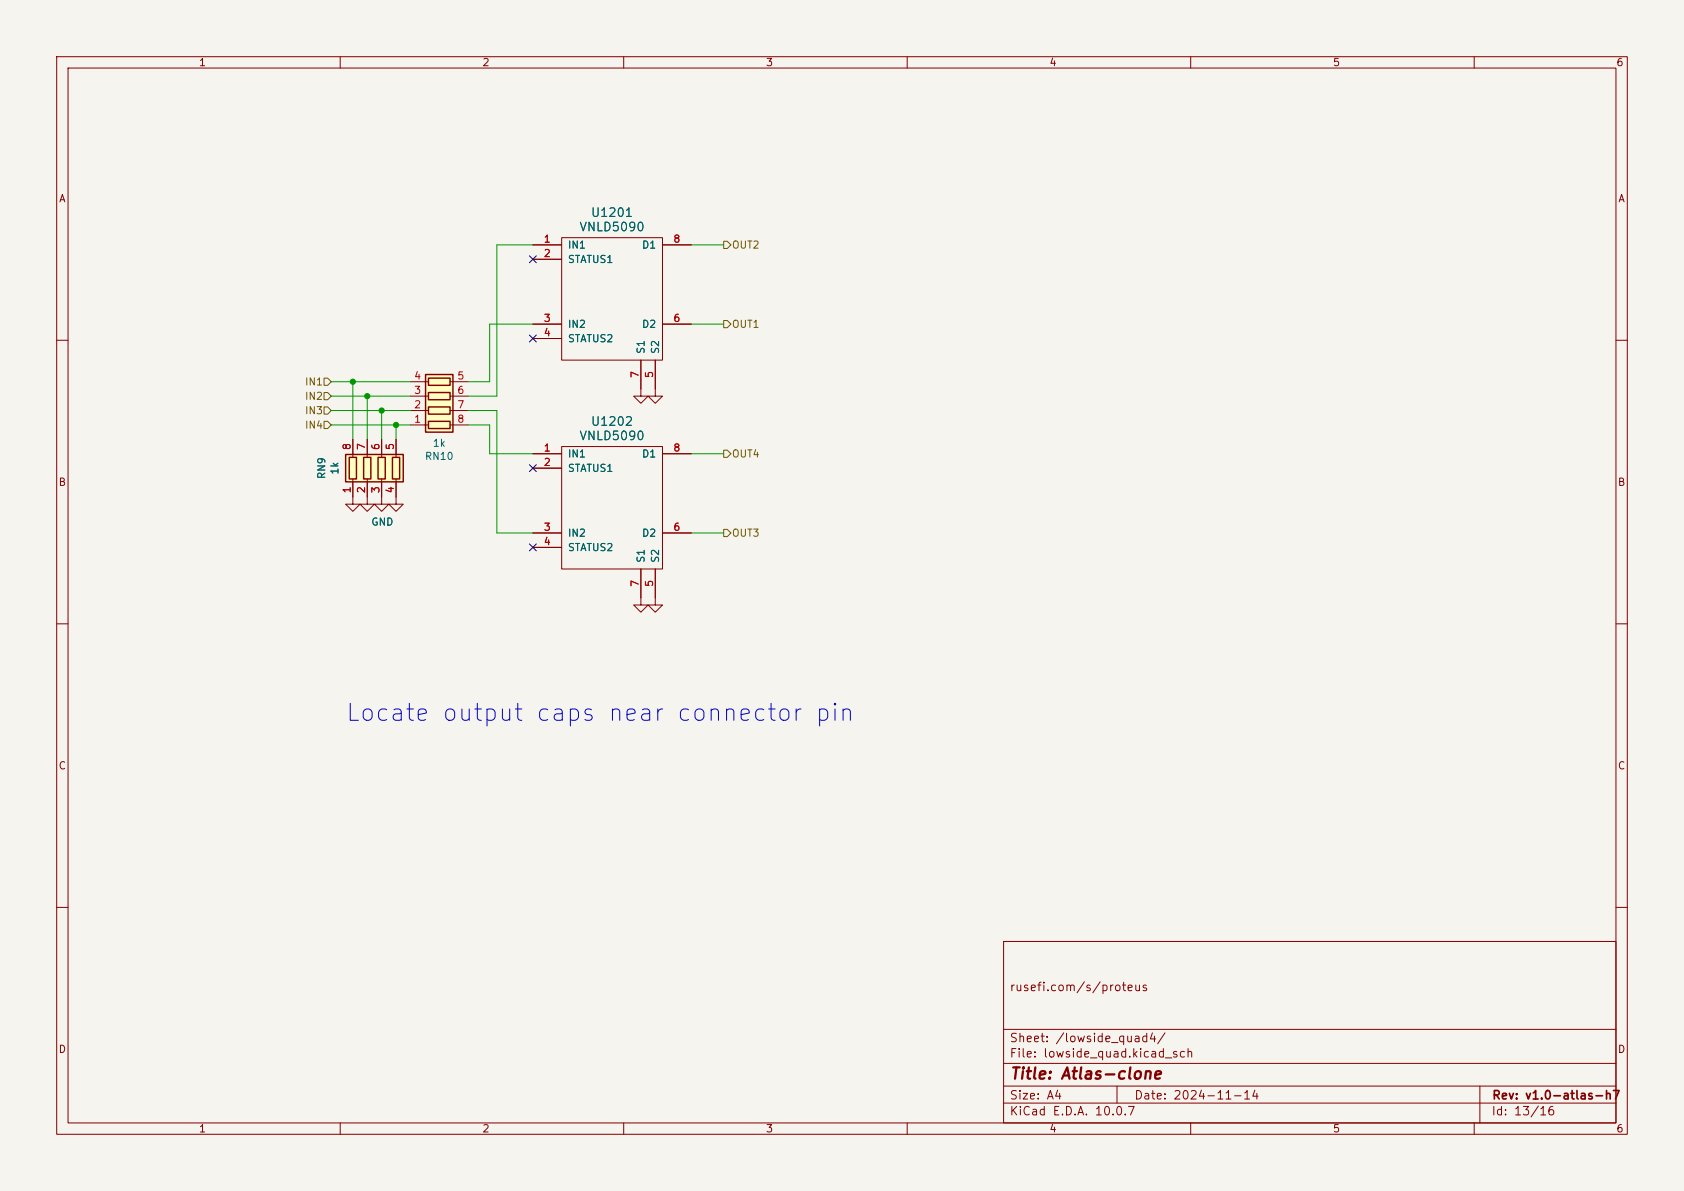
[picture p143: page 13]

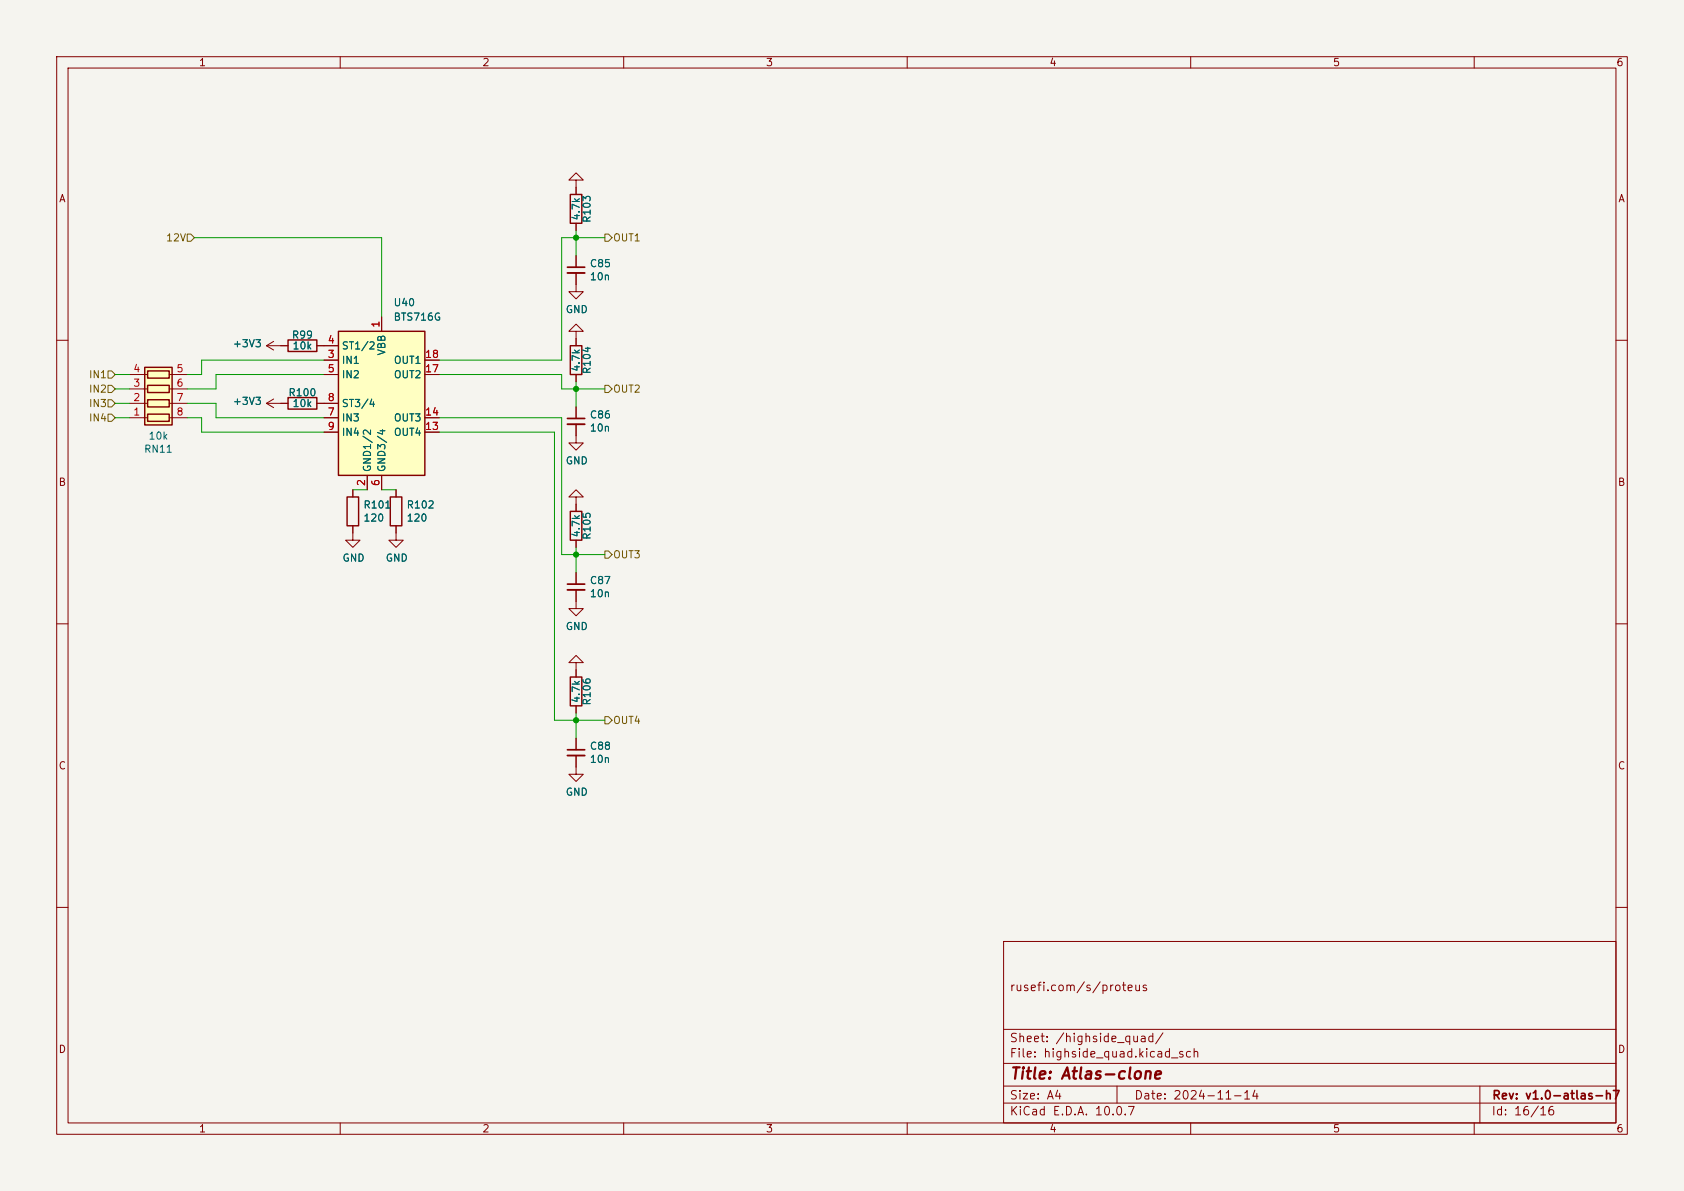
[picture p144: page 14]

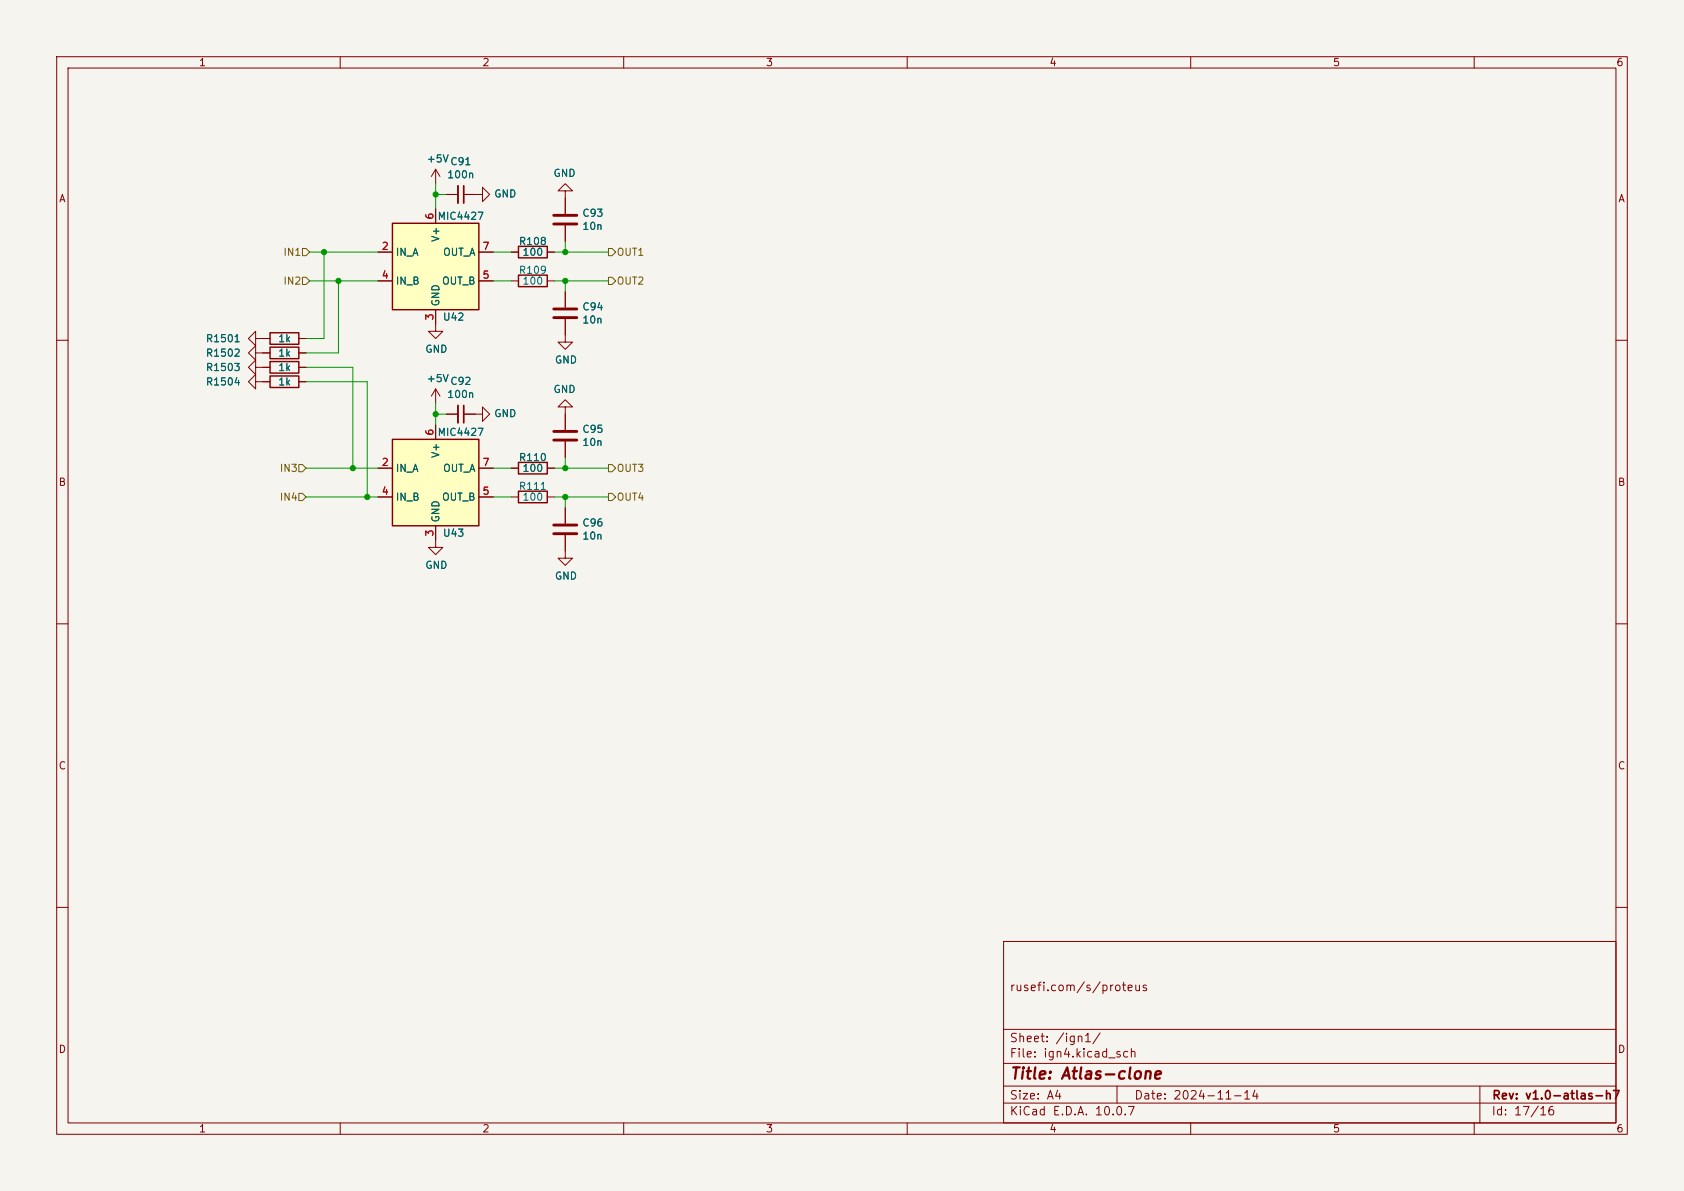
[picture p145: page 15]

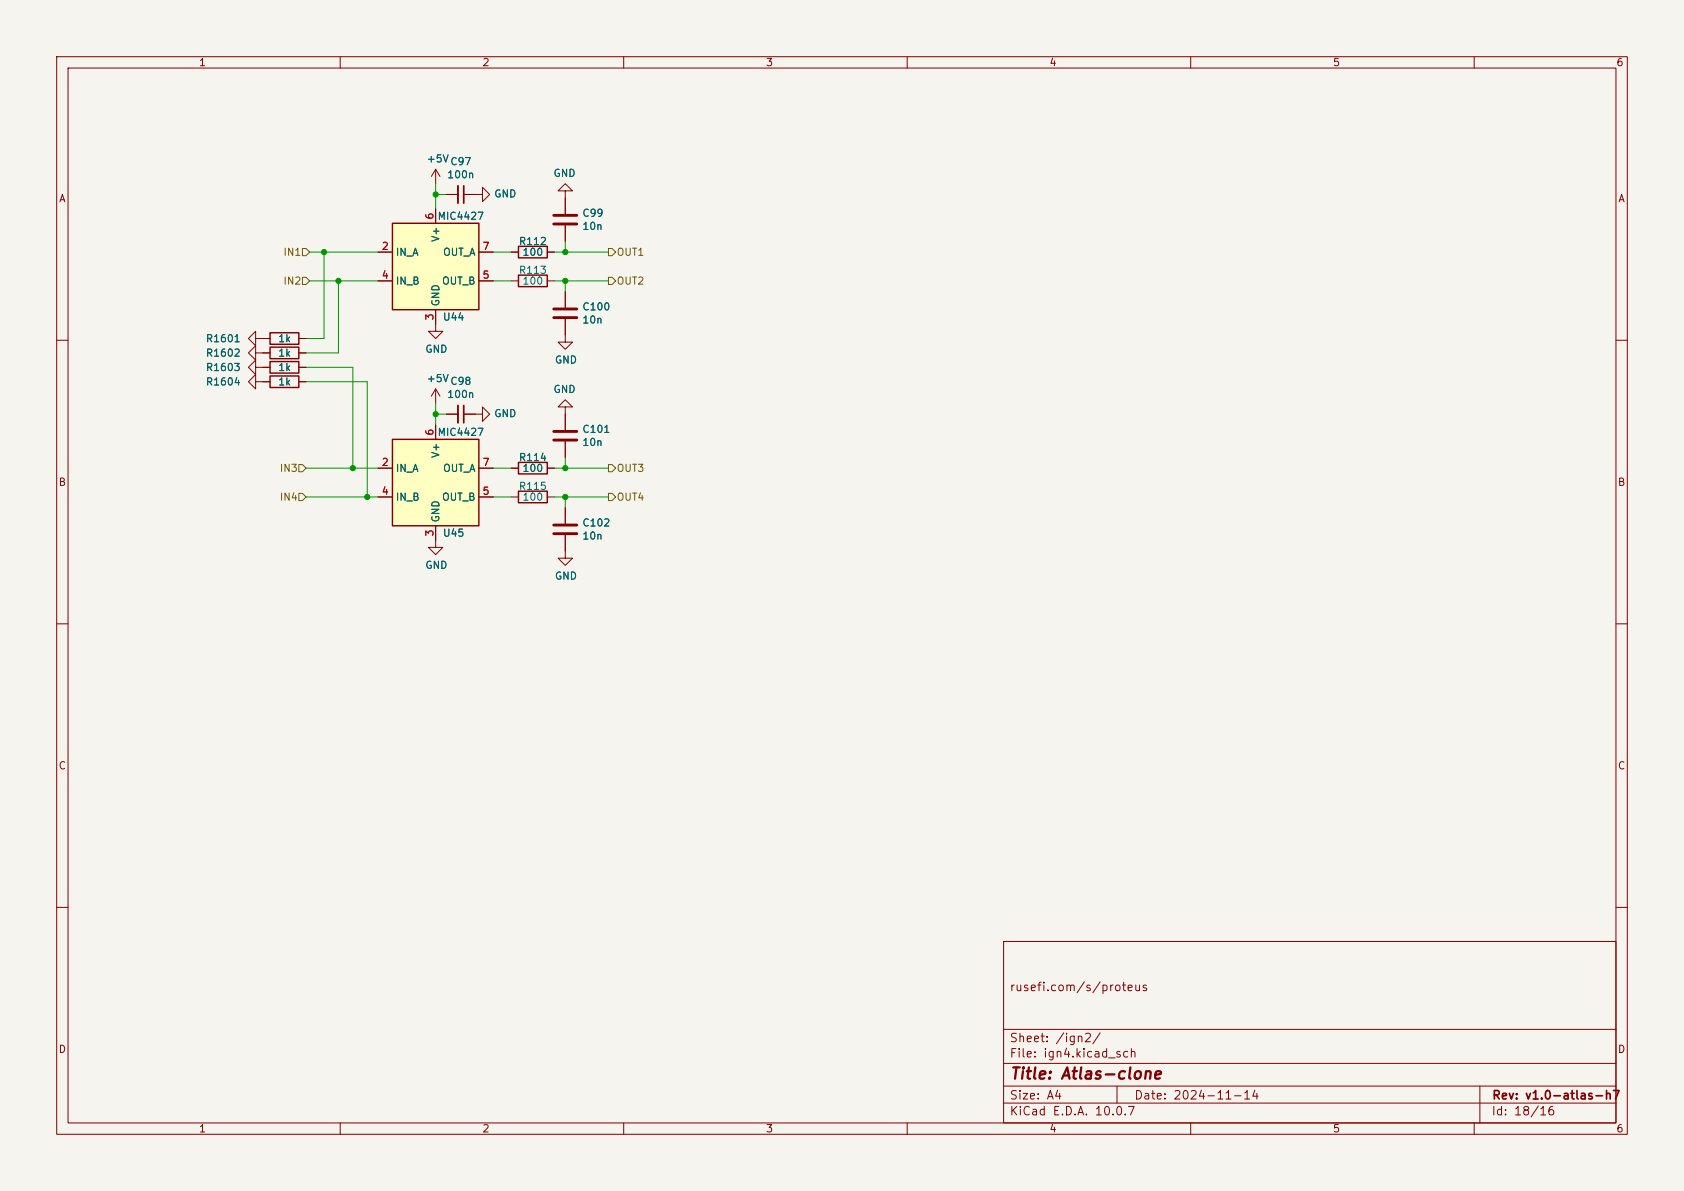
[picture p146: page 16]
