halbritt/fome-mc/reports/toolchain/baseline/universal-112/source/Polygonus-Universal-112/Export/V1.1/Polygonus-Universal-Base.pdf

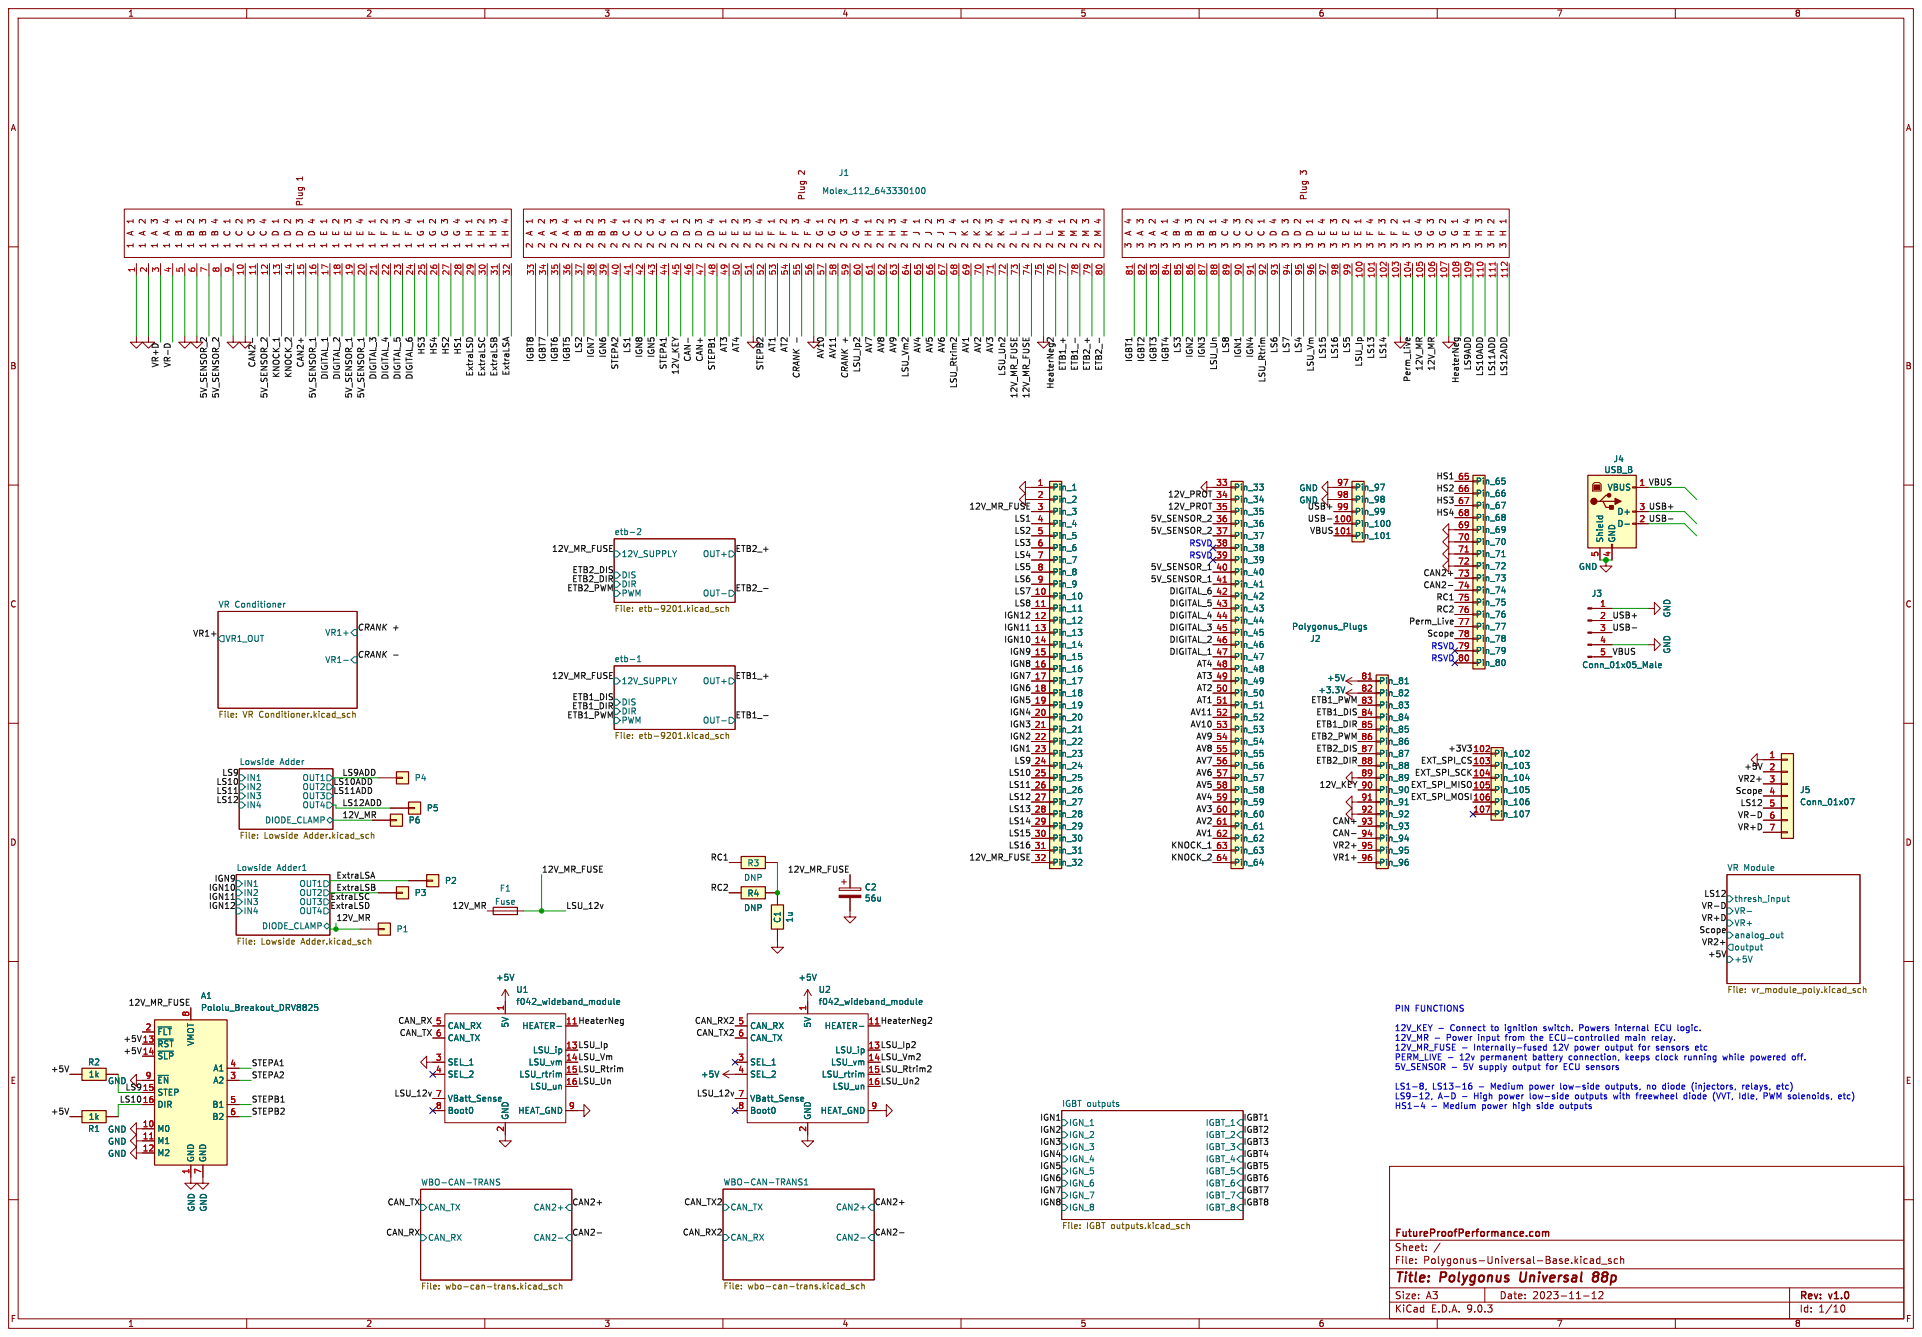
[picture p147: page 1]

Lowside Adder1 File: Lowside Adder.kicad_sch VR1+ VR1- VR1_OUT VR Conditioner File: VR Conditioner.kicad_sch

IGBT outputs File: IGBT outputs.kicad_sch OUT1 OUT2

Id: 1/10 Title: Polygonus Universal 88p

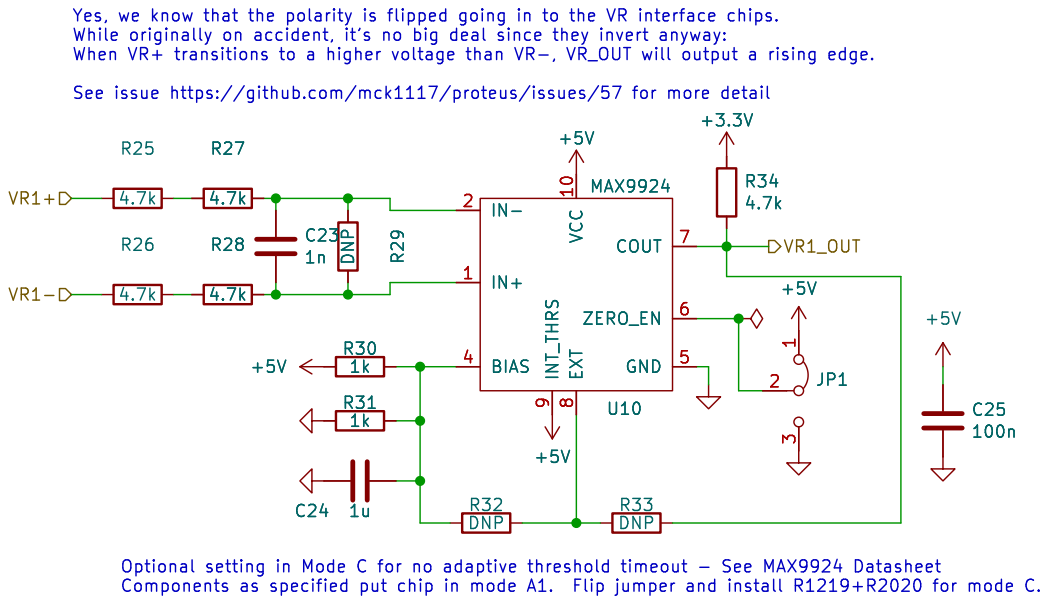
[picture p148: page 2]

Id: 4/10 Title: Polygonus Universal 88p

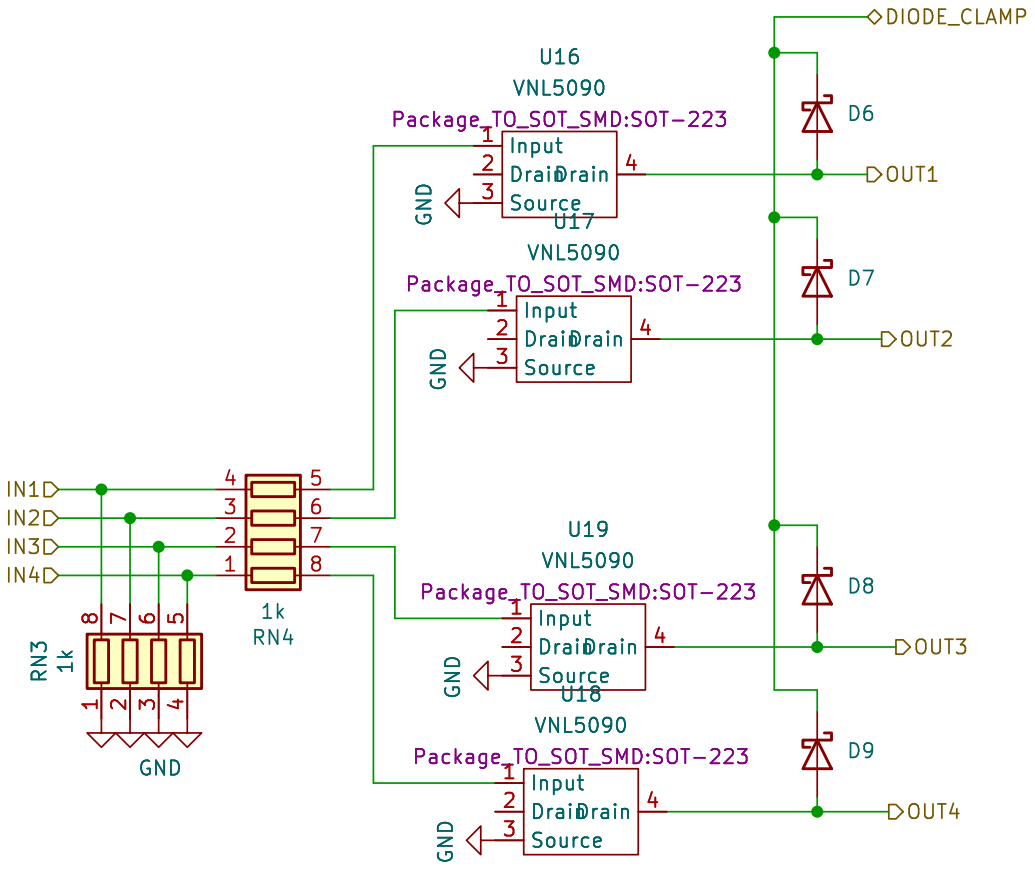
[picture p149: page 3]

Id: 8/10 Title: Polygonus Universal 88p

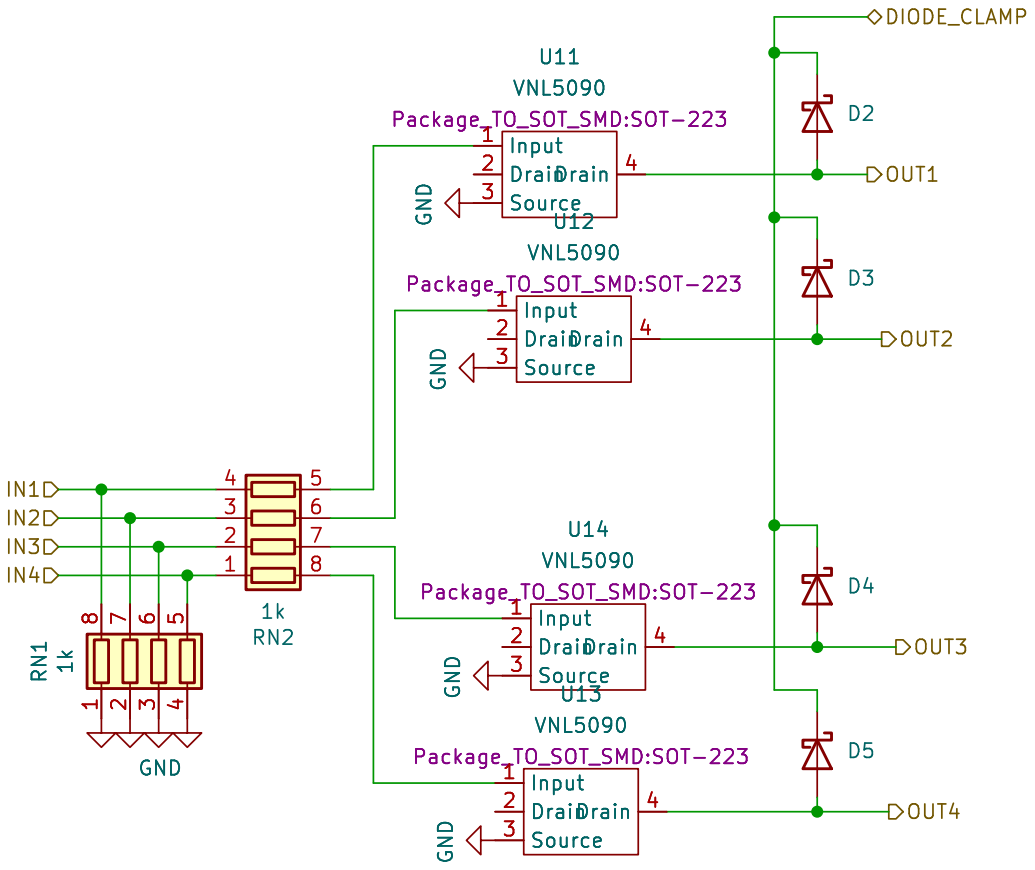
[picture p150: page 4]

Id: 6/10 Title: Polygonus Universal 88p

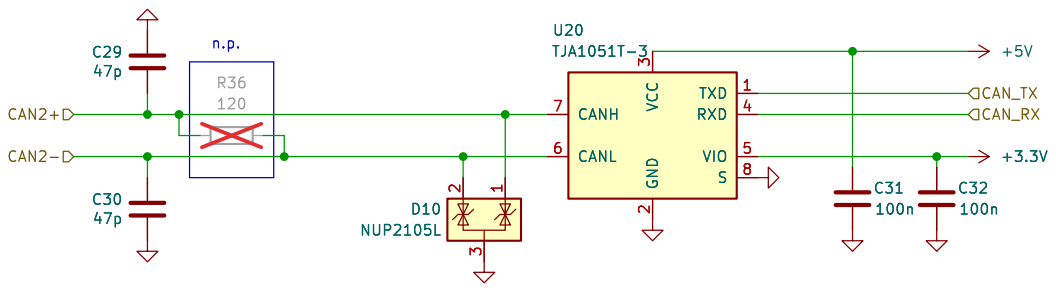
[picture p151: page 5]

File: wbo-can-trans.kicad_sch Sheet: /WBO-CAN-TRANS/ FutureProofPerformance.com

Id: 9/10 Title: Polygonus Universal 88p

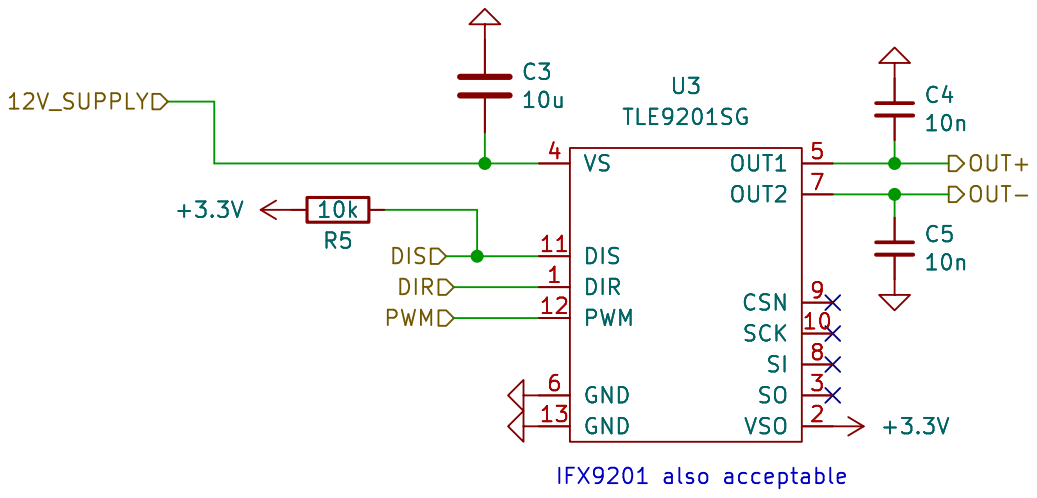
[picture p152: page 6]

File: etb-9201.kicad_sch Sheet: /etb-2/ FutureProofPerformance.com

Id: 2/10 Title: Polygonus Universal 88p

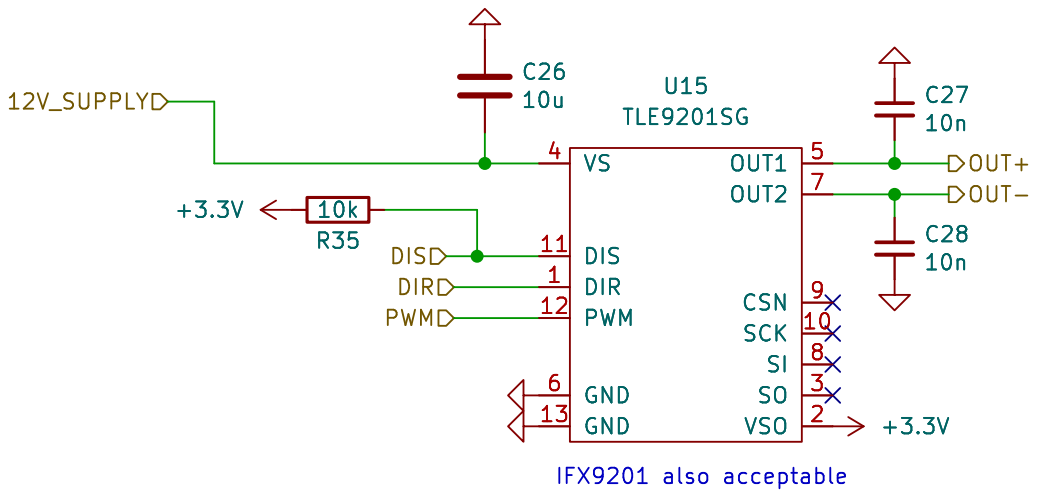
[picture p153: page 7]

File: etb-9201.kicad_sch Sheet: /etb-1/ FutureProofPerformance.com

Id: 7/10 Title: Polygonus Universal 88p

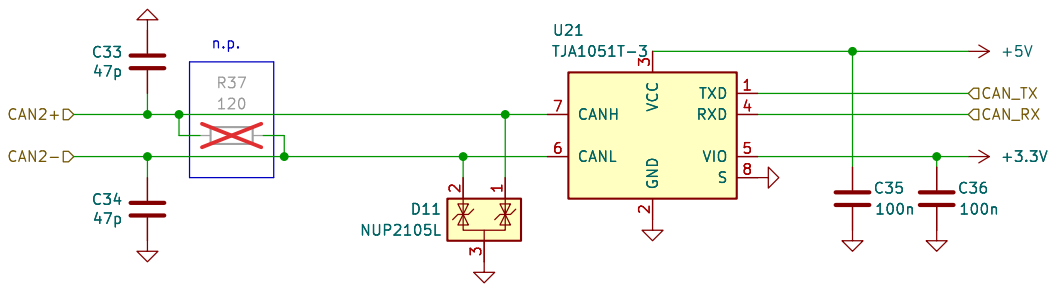
[picture p154: page 8]

File: wbo-can-trans.kicad_sch Sheet: /WBO-CAN-TRANS1/ FutureProofPerformance.com

Id: 10/10 Title: Polygonus Universal 88p

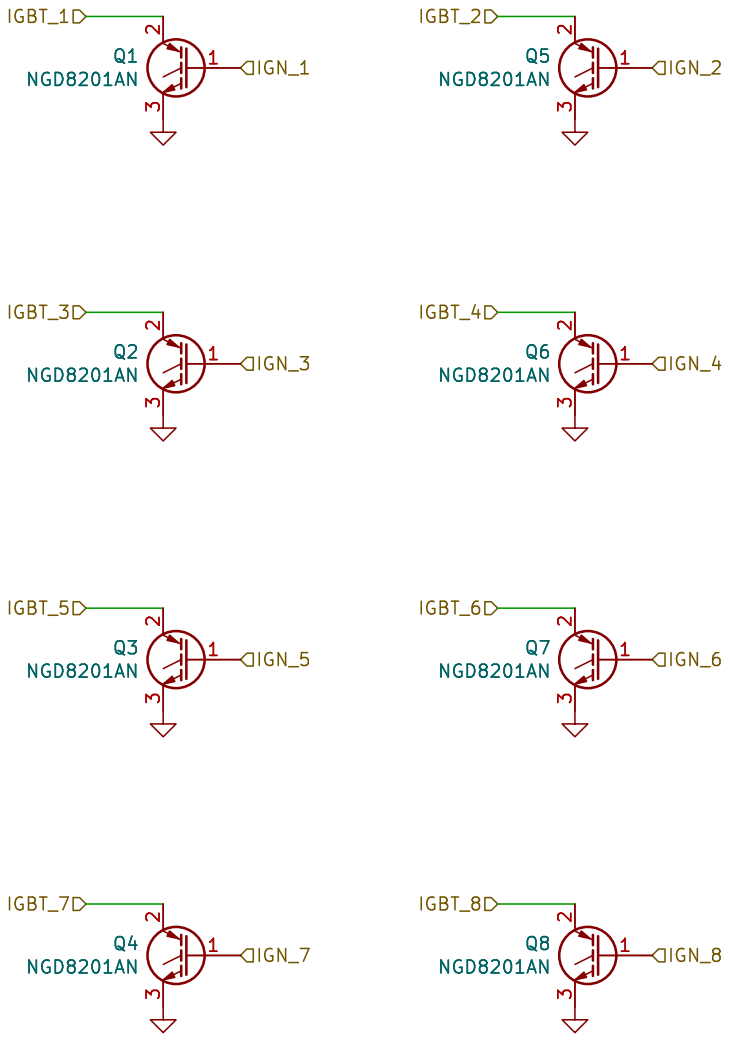
[picture p155: page 9]

Id: 5/10 Title: Polygonus Universal 88p

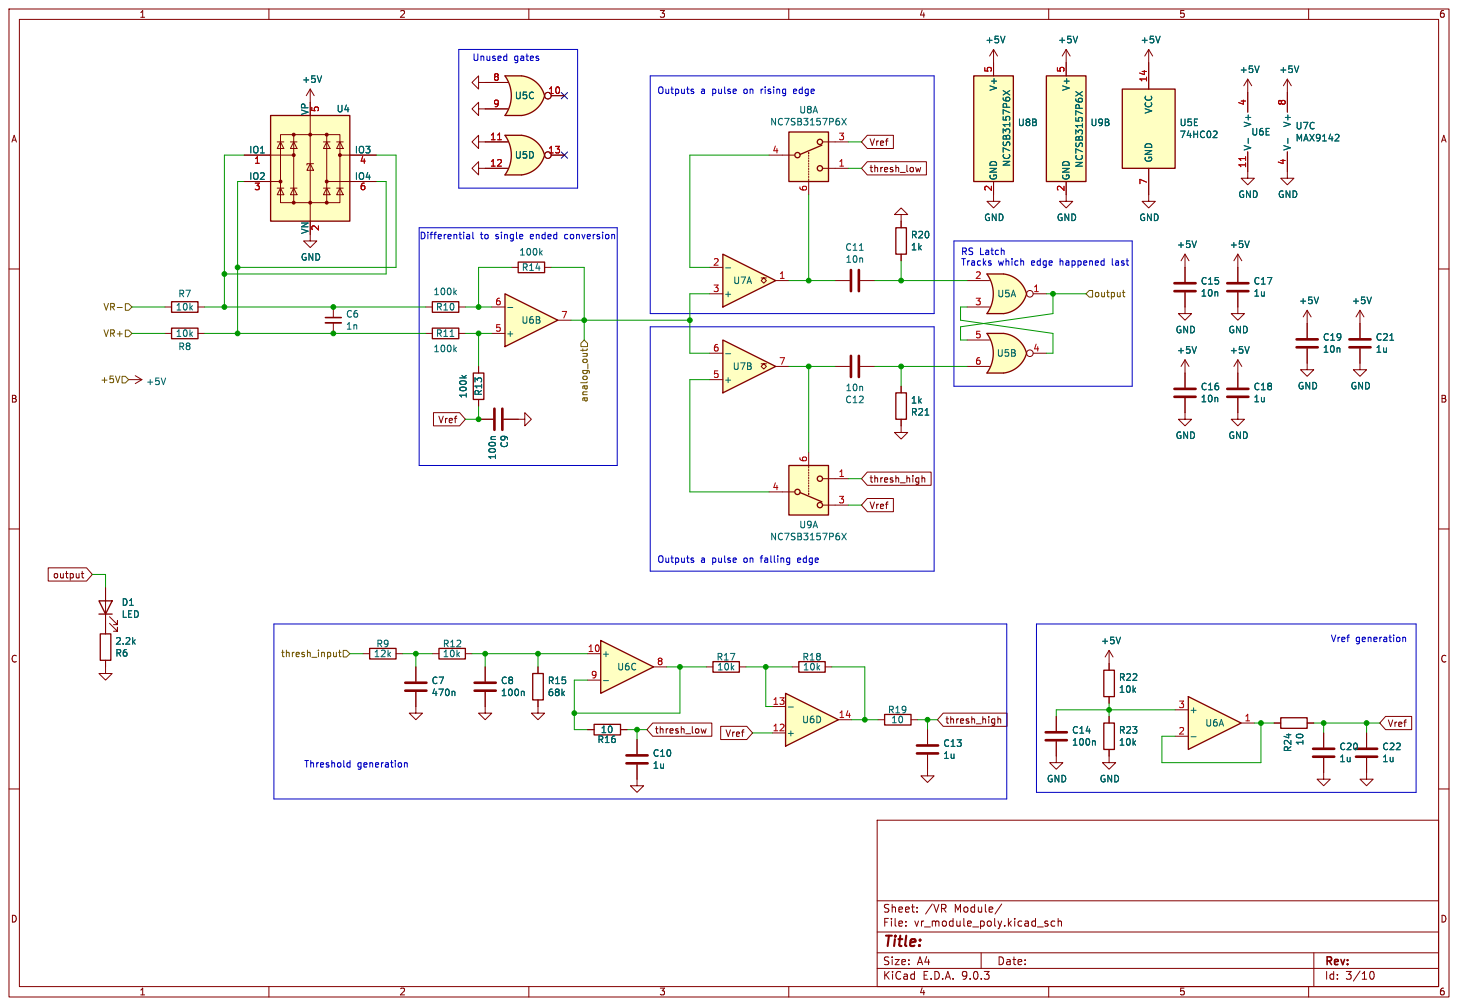
[picture p156: page 10]

Outputs a pulse on rising edge
