halbritt/fome-mc/telemetry-pod/renders/telemetry-pod-pcb-layers.pdf

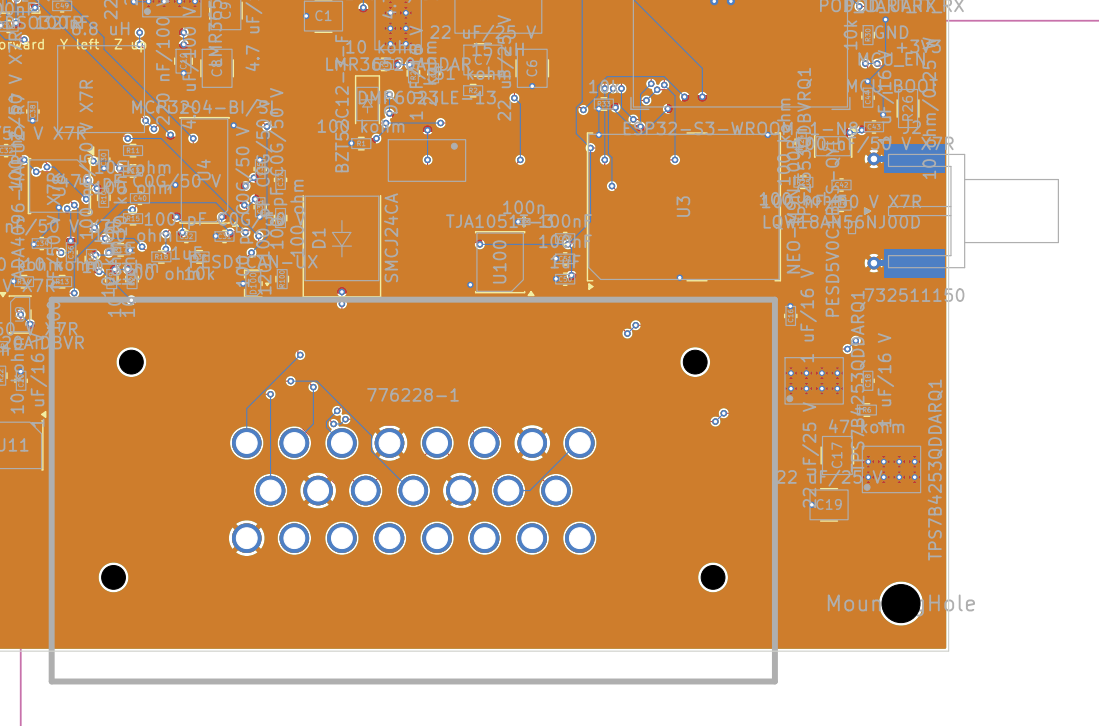
[picture p157: page 1]

Size: A4 | Rev:
KiCad E.D.A. 10.0.7 | Id: 1/1
