halbritt/fome-mc/docs/renders/fome-mc-pcb-layers.pdf

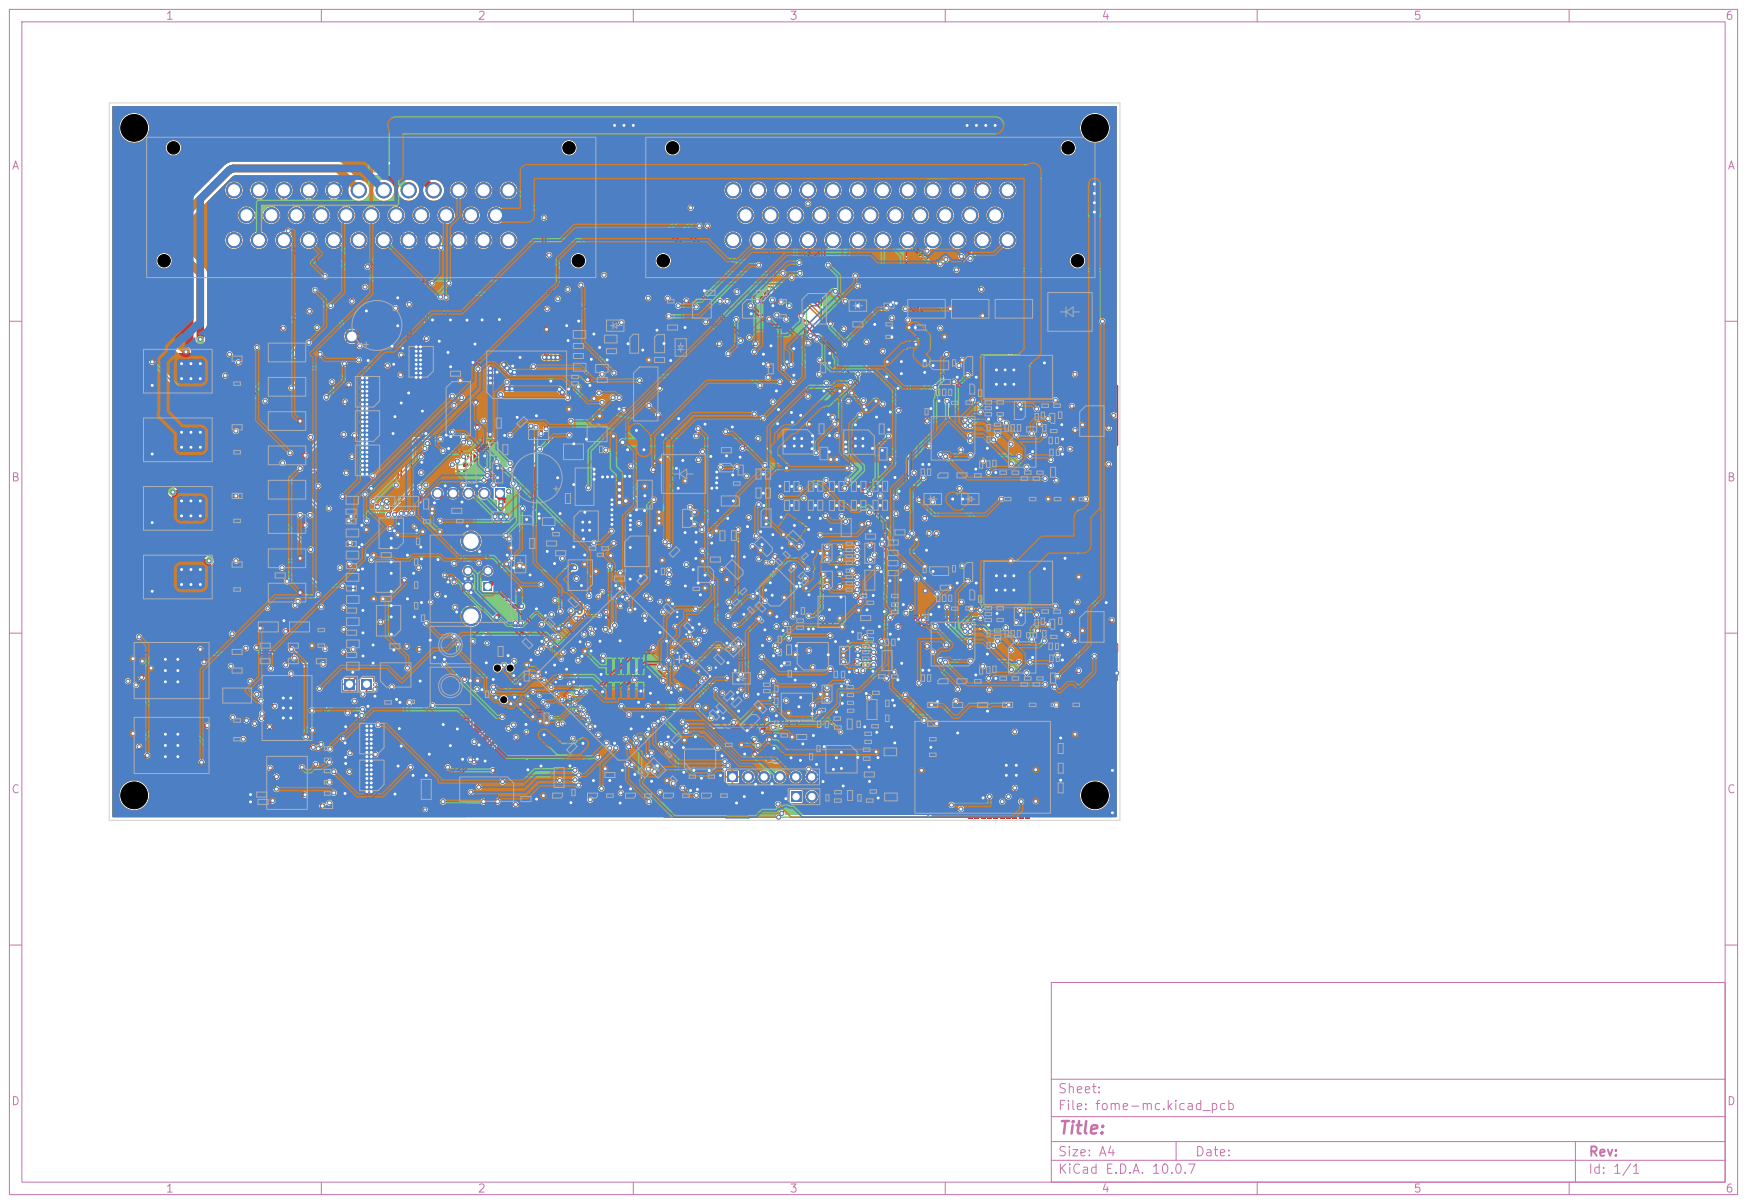
[picture p158: page 1]

Size: A4 | Rev:
KiCad E.D.A. 10.0.7 | Id: 1/1
