halbritt/fome-mc/reports/toolchain/baseline/fome-mc/export/native/fome-mc-layers.pdf

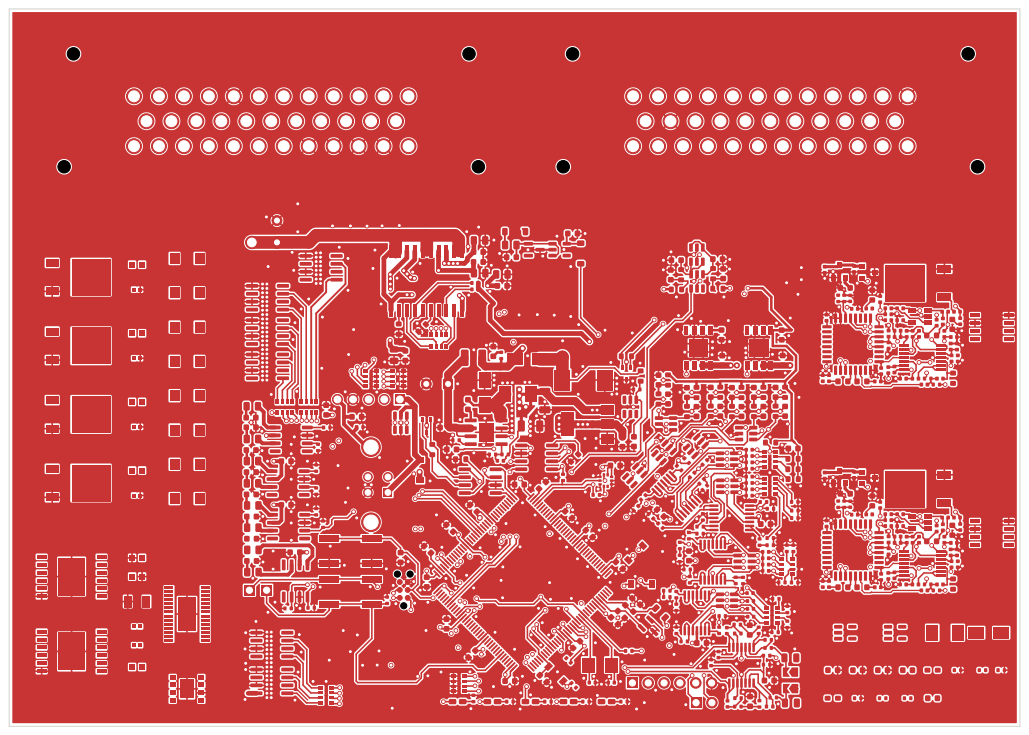
[picture p159: page 1]

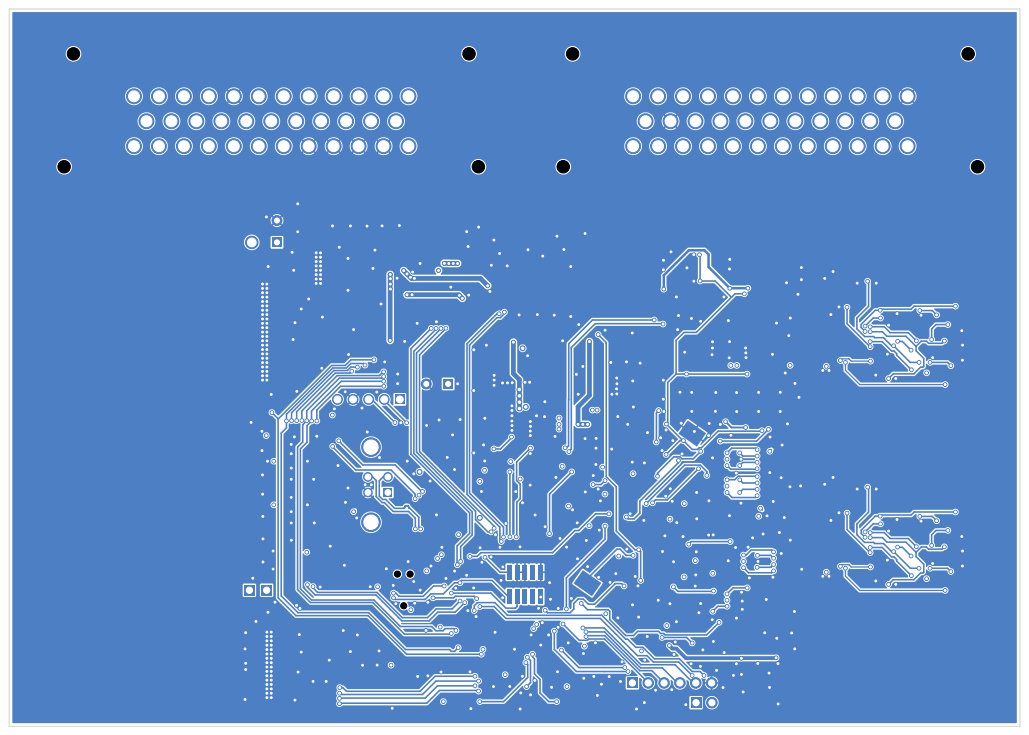
[picture p160: page 2]

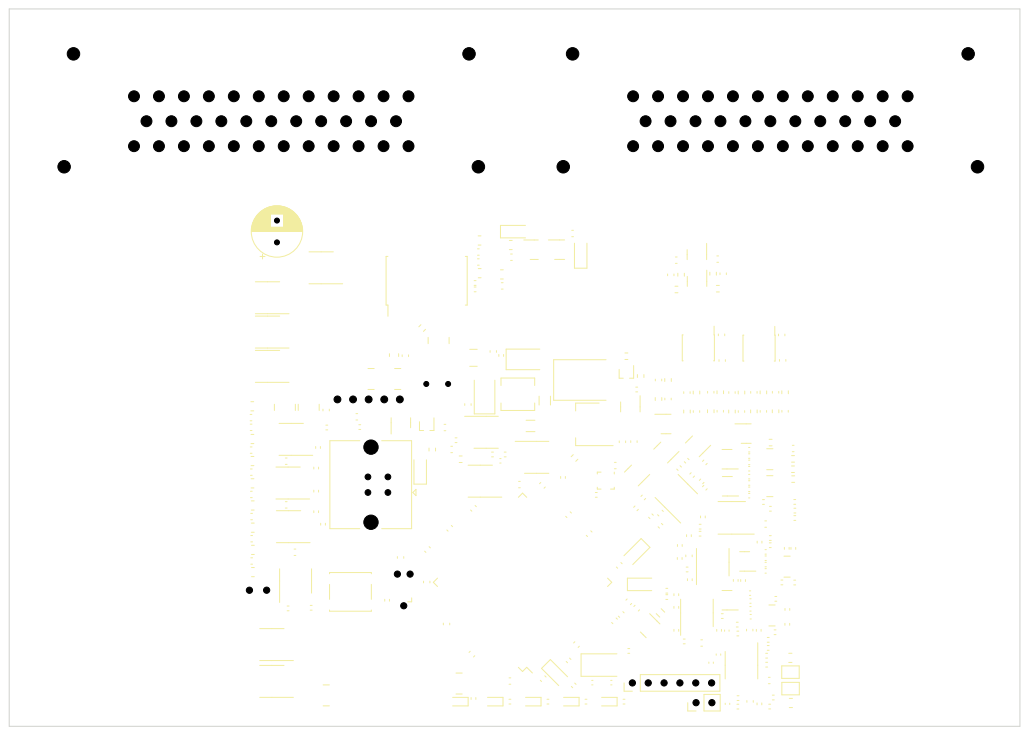
[picture p161: page 3]

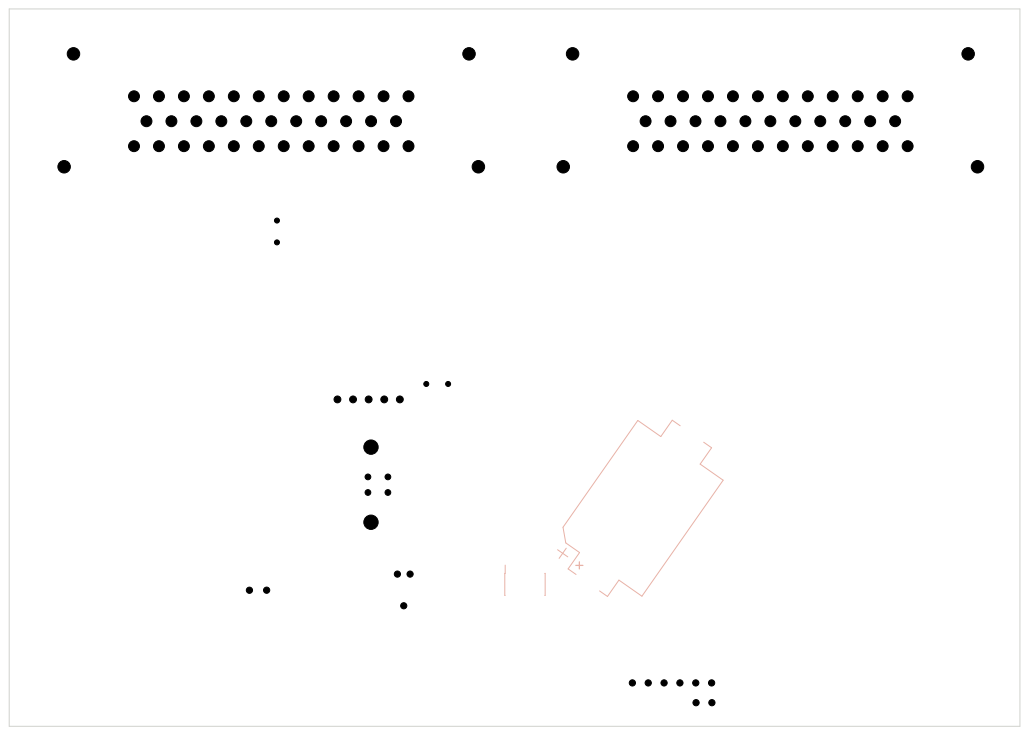
[picture p162: page 4]

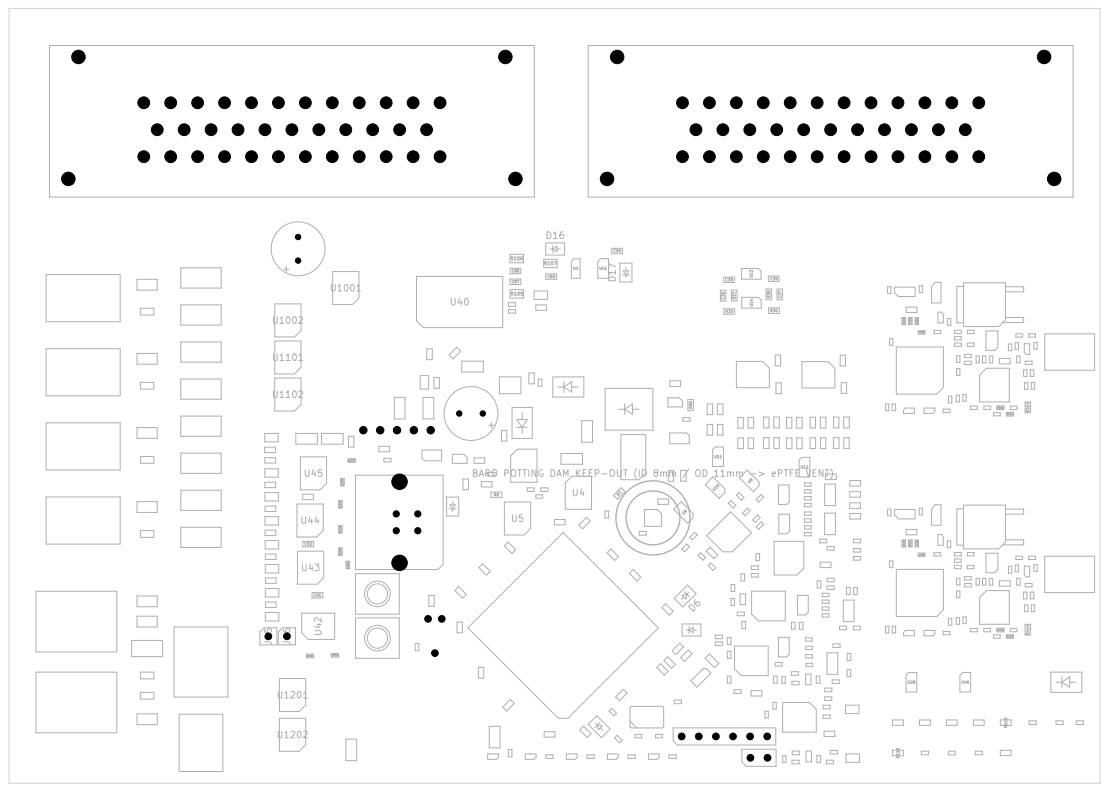
[picture p163: page 5]

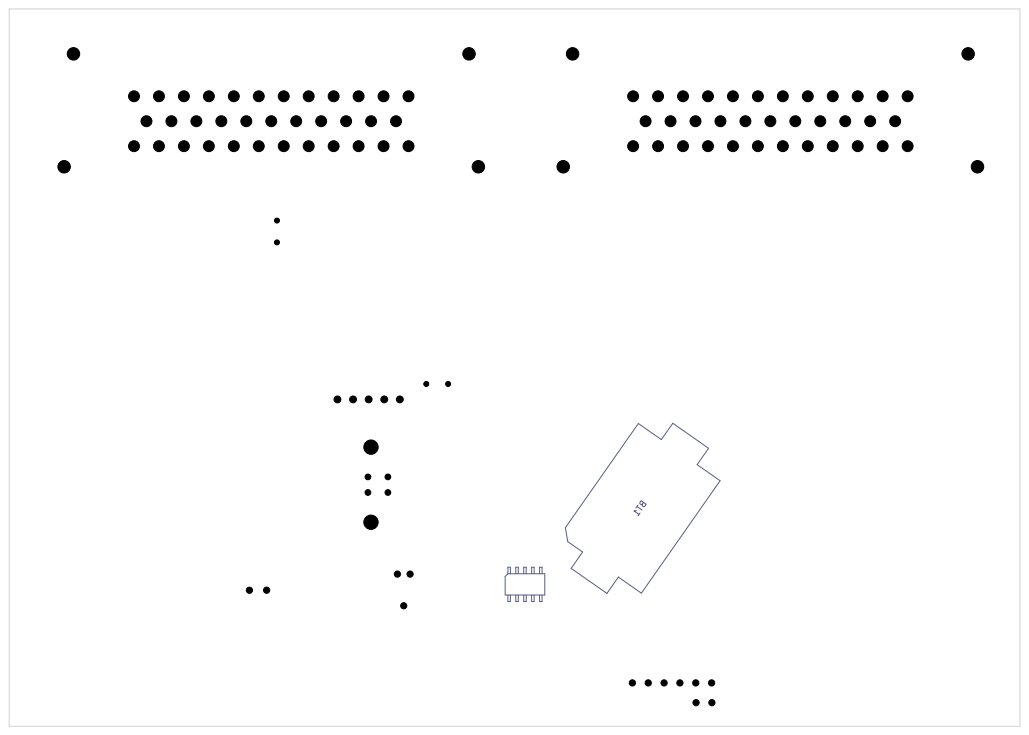
[picture p164: page 6]
