halbritt/fome-mc/reports/toolchain/baseline/universal-112/source/Polygonus-Universal-112/Export/V1.0/Polygonus-Universal-Base.pdf

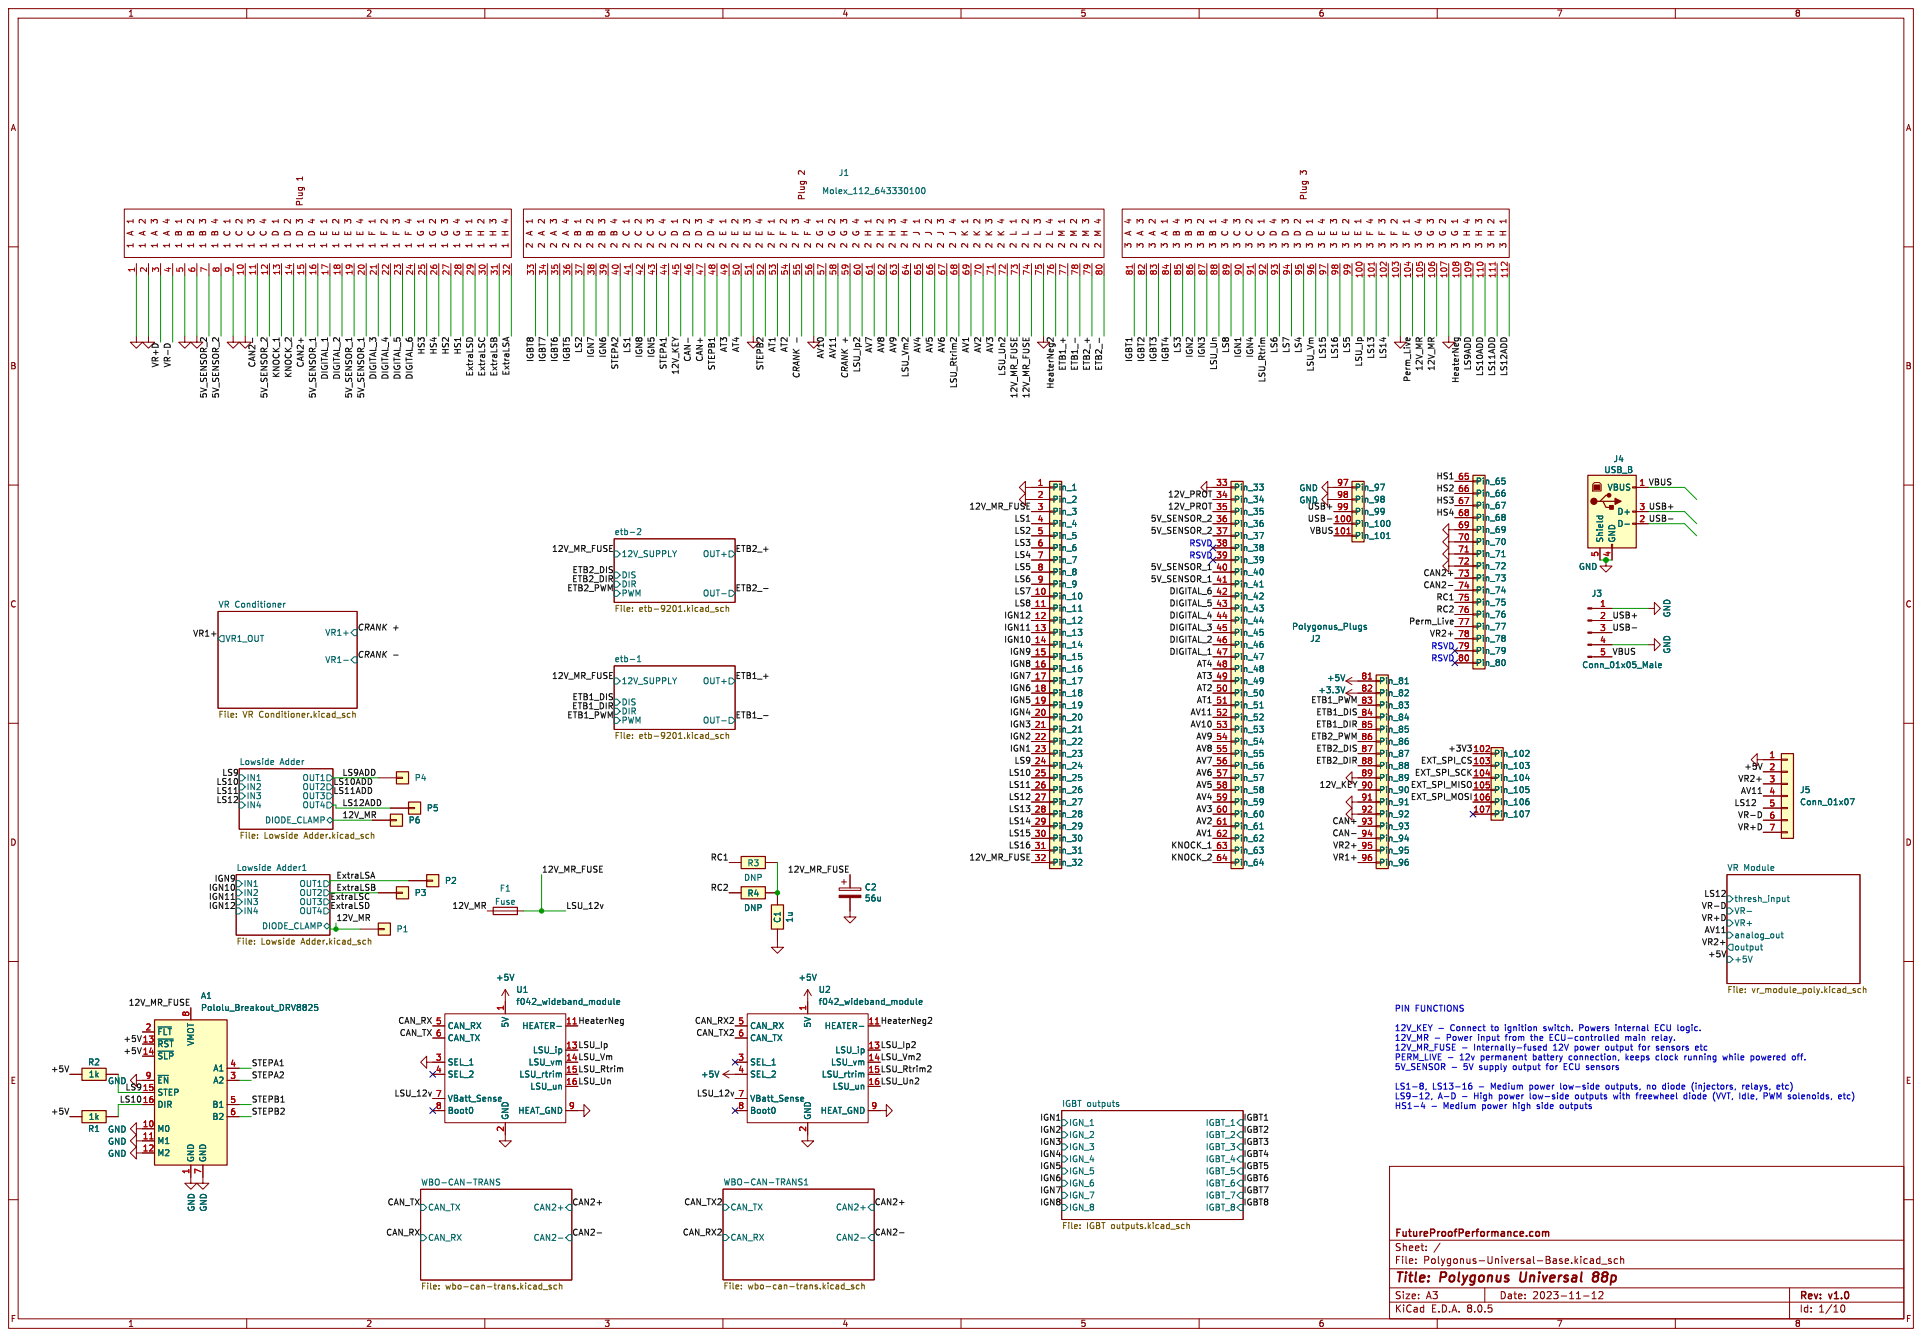
[picture p165: page 1]

Lowside Adder1 File: Lowside Adder.kicad_sch VR1+ VR1- VR1_OUT VR Conditioner File: VR Conditioner.kicad_sch OUT1 OUT2

1 M0 10 M1 11 M2 12 ~{RST} 13 ~{SLP} 14 STEP 15 DIR 16 ~{FLT} 2 A2 3 A1 4 B1 5 B2 6 GND
STEPB1 STEPA2 STEPB2 STEPA1 +5V

IGBT outputs File: IGBT outputs.kicad_sch

File: wbo-can-trans.kicad_sch

Id: 1/10 Title: Polygonus Universal 88p

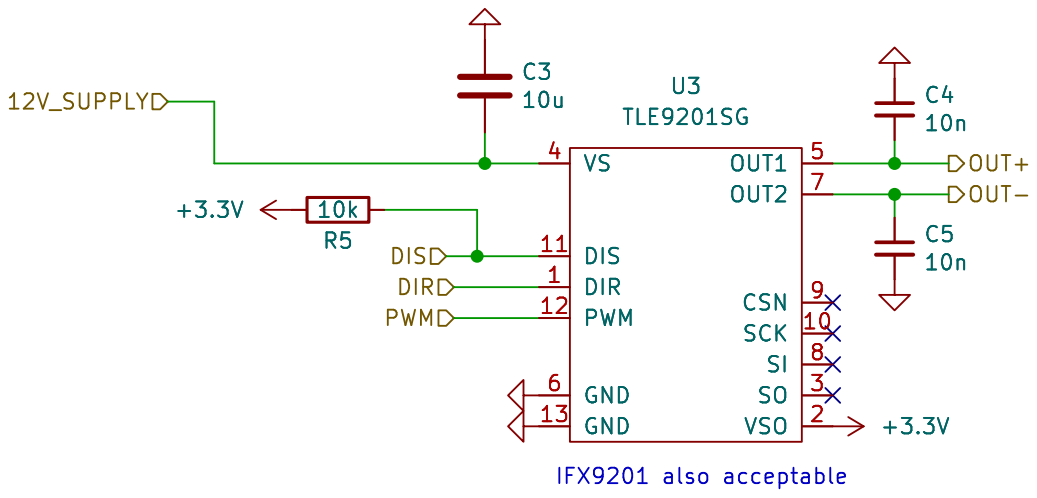
[picture p166: page 2]

File: etb-9201.kicad_sch Sheet: /etb-2/ FutureProofPerformance.com

Id: 2/10 Title: Polygonus Universal 88p

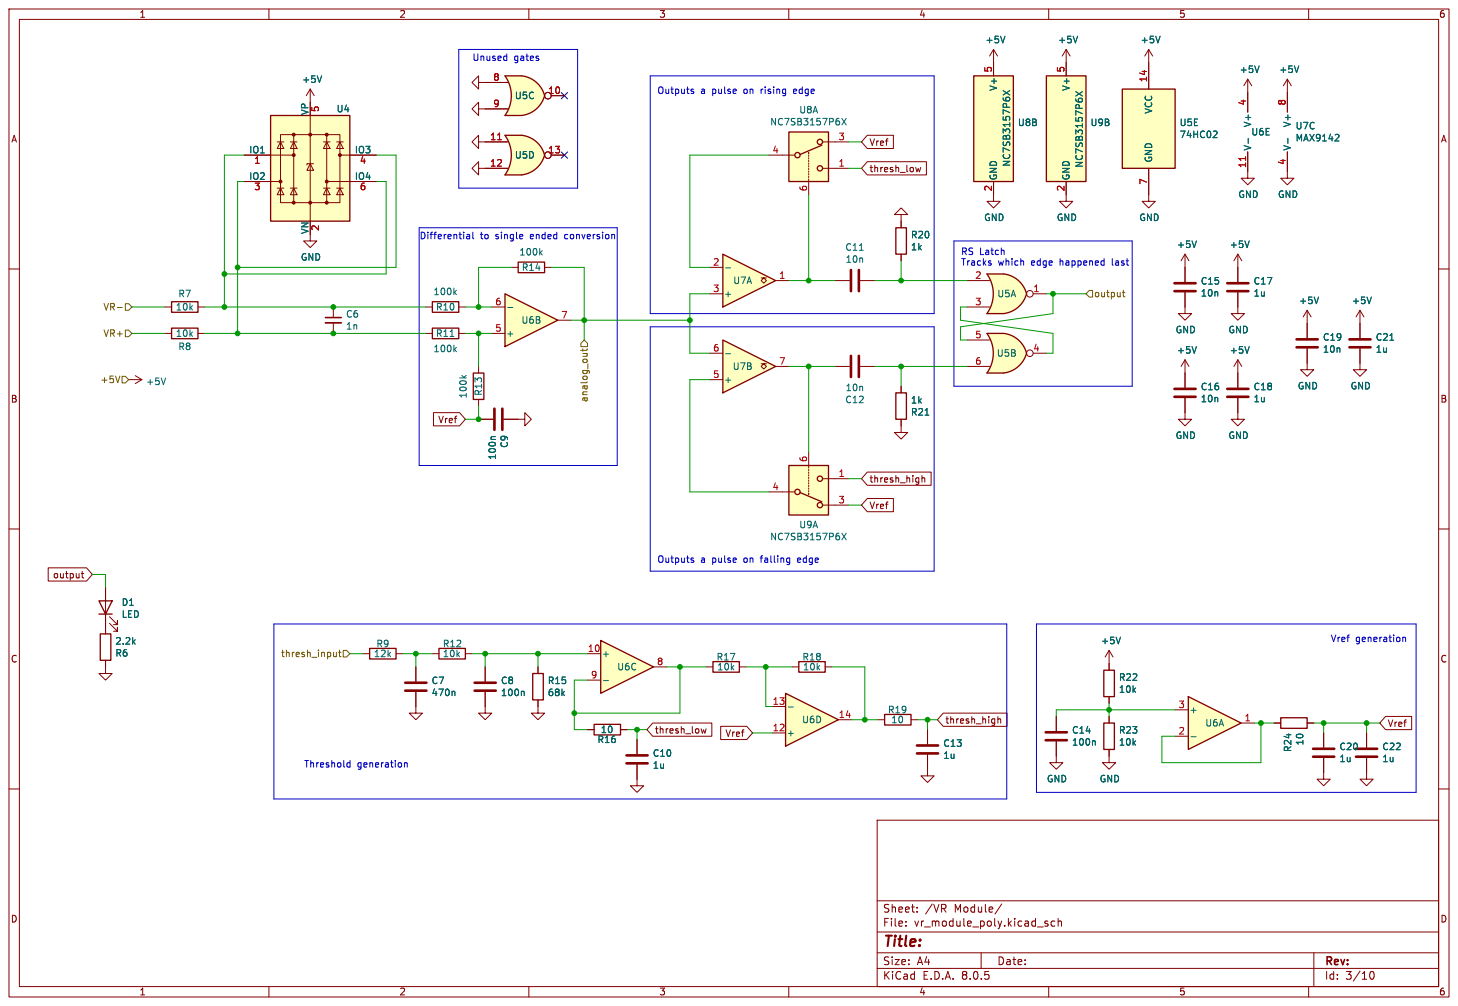
[picture p167: page 3]

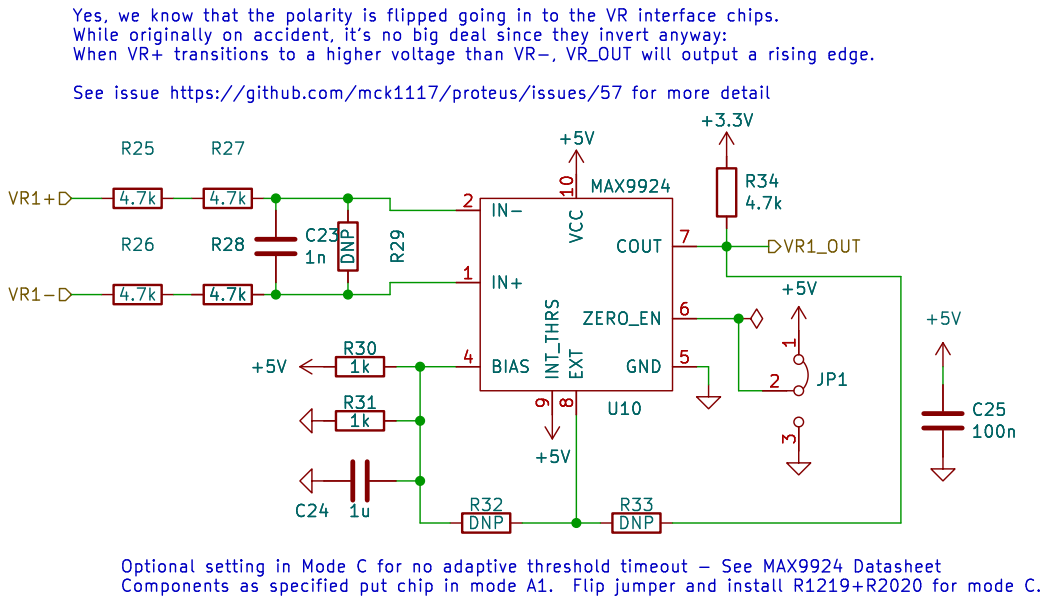
[picture p168: page 4]

9U10 MAX9924 VR1+ VR1_OUT VR1- Optional setting in Mode C for no adaptive threshold timeout - See MAX9924 Datasheet Components as specified put chip in mode A1. Flip jumper and install R1219+R2020 for mode C. Yes, we know that the polarity is flipped going in to the VR interface chips. While originally on accident, þÿit sno big deal since they invert anyway: When VR+ transitions to a higher voltage than VR-, VR_OUT will output a rising edge. See issue https://github.com/mck1117/proteus/issues/57 for more detail +5V

Id: 4/10 Title: Polygonus Universal 88p

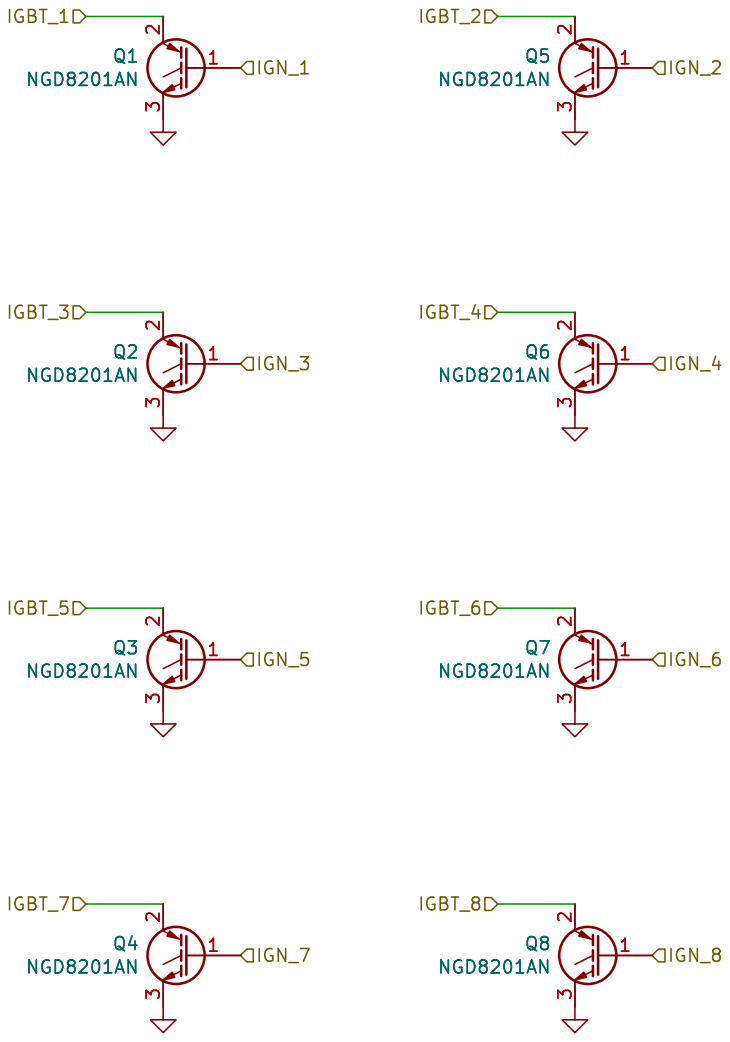
[picture p169: page 5]

Id: 5/10 Title: Polygonus Universal 88p

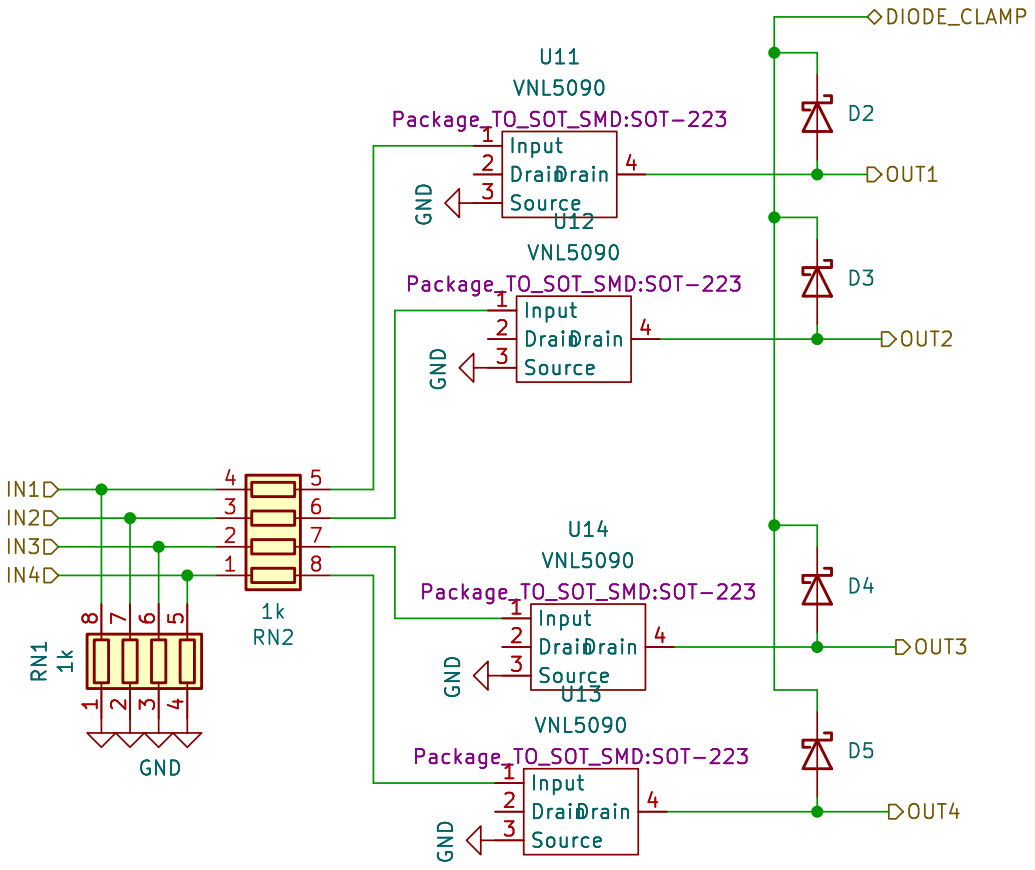
[picture p170: page 6]

Id: 6/10 Title: Polygonus Universal 88p

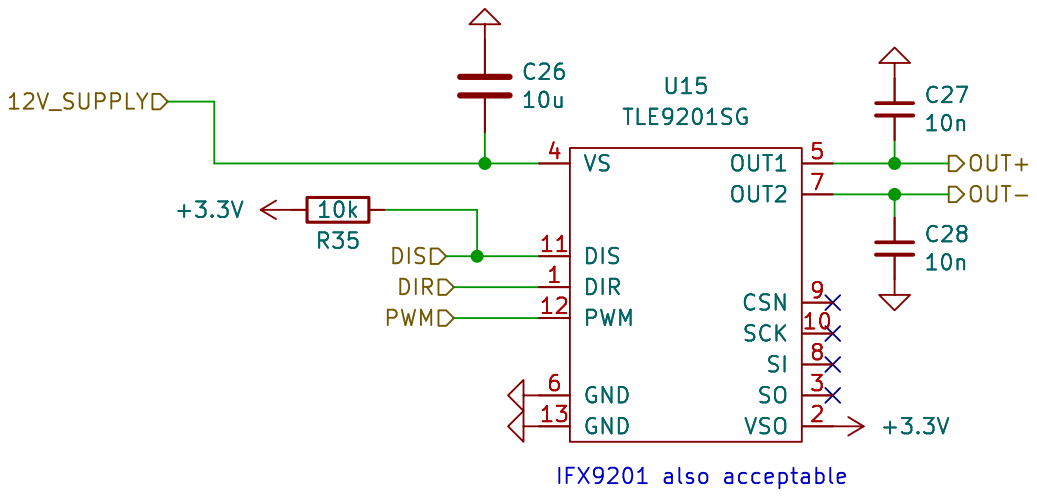
[picture p171: page 7]

File: etb-9201.kicad_sch Sheet: /etb-1/ FutureProofPerformance.com

Id: 7/10 Title: Polygonus Universal 88p

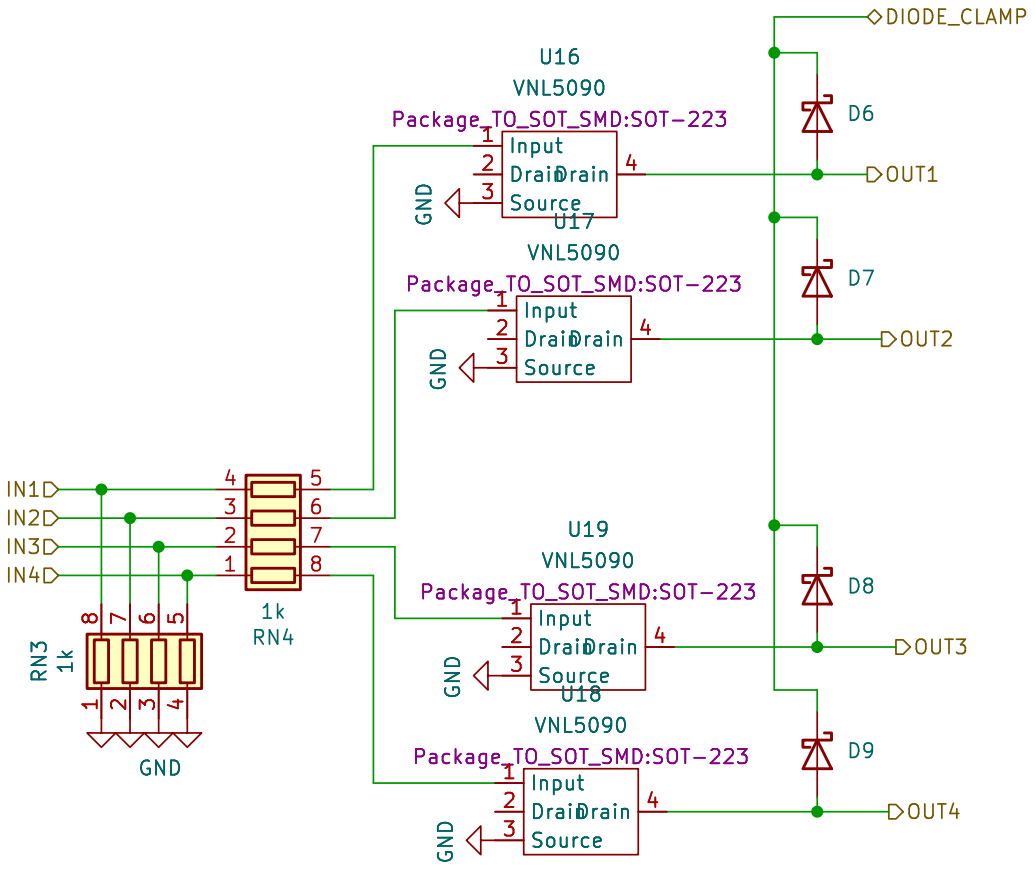
[picture p172: page 8]

Id: 8/10 Title: Polygonus Universal 88p

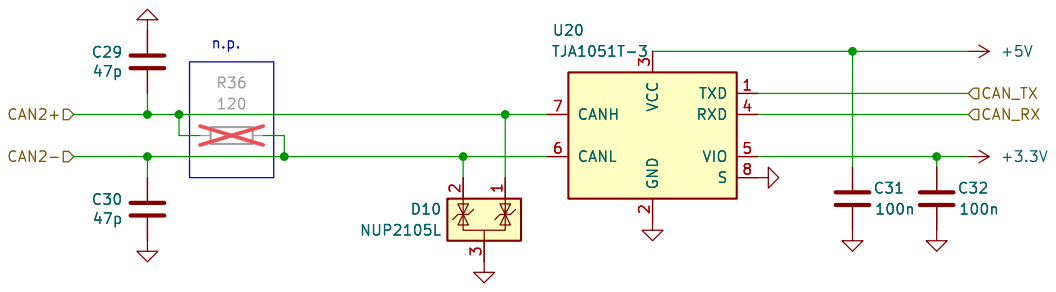
[picture p173: page 9]

3 RXD 4 VIO 5 CANL 6 CANH 7 S

File: wbo-can-trans.kicad_sch Sheet: /WBO-CAN-TRANS/ FutureProofPerformance.com

Id: 9/10 Title: Polygonus Universal 88p

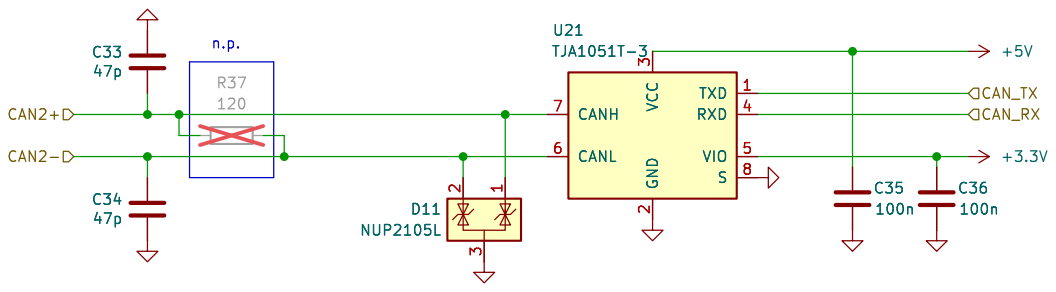
[picture p174: page 10]

3 RXD 4 VIO 5 CANL 6 CANH 7 S

File: wbo-can-trans.kicad_sch Sheet: /WBO-CAN-TRANS1/ FutureProofPerformance.com

Id: 10/10 Title: Polygonus Universal 88p
