halbritt/fome-mc/telemetry-pod/telemetry-pod.kicad_pcb

## KiCad design telemetry-pod/telemetry-pod.kicad_pcb (2026-10-20)

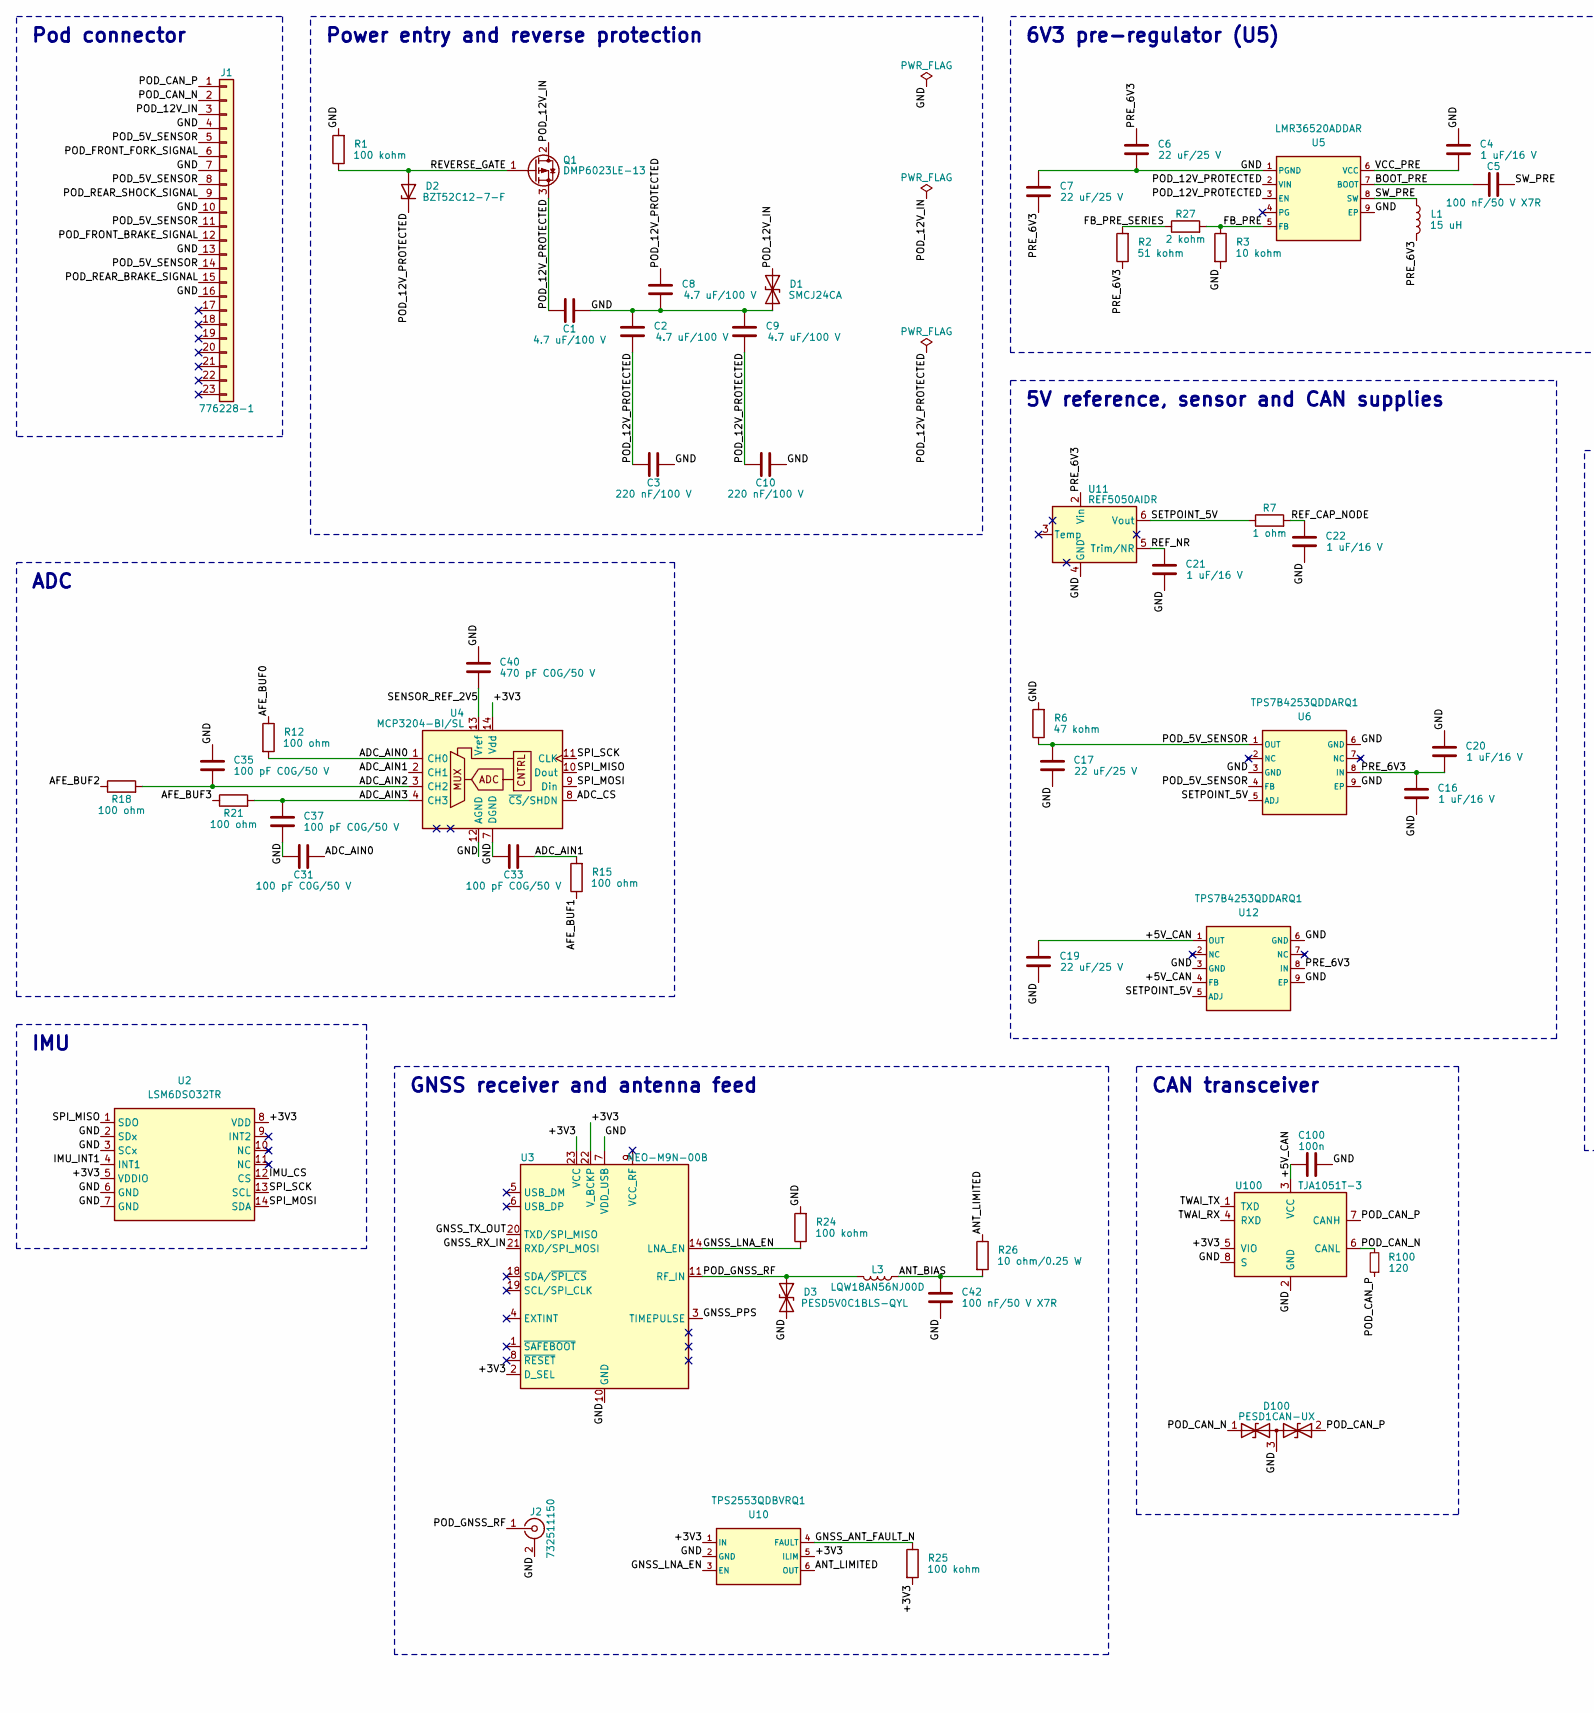
[picture p175: schematic telemetry-pod.kicad_sch, part in row 1, column 1]

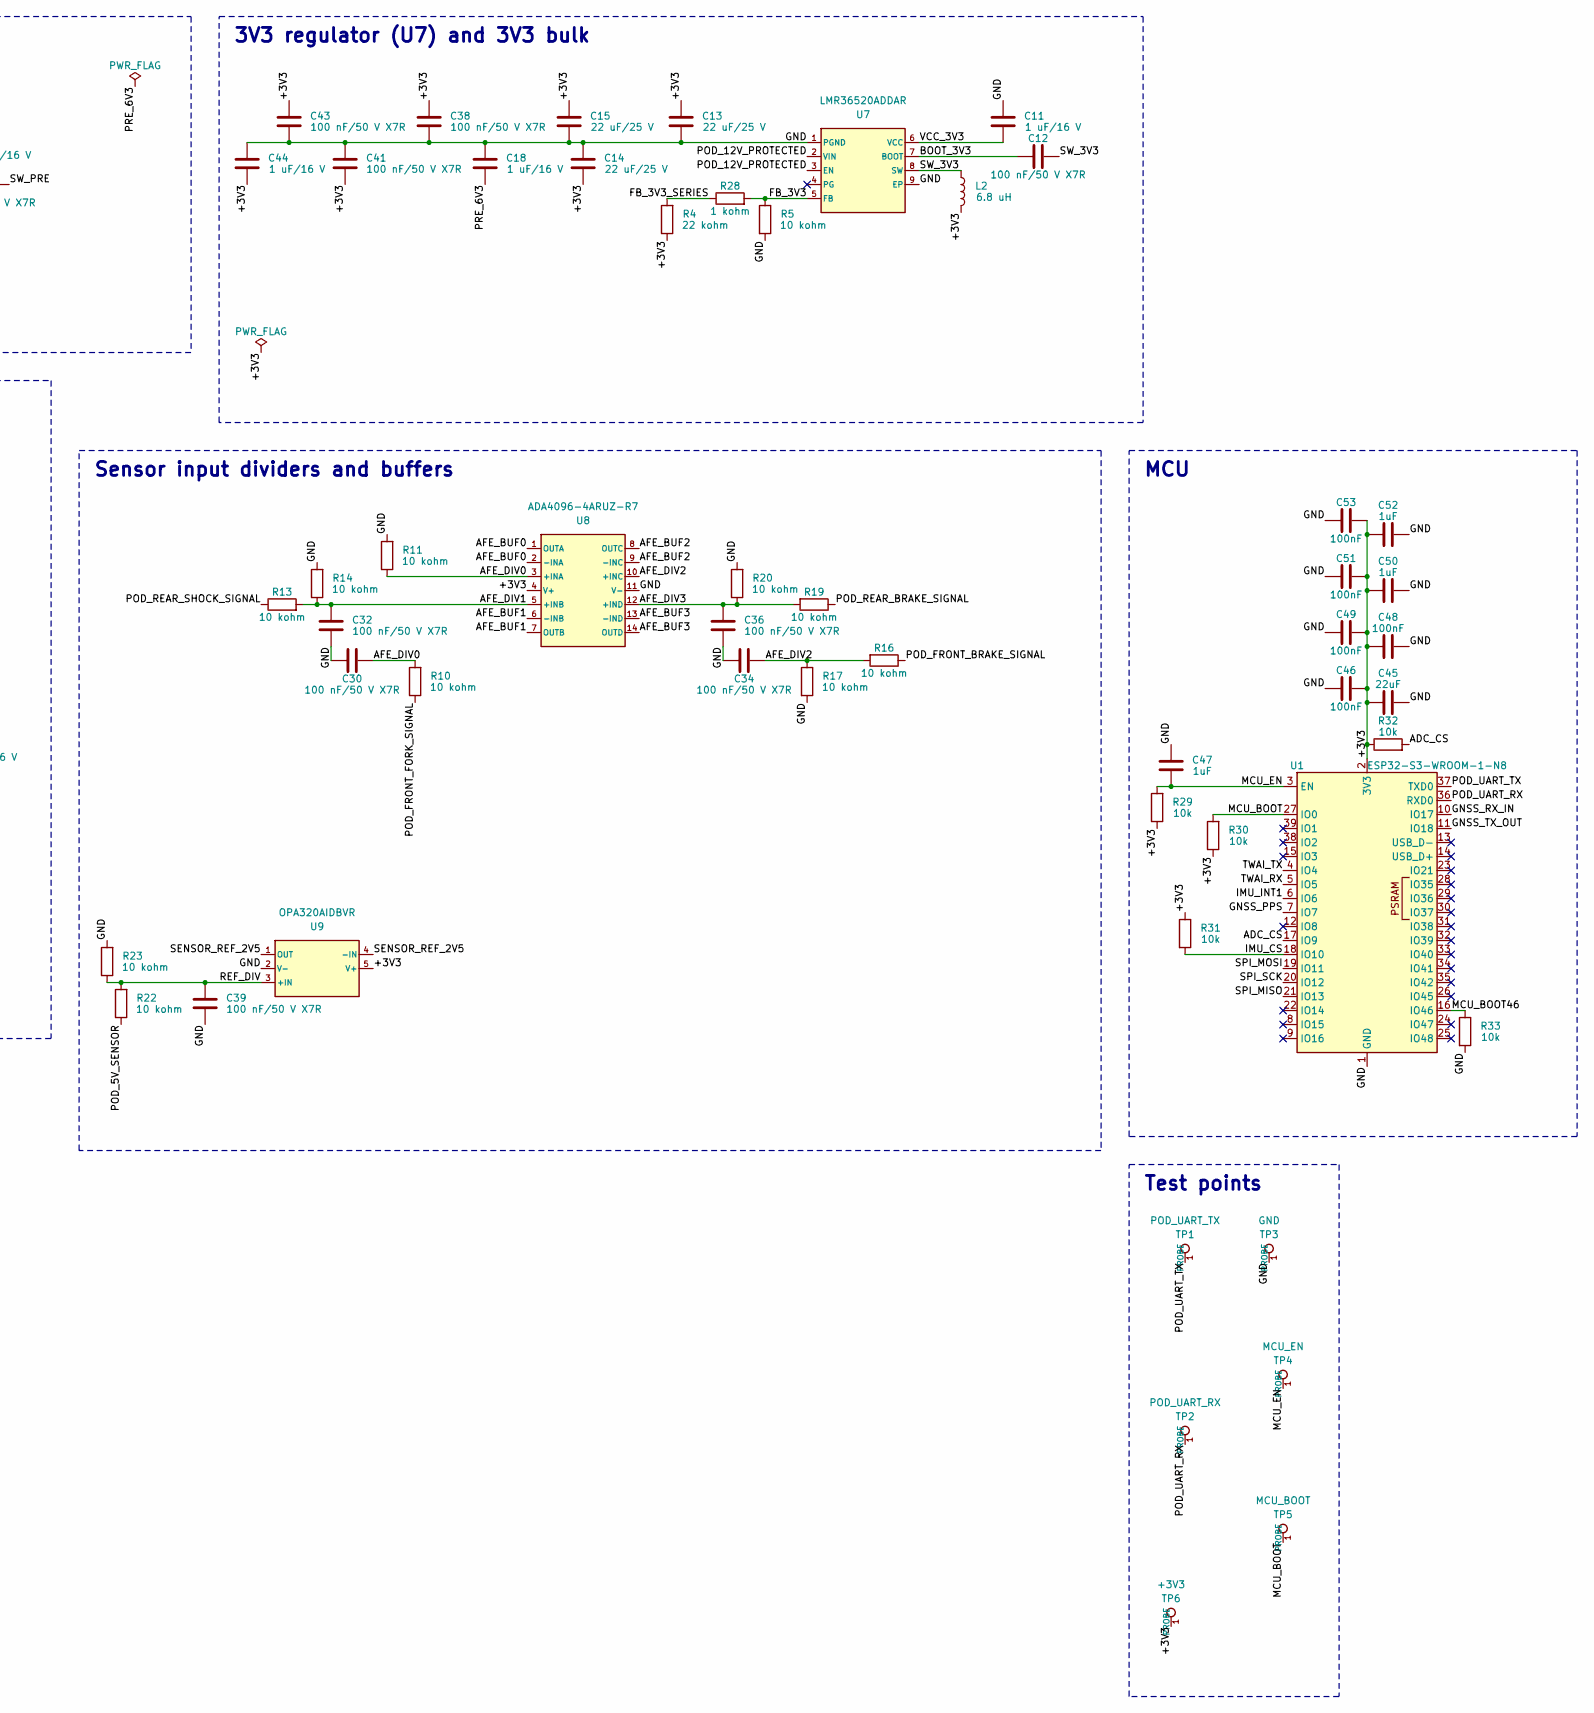
[picture p176: schematic telemetry-pod.kicad_sch, part in row 1, column 2]

Parts:
C1, C2, C8, C9: 4.7 uF/100 V; C_1210_3225Metric; Voltage 100V; Partnumber CL32B475KCVZNWE; LCSC C17288249
C3, C10: 220 nF/100 V; C_0805_2012Metric; Voltage 100V; Partnumber CL21B224KCFSFNE; LCSC C307542
C4, C11, C16, C18, C20, C21, C22, C44: 1 uF/16 V; C_0603_1608Metric; Voltage 16V; Partnumber CGA3E1X7R1C105KT0Y0N; LCSC C76706
C5, C12, C30, C32, C34, C36, C38, C39, C41, C42, C43: 100 nF/50 V X7R; C_0603_1608Metric; Voltage 50V; Partnumber CGA3E2X7R1H104KT0Y0N; LCSC C76711
C6, C7, C13, C14, C15, C17, C19: 22 uF/25 V; C_1210_3225Metric; Voltage 25V; Partnumber CGA6P3X7R1E226MT000N; LCSC C694521
C31, C33, C35, C37: 100 pF C0G/50 V; C_0603_1608Metric; Voltage 50V; Partnumber C0603C101J5GACTU; LCSC C2167328
C40: 470 pF C0G/50 V; C_0603_1608Metric; Voltage 50V; Partnumber C0603C471J5GACTU; LCSC C452751
C45: 22uF; C_1210_3225Metric; Voltage 25V; Partnumber CGA6P3X7R1E226MT000N; LCSC C694521
C46, C48, C49, C51, C53: 100nF; C_0603_1608Metric; Voltage 50V; Partnumber CGA3E2X7R1H104KT0Y0N; LCSC C76711
C47, C50, C52: 1uF; C_0603_1608Metric; Voltage 16V; Partnumber CGA3E1X7R1C105KT0Y0N; LCSC C76706
C100: 100n; C_0402_1005Metric; Voltage 16V; Partnumber CL05B104KO5NNNC; LCSC C1525
D1: SMCJ24CA; D_SMC; Partnumber SMCJ24CA; LCSC C151279
D2: BZT52C12-7-F; D_SOD-123; Partnumber BZT52C12-7-F; LCSC C124196
D3: PESD5V0C1BLS-QYL; SOD882BD; Partnumber PESD5V0C1BLS-QYL; LCSC C5311564
D100: PESD1CAN-UX; SOT-323_SC-70; Partnumber PESD1CAN-UX; LCSC C907839
J1: 776228-1; ampseal-23; Partnumber 776228-1; JLCPCB_Assembly not_assembled
J2: 732511150; SMA_Molex_73251-1153_EdgeMount_Horizontal; Partnumber 732511150; LCSC C841205
L1: 15 uH; SRP7050TA; Partnumber SRP7050TA-150M; LCSC C2045384
L2: 6.8 uH; SRP7050WA; Partnumber SRP7050WA-6R8M; LCSC C19947708
L3: LQW18AN56NJ00D; L_0603_1608Metric; Partnumber LQW18AN56NJ00D; LCSC C98080
Q1: DMP6023LE-13; DMP6023LE_SOT223; Partnumber DMP6023LE-13; LCSC C154901
R1, R24, R25: 100 kohm; R_0603_1608Metric; Partnumber RC0603FR-07100KL; LCSC C14675
R2: 51 kohm; R_0603_1608Metric; Partnumber RT0603BRD0751KL; LCSC C861458
R3, R5, R10, R11, R13, R14, R16, R17, R19, R20, R22, R23: 10 kohm; R_0603_1608Metric; Partnumber RT0603BRD0710KL; LCSC C95204
R4: 22 kohm; R_0603_1608Metric; Partnumber RT0603BRD0722KL; LCSC C469656
R6: 47 kohm; R_0603_1608Metric; Partnumber RC0603FR-0747KL; LCSC C105579
R7: 1 ohm; R_0603_1608Metric; Partnumber RC0603FR-071RL; LCSC C112305
R12, R15, R18, R21: 100 ohm; R_0603_1608Metric; Partnumber RC0603FR-07100RL; LCSC C105588
R26: 10 ohm/0.25 W; R_1206_3216Metric; Partnumber RC1206FR-0710RL; LCSC C108080
R27: 2 kohm; R_0603_1608Metric; Partnumber RT0603BRD072KL; LCSC C728588
R28: 1 kohm; R_0603_1608Metric; Partnumber RT0603BRD071KL; LCSC C110776
R29, R30, R31, R32, R33: 10k; R_0603_1608Metric; Partnumber RT0603BRD0710KL; LCSC C95204
R100: 120; R_0603_1608Metric; Partnumber 0603WAF1200T5E; LCSC C22787
TP1: POD_UART_TX; PogoPad_D1.5mm
TP2: POD_UART_RX; PogoPad_D1.5mm
TP3: GND; PogoPad_D1.5mm
TP4: MCU_EN; PogoPad_D1.5mm
TP5: MCU_BOOT; PogoPad_D1.5mm
TP6: +3V3; PogoPad_D1.5mm
U1: ESP32-S3-WROOM-1-N8; ESP32-S3-WROOM-1; Partnumber ESP32-S3-WROOM-1-N8; LCSC C2913198
U2: LSM6DSO32TR; LGA-14_3x2.5mm_P0.5mm_LayoutBorder3x4y; Partnumber LSM6DSO32TR; LCSC C1864162
U3: NEO-M9N-00B; ublox_NEO; Partnumber NEO-M9N-00B; LCSC C5119087
U4: MCP3204-BI/SL; SOIC-14_3.9x8.7mm_P1.27mm; Partnumber MCP3204-BI/SL; LCSC C107363
U5, U7: LMR36520ADDAR; DDA0008B; Partnumber LMR36520ADDAR; LCSC C2879422
U6, U12: TPS7B4253QDDARQ1; DDA0008J_C02; Partnumber TPS7B4253QDDARQ1; LCSC C129339
U8: ADA4096-4ARUZ-R7; TSSOP-14_4.4x5mm_P0.65mm; Partnumber ADA4096-4ARUZ-R7; LCSC C208539
U9: OPA320AIDBVR; SOT-23-5; Partnumber OPA320AIDBVR; LCSC C92494
U10: TPS2553QDBVRQ1; SOT-23-6; Partnumber TPS2553QDBVRQ1; LCSC C130055
U11: REF5050AIDR; SOIC-8_3.9x4.9mm_P1.27mm; Partnumber REF5050AIDR; LCSC C27804
U100: TJA1051T-3; SOIC-8_3.9x4.9mm_P1.27mm; Partnumber TJA1051T/3/1J; LCSC C38695

Connections:
/+3V3: C13.1, C14.1, C15.1, C38.1, C41.1, C43.1, C44.1, C45.1, C46.1, C48.1, C49.1, C50.1, C51.1, C52.1, C53.1, L2.2, R4.1, R25.2, R29.1, R30.1, R31.1, R32.1, TP6.1, U1.2 (3V3), U2.5 (VDDIO), U2.8 (VDD), U3.2 (D_SEL), U3.22 (V_BCKP), U3.23 (VCC), U4.14 (Vdd), U8.4 (V+), U9.5 (V+), U10.1 (IN), U10.5 (ILIM), U100.5 (VIO)
/+5V_CAN: C19.1, C100.1, U12.1 (OUT), U12.4 (FB), U100.3 (VCC)
/ADC_AIN0: C31.1, R12.2, U4.1 (CH0)
/ADC_AIN1: C33.1, R15.2, U4.2 (CH1)
/ADC_AIN2: C35.1, R18.2, U4.3 (CH2)
/ADC_AIN3: C37.1, R21.2, U4.4 (CH3)
/ADC_CS: R32.2, U1.17 (IO9), U4.8 (~CS/SHDN)
/AFE_BUF0: R12.1, U8.1 (OUTA), U8.2 (-INA)
/AFE_BUF1: R15.1, U8.6 (-INB), U8.7 (OUTB)
/AFE_BUF2: R18.1, U8.8 (OUTC), U8.9 (-INC)
/AFE_BUF3: R21.1, U8.13 (-IND), U8.14 (OUTD)
/AFE_DIV0: C30.1, R10.2, R11.1, U8.3 (+INA)
/AFE_DIV1: C32.1, R13.2, R14.1, U8.5 (+INB)
/AFE_DIV2: C34.1, R16.2, R17.1, U8.10 (+INC)
/AFE_DIV3: C36.1, R19.2, R20.1, U8.12 (+IND)
/ANT_BIAS: C42.1, L3.1, R26.2
/ANT_LIMITED: R26.1, U10.6 (OUT)
/BOOT_3V3: C12.1, U7.7 (BOOT)
/BOOT_PRE: C5.1, U5.7 (BOOT)
/FB_3V3: R5.1, R28.2, U7.5 (FB)
/FB_3V3_SERIES: R4.2, R28.1
/FB_PRE: R3.1, R27.2, U5.5 (FB)
/FB_PRE_SERIES: R2.2, R27.1
/GND: C1.2, C2.2, C3.2, C4.2, C6.2, C7.2, C8.2, C9.2, C10.2, C11.2, C13.2, C14.2, C15.2, C16.2, C17.2, C18.2, C19.2, C20.2, C21.2, C22.2, C30.2, C31.2, C32.2, C33.2, C34.2, C35.2, C36.2, C37.2, C38.2, C39.2, C40.2, C41.2, C42.2, C43.2, C44.2, C45.2, C46.2, C47.2, C48.2, C49.2, C50.2, C51.2, C52.2, C53.2, C100.2, D1.2 (A2), D3.2 (A2), D100.3 (common), J1.4, J1.7, J1.10, J1.13, J1.16, J2.2 (Ext), R1.2, R3.2, R5.2, R6.2, R11.2, R14.2, R17.2, R20.2, R23.2, R24.2, R33.2, TP3.1, U1.1 (GND), U1.40 (GND), U1.41 (GND), U2.2 (SDx), U2.3 (SCx), U2.6 (GND), U2.7 (GND), U3.7 (VDD_USB), U3.10 (GND), U3.12 (GND), U3.13 (GND), U3.24 (GND), U4.7 (DGND), U4.12 (AGND), U5.1 (PGND), U5.9 (EP), U6.3 (GND), U6.6 (GND), U6.9 (EP), U7.1 (PGND), U7.9 (EP), U8.11 (V-), U9.2 (V-), U10.2 (GND), U11.4 (GND), U12.3 (GND), U12.6 (GND), U12.9 (EP), U100.2 (GND), U100.8 (S)
/GNSS_ANT_FAULT_N: R25.1, U10.4 (FAULT)
/GNSS_LNA_EN: R24.1, U3.14 (LNA_EN), U10.3 (EN)
/GNSS_PPS: U1.7 (IO7), U3.3 (TIMEPULSE)
/GNSS_RX_IN: U1.10 (IO17), U3.21 (RXD/SPI_MOSI)
/GNSS_TX_OUT: U1.11 (IO18), U3.20 (TXD/SPI_MISO)
/IMU_CS: R31.2, U1.18 (IO10), U2.12 (CS)
/IMU_INT1: U1.6 (IO6), U2.4 (INT1)
/MCU_BOOT: R30.2, TP5.1, U1.27 (IO0)
/MCU_BOOT46: R33.1, U1.16 (IO46)
/MCU_EN: C47.1, R29.2, TP4.1, U1.3 (EN)
/POD_5V_SENSOR: C17.1, J1.5, J1.8, J1.11, J1.14, R6.1, R22.1, U6.1 (OUT), U6.4 (FB)
/POD_12V_IN: D1.1 (A1), J1.3, Q1.2 (D)
/POD_12V_PROTECTED: C1.1, C2.1, C3.1, C8.1, C9.1, C10.1, D2.1 (K), Q1.3 (S), U5.2 (VIN), U5.3 (EN), U7.2 (VIN), U7.3 (EN)
/POD_CAN_N: D100.1 (A1), J1.2, R100.2, U100.6 (CANL)
/POD_CAN_P: D100.2 (A2), J1.1, R100.1, U100.7 (CANH)
/POD_FRONT_BRAKE_SIGNAL: J1.12, R16.1
/POD_FRONT_FORK_SIGNAL: J1.6, R10.1
/POD_GNSS_RF: D3.1 (A1), J2.1 (In), L3.2, U3.11 (RF_IN)
/POD_REAR_BRAKE_SIGNAL: J1.15, R19.1
/POD_REAR_SHOCK_SIGNAL: J1.9, R13.1
/POD_UART_RX: TP2.1, U1.36 (RXD0)
/POD_UART_TX: TP1.1, U1.37 (TXD0)
/PRE_6V3: C6.1, C7.1, C16.1, C18.1, C20.1, L1.2, R2.1, U6.8 (IN), U11.2 (Vin), U12.8 (IN)
/REF_CAP_NODE: C22.1, R7.2
/REF_DIV: C39.1, R22.2, R23.1, U9.3 (+IN)
/REF_NR: C21.1, U11.5 (Trim/NR)
/REVERSE_GATE: D2.2 (A), Q1.1 (G), R1.1
/SENSOR_REF_2V5: C40.1, U4.13 (Vref), U9.1 (OUT), U9.4 (-IN)
/SETPOINT_5V: R7.1, U6.5 (ADJ), U11.6 (Vout), U12.5 (ADJ)
/SPI_MISO: U1.21 (IO13), U2.1 (SDO), U4.10 (Dout)
/SPI_MOSI: U1.19 (IO11), U2.14 (SDA), U4.9 (Din)
/SPI_SCK: U1.20 (IO12), U2.13 (SCL), U4.11 (CLK)
/SW_3V3: C12.2, L2.1, U7.8 (SW)
/SW_PRE: C5.2, L1.1, U5.8 (SW)
/TWAI_RX: U1.5 (IO5), U100.4 (RXD)
/TWAI_TX: U1.4 (IO4), U100.1 (TXD)
/VCC_3V3: C11.1, U7.6 (VCC)
/VCC_PRE: C4.1, U5.6 (VCC)

Notes on the sheet:
ADC
Sensor input dividers and buffers
3V3 regulator (U7) and 3V3 bulk
Power entry and reverse protection
GNSS receiver and antenna feed
CAN transceiver
MCU
6V3 pre-regulator (U5)
5V reference, sensor and CAN supplies
IMU
Test points
Pod connector

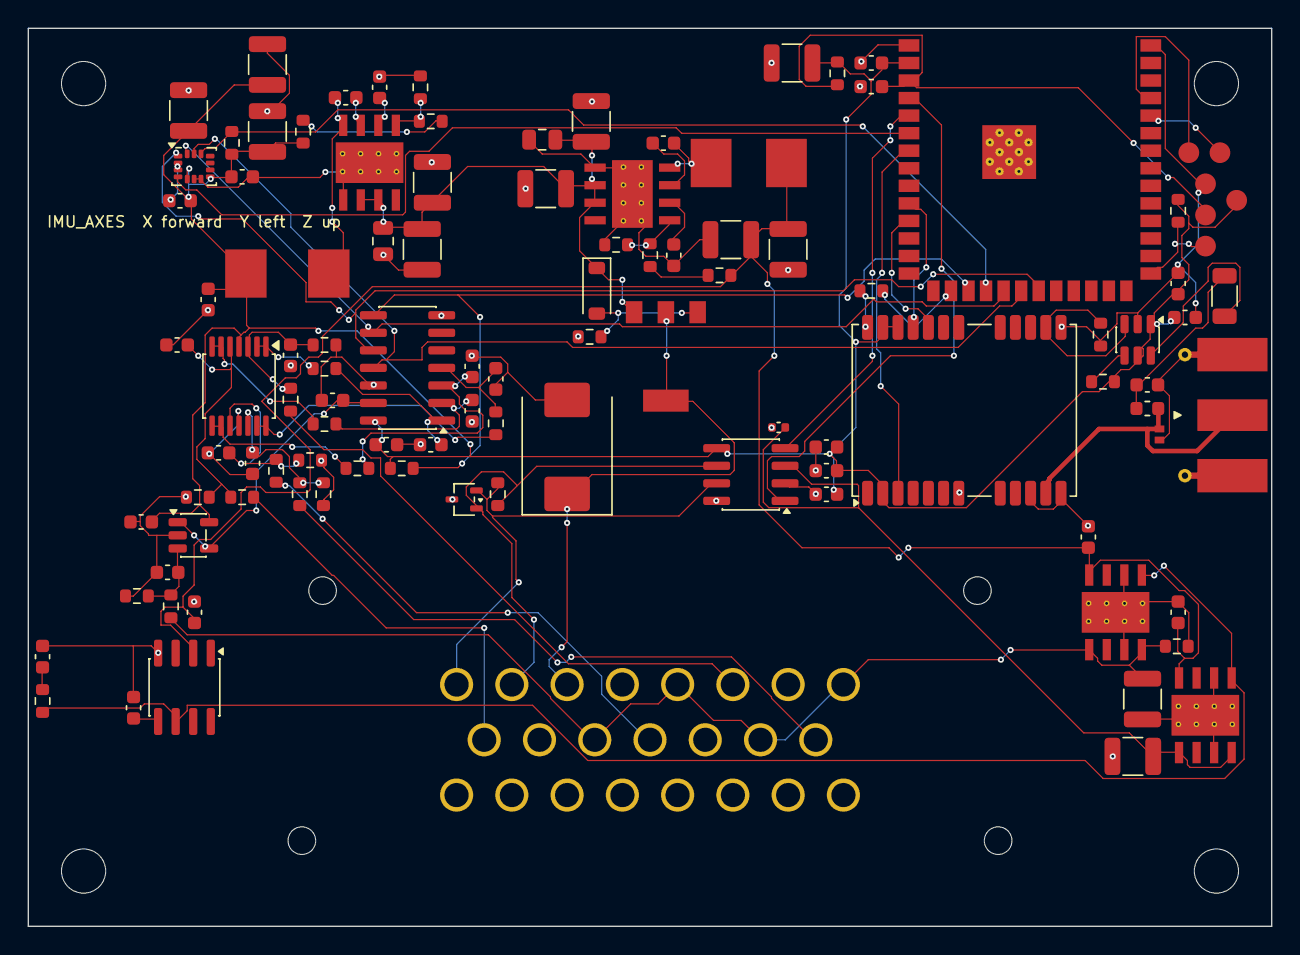
[picture p177: board telemetry-pod.kicad_pcb from above]

Board: 4 copper layers, 90.0 x 65.0 mm, 112 parts (0 on the bottom side), 62 nets.

Other parts of the board:
H1, H2, H3, H4: MountingHole; AgentEE_Mechanical_MountingHole_NPTH
