halbritt/fome-mc/toolchain/fixtures/route_demo/route_demo.kicad_pcb

## KiCad design toolchain/fixtures/route_demo/route_demo.kicad_pcb (2026-10-17)

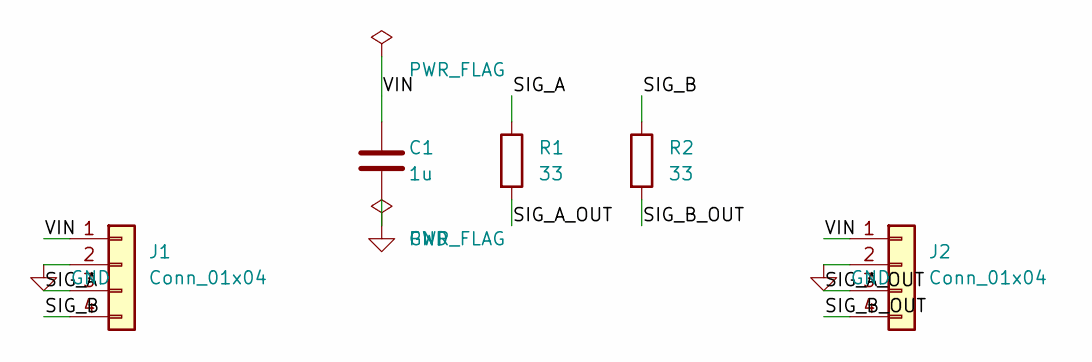
[picture p178: schematic route_demo.kicad_sch, Routing fixture (not ECU design)]

Parts:
C1: 1u; C_0805_2012Metric
J1, J2: Conn_01x04; PinHeader_1x04_P2.54mm_Vertical
R1, R2: 33; R_0805_2012Metric

Connections:
/SIG_A: J1.3, R1.1
/SIG_A_OUT: J2.3, R1.2
/SIG_B: J1.4, R2.1
/SIG_B_OUT: J2.4, R2.2
/VIN: C1.1, J1.1, J2.1
GND: C1.2, J1.2, J2.2

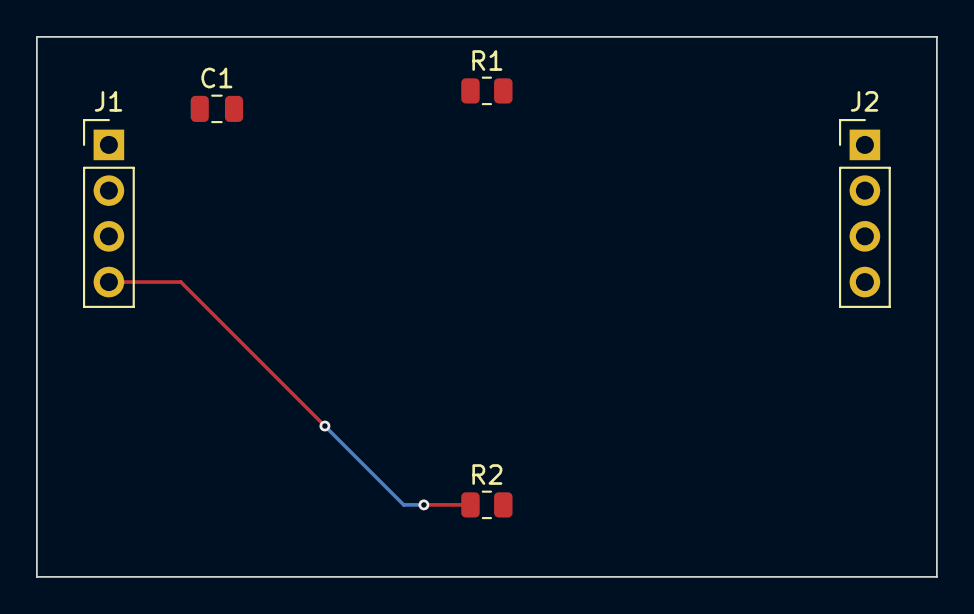
[picture p179: board route_demo.kicad_pcb from above]

Board: 2 copper layers, 50.0 x 30.0 mm, 5 parts (0 on the bottom side), 6 nets.
