halbritt/fome-mc/Atlas-clone.kicad_pcb

## KiCad design Atlas-clone.kicad_pcb (2026-10-16)

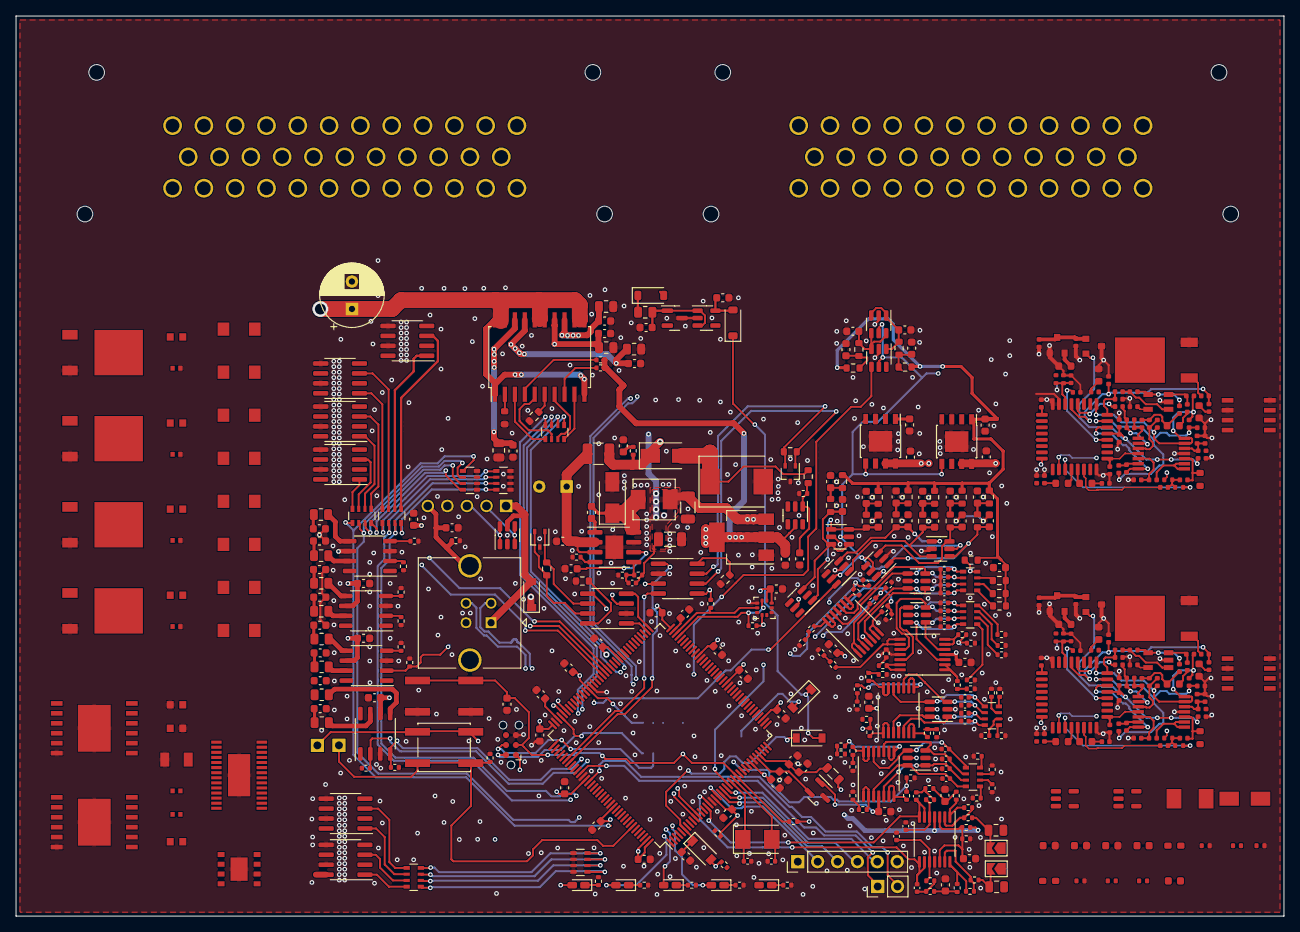
[picture p180: board Atlas-clone.kicad_pcb from above]

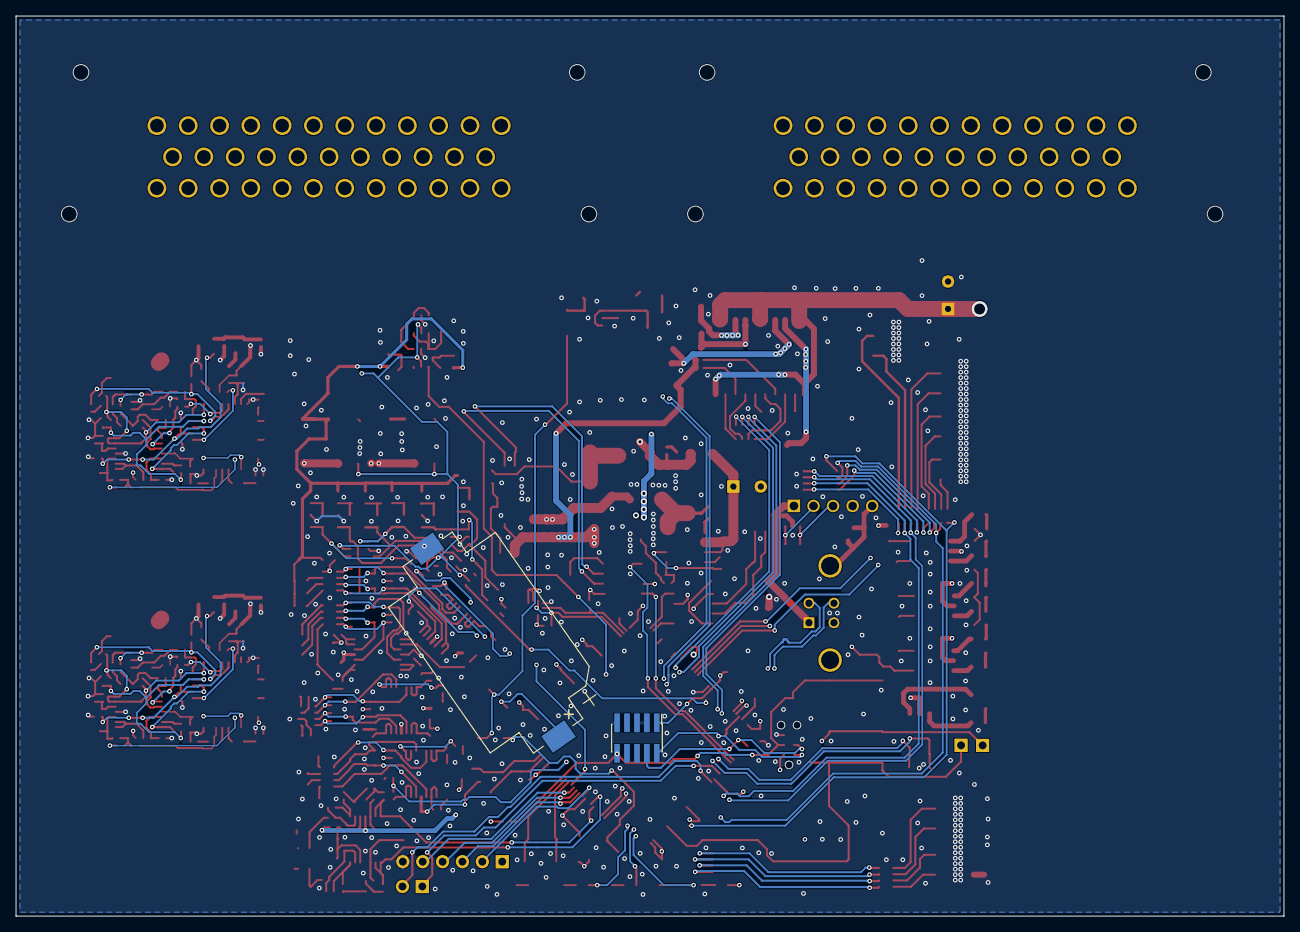
[picture p181: board Atlas-clone.kicad_pcb from below]

Board: 4 copper layers, 162.0 x 115.0 mm, 474 parts (2 on the bottom side), 353 nets.

Parts:
BT1: Battery_Cell; BatteryHolder_Keystone_1060_1x2032
C1, C6: 47u; CP_Elec_8x10.5
C2, C3, C5, C7, C9, C84: 1u; C_0603_1608Metric
C4, C14, C65, C66, C72, C76, C80, C82, C107, C310, C410: 4.7u; C_0603_1608Metric
C8, C15, C85, C86, C87, C88, C93, C94, C95, C96, C99, C100, C101, C102, C201, C202: 10n; C_0603_1608Metric
C10, C40, C41, C46, C51, C56, C61, C62, C63, C64, C67, C68, C69, C70, C71, C73, C79, C81, C83, C89, C91, C92, C97, C98, C103, C104, C105, C106: 100n; C_0603_1608Metric
C11, C20, C21: 330p; C_0402_1005Metric
C12, C13, C1201: 10u; C_1206_3216Metric
C16, C17: 3.3n; C_0805_2012Metric
C18, C19: 680p; C_0603_1608Metric
C22, C23: 47p; C_0402_1005Metric
C24, C25, C26, C27, C28, C29, C30, C31, C32, C33, C34, C35, C36, C37, C38, C39: 1n; C_0603_1608Metric
C42, C43, C44, C45, C47, C48, C49, C50, C52, C53, C54, C55, C57, C58, C59, C60, C302, C305, C308, C309, C311, C312, C313, C314, C316, C402, C405, C408, C409, C411, C412, C413, C414, C416: 100n; C_0402_1005Metric
C74, C75: 33p; C_0402_1005Metric
C77, C78, C90: 2.2u; C_0603_1608Metric
C301, C304, C306, C307, C317, C401, C404, C406, C407, C417: 1u; C_0402_1005Metric
C303, C403: 33n; C_0402_1005Metric
D1: SM15T33CA; D_SMC
D2, D3, D18: D_Schottky; D_SMA
D4, D5: PESD1CAN-UX; SOT-323_SC-70
D6, D7, D8, D14, D16, D17: schottky; D_SOD-123
D9, D12, D302, D402: GREEN; LED_0603_1608Metric
D10, D301, D304, D401, D404: RED; LED_0603_1608Metric
D11, D303, D403: BLUE; LED_0603_1608Metric
D13: ORANGE; LED_0603_1608Metric
D15: SRV05-4; SOT-23-6
D201, D202, D203, D204, D205, D206, D207, D208: B340A-13-F; D_SMA
FB1: Ferrite_Bead; L_0805_2012Metric
IC1: PSM712-LF-T7; SOT-23
J1: TE_776163-1; ampseal-35
J2: TE_776163-2; ampseal-35-2
J8: Conn_02x05_Odd_Even; PinHeader_2x05_P1.27mm_Vertical_SMD
J9: Conn_01x06; Tag-Connect_TC2030-IDC-NL_2x03_P1.27mm_Vertical
J11: Conn_01x06; PinHeader_1x06_P2.54mm_Vertical
J12: Conn_01x02; PinHeader_1x02_P2.54mm_Vertical
J13: USB_B; conn_5_2.5mm
J14: USB_B; USB_B_TE_5787834_Vertical
J15, J16: Conn_01x01; PinHeader_1x01_P2.54mm_Vertical
JP1, JP2: Jumper_NO_Small; SolderJumper-2_P1.3mm_Open_TrianglePad1.0x1.5mm
L1: 2.2u; L_1210_3225Metric
L2, L3: 10u; MWSA0503
Q201, Q202, Q203, Q204: FGD3040G2-F085; TO-252-2
Q301, Q401: VND14NV04; TO-252-2
R1, R3, R4, R47, R48, R49, R50, R59, R60, R61, R62, R71, R72, R73, R74, R83, R84, R85, R86, R89, R90, R97, R99, R100, R117, R118, R119, R121, R123, R205, R206, R207, R208, R209, R210, R303, R304, R311, R312, R321, R329, R333, R334, R403, R404, R411, R412, R421, R429, R433, R434: 10k; R_0402_1005Metric
R2: 1; R_0402_1005Metric
R5, R17, R18: 12k; R_0402_1005Metric
R6, R122, R331, R332, R431, R432: 68k; R_0402_1005Metric
R7, R8: 10; R_0603_1608Metric
R9, R10, R101, R102: 120; R_0603_1608Metric
R11, R12, R21, R22: 33k; R_0402_1005Metric
R13, R14, R19, R20, R98, R315, R317, R320, R415, R417, R420: 100k; R_0402_1005Metric
R15, R16, R51, R52, R53, R54, R63, R64, R65, R66, R75, R76, R77, R78: 470k; R_0402_1005Metric
R23, R24, R25, R26, R27, R28, R29, R30, R31, R32, R33, R34, R35, R36, R37, R38, R39, R40, R41, R42: 2.7k; R_0603_1608Metric
R43, R44, R45, R46, R55, R56, R57, R58, R67, R68, R69, R70, R79, R80, R81, R82: 5.6k; R_0402_1005Metric
R87, R88, R301, R302, R313, R318, R325, R326, R327, R330, R401, R402, R413, R418, R425, R426, R427, R430, R1501, R1502, R1503, R1504, R1601, R1602, R1603, R1604: 1k; R_0402_1005Metric
R91, R92, R93, R94, R95: 330; R_0402_1005Metric
R96, R116, R120: 82k; R_0603_1608Metric
R103, R104, R105, R106, R107: 4.7k; R_0805_2012Metric
R108, R109, R110, R111, R112, R113, R114, R115: 100; R_0805_2012Metric
R201, R202, R203, R204: 15R; R_0603_1608Metric
R212: 2.2k; R_0603_1608Metric
R305, R307, R405, R407: 27k; R_0402_1005Metric
R306, R406: 22k; R_0402_1005Metric
R308, R408: 47; R_0402_1005Metric
R309, R409: 10; R_0402_1005Metric
R310, R410: 61.9; R_0603_1608Metric
R314, R414: 62k; R_0603_1608Metric
R316, R416: 6.8k; R_0402_1005Metric
R319, R419: 47k; R_0402_1005Metric
R324, R424: 3.3k; R_0402_1005Metric
RN1, RN2, RN3, RN4, RN11: 10k; R_Array_Convex_4x0603
RN5, RN6, RN7, RN8, RN9, RN10: 1k; R_Array_Convex_4x0603
SW1, SW2: SW_Push; SW_SPST_EVQQ2
U1, U2: TLS115D0E; Infineon_PG-DSO-8-43
U3: LMR14020; SOIC-8-1EP_3.9x4.9mm_P1.27mm_EP2.29x3mm
U4, U5: MCP2551-I-SN; SOIC-8_3.9x4.9mm_P1.27mm
U6: AMS1117-3.3; SOT-223-3_TabPin2
U7, U15, U17, U19, U21, U301, U401: MCP6004; TSSOP-14_4.4x5mm_P0.65mm
U8, U9, U10, U14: SN74LVC2G17DB; SOT-23-6
U11, U12, U13, U16, U18, U20, U22: SRV05-4; SOT-23-6
U23: REF3333; SOT-23
U24: LPS25HB; ST_HLGA-10_2.5x2.5mm_P0.6mm_LayoutBorder3x2y
U25: XTSD04GLGEAG; LGA-8_6x8mm_P1.25mm
U26: STM32H753ZIT6; LQFP-144_20x20mm_P0.5mm
U27: USBLC6-2SC6; SOT-23-6
U28: S3225SMD32.768KOSC; SOT-23-5
U40: BTS716G; Infineon_PG-DSO-20-32
U41: MIC5205-3.3YM5; SOT-23-5
U42, U43, U44, U45: MIC4427; SO-8_3.9x4.9mm_P1.27mm
U46: LM2733XMFX/NOPB; SOT-23-5
U201, U203: TLE9201SG; Infineon_PG-DSO-12-9
U202: DRV8825PWPR; HTSSOP-28-1EP_4.4x9.7mm_P0.65mm_EP2.85x5.4mm
U302, U402: STM32F042K6Tx; LQFP-32_7x7mm_P0.8mm
U303, U403: REF3033; SOT-23
U305, U405: AD8628; TSOT-23-5
U307, U407: TJA1051T-3; SOIC-8_3.9x4.9mm_P1.27mm
U309, U409: XC6206P332MR; SOT-23
U1001, U1002, U1101, U1102, U1201, U1202: VNLD5090; SOIC-8_3.9x4.9mm_P1.27mm
Y1: 8MHz; Crystal_SMD_5032-2Pin_5.0x3.2mm

Connections:
+3.3V: R210.2, U201.2, U202.12, U202.16, U203.2
+3V3: C14.1, C61.2, C62.2, C63.1, C64.2, C65.2, C66.2, C67.2, C68.2, C69.2, C71.2, C72.2, C73.2, C76.2, D8.2 (A), D9.2 (A), D15.5 (VP), FB1.1, J8.1, J9.1, J11.1, J15.1, R1.2, R4.2, R11.2, R87.1, R88.1, R89.2, R99.2, R100.2, SW2.2, U4.5 (Vref), U5.5 (Vref), U6.2 (VO), U7.4 (V+), U24.1 (VDDio), U24.6 (~CS), U24.10 (VDD), U25.4, U26.17 (VDD), U26.30 (VDD), U26.39 (VDD), U26.52 (VDD), U26.62 (VDD), U26.72 (VDD), U26.84 (VDD), U26.95 (VDDUSB), U26.108 (VDD), U26.121 (VDDSDMMC), U26.131 (VDD), U26.143 (PDR_ON), U26.144 (VDD)
+3V3_WBO1: C305.1, C310.1, C312.1, C313.1, C314.1, R314.1, R318.2, U301.4 (V+), U302.1 (VDD), U302.17 (VDDIO2), U305.5 (V+), U309.2 (VO)
+3V3_WBO2: C405.1, C410.1, C412.1, C413.1, C414.1, R414.1, R418.2, U401.4 (V+), U402.1 (VDD), U402.17 (VDDIO2), U405.5 (V+), U409.2 (VO)
+5V: C11.1, C12.1, C13.1, C40.1, C46.1, C51.1, C56.1, C91.2, C92.2, C97.2, C98.2, C308.1, C317.1, C408.1, C417.1, D14.1 (K), L2.2, R6.2, U1.5 (ADJ), U2.5 (ADJ), U4.3 (VDD), U5.3 (VDD), U6.3 (VI), U8.5 (VCC), U9.5 (VCC), U10.5 (VCC), U11.5 (VP), U12.5 (VP), U13.5 (VP), U14.5 (VCC), U15.4 (V+), U16.5 (VP), U17.4 (V+), U18.5 (VP), U19.4 (V+), U20.5 (VP), U21.4 (V+), U22.5 (VP), U23.1 (IN), U42.6 (V+), U43.6 (V+), U44.6 (V+), U45.6 (V+), U303.1 (IN), U307.3, U309.3 (VI), U403.1 (IN), U407.3, U409.3 (VI)
/5V_SENSOR_1: C3.1, C41.2, J1.29, R23.1, R24.1, R25.1, R26.1, R27.1, R28.1, R35.1, R36.1, R39.1, R40.1, R41.1, R42.1, R118.1, U1.1 (OUT)
/5V_SENSOR_2: C9.1, J1.30, U2.1 (OUT)
/12V_MR: C1.1, C1201.2, D201.1, D202.1, D203.1, D204.1, D205.1, D206.1, D207.1, D208.1, J1.24, J1.27, R116.1, R212.1, R320.1, R420.1, U40.1 (VBB), U40.10 (VBB), U40.11 (VBB), U40.12 (VBB), U40.15 (VBB), U40.16 (VBB), U40.19 (VBB), U40.20 (VBB), U201.4, U202.11, U203.4
/12V_PROT: C2.1, C5.1, D2.1 (K), L1.1, R2.1, U1.7 (EN), U1.8 (IN), U2.7 (EN), U2.8 (IN)
/12V_RAW: D1.1 (A1), D2.2 (A), J1.26, R96.1
/AT1: J2.1, R39.2, RN1.1 (R1.1)
/AT2: J2.2, R40.2, RN1.2 (R2.1)
/AT3: R41.2, RN1.3 (R3.1)
/AT4: R42.2, RN1.4 (R4.1)
/AV1: J2.5, R51.1, RN2.1 (R1.1)
/AV2: J2.3, R52.1, RN2.2 (R2.1)
/AV3: J2.6, R53.1, RN2.3 (R3.1)
/AV4: J2.4, R54.1, RN2.4 (R4.1)
/AV5: J2.7, R63.1, RN3.1 (R1.1)
/AV6: J2.8, R64.1, RN3.2 (R2.1)
/AV7: R65.1, RN3.3 (R3.1)
/AV8: R66.1, RN3.4 (R4.1)
/AV9: R75.1, RN4.1 (R1.1)
/AV10: R76.1, RN4.2 (R2.1)
/AV11: R77.1, RN4.3 (R3.1)
/BOOT0_NET: J16.1, R90.1, R209.2, SW2.1, U26.138 (BOOT0)
/CAN2+: D5.2 (A2), R10.1, U5.7 (CANH), U307.7, U407.7
/CAN2-: D5.1 (A1), R10.2, U5.6 (CANL), U307.6, U407.6
/CAN+: D4.2 (A2), J2.28, R9.1, U4.7 (CANH)
/CAN-: D4.1 (A1), J2.29, R9.2, U4.6 (CANL)
/DIGITAL_1: C24.1, J2.16, R23.2, R29.2
/DIGITAL_2: C25.1, J2.15, R24.2, R30.2
/DIGITAL_3: C26.1, J2.18, R25.2, R31.2
/DIGITAL_4: C27.1, J2.17, R26.2, R32.2
/DIGITAL_5: C28.1, R27.2, R33.2
/DIGITAL_6: C29.1, R28.2, R34.2
/ETB1_DIR: U26.79 (PD10), U201.1
/ETB1_DIS: R210.1, U26.80 (PD11), U201.11
/ETB1_OUT+: C201.2, J1.15, U201.5
/ETB1_OUT-: C202.1, J1.16, U201.7
/ETB1_PWM: U26.81 (PD12), U201.12
/ETB2_DIR: U26.78 (PD9), U203.1
/ETB2_DIS: U26.77 (PD8), U203.11
/ETB2_OUT+: J1.17, U203.5
/ETB2_OUT-: J1.18, U203.7
/ETB2_PWM: U26.82 (PD13), U203.12
/HS1: C85.1, J1.14, R103.1, U40.18 (OUT1)
/HS2: C86.1, R104.1, U40.17 (OUT2)
/HS3: C87.1, R105.1, U40.14 (OUT3)
/HS4: C88.1, R106.1, U40.13 (OUT4)
/IGN1: C93.1, R108.1, R201.1
/IGN1_COIL: J1.6, Q201.2
/IGN2: C94.1, R109.1, R202.1
/IGN2_COIL: J1.7, Q202.2
/IGN3: C95.1, R110.1, R203.1
/IGN3_COIL: J1.8, Q203.2
/IGN4: C96.1, R111.1, R204.1
/IGN4_COIL: J1.9, Q204.2
/IGN5: C99.1, J2.23, R112.1
/IGN6: C100.1, J2.24, R113.1
/IGN7: C101.1, J2.25, R114.1
/IGN8: C102.1, J2.26, R115.1
/IGN10: J12.2, U26.122 (PD6)
/IGN11: J12.1, U26.119 (PD5)
/KNOCK_1: C16.2, J2.9, JP1.1
/KNOCK_2: C17.2, J2.10, JP2.1
/Keep_Alive/Keep_Alive: D6.1 (K), D7.2 (A), D17.1 (K)
/LS1: D201.2, J1.1, U1001.6 (D2)
/LS2: D202.2, J1.2, U1001.8 (D1)
/LS3: D203.2, J1.3, U1002.6 (D2)
/LS4: D204.2, J1.4, U1002.8 (D1)
/LS5: D205.2, J1.10, U1101.6 (D2)
/LS6: D206.2, J1.11, U1101.8 (D1)
/LS7: D207.2, J1.12, U1102.6 (D2)
/LS8: D208.2, J1.13, U1102.8 (D1)
/LS9: U26.134 (PB4), U202.22
/LS12: U26.137 (PB7), U202.20
/LS14: J2.27, R212.2, U1201.8 (D1)
/PB8_STEP_EN: RN9.8 (R1.2), RN10.4 (R4.1), U26.139 (PB8), U202.21
/Perm_Live: D16.2 (A), J1.28
/RC2: J1.35, R209.1, U26.101 (PA9)
/STEP_1A: J1.19, U202.4
/STEP_1B: J1.20, U202.6
/STEP_2A: J1.21, U202.9
/STEP_2B: J1.22, U202.7
/USB_D+: J2.34, J13.3, J14.3, U26.104 (PA12), U27.1 (I/O1), U27.6 (I/O1)
/USB_D-: J2.35, J13.2, J14.2, U26.103 (PA11), U27.3 (I/O2), U27.4 (I/O2)
/USB_SHIELD: C83.1, J13.5, J14.5, R98.1
/VBOOST: C6.1, C7.1, L1.2, R120.1, U3.2 (VIN), U3.3 (EN)
/VR1+: C37.1, J2.11, R36.2, R38.2
/VR2+: C36.1, J2.13, R35.2, R37.2
/WBO1_BOOT0: R329.2, U26.2 (PE3), U302.31 (PB8)
/WBO1_H-: J1.23, Q301.2 (D)
/WBO1_IP: J2.20, R310.2, R312.2
/WBO1_NRST: C316.1, U26.1 (PE2), U302.4 (NRST)
/WBO1_RTRIM: J2.21, R308.1, R310.1, R311.2, R334.1
/WBO1_UN: C302.1, J2.22, R314.2, U301.10 (+)
/WBO1_VM: C304.1, J2.19, R303.1, R309.1, U302.7 (PA1)
/WBO2_BOOT0: R429.2, U26.4 (PE5), U402.31 (PB8)
/WBO2_H-: J1.25, Q401.2 (D)
/WBO2_IP: J2.31, R410.2, R412.2
/WBO2_NRST: C416.1, U26.3 (PE4), U402.4 (NRST)
/WBO2_RTRIM: J2.32, R408.1, R410.1, R411.2, R434.1
/WBO2_UN: C402.1, J2.33, R414.2, U401.10 (+)
/WBO2_VM: C404.1, J2.30, R403.1, R409.1, U402.7 (PA1)
/highside_quad/IN1: RN11.4 (R4.1), U26.89 (PG4)
/highside_quad/IN2: RN11.3 (R3.1), U26.88 (PG3)
/highside_quad/IN3: RN11.2 (R2.1), U26.87 (PG2)
/highside_quad/IN4: RN11.1 (R1.1), U26.86 (PD15)
/ign1/IN1: R1501.2, U26.133 (PB3), U42.2 (IN_A)
/ign1/IN2: R1502.2, U26.132 (PG15), U42.4 (IN_B)
/ign1/IN3: R1503.2, U26.129 (PG14), U43.2 (IN_A)
/ign1/IN4: R1504.2, U26.128 (PG13), U43.4 (IN_B)
/ign2/IN1: R1601.2, U26.127 (PG12), U44.2 (IN_A)
/ign2/IN2: R1602.2, U26.126 (PG11), U44.4 (IN_B)
/ign2/IN3: R1603.2, U26.125 (PG10), U45.2 (IN_A)
/ign2/IN4: R1604.2, U26.124 (PG9), U45.4 (IN_B)
/knock/FILTERED_1: C20.2, U7.6 (-), U7.7, U26.14 (PF4)
/knock/FILTERED_2: C21.2, U7.8, U7.9 (-), U26.15 (PF5)
/knock/V_mid: C15.2, R11.1, R12.1, U7.3 (+), U7.12 (+)
/lowside_quad1/IN1: RN5.8 (R1.2), RN6.4 (R4.1), U26.90 (PG5)
/lowside_quad1/IN2: RN5.7 (R2.2), RN6.3 (R3.1), U26.91 (PG6)
/lowside_quad1/IN3: RN5.6 (R3.2), RN6.2 (R2.1), U26.92 (PG7)
/lowside_quad1/IN4: RN5.5 (R4.2), RN6.1 (R1.1), U26.93 (PG8)
/lowside_quad2/IN1: RN7.8 (R1.2), RN8.4 (R4.1), U26.96 (PC6)
/lowside_quad2/IN2: RN7.7 (R2.2), RN8.3 (R3.1), U26.97 (PC7)
/lowside_quad2/IN3: RN7.6 (R3.2), RN8.2 (R2.1), U26.110 (PA15)
/lowside_quad2/IN4: RN7.5 (R4.2), RN8.1 (R1.1), U26.117 (PD3)
/lowside_quad4/IN2: RN9.7 (R2.2), RN10.3 (R3.1), U26.140 (PB9)
/lowside_quad4/IN3: RN9.6 (R3.2), RN10.2 (R2.1), U26.141 (PE0)
/lowside_quad4/IN4: RN9.5 (R4.2), RN10.1 (R1.1), U26.142 (PE1)
/mcu/5V_SENSE_DIVIDED: C104.1, R118.2, R119.1, U26.50 (PF12)
/mcu/5V_SENSOR_1_PG: R1.1, U1.4 (PG), U26.55 (PF15)
/mcu/5V_SENSOR_2_PG: R4.1, U2.4 (PG), U26.54 (PF14)
/mcu/12V_DIVIDED: C84.1, D15.1 (IO1), R96.2, R97.1, U26.45 (PC5)
/mcu/AT1: R43.1, R47.2, U26.27 (PC1)
/mcu/AT2: R44.1, R48.2, U26.28 (PC2)
/mcu/AT3: R45.1, R49.2, U26.29 (PC3)
/mcu/AT4: R46.1, R50.2, U26.44 (PC4)
/mcu/AUX_SPI_CS: J11.2, U26.18 (PF6)
/mcu/AUX_SPI_MISO: J11.4, U26.20 (PF8)
/mcu/AUX_SPI_MOSI: J11.5, U26.21 (PF9)
/mcu/AUX_SPI_SCK: J11.3, U26.19 (PF7)
/mcu/AV1: R55.1, R59.2, U26.34 (PA0)
/mcu/AV2: R56.1, R60.2, U26.35 (PA1)
/mcu/AV3: R57.1, R61.2, U26.36 (PA2)
/mcu/AV4: R58.1, R62.2, U26.37 (PA3)
/mcu/AV5: R67.1, R71.2, U26.40 (PA4)
/mcu/AV6: R68.1, R72.2, U26.41 (PA5)
/mcu/AV7: R69.1, R73.2, U26.42 (PA6)
/mcu/AV8: R70.1, R74.2, U26.43 (PA7)
/mcu/AV9: R79.1, R83.2, U26.46 (PB0)
/mcu/AV10: R80.1, R84.2, U26.47 (PB1)
/mcu/AV11: R81.1, R85.2, U26.26 (PC0)
/mcu/BARO_SCL: R88.2, U24.2 (SCL/SCLK), U26.69 (PB10)
/mcu/BARO_SDA: R87.2, U24.4 (SDA/MOSI), U26.70 (PB11)
/mcu/CAN2_RX: U5.4 (RXD), U26.73 (PB12)
/mcu/CAN2_TX: U5.1 (TXD), U26.74 (PB13)
/mcu/CAN_RX: U4.4 (RXD), U26.114 (PD0)
/mcu/CAN_TX: U4.1 (TXD), U26.115 (PD1)
/mcu/DIGITAL1: U10.6, U26.56 (PG0)
/mcu/DIGITAL2: U8.6, U26.57 (PG1)
/mcu/DIGITAL3: U8.4, U26.63 (PE10)
/mcu/DIGITAL4: U9.6, U26.64 (PE11)
/mcu/DIGITAL5: U10.4, U26.65 (PE12)
/mcu/DIGITAL6: U9.4, U26.66 (PE13)
/mcu/LED1: D10.2 (A), U26.10 (PF0)
/mcu/LED2: D11.2 (A), U26.12 (PF2)
/mcu/LED3: D12.2 (A), U26.85 (PD14)
/mcu/LED4: D13.2 (A), U26.11 (PF1)
/mcu/MR_DIVIDED: C103.1, R116.2, R117.1, U26.49 (PF11)
/mcu/SD_CLK: U25.5, U26.113 (PC12)
/mcu/SD_CMD: U25.3, U26.116 (PD2)
/mcu/SD_D0: U25.7, U26.98 (PC8)
/mcu/SD_D1: U25.8, U26.99 (PC9)
/mcu/SD_D2: U25.1, U26.111 (PC10)
/mcu/SD_D3: U25.2, U26.112 (PC11)
/mcu/SWCLK: J8.4, J9.4, U26.109 (PA14)
/mcu/SWDIO: J8.2, J9.2, U26.105 (PA13)
/mcu/VBOOST_DIVIDED: C105.1, R120.2, R121.1, U26.53 (PF13)
/mcu/VDDA: C81.1, C82.1, FB1.2, U26.33 (VDDA)
/mcu/VR_1: U14.6, U26.67 (PE14)
/mcu/VR_2: U14.4, U26.68 (PE15)
/mcu/nRESET: C79.2, J8.10, J9.3, R89.1, SW1.1, U26.25 (NRST)
/quad_analog3/IN4: R78.1, RN4.4 (R4.1)
/quad_analog3/OUT4: R82.1, R86.2
/wbo1/CAN_RX: U302.21 (PA11), U307.4
/wbo1/CAN_TX: U302.22 (PA12), U307.1
/wbo1/Ip_dac: R331.1, U302.12 (PA6)
/wbo1/Ip_sense: C311.1, R324.2, U302.8 (PA2)
/wbo1/LED_BLUE: D303.2 (A), U302.28 (PB5)
/wbo1/LED_GREEN: D302.2 (A), U302.29 (PB6)
/wbo1/LSU_Un_sense: R304.1, U301.8, U301.9 (-)
/wbo1/Nernst_esr_drive_42: R316.2, U302.26 (PB3)
/wbo1/Nernst_esr_drive_49: R306.2, U302.30 (PB7)
/wbo1/Nernst_esr_drive_adv: R319.2, U302.27 (PB4)
/wbo1/Un_sense: R307.2, U301.7, U302.6 (PA0)
/wbo1/Vm: R309.2, R315.2, R332.2, U301.13 (-), U301.14, U302.9 (PA3)
/wbo1/heater_pwm: R325.2, R326.2, R327.2, U302.13 (PA7)
/wbo2/+3V3: U402.18 (PA8), U407.5
/wbo2/CAN_RX: U402.21 (PA11), U407.4
/wbo2/CAN_TX: U402.22 (PA12), U407.1
/wbo2/Ip_dac: R431.1, U402.12 (PA6)
/wbo2/Ip_sense: C411.1, R424.2, U402.8 (PA2)
/wbo2/LED_BLUE: D403.2 (A), U402.28 (PB5)
/wbo2/LED_GREEN: D402.2 (A), U402.29 (PB6)
/wbo2/LSU_Un_sense: R404.1, U401.8, U401.9 (-)
/wbo2/Nernst_esr_drive_42: R416.2, U402.26 (PB3)
/wbo2/Nernst_esr_drive_49: R406.2, U402.30 (PB7)
/wbo2/Nernst_esr_drive_adv: R419.2, U402.27 (PB4)
/wbo2/Un_sense: R407.2, U401.7, U402.6 (PA0)
/wbo2/Vm: R409.2, R415.2, R432.2, U401.13 (-), U401.14, U402.9 (PA3)
/wbo2/heater_pwm: R425.2, R426.2, R427.2, U402.13 (PA7)
GND: BT1.2 (-), C1.2, C2.2, C3.2, C4.2, C5.2, C6.2, C7.2, C8.2, C9.2, C12.2, C13.2, C14.2, C15.1, C18.1, C19.1, C22.1, C23.1, C24.2, C25.2, C26.2, C27.2, C28.2, C29.2, C30.2, C31.2, C32.2, C33.2, C34.2, C35.2, C36.2, C37.2, C38.2, C39.2, C40.2, C41.1, C42.2, C43.2, C44.2, C45.2, C46.2, C47.2, C48.2, C49.2, C50.2, C51.2, C52.2, C53.2, C54.2, C55.2, C56.2, C57.2, C58.2, C59.2, C60.2, C61.1, C62.1, C63.2, C64.1, C65.1, C66.1, C67.1, C68.1, C69.1, C70.2, C71.1, C72.1, C73.1, C74.2, C75.2, C76.1, C77.2, C78.2, C79.1, C80.2, C81.2, C82.2, C83.2, C84.2, C85.2, C86.2, C87.2, C88.2, C89.2, C90.1, C91.1, C92.1, C93.2, C94.2, C95.2, C96.2, C97.1, C98.1, C99.2, C100.2, C101.2, C102.2, C103.2, C104.2, C105.2, C201.1, C202.2, C301.2, C304.2, C305.2, C306.2, C307.2, C308.2, C309.2, C310.2, C311.2, C312.2, C313.2, C314.2, C316.2, C317.2, C401.2, C404.2, C405.2, C406.2, C407.2, C408.2, C409.2, C410.2, C411.2, C412.2, C413.2, C414.2, C416.2, C417.2, C1201.1, D1.2 (A2), D3.2 (A), D4.3 (common), D5.3 (common), D15.2 (VN), D301.1 (K), D304.1 (K), D401.1 (K), D404.1 (K), IC1.3 (GND), J1.5, J1.31, J1.32, J1.33, J1.34, J2.12, J2.14, J8.3, J8.5, J8.9, J9.5, J11.6, J13.4, J14.4, Q201.3, Q202.3, Q203.3, Q204.3, Q301.3 (S), Q401.3 (S), R3.2, R5.2, R7.1, R8.1, R12.2, R47.1, R48.1, R49.1, R50.1, R51.2, R52.2, R53.2, R54.2, R59.1, R60.1, R61.1, R62.1, R63.2, R64.2, R65.2, R66.2, R71.1, R72.1, R73.1, R74.1, R75.2, R76.2, R77.2, R78.2, R83.1, R84.1, R85.1, R86.1, R90.2, R91.1, R92.1, R93.1, R94.1, R95.1, R97.2, R98.2, R101.2, R102.2, R103.2, R104.2, R105.2, R106.2, R117.2, R119.2, R121.2, R205.2, R206.2, R207.2, R208.2, R302.2, R305.2, R313.1, R321.2, R326.1, R329.1, R330.1, R402.2, R405.2, R413.1, R421.2, R426.1, R429.1, R430.1, R1501.1, R1502.1, R1503.1, R1504.1, R1601.1, R1602.1, R1603.1, R1604.1, RN5.1 (R1.1), RN5.2 (R2.1), RN5.3 (R3.1), RN5.4 (R4.1), RN7.1 (R1.1), RN7.2 (R2.1), RN7.3 (R3.1), RN7.4 (R4.1), RN9.1 (R1.1), RN9.2 (R2.1), RN9.3 (R3.1), RN9.4 (R4.1), SW1.2, U1.3 (GND), U1.9 (GND), U2.3 (GND), U2.9 (GND), U3.7 (GND), U3.9 (GND), U4.2 (VSS), U5.2 (VSS), U6.1 (GND), U7.11 (V-), U8.2 (GND), U9.2 (GND), U10.2 (GND), U11.2 (VN), U12.2 (VN), U13.2 (VN), U14.2 (GND), U15.11 (V-), U16.2 (VN), U17.11 (V-), U18.2 (VN), U19.11 (V-), U20.2 (VN), U21.11 (V-), U22.2 (VN), U23.3 (GND), U24.3 (GND), U24.5 (SA0/MISO), U24.8 (GND), U24.9 (GND), U25.6, U25.9, U26.16 (VSS), U26.31 (VSSA), U26.38 (VSS), U26.48 (PB2), U26.51 (VSS), U26.61 (VSS), U26.83 (VSS), U26.94 (VSS), U26.107 (VSS), U26.120 (VSS), U26.130 (VSS), U27.2 (GND), U41.2 (GND), U42.3 (GND), U43.3 (GND), U44.3 (GND), U45.3 (GND), U201.6, U201.13, U202.29, U203.6, U203.13, U301.11 (V-), U302.15 (PB1), U302.16 (VSS), U302.32 (VSSA), U303.3 (GND), U305.2 (V-), U307.2, U307.8, U309.1 (GND), U401.11 (V-), U402.16 (VSS), U402.32 (VSSA), U403.3 (GND), U405.2 (V-), U407.2, U407.8, U409.1 (GND), U1001.5 (S2), U1001.7 (S1), U1002.5 (S2), U1002.7 (S1), U1101.5 (S2), U1101.7 (S1), U1102.5 (S2), U1102.7 (S1), U1201.5 (S2), U1201.7 (S1), U1202.5 (S2), U1202.7 (S1)
unnamed: BT1.1 (+), D6.2 (A)
unnamed: C4.1, R2.2
unnamed: C16.1, JP1.2, R13.2
unnamed: C17.1, JP2.2, R14.2
unnamed: C18.2, R17.1, R19.2
unnamed: C19.2, R18.1, R20.2
unnamed: C20.1, R19.1, R21.2
unnamed: C21.1, R20.1, R22.2
unnamed: C302.2, R306.1, R316.1, R319.1
unnamed: C303.1, R308.2, R333.1, U301.1
unnamed: C402.2, R406.1, R416.1, R419.1
unnamed: C403.1, R408.2, R433.1, U401.1
unnamed: C10.2, D3.1 (K), L2.1, U3.8 (SW)
unnamed: C80.1, D7.1 (K), D8.1 (K), U26.6 (VBAT)
unnamed: D9.1 (K), R91.2
unnamed: D10.1 (K), R92.2
unnamed: D11.1 (K), R93.2
unnamed: D12.1 (K), R94.2
unnamed: D13.1 (K), R95.2
unnamed: D14.2 (A), J13.1, J14.1, U27.5 (VBUS)
unnamed: D16.1 (K), R107.1
unnamed: C90.2, D17.2 (A), U41.5 (OUT)
unnamed: D18.2 (A), L3.2
unnamed: D301.2 (A), R327.1
unnamed: D302.1 (K), R330.2
unnamed: D303.1 (K), R313.2
unnamed: D304.2 (A), R318.1
unnamed: D401.2 (A), R427.1
unnamed: D402.1 (K), R430.2
unnamed: D403.1 (K), R413.2
unnamed: D404.2 (A), R418.1
unnamed: C89.1, IC1.1 (I/O_1), R107.2, U41.1 (IN), U41.3 (EN)
unnamed: Q201.1, R201.2, R205.1
unnamed: Q202.1, R202.2, R206.1
unnamed: Q203.1, R203.2, R207.1
unnamed: Q204.1, R204.2, R208.1
unnamed: Q301.1 (G), R325.1
unnamed: Q401.1 (G), R425.1
unnamed: R15.1, R17.2, U7.1
unnamed: R16.1, R18.2, U7.14
unnamed: R317.1, R324.1, U305.1
unnamed: R417.1, R424.1, U405.1
unnamed: C42.1, RN1.8 (R1.2), U15.3 (+), U16.6 (IO4)
unnamed: C43.1, RN1.7 (R2.2), U15.5 (+), U16.1 (IO1)
unnamed: C44.1, RN1.6 (R3.2), U15.10 (+), U16.3 (IO2)
unnamed: C45.1, RN1.5 (R4.2), U15.12 (+), U16.4 (IO3)
unnamed: C47.1, RN2.8 (R1.2), U17.3 (+), U18.6 (IO4)
unnamed: C48.1, RN2.7 (R2.2), U17.5 (+), U18.1 (IO1)
unnamed: C49.1, RN2.6 (R3.2), U17.10 (+), U18.3 (IO2)
unnamed: C50.1, RN2.5 (R4.2), U17.12 (+), U18.4 (IO3)
unnamed: C52.1, RN3.8 (R1.2), U19.3 (+), U20.6 (IO4)
unnamed: C53.1, RN3.7 (R2.2), U19.5 (+), U20.1 (IO1)
unnamed: C54.1, RN3.6 (R3.2), U19.10 (+), U20.3 (IO2)
unnamed: C55.1, RN3.5 (R4.2), U19.12 (+), U20.4 (IO3)
unnamed: C57.1, RN4.8 (R1.2), U21.3 (+), U22.6 (IO4)
unnamed: C58.1, RN4.7 (R2.2), U21.5 (+), U22.1 (IO1)
unnamed: C59.1, RN4.6 (R3.2), U21.10 (+), U22.3 (IO2)
unnamed: C60.1, RN4.5 (R4.2), U21.12 (+), U22.4 (IO3)
unnamed: RN6.8 (R1.2), U1002.1 (IN1)
unnamed: RN6.7 (R2.2), U1002.3 (IN2)
unnamed: RN6.6 (R3.2), U1001.1 (IN1)
unnamed: RN6.5 (R4.2), U1001.3 (IN2)
unnamed: RN8.8 (R1.2), U1102.1 (IN1)
unnamed: RN8.7 (R2.2), U1102.3 (IN2)
unnamed: RN8.6 (R3.2), U1101.1 (IN1)
unnamed: RN8.5 (R4.2), U1101.3 (IN2)
unnamed: RN10.8 (R1.2), U1202.1 (IN1)
unnamed: RN10.7 (R2.2), U1202.3 (IN2)
unnamed: RN10.6 (R3.2), U1201.1 (IN1)
unnamed: RN10.5 (R4.2), U1201.3 (IN2)
unnamed: RN11.8 (R1.2), U40.9 (IN4)
unnamed: RN11.7 (R2.2), U40.7 (IN3)
unnamed: RN11.6 (R3.2), U40.5 (IN2)
unnamed: RN11.5 (R4.2), U40.3 (IN1)
unnamed: C10.1, U3.1 (BOOT)
unnamed: C11.2, R5.1, R6.1, U3.5 (FB)
unnamed: R3.1, U3.4 (RT)
unnamed: C8.1, U3.6 (SS)
unnamed: R7.2, U4.8 (Rs)
unnamed: R8.2, U5.8 (Rs)
unnamed: R13.1, R15.2, U7.2 (-)
unnamed: C22.2, R21.1, U7.5 (+)
unnamed: C23.2, R22.1, U7.10 (+)
unnamed: R14.1, R16.2, U7.13 (-)
unnamed: C33.1, R32.1, U9.1, U11.1 (IO1), U11.6 (IO4)
unnamed: C35.1, R34.1, U9.3, U11.3 (IO2), U11.4 (IO3)
unnamed: C34.1, R33.1, U10.3, U12.1 (IO1)
unnamed: C30.1, R29.1, U10.1, U12.3 (IO2)
unnamed: C31.1, R30.1, U8.1, U12.4 (IO3)
unnamed: C32.1, R31.1, U8.3, U12.6 (IO4)
unnamed: C39.1, R38.1, U13.1 (IO1), U13.3 (IO2), U14.1
unnamed: C38.1, R37.1, U13.4 (IO3), U13.6 (IO4), U14.3
unnamed: R43.2, U15.1, U15.2 (-)
unnamed: R44.2, U15.6 (-), U15.7
unnamed: R45.2, U15.8, U15.9 (-)
unnamed: R46.2, U15.13 (-), U15.14
unnamed: R55.2, U17.1, U17.2 (-)
unnamed: R56.2, U17.6 (-), U17.7
unnamed: R57.2, U17.8, U17.9 (-)
unnamed: R58.2, U17.13 (-), U17.14
unnamed: R67.2, U19.1, U19.2 (-)
unnamed: R68.2, U19.6 (-), U19.7
unnamed: R69.2, U19.8, U19.9 (-)
unnamed: R70.2, U19.13 (-), U19.14
unnamed: R79.2, U21.1, U21.2 (-)
unnamed: R80.2, U21.6 (-), U21.7
unnamed: R81.2, U21.8, U21.9 (-)
unnamed: R82.2, U21.13 (-), U21.14
unnamed: C70.1, U23.2 (OUT), U26.32 (VREF+)
unnamed: C74.1, U26.23 (PH0), Y1.1
unnamed: C75.1, U26.24 (PH1), Y1.2
unnamed: C77.1, U26.71 (VCAP_1)
unnamed: C78.1, U26.106 (VCAP_2)
unnamed: C106.1, U28.2 (GND)
unnamed: R101.1, U40.2 (GND1/2)
unnamed: R102.1, U40.6 (GND3/4)
unnamed: R99.1, U40.4 (ST1/2)
unnamed: R100.1, U40.8 (ST3/4)
unnamed: R108.2, U42.7 (OUT_A)
unnamed: R109.2, U42.5 (OUT_B)
unnamed: R110.2, U43.7 (OUT_A)
unnamed: R111.2, U43.5 (OUT_B)
unnamed: R112.2, U44.7 (OUT_A)
unnamed: R113.2, U44.5 (OUT_B)
unnamed: R114.2, U45.7 (OUT_A)
unnamed: R115.2, U45.5 (OUT_B)
unnamed: C107.2, U46.1 (IN)
unnamed: R122.1, U46.5 (OUT)
unnamed: C301.1, R301.2, R302.1, R304.2, R305.1, R332.1, R334.2, U301.3 (+), U301.5 (+), U301.12 (+)
unnamed: C303.2, R303.2, R307.1, R331.2, R333.2, U301.2 (-), U301.6 (-)
unnamed: C306.1, R320.2, R321.1, U302.14 (PB0)
unnamed: R312.1, R315.1, U305.3 (+)
unnamed: R311.1, R317.2, U305.4 (-)
unnamed: C401.1, R401.2, R402.1, R404.2, R405.1, R432.1, R434.2, U401.3 (+), U401.5 (+), U401.12 (+)
unnamed: C403.2, R403.2, R407.1, R431.2, R433.2, U401.2 (-), U401.6 (-)
unnamed: C406.1, R420.2, R421.1, U402.14 (PB0)
unnamed: R412.1, R415.1, U405.3 (+)
unnamed: R411.1, R417.2, U405.4 (-)
VDDA: C307.1, C309.1, C407.1, C409.1, R301.1, R401.1, U302.5 (VDDA), U303.2 (OUT), U402.5 (VDDA), U403.2 (OUT)
