halbritt/fome-mc/toolchain/fixtures/rc_filter/rc_filter.kicad_pcb

## KiCad design toolchain/fixtures/rc_filter/rc_filter.kicad_pcb (2026-10-16)

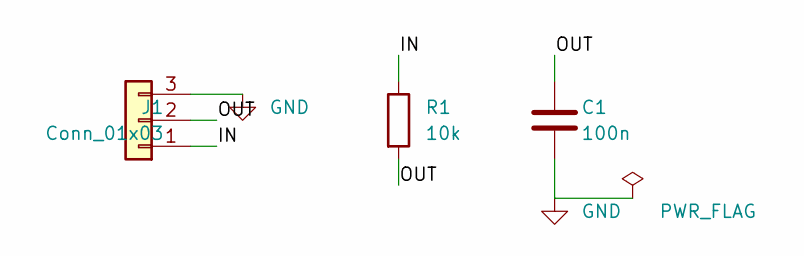
[picture p182: schematic rc_filter.kicad_sch, Toolchain fixture: RC low-pass (not ECU design)]

Parts:
C1: 100n; C_0805_2012Metric
J1: Conn_01x03; PinHeader_1x03_P2.54mm_Vertical
R1: 10k; R_0805_2012Metric

Connections:
/IN: J1.1, R1.1
/OUT: C1.1, J1.2, R1.2
GND: C1.2, J1.3

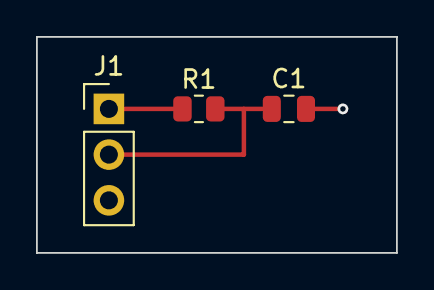
[picture p183: board rc_filter.kicad_pcb from above]

Board: 2 copper layers, 20.0 x 12.0 mm, 3 parts (0 on the bottom side), 3 nets.
