halbritt/fome-mc/telemetry-pod/expansion/agentee-477-3d-models/candidate/telemetry-pod.route4-models.kicad_pcb

## KiCad design telemetry-pod/expansion/agentee-477-3d-models/candidate/telemetry-pod.route4-models.kicad_pcb (2026-10-23)

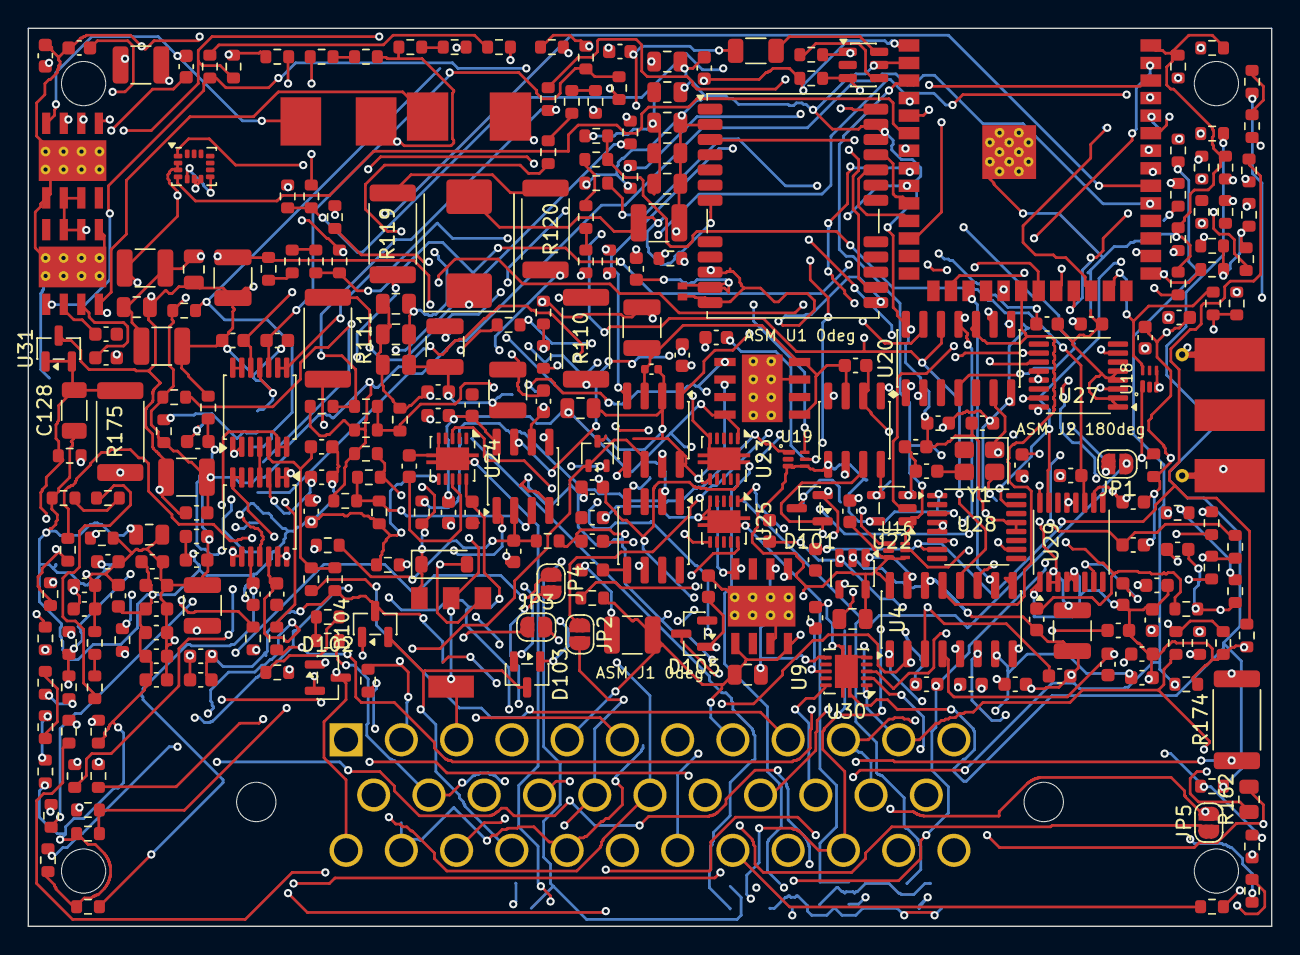
[picture p184: board telemetry-pod.route4-models.kicad_pcb from above]

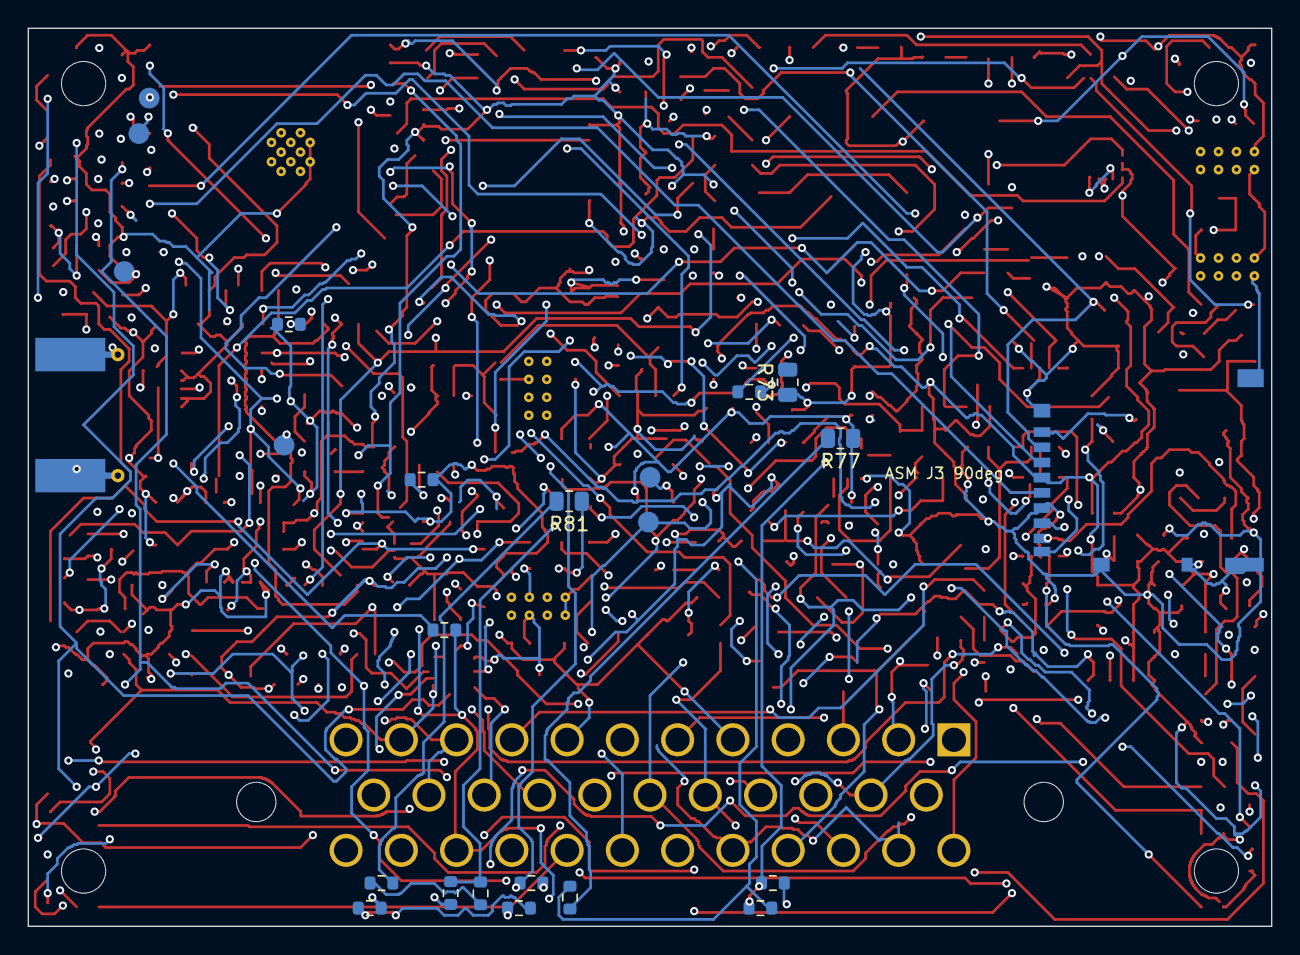
[picture p185: board telemetry-pod.route4-models.kicad_pcb from below]

Board: 4 copper layers, 90.0 x 65.0 mm, 309 parts (23 on the bottom side), 182 nets.

Parts:
C1, C2, C8, C9: 4.7 uF/100 V; C_1210_3225Metric
C3, C10: 220 nF/100 V; C_0805_2012Metric
C4, C11, C16, C18, C20, C21, C22, C44: 1 uF/16 V; C_0603_1608Metric
C5, C12, C30, C32, C34, C36, C38, C39, C41, C42, C43, C54, C56, C58, C60: 100 nF/50 V X7R; C_0603_1608Metric
C6, C7, C13, C14, C15, C17, C19: 22 uF/25 V; C_1210_3225Metric
C31, C33, C35, C37, C55, C57, C59, C61: 100 pF C0G/50 V; C_0603_1608Metric
C40: 470 pF C0G/50 V; C_0603_1608Metric
C45: 22uF; C_1210_3225Metric
C46, C48, C49, C51, C53, C62, C65, C72, C76, C78, C79, C83, C84, C85: 100nF; C_0603_1608Metric
C47: 10nF; C_0603_1608Metric
C50, C52, C80: 1uF; C_0603_1608Metric
C64: 4.7 uF/16 V X7R; C_0805_2012Metric
C71, C75, C77: 22nF; C_0603_1608Metric
C81, C82: 18pF C0G; C_0603_1608Metric
C86, C89, C92, C98, C118, C119, C120, C121, C122, C123, C124: 1uF 50V X7R; C_0805_2012Metric
C87, C90, C93, C97, C110, C111, C112, C114, C115, C116, C117, C125, C127, C129: 100nF 50V X7R; C_0603_1608Metric
C88, C91, C94, C126: 10nF 50V C0G 10%; C_0603_1608Metric
C95, C96: 220pF C0G; C_0603_1608Metric
C100: 100n; C_0402_1005Metric
C128: 10uF 16V X7R; C_1206_3216Metric
D1: SMCJ24CA; D_SMC
D2: BZT52C12-7-F; D_SOD-123
D3: PESD5V0C1BLS-QYL; SOD882BD
D100: PESD1CAN-UX; SOT-323_SC-70
D101, D104: PESD2CANFD24V-TR; SOT-23
D102, D103, D105: BAV199,215; SOT-23
H1, H2, H3, H4: MountingHole; AgentEE_Mechanical_MountingHole_NPTH
J1: 1-776163-1; AMPSEAL_35_1-776163-1
J2: 732511150; SMA_Molex_73251-1153_EdgeMount_Horizontal
J3: DM3AT-SF-PEJM5; microSD_HC_Hirose_DM3AT-SF-PEJM5
JP1: TIRE_TERM_CLOSE_ONLY_AT_BUS_END; SolderJumper-2_P1.3mm_Open_RoundedPad1.0x1.5mm
JP2: AUX1_THERM_PULLUP_CLOSE_TO_ENABLE; SolderJumper-2_P1.3mm_Open_RoundedPad1.0x1.5mm
JP3: AUX2_THERM_PULLUP_CLOSE_TO_ENABLE; SolderJumper-2_P1.3mm_Open_RoundedPad1.0x1.5mm
JP4: AUX3_THERM_PULLUP_CLOSE_TO_ENABLE; SolderJumper-2_P1.3mm_Open_RoundedPad1.0x1.5mm
JP5: AUX4_THERM_PULLUP_CLOSE_TO_ENABLE; SolderJumper-2_P1.3mm_Open_RoundedPad1.0x1.5mm
L1: 15 uH; SRP7050TA
L2: 6.8 uH; SRP7050WA
L3: LQW18AN56NJ00D; L_0603_1608Metric
Q1: DMP6023LE-13; DMP6023LE_SOT223
R1, R24, R25, R29: 100 kohm; R_0603_1608Metric
R2: 51 kohm; R_0603_1608Metric
R3, R5, R10, R11, R13, R14, R16, R17, R19, R20, R22, R23, R34, R35, R37, R38, R40, R41, R43, R44, R46, R47, R48, R49, R50, R55, R64, R65, R66, R67, R68, R69, R71, R72: 10 kohm; R_0603_1608Metric
R4: 22 kohm; R_0603_1608Metric
R6: 47 kohm; R_0603_1608Metric
R7: 1 ohm; R_0603_1608Metric
R12, R15, R18, R21, R36, R39, R42, R45, R118, R127: 100 ohm; R_0603_1608Metric
R26: 10 ohm/0.25 W; R_1206_3216Metric
R27: 2 kohm; R_0603_1608Metric
R28: 1 kohm; R_0603_1608Metric
R30, R31, R32, R33: 10k; R_0603_1608Metric
R56: 16.9 kohm 0.1%; R_0603_1608Metric
R57, R61, R63, R112, R113, R115, R121, R122, R124: 10 kohm 0.1%; R_0603_1608Metric
R60: 30.1 kohm 0.1% 25ppm/K; R_0603_1608Metric
R62: 64.9 kohm 0.1%; R_0603_1608Metric
R70: 120 ohm; R_0603_1608Metric
R73, R77, R81, R162: 1.05 Mohm 0.1% 25ppm/K; R_0805_2012Metric
R74, R78, R82: 68.1 kohm 0.1% 25ppm/K; R_0603_1608Metric
R75, R79, R83: 215 kohm 0.1% 25ppm/K; R_0603_1608Metric
R76, R80: 44.2 kohm 0.1%; R_0603_1608Metric
R84: 26.7 kohm 0.1%; R_0603_1608Metric
R100: 120; R_0603_1608Metric
R110, R111, R119, R120: 620 ohm; R_2512_6332Metric
R114, R123: 56 kohm 0.1%; R_0603_1608Metric
R116, R125: 100 kohm 0.1%; R_0603_1608Metric
R117, R126: 4.7 kohm 1%; R_0603_1608Metric
R128, R129, R130, R132, R133, R134, R136, R137, R138, R144, R145, R146, R148, R149, R150, R152, R153, R154, R156, R157, R158, R166, R167, R168: 499 kohm 0.1% 25ppm/C; R_0603_1608Metric
R131, R135, R139, R147, R151, R155, R159, R169: 4.99 kohm 0.1% 25ppm/C; R_0603_1608Metric
R160, R161: 2.2 kohm 1% 100ppm/C; R_0603_1608Metric
R163: 95.3 kohm 0.1% 25ppm/K; R_0603_1608Metric
R164: 287 kohm 0.1% 25ppm/K; R_0603_1608Metric
R165: 44.2 kohm 0.1% 25ppm/K; R_0603_1608Metric
R170, R171, R172, R173: 10 kohm 0.1% 25ppm/K; R_0603_1608Metric
R174, R175: 200 ohm 1% 100ppm/K 1.5W CRCW2512-HP; R_2512_6332Metric
R176, R177, R178: 499 kohm 0.1% 25ppm/K; R_0603_1608Metric
R179: 4.99 kohm 0.1% 25ppm/K; R_0603_1608Metric
R180: 100 kohm 1% 100ppm/K; R_0603_1608Metric
R181: 1.2 kohm 0.1% 25ppm/K; R_0603_1608Metric
TP1: POD_UART_TX; PogoPad_D1.5mm
TP2: POD_UART_RX; PogoPad_D1.5mm
TP3: GND; PogoPad_D1.5mm
TP4: MCU_EN; PogoPad_D1.5mm
TP5: MCU_BOOT; PogoPad_D1.5mm
TP6: +3V3; PogoPad_D1.5mm
U1: ESP32-S3-WROOM-1-N8; ESP32-S3-WROOM-1
U2: LSM6DSO32TR; LGA-14_3x2.5mm_P0.5mm_LayoutBorder3x4y
U3: NEO-M9N-00B; ublox_NEO
U4: MCP3208-BI/SL; SOIC-16_3.9x9.9mm_P1.27mm
U5, U7: LMR36520ADDAR; DDA0008B
U6, U12: TPS7B4253QDDARQ1; DDA0008J_C02
U8, U13: ADA4096-4ARUZ-R7; TSSOP-14_4.4x5mm_P0.65mm
U9: OPA320AIDBVR; SOT-23-5
U10: TPS2553QDBVRQ1; SOT-23-6
U11: REF5050AIDR; SOIC-8_3.9x4.9mm_P1.27mm
U16, U18, U19: TPS389001DSER; DSE0006A
U20: MCP2518FDT-E/SL; SOIC-14_3.9x8.7mm_P1.27mm
U21: TJA1051T/3/1J; SOIC-8_3.9x4.9mm_P1.27mm
U22: SN74LVC1G132DBVR; SOT-23-5
U23, U24, U25, U30: TPS26625DRCR; VSON-10-1EP_3x3mm_P0.5mm_EP1.65x2.4mm
U26: LM2903BQDRQ1; SOIC-8_3.9x4.9mm_P1.27mm
U27, U28, U29: ADS1119IPWR; TSSOP-16_4.4x5mm_P0.65mm
U31: TL431BQDBZR; SOT-23
U100: TJA1051T-3; SOIC-8_3.9x4.9mm_P1.27mm
Y1: X1E0003410031 20MHz 12pF; Crystal_SMD_SeikoEpson_FA238-4Pin_3.2x2.5mm

Connections:
/+3V3: C13.1, C14.1, C15.1, C38.1, C41.1, C43.1, C44.1, C45.1, C46.1, C48.1, C49.1, C50.1, C51.1, C52.1, C53.1, C62.1, C64.1, C65.1, C72.1, C76.1, C78.1, C79.1, C80.1, C84.1, C85.1, C118.1, C119.1, C120.1, C121.1, C122.1, C123.1, J3.4, L2.2, R4.1, R25.2, R29.1, R30.1, R31.1, R32.1, R46.1, R47.1, R48.1, R49.1, R50.1, R55.2, R56.1, R64.1, R65.1, R66.1, R67.1, R69.1, R71.1, R114.1, R117.1, R123.1, R126.1, R136.1, R160.1, R161.1, TP6.1, U1.2, U2.5, U2.8, U3.2, U3.22, U3.23, U4.16, U8.4, U9.5, U10.1, U10.5, U13.4, U16.3, U16.4, U18.3, U18.4, U19.3, U19.4, U20.14, U21.5, U22.5, U27.3, U27.12, U27.13, U28.1, U28.3, U28.12, U28.13, U29.2, U29.3, U29.12, U29.13, U100.5
/+5V_CAN: C19.1, C83.1, C100.1, U12.1, U12.4, U21.3, U100.3
/ADC_AIN0: C31.1, R12.2, U4.1
/ADC_AIN1: C33.1, R15.2, U4.2
/ADC_AIN2: C35.1, R18.2, U4.3
/ADC_AIN3: C37.1, R21.2, U4.4
/ADC_AIN4: C55.1, R36.2, U4.5
/ADC_AIN5: C57.1, R39.2, U4.6
/ADC_AIN6: C59.1, R42.2, U4.7
/ADC_AIN7: C61.1, R45.2, U4.8
/ADC_CS: R32.2, U1.17, U4.10
/AFE_BUF0: R12.1, U8.1, U8.2
/AFE_BUF1: R15.1, U8.6, U8.7
/AFE_BUF2: R18.1, U8.8, U8.9
/AFE_BUF3: R21.1, U8.13, U8.14
/AFE_BUF4: R36.1, U13.1, U13.2
/AFE_BUF5: R39.1, U13.6, U13.7
/AFE_BUF6: R42.1, U13.8, U13.9
/AFE_BUF7: R45.1, U13.13, U13.14
/AFE_DIV0: C30.1, R10.2, R11.1, U8.3
/AFE_DIV1: C32.1, R13.2, R14.1, U8.5
/AFE_DIV2: C34.1, R16.2, R17.1, U8.10
/AFE_DIV3: C36.1, R19.2, R20.1, U8.12
/AFE_DIV4: C54.1, R34.2, R35.1, U13.3
/AFE_DIV5: C56.1, R37.2, R38.1, U13.5
/AFE_DIV6: C58.1, R40.2, R41.1, U13.10
/AFE_DIV7: C60.1, R43.2, R44.1, U13.12
/ANT_BIAS: C42.1, L3.1, R26.2
/ANT_LIMITED: R26.1, U10.6
/BOOT_3V3: C12.1, U7.7
/BOOT_PRE: C5.1, U5.7
/DIAG_I2C_SCL: R161.2, U1.23, U27.16, U28.16, U29.16
/DIAG_I2C_SDA: R160.2, U1.22, U27.15, U28.15, U29.15
/DIAG_U27_AIN0: C110.1, R130.2, R131.1, U27.11
/DIAG_U27_AIN0_UPPER1: R128.2, R129.1
/DIAG_U27_AIN0_UPPER2: R129.2, R130.1
/DIAG_U27_AIN1: C111.1, R134.2, R135.1, U27.10
/DIAG_U27_AIN1_UPPER1: R132.2, R133.1
/DIAG_U27_AIN1_UPPER2: R133.2, R134.1
/DIAG_U27_AIN2: C112.1, R138.2, R139.1, U27.7
/DIAG_U27_AIN2_UPPER1: R136.2, R137.1
/DIAG_U27_AIN2_UPPER2: R137.2, R138.1
/DIAG_U28_AIN1: C114.1, R146.2, R147.1, U28.10
/DIAG_U28_AIN1_UPPER1: R144.2, R145.1
/DIAG_U28_AIN1_UPPER2: R145.2, R146.1
/DIAG_U28_AIN2: C127.1, R168.2, R169.1, U28.7
/DIAG_U28_AIN2_UPPER1: R166.2, R167.1
/DIAG_U28_AIN2_UPPER2: R167.2, R168.1
/DIAG_U28_AIN3: C129.1, R178.2, R179.1, U28.6
/DIAG_U28_AIN3_UPPER1: R176.2, R177.1
/DIAG_U28_AIN3_UPPER2: R177.2, R178.1
/DIAG_U29_AIN0: C115.1, R150.2, R151.1, U29.11
/DIAG_U29_AIN0_UPPER1: R148.2, R149.1
/DIAG_U29_AIN0_UPPER2: R149.2, R150.1
/DIAG_U29_AIN1: C116.1, R154.2, R155.1, U29.10
/DIAG_U29_AIN1_UPPER1: R152.2, R153.1
/DIAG_U29_AIN1_UPPER2: R153.2, R154.1
/DIAG_U29_AIN2: C117.1, R158.2, R159.1, U29.7
/DIAG_U29_AIN2_UPPER1: R156.2, R157.1
/DIAG_U29_AIN2_UPPER2: R157.2, R158.1
/FB_3V3: R5.1, R28.2, U7.5
/FB_3V3_SERIES: R4.2, R28.1
/FB_PRE: R3.1, R27.2, U5.5
/FB_PRE_SERIES: R2.2, R27.1
/GND: C1.2, C2.2, C3.2, C4.2, C6.2, C7.2, C8.2, C9.2, C10.2, C11.2, C13.2, C14.2, C15.2, C16.2, C17.2, C18.2, C19.2, C20.2, C21.2, C22.2, C30.2, C31.2, C32.2, C33.2, C34.2, C35.2, C36.2, C37.2, C38.2, C39.2, C40.2, C41.2, C42.2, C43.2, C44.2, C45.2, C46.2, C47.2, C48.2, C49.2, C50.2, C51.2, C52.2, C53.2, C54.2, C55.2, C56.2, C57.2, C58.2, C59.2, C60.2, C61.2, C62.2, C64.2, C65.2, C71.2, C72.2, C75.2, C76.2, C77.2, C78.2, C79.2, C80.2, C81.2, C82.2, C83.2, C84.2, C85.2, C86.2, C87.2, C89.2, C90.2, C92.2, C93.2, C95.2, C96.2, C97.2, C98.2, C100.2, C110.2, C111.2, C112.2, C114.2, C115.2, C116.2, C117.2, C118.2, C119.2, C120.2, C121.2, C122.2, C123.2, C124.2, C125.2, C127.2, C128.2, C129.2, D1.2, D3.2, D100.3, D101.3, D104.3, J1.4, J1.7, J1.10, J1.13, J1.16, J1.22, J1.25, J1.28, J1.32, J2.2, J3.6, J3.10, J3.SH, R1.2, R3.2, R5.2, R6.2, R11.2, R14.2, R17.2, R20.2, R23.2, R24.2, R33.2, R35.2, R38.2, R41.2, R44.2, R57.2, R61.2, R63.2, R68.2, R72.2, R113.2, R115.2, R122.2, R124.2, R131.2, R135.2, R139.2, R147.2, R151.2, R155.2, R159.2, R169.2, R179.2, R180.2, TP3.1, U1.1, U1.40, U1.41, U2.2, U2.3, U2.6, U2.7, U3.7, U3.10, U3.12, U3.13, U3.24, U4.9, U4.14, U5.1, U5.9, U6.3, U6.6, U6.9, U7.1, U7.9, U8.11, U9.2, U10.2, U11.4, U12.3, U12.6, U12.9, U13.11, U16.2, U18.2, U19.2, U20.7, U21.2, U22.3, U23.6, U24.6, U25.6, U26.4, U27.1, U27.2, U27.4, U27.5, U28.2, U28.4, U28.5, U29.1, U29.4, U29.5, U30.6, U31.3, U100.2, U100.8, Y1.2, Y1.4
/GNSS_ANT_FAULT_N: R25.1, U10.4
/GNSS_LNA_EN: R24.1, U3.14, U10.3
/GNSS_PPS: U1.7, U3.3
/GNSS_RX_IN: U1.10, U3.21
/GNSS_TX_OUT: U1.11, U3.20
/IMU_CS: R31.2, U1.18, U2.12
/IMU_INT1: U1.6, U2.4
/MCU_BOOT: R30.2, TP5.1, U1.27
/MCU_BOOT46: R33.1, U1.16
/MCU_EN: C47.1, R29.2, TP4.1, U1.3, U16.6, U22.1
/POD_5V_AUX: C125.1, D105.1, J1.21, R166.1, R180.1, U30.10
/POD_5V_SENSOR: C17.1, C124.1, J1.5, J1.8, J1.11, J1.14, R6.1, R22.1, R60.1, R144.1, R162.1, U6.1, U6.4, U30.1
/POD_12V_IN: D1.1, J1.3, Q1.2
/POD_12V_PROTECTED: C1.1, C2.1, C3.1, C8.1, C9.1, C10.1, D2.1, Q1.3, R62.1, R128.1, U5.2, U5.3, U7.2, U7.3
/POD_AUX1_SIGNAL: J1.17, JP2.2, R34.1
/POD_AUX2_SIGNAL: J1.18, JP3.2, R37.1
/POD_AUX3_SIGNAL: J1.19, JP4.2, R40.1
/POD_AUX4_SIGNAL: J1.20, JP5.2, R43.1
/POD_CAN_N: D100.1, J1.2, R100.2, U100.6
/POD_CAN_P: D100.2, J1.1, R100.1, U100.7
/POD_FRONT_BRAKE_SIGNAL: J1.12, R16.1
/POD_FRONT_FORK_SIGNAL: J1.6, R10.1
/POD_GNSS_RF: D3.1, J2.1, L3.2, U3.11
/POD_REAR_BRAKE_SIGNAL: J1.15, R19.1
/POD_REAR_SHOCK_SIGNAL: J1.9, R13.1
/POD_TIRE_SUPPLY: C93.1, J1.31, R156.1, U25.10
/POD_UART_RX: TP2.1, U1.36
/POD_UART_TX: TP1.1, U1.37
/POD_WHEEL_FRONT_SIGNAL: D102.3, D104.1, J1.24
/POD_WHEEL_FRONT_SUPPLY: C87.1, J1.23, R110.1, R148.1, U23.10
/POD_WHEEL_REAR_SIGNAL: D103.3, D104.2, J1.27
/POD_WHEEL_REAR_SUPPLY: C90.1, J1.26, R119.1, R152.1, U24.10
/POWER_FAIL_N: R65.2, U1.12, U19.6
/PRE_6V3: C6.1, C7.1, C16.1, C18.1, C20.1, C86.1, C89.1, C92.1, C97.1, C98.1, L1.2, R2.1, R73.1, R77.1, R81.1, R132.1, U6.8, U11.2, U12.8, U23.1, U24.1, U25.1, U26.8
/REF_CAP_NODE: C22.1, R7.2
/REF_DIV: C39.1, R22.2, R23.1, U9.3
/REF_NR: C21.1, U11.5
/REVERSE_GATE: D2.2, Q1.1, R1.1
/SD_CD: J3.9, R55.1, U1.28
/SD_CLK: J3.5, U1.31
/SD_CMD: J3.3, R46.2, U1.32
/SD_DAT0: J3.7, R47.2, U1.33
/SD_DAT1: J3.8, R48.2, U1.34
/SD_DAT2: J3.1, R49.2, U1.35
/SD_DAT3: J3.2, R50.2, U1.24
/SENSOR_FAULT_N: R64.2, U1.25, U18.6
/SENSOR_POWER_AUX_DVDT: C126.1, U30.8
/SENSOR_POWER_AUX_ILIM: R165.1, U30.7
/SENSOR_POWER_AUX_OVP: R163.2, R164.1, U30.3
/SENSOR_POWER_AUX_RTN: C126.2, R164.2, R165.2, U30.5, U30.11
/SENSOR_POWER_AUX_UVLO: R162.2, R163.1, U30.2
/SENSOR_POWER_FRONT_DVDT: C88.1, U23.8
/SENSOR_POWER_FRONT_ILIM: R76.1, U23.7
/SENSOR_POWER_FRONT_OVP: R74.2, R75.1, U23.3
/SENSOR_POWER_FRONT_RTN: C88.2, R75.2, R76.2, U23.5, U23.11
/SENSOR_POWER_FRONT_UVLO: R73.2, R74.1, U23.2
/SENSOR_POWER_REAR_DVDT: C91.1, U24.8
/SENSOR_POWER_REAR_ILIM: R80.1, U24.7
/SENSOR_POWER_REAR_OVP: R78.2, R79.1, U24.3
/SENSOR_POWER_REAR_RTN: C91.2, R79.2, R80.2, U24.5, U24.11
/SENSOR_POWER_REAR_UVLO: R77.2, R78.1, U24.2
/SENSOR_POWER_TIRE_DVDT: C94.1, U25.8
/SENSOR_POWER_TIRE_ILIM: R84.1, U25.7
/SENSOR_POWER_TIRE_OVP: R82.2, R83.1, U25.3
/SENSOR_POWER_TIRE_RTN: C94.2, R83.2, R84.2, U25.5, U25.11
/SENSOR_POWER_TIRE_UVLO: R81.2, R82.1, U25.2
/SENSOR_REF_2V5: C40.1, U4.15, U9.1, U9.4
/SETPOINT_5V: R7.1, U6.5, U11.6, U12.5
/SPI_MISO: U1.21, U2.1, U4.12, U20.12
/SPI_MOSI: U1.19, U2.14, U4.11, U20.11
/SPI_SCK: U1.20, U2.13, U4.13, U20.10
/SUP_U16_CT: C71.1, U16.5
/SUP_U16_SENSE: R56.2, R57.1, U16.1
/SUP_U18_CT: C75.1, U18.5
/SUP_U18_SENSE: R61.1, R181.2, U18.1
/SUP_U18_TOP_SERIES: R60.2, R181.1
/SUP_U19_CT: C77.1, U19.5
/SUP_U19_SENSE: R62.2, R63.1, U19.1
/SW_3V3: C12.2, L2.1, U7.8
/SW_PRE: C5.2, L1.1, U5.8
/THERM_AUX1_SELECT: JP2.1, R170.2
/THERM_AUX2_SELECT: JP3.1, R171.2
/THERM_AUX3_SELECT: JP4.1, R172.2
/THERM_AUX4_SELECT: JP5.1, R173.2
/THERM_BIAS_IN: D105.3, R174.1
/THERM_BIAS_MID: R174.2, R175.1
/THERM_EXC_2V495: C128.1, R170.1, R171.1, R172.1, R173.1, R175.2, R176.1, U31.1, U31.2
/TIRE_CAN_CS: R66.2, U1.8, U20.13
/TIRE_CAN_GPIO1: R72.1, U20.8
/TIRE_CAN_H: D101.1, J1.29, J1.33, R70.1, U21.7
/TIRE_CAN_INT_N: R67.2, U1.9, U20.4
/TIRE_CAN_L: D101.2, J1.30, J1.34, JP1.2, U21.6
/TIRE_CAN_OSC1: C81.1, U20.6, Y1.1
/TIRE_CAN_OSC2: C82.1, U20.5, Y1.3
/TIRE_CAN_RX: U20.2, U21.4
/TIRE_CAN_SILENT: R71.2, U21.8, U22.4
/TIRE_CAN_TERM: JP1.1, R70.2
/TIRE_CAN_TX: R69.2, U20.1, U21.1
/TIRE_CAN_TX_ENABLE: R68.1, U20.9, U22.2
/TWAI_RX: U1.5, U100.4
/TWAI_TX: U1.4, U100.1
/VCC_3V3: C11.1, U7.6
/VCC_PRE: C4.1, U5.6
/WHEEL_FRONT_CAPTURE: R118.2, U1.39
/WHEEL_FRONT_DIODE_OUT: D102.2, R112.1
/WHEEL_FRONT_FILTERED: C95.1, R112.2, R113.1, U26.2
/WHEEL_FRONT_OUT: R116.1, R117.2, R118.1, U26.1
/WHEEL_FRONT_PULLUP: D102.1, R111.2
/WHEEL_FRONT_PULLUP_MID: R110.2, R111.1
/WHEEL_FRONT_THRESHOLD: R114.2, R115.1, R116.2, U26.3
/WHEEL_REAR_CAPTURE: R127.2, U1.38
/WHEEL_REAR_DIODE_OUT: D103.2, R121.1
/WHEEL_REAR_FILTERED: C96.1, R121.2, R122.1, U26.6
/WHEEL_REAR_OUT: R125.1, R126.2, R127.1, U26.7
/WHEEL_REAR_PULLUP: D103.1, R120.2
/WHEEL_REAR_PULLUP_MID: R119.2, R120.1
/WHEEL_REAR_THRESHOLD: R123.2, R124.1, R125.2, U26.5
