halbritt/fome-mc/telemetry-pod/expansion/released-source-migration/project/telemetry-pod.kicad_sch

## KiCad design telemetry-pod/expansion/released-source-migration/project/telemetry-pod.kicad_sch (2026-10-20)

Schematic: telemetry-pod.kicad_sch

Parts:
C1, C2, C8, C9: 4.7 uF/100 V; C_1210_3225Metric; Voltage 100V; Partnumber CL32B475KCVZNWE; LCSC C17288249
C3, C10: 220 nF/100 V; C_0805_2012Metric; Voltage 100V; Partnumber CL21B224KCFSFNE; LCSC C307542
C4, C11, C16, C18, C20, C21, C22, C44: 1 uF/16 V; C_0603_1608Metric; Voltage 16V; Partnumber CGA3E1X7R1C105KT0Y0N; LCSC C76706
C5, C12, C30, C32, C34, C36, C38, C39, C41, C42, C43, C54, C56, C58, C60: 100 nF/50 V X7R; C_0603_1608Metric; Voltage 50V; Partnumber CGA3E2X7R1H104KT0Y0N; LCSC C76711
C6, C7, C13, C14, C15, C17, C19: 22 uF/25 V; C_1210_3225Metric; Voltage 25V; Partnumber CGA6P3X7R1E226MT000N; LCSC C694521
C31, C33, C35, C37, C55, C57, C59, C61: 100 pF C0G/50 V; C_0603_1608Metric; Voltage 50V; Partnumber C0603C101J5GACTU; LCSC C2167328
C40: 470 pF C0G/50 V; C_0603_1608Metric; Voltage 50V; Partnumber C0603C471J5GACTU; LCSC C452751
C45: 22uF; C_1210_3225Metric; Voltage 25V; Partnumber CGA6P3X7R1E226MT000N; LCSC C694521
C46, C48, C49, C51, C53, C62: 100nF; C_0603_1608Metric; Voltage 50V; Partnumber CGA3E2X7R1H104KT0Y0N; LCSC C76711
C47: 10nF; C_0603_1608Metric; Partnumber GRM1885C1H103JA01D; LCSC C85973
C50, C52: 1uF; C_0603_1608Metric; Voltage 16V; Partnumber CGA3E1X7R1C105KT0Y0N; LCSC C76706
C63: 1 uF/16 V; C_0603_1608Metric; Partnumber C0603C105K4RACTU; LCSC C2167386
C64, C66: 4.7 uF/16 V X7R; C_0805_2012Metric; Partnumber C0805C475K4RACTU; LCSC C7224519
C65, C67, C72, C74, C76, C78, C79, C83, C84, C85: 100nF; C_0603_1608Metric; Partnumber C0603C104K5RACTU; LCSC C127833
C68, C69, C70: 22 uF/25 V; C_1210_3225Metric; Partnumber CC1210KKX7R8BB226; LCSC C5341638
C71, C73, C75, C77: 22nF; C_0603_1608Metric; Partnumber C0603C223K5RACTU; LCSC C2167136
C80: 1uF; C_0603_1608Metric; Partnumber C0603C105K4RACTU; LCSC C2167386
C81, C82: 18pF C0G; C_0603_1608Metric; Partnumber C0603C180J5GACTU; LCSC C2168350
C86, C89, C92, C98, C118, C119, C120, C121, C122, C123, C124: 1uF 50V X7R; C_0805_2012Metric; Partnumber C0805C105K5RACTU; LCSC C3018567
C87, C90, C93, C97, C110, C111, C112, C113, C114, C115, C116, C117, C125, C127, C129: 100nF 50V X7R; C_0603_1608Metric; Partnumber C0603C104K5RACTU; LCSC C127833
C88, C91, C94, C126: 10nF 50V C0G 10%; C_0603_1608Metric; Partnumber GRM1885C1H103JA01D; LCSC C85973
C95, C96: 220pF C0G; C_0603_1608Metric; Partnumber C0603C221J5GACTU; LCSC C452747
C100: 100n; C_0402_1005Metric; Voltage 16V; Partnumber CL05B104KO5NNNC; LCSC C1525
C128: 10uF 16V X7R; C_1206_3216Metric; Partnumber C1206C106K4RACTU; LCSC C2174822
D1: SMCJ24CA; D_SMC; Partnumber SMCJ24CA; LCSC C151279
D2: BZT52C12-7-F; D_SOD-123; Partnumber BZT52C12-7-F; LCSC C124196
D3: PESD5V0C1BLS-QYL; SOD882BD; Partnumber PESD5V0C1BLS-QYL; LCSC C5311564
D100: PESD1CAN-UX; SOT-323_SC-70; Partnumber PESD1CAN-UX; LCSC C907839
D101, D104: PESD2CANFD24V-TR; SOT-23; Partnumber PESD2CANFD24V-TR; LCSC C552486
D102, D103, D105: BAV199,215; SOT-23; Partnumber BAV199,215; LCSC C40919
J1: 1-776163-1; AMPSEAL_35_1-776163-1; Partnumber 1-776163-1; LCSC C596198
J2: 732511150; SMA_Molex_73251-1153_EdgeMount_Horizontal; Partnumber 732511150; LCSC C841205
JP1: TIRE_TERM_CLOSE_ONLY_AT_BUS_END; SolderJumper-2_P1.3mm_Open_RoundedPad1.0x1.5mm
JP2: AUX1_THERM_PULLUP_CLOSE_TO_ENABLE; SolderJumper-2_P1.3mm_Open_RoundedPad1.0x1.5mm
JP3: AUX2_THERM_PULLUP_CLOSE_TO_ENABLE; SolderJumper-2_P1.3mm_Open_RoundedPad1.0x1.5mm
JP4: AUX3_THERM_PULLUP_CLOSE_TO_ENABLE; SolderJumper-2_P1.3mm_Open_RoundedPad1.0x1.5mm
JP5: AUX4_THERM_PULLUP_CLOSE_TO_ENABLE; SolderJumper-2_P1.3mm_Open_RoundedPad1.0x1.5mm
L1: 15 uH; SRP7050TA; Partnumber SRP7050TA-150M; LCSC C2045384
L2: 6.8 uH; SRP7050WA; Partnumber SRP7050WA-6R8M; LCSC C19947708
L3: LQW18AN56NJ00D; L_0603_1608Metric; Partnumber LQW18AN56NJ00D; LCSC C98080
L4: 2.2 uH; SRP4020TA; Partnumber SRP4020TA-2R2M; LCSC C719179
Q1: DMP6023LE-13; DMP6023LE_SOT223; Partnumber DMP6023LE-13; LCSC C154901
R1, R24, R25: 100 kohm; R_0603_1608Metric; Partnumber RC0603FR-07100KL; LCSC C14675
R2: 51 kohm; R_0603_1608Metric; Partnumber RT0603BRD0751KL; LCSC C861458
R3, R5, R10, R11, R13, R14, R16, R17, R19, R20, R22, R23, R34, R35, R37, R38, R40, R41, R43, R44, R46, R47, R48, R49, R50, R51, R52, R53, R54, R55, R64, R65, R66, R67, R68, R69, R71, R72: 10 kohm; R_0603_1608Metric; Partnumber RT0603BRD0710KL; LCSC C95204
R4: 22 kohm; R_0603_1608Metric; Partnumber RT0603BRD0722KL; LCSC C469656
R6: 47 kohm; R_0603_1608Metric; Partnumber RC0603FR-0747KL; LCSC C105579
R7: 1 ohm; R_0603_1608Metric; Partnumber RC0603FR-071RL; LCSC C112305
R12, R15, R18, R21, R36, R39, R42, R45: 100 ohm; R_0603_1608Metric; Partnumber RC0603FR-07100RL; LCSC C105588
R26: 10 ohm/0.25 W; R_1206_3216Metric; Partnumber RC1206FR-0710RL; LCSC C108080
R27: 2 kohm; R_0603_1608Metric; Partnumber RT0603BRD072KL; LCSC C728588
R28: 1 kohm; R_0603_1608Metric; Partnumber RT0603BRD071KL; LCSC C110776
R29: 100 kohm; R_0603_1608Metric; Partnumber RT0603BRD07100KL; LCSC C122538
R30, R31, R32, R33: 10k; R_0603_1608Metric; Partnumber RT0603BRD0710KL; LCSC C95204
R56: 16.9 kohm 0.1%; R_0603_1608Metric; Partnumber RT0603BRD0716K9L; LCSC C861156
R57, R59, R61, R63, R112, R113, R115, R121, R122, R124: 10 kohm 0.1%; R_0603_1608Metric; Partnumber RT0603BRD0710KL; LCSC C95204
R58: 15.2 kohm 0.1%; R_0603_1608Metric; Partnumber RT0603BRD0715K2L; LCSC C861141
R60: 30.1 kohm 0.1% 25ppm/K; R_0603_1608Metric; Partnumber RT0603BRD0730K1L; LCSC C705764
R62: 64.9 kohm 0.1%; R_0603_1608Metric; Partnumber RT0603BRD0764K9L; LCSC C861510
R70: 120 ohm; R_0603_1608Metric; Partnumber RT0603BRD07120RL; LCSC C861094
R73, R77, R81, R162: 1.05 Mohm 0.1% 25ppm/K; R_0805_2012Metric; Partnumber RT0805BRD071M05L; LCSC C7353633
R74, R78, R82: 68.1 kohm 0.1% 25ppm/K; R_0603_1608Metric; Partnumber RT0603BRD0768K1L; LCSC C861521
R75, R79, R83: 215 kohm 0.1% 25ppm/K; R_0603_1608Metric; Partnumber RT0603BRD07215KL; LCSC C861226
R76, R80: 44.2 kohm 0.1%; R_0603_1608Metric; Partnumber RT0603BRD0744K2L; LCSC C861410
R84: 26.7 kohm 0.1%; R_0603_1608Metric; Partnumber RT0603BRD0726K7L; LCSC C728587
R100: 120; R_0603_1608Metric; Partnumber 0603WAF1200T5E; LCSC C22787
R110, R111, R119, R120: 620 ohm; R_2512_6332Metric; Partnumber CRCW2512620RFKEG; LCSC C3988368
R114, R123: 56 kohm 0.1%; R_0603_1608Metric; Partnumber RT0603BRD0756KL; LCSC C705785
R116, R125: 100 kohm 0.1%; R_0603_1608Metric; Partnumber RT0603BRD07100KL; LCSC C122538
R117, R126: 4.7 kohm 1%; R_0603_1608Metric; Partnumber RT0603BRD074K7L; LCSC C513565
R118, R127: 100 ohm; R_0603_1608Metric; Partnumber RT0603BRD07100RL; LCSC C122970
R128, R129, R130, R132, R133, R134, R136, R137, R138, R140, R141, R142, R144, R145, R146, R148, R149, R150, R152, R153, R154, R156, R157, R158, R166, R167, R168: 499 kohm 0.1% 25ppm/C; R_0603_1608Metric; Partnumber RT0603BRD07499KL; LCSC C515607
R131, R135, R139, R143, R147, R151, R155, R159, R169: 4.99 kohm 0.1% 25ppm/C; R_0603_1608Metric; Partnumber RT0603BRD074K99L; LCSC C723532
R160, R161: 2.2 kohm 1% 100ppm/C; R_0603_1608Metric; Partnumber RT0603BRD072K2L; LCSC C861295
R163: 95.3 kohm 0.1% 25ppm/K; R_0603_1608Metric; Partnumber RT0603BRD0795K3L; LCSC C861605
R164: 287 kohm 0.1% 25ppm/K; R_0603_1608Metric; Partnumber RT0603BRD07287KL; LCSC C861279
R165: 44.2 kohm 0.1% 25ppm/K; R_0603_1608Metric; Partnumber RT0603BRD0744K2L; LCSC C861410
R170, R171, R172, R173: 10 kohm 0.1% 25ppm/K; R_0603_1608Metric; Partnumber RT0603BRD0710KL; LCSC C95204
R174, R175: 200 ohm 1% 100ppm/K 1.5W CRCW2512-HP; R_2512_6332Metric; Partnumber CRCW2512200RFKEGHP; LCSC C2073505
R176, R177, R178: 499 kohm 0.1% 25ppm/K; R_0603_1608Metric; Partnumber RT0603BRD07499KL; LCSC C515607
R179: 4.99 kohm 0.1% 25ppm/K; R_0603_1608Metric; Partnumber RT0603BRD074K99L; LCSC C723532
R180: 100 kohm 1% 100ppm/K; R_0603_1608Metric; Partnumber RT0603BRD07100KL; LCSC C122538
R181: 1.2 kohm 0.1% 25ppm/K; R_0603_1608Metric; Partnumber RT0603BRD071K2L; LCSC C136970
TP1: POD_UART_TX; PogoPad_D1.5mm
TP2: POD_UART_RX; PogoPad_D1.5mm
TP3: GND; PogoPad_D1.5mm
TP4: MCU_EN; PogoPad_D1.5mm
TP5: MCU_BOOT; PogoPad_D1.5mm
TP6: +3V3; PogoPad_D1.5mm
U1: ESP32-S3-WROOM-1-N8; ESP32-S3-WROOM-1; Partnumber ESP32-S3-WROOM-1-N8; LCSC C2913198
U2: LSM6DSO32TR; LGA-14_3x2.5mm_P0.5mm_LayoutBorder3x4y; Partnumber LSM6DSO32TR; LCSC C1864162
U3: NEO-M9N-00B; ublox_NEO; Partnumber NEO-M9N-00B; LCSC C5119087
U4: MCP3208-BI/SL; SOIC-16_3.9x9.9mm_P1.27mm; Partnumber MCP3208-BI/SL; LCSC C2979740
U5, U7: LMR36520ADDAR; DDA0008B; Partnumber LMR36520ADDAR; LCSC C2879422
U6, U12: TPS7B4253QDDARQ1; DDA0008J_C02; Partnumber TPS7B4253QDDARQ1; LCSC C129339
U8, U13: ADA4096-4ARUZ-R7; TSSOP-14_4.4x5mm_P0.65mm; Partnumber ADA4096-4ARUZ-R7; LCSC C208539
U9: OPA320AIDBVR; SOT-23-5; Partnumber OPA320AIDBVR; LCSC C92494
U10: TPS2553QDBVRQ1; SOT-23-6; Partnumber TPS2553QDBVRQ1; LCSC C130055
U11: REF5050AIDR; SOIC-8_3.9x4.9mm_P1.27mm; Partnumber REF5050AIDR; LCSC C27804
U14: FEMDME008G-A8A39; LFBGA-153_11.5x13mm_Layout14x14_P0.5mm; Partnumber FEMDME008G-A8A39; LCSC C3249972
U15: TPS62162QDSGRQ1; Texas_DSG0008A_WSON-8-1EP_2x2mm_P0.5mm_EP0.9x1.6mm; Partnumber TPS62162QDSGRQ1; LCSC C2071196
U16, U17, U18, U19: TPS389001DSER; DSE0006A; Partnumber TPS389001DSER; LCSC C1509297
U20: MCP2518FDT-E/SL; SOIC-14_3.9x8.7mm_P1.27mm; Partnumber MCP2518FDT-E/SL; LCSC C626758
U21: TJA1051T/3/1J; SOIC-8_3.9x4.9mm_P1.27mm; Partnumber TJA1051T/3/1J; LCSC C38695
U22: SN74LVC1G132DBVR; SOT-23-5; Partnumber SN74LVC1G132DBVR; LCSC C403723
U23, U24, U25, U30: TPS26625DRCR; VSON-10-1EP_3x3mm_P0.5mm_EP1.65x2.4mm; Partnumber TPS26625DRCR; LCSC C2862873
U26: LM2903BQDRQ1; SOIC-8_3.9x4.9mm_P1.27mm; Partnumber LM2903BQDRQ1; LCSC C3659057
U27, U28, U29: ADS1119IPWR; TSSOP-16_4.4x5mm_P0.65mm; Partnumber ADS1119IPWR; LCSC C701613
U31: TL431BQDBZR; SOT-23; Partnumber TL431BQDBZR; LCSC C190245
U100: TJA1051T-3; SOIC-8_3.9x4.9mm_P1.27mm; Partnumber TJA1051T/3/1J; LCSC C38695
Y1: X1E0003410031 20MHz 12pF; Crystal_SMD_SeikoEpson_FA238-4Pin_3.2x2.5mm; Partnumber X1E0003410031; LCSC C725712

Connections:
+3V3: C13.1, C14.1, C15.1, C38.1, C41.1, C43.1, C44.1, C45.1, C46.1, C48.1, C49.1, C50.1, C51.1, C52.1, C53.1, C62.1, C66.1, C67.1, C72.1, C74.1, C76.1, C78.1, C79.1, C80.1, C84.1, C85.1, C118.1, C119.1, C120.1, C121.1, C122.1, C123.1, L2.2, R4.1, R25.2, R29.1, R30.1, R31.1, R32.1, R46.1, R47.1, R48.1, R49.1, R50.1, R51.1, R52.1, R53.1, R54.1, R56.1, R64.1, R65.1, R66.1, R67.1, R69.1, R71.1, R114.1, R117.1, R123.1, R126.1, R136.1, R160.1, R161.1, TP6.1, U1.2 (3V3), U2.5 (VDDIO), U2.8 (VDD), U3.2 (D_SEL), U3.22 (V_BCKP), U3.23 (VCC), U4.16 (Vdd), U8.4 (V+), U9.5 (V+), U10.1 (IN), U10.5 (ILIM), U13.4 (V+), U14.C6 (VCCQ), U14.M4 (VCCQ), U14.N4 (VCCQ), U14.P3 (VCCQ), U14.P5 (VCCQ), U16.3 (MR), U16.4 (VDD), U17.3 (MR), U17.4 (VDD), U18.3 (MR), U18.4 (VDD), U19.3 (MR), U19.4 (VDD), U20.14 (VDD), U21.5 (VIO), U22.5 (VCC), U27.3 (RESET_N), U27.12 (AVDD), U27.13 (DVDD), U28.1 (A0), U28.3 (RESET_N), U28.12 (AVDD), U28.13 (DVDD), U29.2 (A1), U29.3 (RESET_N), U29.12 (AVDD), U29.13 (DVDD), U100.5 (VIO)
+5V_CAN: C19.1, C83.1, C100.1, U12.1 (OUT), U12.4 (FB), U21.3 (VCC), U100.3 (VCC)
ADC_AIN0: C31.1, R12.2, U4.1 (CH0)
ADC_AIN1: C33.1, R15.2, U4.2 (CH1)
ADC_AIN2: C35.1, R18.2, U4.3 (CH2)
ADC_AIN3: C37.1, R21.2, U4.4 (CH3)
ADC_AIN4: C55.1, R36.2, U4.5 (CH4)
ADC_AIN5: C57.1, R39.2, U4.6 (CH5)
ADC_AIN6: C59.1, R42.2, U4.7 (CH6)
ADC_AIN7: C61.1, R45.2, U4.8 (CH7)
ADC_CS: R32.2, U1.17 (IO9), U4.10 (~CS/SHDN)
AFE_BUF0: R12.1, U8.1 (OUTA), U8.2 (-INA)
AFE_BUF1: R15.1, U8.6 (-INB), U8.7 (OUTB)
AFE_BUF2: R18.1, U8.8 (OUTC), U8.9 (-INC)
AFE_BUF3: R21.1, U8.13 (-IND), U8.14 (OUTD)
AFE_BUF4: R36.1, U13.1 (OUTA), U13.2 (-INA)
AFE_BUF5: R39.1, U13.6 (-INB), U13.7 (OUTB)
AFE_BUF6: R42.1, U13.8 (OUTC), U13.9 (-INC)
AFE_BUF7: R45.1, U13.13 (-IND), U13.14 (OUTD)
AFE_DIV0: C30.1, R10.2, R11.1, U8.3 (+INA)
AFE_DIV1: C32.1, R13.2, R14.1, U8.5 (+INB)
AFE_DIV2: C34.1, R16.2, R17.1, U8.10 (+INC)
AFE_DIV3: C36.1, R19.2, R20.1, U8.12 (+IND)
AFE_DIV4: C54.1, R34.2, R35.1, U13.3 (+INA)
AFE_DIV5: C56.1, R37.2, R38.1, U13.5 (+INB)
AFE_DIV6: C58.1, R40.2, R41.1, U13.10 (+INC)
AFE_DIV7: C60.1, R43.2, R44.1, U13.12 (+IND)
ANT_BIAS: C42.1, L3.1, R26.2
ANT_LIMITED: R26.1, U10.6 (OUT)
BOOT_3V3: C12.1, U7.7 (BOOT)
BOOT_PRE: C5.1, U5.7 (BOOT)
DIAG_I2C_SCL: R161.2, U1.23 (IO21), U27.16 (SCL), U28.16 (SCL), U29.16 (SCL)
DIAG_I2C_SDA: R160.2, U1.22 (IO14), U27.15 (SDA), U28.15 (SDA), U29.15 (SDA)
DIAG_U27_AIN0: C110.1, R130.2, R131.1, U27.11 (AIN0)
DIAG_U27_AIN0_UPPER1: R128.2, R129.1
DIAG_U27_AIN0_UPPER2: R129.2, R130.1
DIAG_U27_AIN1: C111.1, R134.2, R135.1, U27.10 (AIN1)
DIAG_U27_AIN1_UPPER1: R132.2, R133.1
DIAG_U27_AIN1_UPPER2: R133.2, R134.1
DIAG_U27_AIN2: C112.1, R138.2, R139.1, U27.7 (AIN2)
DIAG_U27_AIN2_UPPER1: R136.2, R137.1
DIAG_U27_AIN2_UPPER2: R137.2, R138.1
DIAG_U28_AIN0: C113.1, R142.2, R143.1, U28.11 (AIN0)
DIAG_U28_AIN0_UPPER1: R140.2, R141.1
DIAG_U28_AIN0_UPPER2: R141.2, R142.1
DIAG_U28_AIN1: C114.1, R146.2, R147.1, U28.10 (AIN1)
DIAG_U28_AIN1_UPPER1: R144.2, R145.1
DIAG_U28_AIN1_UPPER2: R145.2, R146.1
DIAG_U28_AIN2: C127.1, R168.2, R169.1, U28.7 (AIN2)
DIAG_U28_AIN2_UPPER1: R166.2, R167.1
DIAG_U28_AIN2_UPPER2: R167.2, R168.1
DIAG_U28_AIN3: C129.1, R178.2, R179.1, U28.6 (AIN3)
DIAG_U28_AIN3_UPPER1: R176.2, R177.1
DIAG_U28_AIN3_UPPER2: R177.2, R178.1
DIAG_U29_AIN0: C115.1, R150.2, R151.1, U29.11 (AIN0)
DIAG_U29_AIN0_UPPER1: R148.2, R149.1
DIAG_U29_AIN0_UPPER2: R149.2, R150.1
DIAG_U29_AIN1: C116.1, R154.2, R155.1, U29.10 (AIN1)
DIAG_U29_AIN1_UPPER1: R152.2, R153.1
DIAG_U29_AIN1_UPPER2: R153.2, R154.1
DIAG_U29_AIN2: C117.1, R158.2, R159.1, U29.7 (AIN2)
DIAG_U29_AIN2_UPPER1: R156.2, R157.1
DIAG_U29_AIN2_UPPER2: R157.2, R158.1
EMMC_CLK: U1.31 (IO38), U14.M6 (CLK)
EMMC_CMD: R46.2, U1.32 (IO39), U14.M5 (CMD)
EMMC_CORE_SW: L4.1, U15.7 (SW)
EMMC_DAT0: R47.2, U1.33 (IO40), U14.A3 (DAT0)
EMMC_DAT1: R48.2, U1.34 (IO41), U14.A4 (DAT1)
EMMC_DAT2: R49.2, U1.35 (IO42), U14.A5 (DAT2)
EMMC_DAT3: R50.2, U1.24 (IO47), U14.B2 (DAT3)
EMMC_DAT4: R51.2, U14.B3 (DAT4)
EMMC_DAT5: R52.2, U14.B4 (DAT5)
EMMC_DAT6: R53.2, U14.B5 (DAT6)
EMMC_DAT7: R54.2, U14.B6 (DAT7)
EMMC_DS: R55.1, U14.H5 (DS)
EMMC_VCC_3V3: C64.1, C65.1, C68.1, C69.1, L4.2, R58.1, R140.1, U14.E6 (VCC), U14.F5 (VCC), U14.J10 (VCC), U14.K9 (VCC), U15.6 (VOS)
EMMC_VDDi: C63.1, U14.C2 (VDDi)
FB_3V3: R5.1, R28.2, U7.5 (FB)
FB_3V3_SERIES: R4.2, R28.1
FB_PRE: R3.1, R27.2, U5.5 (FB)
FB_PRE_SERIES: R2.2, R27.1
GND: C1.2, C2.2, C3.2, C4.2, C6.2, C7.2, C8.2, C9.2, C10.2, C11.2, C13.2, C14.2, C15.2, C16.2, C17.2, C18.2, C19.2, C20.2, C21.2, C22.2, C30.2, C31.2, C32.2, C33.2, C34.2, C35.2, C36.2, C37.2, C38.2, C39.2, C40.2, C41.2, C42.2, C43.2, C44.2, C45.2, C46.2, C47.2, C48.2, C49.2, C50.2, C51.2, C52.2, C53.2, C54.2, C55.2, C56.2, C57.2, C58.2, C59.2, C60.2, C61.2, C62.2, C63.2, C64.2, C65.2, C66.2, C67.2, C68.2, C69.2, C70.2, C71.2, C72.2, C73.2, C74.2, C75.2, C76.2, C77.2, C78.2, C79.2, C80.2, C81.2, C82.2, C83.2, C84.2, C85.2, C86.2, C87.2, C89.2, C90.2, C92.2, C93.2, C95.2, C96.2, C97.2, C98.2, C100.2, C110.2, C111.2, C112.2, C113.2, C114.2, C115.2, C116.2, C117.2, C118.2, C119.2, C120.2, C121.2, C122.2, C123.2, C124.2, C125.2, C127.2, C128.2, C129.2, D1.2 (A2), D3.2 (A2), D100.3 (common), D101.3 (CC), D104.3 (CC), J1.4, J1.7, J1.10, J1.13, J1.16, J1.22, J1.25, J1.28, J1.32, J2.2 (Ext), R1.2, R3.2, R5.2, R6.2, R11.2, R14.2, R17.2, R20.2, R23.2, R24.2, R33.2, R35.2, R38.2, R41.2, R44.2, R55.2, R57.2, R59.2, R61.2, R63.2, R68.2, R72.2, R113.2, R115.2, R122.2, R124.2, R131.2, R135.2, R139.2, R143.2, R147.2, R151.2, R155.2, R159.2, R169.2, R179.2, R180.2, TP3.1, U1.1 (GND), U1.40 (GND), U1.41 (GND), U2.2 (SDx), U2.3 (SCx), U2.6 (GND), U2.7 (GND), U3.7 (VDD_USB), U3.10 (GND), U3.12 (GND), U3.13 (GND), U3.24 (GND), U4.9 (DGND), U4.14 (AGND), U5.1 (PGND), U5.9 (EP), U6.3 (GND), U6.6 (GND), U6.9 (EP), U7.1 (PGND), U7.9 (EP), U8.11 (V-), U9.2 (V-), U10.2 (GND), U11.4 (GND), U12.3 (GND), U12.6 (GND), U12.9 (EP), U13.11 (V-), U14.A6 (VSS), U14.C4 (VSSQ), U14.E7 (VSS), U14.G5 (VSS), U14.H10 (VSS), U14.J5 (VSS), U14.K8 (VSS), U14.N2 (VSSQ), U14.N5 (VSSQ), U14.P4 (VSSQ), U14.P6 (VSSQ), U15.1 (PGND), U15.4 (AGND), U15.5 (FB), U15.9 (PAD), U16.2 (GND), U17.2 (GND), U18.2 (GND), U19.2 (GND), U20.7 (VSS), U21.2 (GND), U22.3 (GND), U23.6 (GND), U24.6 (GND), U25.6 (GND), U26.4 (GND), U27.1 (A0), U27.2 (A1), U27.4 (DGND), U27.5 (AGND), U28.2 (A1), U28.4 (DGND), U28.5 (AGND), U29.1 (A0), U29.4 (DGND), U29.5 (AGND), U30.6 (GND), U31.3 (A), U100.2 (GND), U100.8 (S), Y1.2 (G), Y1.4 (G)
GNSS_ANT_FAULT_N: R25.1, U10.4 (FAULT)
GNSS_LNA_EN: R24.1, U3.14 (LNA_EN), U10.3 (EN)
GNSS_PPS: U1.7 (IO7), U3.3 (TIMEPULSE)
GNSS_RX_IN: U1.10 (IO17), U3.21 (RXD/SPI_MOSI)
GNSS_TX_OUT: U1.11 (IO18), U3.20 (TXD/SPI_MISO)
IMU_CS: R31.2, U1.18 (IO10), U2.12 (CS)
IMU_INT1: U1.6 (IO6), U2.4 (INT1)
MCU_BOOT: R30.2, TP5.1, U1.27 (IO0)
MCU_BOOT46: R33.1, U1.16 (IO46)
MCU_EN: C47.1, R29.2, TP4.1, U1.3 (EN), U16.6 (RESET), U17.6 (RESET), U22.1 (A)
POD_5V_AUX: C125.1, D105.1 (A1), J1.21, R166.1, R180.1, U30.10 (OUT)
POD_5V_SENSOR: C17.1, C124.1, J1.5, J1.8, J1.11, J1.14, R6.1, R22.1, R60.1, R144.1, R162.1, U6.1 (OUT), U6.4 (FB), U30.1 (IN)
POD_12V_IN: D1.1 (A1), J1.3, Q1.2 (D)
POD_12V_PROTECTED: C1.1, C2.1, C3.1, C8.1, C9.1, C10.1, D2.1 (K), Q1.3 (S), R62.1, R128.1, U5.2 (VIN), U5.3 (EN), U7.2 (VIN), U7.3 (EN)
POD_AUX1_SIGNAL: J1.17, JP2.2 (B), R34.1
POD_AUX2_SIGNAL: J1.18, JP3.2 (B), R37.1
POD_AUX3_SIGNAL: J1.19, JP4.2 (B), R40.1
POD_AUX4_SIGNAL: J1.20, JP5.2 (B), R43.1
POD_CAN_N: D100.1 (A1), J1.2, R100.2, U100.6 (CANL)
POD_CAN_P: D100.2 (A2), J1.1, R100.1, U100.7 (CANH)
POD_FRONT_BRAKE_SIGNAL: J1.12, R16.1
POD_FRONT_FORK_SIGNAL: J1.6, R10.1
POD_GNSS_RF: D3.1 (A1), J2.1 (In), L3.2, U3.11 (RF_IN)
POD_REAR_BRAKE_SIGNAL: J1.15, R19.1
POD_REAR_SHOCK_SIGNAL: J1.9, R13.1
POD_TIRE_SUPPLY: C93.1, J1.31, R156.1, U25.10 (OUT)
POD_UART_RX: TP2.1, U1.36 (RXD0)
POD_UART_TX: TP1.1, U1.37 (TXD0)
POD_WHEEL_FRONT_SIGNAL: D102.3 (K1_A2), D104.1 (K1), J1.24
POD_WHEEL_FRONT_SUPPLY: C87.1, J1.23, R110.1, R148.1, U23.10 (OUT)
POD_WHEEL_REAR_SIGNAL: D103.3 (K1_A2), D104.2 (K2), J1.27
POD_WHEEL_REAR_SUPPLY: C90.1, J1.26, R119.1, R152.1, U24.10 (OUT)
POWER_FAIL_N: R65.2, U1.12 (IO8), U19.6 (RESET)
PRE_6V3: C6.1, C7.1, C16.1, C18.1, C20.1, C70.1, C86.1, C89.1, C92.1, C97.1, C98.1, L1.2, R2.1, R73.1, R77.1, R81.1, R132.1, U6.8 (IN), U11.2 (Vin), U12.8 (IN), U15.2 (VIN), U15.3 (EN), U23.1 (IN), U24.1 (IN), U25.1 (IN), U26.8 (VCC)
REF_CAP_NODE: C22.1, R7.2
REF_DIV: C39.1, R22.2, R23.1, U9.3 (+IN)
REF_NR: C21.1, U11.5 (Trim/NR)
REVERSE_GATE: D2.2 (A), Q1.1 (G), R1.1
SENSOR_FAULT_N: R64.2, U1.25 (IO48), U18.6 (RESET)
SENSOR_POWER_AUX_DVDT: C126.1, U30.8 (dVdT)
SENSOR_POWER_AUX_ILIM: R165.1, U30.7 (ILIM)
SENSOR_POWER_AUX_OVP: R163.2, R164.1, U30.3 (OVP)
SENSOR_POWER_AUX_RTN: C126.2, R164.2, R165.2, U30.5 (RTN), U30.11 (EP_RTN)
SENSOR_POWER_AUX_UVLO: R162.2, R163.1, U30.2 (UVLO)
SENSOR_POWER_FRONT_DVDT: C88.1, U23.8 (dVdT)
SENSOR_POWER_FRONT_ILIM: R76.1, U23.7 (ILIM)
SENSOR_POWER_FRONT_OVP: R74.2, R75.1, U23.3 (OVP)
SENSOR_POWER_FRONT_RTN: C88.2, R75.2, R76.2, U23.5 (RTN), U23.11 (EP_RTN)
SENSOR_POWER_FRONT_UVLO: R73.2, R74.1, U23.2 (UVLO)
SENSOR_POWER_REAR_DVDT: C91.1, U24.8 (dVdT)
SENSOR_POWER_REAR_ILIM: R80.1, U24.7 (ILIM)
SENSOR_POWER_REAR_OVP: R78.2, R79.1, U24.3 (OVP)
SENSOR_POWER_REAR_RTN: C91.2, R79.2, R80.2, U24.5 (RTN), U24.11 (EP_RTN)
SENSOR_POWER_REAR_UVLO: R77.2, R78.1, U24.2 (UVLO)
SENSOR_POWER_TIRE_DVDT: C94.1, U25.8 (dVdT)
SENSOR_POWER_TIRE_ILIM: R84.1, U25.7 (ILIM)
SENSOR_POWER_TIRE_OVP: R82.2, R83.1, U25.3 (OVP)
SENSOR_POWER_TIRE_RTN: C94.2, R83.2, R84.2, U25.5 (RTN), U25.11 (EP_RTN)
SENSOR_POWER_TIRE_UVLO: R81.2, R82.1, U25.2 (UVLO)
SENSOR_REF_2V5: C40.1, U4.15 (Vref), U9.1 (OUT), U9.4 (-IN)
SETPOINT_5V: R7.1, U6.5 (ADJ), U11.6 (Vout), U12.5 (ADJ)
SPI_MISO: U1.21 (IO13), U2.1 (SDO), U4.12 (Dout), U20.12 (SDO)
SPI_MOSI: U1.19 (IO11), U2.14 (SDA), U4.11 (Din), U20.11 (SDI)
SPI_SCK: U1.20 (IO12), U2.13 (SCL), U4.13 (CLK), U20.10 (SCK)
SUP_U16_CT: C71.1, U16.5 (CT)
SUP_U16_SENSE: R56.2, R57.1, U16.1 (SENSE)
SUP_U17_CT: C73.1, U17.5 (CT)
SUP_U17_SENSE: R58.2, R59.1, U17.1 (SENSE)
SUP_U18_CT: C75.1, U18.5 (CT)
SUP_U18_SENSE: R61.1, R181.2, U18.1 (SENSE)
SUP_U18_TOP_SERIES: R60.2, R181.1
SUP_U19_CT: C77.1, U19.5 (CT)
SUP_U19_SENSE: R62.2, R63.1, U19.1 (SENSE)
SW_3V3: C12.2, L2.1, U7.8 (SW)
SW_PRE: C5.2, L1.1, U5.8 (SW)
THERM_AUX1_SELECT: JP2.1 (A), R170.2
THERM_AUX2_SELECT: JP3.1 (A), R171.2
THERM_AUX3_SELECT: JP4.1 (A), R172.2
THERM_AUX4_SELECT: JP5.1 (A), R173.2
THERM_BIAS_IN: D105.3 (K1_A2), R174.1
THERM_BIAS_MID: R174.2, R175.1
THERM_EXC_2V495: C128.1, R170.1, R171.1, R172.1, R173.1, R175.2, R176.1, U31.1 (K), U31.2 (REF)
TIRE_CAN_CS: R66.2, U1.8 (IO15), U20.13 (nCS)
TIRE_CAN_GPIO1: R72.1, U20.8 (GPIO1)
TIRE_CAN_H: D101.1 (K1), J1.29, J1.33, R70.1, U21.7 (CANH)
TIRE_CAN_INT_N: R67.2, U1.9 (IO16), U20.4 (INT)
TIRE_CAN_L: D101.2 (K2), J1.30, J1.34, JP1.2 (B), U21.6 (CANL)
TIRE_CAN_OSC1: C81.1, U20.6 (OSC1), Y1.1
TIRE_CAN_OSC2: C82.1, U20.5 (OSC2), Y1.3
TIRE_CAN_RX: U20.2 (RXCAN), U21.4 (RXD)
TIRE_CAN_SILENT: R71.2, U21.8 (S), U22.4 (Y)
TIRE_CAN_TERM: JP1.1 (A), R70.2
TIRE_CAN_TX: R69.2, U20.1 (TXCAN), U21.1 (TXD)
TIRE_CAN_TX_ENABLE: R68.1, U20.9 (GPIO0_XSTBY), U22.2 (B)
TWAI_RX: U1.5 (IO5), U100.4 (RXD)
TWAI_TX: U1.4 (IO4), U100.1 (TXD)
VCC_3V3: C11.1, U7.6 (VCC)
VCC_PRE: C4.1, U5.6 (VCC)
WHEEL_FRONT_CAPTURE: R118.2, U1.39 (IO1)
WHEEL_FRONT_DIODE_OUT: D102.2 (K2), R112.1
WHEEL_FRONT_FILTERED: C95.1, R112.2, R113.1, U26.2 (IN1-)
WHEEL_FRONT_OUT: R116.1, R117.2, R118.1, U26.1 (OUT1)
WHEEL_FRONT_PULLUP: D102.1 (A1), R111.2
WHEEL_FRONT_PULLUP_MID: R110.2, R111.1
WHEEL_FRONT_THRESHOLD: R114.2, R115.1, R116.2, U26.3 (IN1+)
WHEEL_REAR_CAPTURE: R127.2, U1.38 (IO2)
WHEEL_REAR_DIODE_OUT: D103.2 (K2), R121.1
WHEEL_REAR_FILTERED: C96.1, R121.2, R122.1, U26.6 (IN2-)
WHEEL_REAR_OUT: R125.1, R126.2, R127.1, U26.7 (OUT2)
WHEEL_REAR_PULLUP: D103.1 (A1), R120.2
WHEEL_REAR_PULLUP_MID: R119.2, R120.1
WHEEL_REAR_THRESHOLD: R123.2, R124.1, R125.2, U26.5 (IN2+)

Notes on the sheet:
ADC
Sensor input dividers and buffers
Optional thermistor excitation - qualification pending
TIRE protected sensor power - validation pending
3V3 regulator (U7) and 3V3 bulk
FRONT protected sensor power - validation pending
Separate eMMC core supply - qualification pending
Auxiliary input buffers - candidate
REAR protected sensor power - validation pending
Independent rail supervision - qualification pending
Rail diagnostics - qualification pending
Power entry and reverse protection
GNSS receiver and antenna feed
CAN transceiver
MCU
6V3 pre-regulator (U5)
5V reference, sensor and CAN supplies
IMU
Auxiliary power and diagnostic - qualification pending
Test points
eMMC interface - qualification pending
Pod connector
Dedicated tire CAN - power and validation pending
Hall input conditioning - qualification pending
