halbritt/fome-mc/(commit log)

2026-10-16 Initial Atlas-clone STM32H7 KiCad project and JLCPCB BOM/CPL exports
2026-10-16 Add pinned CLI EDA toolchain, smoke fixture and agent skills
    Tooling only; no design file is changed.
    - toolchain/versions.toml, pyproject.toml, uv.lock: pins for KiCad 10.0.7
    stable (existing install), stock libraries, ngspice 42, KiBot 1.9.1,
    kicad-happy v2.3.1 (06840467ad0f), PDF tools; isolated venv that sees
    only KiCad's pcbnew and wx bindings from the system.
    - toolchain/bootstrap.sh: idempotent install/repair, then doctor.
    - toolchain/eda.py + Makefile: doctor, erc, drc (with schematic parity),
    netlist, export (native PDF/SVG/BOM + KiBot bundle from the DRC-checked
    board), analyze (kicad-happy schematic/PCB/cross/SPICE), simulate
    (ngspice control script; .meas validated),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
2026-10-16 Record toolchain smoke results and read-only design baseline
    - reports/toolchain/smoke: 18/18 integration checks PASS (summary.json,
    junit.xml, per-check evidence).
    - reports/toolchain/baseline: native ERC/DRC/parity JSON, connectivity,
    BOM, rendered PDFs and kicad-happy analysis for fome-mc @ c43ad7b and
    Polygonus-Universal-112 @ ddcf0f7 (all checks PASS; design findings are
    baseline facts), plus a light record of the fome-mc working tree as of
    2026-10-16 21:55Z (KiBot cannot parse the uncommitted stepper_etb sheet).
2026-10-16 fome-mc: implement integrated motorcycle ECU schematics, 474-part PCB, BOM/CPL, DESIGN.md, and VALIDATION.md
2026-10-16 Point toolchain/versions.toml [projects.fome-mc] to fome-mc.kicad_sch/.kicad_pcb
2026-10-17 Remediate power supply, main relay keep-alive, and schematic ERC to 0 errors
2026-10-17 FOMEMC-1: Default baro to external GM 12614970 / Delphi PS10150 1-bar sensor on J2-6 and remove U24 potting dam
2026-10-17 FOMEMC-3: Upgrade U25 soldered SDNAND from 512 MB (4 Gbit) to 4 GB (32 Gbit CSNP32GCR01-AOW)
2026-10-17 Add CAN1 motorsport telemetry pod, RaceChrono Pro & action camera integration guide (FOMEMC-4)
2026-10-17 Update all documentation, schematic SVG/PDF exports, and PCB/floorplan/pinout diagrams
2026-10-17 Add agent-driven PCB routing: KRT and Freerouting adapters with native KiCad grading
    toolchain/route.py runs either backend on an isolated copy of a KiCad project
    and grades the candidate with kicad-cli (refill+save, DRC with schematic
    parity) against the input's unchanged .kicad_pro/.kicad_dru, separating new
    findings from the input's own, plus semantic preservation checks
    (route_facts.py: outline, layers, stackup, nets/classes, pads, footprints,
    zones, keepouts, protected copper, new copper vs net class, scope).
    Process, routing and validation results are reported independently; exit
    codes 0/1/2/3.
    KRT runs with every relaxation, fallback and project writeback switched
    off. Freerouting ru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
2026-10-17 Routing: preserve existing copper and class widths on the real board; trial evidence
    Real-board trials on FOME-MC exposed three ways the backends altered the
    input despite their keep/no-neckdown settings, all caught by the grader:
    - KiCad's SES import rebuilds unlocked copper from the session, where
    Freerouting collapsed short segments and re-normalised junctions;
    - Freerouting's fanout stage necks traces to 3/4..1/2 of the class width
    regardless of automatic_neckdown;
    - KRT's net rescue moved existing stubs between layers and reworked
    copper on failed nets despite --keep-input-copper.
    Existing copper is now locked for the run (route_locks.py for KRT, the
    Specctra bridge for Freerouti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
2026-10-17 Fix DRV8825PWPR (U202) HTSSOP-28 symbol pinout, VREF divider, charge pump, and 0.20R sense resistors (FOMEMC-5)
2026-10-17 Routing: grade --dir chains against the origin; fix DSN scope split on parenthesised net names
    - route.py validate RUN --against ORIGIN (make route-validate AGAINST=) follows
    the recorded --dir inputs back to ORIGIN and grades with its input, baseline and
    protection over the union of the steps' scopes; refuses non-descendants.
    - --nets with only !exclusions starts from all nets.
    - route_specctra split_classes cut class headers at a '(' inside a quoted net name
    ("Net-(BT1-+)"), producing a DSN Freerouting could not parse on fome-mc for
    any partial scope. Quote-aware now, with a regression test.
    - Docs: hard-nets-first chaining.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
2026-10-17 Routing: publish chain-vs-origin grading; KRT hard-nets-first trial evidence
2026-10-17 Add MAX9924UAUB+ (U13/U14) differential VR conditioners and switch Hall Schmitt triggers (U8/U9/U10) to +3V3 (FOMEMC-6)
2026-10-17 Add D210 BZT52C6V8 BOOT0 threshold Zener, R217/R218/D211 PA9 VBUS sense divider/clamp, and SMCJ24A TVS protection on 12V_RAW and 12V_MR (FOMEMC-7)
2026-10-17 Routing: grade a Freerouting session saved before a kill; real-board chain trials
    - Freerouting can save its session at --router.job_timeout and keep running; a
    session it reported saved before the budget kill is now imported and graded.
    - Trials: finishing the open nets on a fully locked candidate fails on both
    backends (trial-krt-continue, trial-fr-on-krt); routing them first on the
    original input and the rest after (trial-krt-hardfirst[-rest]) gives the best
    result so far: 20 unconnected, 10 new warnings vs the original input.
2026-10-17 Routing smoke evidence: 15/15 (chain grading, parenthesised net names)
2026-10-17 Synchronize PCB footprints, netlist pad assignments, DNP flags, and zone priorities with schematic (FOMEMC-9)
2026-10-17 Complete FOMEMC-10 4-layer PCB routing, plane stitching, and DRC/export closure
2026-10-17 Routing: independent verification of 216eb9a (FOMEMC-10)
    0 unconnected / 0 errors / 0 parity confirmed with native DRC; notes the
    min_resolved_spokes 2->1 relaxation (24 starved thermals hidden), 0.127 mm
    tracks below the 0.254 mm class width, 15 moved footprints, zone/keepout edits.
2026-10-17 Verification of 216eb9a: ground paths of the 24 starved-thermal pads
    22 of 24 have a single spoke as their only ground connection; all are new in
    216eb9a (the parent's 27 were resolved).
2026-10-17 Verification of 216eb9a: narrow-track current assessment; FOMEMC-11
2026-10-17 Move PCB routing to the standalone kicad-route tool
    The routing wrapper, its KiCad helpers, integration tests, fixture board and
    generic skills now live in https://github.com/halbritt/kicad-route
    (~/git/kicad-route, installed with scripts/install.sh). fome-mc keeps:
    - make route-* targets, now thin calls to `kicad-route --out build/route`,
    plus make route-audit (grade a board commit against its parent);
    - toolchain/ROUTING.md as the project page with the real-board trial history;
    - the fome-pcb-routing project skill (fome-mc specifics and trial lessons;
    the generic kicad-route and krt-* skills are installed globally);
    - reports/toolchain/routing/fome-mc/ evidence (fixture evidence moved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
2026-10-17 Complete FOMEMC-11, FOMEMC-12, and FOMEMC-16: sync 492 PCB footprints, restore min_resolved_spokes=2 (0 starved thermals), enable teardrops, enforce >=1.2mm IGBT collector clearance, widen /IGN1..4_C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
2026-10-17 Add high-resolution 3D board renders
2026-10-17 Remediate FOMEMC-17..20: 50V X7R PSU caps & 42V INJ clamp DNP, U29 DS70005304F footprint + 1P3V bypass, HV_IGN 0.50mm clearance + U25 decoupling, and 0 ERC violations
2026-10-17 Makefile: route targets follow PROJECT; add campaign, blocked, spokes, floor, canary, corpus
    KICADROUTE-50: the route and route-audit targets hardcoded --board
    fome-mc.kicad_pcb. Every route target now takes --dir, --board,
    --schematic, --name and --library-dir from PROJECT's entry in
    toolchain/versions.toml (resolved once, on first use), so
    PROJECT=universal-112|fixture route and audit their own boards and runs
    land under build/route/runs/$(PROJECT)/. An unknown PROJECT stops with
    exit 2 before kicad-route runs.
    KICADROUTE-51: new targets route-campaign, route-blocked, route-spokes
    (RUN= attribution or BOARD= corridor plan), route-floor, route-canary,
    route-corpus-list/-check/-add; route-v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
2026-10-18 Remediate FOMEMC-22..27: sheet contracts, doc/BOM/netlist parity, 494-part BOM/CPL, Mode A2 VR + C38/C39, wide WBO heater buses, and 4x M4 holes with 0 DRC warnings
2026-10-18 Complete FOMEMC-21: reproducible fabrication package manifest and normalized Gerbers
2026-10-18 Refresh 2D schematic/PCB layer renders and 4K 3D ray-traced renders for final FOMEMC-21..27 board
2026-10-18 FOMEMC-28: telemetry-pod/ project skeleton, versions.toml entry, .gitignore exceptions and CHANGELOG entry
    Adds the empty telemetry-pod/ KiCad 10 project the agent-ee pod wave will
    generate into: placeholder .kicad_{pro,sch,pcb} written by KiCad's own tools
    (kicad-cli sch upgrade, pcbnew SaveBoard, stock template project), an empty
    sym-lib-table, an fp-lib-table with ampseal -> ${KIPRJMOD}/../libs/footprints/
    ampseal.pretty, and empty sheets/, contracts/, export/. Registers
    [projects.telemetry-pod] in toolchain/versions.toml so make doctor checks it and
    make erc/drc PROJECT=telemetry-pod run on its snapshots, tracks its export
    netlist/BOM/CPL in .gitignore like fome-mc's, and records the CHA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
2026-10-18 FOMEMC-31: reconcile telemetry document discrepancies and record the pod's 12 V source and 130/70 mm travel ranges
2026-10-18 telemetry-pod: requirements specification, revision 2
    Owner's tail-cowl telemetry pod requirements (Oct 17, 2026, revised Oct 18
    with the owner decisions of 2026-10-18 folded into the text: own 5 V sensor
    supply, harness power splice with own 2 A fuse, TE 776228-1 connector, CAN
    block composed from the wideband and PSU sheets, owner-bound DRC waivers,
    offline kicad-happy analyzer gate, JLCPCB stock capture with hand-fitted
    deviations, owner DFM upload and PREVIEW_REQUIRED obligations). This file is
    the single source of truth for the pod spec; agent-ee pins its fixture copy
    to these bytes (sha256 09e02c8d9471aabf...).
2026-10-18 FOMEMC-31: reconcile telemetry docs with revision 2 and re-pin identities
2026-10-18 Complete documentation audit across SHEET_CONTRACTS, WIRING_SV650_K7, POTTING_AND_ENCLOSURE, and toolchain docs
2026-10-19 Update telemetry-pod/REQUIREMENTS.md to specify unpotted enclosure unless proven necessary
2026-10-20 Update telemetry-pod/REQUIREMENTS.md line 61 with 2026-10-19 owner decision on board outline and double-sided placement
2026-10-20 Commit telemetry-pod v9 90x65 pilot snapshot and 2D/3D renders
    - PILOT SNAPSHOT (not a release): commits the owner-approved 4-layer 90x65 mm
    placed-and-routed board (driver-preparation-v9-90x65, board SHA256
    2938ee1ee2cae459c869ee5c4c8443e66322034736fe3fcbf4b5e56377ea1cfa), schematic,
    project files, project-relative symbol/footprint libraries, and 2D/3D renders
    under telemetry-pod/renders/; will be replaced by the clean-main requalified
    board once open items land.
    - agent-ee source SHA: a02c952 (main).
    - Router provenance: routed with the validated fix content from the rejected
    runtime prototypes kr63 (d7ceadf) and kr64 (670f5c6); mechanism superseded by
    pinning the fork halbri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
2026-10-20 Specify pod power integrity and soft logging-duration target
2026-10-20 Record owner-approved pod component temperature exceptions
2026-10-20 Capture canonical owner temperature exemptions and limitations
2026-10-20 Normalize power review checker and refresh its receipt
2026-10-20 Add independently checked telemetry rail supervision candidate
2026-10-20 Retain reviewed tire CAN inputs and Hall interface preparation
2026-10-20 Bound Hall pull-up fault heating and reject false switch diagnostics
2026-10-20 Prepare isolated protected wheel and tire power branches
2026-10-20 Validate complete sensor symbol syntax before accepting preparation
2026-10-20 Prepare independently checked dual Hall wheel inputs
2026-10-20 Select and review independent rail diagnostic ADC candidate
2026-10-20 Prepare independently checked rail diagnostic circuit
2026-10-20 Prepare protected auxiliary sensor supply and ninth rail diagnostic
2026-10-20 Correct AMPSEAL footprint against current drawing and native STEP geometry
2026-10-20 Prepare protected optional thermistor excitation and loaded-divider calibration
2026-10-20 Select diagnostic divider resistors and inventory expanded pod bindings
2026-10-20 Generate and independently verify expanded pod native schematic
2026-10-20 Correct MCP3208 tri-state output model with source-backed SPI review
2026-10-20 Bind 32 telemetry resistors to exact reviewed 10k identity
2026-10-20 Bind 28 telemetry resistors with exact supplier and manufacturer evidence
2026-10-20 Bind 45 telemetry capacitors with exact manufacturer evidence
2026-10-20 Bind ten remaining telemetry capacitors with captured stock and exact documents
2026-10-20 Bind telemetry power resistors to reviewed Vishay variants
2026-10-20 Bind selected gold AMPSEAL connector and preserve zero-stock evidence
2026-10-20 Add retained native XML BOM and ERC verification for component-fit source
2026-10-20 Verify expanded pod schematic units attributes and no-connect markers
2026-10-20 Select exact series resistors preserving sensor supervisor threshold
2026-10-20 Exercise actual series-divider short circuit in negative control
2026-10-20 Verify expanded supply sensing map and retain PCB inventory blocker
2026-10-20 Bind expanded connector and GPIO allocation to native schematic
2026-10-20 Expose expanded pod custom-pad indexing blocker before PCB generation
2026-10-20 Retain full expanded schematic visual findings and rendered evidence
2026-10-20 Regenerate expanded schematic with released emitter and corrected headings
2026-10-20 Exercise expanded board import and retain probe migration refusal
2026-10-20 Exclude ephemeral KiCad local preferences from evidence manifest
2026-10-20 Retain expanded pod native CAD assignment qualification
2026-10-20 Retain successful expanded board import with probe migration
2026-10-20 Exercise expanded parts manifest and retain probe-source refusal
2026-10-20 Record GSXR wheel fit and distinguish active electrical holds
2026-10-20 Record per-part temperature acceptance without verification waivers
2026-10-20 Retain reviewed split-divider wheel clamp study
2026-10-20 Track retained migration netlist and exclude local KiCad preferences
2026-10-20 Prepare reduced temperature acceptance for released verifier
2026-10-20 Retain reviewed storage-regulator placement diagnostic
2026-10-20 Declare pad-level electrical locality obligations for pod regulators
    Adds telemetry-pod/expansion/electrical-locality/pad-obligations: an
    agent-ee.electrical-locality/1 document with 15 obligations (33 pad pairs)
    for U5/U7 LMR36520, U15 TPS62162 and U26 LM2903B, each pair naming exact
    pads and nets with a design-owner-declared bound (D-PL-1) and a datasheet
    locator. Independent measurement on the frozen 17-group diagnostic board
    79cc1310: 20 pass, 13 exceed, 0 unknown; the unreleased AGENTEE-322 grader
    reports the identical defect set. Declares and measures only; no board,
    rule or CAD change, no adoption.
2026-10-20 Decide fine-pitch pad clearance and thermal-via drills (D-PCB-1)
    Adds telemetry-pod/expansion/design-rules: thermal vias under U1, U5,
    U6, U7 and U12 become 0.30/0.60 mm in patched footprint sources, keeping
    the 0.30 mm hole minimum; six scoped custom rules allow 0.15 mm
    pad-to-pad inside U2 and U16-U19 only, keeping 0.20 mm elsewhere.
    Native DRC on the frozen 17-group board removes exactly the 64 proposed
    findings with no new ones (341 -> 277). Rationale, alternatives,
    application and reversal are in the README. Decided autonomously under
    the owner's 2026-10-20 direction; not an adopted board.
2026-10-20 AGENTS: gating constraints need cited provenance; defaults are advisory
    Owner 2026-10-20: arbitrary specifications must not become hard limits.
    Three sessions stalled on agent-ee scaffold default clearances that no
    owner, manufacturer or datasheet set.
2026-10-20 design-rules: cited constraint provenance; thermal vias 0.30/0.70 mm
    constraints.json classes every expanded-project board-setup value as
    owner, manufacturer (JLCPCB capabilities, read 2026-10-20), datasheet,
    engineering or default; scaffold defaults are superseded and never gate.
    Thermal vias corrected to 0.30/0.70 mm so the 0.20 mm ring clears
    JLCPCB's 0.18 mm 2-layer minimum (0.60 mm gave 0.15 mm). Native DRC on
    the frozen board with the cited setup: 69 findings removed (64 proposed
    plus the 5 J2 copper-edge findings from the 0.50 mm default), 22 silk
    legibility/overlap findings surfaced, 0 copper findings new.
2026-10-20 design-rules: record 4-layer JLC04161H-7628 stack as decision D-PCB-2
    The scaffold stackup equals JLCPCB's standard 4-layer 1.6 mm stack and is
    adopted with rationale (BGA-153 eMMC fanout, buck ground plane, RF
    reference). Annular and trace figures are quoted for multilayer.
2026-10-21 design-rules: via minimum 0.50/0.10 mm from JLCPCB via capability; record D-PCB-3
    The 0.70 mm / 0.20 mm via minimum applied the PTH annular-ring figure to
    vias and contradicted the 0.60/0.30 net-class via the router uses (first
    KRT diagnostic: 398 via findings). Vias now cite JLCPCB's published via
    minimum (0.25 mm on 0.15 mm) with 2x margin; thermal vias stay 0.30/0.70
    as a deliberate choice. Records the eMMC interior-ball fanout as open
    design item D-PCB-3 with its two candidate answers.
2026-10-21 Retain first routing diagnostic of the expanded pod (KRT, 142/194 nets)
    kicad-route receipts for the KRT run on the frozen 17-group placement
    with D-PCB-1 applied: 142 of 194 nets routed, 4656 tracks, 404 vias,
    52 nets open (eMMC BGA fanout, sensor-power control nets, some analog).
    Under the corrected via rule the candidate has only 32 dangling-stub
    findings and 101 unconnected items left of 499. Diagnostic evidence on
    an unqualified placement; not an adopted board.
2026-10-21 pad-obligations rev 2: C69 bulk output capacitor bounds 8.0/8.5 mm
    The 322 guided packer exhausted 200k steps with C69 unplaced at 6.5/7.0.
    C69 is the second 22 uF output capacitor; C68 keeps the tight bound.
    Frozen-board measurement unchanged (20 pass, 13 exceed).
2026-10-21 design-rules: D-PCB-3 analysis, interior eMMC balls are pours plus an unused DS
2026-10-21 Retain cluster-anchored placement candidate; record D-PCB-4 and D-PCB-5
    telemetry-pod/expansion/placement-candidate: regulator clusters placed by
    construction (U5/U7 witness poses; U15/U26 by constrained search), locked
    in the seed, remaining 290 parts placed by the released origin-group
    packer (main 39a6b62) in 276 s. 331/331 placed, judgment pass, all 33
    pad obligations pass, cited-rules DRC has no copper finding except the 5
    J2 edge findings. Candidate pending independent review; not adopted.
    design-rules: D-PCB-4 (J2 anchor 0.20 mm inboard, from the footprint's
    fab datum) and D-PCB-5 (planes.json: In1 GND, In2 +3V3) recorded.
2026-10-21 placement-candidate: independent review rejects iteration 1 (IMU and inductor stacking)
    Review found U15/L4 under the fixed IMU U2 through the board, L1 next
    to U2 and over L4, the RF corridor filled, and F-side parts over the
    eMMC BGA; also corrects the README's DRC claims (copper-edge 0 under the
    cited rules; 44 drill findings remain on the unpatched candidate).
    Cluster internals, courtyards, obligations and anchors verified.
2026-10-21 Retain placement candidate iteration 2 (IMU isolation, J2 datum, GNSS by SMA)
    Cross-side clearance and obstacles fix the review's blocking findings:
    all switching parts >= 11 mm from the IMU on either side, no inductor
    stacking, J2 0.20 mm inboard (D-PCB-4), U3 fixed facing J2. Released
    packer: 331/331 in 1429 s, judgment pass; 33/33 pad obligations; cited
    rules DRC on a via-patched copy has no copper finding at all. Pending
    independent review; not adopted.
2026-10-21 placement-candidate: iteration-2 independent review (conditional proceed; L3 and U14 fan-out to fix)
2026-10-21 Retain placement candidate iteration 3 (eMMC under the MCU, bias tee in corridor)
    U14 fixed under the ESP32 body on B clear of its thermal vias with a
    front keep-out; U3 lowered to face J2; L3 fixed in the RF corridor.
    Released packer 331/331 in 866 s, judgment pass; 33/33 pad obligations;
    cited-rules DRC on the committed board has zero copper findings. Pending
    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
2026-10-21 routing-diagnostic: planed iteration 2 (In1 GND, In2 +3V3) routed 143/194 with 6 warnings
2026-10-21 pad-obligations: withdraw "design-owner" label; bounds are advisory pending spec derivation
    Owner direction 2026-10-21 (via agent-449): limits must be validated
    against a component spec or JLCPCB manufacturability. The 33 bounds were
    agent-chosen, so their citations now say so and class them advisory; the
    13 exceedances on the frozen board are no longer called failures. The
    derivation against AGENTEE-337's per-pair JLCPCB floor table is the next
    revision.
2026-10-21 placement-candidate: iteration-3 review (proceed); design-rules: D-PCB-6 RF keep-out, engineering class clarified
    Iteration 3 passes independent review with no placement findings and is
    fit for adoption review after routing, conditional on the patched vias,
    D-PCB-3, an unbroken GND reference under the GNSS line and silk. D-PCB-6
    records the inner-layer keep-out under that line for the routing pass.
    The engineering class now states that the cited figure is the floor and
    the agent-chosen margin is advisory.
2026-10-21 routing-diagnostic: planed iteration 3 (136/194, 5 warnings); D-PCB-7 no tracks on plane layers
2026-10-21 design-rules: D-PCB-3 v2 (0.22 mm eMMC pads, BGA_EMMC net class 0.09/0.09, JLCPCB 0.09 floors)
2026-10-21 D-PCB-3 experiment: eMMC nets route completely with 0.22 mm balls; GND pour under U14 fails
2026-10-21 routing-diagnostic: full pass with inner layers closed (114/194); D-PCB-7 v2 opens In2 to signals
2026-10-21 routing-diagnostic: In2-open pass (136/194); routing plateau table across six attempts
2026-10-21 Decide D-PCB-3 v3 (U14 via-in-pad), D-PCB-8 silk policy, D-PCB-9/10/11; patched LFBGA-153 footprint and evidence
2026-10-21 Drop the eMMC for a microSD socket (owner decision 2026-10-21): storage-microsd stage, D-PCB-3 retired, D-PCB-12, locality and block updates
2026-10-21 D-PCB-10: J1 is the right-angle 35-position AMPSEAL 1-776163-1 (owner ruling 2026-10-21); correct the earlier text
2026-10-21 blocks README: C16/C20 stay in supplies-5v (correction)
2026-10-21 Prepare the next placement pass: D-PCB-13 card envelope in the J3 courtyard, silk policy text-size fix, via-patched base seed
2026-10-21 part-bindings: JLCPCB stock capture for the microSD inventory (81 ids; J1 1-776163-1 at zero assembly stock)
2026-10-21 microsd-stock: per-board quantity check (J1 short; 100 nF 0603 and ADS1119 tight)
2026-10-21 blocks: C38/C41/C43/C44 are other ICs' bypass capacitors, not buck-3v3 members
2026-10-21 blocks: regulator clusters carried as fixed parts (library materialize refuses on rotation-dependent courtyard identity); 17 blocks
2026-10-21 placement-candidate: iteration 6, two-level placement on released agent-ee 15e92c9 (17 blocks, fixed regulator clusters, obligations 26/26, cited DRC clean)
2026-10-21 placement-candidate: iteration-6 independent review (reject: U4 in the microSD insertion lane)
2026-10-21 D-PCB-13 v2: J3 courtyard covers the full microSD insertion lane (iteration-6 review: U4 in the lane)
2026-10-21 D-PCB-13 v2 footprint: write 29 the way KiCad does (the saved-board write-scope check compares formatted text)
2026-10-21 placement-candidate: iteration 7, two-level placement with the microSD insertion lane kept clear (obligations 26/26, cited DRC clean)
2026-10-21 placement-candidate: iteration-7 review (conditional proceed); D-PCB-14 accepts the 90 mm SD bus at 20 MHz SDR
2026-10-21 D-PCB-15: EFUSE_SET net class 0.15/0.15 mm for eFuse setting and supervisor sense nets
2026-10-21 D-PCB-16: owner keeps the ESP32 antenna overhang; enclosure pocket requirements
2026-10-21 D-PCB-13 v3 (owner): microSD slot points off the left edge; storage block dissolved, regulator blocks back on the library path
2026-10-21 D-PCB-15 withdrawn: the EFUSE_SET class did not route the eFuse nets; loosening removed
2026-10-21 KICADROUTE-91: corrected-policy diagnostic input from the iteration-7 microSD routing input
    Not a production placement, and no routing was run on it. This is a separate copy of the
    archived iteration-7 routing input (ca2.kicad_pcb 67782a5d…, identity bound through
    ../iteration-7 receipts and ../SHA256SUMS). Two native rule areas were added; nothing else
    changed:
    - D-PCB-7 v2: In1.Cu no tracks over the board outline (vias allowed)
    - D-PCB-6: In1.Cu+In2.Cu no tracks/no vias, x 76..88 y 26.5..30.6 mm. The U3 RF pad and
    J2 pin geometry match the captured coordinates exactly.
    Proof is in the new directory:
    - pcbnew reload inspection, with a byte-identical re-save
    - 11 native-DRC fixtures (al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
2026-10-22 KICADROUTE-91: correct stale wording in the corrected-policy diagnostic README and receipt
    Wording and receipt metadata only. The fixture is a native corrected-policy diagnostic
    input: no production placement, routability comparison or routed-success claim. The
    historical 203/235, 55/32, 51/30 counts and ten lost nets are unresolved and ineligible
    for promotion; allowed_via_spans is a summary (the native RF rule area supplies the
    spatial exclusion); the inactive RF_50 rule is disclosed; open items G1 (remaining M1b)
    and G3 (unrun corrected-policy route) are named. README, policy-receipt.json,
    make_receipt.py and SHA256SUMS were regenerated; the prior hashes are recorded in
    receipt_history. c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
2026-10-22 KICADROUTE-91: reconcile corrected-policy receipt and README with KICADROUTE-98 partition evidence
    Adds a superseding annotation: the capped-report inference (DRC unconnected list capped at
    499) is superseded by the KICADROUTE-98 native partition evidence (kicad-route 367578e4,
    evidence.tar.gz f7d030f6..., evidence-index.json 818113e2...; input identity 967891c9,
    identity.json 2ecccfae...). All ten alleged lost nets were already incomplete; all 53
    complete origin nets and five partial groups were preserved; 55/32 and 51/30 are
    measurements, not defects. Remaining ineligibility kept distinct: the changed policy needs
    new grading, historical routes are not current-policy qualification, and the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
2026-10-22 AGENTEE-197: recompile the Rev-3 pod scope on the microSD source (four stages, RF profile, actual-limit temperature obligations)
    Recapture the spec record (REQUIREMENTS.md gained POD-CD-STORAGE) and compile a
    new requirement map with agent-ee 1da2763 into
    telemetry-pod/expansion/requirements/rev3-microsd/:
    - stages.order schematic, placement, routing, verification (pod_driver order),
    subjects from the 305 native references of the current microSD schematic,
    erc/netlist, placement-projected DRC, routed DRC, copper facts and the
    fab_package done gate (AC-6 owner DFM/preview kept as a limitation);
    - the existing agent-ee profiles/pod-review.json (pod-rf-review-v1, rf role)
    embedded unch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
2026-10-22 AGENTEE-197: scope-b corrections: corner holes as placement subjects; recorded temperature authority (delegated engineering acceptance for U3/J3)
    Placement subject now expects the 305 schematic references plus the four
    board-only corner holes H1-H4 from placement-inputs/envelope.json (309).
    POD-ME-HOLES states each hole's declared position, drill, plating and
    tolerance with the envelope hash. The stage witness only grades missing
    references, and the executable board_envelope mounting-holes/1 binding is
    refused by the compiler until the envelope's fab profile is captured, so
    position and drill stay NOT CHECKED. placement_subjects.py checks the map
    against the schematic and envelope.
    Temperat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
2026-10-22 AGENTEE-207: production capture for the Rev-3 microSD pod (manifest, deviations, patched CAD, envelope) and Phase B to the real dry run
    Phase A (telemetry-pod/expansion/production-capture/, build.py --check reproduces byte for byte):
    - refs.json: the 305 microSD references bound to the source schematic and intent.
    - agent-ee.parts/1 for 304 references (293 named canonical records, 6 probes,
    5 copper features) re-verified against the microSD intent; qualify_manifest
    CAD ok/pass/complete. J3 C114218 is an exact missing capture (j3-source.json:
    catalog replayed, failed acquisition retained, URLs and facts needed).
    - part-refs/1 and part-deviations/1 (J1 hand fit under POD-AC-5, zero stock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
2026-10-22 AGENTEE-207: J3 C114218 captured and bound; writer intent with Qualification ledger and source-derived ratings; composed envelope/locality scope; real dry run prepares; 18-block repack
    - J3 is a named part: agent-509's DigiKey-mirror DM3 catalog capture (ab978e9d, manifest
    795abc9d) with the failed Hirose/LCSC/Mouser acquisitions, the record regenerated by
    part_record at the repository root (only its three paths differ from origin 70525df3),
    and the re-read detect mapping (pad 9 = B/DET_B/SD_CD, pad 10 = A/DET_A/GND). The
    limitations (2010.6 catalog not latest drawing, p3 609-0031-0, NO switches contradicting
    the catalog "No", p2 -25..85 C incl. current rise) stay in j3-source.json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
2026-10-22 AGENTEE-207: bounded budget in the plan of record, assembly_readiness layer carries rating_provenance, production scope separated from the preparation probe
    - pipeline.py: the plan of record declares max_iterations 2 and placement
    timeout_s 1500 (authorized 900-1500 s); pod_driver refuses it (8-100 floor,
    a driver policy, not an engine limit) and the refusal is kept. The probe
    plan's driver-default campaign (10 / 8400 s) is refused by an explicit
    authorized-budget gate and set aside as campaign.NOT-AUTHORIZED.json (hash
    equal to the driver receipt); it is never raised to 8 or edited.
    - Assembly layer: one assembly_readiness check over the retained v9 pilot JLC
    capture, deviations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
2026-10-22 AGENTEE-207: close review-pod-capture-chain H1/H3; fresh read-only 81-id JLC stock capture; J1 hand-fit source chain
    H1: binding-fill, emit-schematic, forward-annotate and add-planes declarations
    mount the agent-ee export's src (the import root those step builders expect);
    stage producers.import_from_declared_mount imports every declared module from
    its actual mount (export root fails as the control). Import only, not native
    execution.
    H3: repack.py binds the complete library refusal and writes
    block-obligations.json (pre-6v3, buck-3v3: board-region copper/native-check and
    witness-pose obligations, unresolved). pipeline.py adds a blocks layer: NOT
    CHECKED limitations on both scopes plus a p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
2026-10-22 FOMEMC-207: J1 mating-interface source packet (AGENTEE-207; evidence only)
    Source-bound review of header 1-776163-1 (C596198) to its mate, panel and
    board thickness, under connector-candidate/mating-interface/:
    - mate 776164-1 (black, key slots 6/20) SOURCED from K1 notes 3/5 and
    TE 2293782 E2 (PCN-24-229857 redline, marked PRELIMINARY);
    - panel cutout/mounting and PCB thickness PARTIAL (K1 sheet 2; TE gives
    1.57 mm nominal only, pod board is 1.6 mm, allowed range unresolved);
    - latch/CPA/tool and harness exit PARTIAL (114-16016 rev G, superseded);
    - mated envelope and installed enclosure/harness/tool access UNRESOLVED.
    TE DDEController returned 403 for every request (including the K1 co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
2026-10-22 AGENTEE-207: close review-pod-capture-j5b H1-H3 (one canonical block-limitation validator; only verified library refusals; candidate identity and captured seed bytes)
    H1: block_obligations renders the canonical NOT CHECKED line of every expected
    obligation from the rebuilt obligation and the verified record digest
    (record 'limitations'). block_limitation_problems is the one validator used by
    compose_blocks, the candidate, production-scope and actual-packet guards: every
    line naming a reserved id (any case, any status prefix) is an occurrence; each
    expected obligation must occur once, canonically; any other POD-DERIVED-BLOCK
    line refuses. Changed meaning, digest or disposition, contradictory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
2026-10-22 AGENTEE-446: record owner-accepted J1 board thickness; enclosure/harness are design deliverables
    Owner decision 2026-10-22 (owner -> agent-509 -> agent-449; Cairn d162e001,
    b706da93) captured as mating-interface/sources/owner-decision-2026-10-22-board-thickness.txt
    and registered in interface.json sources and SHA256SUMS.
    - interface.json pcb_thickness: PARTIAL -> SOURCED, citing the owner decision,
    the captured JLCPCB fab profile finished_thickness_tolerance (+/-10% for
    nominal >= 1.0 mm) and K1 (layout titled for 1.57 mm). The rev G 1.57
    +/-0.13 mm interval is kept as historical context, marked not a gate.
    - installed_enclosure_fit / installed_harness stay UNRESOLVED, reworded as
    f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
2026-10-22 AGENTEE-446: record the owner's component-side through-hole fit rule as the J1 thickness basis
    J1 fits by the owner's rule: at least +/-10% of TE's recommended 1.57 mm,
    band 1.413-1.727 mm, with the 1.6 mm board inside (AGENTEE-448). The
    JLCPCB +/-10% finished-thickness tolerance stays recorded, but only as a
    separate board-side fact, not the fit basis.
    Coordinator correction (Cairn 9561cd0c). The owner-decision source and
    SHA256SUMS are rehashed; check.py --self-test passes; no third-party
    source or receipt changed.
2026-10-22 AGENTEE-446: relabel the J1 thickness decision as relayed and agent-drafted, not owner-stated
    The owner did not write or review the wording of
    owner-decision-2026-10-22-board-thickness.txt. An fm446c worker drafted
    it and agent-449 rewrote it from decisions agent-509 relayed. At the
    owner's direction it is relabelled owner-relayed (agent-drafted,
    unconfirmed), and it now quotes the three relays verbatim (Cairn
    d162e001, b706da93, 9561cd0c; body sha256 recorded) as the authoritative
    record. The interface source class and the README provenance are updated
    to match. check.py --self-test passes; SHA256SUMS rehashed.
2026-10-22 AGENTEE-446: capture the owner TE drop (114-16016 S3, 2293782 E5, CVM_776164-1 rev F STEP) and verify the J1 lead claims
    Evidence only, J1 mating-interface packet. S3, E5 and the plug STEP zip are
    captured in sources/, verified against the drop manifest; K1 in the drop is
    byte-identical to the existing capture and reg343.pdf duplicates S3. The new
    te_drop_2026_10_22 record verifies lead claims (a), (c) and the K1 check, and
    records (b), (d) and (e) as PARTIAL with the exact reasons. It also records the
    nominal footprint check against S3 Fig. 13a / K1 (no mismatch) and one TE
    source difference (panel opening height, K1 24.2-25.2 vs S3 24.8-25.2; K1
    governs). check.py enforces the drop record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
2026-10-22 Telemetry-pod target scoreboard (agent-521 policy) and AGENTS.md programme pointer
    SCOREBOARD.md is agent-521's corrected scoreboard, copied byte-for-byte
    from its prepared rollout. It keeps connected nets (203/235, 205/235) and raw
    unresolved connections (55, 51) in separate columns, as result.json and the
    routing-diagnostic README record them. Historical iteration-7 runs are
    diagnostics, not a production baseline. The AGENTS.md item is appended at
    the end, so existing item lines and hashes are unchanged. Owner instruction to
    agent-521, relayed in Cairn 2df0e067.
2026-10-22 AGENTEE-207: j6 authentic two-iteration production preparation on agent-ee 81e387ee; production schematic re-emitted as the telemetry-pod project (AGENTEE-445)
    Pinned agent-ee 81e387ee (AGENTEE-197 landed, hand-fit chain 08ddaa17, emitter
    field order 41e91eca). pipeline.py verifies the export blob by blob against that
    commit. Everything ran in the pinned CI image (ae-ci-exec, network none).
    - Plan schema: requirement_source telemetry-pod-rev3, bound to fome-mc's pinned
    Revision 3 capture (requirements/compiled), added as scope baseline sources.
    The microSD spec equals it except the POD-CD-STORAGE row (checked); its own
    selection refuses unapproved-source (kept).
    - Envelope: the five g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
2026-10-22 AGENTEE-207: derive the Rev-3 pod io-map mechanically from the microSD source netlist
    telemetry-pod/pinout-checks/generate.py writes io-map.csv, bindings.json and
    paths.json from a kicad-cli netlist of expansion/storage-microsd/project
    (sha256 4da27afc..., pinned in pinout-checks/source.json). It covers 54 rows:
    J1 1-35, J2, J3 and TP1-6. It declares 11 direct MCU rows and 78 indirect paths
    (CAN1 via U100, analog via R/ADA4096/R into MCP3208 SPI, wheel via BAV199/LM2903,
    tire CAN via TJA1051 and MCP2518FD), with one native conductor per segment.
    A rerun is byte-identical. The root contract is recompiled with AGENTEE-188.
    Descriptive columns are carried from the v9 row only when the native pi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
2026-10-22 AGENTEE-207: keep the declared BLE-RADIO obligation and restore the storage-microsd capture set
    H1. generate.py now emits a BLE-RADIO row after the 54 contact rows, declared in
    pinout-checks/source.json rather than read from the netlist: Net, MCU_Ref, MCU_Pin
    and MCU_Path are N/A and no native pin is invented. It cites POD-IF-BLUETOOTH-LE,
    POD-IF-PROGRAMMING-AND-DEBUG and POD-AC-9 from the Rev-3 spec record
    (expansion/requirements/rev3-microsd/spec-record.json). The generator checks the
    record's REQUIREMENTS.md digest and byte locators. Signal_Name and descriptive
    columns are carried from the v9 BLE-RADIO row and are not requalified. Carried v9
    rows also carry their POD-IF-* citations; each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
2026-10-22 AGENTEE-207: record and enforce the v9-historical status of carried io-map citations
    The AGENTEE-188 contract carries POD-IF-* IDs as bare strings in
    io_map.requirements, so the 24 rows carried from the v9 pilot lost their
    unqualified status outside prose. generate.py now also writes
    pinout-checks/citations.json, bound to the io-map digest. It records every
    cited ID and carried descriptive value with a status
    (v9-historical-unqualified or rev3-declared-obligation), rev3_qualified=false,
    and its origin: the v9 row (path, sha256, row, Connector_Pin) or the Rev-3
    spec-record locator.
    verify-io joins the record with every contract citation. It fails on a
    missing, stripped, stale or upgraded sta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
2026-10-22 AGENTEE-207: j6b prepared-scope corrections: bound J1/U3 models, initial candidate identity, JP1-JP5 copper contract
    Continues j6 on agent-ee 81e387ee with the same plan bounds (max_iterations 2, routing 900/2100/300,
    placement 1500, max_seconds 8400). Dry run only; no campaign launched.
    - FOMEMC-34: the capture carries the J1 TE 1-776163-1 rev T header STEP (connector-candidate/sources,
    verbatim member of the recorded TE archive, sourced native pose) and the U3 NEO-M9N datasheet-derived
    visualization at project/inputs/models/ (${KIPRJMOD}/inputs/models/). The captured RF_GPS:ublox_NEO
    member gains one zero-transform model node (library-updates.json model_bindings). Both are recorded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
2026-10-22 AGENTEE-207: bind the pod contract through the accepted AGENTEE-188 qualification record and verify the actual candidate
    Development-pin agent-ee to e906c9c7 (AGENTEE-188 accepted by agent-521,
    35ff0e93; not yet on agent-ee main). The pin is one place:
    toolchain/versions.toml [upstream.agent-ee]. scripts/agent_ee_pin.py exports
    that commit's src/ for verify-io, so verify-io no longer reads the live
    ~/git/agent-ee checkout. Before landing, the pin must move to the landed
    agent-ee main commit that contains e906c9c7.
    generate.py writes pinout-checks/history.json (agent-ee.io-map-history/1).
    The origin is the v9 io-map: its retained path, revision 36b19506 at original
    path telemetry-pod/io-map.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
2026-10-23 AGENTEE-207: no agent-ee pin; record the compiler as provenance from the agent-ee on PATH
    Owner correction, relayed by main via agent-449 (2026-10-21, verbatim as
    relayed, unconfirmed in this channel): "there's no need to pin anything".
    fome-mc uses the agent-ee CLI on PATH.
    - Remove [upstream.agent-ee] from toolchain/versions.toml (now identical to
    its pre-pin state) and delete scripts/agent_ee_pin.py.
    - verify_io_map.py resolves the agent-ee CLI on PATH, asks its interpreter
    where agent_ee lives, imports the evaluator and loader from there, and
    compiles with that interpreter's python -m agent_ee.io_map.
    - One compile path (verify_io_map.py --project telemetry-pod --compile)
    writes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
2026-10-23 AGENTEE-207: j6b2 source fixes before the single run: 7d5b0d4d repin, H2 relay attribution, H1 runtime receipt
    All source changes for the corrected order (agent-449 relaying agent-521 a9cb03ad/2fbe5f08, Cairn 154cc9f6;
    coordinator decisions, not owner-stated). Generated outputs are not changed here; the single preparation
    run regenerates them.
    - pipeline.py: AGENT_EE_PIN repinned to agent-ee main 7d5b0d4d (AGENTEE-466 qualified runtime, contains
    the AGENTEE-454 read-once fix); the router preflight stage is labelled as the pinned agent-ee's preflight
    of ROUTER_CHECKOUT, qualifying nothing by itself.
    - build.py (H2): the thickness-tolerance, enclosure and harness open items are labelled "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
2026-10-23 AGENTEE-207: re-record the pod compile provenance at agent-ee main d04b5121
    Regenerated through the same compile path (verify_io_map.py --project
    telemetry-pod --compile) with the agent-ee CLI on PATH:
    ~/.local/bin/agent-ee, a uv-tool editable install of ~/git/agent-ee at
    d04b51219e0d3381352d135c2b935af9cd4f1754 (main, clean src, contains
    AGENTEE-188 e906c9c7), version 0.1.0.
    Only the receipt's compiler.commit changed (e906c9c7 to d04b5121). The
    module digests are identical. The contract (87879d58) and the qualification
    record (2a3ce44f) are byte-identical. No agent-ee pin; versions.toml is
    unchanged.
2026-10-23 AGENTEE-207: j6b2 single preparation run on agent-ee 7d5b0d4d (AGENTEE-466 image): regenerated evidence and runtime receipt
    The one preparation run (production_run.sh under native-admit --class suite --weight 4, image config
    sha256:d96f8e00..., exit 0) from source commit 338fbd7:
    - build-out exit 0, build-check exit 0 (byte for byte), pipeline exit 0 (28/28 stages accepted), observe
    exit 0 (problems []);
    - in the image, /opt/agent-ee equals git archive 7d5b0d4d, router b5774496, source 9cfc5d5e, extension
    ec5fb733.
    - composition/envelope.json, captured-rule-areas.json, reconstruction.json: generated by that run (H2 labels).
    - evidence/emission-7d5b0d4d/: retained emission, prepared tree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
2026-10-23 AGENTEE-207: j6b2 count attribution (report-only): 21 DRC findings, 499 unconnected, 101 pod verify-io errors
    count_attribution.py ran once under native-admit (exit 0) on git-archive snapshots of 05783ce (j6, the frozen
    reference), 243b17d (the pre-j6 v9 state), 5d923c5 (the reviewed head) and 9f92bcc (current). verify-io ran
    with agent-ee pinned to 7d5b0d4d, because the shared ~/git/agent-ee moved to d04b5121. The analyze mode then
    derived analysis.json from that run's JSON.
    - 21 violations: item-for-item identical at 05783ce, 5d923c5 and 9f92bcc; none at 243b17d.
    - 499 unconnected: all pad-to-pad pairs on one net; 0 tracks or vias, and only two net-less rule areas.
    495 items are identic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
2026-10-23 AGENTEE-207: j6b2 re-runs of the failed checks (doctor on talos; verify-io on the 9baf184 merge): logs and identities
    Targets the current candidate 5504a022 at head 2bd0f5c, not 5d923c5, the old candidate 3688390f or the root v9
    board.
    - doctor (talos fome-runtime:d96f8e00, image ID 6c724d65, own checkout at 2bd0f5c, bootstrap lease
    6dfd721327b7, doctor lease 9745b4ffab8f): PASS, exit 0.
    - Binding under the 9baf184 merge: retain-check, the receipt (31ce57f6) and the source chain all still bind.
    No retained repository path was changed by the merge.
    - verify-io fome-mc: PASS, exit 0.
    - verify-io telemetry-pod: FAIL, exit 2. The landed rev3 pinout-checks/source.json pins the superseded
    ca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
2026-10-23 AGENTEE-207: refresh the pod verify-io candidate pin to the current candidate 5504a022 (agent-521 decision)
    Bounded same-writer pin refresh (agent-521 coordinator decision relayed by agent-449; not owner text).
    telemetry-pod/pinout-checks/source.json candidate changes from 5d923c5 / 3688390f / emission-81e387ee
    MANIFEST cff19152 to the current candidate:
    - commit 2bd0f5c;
    - candidate_id 5504a022;
    - emission-7d5b0d4d MANIFEST 161f71b0;
    - schematic f5840ecc, unchanged.
    Every new value was recomputed from the bytes at 2bd0f5c (commands in candidate_provenance). The old pin is
    kept verbatim in candidate_history as HISTORICAL, with its 193/194 result and provenance. IO_MAP.md's
    decision note and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
2026-10-23 AGENTEE-207: pin-refresh evidence (recompute log, binding checks, current-candidate pod verify-io)
    - Binding at b35d113: retain-check exit 0, receipt check exit 0 (31ce57f6 unchanged), sha256sum -c exit 0.
    - Pod verify-io (fome-gate.sh, FOME_GATE_LABEL=pod-capture-j6b2, lease 2347d77a64e6, admission wait 110 s):
    exit 0. Canonical source and candidate 5504a022 both give 54 connector pins and 193/194 invariants, with
    BLE-RADIO NOT_EVALUATED.
2026-10-23 AGENTEE-207: erratum for round-2 review H2 (source order): 338fbd7 prepared, b6db577 corrected receipt assembly
    Reporting-only; no run. README.md line 26 claimed every source change preceded the single preparation run.
    In fact:
    - 338fbd7 is the preparation source;
    - b6db577 changed the receipt writer runtime_receipt.py after the run (sha256 4d668fd9 -> 6eb800fc),
    touching only invocation() and write(); observe() and check() are unchanged.
    So the in-image observation remains applicable. Receipt 31ce57f6 is immutable, and preparation was not
    repeated. README.md is listed in the sealed production-capture/SHA256SUMS, so it is left unedited and corrected
    by this erratum file, which is not adde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
2026-10-23 AGENTEE-207: H2 errata per agent-449's binding rule: rename to ERRATA-20261023.md, record the binding evidence
    production-capture/SHA256SUMS: its hash is bound by no sealed record, but its path is cited as provenance by
    the sealed connector-candidate/mating-interface/interface.json:124. Under the conservative reading that is
    BOUND. README.md and SHA256SUMS stay byte-identical to 769c6c66; the errata is outside the sums; receipt
    31ce57f6 is untouched. Reporting-only; no run.
2026-10-23 AGENTEE-446: board-side J1 evidence (a) finished hole/plating/registration and (b) board-lock/tails on candidate 5504a022
    Lane ee446g. Design evidence only; no placement, routing, footprint or geometry change.
    - Binding recomputed from the bytes: candidate 5504a022, retained 2bd0f5c, MANIFEST 161f71b0, schematic
    f5840ecc, runtime receipt 31ce57f6, board 2f1c9557; retain --check and runtime_receipt check exit 0
    before and after.
    - Native probe (fome-runtime:d96f8e00, KiCad 10.0.7, network none, native-admit): J1 fixed at (45, 55.5)
    0 deg F.Cu locked; U3 staged off-board at (95.25, 1137.92), so (c) needs a placed candidate.
    J1/U3 footprint geometry identical to adfb7668: earlier evide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
2026-10-23 AGENTEE-446: source-capture addendum (agent-521 c13da285): JLCPCB capabilities page captured; TE 108-1329 HTTP 403
    Lane ee446g, evidence only, linear on the accepted packet 53f6d5bd. No design, native or production-capture change.
    - Captured verbatim with URL, time, status and sha256 (sources-c13da285/, sources.json, NOTICE.md licence note):
    https://jlcpcb.com/capabilities/pcb-capabilities 200 03af7196 (no stated version/date; ETag recorded);
    TE 108-1329 DDEController 403 AkamaiGHost 48fc3d8a (no workaround; UNKNOWN; owner drop proposed only).
    - Facts: through-holes +0.13/-0.08 mm, press-fit +/-0.05 (ENIG, multilayer), plating 18 um average,
    hole position +/-0.075 mm, multilayer 1 oz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
2026-10-23 AGENTEE-446: reporting corrections H1/H2 to the c13da285 addendum (review-ee446g HOLD on b3d570ca)
    Evidence-only, no network, no native or design change.
    - H1: a11 stays unknown. The sourced JLC average 18 um (F3) is recorded separately (sourced_fab_value), and
    the missing TE plating requirement/minimum is named with the 108-1329 HTTP 403 retrieval limit. The
    'no-te-requirement' class is removed; an unknown row now declares its missing sides, a packet missing
    source that names TE forces the TE side, and the row can leave unknown only on a cited captured
    (HTTP 200) TE fact.
    - H2: F8 now carries the verbatim Outline/Routed items 3 and 4 ("Minimum dimension 50*50mm for high precision,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
2026-10-23 telemetry-pod: land placement R1-R5 and ROUTE-1 evidence (only these directories, from writer commit 524c287; plan agent-ee docs/telemetry-pod-delivery-plan.md rev 6)
    - placement-r1..r4: bounded attempts and blockers (step budget, wall-time budget, front-side fragmentation, side-transform interface)
    - placement-r5: COMPLETE PLACEMENT 309/309, board 8f3bc234 (runtime 7d5b0d4d + side-transform patch b4be6263; agent-ee main 2fb2eaf8), unrouted, 63 open silkscreen findings
    - route-1: kicad-route b5774496 builtin all-net route, candidate 19ed7954, INCOMPLETE (78 unconnected on 48 nets), validation FAIL (+61 dangling via/track warnings), preservation PASS
    Unrelated earlier campaign files on the wr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
2026-10-23 telemetry-pod: land ROUTE-2 evidence (terminal, REJECTED by the engine improvement gate: +13 nets, 34 lost, 2 worsened; returned board equals ROUTE-1 19ed7954; native grading vs R5 FAIL on 61 danglin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
2026-10-23 telemetry-pod: land ROUTE-3 evidence (accepted working candidate 08066170: /SENSOR_POWER_AUX_DVDT connected, 78->77 open, DRC 141->140, 60 dangling vs R5; not released; attempt 1 kept as NOT-RETAINED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
2026-10-23 telemetry-pod: land ROUTE-4 retained-attempt evidence (agent-507 commit 4d022e3; finite batch stopped after 2 consecutive target failures; best candidate 5690da57: one GND junction via, 77->75 open, 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
2026-10-23 telemetry-pod: land AGENTEE-473 read-only trace (two-level block placement and production side locking; j6b2 writer commit fa5eb02): production bypassed the block path (no blocks declared, flat schem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
2026-10-23 telemetry-pod: land AGENTEE-473b read-only Rust planner trace (j6b2 writer commit b06eb6a; Rust 6f48b9f2 ports stage B + candidate admission, no stage A, captured side only, R5 side-transform absent 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
2026-10-23 telemetry-pod: land AGENTEE-477 3D model gap evidence (j6b2 writer commit 3a2d197): 9 references resolved with KiCad 10.0.7 stock models (coverage 283->292/309), 15 intended-none, L1/L2 Bourns models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
2026-10-23 telemetry-pod: land AGENTEE-478 D1-D5 prep (j6b2 writer commit 2ee1e63): allocation v2 309/309 once (24 blocks, 10 fixed, 6 shared), validator PASS, side eligibility, 219 pin-level relationship bound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
2026-10-23 telemetry-pod: land AGENTEE-482 correction of the 473/473b reports (j6b2 writer commit 41c1046; agent-510 HOLD fc3488f4): H1 groups enforced vs locality soft + policy discrepancy, H2 regression contr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
2026-10-23 telemetry-pod: land AGENTEE-480 GNSS binding and mechanical input closure (agent-507 commit 2528356): component/edge-relative RF corridor proposal + executable F-over-In1 check (ROUTE-3 FAIL: 3 F com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
2026-10-23 AGENTEE-484: supply decoupling repaired in the canonical source and regenerated through the production path -- +C130 (U4 1uF), C131 (U8), C132 (U9), C133 (U100 VIO) 100nF; rebinds C38/C41->U2, C43->U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
2026-10-23 AGENTEE-478b: apply owner physical answers (529 notice a13a1ba8 v1) to 478 prep data -- C20 bench pogo clip (either face, approach clearance only, no fixture pattern; one-face/grouping now an optiona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
2026-10-23 AGENTEE-478b: cowl per a13a1ba8 v2 -- ~90 mm provisional available HEIGHT for the full stack (owner estimate, not a measured cap); length/width substantially larger; verbatim quotes fd5bea71 + correc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
2026-10-23 AGENTEE-484r checkpoint: production_run.sh and the recorded launch command use apparmor=unconfined (no profile selection); RF_50 width rule selects /POD_GNSS_RF directly in design-rules/telemetry-pod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
2026-10-23 AGENTEE-484r: RF_50 width rule bound to /POD_GNSS_RF by a source-declared net selector in design-rules/telemetry-pod.kicad_dru (0.335 mm unchanged); regenerated via the committed production_run.sh (n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
2026-10-23 AGENTEE-478d: U2 face DERIVED from package axes + board-to-bike transform under the ASSUMPTION F-side normal up (agent-529 c7adf503); rot0 not inherited, XY not frozen; AGENTEE-486 verifies the packa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
2026-10-23 AGENTEE-487 checkpoint: plane plan /+3V3 (In2) island_removal never -- the declared routing-turn add-planes step refused on the placed board with always (wholly unconnected In2 zone before routing); 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
2026-10-23 AGENTEE-487: runtime_receipt.py parameterized (783ad032) -- retained evidence defaults to retain.py DEST, receipt dir explicit and never overwritten, neutral --authority, run bindings (source commit,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
2026-10-23 Apply relayed height correction and explicit assembly-axis assumption
2026-10-23 Slice A (agent-529 a57b675c): read-only JLC stock refresh via jlc_stock_capture for the 81 current BOM ids: 81 found / 0 failed / 0 unavailable (J1 C596198 stock 0, hand-fit); as_of 2026-10-23T11:14: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
2026-10-23 AGENTEE-487 review fixes H3/H4 (Astra): runtime_receipt.py parses the Rust install receipt (schema agent-ee.placement-engine-install/1, binary_sha256 == recomputed) in write and check; runtime identi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
2026-10-23 Verify U2 package and native pad frame against selected installation axes
2026-10-23 Slice B (agent-529 a57b675c): NEW retention emission-7d5b0d4d-agentee484r2 superseding the incomplete 484r one (kept unchanged); production_run.sh 28/28 on refreshed stock (gate 81/0 stale); runtime 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
2026-10-23 Bound connector registration and native card access choices for source integration
2026-10-23 AGENTEE-488 checkpoint: source (C133/C84 pin 2 -> /+5V_CAN, C18 -> C694521 22uF 1210), storage-microsd re-emitted (ERC 0), requirements recompiled, build.py rebindings
2026-10-23 Rebase RF planning geometry on selected 0.293 mm width
2026-10-23 AGENTEE-488: C133/C84 pin 2 -> /+5V_CAN (VIO-to-VCC), C18 -> C694521 22uF/25V 1210 (engineering margin); regenerated 28/28 on fresh stock; retention emission-7d5b0d4d-agentee488; ERC 0; correspondenc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
2026-10-23 AGENTEE-186 RF: kicad_dru /POD_GNSS_RF width min=opt=max 0.293 mm (adopted CAD nominal, 529 4cf9d43d v2), CPW gap clearance min 0.2032 mm on F.Cu, explicit U3/J2 launch-transition REVIEW scope (value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
2026-10-23 runtime_receipt.py H4 re-fix (Astra delta): check() compares every selected identity (agent-ee, router, source, extension, image config) with receipt/observation/pipeline; unknown selection kinds rej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
2026-10-23 Reissued current runtime receipt production-runtime-484r2-v2 with the H4-fixed runtime_receipt.py (check OK; no c4 evidence on the current path); production-runtime-484r2 kept unchanged as superseded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
2026-10-23 AGENTEE-488c composition (Astra H1/H2): named-return locality emitted in the consumer schema (provenance object, class default, advisory) + consumer-boundary test; spec record recaptured for main's R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
2026-10-23 AGENTEE-488c checkpoint: H1 fixed (consumer-schema locality pairs + validate on the emitted file), H3 report corrected (287 moved footprints; no prior acceptance carries over), H2 HOLD (composed pipe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
2026-10-23 Bound J2 SMA joint and sealed interface proposal
2026-10-23 AGENTEE-491 source-level: R74/R78/R82 -> 75k RT0603BRD0775KL (C723587), R75/R79/R83 -> 208k RT0603BRD07208KL (C861219), R73/R77/R81 unchanged; storage-microsd re-emitted (ERC 0; netlist delta exactly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
2026-10-23 Correct SMA proposal provenance and coordinate frames
2026-10-23 AGENTEE-491: keep the original 98 AGENT_EE_Ratings rule (the six rebound resistors never carried the field)
2026-10-23 AGENTEE-491: rating source for C723587/C861219 (YAGEO product sheets: 0.1 W 70C, 75 V DC, -55/+155C, 25 ppm/C); retain.py DEST emission-7d5b0d4d-agentee491 (new retention)
2026-10-23 AGENTEE-488c/491 completion: production from merge da64959 FAILED before generation -- first cause pipeline.py:284 hand-fit citation composition/parts.json bce5a138 != regenerated 82c1e33d (491 inten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
2026-10-23 AGENTEE-491 attempt 2 source input: producer-regenerated composition installed (parts.json 82c1e33d, from the da64959 build-out); hand-fit J1 citation rebound bce5a138 -> 82c1e33d (/parts/303 connect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
2026-10-23 AGENTEE-488c/491 coherent production (8ecee9c, native-admit, 15:08:50-15:23:17Z, all steps exit 0): new retention emission-7d5b0d4d-agentee491 (417 files) + --install (board fa7c2ca6, sch 21965aeb); 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
2026-10-23 AGENTEE-488c/491 attempt 2 result.md: complete; preflight incident recorded; CAD qualification line; F1 (no In1/In2 net planes on the emitted board, add-planes not executed in production)
2026-10-23 fix: apply owner 1.7mm requirement to all J2 holes
2026-10-23 AGENTEE-491 H4/H5: packet SHA256SUMS revision 2 (RESULT.md 5dfcce08 -> 48ee6f30, failure history recorded); F1 zone wording corrected to two board-level rule areas
2026-10-23 routing-diagnostic SCOREBOARD: reconcile to 2026-10-23 (chief 531 ba963cb0): roles 531/530/532; source 701f9df; scaffold fa7c2ca6 (DRC 499 unconnected + 21 other, NOT placement/routing); runtime bind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
2026-10-23 Archive superseded J2 enlarged-hole footprint
2026-10-23 Keep current J2 native helper on published footprint
